sergei-tiutriumov/Finishing/кольцо2.jpg

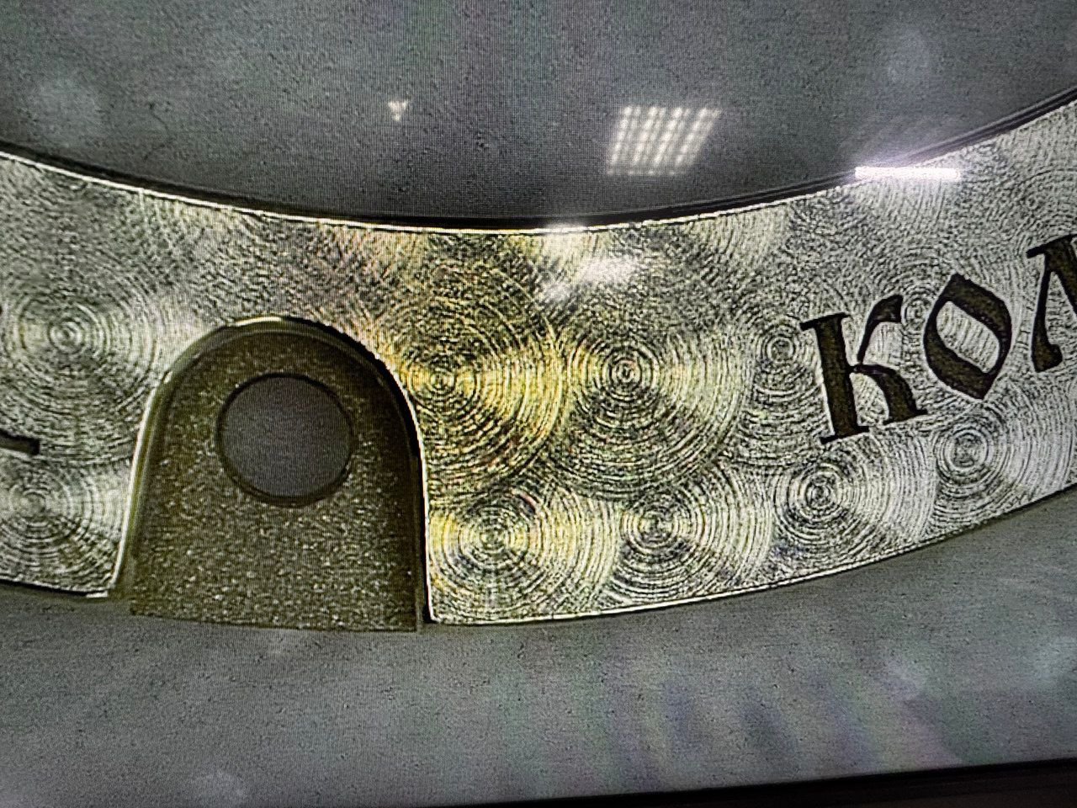
кольцо2.jpg
