sergei-tiutriumov/Finishing/кольцо3.jpg

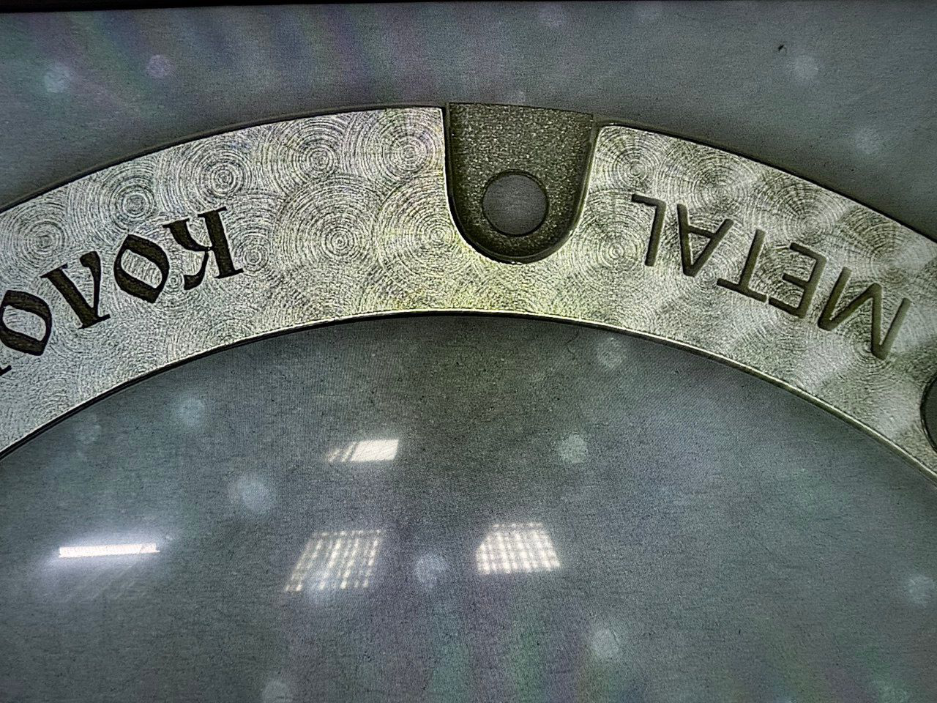
кольцо3.jpg
