sergei-tiutriumov/Finishing/китаец/Proforma Invoice 430PT.pdf

Proforma Invoice
Invoice Date : 2024-06-13 | INVOICE NO.: QLL20240613
Exporter/Seller | Importer/Buyer: Jinan Eastrise Innovations Co.,Ltd. No.59 Huayuan Road,Licheng District, Jinan City,Shandong
Province,China | Ivanov Ivan Ivanovich +7 964 555-20-56
Seller's Bank Information Beneficiary Name | Jinan Eastrise Innovations Co.,Ltd. Beneficiary account number | 623052 0730073816373 陈正勋
Country/ Region | 农业银行 China Beneficiary Bank
Beneficiary Bank Address | 河南省洛阳市涧西区联盟路
Ship Via | Terms of Delivery | Payment Term
| EXW | 100% CNY before shipping
Item | Description | Quantity In Unit | Unit Price(CNY) | Total Amount (CNY)
1 | Carving and milling machine 430P-T #Worktable size:400*300mm #Texture of material: HT300 #ADTECH control system #HCFA 750w servo motors and drivers #Spindle : HQD 2.2KW #X/Y/Z Ball screw : D2005C3 #X/Y/Z Linear guide rail: HIWIN HG25/20/20H #4 axis #add spacer 60mm | 1set | ¥67,300 | ¥67,300

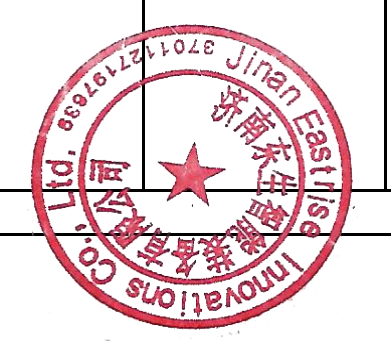
[picture p7: figure]

Total: | | | | ¥67,300
Others terms and conditions: 01.Payment terms:100% CNY before shipping. 02.Trade terms:EXW

### 03. Packing: Export standard plywood packing
