sergei-tiutriumov/Finishing/сфинкс/мануалы15iM/NewKer/(TB)NEW-996M-1000M-1500M-15iM-18iM.pdf

-数控系统- | 用户手册
- 1 -

目 录
第一篇 概述篇 | 4
第二篇 编程篇 | 5
2.1 基本概念 | 5
2.2 程序格式的一般表达式 | 6
2.3 程序指令代码及其功能说明 | 6
2.4 程序指令及使用方法 | 11
（1）选择坐标系指令（G53/G54/G55/G56/G57/G58/G59） ……12
（2）坐标系指令（G50/G52） | 12
（3）编程方式指令（G90/G91） | 13
（4）平面选择指令（G17/G18/G19） | 13
（5）快速定位指令（G00） | 13
（6）直线插补指令（G01） | 14
（7）圆弧插补指令（G02/G03） | 14
（8）螺旋线插补指令（G02/G03） | 15
（9）三维空间圆弧指令（G06） | 16
（10）延时指令（G04） | 16
（11）镜像加工指令（G11/G12） | 17
（12）比例缩放指令（G36/G37） | 18
（13）坐标系旋转指令（G68/G69） | 19
（14）回零点指令（G28/G281-G288/G301-G308） | 21
（15）刀具长度补偿指令（G43/G44/G49） | 21
（16）增减刀具半径指令（G45/G46/G47/G48） | 22
（17）刀具半径补偿指令（G40/G41/G42） | 23
（18）程序循环指令（G22--G800） | 25
（19）准确定位/连续路径加工（G60/G64） | 25
（20）固定循环宏定义指令（G73、G80～G89） | 26
（21）高速深孔钻循环（G73） | 27
（22）钻孔循环，点钻循环（G81） | 28
（23）钻孔循环，锪镗循环（G82） | 29
（24）排屑钻孔循环（G83） | 30
（25）镗孔循环（G85） | 31
（26）镗孔循环（G86） | 32
（27）镗孔循环、背镗孔循环（G87） | 36
（28）镗孔循环（G89） | 33
（29）精镗循环（G76） | 36
（30）左旋琢式深孔攻丝循环（G74） | 34
（31）右旋琢式深孔攻丝循环（G84） | 36

- numerical control system -user's manual
- 1 -

## Catalogue

The first part is an overview | 4
Part two, programming | 5
2.1 conceptual framework | 5
2.2 A general expression for program formatting | 6
2.3 Program instruction code and its function
description | 6
2.4 Program instructions and usage | 11
（1） Select the coordinate system instruction (G53/G54/G
55/G56/G57/G58/G59) | 12
（2） Coordinate instructions (G50/G52) | 12
（3） Programming instructions (G90/G91) | 13
（4） Planar selection command (G17/G18/G19) | 13
（5） Quick positioning instruction (G00) | 13
（6） Linear interpolation command (G01) | 14
（7） Circular arc interpolation instruction (G02/G03)… 14
（8） Spiral lead-in instruction (G02/G03) | 15
（9） 3D spatial arc instruction (G06) | 16
（10） Delay instruction (G04) | 16
（11） Mirror processing command (G11/G12) | 17
（12） Proportional scaling instructions (G36/G37) | 18
（13） Coordinate system rotation command (G68/G69)…
| 19
（14） Return to zero point instruction (G28/G281-G288/G
301-G308) | 21
（15） Tool length compensation command (G43/G44/G
49) | 21
（16） Add/subtract tool radius commands (G45/G46/G47/
G48) | 22
（17） Tool radius compensation command (G40/G41/G
42) | 23
（18） Program loop instructions (G22--G800) | 25
（19） Precise positioning/continuous path machining (G
60/G64) | 25
（20） Fixed cycle macro definition instructions (G73, G80~
G89) | 26
（21） High speed deep hole drilling cycle (G73) | 27
（22） Borehole cycle, point-to-borehole cycle (G81)…… 28
（23） Drill cycle, counterboring cycle (G82) | 29
（24） Drill cuttings circulation (G83) | 30
（25） Borehole circulation (G85) | 31
（26） Borehole circulation (G86) | 32
（27） Boring cycle, back boring cycle (G87) | 36
（28） Borehole circulation (G89) | 33
（29） Borehole circulation (G76) | 36
（30） Left rotary deep hole tapping cycle (G74) | 34
（31） Right rotation twist deep hole tapping cycle (G84)…
| 36

- 2 -
（32）固定循环取消（G80） | 37
（33）极坐标指令（G15/G16） | 37
（34）公英制转换、进给方式指令（G20/G21、G94/G95）………38
（35）返回程序起点指令（G26/G261-G268） | 38
（36）记忆当前点（G25） | 39
（37）返回程序记忆点指令（G61/G611-G618） | 39
（38）检测跳转指令 G31、G311 | 40
（39）自动倒斜角 I 和倒圆角 R 功能 | 40
（40）M 功能辅助指令 | 42
（41）调用程序 M97、M98、M99 | 43
（42）F 进给速度功能指令 | 45
（43）T/H/D 功能指令 | 45
（44）S、SS 主轴速度功能指令 | 46
（45）宏程序指令（G65/G66/G67） | 46
（46）自定义宏程序指令（G101—G172） | 48
（47）圆内凹槽粗铣G110/G111 | 69
（48）全圆内精铣循环G112/G113 | 71
（49）外圆精铣循环G114/G115 | 72
（50）外圆粗铣循环G116/G117 | 73
（51）外矩形粗铣 G132/G133 | 75
（52）形凹槽粗铣G134/G135 | 77
（53）矩形凹槽内精铣循环G136/G137 | 79
（54）矩形外精铣循环 G138/G139/G141/G142 | 80
（55）可编程数据输入指令 G10/G710 | 80
（56）可编程数据输入指令 G10 | 80
（57）椭圆指令 G602/G603 | 67
（58）抛物线指令(G702) | 67
（59）样条曲线光顺处理指令(M620/M621) | 67
（60）倾斜姿态坐标系 G682/G680 | 67
2.5 刀具半径补偿 C 的介绍 | 51
2.6 编程综合举例 | 56
2.7 自动对刀仪使用方法 | 56
2.8 自动分中功能使用方法 | 56
2.9 坐标轴随动功能使用方法 | 58
2.10 四轴/五轴系统 RTCP 功能 | 58
第三篇 操作篇 | 60
3.1 概述 | 60
3.2 操作面板 | 60

- numerical control system - | user's manual
- 2 -
（32） Fixed-cycle cancellation (G80) | 37
（33） Polar coordinate commands (G15/G16) | 37
（34） Metric conversion, feed mode instructions (G20/G
21, G94/G95) | 38
（35） Return program starting instruction (G26/G261-G
268) | 38
（36） Memory current point (G25) | 39
（37） Return program memory point instruction (G61/G
611-G618) | 39
（38） Detect jump instructions G31 and G311 | 40
（39） Automatic chamfer I and fillet R functions | 40
（40） Function assist command M | 42
（41） Call the programs M97, M98, and M99 | 43
（42） F Feed speed function command | 45
（43） T/H/D function instruction | 45
（44） S, SS spindle speed function command | 46
（45） Macro instruction (G65/G66/G67) | 46
（46） Custom macro program instructions (G101-G172)…
| 48
（47） Grind the round recess G110/G111 | 69
（48） Full circle internal precision milling cycle G112/G113
| 71
（49） External cylindrical milling cycle G114/G115 | 72
（50） Outer circle rough milling cycle G116/G117 | 73
（51） External rectangular rough milling G132/G133…… 75 （52） Form a groove for rough milling G134/G135………77 （53） Precision milling cycle G136/G137 in rectangular
groove | 79
（54） Rectangular outer milling cycles G138/G139/G141/G
142 | 80
（55） Programmable data input instruction G10/G710… 80
（56） Programmable data input instruction G10 | 80
（57） Elliptical command G602/G603 | 67
（58） Parabolic command (G702) | 67
（59） Spline curve smoothing instruction (M620/M621)…
| 67
（60） Tilt axis coordinate system G682/G680 | 67
2.5 Introduction to tool radius compensation C | 51
2.6 Programming examples | 56
2.7 How to use the automatic knife sharpener | 56
2.8 How to use the automatic partitioning function…… 56
2.9 Coordinate axis follower function usage | 58
2.10 Four-axis/five-axis system RTCP function | 58
The third part, the operation part | 60
3.1 summary | 60
3.2 operation panel | 60

- 3 -
3.3 键盘说明 | 60
3.4 手动操作 | 62
3.5 自动操作 | 67
3.6 安全操作、报警提示 | 70
3.7 参数操作 | 71
3.8 刀补参数设置 | 98
3.9 螺补参数设置 | 99
3.10 诊断 | 101
3.11 编程操作 | 103
第四篇 连接篇 | 109
4.1 系统电气特性 | 109
4.2 系统技术指标 | 109
4.3 系统使用环境 | 109
4.4 系统安装连接 | 109
4.5 系统安装尺寸 | 110
4.6 系统后视图 | 110
4.7 系统接口连接图 | 111
4.8 机床电器安装原理 | 122
4.9 机床电器板 | 130
4.10 总线系统 I/O 机床电器板 | 180
4.11 总线系统电器连接图 | 184
第五篇 加工中心篇 | 186
5.1 输入输出接口 | 186
5.2 加工中心参数 | 188
5.3 加工中心调试 | 189
第六篇 双通道系统 | 204

- numerical control system - | user's manual
- 3 -
3.3 Keyboard instructions | 60
3.4 hand operation | 62
3.5 automata | 67
3.6 Safety operation and alarm prompt | 70
3.7 Parameter operations | 71
3.8 Adjust parameter Settings | 98
3.9 Adjustment of screw parameters | 99
3.10 diagnose | 101
3.11 Programming operations | 103
The fourth part, the connection | 109
4.1 System electrical characteristics | 109
4.2 System technical indicators | 109
4.3 System usage environment | 109
4.4 System installation and connection | 109
4.5 System installation dimensions | 110
4.6 System view | 110
4.7 System interface connection diagram | 111
4.8 Installation principle of machine tool electrical
equipment | 122
4.9 Machine tool electrical board | 130
4.10 Bus system I/O machine tool electrical board……180
4.11 Bus system electrical connection diagram | 184
Part V: Processing Centers | 186
5.1 inputoutput interface | 186
5.2 Processing center parameters | 188
5.3 Processing center debugging | 189
Part VI. Two-channel systems | 204

- 4 -

第一篇 概 述 篇

本系统是我公司最新开发的普及型铣床、钻床、镗床数控系统。控制电路采 用最新工业级高速 ARM 处理器、大规模现场可编程门列矩阵 FPGA 技术，多层 PCB 印制电路板，整机采用高集成芯片和表贴元件，结构更为紧凑合理，更好的保证 了系统的可靠性和稳定性。
实时控制高速度(最高快移速度可达 240 米/分、最高进给插补速度可达 30 米/分)、高精度；采用 800x600 点阵 TFT LCD 亮度自适应液晶显示技术，LED 背 光亮度均匀使用寿命长，且克服了以往显示亮度受环境温度变化的缺点。全屏幕 中文菜单显示，操作极为简单方便。
本系统是以铣床为代表的三轴、四轴、五轴、六轴、七轴、八轴坐标联动， 总线闭环控制普及型全数字式数控系统，功能强大，指令丰富，编程代码符合 ISO 国际代码标准。直接控制交流伺服系统，如果选配本公司生产的双通道交流伺服 驱动器性价比更优。
本使用手册详细介绍了本数控系统的编程和使用方法。

重要提示：

1、所有第 A、B、C、Xs、Ys 轴的功能在选配第四、五轴、六轴、七轴、八

轴系统时才有效。

2、对本数控系统操作不当可能引起意外事故，在使用前务必仔细阅读本使

用手册。

3、所有绝对值功能必须是选配的系统是绝对值系统才有效，所有总线功能

必须是选配的系统是总线系统才有效。

4、系统面板上的“启动”按键作为调试时使用（杂类参数 P9-D14 位设置

“有效”或“无效”，在正常使用时必须设置为“0”），在系统装配时必须外加

“启动”按钮，否则由于“启动”按键寿命问题可能引起意外事故！！！所以，本

系统禁止长时间使用系统面板上的“启动”按键，否则由此造成的安全后果与我

公司无关！！！

- numerical control system - | user's manual
- 4 -

## Chapter I. Introduction

This system represents our company's latest development in a user-friendly CNC control solution for milling, drilling, and broaching machines. Utilizing cutting-edge industrial-grade ARM processors and large-scale field-programmable gate array (FPGA) technology, it features multi-layer PCB boards with integrated high-density chips and surface-mount components. The compact design significantly enhances system reliability and stability while maintaining optimal operational efficiency.
Real-time control with high-speed operation (maximum linear speed: 240 m/min, maximum feed interpolation speed: 30 m/min) and high precision. Featuring an 800x600 dot-matrix TFT LCD display with adaptive brightness technology, the LED backlight ensures uniform illumination and extended lifespan, effectively addressing previous limitations of ambient temperature-dependent brightness in displays. The full-screen Chinese menu interface provides exceptionally intuitive operation.
This system is a fully digital CNC solution featuring three-axis, four-axis, five-axis, six-axis, seven-axis, and eight-axis coordinate linkage with milling machine as the core component. It employs closed-loop bus control technology and delivers robust functionality with extensive command capabilities, programming standards compliant with ISO international specifications. The system directly controls AC servo motors, and when paired with our company's dual-channel AC servo driver, it achieves superior cost-effectiveness through optimized performance.
This manual introduces in detail the programming and use of this CNC system.
Important note:
1 、 All functions of the A, B, C, Xs and Ys axes are valid only when the fourth, fifth, sixth, seventh and eighth axis systems are selected.
2. Improper operation of this CNC system may cause accidents, so please read this manual carefully before use.
3. All absolute value functions must be optional. The system is valid only when it is an absolute value system. All bus functions must be optional. The system is valid only when it is a bus system.
4. The "Start" button on the system panel is used during debugging (Miscellaneous Parameters P9-D14: Set the bit to "Enabled" or " Disabled". During normal operation, it must be set to "0".). When assembling the system, an additional "Start" button must be added. Otherwise, due to the lifespan limitations of the "Start" button, accidents may occur!!! Therefore, this
The system prohibits the long-term use of the "start" button on the system panel, otherwise the security consequences caused by this are not related to our company!!!

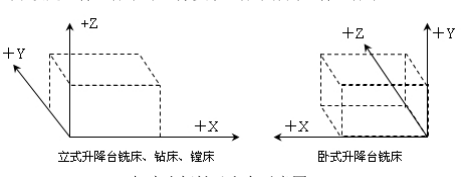
[picture p8: figure]

- 5 -

第二篇 编 程 篇

数控机床是按照事先编好的数控程序自动地对工件进行加工的高效自动化 设备。编制是根据被加工工件的图纸和加工工艺的要求，用所使用数控系统的数 控语言来描述加工轨迹，及其辅助动作的过程。理想的数控程序不仅应该保证能 加工出符合图纸要求的合格工件，还应使数控机床的功能得到合理的应用和充分 的发挥，所以编好数控程序非常重要，本篇将详细介绍数控程序的各种指令及用 法，请仔细阅读。

2.1 基本概念

程序段：（程序行）是由指令段和数据段共同组成的一个完整命令行。 程序：是为了完成工件的加工，按加工的逻辑结构组合的全部程序段的集合。 机床坐标系：是以机床零点为原点建立的坐标系。铣床坐标轴和其方向按 “ISO841”的规定。标准中规定的基本确定方法，即：以右手法则确定的笛卡尔直 角坐标系作为编程标准坐标系，对于刀具旋转的机床（如铣床）等，Z 轴是平行 于主轴的坐标轴，X 轴一般是水平的，与工件卡装面平行，Y 轴由右手法则确定， 各轴的运动使工件的尺寸增加的方向为各轴的正方向。
当未设定工件坐标系时，将机床坐标系作为工件坐标系。

机床坐标轴及方向示意图
工件坐标系：工件加工时使用的坐标系称作工件坐标系，由CNC 预先设置. 工件坐标系可以用移动它的原点来改变.
设置工件坐标系有二种方法：
1 、G50/G52指令
程序中在G52指令之后指定一个值来设定工件坐标系。
2 、G54/G54.1-G54.48/G55/G56/G57/G58/G59指令 使用参数设置中的坐标系可以设置6个工件坐标系。
用绝对值指令时必须用上述方法建立工件坐标系

- numerical control sys -
tem -

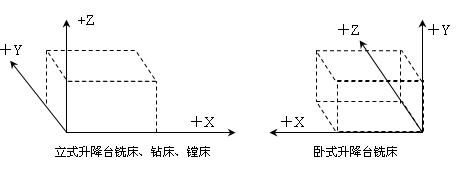
[picture p9: figure]

- 5 -

## Part II: Programming

A CNC machine is an efficient automated device that processes workpieces automatically according to pre-programmed numerical control (NC) instructions. Programming involves describing the machining path and auxiliary actions using the NC language of the system, based on the workpiece's blueprint and manufacturing requirements. An ideal NC program must not only ensure production of qualified parts meeting design specifications but also optimize the machine's capabilities. This makes proper programming crucial. This article provides a detailed explanation of various NC instructions and their applications. Please read carefully.
2.1 Conceptual Framework
Program section: (program line) is a complete command line composed of instruction section and data section.
Program: is the collection of all program segments combined according to the logical structure of processing in order to complete the machining of workpiece.
Machine tool coordinate system: A coordinate system established with the machine tool's zero point as the origin. The milling machine's coordinate axes and their orientations follow the ISO841 standard. The basic determination method specified in the standard is: using the Cartesian rectangular coordinate system defined by the right-hand rule as the programming reference system. For machine tools with rotating tools (such as milling machines), the Z-axis is parallel to the spindle, the X-axis is generally horizontal and parallel to the workpiece clamping surface, while the Y-axis is determined by the right-hand rule. The direction of motion that increases the workpiece's dimensions is defined as the positive direction of each axis.
When the workpiece coordinate system is not set, the machine tool coordinate system is taken as the workpiece coordinate system.

Schematic diagram of machine tool coordinate axis and direction Workpiece coordinate system: The coordinate system used in the machining of a workpiece is called the workpiece coordinate system, which is preset by the CNC. The workpiece coordinate system can be changed by moving its origin.
There are two ways to set the workpiece coordinate system:
1 、 G50/G52 instructions
In the program, a value is specified after the G52 instruction to set the workpiece coordinate system.
2 、 G54/G54.1-G54.48/G55/G56/G57/G58/G59 Directive
Use the coordinate system in the parameter Settings to set up 6 workpiece coordinate systems.
When using the absolute value instruction, the workpiece coordinate system must be established by the above method

- 6 -

局部坐标系：当在工件坐标系中编制程序时，为容易编程可以设定工件坐标 系的子坐标系，该子坐标系称为局部坐标系。
绝对坐标编程：是以建立的绝对坐标系为基准确定的坐标数据编程方式，绝 对坐标是指刀具相对于加工坐标系原点的坐标。用 G90 指令，X、Y、Z、A、B、 C、Xs、Ys 坐标字表示。
例如：G00 G90 X200 Y200 Z300
相对坐标编程：也叫增量坐标编程，是指运行终点相对于运行起点的距离和 方向。相对坐标是指刀具运动位置的坐标值是相对于前位置，而不是相对于固定 的加工坐标系原点。用 G91 指令，X、Y、Z、A、B、C、Xs、Ys 坐标字表示。 例如：G00 G91 X200 Y200 Z300
最小编程单位：最小编程单位为 0.001mm。
模态指令：是指在程序中具有保留功能属性的指令，它不仅在本程序行起作 用，而且在以后的程序行中也起作用。直到其它同组的模态指令替代为止。 在同样操作类型中可能具有多个模态指令，如 M03（主轴顺转）、M04（主 轴逆转）、M05（主轴停）它们同样用来控制主轴，都是模态，在指令系统中把 同类型的模态指令划分为一个模态组。任何时候只能是其中之一。而且必然有其 中之一，因此存在一个初始状态问题，初始选用的模态指令，叫做模态初态。如 上述模态组中，模态初态为 M05。
中止模态（破坏模态）：是指具有把模态指令变为模态初态或模态可能被破 坏的指令。比如 M20（程序结束指令），表示运行结束，回到开始状态，把全部 模态指令变为模态初态。
非模态指令：是指不具备保留功能，仅在本程序段内起作用。

2.2 程序格式的一般表达式

G02，T02，H02，D02，M02，S04，F04，X-043，Y-043，Z-043，A-043， B-043，C-043，Xs-043，Ys-043，I-043，J-043，K-043，L04，P4，R043。 注 1：地址符后有“-”号表示该数据可以用“-”符号（正号不写）。 注 2：数字前为 0，表示该数据可以只写有效数据位。
注 3：数字表示的是位数，当为两位时，高位表示整数位数的最多位数，低 位表示小数点后的最多位数。

2.3 程序指令代码及其功能说明

本节将详细介绍本系统中所有指令代码的功能及使用方法。

2.3.1 指令及数据说明

功 能 | 地址符 | 意 义 | 数据范围

- numerical control sys -
tem -
- 6 -

Local coordinate system: When programming in the workpiece coordinate system, a sub-coordinate system of the workpiece coordinate system can be set to facilitate programming. This sub-coordinate system is called the local coordinate system.
Absolute coordinate programming: This is a programming method that determines coordinate data based on the established absolute coordinate system. Absolute coordinates refer to the coordinates of the tool relative to the origin of the machining coordinate system. The G90 command uses X, Y, Z, A, B, C, Xs, and Ys coordinates to represent this. For example: G00 G90 X200 Y200 Z300
Relative coordinate programming, also known as incremental coordinate programming, refers to the distance and direction between the end point and the starting point during machining. This method determines tool movement positions relative to their previous locations rather than a fixed reference coordinate system origin. The G91 command specifies these coordinates using X, Y, Z, A, B, C, Xs, and Ys parameters.
For example: G00 G91 X200 Y200 Z300
Minimum program unit: minimum program unit is 0. 001mm. Modal instructions: These are instructions in a program that have reserved functional attributes. They not only work in the current line of the program, but also in later lines of the program until they are replaced by other modal instructions in the same group.
Within the same operational type, multiple mode commands may exist, such as M03 (spindle forward rotation), M04 (spindle reverse rotation), and M05 (spindle stop). These commands all control the spindle and are classified as modes within the instruction system. The same type of mode commands are grouped into a mode group, with only one applicable at any given time. Since there must be one selected mode, an initial state issue arises—this initial mode command is called the mode initial state. For example, in the aforementioned mode group, the mode initial state is M05.
Termination mode (destructive mode): refers to the instruction that changes the mode instruction to the mode initial state or the mode may be destroyed. For example, M20 (program termination instruction), which indicates the end of operation and returns to the starting state, changing all mode instructions to the mode initial state.
Non-modular instruction: refers to the instruction that does not have the retention function and only takes effect in this program segment.
2.2 A General Expression for Program Formatting

G02，T02，H02，D02，M02，S04，F04，X-043，Y-043，Z-043，A-043， B-043，C-043，Xs-043，Ys-043，I-043，J-043，K-043，L04，P4，R043。
Note 1: A "-" after the address indicates that the data can be written with the "-" symbol (the plus sign is not written).
Note 2: A number with a zero in front indicates that the data can only write valid data bits.
Note 3: The number indicates the number of bits. When it is two bits, the high bit indicates the maximum number of bits in the integer number and the low bit indicates the maximum number of bits after the decimal point.
2.3 Program Instruction Code and Its Function Description
This section will detail the functions and usage of all instruction codes in this system.
2.3.1 Instructions and Data Descriptions

function

address character

mea
ning

data
area

- 7 -
文件名 | | 加工工件的文件名 | 0-9、A-Z 组成
程序行号 | N | 程序段的顺序号 | 0000-99999 行距可设
准备功能 | G | 指定动作状态（G01、G02 等） | 00-99
辅助功能 | M | 控制机床辅助动作 | 00-99
刀具功能 | TDH | 指定刀具号 | 换刀 00-99
| SS S | 指定第一主轴转速 指定第二主轴转速 | 0-99999 主轴功能 0-99999
切削速度 | F | 指定每分钟的切削速度 | 0.01-15000mm/min
坐标字 | XYZABCX sYs | 分别为 XYZABCXsYs 轴坐标移 动值 | ±99999.999mm
圆心坐标 | IJK | X、Y、Z 轴圆心坐标增量值 | ±99999.999mm
圆弧半径 | R | 圆弧半径值 | 0.001-99999.999m m
延时时间 | P、X | 指定 G04 的延时时间 | 0.001-65s
程序入口 | P | 子程序调用或转移入口行 | 0000-9999
重复次数 | L | 循环次数或子程序调用次数 L 也可为多头螺纹头数 | 1-99999 1-99
程序行跳 步功能 | / | 如果程序行首有“/”表示此 行不执行 | 杂 类 参 数 P9 的 D12=1 时可以屏 蔽跳步功能

2.3.2 程序指令表

表 1 G 指令代码及功能
G 代码 | 功能
G00 | 快速定位
G01 | 直线插补
G31 | 检测跳转不报警
G311 | 检测跳转要报警
G02 | 顺圆插补/螺旋线插补 CW：螺旋移动的螺旋 线插补可指令 2 个圆弧插补轴同步移动的其 他轴。指令方法只是简单地加上一个不是圆 弧插补轴的移动轴。
G03 | 逆圆插补/螺旋线插补 CCW
G01(G00) X I | 自动倒斜角
G01(G00) YI | 自动倒斜角
G01(G00) ZI | 自动倒斜角

- numerical control sys -
tem -
- 7 -
document name | | The file name of the workpiece being processed | 0-9, A-Z composi-tion
Line number of the prog-ram | N | The sequence number of the pr-ogram segment | 000-99999 line spacing can be set
g function | G | Specify the action status (G01, G02, etc.) | 00-99
additional fu-nction | M | Control machine tool auxiliary acti-ons | 00-99
tool function | TDH | Specify the tool number | Change the blade 00-99
Spindle funct-ion | S | Specify the spin-dle speed | 0-99999
| SS | Specify the second spindle speed | 0-99999
cutting speed | F | Specify the cutting speed per minute | 0.01-15000mm/min
Coordinate le-tter | XYZABCX sYs | Are the axis coord-inate movement values of XYZABC-XsYs respectively | ±99999.999mm
Center of circle coordinates | IJK | X, Y, Z axis center of circle coordinate increment value | ±99999.999mm
Arc radius | R | Arc radius value | 0.001-99999. 999m m
Delay time | P、X | Specify the delay time for G04 | 0.001-65s
program entry | P | A subroutine call or transfer entry line | 0000-9999
number of re-plication | L | The number of cy-cles or subroutine calls L can also be the number of thr-eads in a multi-head thread | 1-99999 1-99
Procedure: Walk function | / | If the line starts with a /, it is not executed | When D12=1 in the miscellaneous category parame-ter P9, the skip function can be shielded

2.3.2 Program Instruction Table
Table 1 G Instruction Code and Function
G code | function
G00 | quick positioning
G01 | linear interpolation
G31 | No alarm is raised when the test jump is detected
G311 | The test jump should alarm
G02 | Circular interpolation/spiral interpolation CW: The spiral movement of the spiral interpolation can be instructed to move two arc interpolation axes synchronously with other axes. The instruction method is simply to add a moving axis that is not an arc interpolation axis.
G03 | Counterclockwise circular interpolation/ spiral line interpolation
G01(G00) X I | Automatic reverse angle
G01(G00) YI | Automatic reverse angle
G01(G00) ZI | Automatic reverse angle

- 8 -
G01(G00)X R | 自动倒圆角
G01(G00)Y R | 自动倒圆角
G01(G00)Z R | 自动倒圆角
G04 | 延时
G15 | 极坐标指令取消
G16 | 极坐标指令：极坐标（半径和角度），角度的 正向是所选平面的第1轴正向的逆时针转向， 而负向是顺时针转向。
G17 | 选择 XpYp 平面 | Xp：X 轴或其平行轴 Yp：Y 轴或其平行轴 Zp：Z 轴或其平行轴
G18 | 选择 ZpXp 平面
G19 | 选择 YpZp 平面
G20 | 英寸（英制）输入
G21 | 毫米（公制）输入
G28/G281-G28 8 | 返回机床零点
M881 | 加工中心主轴准停，输出 M61，检测 M22
M884-M887 | X 轴、Y 轴自动分中指令
M880 | 自动对刀指令
G30/G301-G308 | 回坐标零点
G26/G261-G26 8 | 返回程序起点
G25 | 记忆当前点 XYZABCXsYs 坐标
G61/G611-G61 8 | 返回 G25 记忆点的坐标
G40 | 刀具半径补偿取消
G41 | 刀具半径左补偿
G42 | 刀具半径右补偿
G43 | 正向刀具长度补偿
G44 | 负向刀具长度补偿
G49 | 刀具长度补偿取消
G45 | 刀具位置偏置加
G46 | 刀具位置偏置减
G47 | 刀具位置偏置加 2 倍
G48 | 刀具位置偏置减 2 倍
G37 | 比例缩放取消
G36 | 比例缩放有效
G12 | 可编程镜像取消

- numerical control sys -
tem -
- 8 -
G01(G00)X R | Automatically round corners
G01(G00)Y R | Automatically round corners
G01(G00)Z R | Automatically round corners
G04 | delayed
G15 | The polar coordinate command is cance-lled
G16 | Polar coordinate instructions: Polar coo-rdinates (radius and Angle), where the positive direction of the Angle is a counterclockwise turn from the positive direction of the first axis of the selected plane, and the negative direction is a clockwise turn.
G17 | Select the XpYp plane | Xp: X-axis or its par-allel axis Yp: Y-axis or its par-allel axis Zp: Z-axis or its par-allel axis
G18 | Select the ZpXp plane
G19 | Select the YpZp plane
G20 | Inch (imperial) input
G21 | Millimeters (metric) input
G28/G281-G28 8 | Return to machine zero point
M881 | The spindle of the machining center is stopped, output M61 and detect M22
M884-M887 | X-axis and Y-axis automatic centering instructions
M880 | Automatic alignment command
G30/G301 - G 308 | Return to the origin
G26/G261-G26 8 | Return to the starting point of the procedure
G25 | Remember the coordinates of the curr-ent point XYZABCXsYs
G61/G611-G61 8 | Return the coordinates of the G25 me-mory point
G40 | Tool radius compensation is cancelled
G41 | Left tool radius compensation
G42 | Right tool radius compensation
G43 | Forward tool length compensation
G44 | Negative tool length compensation
G49 | Blade length compensation is cancelled
G45 | Add tool position offset
G46 | Tool position offset reduced
G47 | The tool position offset is added by 2 times
G48 | The tool position offset is reduced by 2 times
G37 | Proportional scaling is cancelled
G36 | Proportional scaling works
G12 | Programmable mirroring is cancelled

- 9 -
G11 | 可编程镜像有效：实现坐标轴的对称加工。
G50/G52 | 坐标系设定：在工件坐标系中编制程序时， 为容易编程，可以设定工件坐标系的子坐标 系
G53 | 选择机床坐标系
G54.1-G54.48 | 选择工件坐标系 1 | 说明：这六个工件坐 标系是用直接存储在 计算机中，需用时可 选择其中一个
G55 | 选择工件坐标系 2
G56 | 选择工件坐标系 3
G57 | 选择工件坐标系 4
G58 | 选择工件坐标系 5
G59 | 选择工件坐标系 6
G60 | 准确停止定位
G64 | 连续路径加工
G68 | 坐标旋转
G69 | 坐标旋转取消
G65 | 非模态宏指令
G66 | 模态宏指令
G67 | 取消模态宏指令
G73 | 深孔钻循环：间歇进给，回退快速移动
G80 | 固定循环取消/外部操作功能取消
G81 | 钻孔循环：切削进给， 镗循环或外部操作功 能，回退快速移动
G82 | 排屑钻孔循环或反镗循环：切削进给，在孔 底停刀，回退快速移动
G83 | 小孔深孔钻循环：间歇进给，回退快速移动
G85 | 镗孔循环：切削进给，回退切削进给
G86 | 镗孔循环：切削进给，在孔底主轴停止，回 退快速移动
G89 | 镗孔循环：在孔底停刀，回退切削进给
G74 | 左旋琢式深孔攻丝循环
G84 | 右旋琢式深孔攻丝循环
G76 | 精镗循环
G90 | 绝对值编程
G91 | 增量值编程
G98 | 固定循环返回到初始点：用于最后钻孔
G99 | 固定循环返回到 R 点： 用于第一次钻孔
G22 | 程序循环指令
G800 | 取消程序循环指令

- numerical control sys -
tem -
- 9 -
G11 | Programmable mirror effect: achieve symmetrical machining of coordinate axes.
G50/G52 | Coordinate system setting: When prog-ramming in the workpiece coordinate system, you can set the sub-coordinate system of the workpiece coordinate sys-tem for easy programming
G53 | Select the machine tool coordinate sys-tem
G54.1-G54.48 | Select the workpi-ece coordinate sy-stem 1 | Note: The coordin-ate systems for th-ese six workpieces are stored directly in the computer and one of them can be selected when ne-eded
G55 | Select the workpi-ece coordinate sy-stem 2
G56 | Select the workpi-ece coordinate sy-stem 3
G57 | Select the workpi-ece coordinate sy-stem 4
G58 | Select the workpi-ece coordinate sy-stem 5
G59 | Select the workpi-ece coordinate sy-stem 6
G60 | Stop positioning accurately
G64 | Continuous path processing
G68 | Coordinate rotation
G69 | Coordinate rotation cancelled
G65 | Non-modal macro instructions
G66 | Modulator macro instructions
G67 | Remove the modal macro command
G73 | Deep hole drill cycle: intermittent feed, rapid retraction
G80 | Fixed cycle cancellation/external operat-ion function cancellation
G81 | Drill cycle: Cutting feed, boring cycle or external operation function, quick retreat
G82 | Drill hole or reverse bore cycle: Cutting feed, stop cutting at the bottom of the hole, and move back quickly
G83 | Small hole deep hole drill cycle: intermi-ttent feed, quick move back
G85 | Boring cycle: cutting feed, retraction cutting feed
G86 | Bore hole cycle: Cutting feed, spindle stops at the bottom of the hole, and rapid retraction
G89 | Bore hole cycle: stop the tool at the bottom of the hole and back off the cutting feed
G74 | Left rotary deep hole tapping cycle
G84 | Right rotation twist deep hole tapping cycle
G76 | Borehole circulation
G90 | Absolute value programming
G91 | Incremental value programming
G98 | Fixed cycle back to the starting point: for the final borehole
G99 | Fixed cycle back to point R: for the first borehole
G22 | Program loop instructions
G800 | Cancel the program loop instruction

- 10 -

表 2 M 代码及功能
主 轴 | M03 M04 M05 M203 M204 M205 | 主轴正转 主轴反转 主轴停止刹车 M7053/M7054 Pxxxx ；主轴自 动正转/反转一段时间后自动 停止，时间由参数 P 指定，单 位为毫秒；定时精度可达到 毫秒级。 例如：M7053 P2000; 表主轴正 转 2 秒钟后停止。 | √ | √ √ √ | M203 L3/L4/L5/L6 M204 L3/L4/L5/L6 M205 L3/L4/L5/L6 第二到第六主轴正、 反转、停止
冷 却 | M08 M09 | 冷却开 冷却关 | √ | √ √
卡 盘 | M10 M11 | 松紧刀夹紧 松紧刀松开 | √ | √ √
自定 义 | M79 M78 | 自定义输出 7 开，输出 M79 自定义输出 7 关，输出 M73 | √ | √ √ | 双信号输出
润滑 | M32 M33 | 机床润滑开 机床润滑关 | √ | √ √ | 控制 M32 信号
吹气 | M59 M58 | 吹气开 吹气关 | √ | √ √ | 控制 M59 信号
自定 义 输出 | M61 M60 | 自定义 1 开 自定义 1 关 | | √ √ | 控制 M61 信号
| M63 M62 | 自定义 2 开 自定义 2 关 | | √ √ | 控制 M63 信号
| M65 M64 | 自定义 3 开 自定义 3 关 | | √ √ | 控制 M65 信号
| M67 M66 | 自定义 4 开 自定义 4 关 | | √ √ | 控制 M67 信号
| M69 M68 | 自定义 5 开 自定义 5 关 | | √ √ | 控制 M69 信号
| M71 M70 | 自定义 6 开 自定义 6 关 | | √ √ | 控制 M71 信号
| M75 M74 | 自定义 8 开 自定义 8 关 | | √ √ | 控制 M75 信号
| M38xx M48xx | 输出 xx 口有效 输出 xx 口无效
自 定 | M12 M13 | 检测 M12 有效 检测 M12 无效 | | √ √ | 条件成立转移，如 M12 P120 即:当

- numerical control sys -
tem -
- 10 -

Table 2 M Code and Function
principal axis | M 0 3 M 0 4 M 0 5 M 20 3 M 20 4 M 20 5 | Main shaft forward ro-tation main shaft reve-rse main shaft stop brake M7053/M7054 Pxxxx; The spindle automati-cally stops after a per-iod of automatic forw-ard/reverse rotation, and the time is specif-ied by parameter P, with the unit of millis-econd; The timing ac-curacy can reach milli-second level. For example: M7053 P 2000; the table spindle stops after 2 seconds of forward rotation. | √ | √ √ √ | M203 L3/L4/L5/L 6 M204 L3/L4/L5/L 6 M205 L3/L4/L5/L 6 The second to sixth main shafts are positive, re-versed and sto-pped
cold step back | M 0 8 M 0 9 | Cool down Cooling guard | √ | √ √
block tray | M 1 0 M 1 1 | Set the jaws of the screwdriver Loosen the wrench | √ | √ √
user-defined | M 7 9 M 7 8 | Open custom output 7 and output M79 Custom output 7, ou-tput M73 | √ | √ √ | Dual signal ou-tput
lubricating | M 3 2 M 3 3 | Open the machine tool lubrication Machine tool lubrica-tion | √ | √ √ | Control the M32 signal
scavenging | M 5 9 M 5 8 | Turn on the air blo-wers Blow off the lid | √ | √ √ | Control the M59 signal
| M 6 1 M 6 0 | Customize 1 open Customization 1 co-ncerns | | √ √ | Control the M61 signal
| M 6 3 M 6 2 | Customize 2 open Customization 2 | | √ √ | Control the M63 signal
| M 6 5 M 6 4 | Custom 3 open Customization 3 | | √ √ | Control the M65 signal
| M 6 7 M 6 6 | Customize 4 open Customization 4 | | √ √ | Control the M67 signal
| M 6 9 M 6 8 | Customize 5 open Customize 5 | | √ √ | Control the M69 signal
| M 7 1 M 7 0 | Customize 6 open Customization 6 | | √ √ | Control the M71 signal
| M 7 5 M 7 4 | Customize 8 open Customize 8 | | √ √ | Control the M75 signal
| M38 xx M48 xx | Output xx is valid Output xx port is inv-alid
customize | M 1 2 M 1 3 | The M12 is valid for testing The M12 is invalid | | √ √ | Conditions for transfer, such as M12 P120, are: when

user-defined
output

- 11 -
义 输 入 | M14 M15 | 检测 M14 有效 检测 M14 无效 | √ √ | M12 信号有效时,程 序跳转到 120 行执 行; 如：M1810 检测 X10 口有效
| M16 M17 | 检测 M16 有效 检测 M16 无效 | √ √
| M18 M19 | 检测 M18 有效 检测 M18 无效 | √ √
| M28 M29 | 检测 M28 有效 检测 M28 无效 | √ √
| M22 M23 | 检测 M22 有效 检测 M22 无效 | √ √
| M18xx M28xx | 检测 xx 口有效 检测 xx 口无效 | √ √
主 轴 换 档 | M41 M42 M43 M44 | 第一档 第二档 第三档 第四档 | | M41/M44 输出 S01/S02 同时调整 主轴模拟电压
子 程 序 | M97 M98 M99 | 程序跳转 子程序调用 子程序调用返回 | | L=1-99 P 为转移程序行号
程 序 控 制 | M87 M188 M189 M00 M01 M02 M30 M20 | 工件数加 1 M188 进给保持手动手轮干预 坐标后不返回起点 M189 进给保持回起点 程序暂停 程序准停，输入 X46 有效暂 停 程序结束 M05、M09 程序结束 程序结束，根据参数设置运 行次数自动重复运行程序， 用于考机 | | 杂类参数 P10=0 设 为工件数不自动加 1 时，指令 M87 工件 数加 1
主 轴 速 度 | S SS SC/SD SG/SH | 设定第一主轴速度 设定第二主轴转速 第三/四主轴转速 第五/六四主轴转速 | √ √ | S=0-99999 SS=0-99999

- numerical control sys -
tem -
- 11 -
| M 1 4 M 1 5 | The M14 is valid for testing The M14 is invalid | √ √
| M 1 6 M 1 7 | The M16 was tested and found to be ef-fective The M16 is invalid | √ √
| M 1 8 M 1 9 | The M18 is valid for testing The M18 is invalid | √ √
| M 2 8 M 2 9 | The M28 was tested and found to be ef-fective The M28 is invalid | √ √
| M 2 2 M 2 3 | The M22 was tested and found to be ef-fective The M22 is invalid | √ √
| M18 xx M28 xx | Test xx is valid Test xx port is inv-alid | √ √
Change the main axis | M 4 1 M 4 2 M 4 3 M 4 4 | first gear second gear third gear Episode IV | | M41/M44 outputs S01/S02 and adju-sts the spindle simulation voltage at the same time
subprogram | M 9 7 M 9 8 M 9 9 | Program jump subprogram call Subroutine call returned | | L=1-99 P is the transfer program line nu-mber

Right to entry

When the M12 signal is valid, the
program jumps to
120 and line is executed;
For example, M
1810 detects X10,
and the port is valid

programmed
control

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
Add 1 to the number of jobs
M188 feed hold
handwheel intervention coordinates
without returning to
the starting point
M189 feed is maintained at the starting
point
program halt
The program is ready to stop, and the
input X46 is valid for
stopping
end of program
M05, M09 program
end
At the end of the
program, the program will be automatically repeated according to the number of times set by
parameters for
computer testing

When the miscellaneous parameter
P10=0 is set to not
automatically add
1 to the number of
workpieces, the
instruction M87
adds 1 to the
number of workpieces

Axis speed

S

S

S
SC/
SD
SG/
SH

Set the first spindle
speed
Set the second spindle speed and third/fourth spindle
speed
Fifth/sixth main shaft speed

√
√

S=0-99999
SS=0-99999

- 12 -
读绝 对式 电机 位置 | M499 M500 M501 M502 M503 M504 M505 M506 M507 M508 | M499: 绝对伺服旋转轴归算 的数据溢出进行处理,用在 M97/M02/M30/M20/GOTO之前; M500：读取全部进给轴绝对 电机位置并重置当前机床坐 标。 M501-M508：读取 XYZABCXsYs 轴绝对电机位置并重置当前 机床坐标。
清 工 件 坐 标 | M312 M313 M314 M315 M316 M317 M318 M319 M320 | M312:清零 C 轴工件坐标 M313:清零 Xs 轴工件坐标 M314:清零 Ys 轴工件坐标 M315:清零 A 轴工件坐标 M316:清零 B 轴工件坐标 M317:清零 X 轴工件坐标 M318:清零 Y 轴工件坐标 M319:清零 Z 轴工件坐标 M320:清零所有轴工件坐标
清 机 床 坐 标 | M412 M413 M414 M415 M416 M417 M418 M419 M420 | M412:清零 C 轴机床坐标 M413:清零 Xs 轴机床坐标 M414:清零 Ys 轴机床坐标 M415:清零 A 轴机床坐标 M416:清零 B 轴机床坐标 M417:清零 X 轴机床坐标 M418:清零 Y 轴机床坐标 M419:清零 Z 轴机床坐标 M420:清零所有轴机床坐标
总线 驱动 指令 | M133 M135 | M133:驱动器以指定速度转 动(必须是 30 的倍数)； 驱动参数 P30=0 恒转 速,P30=1 往复摆动,见轴类 参数。 M135:使能指定驱动器 | 例子： M133 X300; M135 Z0;关闭 Z 轴 驱动 M135 X1;使能 X 轴 驱动
倍率 指令 | M100 M101 | 倍率无效，固定为 100%； 倍率有效；

M1xxx: 等待辅助继电器有效，例如：M1076 表示等待 M76 有效； M2xxx: 等待辅助继电器无效，例如：M1078 表示等待 M78 无效； M3xxx: 置辅助继电器有效，例如：M3330 表示置 M330 有效；

- numerical control sys -
tem -
- 12 -
Read the ab-solute motor position | M 499 M 500 M 501 M 502 M 503 M 504 M 505 M 506 M 507 M 508 | M499: Process the data overflow of absolute servo rotation axis, which is used before M 97/M02/M30/M20/ GOTO; M500: Read all feed axis absolute motor positions and reset the current mac-hine coordinate. M501-M508: Read the absolute motor posit-ion of the XYZABCXsYs axis and reset the cur-rent machine tool co-ordinates.
Set the work coordinates | M 312 M 313 M 314 M 315 M 316 M 317 M 318 M 319 M 320 | M312: Zero the C axis workpiece coordinates M313: Zero the Xs axis workpiece coordinates M314: Zero the Ys axis workpiece coordinates M315: Zero the A axis workpiece coordinates M316: Zero the B axis workpiece coordinates M317: Zero the X axis workpiece coordinates M318: Zero the Y axis workpiece coordinates M319: Zero the Z axis workpiece coordinates M320: Zero the coord-inates of all shaft wo-rkpieces
Clear the ma-chine seat co-ordinates | M 412 M 413 M 414 M 415 M 416 M 417 M 418 M 419 M 420 | M412: Zero the C axis machine tool coordin-ates M413: Zero the Xs axis machine tool coordin-ates M414: Zero the Ys axis machine tool coordin-ates M415: Zero the A axis machine tool coordin-ates M416: Zero the B axis machine tool coordin-ates M417: Zero the X axis machine tool coordin-ates M418: Zero the Y axis machine tool coordin-ates M419: Zero the Z axis machine tool coordin-ates M420: Zero all axis machine tool coordin-ates
Bus drive instruct | M 133 M 135 | M133: The driver rota-tes at a specified speed (must be a multiple of 30); drive parameter P 30=0 for constant sp-eed, P30=1 for recipr-ocating swing, see sh-aft parameters. M135: Enable the spe-cified driver | example ： M133 X300; M 135 Z0; Turn off Z-axis drive M135 X1; Ena-ble X-axis drive
multiplying power instruct | M 100 M 101 | The multiplier is invalid and fixed at 100%; The multiplier is effe-ctive;

M1xxx: Wait for the auxiliary relay to be valid, for example: M1076 indicates that M76 is valid;
M2xxx: The waiting auxiliary relay is invalid, for example: M1078 indicates that the waiting M78 is invalid;
M3xxx: The auxiliary relay is set to be effective. For example, M3330 indicates that M330 is set to be effective;

- 13 -

M4xxx: 置辅助继电器无效，例如：M4331 表示置 M331 无效；
M38xx Pxxxx: Yxx 输出点置为有效，例如：M3809 表示将输出点 Y9 置为有效； P 为正值时表示输出信号延时再向后执行;
P 为负值时表示短信号,如:P3821 P-2000,输出 Y21,2 秒后关闭; 注意:使用此指令时 PLC 对应的输出点程序行要删除;
M48xx: Yxx 输出点置为无效，例如：M4807 表示将输出点 Y7 置为无效； M18xx: 直接等待输入点 Xxx 有效后再向后执行，例如：M1809 表示 X09 有效后再 向后执行；
M28xx: 直接等待输入点 Xxx 无效后再向后执行，例如：M2807 表示 X07 无效后再 向后执行；
M18xx Pxx: 直接根据 Xxx 判断：无效时顺序执行；有效时跳转到 Pxx； 例如：M1809 P234 表示输入点 X09 无效时顺序执行；有效时跳转到 P234； M28xx Pxx: 直接根据 Xxx 判断：有效时顺序执行；无效时跳转到 Pxx； 例如：M2807 P456 表示输入点 X07 有效时顺序执行；无效时跳转到 P456；

2.4 编程指令及使用方法

2.4.1 编程约定

（1）多指令共段：在同一个程序行内可以有多个指令同时存在，以减少编 程行数，但同组指令不能共段。
（2）在同一条程序段内指令与参数项可以任意摆放。
例如：M03 G01 X20 Y-30 可以写成 G01 Y-30 X20 M03 （3）在同一条程序段内指令不允许重复出现。
（4）在同一条程序段内不能有与指令无关的参数和操作数存在。 （5）指令代码的前“0”可以不写，例如：G01 M03 可写成 G1 M3。 （6）任意点起动、任意行起动、换刀指令后的命令行必须用绝对编程。 （7）非模态指令只在被指定的程序段中有效，例如：G04。 （8）模态指令在同组指令出现前一直有效。
例如：N0000 G01 X300 F100 ；G01 指令
N0001 X260 | ；G01 指令
N0002 G00 Y200 | ；G00 指令，G01 无效

2.4.2 G 功能指令

（1）选择坐标系指令（G53/G54/G55/G56/G57/G58/G59）

- numerical control sys -
tem -
- 13 -

M4xxx: The auxiliary relay is invalid, for example: M4331 indicates that M331 is invalid;
M38xx Pxxxx: Yxx output point is set to valid, for example: M3809 indicates that the output point Y9 is set to valid;
When P is positive, the output signal is delayed and executed again;
If P is negative, it indicates a short signal, such as P3821 P-2000, and the output Y21 is closed after 2 seconds;
Note: When using this instruction, the corresponding output point program line of the PLC should be deleted; M48xx:
Yxx output point is invalid, for example: M4807 indicates that
the output point Y7 is invalid;
M18xx: Directly wait for the input point Xxx to be valid before executing backward, for example: M1809 means that X09 is valid before executing backward;
M28xx: Directly wait for the invalid input point Xxx and then execute backward, for example: M2807 means X07 is invalid and then execute backward;
M18xx Pxx: Directly judged according to Xxx: execute in sequence when invalid; jump to Pxx when valid;
For example, M1809 P234 indicates that the input point X09 is invalid and is executed in sequence; when valid, it jumps to P234; M28xx Pxx: directly determines according to Xxx: when valid, it is executed in sequence; when invalid, it jumps to Pxx;
For example, M2807 P456 means that the input point X07 is valid and executed in sequence; if invalid, it jumps to P456;
2.4 Programming Instructions and Usage
2.4.1 Programming Agreement
（1） Multiple instructions in a common section: Multiple instructions can exist in the same program line at the same time to reduce the number of programming lines, but instructions in the same group cannot be shared.
（2） Instructions and parameters can be placed arbitrarily within the same program segment.
For example, M03 G01 X20 Y-30 can be written as G01 Y-30 X20 M03 （3） Instructions are not allowed to repeat within the same program segment.
（4） There can be no instruction-independent parameters and operands in the same program segment.
（5） The "0" in the instruction code can be omitted. For example, G01 M03 can be written as G1 M3.
（6） Absolute programming must be used in the command line for any point start, any line start, and tool change instructions.
（7） Non-modal instructions are only valid in the specified program segment, such as G04.
（8） Modulator instructions remain valid until the same group of instructions appears.
For example: N0000 G01 X300 F100; G01 instruction
N0001 X260 | ; G01 instruction
N0002 G00 Y200 | ; G00 instruction, G01 invalid
2.4.2 G Function Command
（1） Select the coordinate system command (G53/G54/G55/G56/ G57/G58/G59)

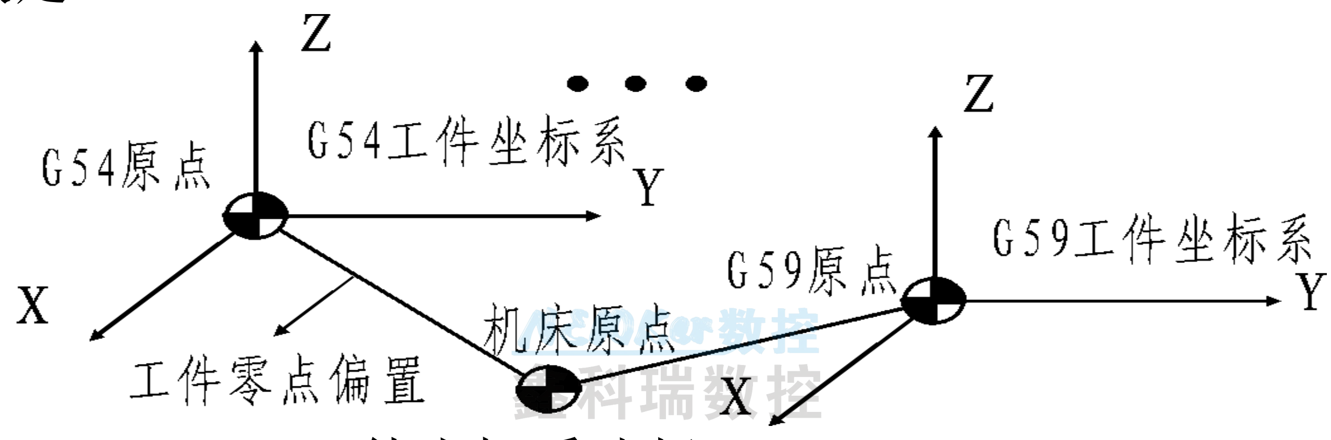
[picture p10: figure]

- 14 -

用来选择工件坐标系或机床坐标系。
指令格式：G53（G54/G55/G56/G57/G58/G59） （设定后为模态） G53 机床坐标系
G54 工件坐标系 1
G54.1/G54.48 工件坐标系 54.1/54.48
G55 工件坐标系 2
G56 工件坐标系 3
G57 工件坐标系 4
G58 工件坐标系 5
G59 工件坐标系 6
G53 机床坐标系是指由机床第一参考点（即机床零点）确定的坐标系。若修 改机床坐标系中坐标值后全部的工件坐标将随之偏置，通常情况建议不要修改 G53 坐标值，G53 为默认坐标系。
G54/G55/G56/G57/G58/G59工件坐标系在机床坐标系中的偏移量由坐标系参 数中的设置决定。

工件坐标系选择（G54-G59）
例如： G00 G54 X50 Y60 Z70
以 G00 快速移动到工件坐标系 G54 下的 X50、Y60、Z70 坐标点。

（2） 坐标系指令（G50/G52）

当在工件坐标系中编制程序时，为容易编程可以设定工件坐标系的子坐标系 称为局部坐标系。G50是工件坐标系绝对坐标设定，G52是局部坐标系相对坐标设 置。

指令格式：G50/G52 X- Y- Z- ; 设定坐标系。（设定后为模态）
G52 X0 Y0 Z0; | 取消局部坐标系。

用指令 G50/G52 可以在机床坐标系（G53）或工件坐标系（G54～G59）中设 定局部坐标系。局部坐标的原点设定在机床坐标系或工件坐标系中以 X- Y- Z-指 定的位置。
当局部坐标系设定时，后面的以绝对值方式G90 指令的移动是在局部坐标系 中的坐标值.用G50/G52 指定新的零点，可以改变局部坐标系的位置。为了取消 局部坐标系并在工件坐标系中指定坐标值，应使局部坐标系零点与工件坐标系零 点一致。

- numerical control sys -
tem -

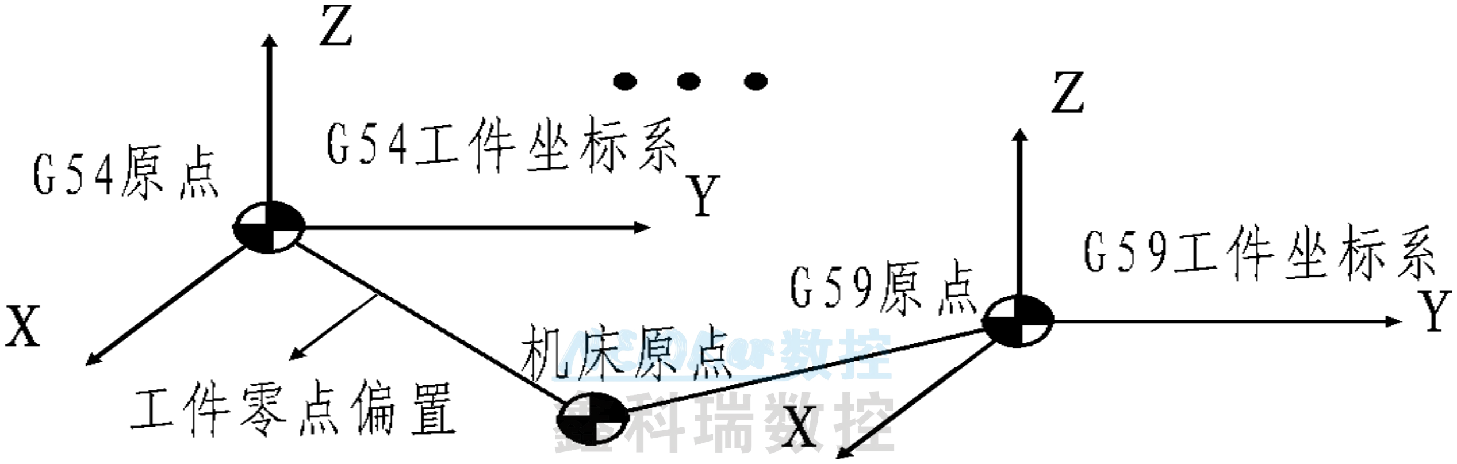
[picture p11: figure]

- 14 -

Used to select the workpiece coordinate system or machine tool coordinate system.
Instruction format: G53 (G54/G55/G56/G57/G58/G59) (set as mode)
G53 machine tool coordinate system
G54 Workpiece coordinate system 1
G54.1/G54.48 Workpiece coordinate system 54.1/54.48 G55 Workpiece coordinate system 2
G56 Workpiece coordinate system 3
G57 Workpiece coordinate system 4
G58 Workpiece coordinate system 5
G59 Workpiece coordinate system 6
The G53 machine tool coordinate system refers to the coordinate system determined by the machine tool's first reference point (i.e., the machine tool's zero point). If the coordinate values in the machine tool coordinate system are modified, all workpiece coordinates will be offset accordingly. In general, it is recommended not to modify the G53 coordinate values, as G53 is the default coordinate system.
The offset of the workpiece coordinate system in the machine tool coordinate system for G54/G55/G56/G57/G58/G59 is determined by the setting of the coordinate system parameters.

Workpiece coordinate system selection (G54-G59) For example: G00 G54 X50 Y60 Z70
Move quickly to the G00 coordinate system of the workpiece at X50, Y60, and Z70 coordinates under G54.
（2） Coordinate Instructions (G50/G52)
When programming in the workpiece coordinate system, a sub-coordinate system of the workpiece coordinate system can be set up to facilitate programming. G50 is the absolute coordinate setting of the workpiece coordinate system, and G52 is the relative coordinate setting of the local coordinate system.
Instruction format: G50/G52 X-Y-Z; Set the coordinate
system. (After setting, it becomes a mode)
G52 X0 Y0 Z0; Cancel the local coordinate system.
The G50/G52 command can be used to set the local coordinate system in either the machine tool coordinate system (G53) or the workpiece coordinate system (G54~G59). The origin of the local coordinate system is set at the position specified by X-Y-Z in either the machine tool coordinate system or the workpiece coordinate system. When a local coordinate system is set, subsequent G90 absolutevalue commands will operate using the coordinates within this system. By specifying new zero points with G50/G52 commands, the position of the local coordinate system can be adjusted. To cancel the local coordinate system and assign coordinates in the workpiece coordinate system, it is necessary to align the zero points of both systems.

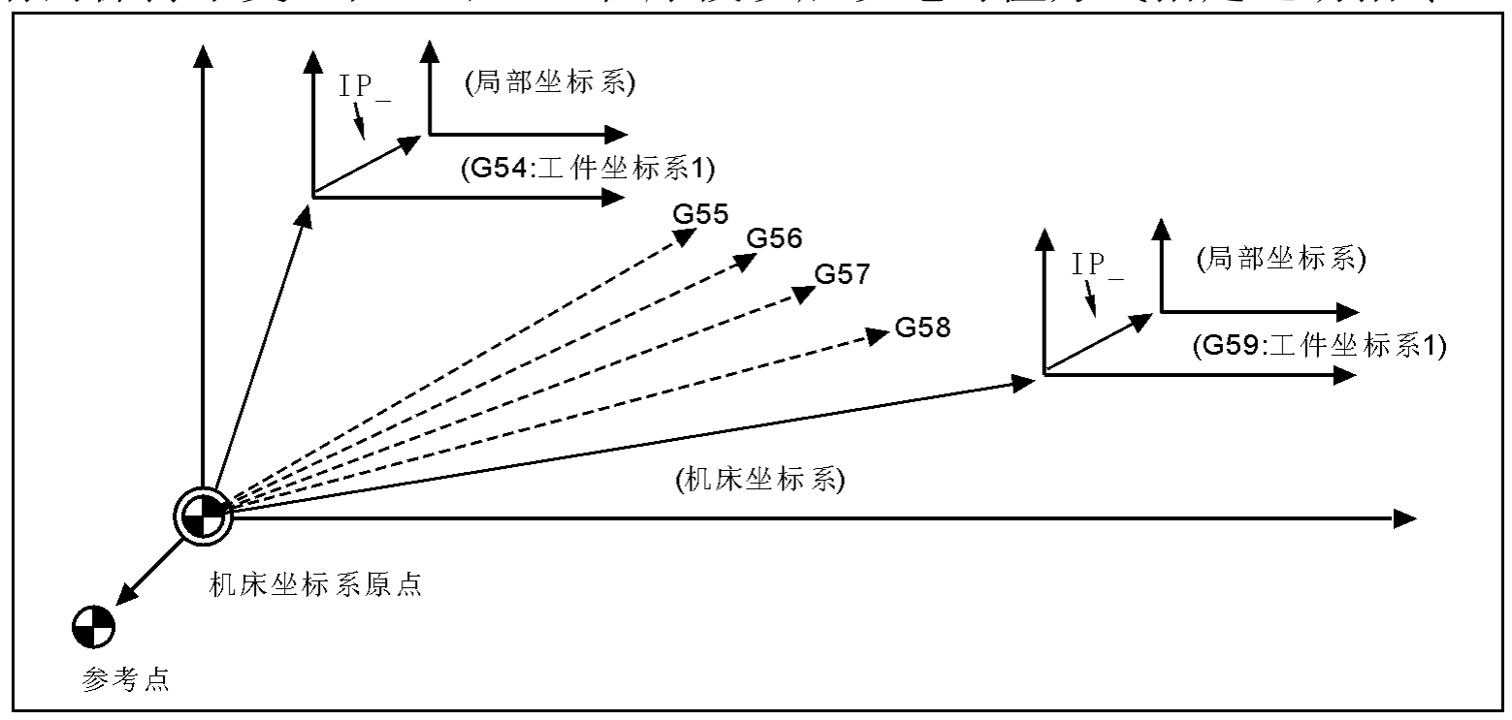
[picture p12: figure]

- 15 -

局部坐标系设定不改变工件坐标系和机床坐标系。当用G50/G52 指令设定工 件坐标系时，如果不是指令所有轴的坐标值的话，未指定坐标值的轴的局部坐标 系不取消而保持不变。在G50/G52 程序段以后以绝对值方式指定运动指令。

（3）编程方式指令（G90/G91）

有两种方法指令刀具的移动：绝对值指令和增量值指令。在绝对值指令中， 编程终点的坐标值;而在增量值指令中，编程移动距离。G90和G91 分别用来指明 坐标字中用的是绝对编程或增量编程。

指令格式：G90 （模态，初态） ;绝对坐标编程方式。
G91 （模态） | ;增量坐标编程方式。
注意：旋转轴绝对坐标编程时是就近计算执行，相对坐标编程是按编程计算 执行；

（4） 平面选择指令（G17/G18/G19）

指令格式：G17 （模态，初态） | ;指定 XY 平面
G18 （模态） | ;指定 ZX 平面
G19 （模态） | ;指定 YZ 平面
用来指定圆弧插补的平面，不产生任何动作。

（5）快速定位指令（G00）

刀具以快速移动速度移动到用绝对值指令或增量值指令指定的工件坐标系 中的位置。
以绝对值指令编程时编制终点的坐标值；
以增量值指令编程时编制刀具移动的距离 。

- numerical control system -

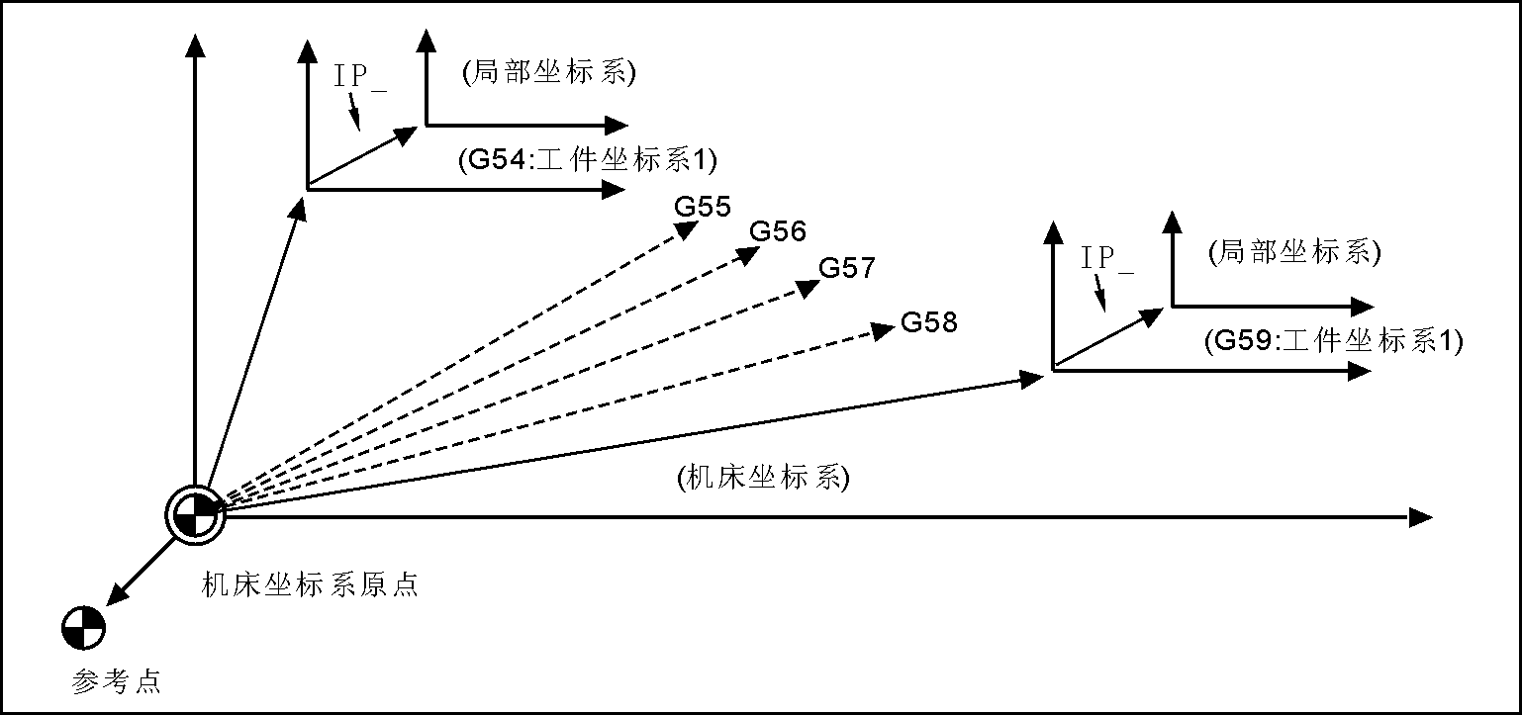
[picture p13: figure]

- 15 -

The local coordinate system setting does not alter the workpiece coordinate system or the machine tool coordinate system. When using G50/G52 commands to set the workpiece coordinate system, if the command specifies coordinates for all axes, the local coordinate systems of unselected axes remain unchanged. Subsequent motion commands in the G50/G52 program segment must be specified using absolute values.

（3） Programming Instructions (G90/G91)
There are two types of commands to control tool movement: absolute and incremental. In absolute commands, the programming endpoint coordinates are specified; in incremental commands, the programmed travel distance is defined. The G90 and G91 commands respectively indicate whether absolute or incremental programming is used for coordinate values.

Instruction
format: G90

(Mode, initial
state)

; Absolute coordinate programming mode.

G91 （ modality ）

; Incremental coordinate programming mode.

Note: When the absolute coordinate programming of the rotation axis is calculated, the nearest calculation and execution are performed; when the relative coordinate programming is calculated, the programming is executed;
（4） Planar selection command (G17/G18/G19)
Instruction format: G17 (mode, initial state) ; Specify
the XY plane
G18（ modality ） | ; Specify the ZX plane
G19（ modality ） | ; Specify the YZ plane
The plane used to specify the arc interpolation does not produce any action.
（5） Quick Positioning Instruction (G00)
The tool moves quickly to the position in the workpiece coordinate system specified by the absolute value instruction or the incremental value instruction.
Compile the coordinate value of the endpoint when programming with absolute value instructions;
The distance of tool movement is programmed when using incremental value instructions.

- 16 -

指令格式：G00 X-Y-Z-A-B-C-Xs-Ys-（模态，初态） 说明：X，Y，Z，A，B，C，Xs，Ys 坐标字表示运行轴。其数据指明移动量 和方向，可以用增量编程或绝对编程。
G00 时各轴单独以各自设定的速度快速移动到终点，互不影响。任何一轴到 位自动停止运行，另一轴继续移动直到指令位置。也可以联动方式：通过杂类参 数P9号D6=0设置成联动运行方式。
运行速度调用“速度参数”中所设定的 G00 速度值为依据。

（6） 直线插补指令（G01）

用来单轴或二、三、四轴联动的插补加工切削。
指令格式：G01 X-Y-Z-A-B-C-Xs-Ys- F- （模态） 说明：X，Y，Z，A，B，C，Xs，Ys 坐标字表示运行轴，其数据指明进给量 和方向，可以用增量编程或绝对编程。插补速度由程序中 F 字段指定。 G01 指令的F 进给速度可以通过面板上进给倍率上下调整，调整范围是（0％～ 150％）。
G01 指令也可直接写成G1。

（7） 圆弧插补指令（G02/G03）

用来在指定平面上，进行 G02 顺圆（顺时针方向）或 G03 逆圆（逆时针方向） 的圆弧插补切削。

指令格式：G17 | F_ R_

I_J_ X_Y_ G03

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
;XY 平面（模态）

G18 G02
G03

X_ Z_

I_ K_ R_ F_

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
;ZX 平面（模态）

G19 G02
G03

Y_ Z_

J_ K_ R_ F_

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
;YZ 平面（模态）

说明：圆弧插补必须明确插补平面，坐标字中 X、Y、Z 是圆弧的终点坐标 （增量或绝对编程），I、J、K 分别是 X、Y、Z 轴上起点（速度参数 P53 加 4 时 表示从圆弧终点）到圆心的增量坐标值。也就是说以起点为零，圆心在起点的正 方向为正，在起点的负方向为负。I J K 是描述圆心位置的坐标。也可不用 I、 J、K 而直接用 R 编程，当圆弧大于 180 度时 R 用负值，整圆不能用 R 编程。 圆弧的走向以右手直角坐标系中从垂直于圆弧插补平面的正方向往负方向 而言设定的。
在不同圆弧插补平面顺圆或逆圆走向如下图

- numerical control sys -
tem -
- 16 -

Instruction format: G00 X-Y-Z-A-B-C-Xs-Ys- (mode, initial state)
Note: X, Y, Z, A, B, C, Xs, Ys coordinates indicate the running axis. The data indicates the amount and direction of movement, which can be programmed incrementally or absolutely.
At G00, each axis moves quickly to the end point at its own preset speed without affecting each other. When any axis reaches the position, it automatically stops running while the other axis continues moving until reaching the specified position. Alternatively, a linked operation mode can be set by configuring parameter P9 D6=0 to enable coordinated operation.
The operating speed is based on the G00 speed value set in the " Speed parameter".
（6） Linear Interpolation Command (G01)
Used for single axis or two, three, four axis linkage interpolation machining cutting.
Instruction format: G01 X-Y-Z-A-B-C-Xs-Ys-F- (mode)
Note: X, Y, Z, A, B, C, Xs, Ys coordinates indicate the running axis. Their data indicates the feed rate and direction. Incremental programming or absolute programming can be used. The interpolation speed is specified by the F field in the program.
The feed speed of G01 command F can be adjusted up and down by the feed multiplier on the panel, and the adjustment range is (0% ~ 150%).
The G01 instruction can also be written directly as G1.
（7） Circular Arc Interpolation Instruction (G02/G03)
Used to perform G02 clockwise (clockwise) or G03 counterclockwise (counterclockwise) arc interpolation and cutting on a specified plane.

指令格式：G17
R_

I_J_ X_Y_ G03

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
F_; XY plane (mode)

G03

X_ Z_ R_

í | F_
î

ý
þ

í
î

ý
þ

G18 (G02) <sup>I</sup>

_<sup>K</sup>

_
); ZX plane
(mode)

G19 G02
G03

Y_ Z_

J_ K_ R _

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
ýF_Y;YZ plane (mode)

Note: Arc interpolation must specify the interpolation plane. In coordinate parameters, X, Y, and Z represent the endpoint coordinates of the arc (incremental or absolute programming). I, J, and K denote the incremental coordinates from the starting point (when P53 is set to 4, indicating the arc endpoint) to the center along the X, Y, and Z axes respectively. Specifically, with the starting point as zero, the positive direction of the center corresponds to the starting point's position, while the negative direction indicates the opposite position. I, J, and K describe the center's coordinates. Alternatively, R programming can be used directly instead of I, J, and K. When the arc exceeds 180 degrees, R should be set to a negative value. Full circles cannot be programmed using R programming.
The direction of the arc is defined in the right-handed Cartesian coordinate system from the positive direction to the negative direction perpendicular to the arc interpolation plane.
The different arc interpolation planes follow the clockwise or counterclockwise direction as shown in the figure below

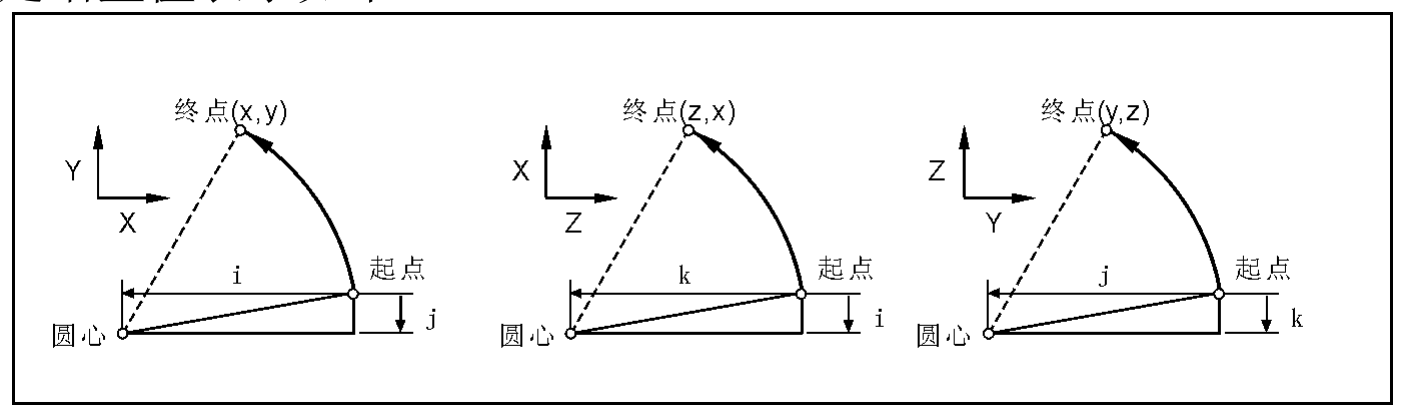
[picture p14: figure]

- 17 -

用地址 I J K 指令的圆弧中心位置，I J K 后的数值是从起点向圆弧中心看 的矢量分量， I J K 必须根据方向指定其符号正或负.I J K 可以省略，当省略时终 点与起点相同，且中心用 I J K 指定时是 360 的圆弧整圆.并且，不管是 G90 还 是 G91 总是增量值表示如下：

增强型圆弧功能(A/B 轴与 XYZ 插补圆弧):
格式：G177(G17.1)/G17.2 G02/G03 X-A/B-I-J-R- ;XA 平面 G188(G18.1)/G18.2 G02/G03 Z-A/B-K-I-R- ;ZA 平面 G199(G19.1)/G19.2 G02/G03 Y-A/B-J-K-R- ;YA 平面
G177(G17.1) 选 XA 平面；G188(G18.1) 选 ZA 平面；G199(G19.1) 选 YA 平面。G17.2 选 XB 平面；G18.2 选 ZB 平面；G19.2 选 YB 平面。
在 XA/XB 平面中用 IJ 指定圆心（I 对应 X 轴；J 对应 A/B 轴）； 在 ZA/ZB 平面中用 KI 指定圆心（K 对应 Z 轴；I 对应 A/B 轴）； 在 YA/YB 平面中用 JK 指定圆心（J 对应 Y 轴；K 对应 A/B 轴）。 注意:
1,当不使用 A/B 轴圆弧插补时，必须回到 G17/G18/G19 平面;
2,当使用 A/B 轴圆弧插补指令时，A/B 轴必须设置为直线轴;
3,用 R 指定半径，当圆弧大于 180 度时 R 用负值表示，整圆不能用 R 编程。

G03
G02
0 | X

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
0 | Y

Z

G19

- numerical control sys -
tem -

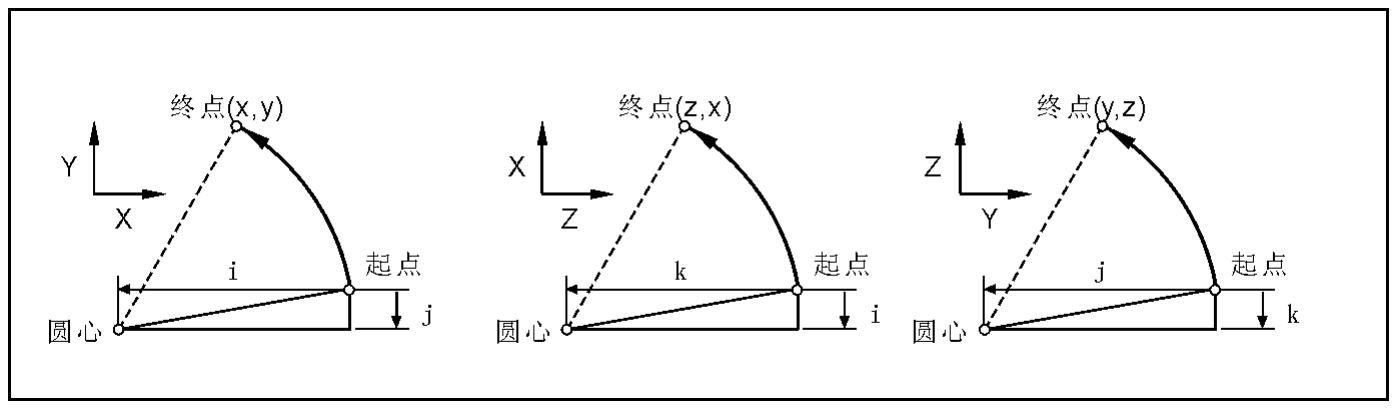
[picture p15: figure]

- 17 -

Use the address I J K to indicate the center position of the arc. The value after I J K is from the starting point to the center of the arc
The vector components I J K must be assigned positive or negative signs according to their direction. The components I J K may be omitted, in which case the endpoint coincides with the starting point, and when specified by I J K, it represents a full 360-degree arc. Additionally, whether using G90 or G91 commands, the incremental values are always expressed as follows:

Enhanced arc function (A/B axis and XYZ interpolated arc): Format: G177 (G17.1)/G17.2 G02/G03 X-A/B-I-J-R-; XA plane G188 (G18.1)/G18.2 G02/G03 Z-A/B-K-I-R-; ZA plane G199 (G19.1)/G19.2 G02/G03 Y-A/
B-J-K-R-; YA plane
G177 (G17.1) Select the XA plane; G188 (G18.1) Select the ZA plane; G199 (G19.1) Select the YA plane. G17.2 Select the XB plane; G 18.2 Select the ZB plane; G19.2 Select the YB plane.
In the XA/XB plane, the center is specified by IJ (I corresponds to the X-axis; J corresponds to the A/B-axis);
In the ZA/ZB plane, the center is specified by KI (K corresponds to the Z-axis; I corresponds to the A/B axis);
In the YA/YB plane, the center of circle is specified by JK (J corresponds to the Y-axis; K corresponds to the A/B axis).
pay attention to ：
1. When the A/B axis arc interpolation is not used, you must return to the G17/G18/G19 plane;
2. When using the A/B axis arc interpolation instruction, the A/B axis must be set as a straight axis;
3. Use R to specify the radius. When the arc is greater than 180 degrees, R is expressed with a negative value. The whole circle cannot be programmed with R.

G03
G02
0 | X

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
0 | Y

Z

G19

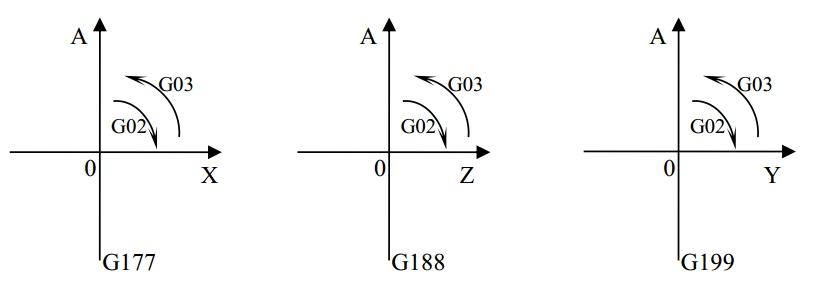
[picture p16: figure]

- 18 -

举例：
1）绝对编程
N0000 G00 X200 Y40 Z0 | 设起刀点绝对坐标位置
N0010 G90 G03 X160 Y40 I-20 J0
F300
| 逆圆弧
N0020 G02 X120 Y40 R20 | 顺圆弧
N0030 G02 X120 Y40 I20 J0 | 整圆
N0040 G26 M02 | 回起点结束
2）相对编程
N0000 G91 G17 G03 X-40 Y0 R20
F300
| 逆圆弧
N0010 G02 X-40 Y0 R20 | 顺圆弧
N0020 G02 X0 Y0 I20 J0 | 整圆
N0030 G26 M02 | 回起点结束

（8） 螺旋线插补指令（G02/G03）

螺旋移动的螺旋线插补可指定一个与圆弧插补轴同步移动的其它轴。指令方 法只是简单地加上一个不是圆弧插补轴的移动轴，F 指令指定沿圆弧的进给速度。 因此直线轴的进给速度为：

指令格式： | G17 | Z_F_ R_

I_J_ X_Y_ G03

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
ì | ；XY 平面（模态）
G18 | Y_F_ R_
I_K_ X_Z_ G03

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
ì | ；ZX 平面（模态）
G19 | X_F_ R_

J_K_ Y_Z_ G03

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
ì | ；YZ 平面（模态）

螺旋线增强功能，可以编入螺距K(或J或I)用于多圈螺旋线加工： G02(G03) X__ Y__ I__ J__ F__ Z_ K__ (G17, K螺距，单位毫米)； G02(G03) X__ Z__ I__ K__ F__ Y_ J__ (G18, J螺距，单位毫米)；

- numerical control sys -
tem -
- 18 -

give an example ：
1） Absolute programming
N0000 G00 X200 Y40 Z0

Set the absolute
coordinate position
of the cutting point

N0010 G90 G03 X160 Y40 I-20 J0 F300 The reverse arc

N0020 G02 X120 Y40 R20 Smooth the arc

N0030 G02 X120 Y40 I20 J0

Round the whole
thing

N0040 G26 M02

Return to the starting point
2） Relative programming

N0000 G91 G17 G03 X-40 Y0 R20 F300

The reverse arc

N0010 G02 X-40 Y0 R20 Smooth the arc

N0020 G02 X0 Y0 I20 J0

Round the whole
thing

N0030 G26 M02

Return to the starting point
（8） Spiral Lead-in Instruction (G02/G03)
The helical interpolation of a spiral path allows specifying an additional axis that moves synchronously with the arc interpolation axis. The command method simply adds a movement axis other than the arc interpolation axis, while the F command specifies the feed rate along the arc. Consequently, the feed rate for the linear axis is:

指令格式： G17
R_

I_J_ X_Y_ G03

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
Z_F_

; XY plane (mode)

Y_F_ R_ X_Z_ G03 | þ
ý
î

í
þ

ý
î

í

G18 (G02) <sup>I</sup>

_<sup>K</sup>

_
); ZX
plane (mode)

G19
R_

J_K_ Y_Z_ G03

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
X_F_; YZ plane (mode)
Spiral line enhancement function, which can be programmed with pitch K (or J or I) for multi-turn spiral processing:
G02 (G03) X__Y__I__J__F__Z_K__ (G17, K pitch, unit mm);
G02 (G03) X__Z__I__K__F__Y_J__ (G18, J pitch, unit mm);

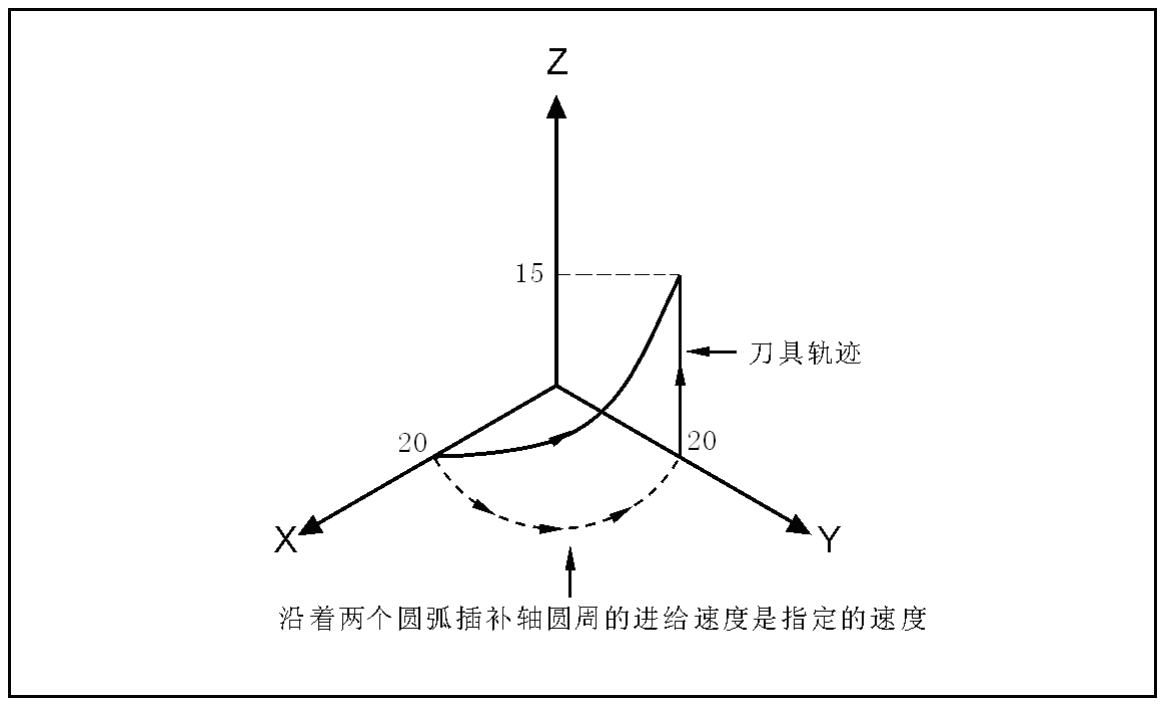
[picture p17: figure]

- 19 -

G02(G03) Y__ Z__ J__ K__ F__ X_ I__ (G19, I螺距，单位毫米)； G02(G03) X__ A__ I__ J__ F__ Z_ K__ (G177/XA平面, K螺距，单位毫米)； G02(G03) Z__ A__ K__ I__ F__ Y_ J__ (G188/ZA平面, J螺距，单位毫米)； G02(G03) Y__ A__ J__ K__ F__ X_ I__ (G199/YA平面, I螺距，单位毫米)； 刀具半径补偿只对圆弧进行，在指令螺旋线插补的程序段中不能指令刀具偏 置和刀具长度补偿。
举例：

N0001 G90 G17 G54
N0002 G01 X20 Y0 Z0 F600
N0003 G03 X0 Y20 R20 Z15 F180 ……

（9）三维空间圆弧指令 G06

指令格式： G06 X__ Y__ Z__ I__ J__ K__ F__ 指令功能：如果不知道三维空间圆弧的圆心,半径。但已知圆弧轮廓上的三 个点的坐标,则可使用三维空间圆弧指令 G06 功能，通过始点和终点之间的中间 点位置确定圆弧方向。
指令说明：G06 为模态 G 代码；
I:圆弧所经过的中间点相对于起点的相对坐标值(X 向)(半径值表示,带方 向)；
J:圆弧所经过的中间点相对于起点相对坐标值(Y 向)(带方向)； K：圆弧所经过的中间点相对于起点相对坐标值(Z 向)(带方向)。 注意事项：
1),中间点：是指圆弧上除起点和终点之外的任意一点； 2),当给出的三点共线时，系统产生报警；
3),当省略 I 时即认为 I=0，当省略 K 时即认为 K=0 ，当省略 J 时即认为 J=0 ；当同时省略 I、J、K 时，系统产生报警；
4),I、J、K 的意义类似于 G02/G03 指令中圆心坐标相对于起点坐标的位移

- numerical control sys -
tem -

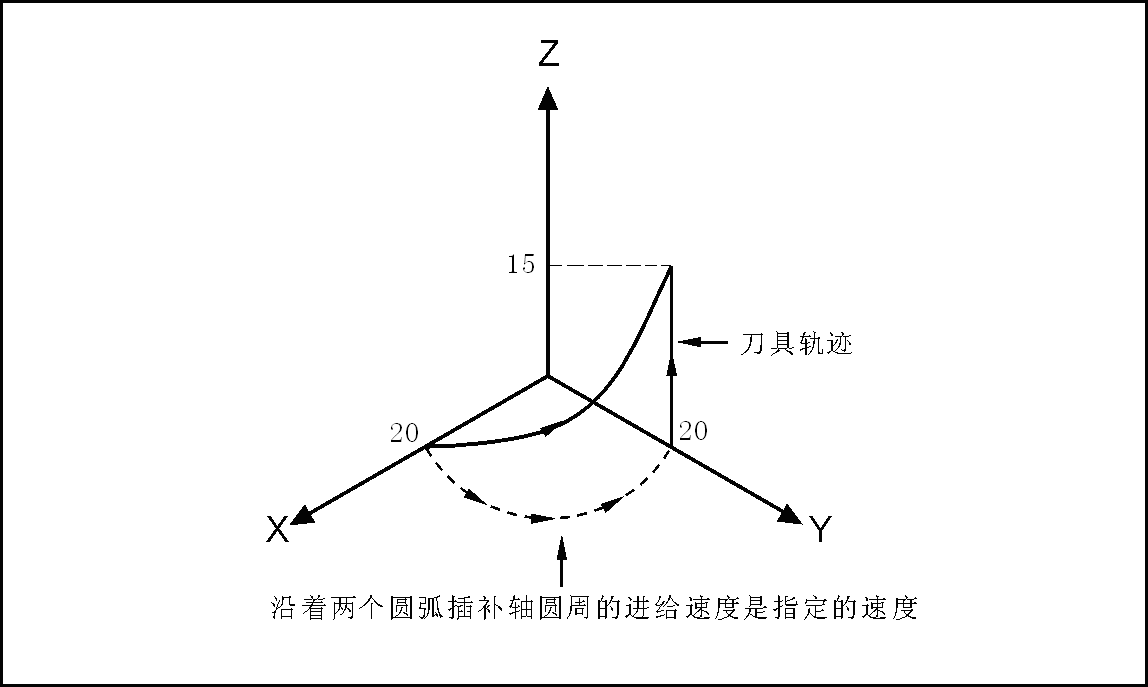
[picture p18: figure]

- 19 -

G02 (G03) Y__Z__J__K__F__X_I__ (G19, I pitch, unit mm);
G02 (G03) X__A__I__J__F__Z_K__ (G177/XA plane, K pitch, unit mm); G02 (G03) Z__A__K__I__F__Y_J__ (G188/ZA plane, J pitch, unit mm); G02 (G03) Y__A__J__K__F__X_I__ (G199/YA plane, I pitch, unit mm); Tool radius compensation is only for arcs, and tool offset and tool length compensation cannot be specified in the program segment of spiral interpolation.
give an example ：

N0001 G90 G17 G54
N0002 G01 X20 Y0 Z0 F600
N0003 G03 X0 Y20 R20 Z15 F180
……
（9） 3D Spatial Arc Command G06
Instruction format: G06 X__Y__Z__I__J__K__F__
Instruction function: If you do not know the center and radius of a 3 d space arc, but know the coordinates of three points on the arc contour, you can use the 3d space arc instruction G06 function to determine the direction of the arc by the position of the midpoint between the starting point and the end point.
Instruction description: G06, is the mode G code;
I: The relative coordinate value (X direction) of the midpoint of the arc relative to the starting point (the radius value indicates the direction);
J: The relative coordinate value (Y direction) of the midpoint of the arc relative to the starting point;
K: Relative z-direction coordinate value (with direction) of the midpoint of the arc relative to the starting point.
Matters Need Attention ：
1) The midpoint: refers to any point on the arc other than the starting point and the end point;
2) When the three points are given to be collinear, the system generates an alarm;
3) When I is omitted, I=0; when K is omitted, K=0; when J is omitted, J=0; when I, J and K are omitted at the same time, the system generates an alarm;
4) The meaning of I, J and K is similar to the displacement of the center coordinate relative to the starting point coordinate in the G02/G 03 instruction

- 20 -

值 I、J、K；
5),G06 不能加工整圆。
6),该指令数学计算量较大，在总线系统上才能有效的运行，在其它系统上 可能会运行不流畅；
举例：
G0 X10 Y28 Z10
G06 X30 Y98 Z10 I5 J-6 K-5 F100 X130 Y198 Z120 I55 J-86 K-65 G0X0Z0
M02

（10） 延时指令（G04）

用来在加工过程中因加工工艺需要，延时一定时间再执行其它动作。 指令格式：G04 P－； 或
G04 X__； 或
G04 U__；

令功能：执行该指令时，各轴运动停止，模态值保持，延时指定的时间后，再执 行下一个程序段。
指令说明：
1．P__是以毫秒为单位指令暂停时间。单位:毫秒。
2．X__、U__均是以秒为单位指令暂停时间。单位:秒。 3．实例：
G04 X1； 表示程序暂停1秒。
G04 P1000； 表示程序暂停1秒。
G04 U1； 表示程序暂停1秒。
4．特殊应用：指令G04可看成为准确停指令，如加工拐角类零件时，在拐角 处有时会出现过切现象，如在拐角处加G04指令，即可消除过切现象。 如下图所示：

例：……
N150 G01 X20 Z10 F100；
N160 G04 P150；（可消除拐角处过切现象） N170 G01 Y-10；

- numerical control sys -
tem -

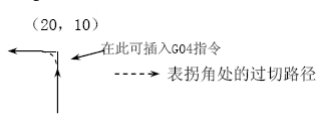
[picture p19: figure]

- 20 -

Values I, J, K;
5) , G06 cannot be processed into a full circle.
6) , The instruction has a large amount of mathematical calculation, and can only run effectively on the bus system, but may not run smoothly on other systems;
give an example ：
G0 X10 Y28 Z10
G06 X30 Y98 Z10 I5 J-6 K-5 F100 X130 Y198 Z120 I55 J-86 K-65 G0X0Z0
M02
（10） Delay instruction (G04)
Used to delay other actions for a certain period of time during the processing process due to the processing requirements.
| Instruction format: G04
| P-; or G04 X_
| _; or
| G04 U__；
Function: When the instruction is executed, the movement of each axis stops, the mode value remains, and the next program segment is executed after a specified delay time.
Instruction description:
1.P__ is the instruction pause time in milliseconds. Unit: milliseconds.
2.X__ and U__ are the instruction pause time in seconds. Unit: seconds.
3．living example ：
G04 X1; indicates that the program is suspended for 1 second. G04 P1000; indicates that the program is suspended for 1 second. G04 U1; indicates that the program is suspended for 1 second. 4． Special application: The instruction G04 can be regarded as an accurate stop instruction. For example, when machining corner parts, overcutting phenomenon may occur at the corner. If the G04 instruction is added at the corner, the overcutting phenomenon can be eliminated. As shown in the figure below:

example ：……
N150 G01 X20 Z10 F100；
N160 G04 P150; (to eliminate overcut at corners)
N170 G01 Y-10；

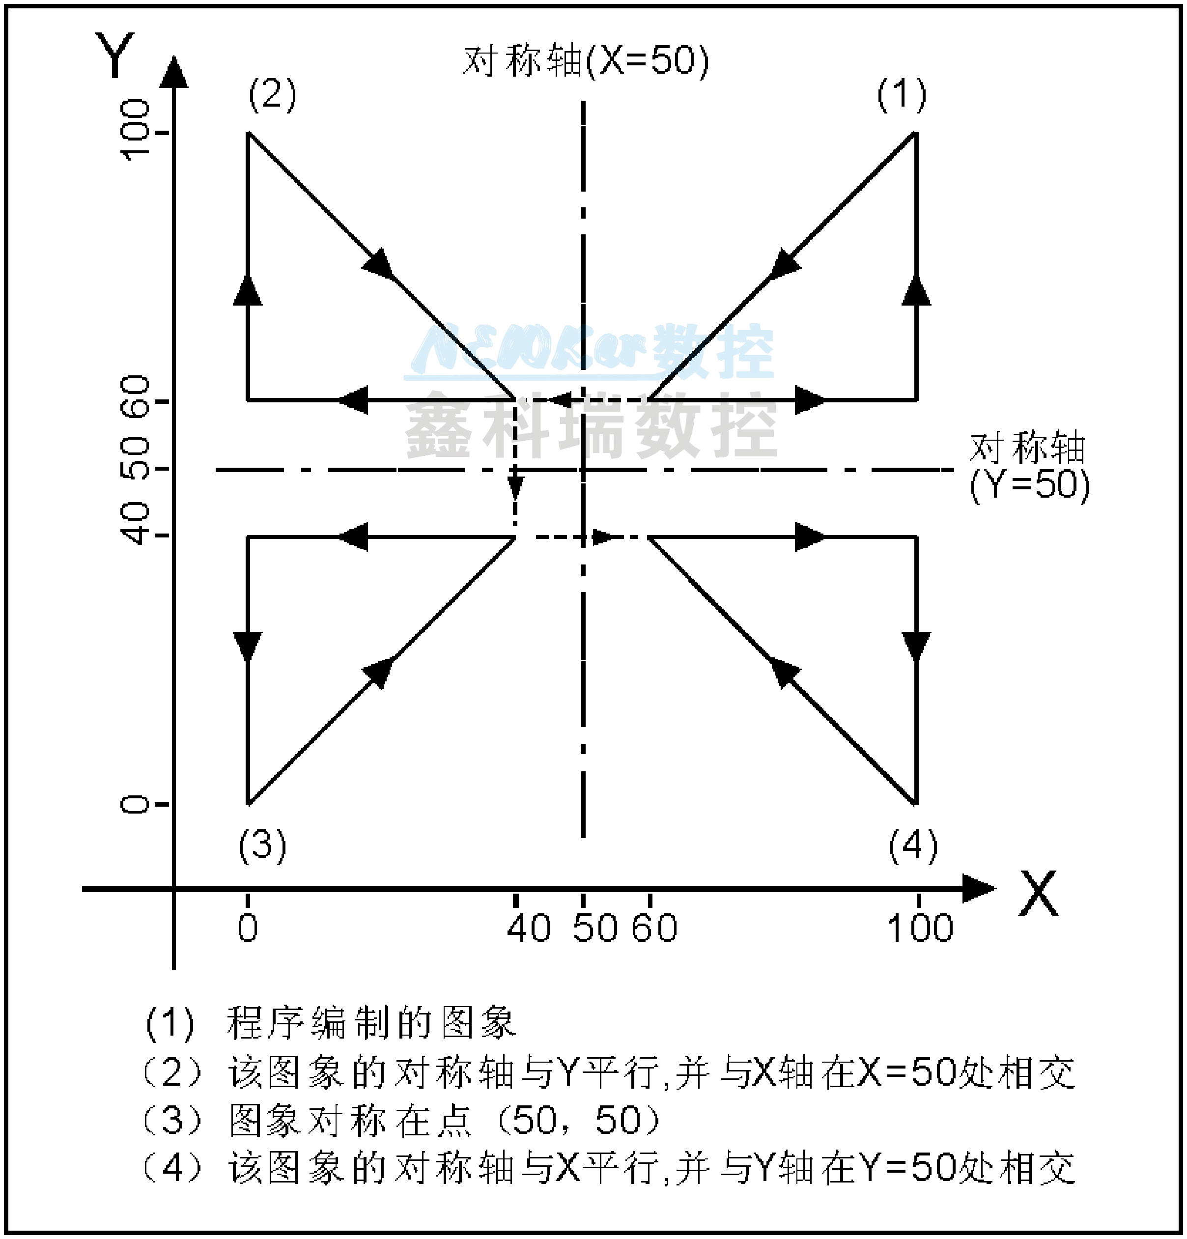
[picture p20: figure]

- 21 -

……
注：也可以设置加工参数P21号参数，消除过切现象。

（11）镜像加工指令（G11/G12）

用于对称工件的加工，减少编程量。
指令格式：G11 X_ Y_ （Z_ X_ ） （Y_ Z_ ）（模态）
以 XYZ 指定直线的对称方向进给
G12 （模态，初态） ；取消镜像加工。
说明：镜像加工用改变轴进给方向实现在该轴上的对称点加工进给。要改变 方向的轴由当前插补平面 G17（X_ Y_ ）； G18 （Z_ X_ ）； G19（Y_ Z_ ）地址 符指定。X_ Y_ Z_后的数值为当前工件坐标系下的坐标。 在可编程镜像方式中，返回参考点的指令G26、G61、G28、G30 等和改变坐标 系的指令G52、G53/G59等不允许出现.如果需要这些G 代码的任意一个必须在取 消可编程镜像方式之后再指定。
举例：

子程序
KG11
N10 G00 G90 X60.0 Y60.0；
N20 G01 X100.0 F100；
N30 G01 Y100.0；
N40 G01 X60.0 Y60.0；
N50 M99；
主程序
N10 G00 G90；

- numerical control system -

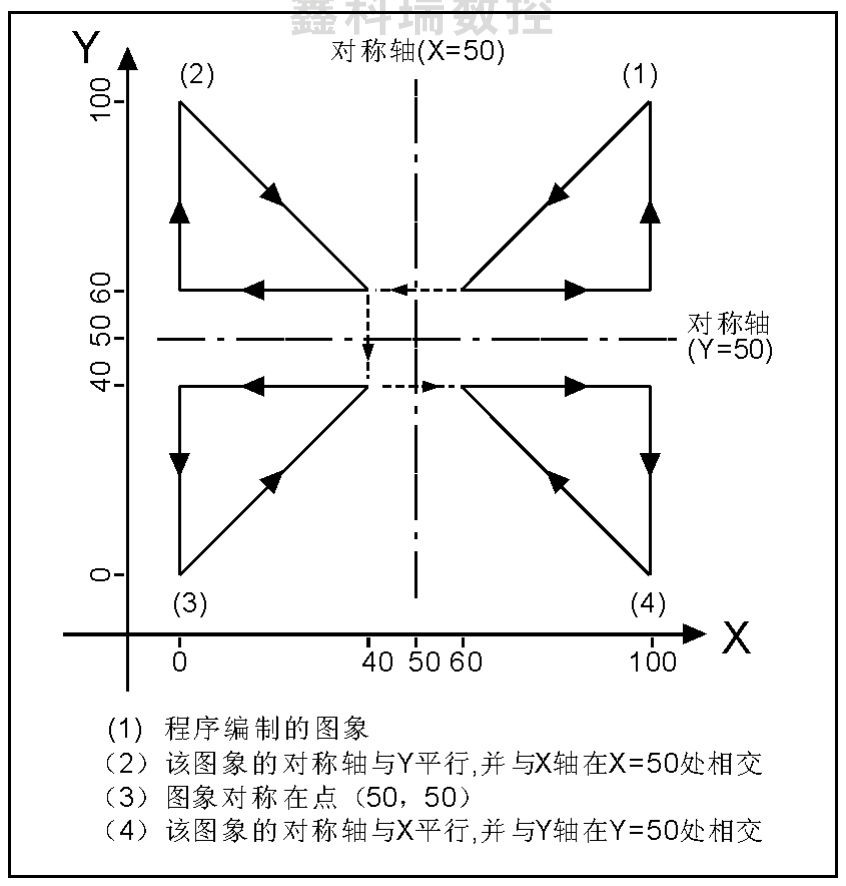
[picture p21: figure]

- 21 -

……
Note: The machining parameter P21 can also be set to eliminate the overcut phenomenon.
（11） Mirror Processing Command (G11/G12)
Used for processing symmetrical workpieces to reduce programming. Instruction format: G11 X_Y_ (Z_X_) (Y_Z_) (mode)
Feed G12 (mode, initial state) in the direction of symmetry of the specified XYZ line; cancel mirror processing.
Note: Mirror machining achieves symmetrical point processing feed on the axis by altering the feed direction. The axis to be redirected is specified by the current interpolation planes: G17 (X_Y_), G18 (Z_X_), and G19 (Y_Z_). The values following X_Y_Z_ represent coordinates in the workpiece's current coordinate system.
In the programmable mirror mode, instructions such as G26, G61, G 28, and G30 that return reference points, as well as commands like G52, G53/G59 that change the coordinate system, are not allowed. If any of these G codes is required, they must be specified after canceling the programmable mirror mode.
give an example ：

subprogram
KG11
N10 G00 G90 X60.0 Y60.0；
N20 G01 X100.0 F100；
N30 G01 Y100.0；
N40 G01 X60.0 Y60.0；
N50 M99;
main program N10
G00 G90;

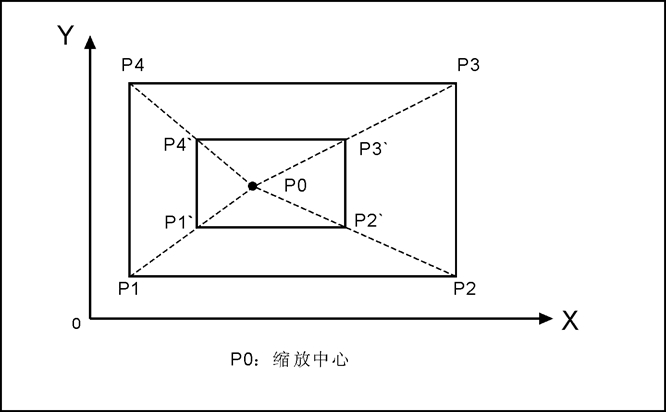
[picture p22: figure]

- 22 -

N20 M98 PKG11；
N30 G11 X50.0；
N40 M98 PKG11；
N50 G11 X50.0 Y50.0；
N60 M98 PKG11；
N70 G11 Y50.0；
N80 M98 PKG11；
N90 G12；
N100 M02

（12）比例缩放指令（G36/G37）

用于不改变加工程序的情况下，按比例缩小或放大加工出的工件。编程的形 状被放大和缩小（ 比例缩放），用 X_，Y_和 Z_指定比例缩放中心。若某一轴未 指定，则该轴不执行比例缩放。X_ Y_ Z_后的数值为当前工件坐标系下的坐标。
指令格式：G36 X_Y_Z_R_ （模态） | ；执行比例缩放
G37 （模态，初态） | ；比例缩放取消
说明：地址符 R 后的数据为比例系数。
下图中当 P1’P2’P3’P4’要放大到 P1P2P3P4 的图形时，R=P0P4’/P0P4。 当 P1P2P3P4 要缩小到 P1’P2’P3’P4’的图形时，R=P0P4/P0P4’。即：图形放 大 R 小于 1，图形缩小 R 大于 1。缺省值为 1。
图示：

比例缩放对刀具半径补偿值、刀具长度补偿值和刀具偏置值无效：

- numerical control system -

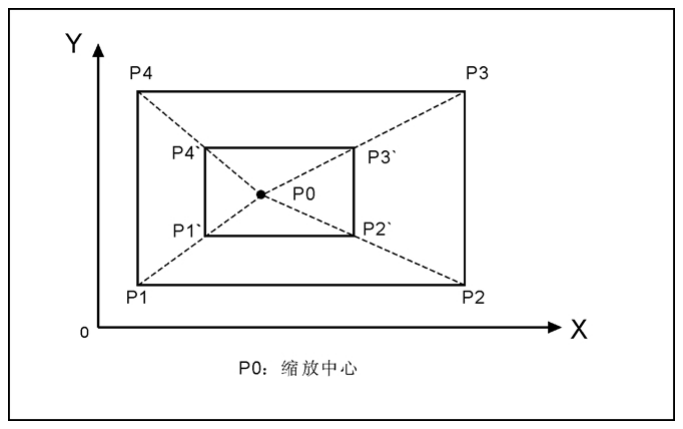
[picture p23: figure]

- 22 -

N20 M98 PKG11；
N30 G11 X50.0；
N40 M98 PKG11；
N50 G11 X50.0 Y50.0；
N60 M98 PKG11；
N70 G11 Y50.0；
N80 M98 PKG11；
N90 G12；
N100 M02
（12） Proportional Scaling Instructions (G36/G37)
This process involves proportionally scaling (either enlarging or reducing) workpieces without altering the original machining program. The programmed shape undergoes proportional scaling, with X_, Y_, and Z_ coordinates specifying the scaling center. If no axis is specified, that axis remains unaffected by scaling. The values after X_Y_Z_ represent coordinates in the current workpiece's coordinate system. Instruction format: G36 X_Y_Z_R_ (mode)

; Scale the execution ratio
G37 (modes, initial state) ; Zoom out Note: The data after the address symbol R is the proportional coefficient.
In the diagram below, when scaling from P1 to P2 to P3 to P4, the ratio R=P0P4 / P0P4. When scaling back from P1 to P2 to P3 to P4, the ratio R=P0P4 / P0P4'. This means: the scaling ratio is less than 1 for enlargement and greater than 1 for reduction. The default value is 1. graphic ：

Proportional scaling is invalid for tool radius compensation value, tool length compensation value and tool offset value:

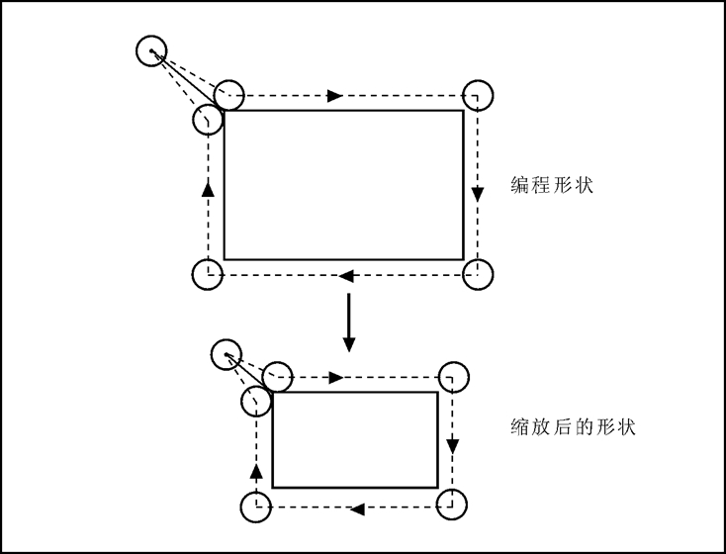
[picture p24: figure]
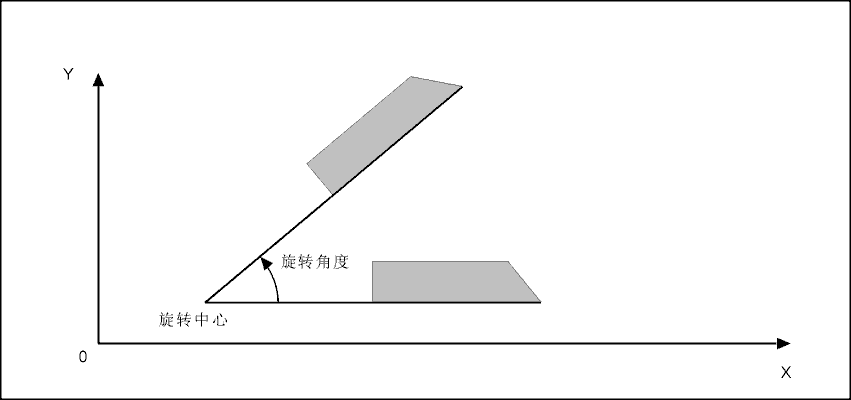
[picture p25: figure]

- 23 -

（13） 坐标系旋转指令（G68/G69）

编程形状能够旋转，用该旋转指令可将工件旋转某一指定的角度。另外，如 果工件的形状由许多相同的图形组成，则可将图形单元编成子程序，然后用主程 序的旋转指令调用。这样可简化编程，节省存储空间。
指令格式：G68 X- Y- R- （模态） ；执行坐标系旋转
G68 Z- X- R- （模态） ；执行坐标系旋转 G68 Y- Z- R- （模态） ；执行坐标系旋转 G69 （模态，初态） ；坐标系旋转取消
说明：
G68 后的（G17）X-Y-或（G18）Z-X-或（G19）Y-Z-指定旋转中心
地址符 R 后的数据为旋转角度。X_ Y_ Z_后的数值为当前工件坐标系下的坐 标。
R 为旋转角度，单位是“°”；R 为正值时，表示逆时针旋转，R 为负值时， 表示顺时针旋转。
图示：

在坐标系旋转代码G68 的程序段之前指定平面选择代码（G17G18 或G19），

- numerical control system -
- 23 -

（13） Coordinate System Rotation Command (G68/G69)
The program can rotate shapes by using rotation commands to turn the workpiece at a specified angle. Additionally, if a workpiece's shape consists of multiple identical graphic elements, these elements can be compiled into subroutines and then called using the main program's rotation command. This approach simplifies programming and saves storage space.
Instruction format: G68 X-Y-R- (mode); execute coordinate system rotation
G68 Z-X-R (mode); performs coordinate system rotation
G68 Y-Z-R (mode); performs coordinate system rotation
G69 (Mode, Initial State); Coordinate system rotation cancelled
explain ：
The X-Y or G18 Z-X or G19 Y-Z designation of the rotation center is after G68
The data after the address 符 R is the rotation Angle. The values after X_Y_Z_ are the coordinates in the current workpiece coordinate system.
R is the rotation Angle, unit of "°"; R is positive for counterclockwise rotation and negative for clockwise rotation.
graphic ：

Before the program segment of coordinate system rotation code G68, specify the plane selection code (G17G18 or G19),

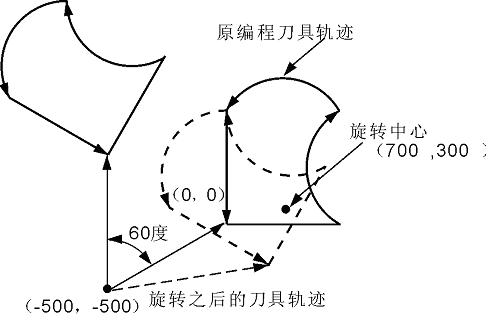
[picture p26: figure]

- 24 -

平面选择代码不能在坐标系旋转方式中指定。取消坐标系旋转方式的代码G69 必 须单独占一程序段。在坐标系旋转之后，执行刀具半径补偿，刀具长度补偿，刀 具偏置和其它补偿操作.
在坐标系旋转方式中，与返回参考点有关G 代码（G28、G26、G61、G30 等） 和那些与坐标系有关的G 代码（G52、G54/G59）不能指定，如果需要这些G 代码， 必须在取消坐标系旋转方式以后才能指令。坐标系旋转取消指令G69 以后的第一 个移动指令必须用绝对值指定，如果用增量值指令，将不执行正确的移动。 举例：

N10 G01 X-500Y-500F2000 G17； N20 G68 X700Y300R60；
N30 G90 G01 X0 Y0 F2000；
N40 G91 X1000
N50 G02 Y1000 R1000
N60 G03X-1000I-500J-500；
N70 G01Y-1000
N80 G69
N90 G90 X-500Y-500
N100 M02；

（14）回零点指令（G28-G288/G301-G308）

返回参考点指刀具沿着指定轴自动地移动到参考点。
指令格式：G28 X(U)＿ Z(W)＿ Y(V)＿A＿B＿； XZYAB通过中间点 后再回参考点
G281 | ;X 轴回机床零点
G282 | ;Y 轴回机床零点
G283 | ;Z 轴回机床零点
G284 | ;A 轴回机床零点
G285 | ;B 轴回机床零点

- numerical control system -

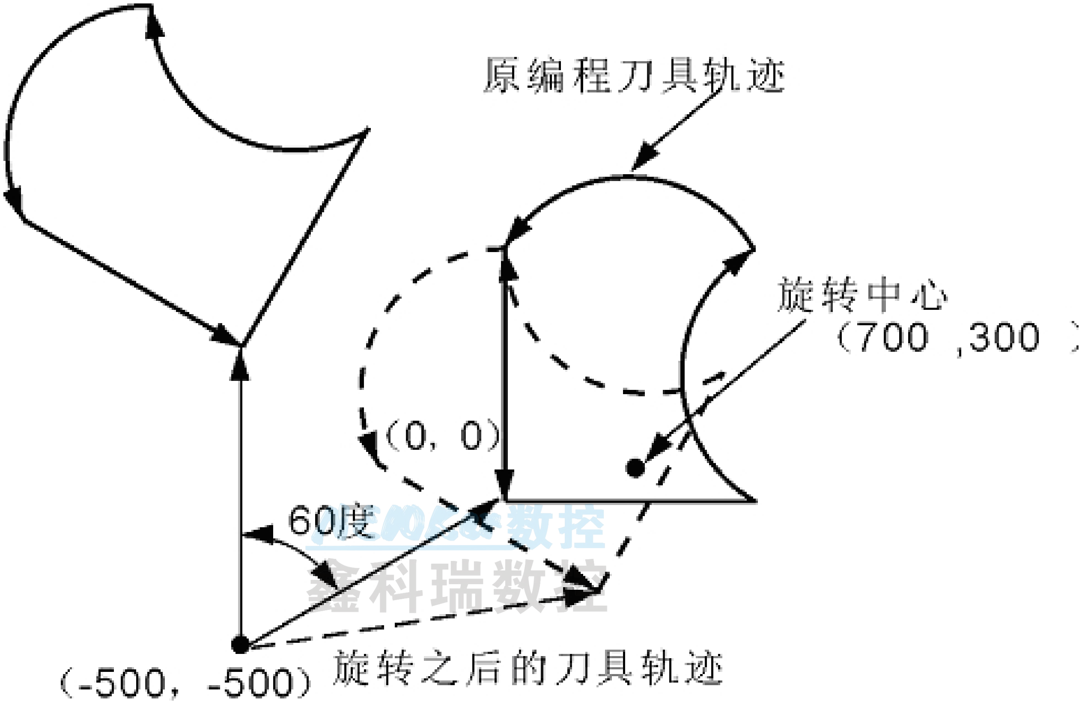
[picture p27: figure]

- 24 -

The plane selection code cannot be specified in the coordinate system rotation mode. The code G69 for canceling the coordinate system rotation must occupy a separate program segment. After the coordinate system rotation, execute tool radius compensation, tool length compensation, tool offset, and other compensation operations.
In coordinate system rotation mode, G codes related to returning to reference points (e.g., G28, G26, G61, G30) and those associated with coordinate systems (G52, G54/G59) cannot be specified. If these G codes are required, they must be programmed after canceling the coordinate system rotation mode. The first movement command after canceling the coordinate system rotation mode with G69 must be specified using absolute values. If incremental value commands are used, the correct movement will not be executed.
give an example ：

N10 G01 X-500Y-500F2000 G17； N20 G68 X700Y300R60；
N30 G90 G01 X0 Y0 F2000；
N40 G91 X1000
N50 G02 Y1000 R1000
N60 G03X-1000I-500J-500；
N70 G01Y-1000
N80 G69
N90 G90 X-500Y-500
N100 M02；
（14） Return to zero instruction (G28-G288/G301-G308)
Return to reference point means that the tool automatically moves along the specified axis to the reference point.
Instruction format: G28 X (U) _ Z (W) _ Y (V) _ A_B_; XZYAB returns to the reference point after passing through the midpoint
G281 ; Return the X-axis to the machine zero point
G282 | ; Y-axis back to machine zero point
G283 | ; Z axis back to machine zero point
G284 | ; A axis back to machine zero point
G285 | ; B axis back to machine zero point

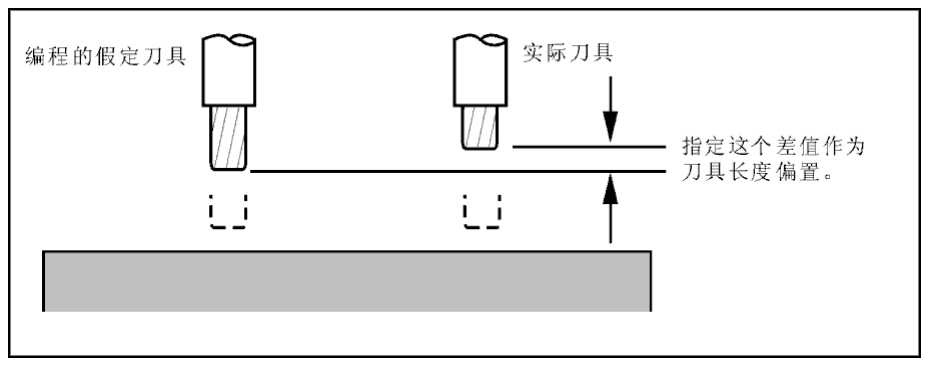
[picture p28: figure]

- 25 -
G286 | ;C 轴回机床零点
G287 | ;Xs 轴回机床零点
G288 | ;Ys 轴回机床零点
G301 | ;X 轴坐标回零
G302 | ;Y 轴坐标回零
G303 | ;Z 轴坐标回零
G304 | ;A 轴坐标回零
G305 | ;B 轴坐标回零
G306 | ;C 轴坐标回零
G307 | ;Xs 轴坐标回零
G308 | ;Ys 轴坐标回零
注意：执行该指令之前应该清除刀具半径补偿和刀具长度补偿。

（15） 刀具长度补偿指令（G43/G44/G49）

设定编程时的刀具长度和实际使用的刀具长度之差值，用该功能补偿这个差 值而不用修改程序。用G43 或G44 指定偏置方向，由输入的相应地址号H 代码从偏 置表中选择刀具长度偏置值。
处于G17(XY)平面时，长度补偿H加在了Z轴上，所以刀具最好应装在Z轴上。 处于G18(ZX)平面时，长度补偿H加在了Y轴上，所以刀具最好应装在Y轴上。 处于G19(YZ)平面时，长度补偿H加在了X轴上，所以刀具最好应装在X轴上。 指令格式：
G43 H－ ；加一个刀具长度补偿参数值。
G44 H－ ；减一个刀具长度补偿参数值。
G49 或 H0 ；取消刀具长度补偿。
说明：刀具长度补偿就是在 Z 轴或其他轴上加或减用 H 功能调用的刀具长度 补偿参数值。调用号为 H1－H99（刀具最大数）。参数中的补偿数据都是以未进 行补偿时的刀具位置作为起点。
图示：
例：N0000 G43 H2 X10 | （H2 值为 5）
N0010 G44 H3 X20 | （H3 值为 10）

- numerical control system -

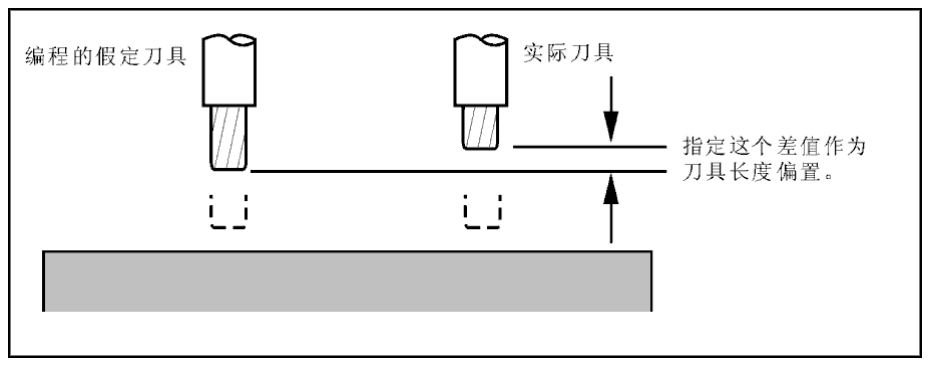
[picture p29: figure]

- 25 -
G286 | ; C axis back to machine zero point
G287 | ; Xs axis back to machine zero point
G288 | ; Ys axis back machine zero point
G301 | ; The X-axis coordinate is reset to zero
G302 | ; Y-axis coordinates back to zero
G303 | ; Z-axis coordinates back to zero
G304 | ; The A-axis coordinate returns to zero
G305 | ; B-axis coordinates back to zero
G306 | ; C-axis coordinates back to zero
G307 | ; The Xs axis coordinate is reset to zero
G308 | ; Ys axis coordinates back to zero
Note: Tool radius compensation and tool length compensation should be cleared before executing this instruction.
（15） Tool length compensation command (G43/G44/G49) The difference between the tool length specified during programming and the actual tool length used is compensated by this function without modifying the program. Use G43 or G44 to specify the offset direction, and select the tool length offset value from the offset table using the corresponding address code H input.
When in the G17 (XY) plane, the length compensation H is applied to the Z axis, so it is best to mount the tool on the Z axis.
When in the G18 (ZX) plane, the length compensation H is applied to the Y axis, so it is best to mount the tool on the Y axis.
When in the G19 (YZ) plane, the length compensation H is applied to the X axis, so it is best to mount the tool on the X axis.
instruction format ：
G43 H-; Add a tool length compensation parameter value.
G44 H-; subtract one tool length compensation parameter value.
G49 or H0; disable tool length compensation. Note: Tool length compensation is the tool length compensation parameter value added or subtracted on the Z-axis or other axes using the H function. The call number is H1-H99 (maximum number of tools). The compensation data in the parameter is based on the tool position at the beginning without compensation.
graphic ：

Example: N0000 G43 H2 X10 (H2
value is | 5)
N0010 G44 H3 X20 (H3 value is
| 10)

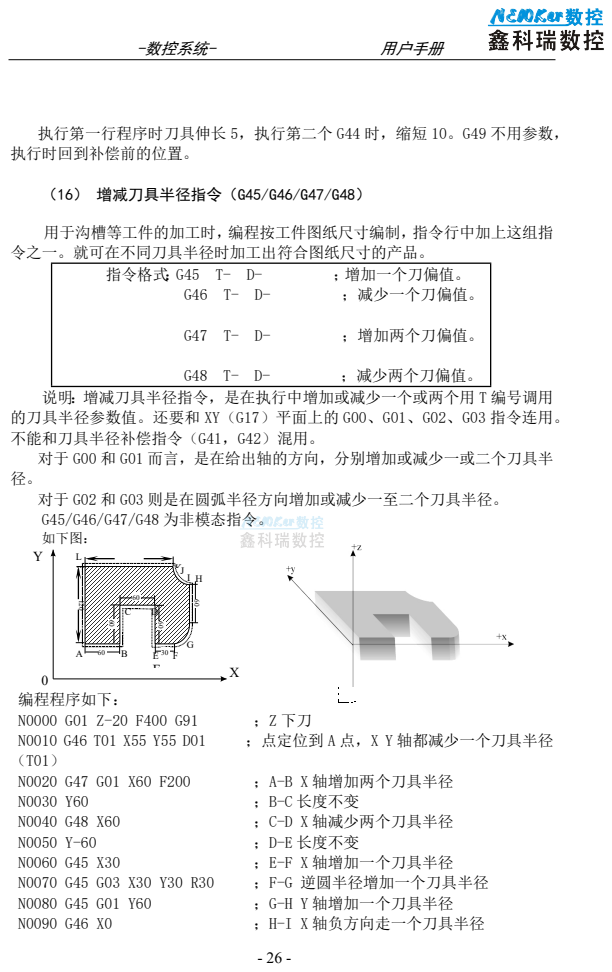
[picture p30: page 51]
（16） 增减刀具半径指令（G45/G46/G47/G48）; 指令格式：G45 T- D-; ；增加一个刀偏值。; ；减少一个刀偏值。; ；增加两个刀偏值。; ；减少两个刀偏值。; 编程程序如下：; ；点定位到 A 点，X Y 轴都减少一个刀具半径; ；A-B X 轴增加两个刀具半径; ；B-C 长度不变; ；C-D X 轴减少两个刀具半径; ；D-E 长度不变; ；E-F X 轴增加一个刀具半径; ；F-G 逆圆半径增加一个刀具半径; ；G-H Y 轴增加一个刀具半径; ；H-I X 轴负方向走一个刀具半径

执行第一行程序时刀具伸长 5，执行第二个 G44 时，缩短 10。G49 不用参数，
执行时回到补偿前的位置。

用于沟槽等工件的加工时，编程按工件图纸尺寸编制，指令行中加上这组指
令之一。就可在不同刀具半径时加工出符合图纸尺寸的产品。

说明：增减刀具半径指令，是在执行中增加或减少一个或两个用 T 编号调用
的刀具半径参数值。还要和 XY（G17）平面上的 G00、G01、G02、G03 指令连用。
不能和刀具半径补偿指令（G41，G42）混用。
对于 G00 和 G01 而言，是在给出轴的方向，分别增加或减少一或二个刀具半
对于 G02 和 G03 则是在圆弧半径方向增加或减少一至二个刀具半径。
G45/G46/G47/G48 为非模态指令。
如下图：

- numerical control system -

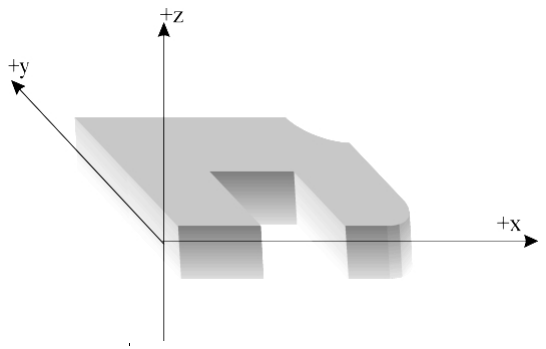
[picture p31: figure]

- 26 -

When the first line of program is executed, the tool lengthens by 5, and when the second G44 is executed, it shortens by 10. G49 has no parameters and returns to the position before compensation when executed.
（16） Add/subtract tool radius commands (G45/G46/G47/G48) When used for the machining of workpieces such as grooves, the program is prepared according to the size of the workpiece drawing. One of these instructions is added to the instruction line, so that the product can be processed with different tool radii to meet the drawing size.
Instruction format: G45 T-D
G46 T- D-

G47 T- D-

G48 T- D-

; Add a tool offset.;
Reduce a tool offset.
; Add two blade offsets.
; Reduce the two knife
offsets.
Note: The tool radius add/subtract command is used to increase or decrease one or two tool radius parameters called by the T code during execution. It should be combined with G00, G01, G02, and G03 commands on the XY (G17) plane. It cannot be mixed with tool radius compensation commands (G41, G42).
For G00 and G01, the direction of the axis is given and one or two tool radii are added or subtracted respectively.
For G02 and G03, one or two tool radii are added or reduced in the direction of the arc radius.
G45/G46/G47/G48 are non-mode instructions.
N0000 G01 Z-20 F400 G91 | ; Z cuts the blade
N0010 G46 T01 X55 Y55 D01（T 01） N0020 G47 G01 X60 F200 | ; The point is positioned at point A, and
| the X and Y axes are reduced by one
| tool radius each; A-B X axis is increased
| by two tool radii
N0030 Y60 | ; B-C, the length remains unchanged
N0040 G48 X60 | ; C-D X axis reduces two tool radii
N0050 Y-60 | ; D-E, length unchanged
N0060 G45 X30 | ; Add a tool radius to the E-F X axis
N0070 G45 G03 X30 Y30 R30 | ; F-G The inverse circle radius is increa- sed by a tool radius
N0080 G45 G01 Y60 | ; Add a tool radius to the G-Y axis
N0090 G46 X0 | ; H-I moves one tool radius in the negative direction of the X-axis

as illustrated in follo- wing figure ：

The program is as follo- ws:

0

A | B

C D

E

F
F

H

G

L
150 | K
I

J

Y

X

0 12

60

60

60

60

60 | 30

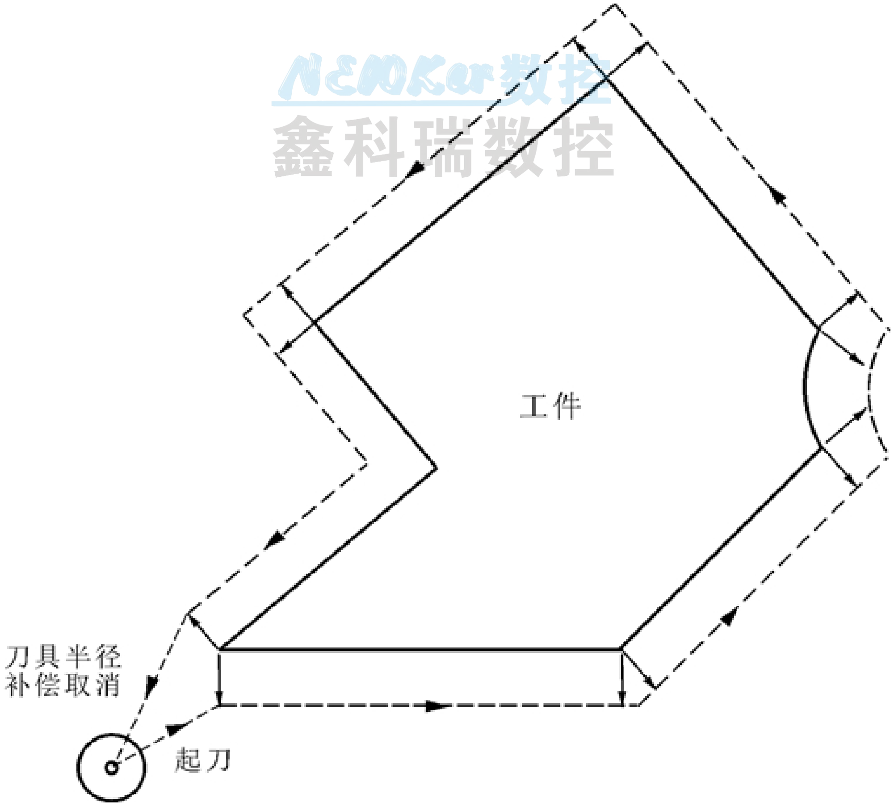
[picture p32: figure]

- 27 -
N0100 G46 G02 X-30 Y30 R30 | ；I-J 顺圆半径减少一个刀具半径
N0110 G45 G01 Y0 | ；J-K Y 轴正方向走一个刀具半径
N0120 G47 X-150 | ；K-L X 轴增加两个刀具半径
N0130 G47 Y-120 | ；L-M Y 轴增加两个刀具半径
N0140 G46 X-55 Y-55 | ；M-N X Y 轴都减少一个刀具半径
N0150 G26 | ；程序回起点结束
N0151 M02
上例指令的加（+）减（-）和刀具半径值的符号是同号相加，异号相减的关 系，坐标轴数值可以是零。这时它的意义是用来指定坐标轴，运行的长度为一个 或两个半径。方向由指令的加减和半径值的符号共同决定。

（17） 刀具半径补偿指令（G40/G41/G42）

当刀具移动时，刀具轨迹可以偏移一个刀具半径。为了偏移一个刀具半径， CNC 首先建立长度等于刀具半径的偏置矢量，即起刀点。偏置矢量垂直于刀具轨 迹。矢量的尾部在工件上而头部指向刀具中心。如果在起刀之后指定直线插补或 圆弧插补，在加工期间刀具轨迹可以用偏置矢量的长度偏移。在加工结束时，为 使刀具返回到开始位置，须取消刀具半径补偿方式。
图示：
指令格式：G40 | （模态，初态） | ；刀具半径补偿取消。
G41 T- D- （模态） ；刀具在工件左侧偏置的刀 具
半径补偿。
G42 T- D- | （模态） | ；刀具在工件右侧偏置的
刀具
半径补偿。
说明：G41/G42 中的左侧或右侧是指沿切削方向看，刀具在工件的左侧或右 侧。刀具半径值用 T1-T99 调用。执行偏置是在 G41/G42 所在程序行开始。尖角 处由系统自动产生过渡直线，使上一程序段终点的刀具半径偏移矢量过渡到下一

- numerical control system -

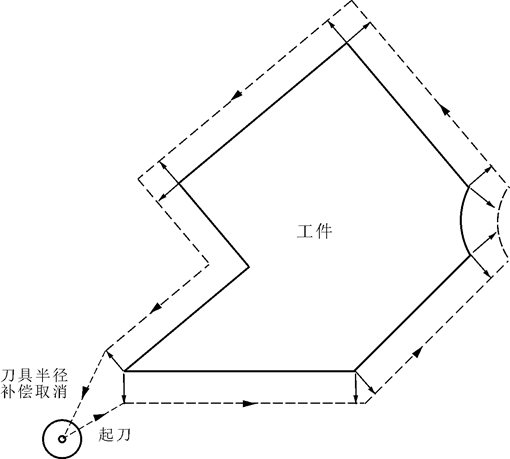
[picture p33: figure]

- 27 -

R30

N
0100
N
0110

G46 G02 X-30 Y30
G45 G01 Y0

; I-J reduces the radius of the circle by one tool radius; J-K moves in the positive direction of the Y-axis by one tool radius
N
0120

G47 X-150

; Two tool radii are added to the K-L X axis
N
0130

G47 Y-120

; Add two tool radii to the L-M Y axis
N
0140

G46 X-55 Y-55

; M-N X Y axes are reduced by one tool radius

N
0150

G26

; The program returns to the starting point
N0151 M02
The + and-signs in the preceding instructions follow the rule of adding when same-sign values and subtracting when opposite-sign values, with coordinate axis values being zero. This mechanism specifies coordinate axes that operate over lengths equal to one or two radii. The direction is determined jointly by the instruction's sign and the radius value.
（17） Tool radius compensation command (G40/G41/G42) When a tool moves, its path may deviate by one tool radius. To achieve this, the CNC system first creates a bias vector equal in length to the tool radius, known as the tool start point. This bias vector is perpendicular to the tool's trajectory, with its tail resting on the workpiece and head pointing toward the tool center. If linear or arc interpolation is specified after tool start, the tool path will be adjusted by the vector's length during machining. To return the tool to its starting position at the end of processing, the tool radius compensation method must be disabled.
graphic ：

Instruction format: G40 (mode, initial state); Tool radius compensation is cancelled.
G41 T-D (mode); a tool positioned to the left of the workpiece
radius
compensation 。
G42 T-D (mode); the tool is offset to the right of the workpiece
cutter
radius compensation 。
Note: The left or right side in G41/G42 refers to the tool's position on the workpiece's left or right side when viewed along the cutting direction. Tool radius values are set using the T1-T99 parameter. Tool offsets are executed at the beginning of the G41/G42 program line. The system automatically generates transition straight lines at sharp corners to smoothly transition the tool radius offset vector from the end of one program segment to the next

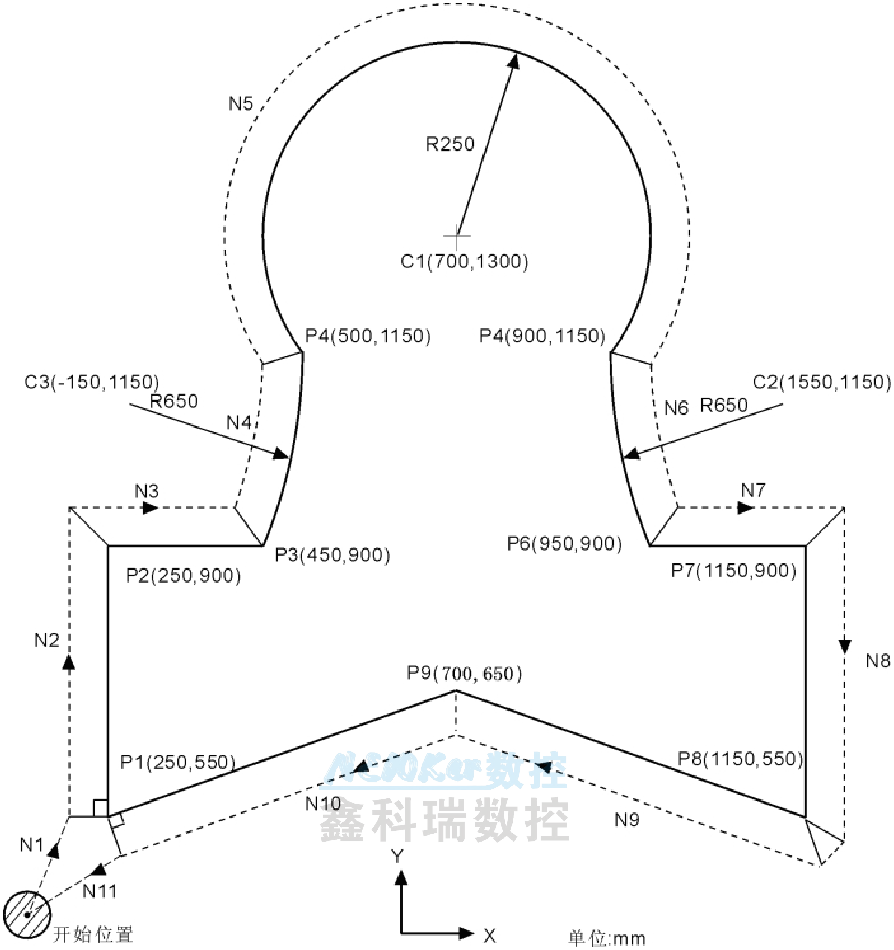
[picture p34: figure]

- 28 -

程序段的起点的刀具半径偏移矢量、刀偏矢量是描述刀具偏移的数值和方向的方 法。它的矢径为刀具半径。对于圆弧来说它的方向在半径方向。对于直线来说它 的方向在直线的垂直方向。
刀具半径 C 补偿的建立和撤消方式分为 A 型与 B 型，可在刀具参数 P1、P2 中设置。具体方式见后图示。
注意：刀具半径补偿的建立和撤消必须在直线段进行。
例如：
G54 X0 Y0 Z0 | ；开始位置X0 Y0 Z0
G90 G17 G00 G41 T02 D3 X250.0 Y550.0 | ； 开始刀具半径补偿起刀， 刀
| 具用T02号刀的刀沿号D3 指定的
| 距离偏移到编程轨迹的右边。
G01 Y900.0 F300 | ；从P1 到P2 加工
X450.0 | ；从P2 到P3 加工
G03 X500.0 Y1150.0 R650.0 | ；从P3 到P4 加工
G02 X900.0 R-250.0 | ；从P4 到P5 加工
G03 X950.0 Y900.0 R650.0 | ；从P5 到P6 加工
G01 X1150.0 | ；从P6 到P7 加工
Y550.0 | ；从P7 到P8 加工
X700.0 Y650.0 | ；从P8 到P9 加工
X250.0 Y550.0 | ；从P9 到P1 加工
G00 G40 X0 Y0 | ；取消偏置方式刀具返回到
| 开始位置X0，Y0，Z0

- numerical control system -

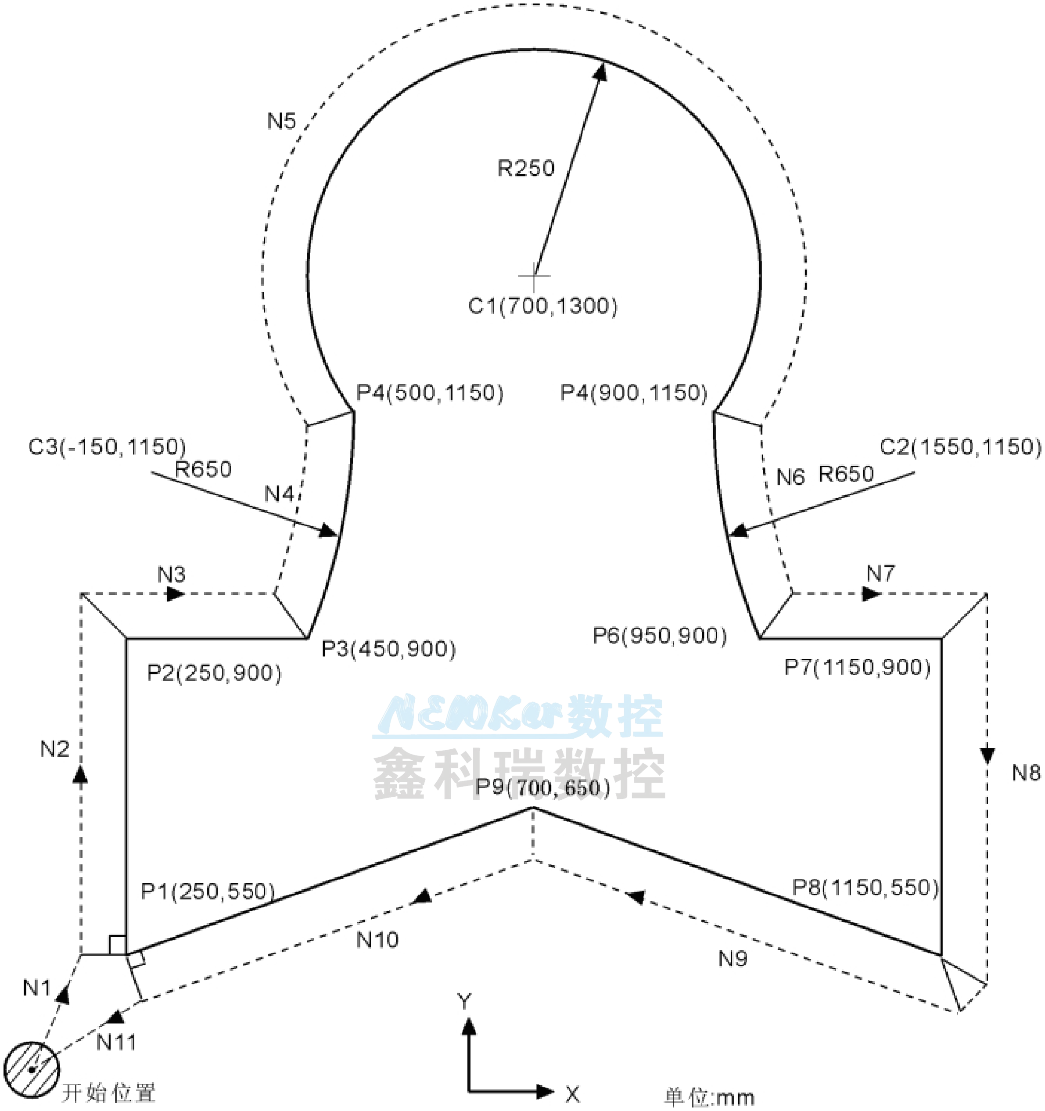
[picture p35: figure]

- 28 -

The tool radius offset vector at the starting point of a program segment, known as the tool offset vector, is a method that describes both the magnitude and direction of tool movement. Its vector direction corresponds to the tool radius. For arcs, this direction aligns with the radius, while for straight lines, it points perpendicular to the line itself. The establishment and cancellation of tool radius C compensation are divided into type A and Type B, which can be set in tool parameters P1 and P2. See the diagram below for details.
Note: The establishment and cancellation of tool radius compensation must be performed on straight segments.
for instance ：
G54 X0 Y0 Z0 | ; Start position X0 Y0 Z0
G90 G17 G00 G41 T02 D3 X250.0 Y550.0; Start tool radius compensation for cutting, tool
The edge number D3 of the
tool T02 is offset to the right of the programmed path by
a specified distance.
G01 Y900.0 F300 | ; Process from P1 to P2
X450.0 | ; From P2 to P3 processing
G03 X500.0 Y1150.0 R650.0 | ; From P3 to P4 processing
G02 X900.0 R-250.0 | ; From P4 to P5 processing
G03 X950.0 Y900.0 R650.0 | ; From P5 to P6 processing
G01 X1150.0 | ; From P6 to P7 processing
Y550.0 | ; From P7 to P8 processing
X700.0 Y650.0 | ; From P8 to P9 processing
X250.0 Y550.0 | ; From P9 to P1 processing
G00 G40 X0 Y0 | ; Cancel the biasing mode and return the tool
Start position X0, Y0, Z0

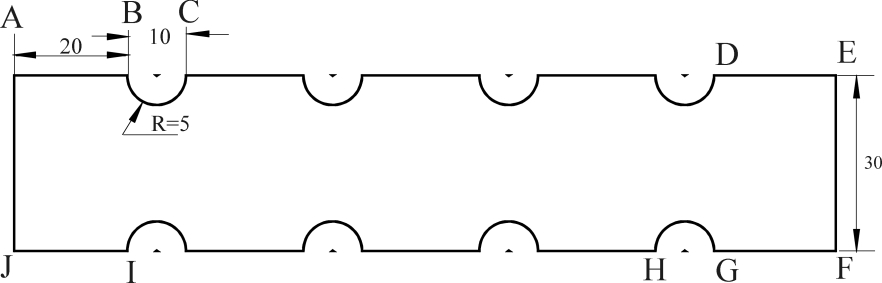
[picture p36: figure]

- 29 -

（18） 程序循环指令（G22--G800）

G22 为程序循环指令，G800 是循环结束指令。二者必须配对使用，用于零件 加工中需要反复加工的场合。L 为循环次数，取值范围为 1-99999。循环指令可 以嵌套。
指令格式：G22 L- | ；循环体开始
：
： | ；循环体
：
G800 | ；循环体结束
举例：

程序如下：
N0000 G17 G90 X0 Y0 F250 M03 ；设置程序运行的开始状态 N0001 G91 G01 Z-10
N0010 G22 L4 | ；循环体开始，指定循环体循环四次
N0020 G01 X20 | ；循环体内容：A-B 直线
N0030 G03 X10 I5 J0 Y0 | ；B-C 逆半圆
N0040 G800 | ；循环结束
N0050 G01 X20 | ；D-E 直线
N0060 Y-30 | ；E-F 直线
N0080 G22 L4 | ；循环体开始，指定循环体循环四次
N0090 G01 X-20 | ；F-G 直线
N0100 G03 X-10 I-5 | ；G-H 逆圆弧
N0110 G800 | ；循环结束
N0120 G01 X-20 | ；I-J 直线
N0130 G01 Y30 | ；J-A 直线
N0140 G26 | ；回程序起点
N0150 M02 | ；程序结束

（19）准确定位/连续路径加工（G60/G64）

根据加工工艺的要求，可以通过 G60/G64 指令指定程序段之间的连接方式。

- numerical control system -

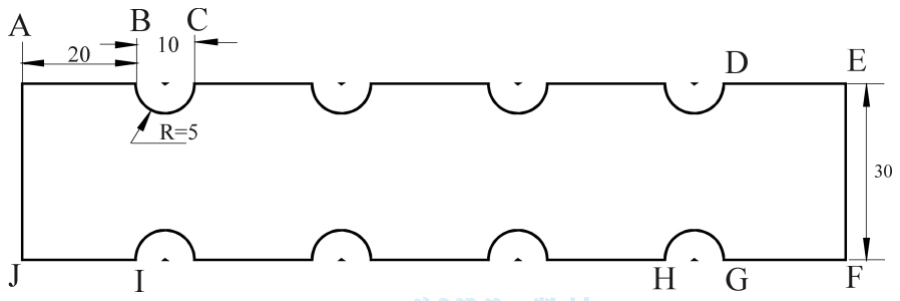
[picture p37: figure]

- 29 -

（18） Program loop instructions (G22--G800)
G22 is a program loop instruction, and G800 is a loop end instruction. These two instructions must be used in pairs for repeated processing in part machining. L is the number of loops, with a range of 1 to 99,999. Loop instructions can be nested.

give an example ：

The procedure is as follows:
N0000 G17 G90 X0 Y0 F250 M03; Set the starting state of the program

N0001 G91 G01 Z-10
N0010 G22 L4 ; The loop body starts, and the loop body is specified to loop four times
N0020 G01 X20 | ; Loop body content: A-B line
N0030 G03 X10 I5 J0 Y0 | ; B-C, inverse semicircle
N0040 G800 | ； loop end
N0050 G01 X20 | ；D-E straight line
N0060 Y-30 | ；E-F straight line
N0080 G22 L4 | ; The loop body starts, and the loop body is specified to
loop four times
N0090 G01 X-20 | ；F-G straight line
N0100 G03 X-10 I-5 | ; G-H, inverse arc
N0110 G800 | ； loop end
N0120 G01 X-20 | ；I-J straight line
N0130 G01 Y30 | ；J-A straight line

N0140 G26
; Return to the program starting point
N0150 M02 | ； end of program
（19） Precise positioning/continuous path machining (G60/G64) Depending on the requirements of the machining process, the G60/G64 instruction can be used to specify the connection between program segments.

Instruction format: G22 L-
：
：
：
G800

; The loop body begins; the loop body; the loop body
ends

- 30 -
指令格式：G60 | ； 准确定位（模态）
G64 | ； 连续路径加工（模态，初态）

（20）固定循环宏定义指令（G73、G80～G89）

用固定循环指令可以使频繁使用的加工程序变为更简便。
固定循环表(指令+500表示X方向进刀，+700表示Y方向进刀)：
G代码 | 进给方式 | 在孔底的动作 | 退回 | 功能
G73/G573/G773 | 间歇进给 | 无 | 快速移动 | 高速深孔钻循环
G80/G580/G780 | 切削进给 | 无 | 无 | 取消固定循环
G81/G581/G781 | 切削进给 | 无 | 快速移动 | 钻孔,点钻循环
G82/G582/G782 | 切削进给 | 停刀 | 快速移动 | 钻孔,锪镗循环
G83/G583/G783 | 间歇进给 | 无 | 快速移动 | 深孔钻循环
G85/G585/G785 | 切削进给 | 无 | 切削进给 | 镗孔循环
G86/G586/G786 | 切削进给 | 主轴停 | 快速移动 | 镗孔循环
G87/G587/G787 | 切削进给 | 主轴停,定向 | 快速移动 | 镗孔循环
G76/G576/G776 | 切削进给 | 主轴停,定向 | 快速移动 | 镗孔循环
G89/G589/G789 | 切削进给 | 停刀 | 切削进给 | 镗孔循环
G74/G574/G774 | 切削进给 | 停刀-主轴正转 | 切削进给 | 左旋攻丝循环
G84/G584/G784 | 切削进给 | 停刀-主轴反转 | 切削进给 | 右旋攻丝循环
固定循环由6个顺序的动作组成
动作1 X轴和Y轴的定位
动作2 快速移动到R点
动作3 孔加工
动作4 在孔底的动作
动作5 返回到R点
动作 6 快速移动到初始点
图示：

- numerical control system -
- 30 -

Instruction
format: G60

; Precise positioning (modality)

G64

; Continuous path machining (mode, initial state)
（20） Fixed Cycle Macro Definition Instructions (G73, G80~G89)
The use of fixed cycle instructions can make the frequently used machining program more convenient.
Fixed cycle table (instruction +500 indicates X direction feed, +700 indicates Y direction feed):
G code | Feed method | Action at the bottom of a hole | return | function
G73/G573/G773 | index feed | not have | quick travel | High speed deep hole drill-ing cycle
G80/G580/G780 | Cutting feed | not have | not have | Remove the fi-xed cycle
G81/G581/G781 | Cutting feed | not have | quick travel | Borehole, point drill cycle
G82/G582/G782 | Cutting feed | Stop the killing | quick travel | Bore, tap and bore cycle
G83/G583/G783 | index feed | not have | quick travel | Deep hole drill cycles
G85/G585/G785 | Cutting feed | not have | Cutting feed | Borehole circu-lation
G86/G586/G786 | Cutting feed | The spindle is stopped | quick travel | Borehole circu-lation
G87/G587/G787 | Cutting feed | Stop the spin-dle and orient | quick travel | Borehole circu-lation
G76/G576/G776 | Cutting feed | Stop the spin-dle and orient | quick travel | Borehole circu-lation
G89/G589/G789 | Cutting feed | Stop the killing | Cutting feed | Borehole circu-lation
G74/G574/G774 | Cutting feed | Knife stop-spindle forw-ard rotation | Cutting feed | Left turn screw cycle
G84/G584/G784 | Cutting feed | Knife stop-spindle reverse | Cutting feed | Right turn scr-ewing cycle

The fixed cycle consists of
six sequential actions
Action 1 Positioning
action of X and Y
axes 2 Quick move
to point R 3 Hole
machining
Action 4 Action at
the bottom of the
hole Action 5 Return to point R
Action 6 Move quickly
to the starting point diagram:

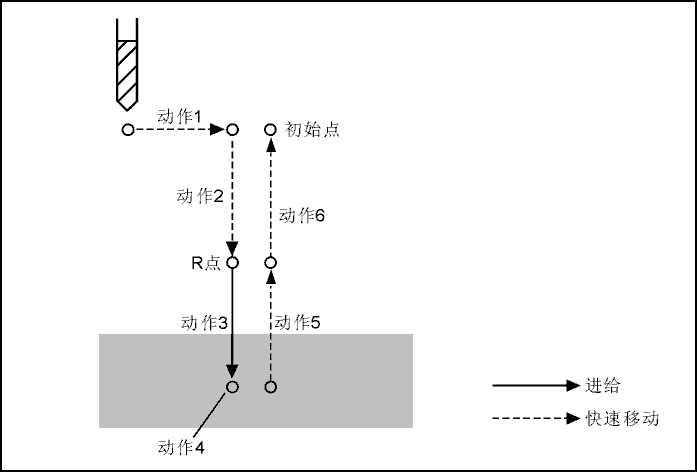
[picture p38: figure]
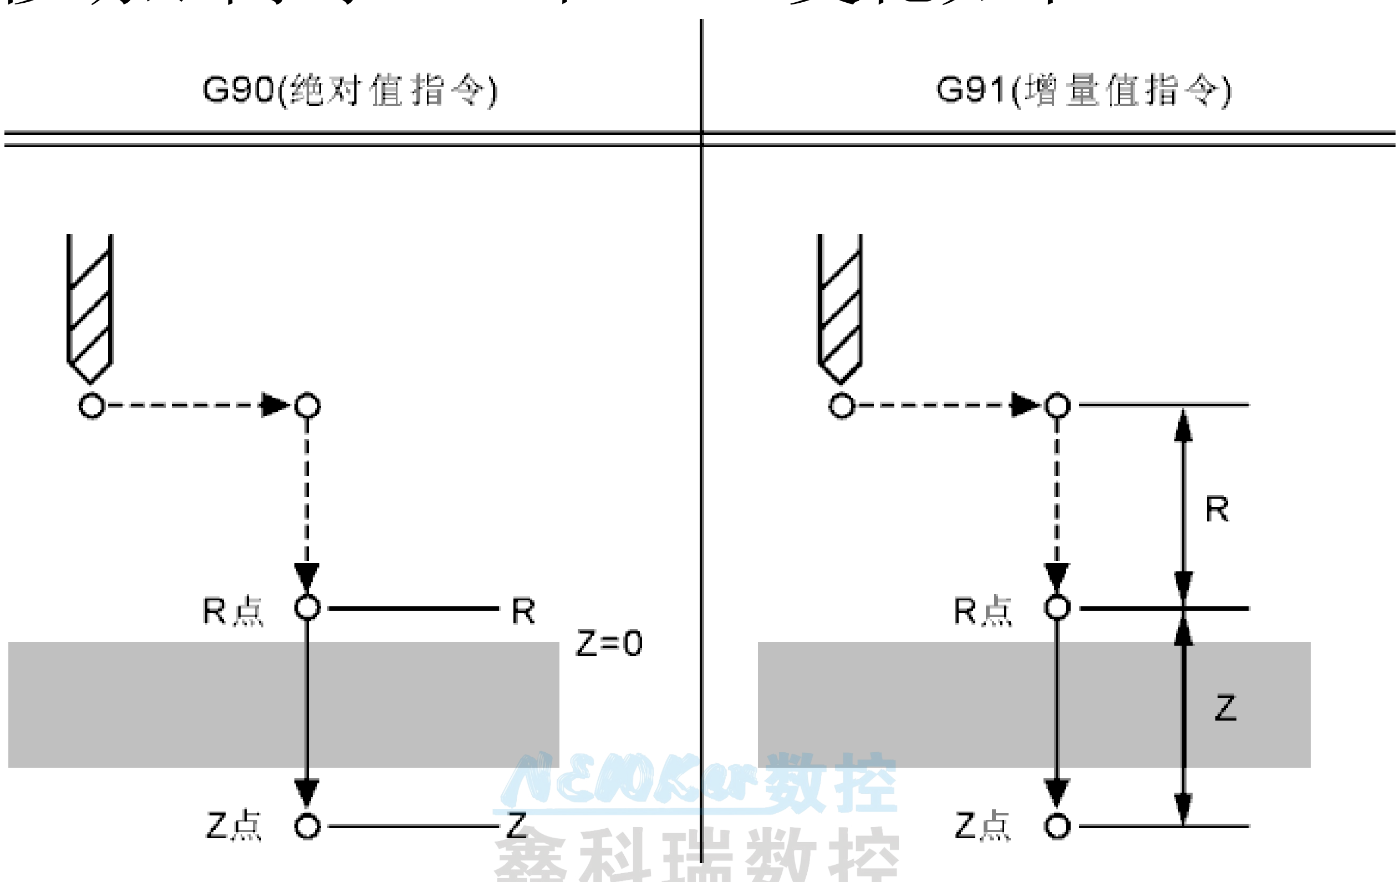
[picture p39: figure]
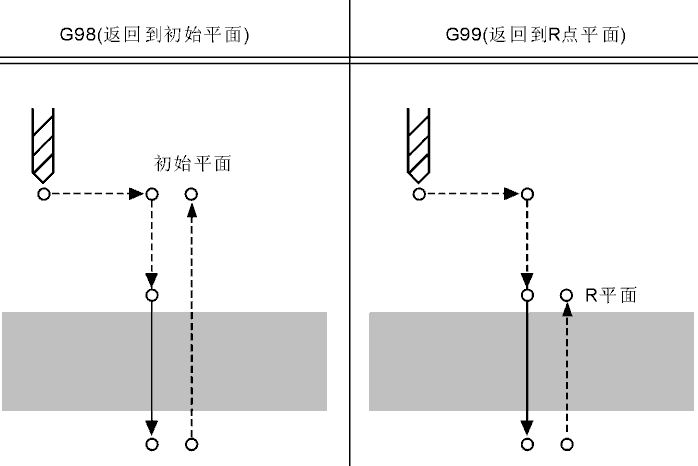
[picture p40: figure]

- 31 -

沿着钻孔轴的移动距离对 G90 和 G91 变化如下：

当刀具到达孔底后，刀具可以返回到R 点平面或初始位置平面，由G98 和G99 指定，下图表示指定G98 或G99 时的刀具移动.一般情况下，G99 用于第一次钻孔 而G98 用于最后钻孔.即使在G99 方式中执行钻孔初始位置平面也不变。

在L中指定重复次数， 在相同位置重复钻孔。L仅在被指定的程序段内有效。 重复次数L最大指令值=9999。默认为L=1；
定位平面由G17（XY）/G18（ZX）/G19（YZ）决定，另外速度参数P53圆弧间 隙补偿再+2，设置为2或者10。

- numerical control system -

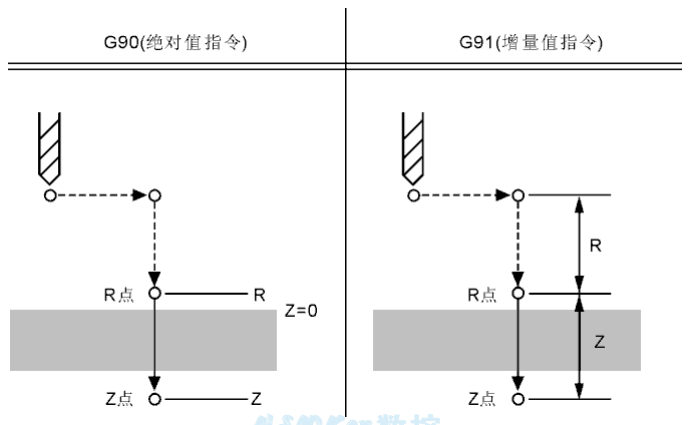
[picture p41: figure]

- 31 -

The Changes of G90 and G91 Along the Moving Distance of the Drill Axis Are as Follows:

When the tool reaches the bottom of the hole, it can return to either the R-point plane or the initial position plane, as specified by G98 and G 99 commands. The diagram below illustrates tool movement when G98 or G99 is activated. Typically, G99 is used for the initial drilling phase while G98 is employed for the final drilling. Notably, even when performing drilling in G99 mode, the initial position plane remains unchanged.

Specify the number of repetitions in L, and repeat drilling at the same location. L is only valid within the specified program segment. The maximum number of repetitions in L is 9999. The default value is L=1; The positioning plane is determined by G17 (XY)/G18 (ZX)/G19 (YZ). In addition, the speed parameter P53 arc gap compensation is set to +2, and the setting is 2 or 10.

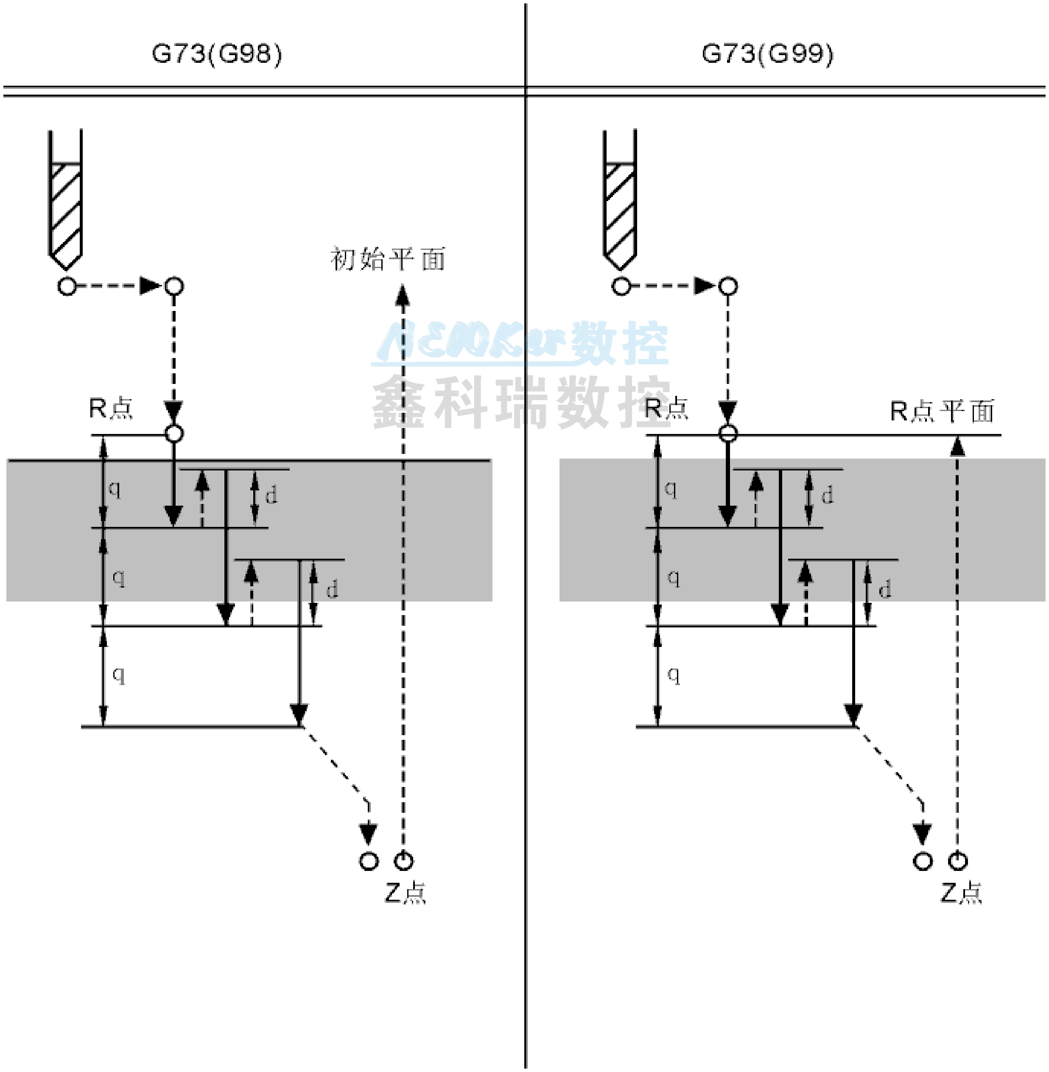
[picture p42: figure]

- 32 -

（21）高速深孔钻循环（G73）

该循环执行高速深孔钻，它执行间歇切削进给直到孔的底部， 同时从孔中 排除切屑。
指令格式：G73 X-Y-Z-R-Q-P-F-L- ；
X-Y-：孔位数据
Z-：从 R 点到孔底的距离（G91）或坐标值（G90） R-：从初始点到 R 点的距离（G91）或坐标值
（G90）
Q-：每次切削深度
P-：孔底的暂停时间，单位：s
F-：切削速度
L-：重复次数
图示：

说明：高速深孔钻循环沿着Z 轴执行间歇进给，当使用这个循环时，切屑可 以容易从孔中排出，并且能够设定较小的回退值。这允许有效地执行钻孔。在加 工参数P1中设定刀具快速移动退回的退刀量d。
在指定 G73 之前用辅助功能旋转主轴（M 代码）。 当在固定循环中指定刀具长度偏置（G43、G44 或G49）时，在定位到R 点的同时加偏置，刀具半径偏置被忽略。
示例：
M3 S2000 | ；主轴开始旋转
G90 G99 G73 X300 Y-250 Z-150 R-100 Q15 F120；钻第1个孔，返到R点

- numerical control system -

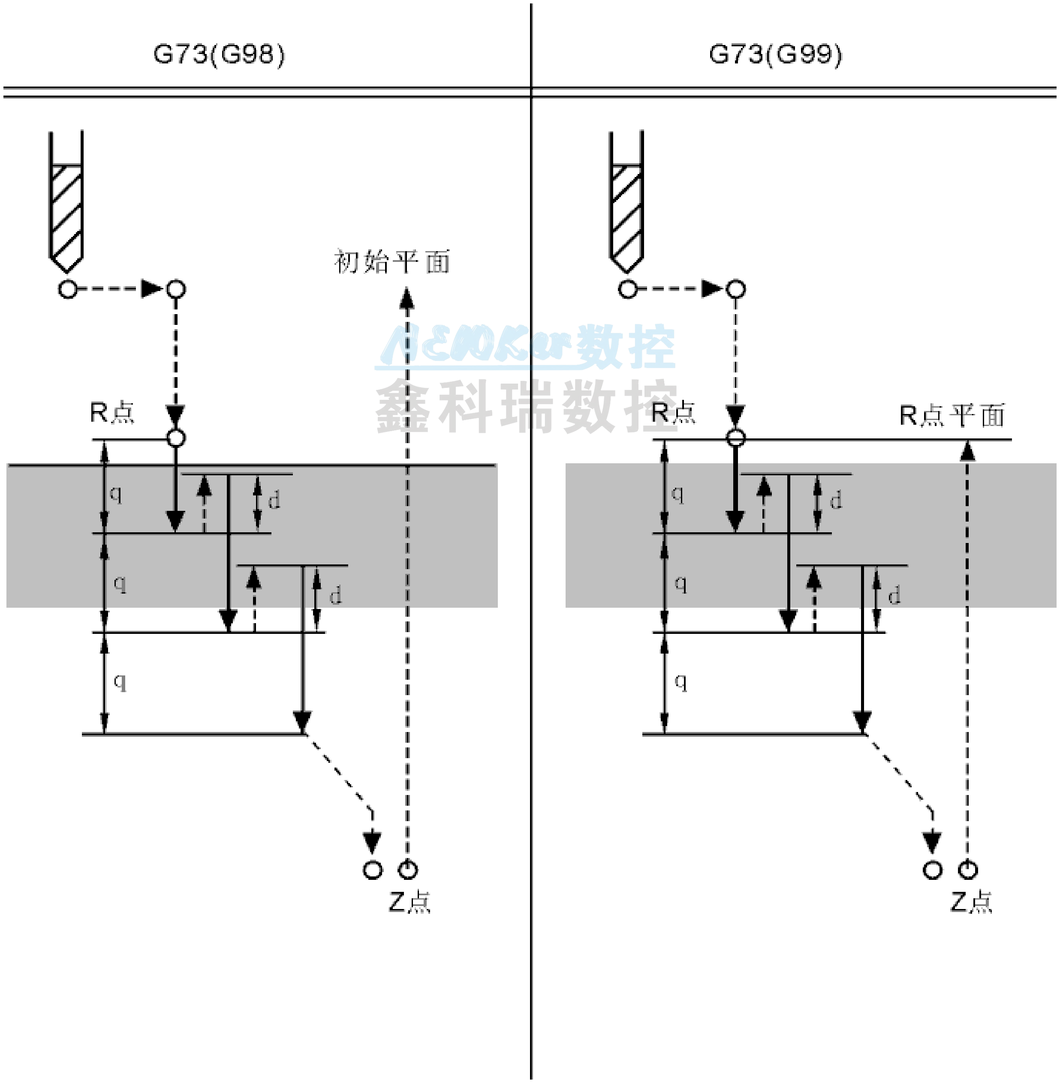
[picture p43: figure]

- 32 -

（21） High Speed Deep Hole Drilling Cycle (G73)
The cycle performs a high speed deep hole drill, which performs intermittent cutting feed until the bottom of the hole is reached while removing chips from the hole.
Instruction format: G73 X-Y-Z-R-Q-P-F-L-;
X-Y-: Hole position data
Z-: Distance from point R to bottom of hole (G91) or coordinate value (G90)
R-: Distance from the starting point to point R (G91) or coordinate value (G90) Q-: Depth of cut per pass
P-: Pause time at the bottom of the hole, unit: s
F-： cutting speed
L-： number of replication
graphic ：

Note: The high-speed deep hole drilling cycle is performed with intermittent Z-axis feed. When using this cycle, chips can be easily discharged from the hole and a smaller retraction value can be set. This allows effective drilling. The tool rapid move retraction distance (d) is set in processing parameter P1.
Rotate the spindle using an auxiliary function (M code) before designating G73.
When a tool length offset (G43, G44, or G49) is specified in a fixed cycle, the offset is added while positioning to point R, and the tool radius offset is ignored.
instance ：
M3 S2000 | ; The spindle starts to rotate
G90 G99 G73 X300 Y-250 Z-150 R-100 Q15 F120; drill the first hole and return to point R

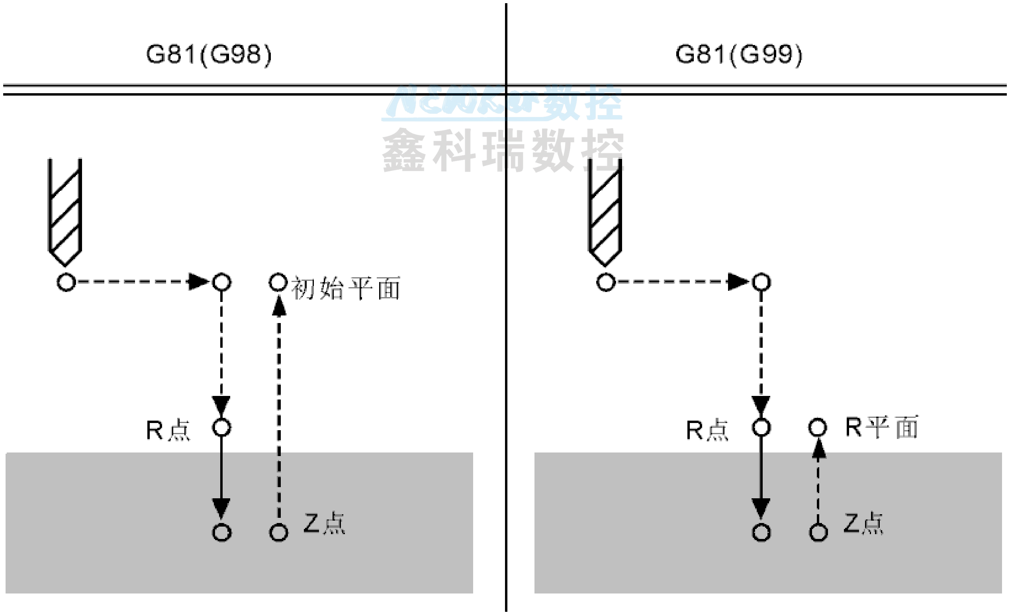
[picture p44: figure]

- 33 -
Y-550 | ；钻第2个孔， 然后返回到R点
Y-750 | ；钻第3个孔， 然后返回到R点
G98 Y-600 | ；钻第4个孔， 然后返回初始位置平面
G80
M30 | ； 结束

（22） 钻孔循环，点钻循环（G81）

该循环用作正常钻孔，切削进给执行到孔底。然后，刀具从孔底快速移动退回。 指令格式：G81 X-Y-Z-R-P-F-L- ；
| X-Y-：孔位数据
| Z-：从 R 点到孔底的距离（G91）或坐标值（G90）
| R-：从初始点到 R 点的距离（G91）或坐标值
（G90）
| P-：孔底的暂停时间，单位：s
| F-：切削速度
| L-：重复次数
图示：

说明：在沿着 X 和 Y 轴定位以后快速移动到 R 点，从 R 点到 Z 点执行钻孔 加工，然后刀具快速移动退回.
在指定G81之前用辅助功能M 代码旋转主轴
当在固定循环中指定刀具长度偏置（G43、G44或G49）时在定位到R点的同时 加偏置，刀具半径偏置被忽略。
示例：
M3 S2000 | ；主轴开始旋转
G90 G99 G81 X300 Y-250 Z-150 R-100 F120
| ；钻第1个孔， 然后返回到R点
Y-550 | ；钻第2个孔， 然后返回到R点

- numerical control system -

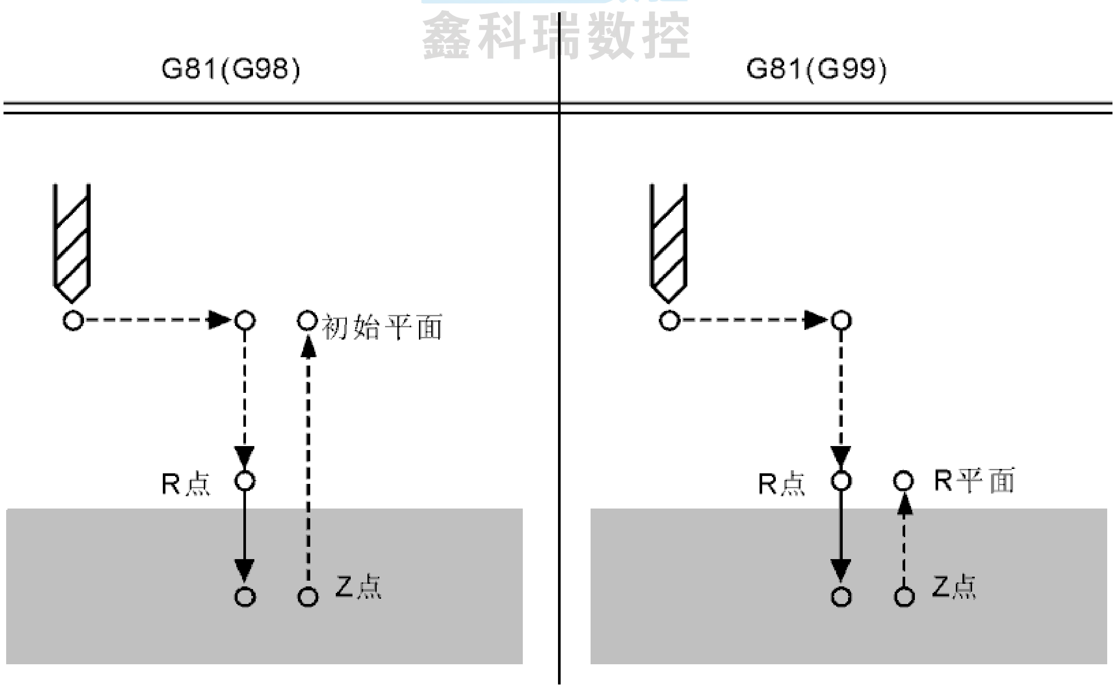
[picture p45: figure]

- 33 -
Y-550 | ; Drill the second hole and return to point R
Y-750 | ; Drill the third hole and return to point R
G98 Y-600 | ; Drill the fourth hole and return to the initial position plane
G80
M30 | ； finish
（22） | Borehole cycle, point-to-borehole cycle (G81)
The cycle is used for normal drilling, and the cutting feed is executed to the bottom of the hole. The tool is then quickly moved back from the bottom of the hole.
Instruction format: G81 X-Y-Z-R-P-F-L-;
| X-Y-: Hole position data
| Z-: Distance from point R to hole bottom (G
91) or coordinate value (G90)
| R-: Distance from the starting point to
point R (G91) or coordinate value (G90)
| P-: Pause time at the bottom of the hole,
unit: s
| F-： cutting speed
| L-： number of replication
graphic ：

Description: After positioning along the X and Y axes, quickly move to point R, drill from point R to point Z, and then quickly move the tool back.
Rotate the spindle using the auxiliary function M code before specifying G81
When a tool length offset (G43, G44 or G49) is specified in a fixed cycle, the offset is added while positioning to point R, and the tool radius offset is ignored.
instance ：
M3 S2000 | ; The spindle starts to rotate
G90 G99 G81 X300 Y-250 Z-150 R-100 F120
| ; Drill the first hole and return to point R
Y-550 | ; Drill the second hole and return to point R

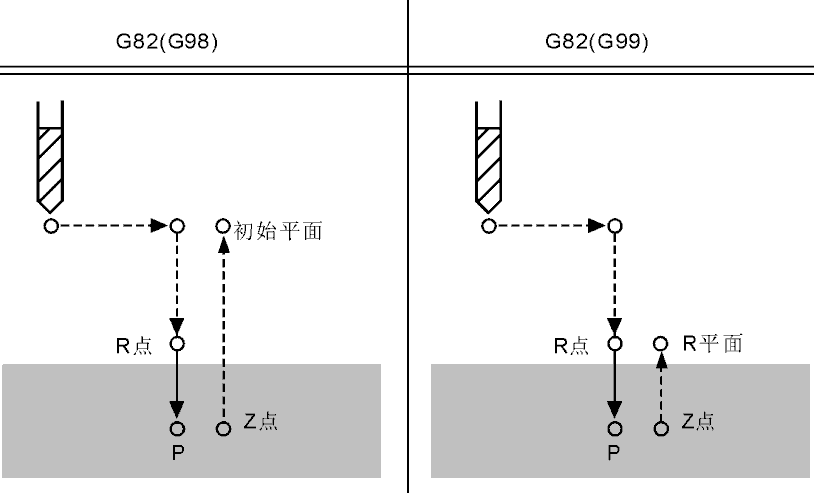
[picture p46: figure]

- 34 -

G98 Y-750 ；钻第3个孔， 然后返回初始位置平面 G80
M30 | ； 结束
为了编程方便，固定循环可以简化编程。
如：G90 G00X0Y0Z0M3;
| G81 X10Y10F2;
| G91X50L5;(循环5次，X方向5个孔，间隔50）;
| Y60L5;(Y方向5个孔，循环5次）
| X10Y20L7;(斜线方向7个孔，循环7次）
G90

（23） 钻孔循环，锪镗循环（G82）

该循环用作正常钻孔，切削进给执行到孔底，执行暂停。然后刀具从孔底快 速移动退回。
指令格式：G82 X-Y-Z-R-P-F-L- ；
| X-Y-：孔位数据
| Z-：从 R 点到孔底的距离（G91）或坐标值（G90）
| R-：从初始点到 R 点的距离（G91）或坐标值
（G90）
| P-：孔底的暂停时间，单位：s
| F-：切削速度
| L-：重复次数
图示：

说明：沿着X和Y轴定位以后，快速移动到R点。然后从R点到Z点执行钻孔加 工。当到底孔底时，执行暂停。然后刀具快速移动退回。
指定G82之前，用辅助功能M代码旋转主轴。
当在固定循环中指定刀具长度偏置（G43、G44或G49）时在定位到R点的同时

- numerical control system -
- 34 -

G98 Y-750; drill the third hole and return to the initial position plane
G80
M30 | ； finish
In order to facilitate programming, fixed loops can simplify programming.
| For example: G90 G00X0Y0Z0M3;
| G81 X10Y10F2;
| G91X50L5; (cycled 5 times, 5 holes in the X direction, 50
| intervals);
| Y60L5; (5 holes in the Y direction, 5 cycles)
| X10Y20L7; (7 holes in the diagonal direction, 7 cycles)
G90
（23） Drill Cycle, Counterboring Cycle (G82)
The cycle is used for normal drilling, the cutting feed is executed to the bottom of the hole, and a pause is performed. The tool is then rapidly moved back from the bottom of the hole.
| Instruction format: G82 X-Y-Z-R-P-F-L-;
| X-Y-: Hole position data
| Z-: Distance from point R to bottom of hole
(G91) or coordinate value (G90)
| R-: Distance from the starting point to
point R (G91) or coordinate value (G90)
| P-: Pause time at the bottom of the hole,
unit: s
| F-： cutting speed
| L-： number of replication
graphic ：

Note: After positioning along the X and Y axes, quickly move to point R. Then drill from point R to point Z. When at the bottom of the hole, pause. Then the tool moves back quickly.
Rotate the spindle using auxiliary function M code before specifying G82.
When the tool length offset (G43, G44 or G49) is specified in a fixed cycle, it is positioned at point R

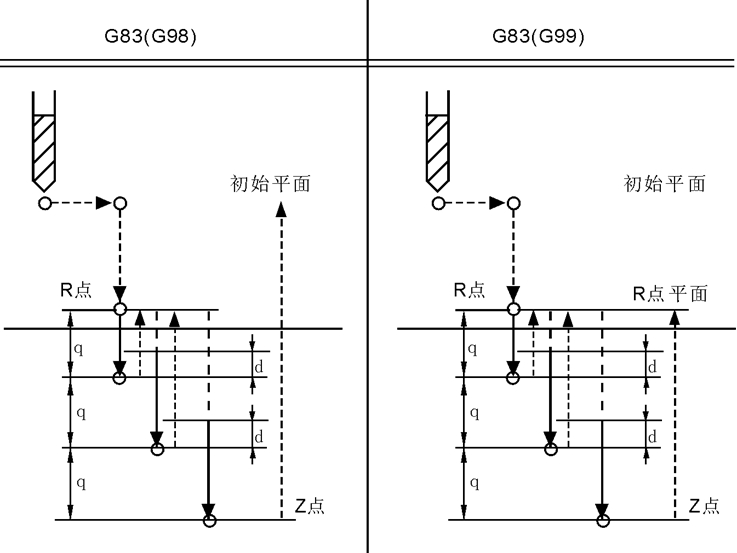
[picture p47: figure]

- 35 -

加偏置。刀具半径偏置被忽略。
示例：
M3 S2000 | ；主轴开始旋转
G90 G99 G82 X300 Y-250 Z-150 R-100 P1 F120
| ；钻第1个孔， 然后返回到R点
Y-550 | ；钻第2个孔， 然后返回到R点
G98 Y-750 | ；钻第3个孔， 然后返回初始位置平面
G80
M30 | ； 结束

（24） 排屑钻孔循环 （G83）

执行间歇切削进给到孔的底部钻孔过程中从孔中排除切屑
指令格式：G83 X-Y-Z-R-Q-P-F-L- ；
| X-Y-：孔位数据
| Z-：从 R 点到孔底的距离（G91）或坐标值（G90）
| R-：从初始点到 R 点的距离（G91）或坐标值
（G90）
| Q-：每次切削进给的切削深度
| P-：孔底的暂停时间，单位：s
| F-：切削速度
| L-：重复次数
图示：

说明：Q 表示每次切削进给的切削深度，它必须用增量值指定。在第二次和 以后的切削进给中，执行快速移动到上次钻孔结束之前的d 点再次执行，切削进 给d在加工参数P2设定，在Q 中必须指定正值，负号被忽略。 指定G83之前，用辅助功能M 代码旋转主轴。

- numerical control system -
- 35 -

Add bias. Tool radius bias is ignored.
instance ：
M3 S2000 | ; The spindle starts to rotate
G90 G99 G82 X300 Y-250 Z-150 R-100 P1 F120
| ; Drill the first hole and return to point R
Y-550 | ; Drill the second hole and return to point R
G98 Y-750 | ; Drill the third hole and return to the initial position plane
G80
M30 | ； finish
（24） Drill Cuttings Circulation (G83)
Execution of intermittent cutting feed into the bottom of the hole to drill the hole and remove the chips from the hole
Instruction format: G83 X-Y-Z-R-Q-P-F-L-;
| X-Y-: Hole position data
| Z-: Distance from point R to hole bottom (G
91) or coordinate value (G90)
| R-: Distance from the starting point to
point R (G91) or coordinate value (G90)
| Q-: The depth of cut per pass
| P-: Pause time at the bottom of the hole,
unit: s
| F-： cutting speed
| L-： number of replication
graphic ：

Note: Q represents the cutting depth per feed, which must be specified as an incremental value. During the second and subsequent feed operations, perform a rapid move to point d before the previous drilling end to repeat the process. The cutting feed d is set in the machining parameter P2. A positive value must be specified in Q, and negative signs are ignored.
Rotate the spindle using the auxiliary function M code before specifying G83.

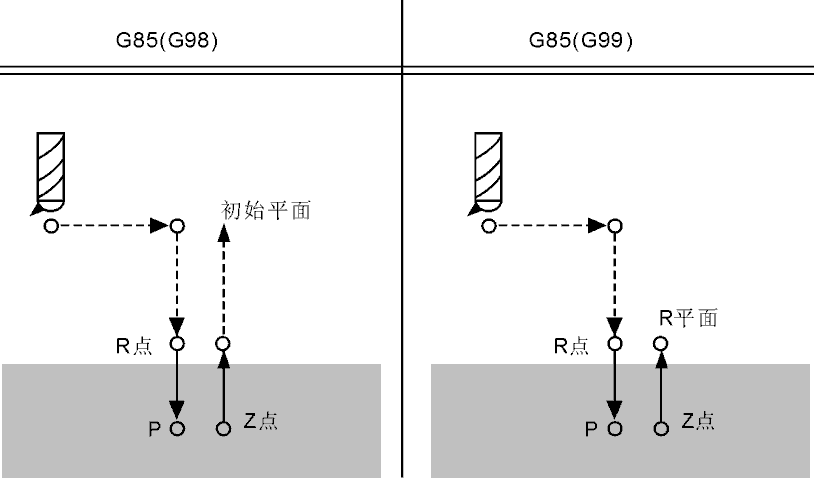
[picture p48: figure]

- 36 -

当在固定循环中指定刀具长度偏置（G43、G44 或G49）时，在定位到R点的同 时加偏置， 刀具半径偏置被忽略。
示例：
M3 S2000 | ；主轴开始旋转
G90 G99 G83 X300 Y-250 Z-150 R-100 Q15 F120 ；钻第1个孔，返到R点
Y-550 | ；钻第2个孔， 然后返回到R点
Y-750 | ；钻第3个孔， 然后返回到R点
G98 Y-600 | ；钻第4个孔， 然后返回初始位置平面
G80
M30 | ； 结束

（25）镗孔循环（G85）

G85指令用于镗孔。
指令格式：G85 X-Y-Z-R-P-F-L- ；
| X-Y-：孔位数据
| Z-：从 R 点到孔底的距离（G91）或坐标值（G90）
| R-：从初始点到 R 点的距离（G91）或坐标值
（G90）
| P-：孔底的暂停时间，单位：s
| F-：切削速度
| L-：重复次数
图示：

说明：沿着X和Y轴定位以后，快速移动到R点，然后从R点到Z 点执行镗孔， 当到达孔底时，执行切削进给，然后返回到R点．
在指定G85之前，用辅助功能M代码旋转主轴．
当在固定循环中指定刀具长度偏置（G43、G44 或G49）时在定位到R点的同时 加偏置，刀具半径偏置被忽略。
示例：

- numerical control system -
- 36 -

When a tool length offset (G43, G44, or G49) is specified in a fixed cycle, the offset is added while positioning to point R, and the tool radius offset is ignored.
instance ：
M3 S2000 ; The spindle starts to rotate
G90 G99 G83 X300 Y-250 Z-150 R-100 Q15 F120; drill the first hole and return to point R Y-550 ; Drill the second hole and return to point R
Y-750 | ; Drill the third hole and return to point R
G98 Y-600 | ; Drill the fourth hole and return to the initial position
plane
G80
M30 | ； finish
（25） Borehole Circulation (G85)
The G85 command is used for boring. Instruction format: G85 X-Y-Z-R-P-F-L-; X-Y-: Hole position data
Z-: Distance from point R to hole bottom (G
91) or coordinate value (G90)
R-: Distance from the starting point to point R (G91) or coordinate value (G90) P-: Pause time at the bottom of the hole, unit: s
F-： cutting speed
L-： number of replication
graphic ：

Note: After positioning along the X and Y axes, quickly move to point R, then perform boring from point R to point Z. When reaching the bottom of the hole, perform cutting feed, and then return to point R.
Rotate the spindle using auxiliary function M code before designating G85.
When a tool length offset (G43, G44 or G49) is specified in a fixed cycle, the offset is added while positioning to point R, and the tool radius offset is ignored.
instance ：

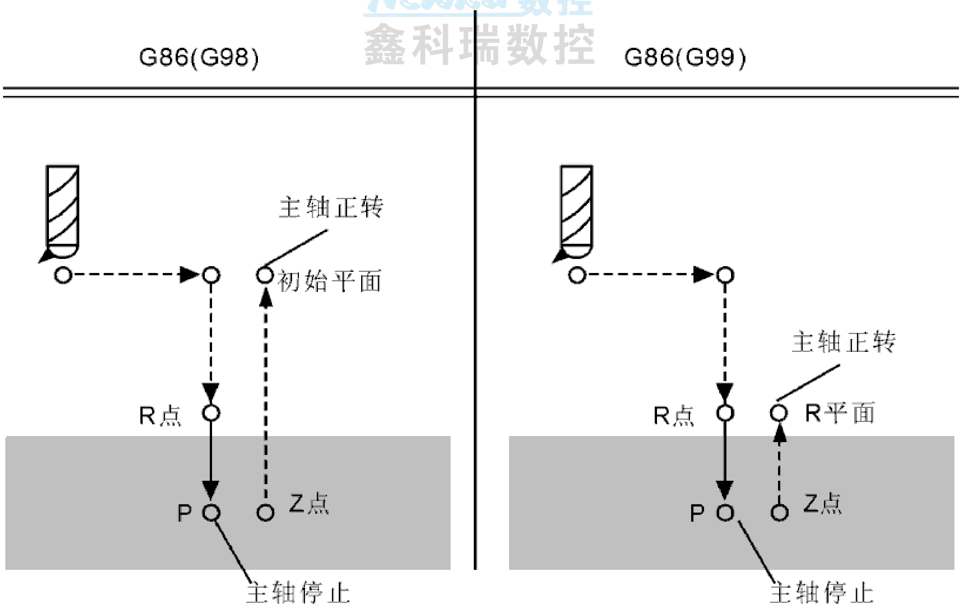
[picture p49: figure]

- 37 -

M3 S100 ；主轴开始旋转
G90 G99 G85 X300 Y-250 Z-150 R-120 F120 ；镗第1个孔，返到R点
Y-550 | ；镗第2个孔， 然后返回到R点
Y-750 | ；镗第3个孔， 然后返回到R点
G98 Y-600 | ；镗第4个孔， 然后返回初始位置平面
G80
M30 | ； 结束

（26） 镗孔循环（G86）

G86指令用于镗孔．
指令格式：G86 X-Y-Z-R-P-F-L- ；
| X-Y-：孔位数据
| Z-：从 R 点到孔底的距离（G91）或坐标值（G90）
| R-：从初始点到 R 点的距离（G91）或坐标值
（G90）
| P-：孔底的暂停时间，单位：s
| F-：切削速度
| L-：重复次数
图示：

说明：沿着X和Y轴定位以后，快速移动到R点，然后从R点到Z点执行镗孔．当 主轴在孔底停止时，刀具以快速移动退回．
在指定G86之前，用辅助功能M代码旋转主轴．
当在固定循环中指定刀具长度偏置（G43、G44 或G49）时在定位到R点的同时 加偏置，刀具半径偏置被忽略。
示例：
M3 S2000 ；主轴开始旋转
G90 G99 G86 X300 Y-250 Z-150 R-100 F120 ；镗第1个孔，返到R点

- numerical control system -

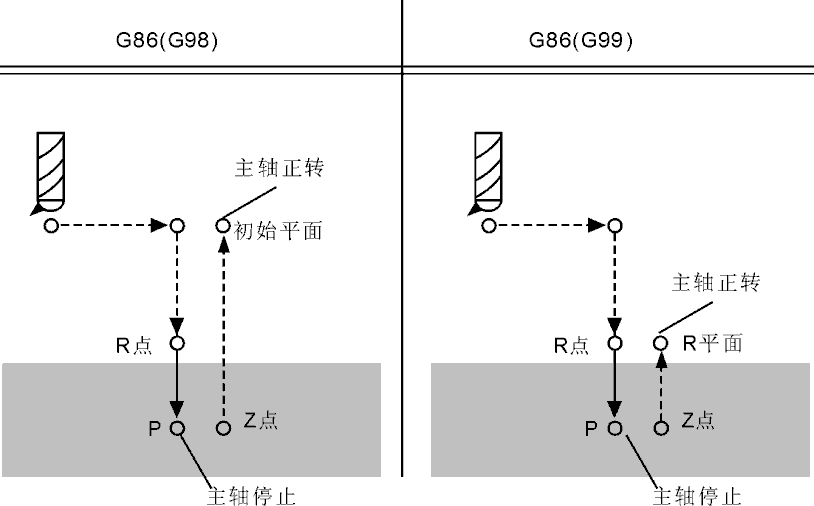
[picture p50: figure]

- 37 -

M3 S100; the spindle starts to rotate
G90, G99, G85, X300, Y-250, Z-150, R-120, F120; bore the first hole and return to point R
Y-550 | ; Bore the second hole and return to point R
Y-750 | ; Bore the third hole and return to point R
G98 Y-600 | ; Bore the fourth hole and return to the initial position plane
G80
M30 | ； finish
（26） | Borehole circulation (G86)
The G86 command is used for boring. Instruction format: G86 X-Y-Z-R-P-F-L-;
| X-Y-: Hole position data
| Z-: Distance from point R to hole bottom (G
91) or coordinate value (G90)
| R-: Distance from the starting point to
point R (G91) or coordinate value (G90)
| P-: Pause time at the bottom of the hole,
unit: s
| F-： cutting speed
| L-： number of replication
graphic ：

Note: After locating along the X and Y axes, quickly move to point R and then perform a bore from point R to point Z. When the spindle stops at the bottom of the hole, the tool is rapidly moved back.
Rotate the spindle using the auxiliary function M code before designating G86.
When a tool length offset (G43, G44 or G49) is specified in a fixed cycle, the offset is added while positioning to point R, and the tool radius offset is ignored.
instance ：
M3 S2000; the spindle starts to rotate
G90 G99 G86 X300 Y-250 Z-150 R-100 F120; bore the first hole and return to point R

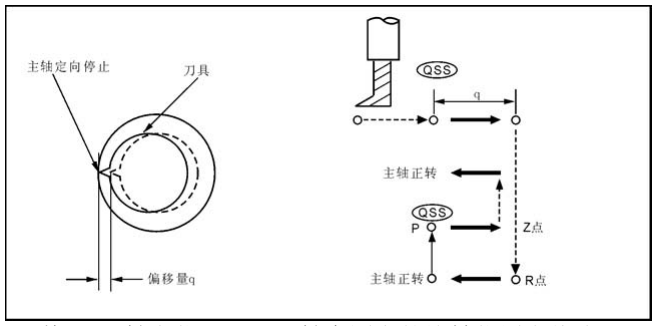
[picture p51: figure]

- 38 -
Y-550 | ；镗第2个孔， 然后返回到R点
Y-750 | ；镗第3个孔， 然后返回到R点
G98 Y-600 | ；镗第4个孔， 然后返回初始位置平面
G80
M30 | ； 结束

（27）镗孔循环、背镗孔循环（G87）

此指令只在加工中心系统上有效，因为主轴需要定向停止功能，所以 前提条件为主轴必须具有定位功能(输出M61，检测M22)。精镗循环镗削精 密孔。当到达孔底时主轴停止，切削刀具按加工参数中P4参数设定方向离 开工件的被加工表面并返回。
指令格式：G87 X-Y-Z-R-Q-P-F-L- ;
| X-Y-:孔位数据
| Z-:从 R 点到孔底的距离(G91)或坐标值(G90)
| R-:从初始点到 R 点的距离(G91)或坐标值(G90)
| Q-:孔底的偏移量，方向由加工参数 P4 设置
| P-:暂停时间,单位：s
| F-:切削速度
| L-:重复次数

说明：沿着X和Y轴定位以后，主轴在固定的旋转位置上停止。刀具在刀尖 的相反方向（由加工参数中P4、P5参数设定）快速移动并在孔底R点定位。然后， 刀具在刀尖的方向上移动并且主轴正转。沿Z 轴的正向镗孔直到Z点。在Z点， 主轴再次停在固定的旋转位置，刀具在刀尖的相反方向移动（由加工参数中P3、 P5参数设定）。然后刀具返回到初始位置，刀具在刀尖的方向上偏移，主轴正转。 执行下个程序段的加工。
在指定G87 之前，用辅助功能M代码旋转主轴。
当在固定循环中指定刀具长度偏置（G43 、G44 或G49 ）时在定位到R点的同时加偏置， 刀具半径偏置被忽略。

- numerical control system -

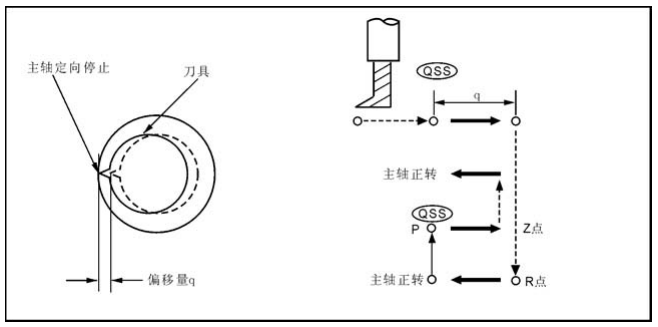
[picture p52: figure]

- 38 -
Y-550 | ; Bore the second hole and return to point R
Y-750 | ; Bore the third hole and return to point R
G98 Y-600 | ; Bore the fourth hole and return to the initial
position plane
G80
M30 | ； finish
（27） Boring Cycle, Back Boring Cycle (G87)
This command is only valid on machining center systems, as the spindle requires orientation stop functionality. The prerequisite is that the spindle must have positioning capabilities (output M61, detection M22). Precision boring cycle for machining precision holes. When reaching the hole bottom, the spindle stops. The cutting tool then departs from the workpiece's machined surface in the direction specified by parameter P4 of the machining parameters and returns.
Instruction format: G87 X-Y-Z-R-Q-P-F-L-;
| X-Y-: Hole position data
| Z-: Distance from point R to bottom of hole
| (G91) or coordinate value (G90)
| R-: Distance from the starting point to point
| R (G91) or coordinate value (G90)
| Q-: The offset amount at the bottom of the
| hole, and the direction is set by the machin-
| ing parameter P4
| P-: Pause time, unit: s
| F-： cutting speed
| L-： number of replication

Procedure: After positioning along the X and Y axes, the spindle stops at a fixed rotation position. The tool rapidly moves in the opposite direction of the cutting edge (as set by parameters P4 and P5 in the machining parameters) to position at point R at the hole bottom. Subsequently, the tool moves in the cutting edge direction while the spindle rotates forward. Boring is performed along the Z-axis until reaching point Z. At Z-point, the spindle stops again at the fixed rotation position, and the tool moves in the opposite direction of the cutting edge (as set by parameters P3 and P5). The tool then returns to its initial position, shifts in the cutting edge direction, and rotates forward again. This completes the processing cycle for the next program segment. Rotate the spindle using the auxiliary function M code before specifying G87. When a tool length offset (G43, G44 or G49) is specified in a fixed cycle, the offset is added while positioning to point R, and the tool radius offset is ignored.

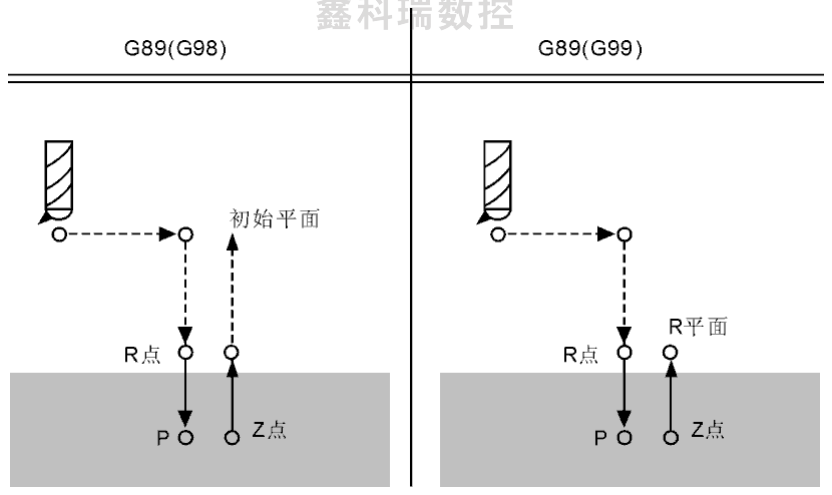
[picture p53: figure]

- 39 -

举例：
N10 M3 S100 主轴开始旋转
N20 G90 G99 G87 X300 Y-250 Z-150 R-100 Q5 ；定位，镗1孔，然后返回到R点；孔底 定向然后移动5mm

N30 Y-350 ； 定位，镗2孔，然后返回到R点
N40 Y-550 ； 定位，镗3孔，然后返回到R点
N50 Y-750 ； 定位，镗4孔，然后返回到R点 N60 G80
N70 M30

（28） 镗孔循环（G89）

G89指令用于镗孔。
指令格式：G89 X-Y-Z-R-P-F-L- ；
X-Y-：孔位数据
Z-：从 R 点到孔底的距离（G91）或坐标值（G90） R-：从初始点到R 点的距离（G91）或坐标值（G90） P-：暂停时间，单位：s
F-：切削速度
L-：重复次数
图示：

说明：除在孔底执行暂停，该循环与G85相同。
在指定G89之前，用辅助功能M代码旋转主轴。
当在固定循环中指定刀具长度偏置（G43、G44或G49）时在定位到R点的同时 加偏置。刀具半径偏置被忽略。
示例：
M3 S100 | ；主轴开始旋转
G90 G99 G89 X300. Y-250. Z-150. R-120. P1000 F120.
| ；镗第1个孔， 然后返回到R点在孔底停止1秒

- numerical control system -

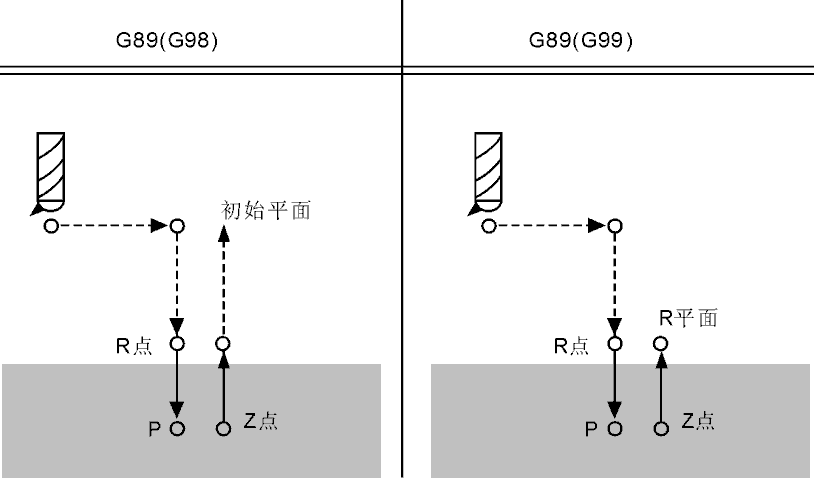
[picture p54: figure]

- 39 -

give an example ：
The N10 M3 S100 spindle starts to rotate
N20 G90 G99 G87 X300 Y-250 Z-150 R-100 Q5; Position, bore 1 hole, then return to point R; orient the bottom of the hole and move 5mm

N30 Y-350 ；

Position, bore two holes,
and return to point R

N40 Y-550 ；

Position, bore 3 holes, and return to point R

N50 Y-750 ；

Position, bore four holes, and return to point R
N60 G80
N70 M30
（28） Borehole Circulation (G89)
The G89 command is used for boring. Instruction format: G89 X-Y-Z-R-P-F-L-; X-Y-: Hole position data
Z-: Distance from point R to hole bottom (G
91) or coordinate value (G90)
R-: Distance from the starting point to point R (G91) or coordinate value (G90)
P-: Pause time, unit: s
F-： cutting speed
L-： number of replication
graphic ：

Note: Except for the pause at the bottom of the hole, this cycle is the same as G85.
Rotate the spindle using the auxiliary function M code before the specified G89.
When tool length offsets (G43, G44 or G49) are specified in a fixed cycle, the offsets are added while positioning to point R. Tool radius offsets are ignored.
instance ：
M3 S100 ; The spindle starts to rotate
G90 G99 G89 X300. Y-250. Z-150. R-120. P1000 F120.
; Bore the first hole, then return to point R and stop at the bottom of
| the hole for 1 second

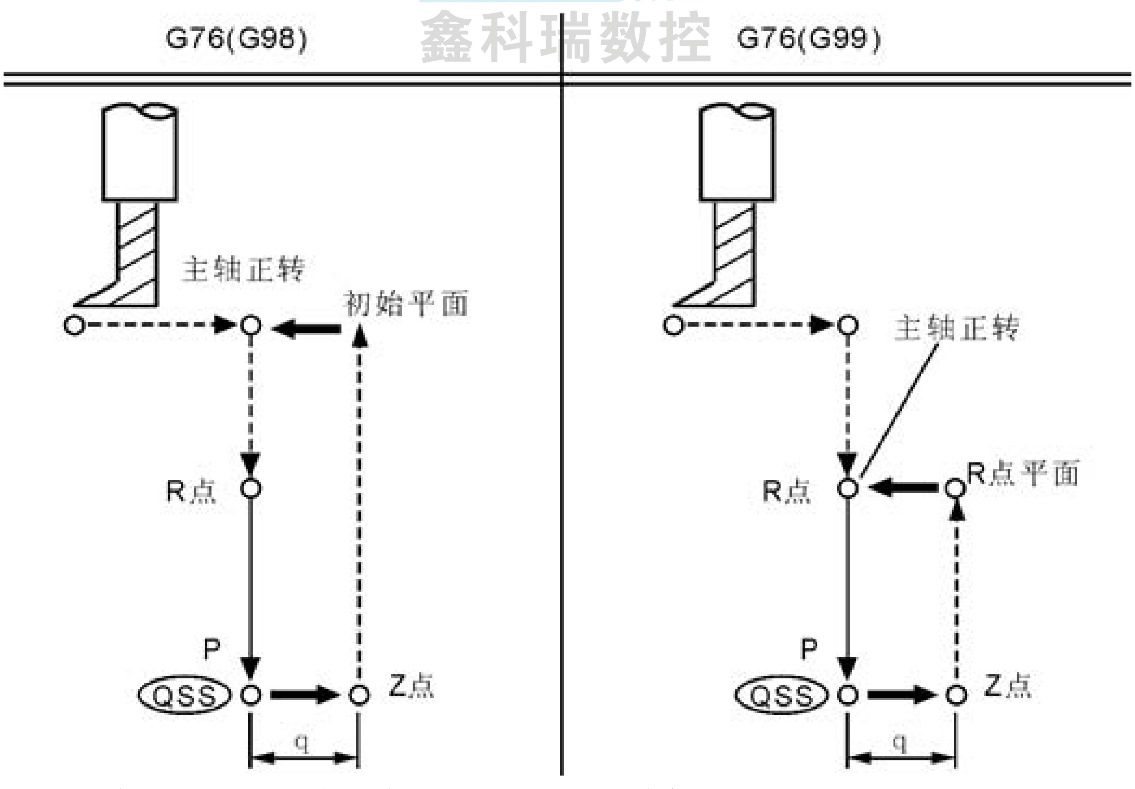
[picture p55: figure]

- 40 -
Y-550 | ；镗第2个孔， 然后返回到R点
G98 Y-750 | ；镗第3个孔， 然后返回初始位置平面
G80
M30 | ； 结束

（29） 精镗循环（G76）

此指令只在加工中心系统上有效，因为主轴需要定向停止功能，所以 前提条件为主轴必须具有定位功能(输出M61，检测M22)。精镗循环镗削精 密孔。当到达孔底时主轴停止，切削刀具按加工参数中P3参数设定方向离 开工件的被加工表面并返回。
指令格式：G76 X-Y-Z-R-Q-P-F-L- ;
| X-Y-:孔位数据
| Z-:从 R 点到孔底的距离(G91)或坐标值(G90)
| R-:从初始点到 R 点的距离(G91)或坐标值(G90)
| Q-:孔底的偏移量，方向由加工参数 P3 设置
| P-:暂停时间,单位：s
| F-:切削速度
| L-:重复次数

说明：当到达孔底时，主轴在固定的旋转位置停止，并且刀具以刀尖的相反 方向移动退刀。这保证加工面不被破坏，实现精密和有效的镗削加工。注：主轴 定向角度在加工参数P5中设置，在指定G76 之前用辅助功能M代码旋转主轴。 当在固定循环中指定刀具长度偏置（G43、G44 或G49）时在定位到R点的同时 加偏置，刀具半径偏置被忽略。
举例：
N10 M3 S100 主轴开始旋转
N20 G90 G99 G76 X300 Y-250 Z-150 R-100 Q5 ；定位，镗1孔，然后返回 到R点；孔底定向然后移动5mm

- numerical control system -

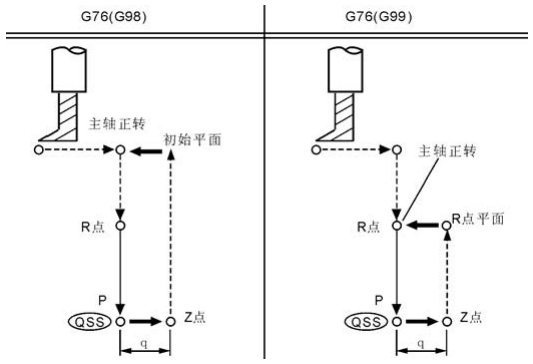
[picture p56: figure]

- 40 -
Y-550 | ; Bore the second hole and return to point R
G98 Y-750; Bore the third hole and return to the initial position plane
G80
M30 | ； finish
（29） | Borehole circulation (G76)
This command is only valid on machining center systems, as the spindle requires orientation stop functionality. The prerequisite is that the spindle must have positioning capabilities (output M61, detection M22). Precision boring cycle for drilling precision holes: When reaching the hole bottom, the spindle stops. The cutting tool then departs from the workpiece's machined surface according to the direction specified in parameter P3 of the machining parameters and returns.
Instruction format: G76 X-Y-Z-R-Q-P-F-L-;
| X-Y-: Hole position data
| Z-: Distance from point R to hole bottom (G
91) or coordinate value (G90)
| R-: Distance from the starting point to point
| R (G91) or coordinate value (G90)
| Q-: The offset of the hole bottom, and the
| direction is set by the machining parameter
| P3
| P-: Pause time, unit: s
| F-： cutting speed
| L-： number of replication

Note: When reaching the bottom of the hole, the spindle stops at a fixed rotation position, and the tool moves backward in the opposite direction of the cutting edge. This ensures the workpiece surface remains undamaged, achieving precise and efficient boring operations. Note: The spindle orientation angle is set in machining parameter P5, and the spindle rotation is performed using auxiliary function M codes before G76 commands. When tool length offsets (G43, G44, or G49) are specified in fixed cycles, the tool radius offset is ignored and offsets are applied simultaneously with positioning at point R.
give an example ：
The N10 M3 S100 spindle starts to rotate
N20 G90 G99 G76 X300 Y-250 Z-150 R-100 Q5; position, bore 1 hole, then return to point R; orient the bottom of the hole and move 5mm

- 41 -

N30 Y-350 ； 定位，镗2孔，然后返回到R点 N40 Y-550 ； 定位，镗3孔，然后返回到R点 N50 Y-750 ； 定位，镗4孔，然后返回到R点 N60 G80
N70 M30

（30）左旋琢式深孔攻丝循环(G74)

攻丝有二种方法：跟踪主轴编码器方法（P411=2,主轴必须装配编码器） 和 Z 轴与主轴伺服插补方法（P411=3），此方式指令前主轴伺服要设置为位置 控制方式如加指令 M881（加工中心用 M881 指令，控制主轴为位置控制方式）。 特别注意：
执行 G73/G84 指令停在中间或者攻丝过程断电时, 在 MDI 编辑状态下，按 “图形”键，则自动生成 M180 攻丝回退代码，按运行即可执行攻丝回退动作; 该循环执行左旋攻丝，在左旋攻丝循环中，每次进刀深度Q，主轴反转回退 距离d（加工参数P7设置）再进刀,排屑方式加工参数P6设置(0表高速排屑回退d,8 表普通排屑回退到R)，当到达孔底时主轴顺时针旋转．

指令格式：G74 X-Y-Z-R-P-K(F)-Q-S-L- ; X-Y-:孔位数据
Z-:从 R 点到孔底的距离(G91)或坐标值(G90) R-:从初始点到 R 点的距离(G91)或坐标值(G90) Q-:每次攻丝深度
P-:暂停时间，单位：s
K(F)-:螺纹导程,E 英制
S-:主轴转速
L-:重复次数

图示:

- numerical control system -
- 41 -

N30 Y-350 ；

Position, bore two holes,
and return to point R

N40 Y-550 ；

Position, bore 3 holes, and return to point R

N50 Y-750 ；

Position, bore four holes, and return to point R
N60 G80
N70 M30
（30） Left Rotary Deep Hole Tapping Cycle (G74)
There are two methods for thread cutting: the spindle encoder tracking method (P411=2, where the spindle must be equipped with an encoder) and the Z-axis and spindle servo interpolation method (P 411=3). In this approach, the spindle servo must be set to position control mode before issuing commands, such as adding the instruction M881 (the M881 command is used in machining centers to control the spindle in position control mode). Special note:
When the G73/G84 instruction stops in the middle or the power is cut off during the tapping process, press the "graphics" key under the MDI editing state to automatically generate the M180 tapping back code, and press run to execute the tapping back action;
This cycle performs left-hand tapping. During each left-hand tapping cycle, the tool advances by depth Q, then the spindle reverses to retract by distance d (set in machining parameter P7), followed by another advance. The chip removal method is configured according to parameter P6 (Table 0: high-speed chip removal retraction d; Table 8: standard chip removal retraction to R). When reaching the hole bottom, the spindle rotates clockwise.
Instruction format: G74 X-Y-Z-R-P-K (F)-Q-S-L-; X-Y-: Hole position data
Z-: Distance from point R to hole bottom (G
91) or coordinate value (G90)
R-: Distance from the starting point to point R (G91) or coordinate value (G90)
Q-: Depth of each thread attack
P-: Pause time, unit: s
K(F): Thread pitch, E in
S-： main shaft speed
L-： number of replication
graphic ：

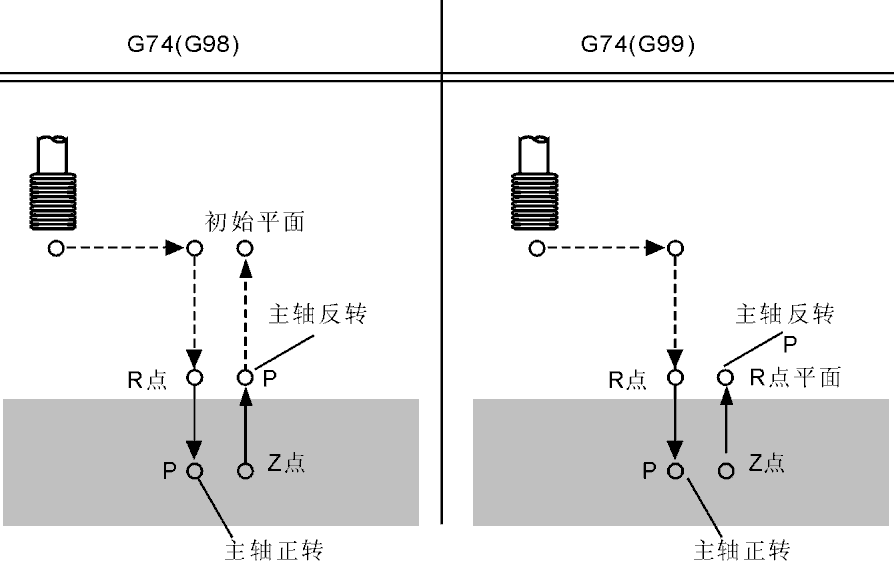
[picture p57: figure]

- 42 -

说明：
在加工螺纹时坐标轴速度由主轴转速和螺距确定，而与进给速度F值没有关 系。系统自动将坐标轴速度限制在最大进给速度之内。
加工螺纹时，主轴倍率开关和进给轴倍率开关无效。
在每一螺纹加工程序段都应指定螺纹导程K值，否则，无法通过编译。 用主轴逆时针旋转执行攻丝。当到达孔底时，为了退回主轴顺时针 旋转．该循环加工一个反螺纹。在左旋攻丝期间，进给暂停不停止机床，直到回 退动作完成。
在指定G74 之前使用辅助功能M 代码使主轴逆时针旋转。当主轴为脉冲控制方 式时，不需用辅助功能M 代码旋转主轴。
当在固定循环中指定刀具长度偏置(G43,G44 或G49)时在定位到R 点的同时加偏置。刀具半径偏置被忽略。
示例：
N10 M4 S100 主轴开始旋转
N20 G90 G99 G74 X300. Y-250. Z-150. R-100. K5 S100 ；攻第1个孔, 然后返回到R 点
N30 Y-550. K5 ；攻第2个孔, 然后返回到R 点 N40 G98 Y-750 K5 ；攻第3个孔， 然后返回初始位置平面 N50 G80
N60 M30 | ； 结束

（31）右旋琢式深孔攻丝循环(G84)

攻丝有二种方法：跟踪主轴编码器方法（P411=2，主轴必须装配编码器）和Z 轴与主轴伺服插补方法（P411=3），此方式指令前主轴伺服要设置为位置控制方式 如加指令M881（加工中心用M881指令，控制主轴为位置控制方式）。 特别注意：

- numerical control system -
- 42 -

explain ：
In the process of thread processing, the coordinate axis speed is determined by spindle speed and pitch, and has nothing to do with feed speed F value. The system automatically limits the coordinate axis speed within the maximum feed speed.
During thread machining, the spindle ratio switch and feed axis ratio switch are invalid.
The thread pilot K value should be specified in each thread machining program segment, otherwise, it cannot be compiled.
Turn the spindle counterclockwise to execute the tap. When you reach the bottom of the hole, turn the spindle clockwise to retract it Rotate. The cycle processes a counter-thread. During left-hand tapping, the feed pause does not stop the machine until the retraction action is completed.
Use auxiliary function M code to rotate the spindle counterclockwise before specifying G74. When the spindle is pulse-controlled, no rotation of the spindle is required using auxiliary function M code.
When a tool length offset (G43, G44 or G49) is specified in
a fixed cycle, the offset is added while positioning to point R.
The tool radius offset is ignored.
instance ：
The N10 M4 S100 spindle starts to rotate
N20 G90 G99 G74 X300. Y-250. Z-150. R-100. K5 S100
; Attack the first hole and return to point R N30 Y-550. K5; tap the second hole, then return to point R
N40 G98 Y-750 K5; tap the third hole, then return to the initial position plane
N50 G80
N60 M30 | ； finish
（31） Right Rotation Twist Deep Hole Tapping Cycle (G84) There are two ways to attack the thread: the method of tracking the spindle encoder (P411=2, the spindle must be equipped with an encoder) and the method of Z-axis and spindle servo interpolation (P 411=3). In this way, the spindle servo must be set to position control mode before the instruction. For example, add the instruction M881 (the M881 instruction is used for machining centers to control the spindle in position control mode).
Special note:

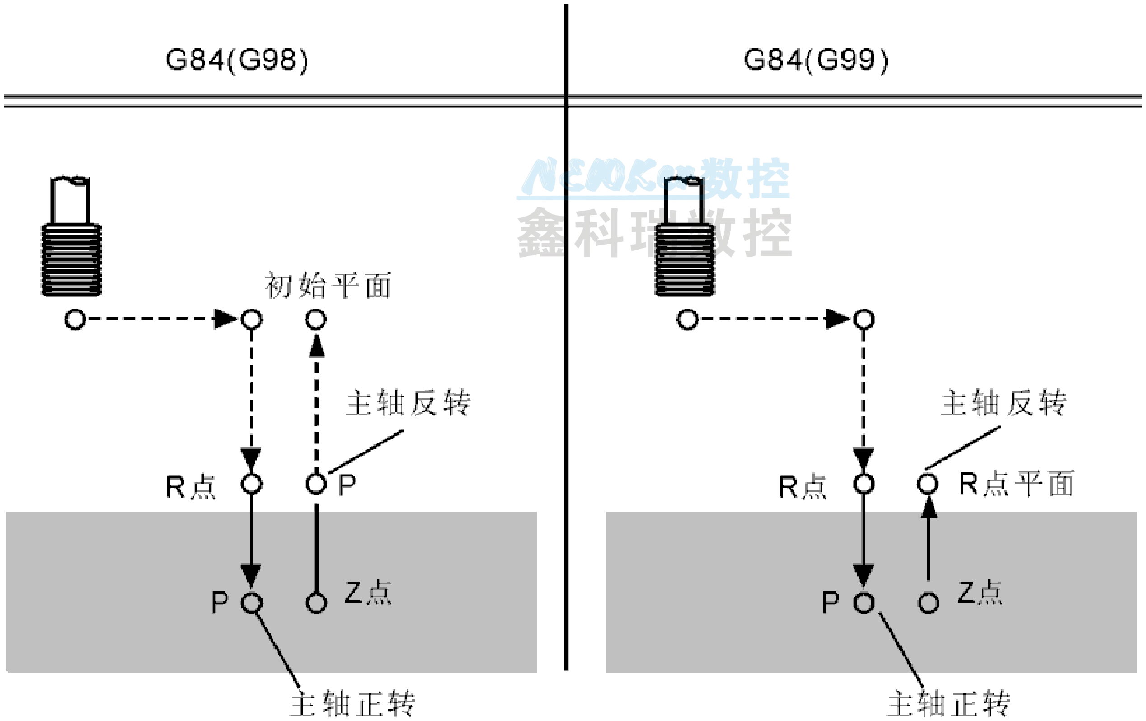
[picture p58: figure]

- 43 -

执行 G73/G84 指令停在中间或者攻丝过程断电时, 在 MDI 编辑状态下，按 “图形”键，则自动生成 M180 攻丝回退代码，按运行即可执行攻丝回退动作; 在这个攻丝循环中, 每次进刀深度Q，主轴反转回退距离d（加工参数P7设置） 再进刀, 排屑方式加工参数P6设置(0表高速排屑回退d,8表普通排屑回退到R)， 当到达孔底时主轴以反方向旋转。

指令格式：G84 X-Y-Z-R-P-Q-K(F)-L-S- ; X-Y-:孔位数据
Z-:从 R 点到孔底的距离(G91)或坐标值(G90) R-:从初始点到 R 点的距离(G91)或坐标值(G90) Q-:每次攻丝深度
P-:暂停时间,单位：s
K(F)-:螺纹导程;E 英制;
S-:主轴转速
L-:重复次数

图示:

说明：
图中在加工螺纹时坐标轴速度由主轴转速和螺距确定，而与进给速度F值没 有关系。系统自动将坐标轴速度限制在最大进给速度之内。 加工螺纹时，主轴倍率开关和进给轴倍率开关无效。
在每一螺纹加工程序段都应指定螺纹导程K值，否则，无法通过编译。 主轴顺时针旋转执行攻丝。当到达孔底时，为了回退，主轴以相反方向旋转。 这个过程生成螺纹。在攻丝期间进给暂停不停止机床，直到返回动作完。 在指定G84 之前，用辅助功能M 代码旋转主轴。当主轴为脉冲控制方式时， 不需用辅助功能M 代码旋转主轴。
当在固定循环中指定刀具长度偏置(G43,G44 或G49)时在定位到R点的同时加 偏置. 刀具半径偏置被忽略.

- numerical control system -

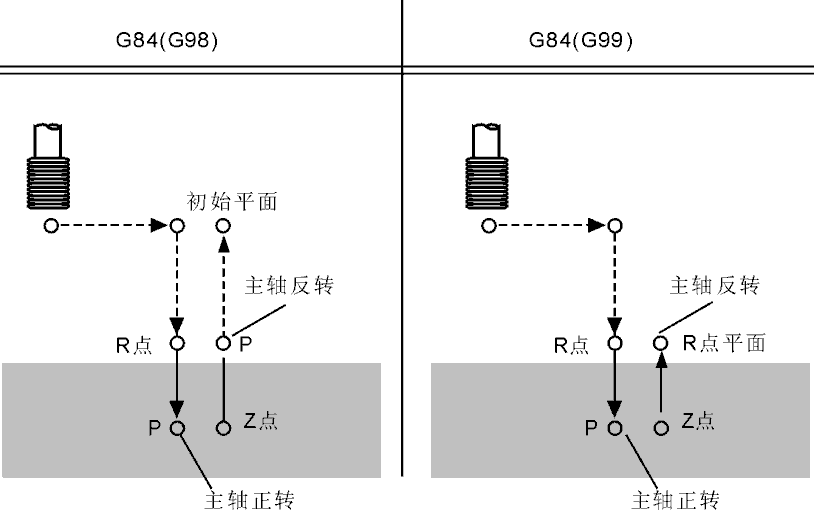
[picture p59: figure]

- 43 -

When the G73/G84 instruction stops in the middle or the power is cut off during the tapping process, press the "graphics" key under the MDI editing state to automatically generate the M180 tapping back code, and press run to execute the tapping back action;
In this tapping cycle, each feed depth Q, the spindle reverses back and retreats a distance d (processing parameter P7 is set) before feeding again. The chip removal method is processed parameter P6 (0 table high-speed chip removal retreat d, 8 table normal chip removal to R). When reaching the bottom of the hole, the spindle rotates in the opposite direction.
Instruction format: G84 X-Y-Z-R-P-Q-K (F)-L-S-; X-Y-: Hole position data
Z-: Distance from point R to hole bottom (G
91) or coordinate value (G90)
R-: Distance from the starting point to point R (G91) or coordinate value (G90)
Q-: Depth of each thread attack
P-: Pause time, unit: s
K(F) -Thread pitch; E in imperial units; S-： main shaft speed
L-： number of replication
graphic ：

explain ：
In the figure, the coordinate axis speed during thread processing is determined by spindle speed and pitch, and has nothing to do with feed speed F value. The system automatically limits the coordinate axis speed within the maximum feed speed.
During thread machining, the spindle multiplier switch and feed axis multiplier switch are invalid.
The thread pilot K value should be specified in each thread machining program segment, otherwise, it cannot be compiled.
The spindle rotates clockwise to perform tapping. When reaching the bottom of the hole, the spindle rotates in the opposite direction to retract. This process generates threads. During tapping, feed is paused without stopping the machine until the return action is complete.
Rotate the spindle using auxiliary function M code before specifying G84. When the spindle is pulse-controlled, no rotation of the spindle is required using auxiliary function M code.
When a tool length offset (G43, G44 or G49) is specified in a fixed cycle, the offset is added while positioning to point R. The tool radius offset is ignored.

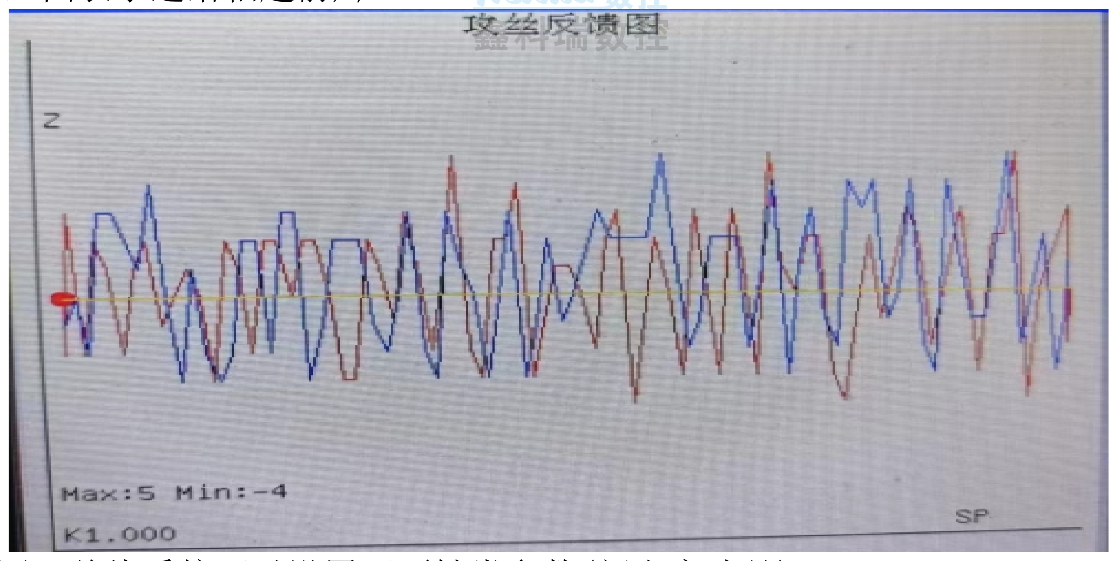
[picture p60: figure]

- 44 -

举例：
N10 M3 S100 主轴开始旋转
N20 G90 G99 G84 X300 Y-250 Z-150 R-120 P300 K5 S100 ；攻第1个孔, 然后返回到R 点
N30 Y-550. K5 ；攻第2个孔, 然后返回到R 点 N40 G98 Y-750 K5 ；攻第3个孔， 然后返回初始位置平面
N50 G80
N60 M30 | ； 结束
G74/G84 插补攻丝调试方法<主轴必须接编码器,Z 轴必须接位置反馈> 一, 轴类参数设置
<1> P607=1, 显示攻丝主轴与进给轴编码器反馈误差脉冲数;
<2> P610=68,开启反馈记录[+1 表直线;+2 表圆弧;+4 表攻丝;+64 显示图形] 二,速度参数,主轴与进给轴反向补偿量
<1>P52,攻丝时主轴反向间隙补偿(脉冲数)
<2>P53,攻丝主轴反转前 Z 轴提前提刀量(um)[10-5000]
三, 攻丝调试方法
1, 调整主轴和给进轴刚性, 尽量调整绝对误差<10(正值表进给轴超前); 2, 图形查看,诊断界面按 F8 对直线/圆弧/攻丝进行图形换页显示;
3, 黄线为标准线,红线为进刀线, 蓝线为提刀线,尽量调整三线重合(在黄线 上面表示进给轴超前);

四, 总线系统可以设置下面轴类参数(新方案攻丝)
<1> P600=20200, 攻丝主轴位置控制增益[10001-30000] <2> P601=10800,提刀主轴位置控制增益[10001-20000] <3> P602=20100,刚性攻丝平滑处理时间常数
<4> P603=5,攻丝进给轴定位到位允差值(指令脉冲数) ; <5> P604=20,攻丝提刀进给轴定位到位允差值(指令脉冲数); <6> P605,插补攻丝进给轴最大定位误差;
<7> P606,插补攻丝主轴最大定位误差;

- numerical control system -

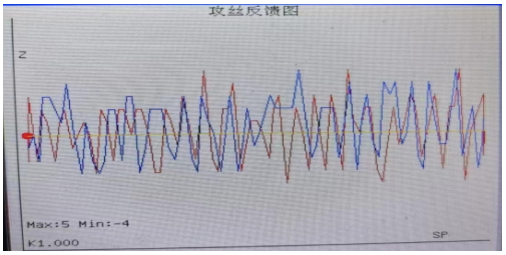
[picture p61: figure]

- 44 -

give an example ：
The N10 M3 S100 spindle starts to rotate
N20 G90 G99 G84 X300 Y-250 Z-150 R-120 P300 K5 S100
; Attack the first hole and return to point R N30 Y-550. K5; tap the second hole, then return to point R
N40 G98 Y-750 K5; tap the third hole, then return to the initial position plane
N50 G80
N60 M30 | ； finish
G74/G84 Inserting and tapping debugging method <The spindle must be connected to the encoder, and the Z-axis must be connected to the position feedback> 1. Axis parameter setting
<1 P607=1, shows the number of feedback error pulses of the tapping spindle and feed axis encoder;
<2> P610=68, enable feedback recording [+1 for straight line; +2 for arc; +4 for thread attack; +64 for graphic display]
Second, speed parameters, spindle and feed axis reverse compensation
<1>P52, spindle backlash compensation (pulse number) during tapping
<2>P53, advance the Z-axis feed before the main spindle reversal (um) [10-5000]
Third, thread attack debugging method
1. Adjust the rigidity of the spindle and feed shaft, and try to adjust the absolute error to <10 (positive value indicates that the feed shaft is in advance);
2. For graphic viewing and diagnosis, press F8 to display the graphic page of straight line/arc/threading;
3. The yellow line is the standard line, the red line is the feed line, and the blue line is the lift line. Try to adjust the three lines to coincide (the yellow line above indicates that the feed axis is in advance);

IV. The bus system can set the following shaft parameters (new scheme tapping)
<1> P600=20200, tapping spindle position control gain [10001 -30000]
<2> P601=10800, the control gain of the lifting tool spindle position [10001-20000]
<3> P602=20100, the constant of smooth treatment time for rigid thread attack
<4> P603=5, tapping feed axis positioning tolerance (instruction pulse number);
<5> P604=20, tapping feed axis positioning tolerance (instruction pulse number);
<6> P605, maximum positioning error of feed axis for plug-in tapping;
<7> P606, maximum positioning error of plug and tap spindle;

- 45 -

注意: (1) P600/P601 值越大刚性越好,效率越高,但容易超调;
(2) 当有 XSYs 轴时,P600<20000; 没有 XsYs 轴时 P600>20000;
(3) P603/P604 值越小精度越高,值越大效率越高;

（32） 固定循环取消（G80）

该指令取消固定循环。
指令格式：G80 ；
说明：取消所有的固定循环，执行正常的操作。
为了简化编程，固定循环添加如下功能。
例如：G90 G00X0Y0Z0M3;
G81 X10Y10F2;
G91X50L5;(循环5次，X方向5个孔，间隔50）; Y60L5;(Y方向5个孔，循环5次）
X10Y20L7;(斜线方向7个孔，循环7次）
G90
另外：该功能对极坐标G16增量编程极坐标角度也有效， 例如：G90 G00X0Y0Z0M3;
G16
G81 X10Y0F2; 指定初始位置: 极半径10，极角度0。 G91Y60L5;(逆时针隔60度1个孔，共5个孔，循环5次）

G90 G15

（33） 极坐标指令（G15/G16）

极坐标指令可以使坐标值用极坐标半径和角度输入，角度的正向是所选平面 的第1 轴正向的逆时针转向，而负向是顺时针转向。半径可以用绝对值指令或增 量值指令（G90， G91），角度用绝对值方式（G90）。
指令格式：
G15 取消极坐标指令；
（G17/G18/G19） （G90/G91） G16 IP- ；极坐标 指令
说明：
1、G17/G18/G19指定极坐标指令的平面选择。
2、G90 指定工件坐标系的零点作为极坐标系的原点从该点测量半径。 3、G91 指定当前位置作为极坐标系的原点从该点测量半径。 4、IP- 指定极坐标系选择平面的轴地址及其值：

- numerical control system -
- 45 -

Note:(1) the Larger the Value of P600/P601, the Better the Rigidity and Efficiency, but It Is Easy to Overshoot;
(2) When there is an XSYs axis, P600 <20000; when there is no XsYs axis, P600> 20000;
(3) The smaller the value of P603/P604, the higher the precision; the larger the value, the higher the efficiency; （32） Fixed-cycle cancellation (G80)
The instruction cancels the fixed loop.
| Instruction format: G80;
Note: All fixed loops are removed and normal operations are performed. To simplify programming, the following functions are added to the fixed loop.
For example: G90 G00X0Y0Z0M3;
G81 X10Y10F2;
G91X50L5; (5 cycles, 5 holes in the X direction, spaced 50) and Y60L5; (5 holes in the Y direction, 5 cycles)
X10Y20L7; (7 holes in the diagonal direction, 7 cycles)
G90
In addition, this function is also effective for polar G16 incremental
| programming of polar angles,
For example: G90 G00X0Y0Z0M3;
G16
G81 X10Y0F2; Specify the initial position: pole radius 10, pole Angle 0.
G91Y60L5; (counterclockwise 60 degrees per hole, a total of 5 holes, cycle 5 times)
G90 G15
（33） Polar Coordinate Instructions (G15/G16)
The polar coordinate command allows coordinates to be entered using the radius and angle of the polar coordinate system. The positive direction of the angle corresponds to the counterclockwise rotation of the first axis in the selected plane, while the negative direction corresponds to clockwise rotation. The radius can be specified using absolute value commands or incremental value commands (G90, G91), while angles are defined using absolute values (G90).
instruction format ：
| G15 Take a negative coordinate instruction;
| (G17/G18/G19) (G90/G91) G16 IP-; Polar
coordinate command
explain ：
1 、 Select the plane for the G17/G18/G19 specified polar coordinate command.
2、 The zero point of the G90 specified workpiece coordinate system is taken as the origin of the polar coordinate system and the radius is measured from that point.
3 、 G91 Designates the current position as the origin of the polar coordinate system and measures the radius from that point.
4 、 IP-Specify the axis address and value of the plane in the polar coordinate system:

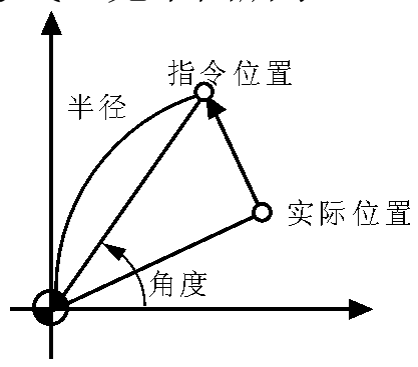
[picture p62: figure]
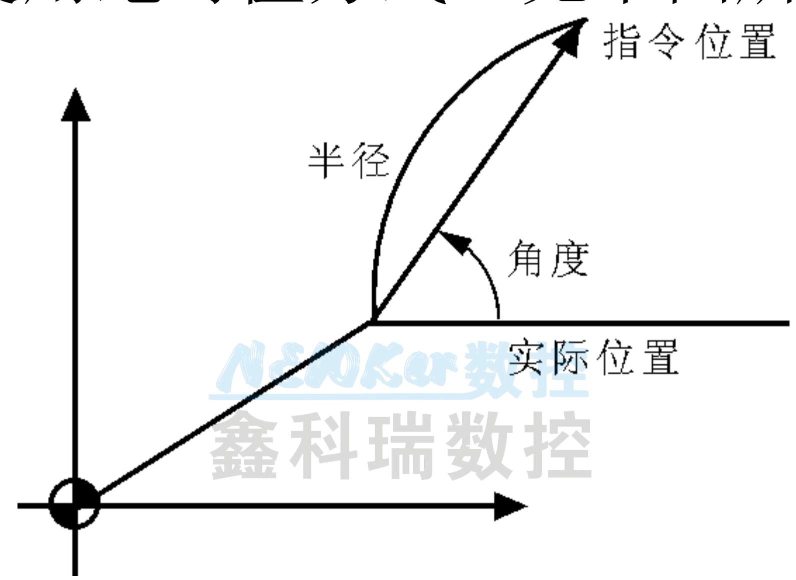
[picture p63: figure]
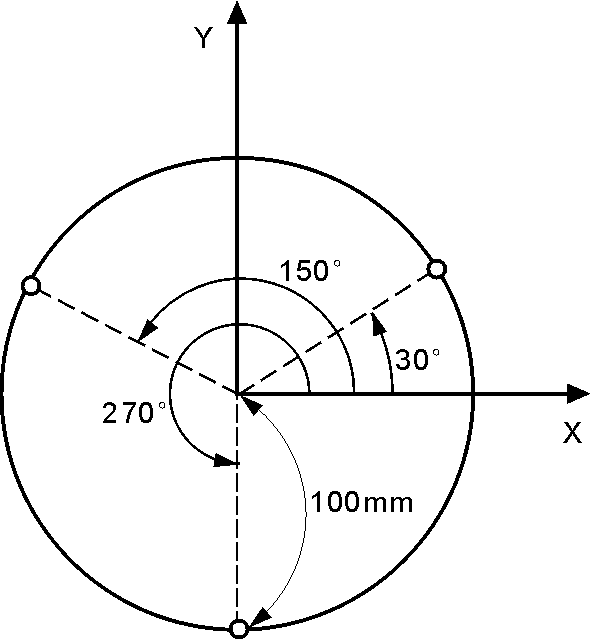
[picture p64: figure]

- 46 -

第1轴：极坐标半径值
第2轴：极角度值
5、G90设定工件坐标系的零点作为极坐标系的原点：
用绝对值编程指令指定半径（零点和编程点之间的距离）。工件坐标系的零 点设定为极坐标系的原点，当使用局部坐标系G52时，局部坐标系的原点变成极 坐标的中心，角度用绝对值方式。见下图所示：

6、G91设定当前位置作为极坐标系的原点：
用增量值编程指令指定半径（当前位置和编程点之间的距离）。当前位置指 定为极坐标系的原点。角度用绝对值方式。见下图所示：

举例：

G17 G90 G16 X0 Y0
；指定极坐标指令和选择XY平面设定工件坐标系的零点作为极坐 标系的原点
G81 X100.0 Y30.0 Z-20.0 R-5.0 F200.0 ；指定100mm 的距离和30 度的角度
Y150.0 | ；指定100mm 的距离和150 度的角度
Y270.0 | ；指定100mm 的距离和270 度的角度

- numerical control system -

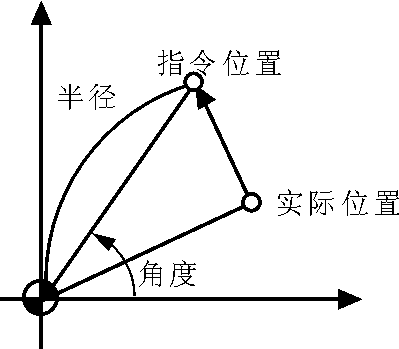
[picture p65: figure]

- 46 -

Axis 1: Polar radius value Axis 2: Polar Angle value
5、 The zero point of the workpiece coordinate system in G90 is set as the origin of the polar coordinate system:
Specify the radius (distance between the zero point and programming point) using absolute programming instructions. The zero point of the workpiece coordinate system is set as the origin of the polar coordinate system. When using the local coordinate system G52, the origin of the local coordinate system becomes the center of the polar coordinates, with angles expressed in absolute values. See the figure below:

6 、 The G91 sets the current position as the origin of the polar coordinate system:
Use incremental programming instructions to specify the radius (the distance between the current position and the programming point). The current position is designated as the origin of the polar coordinate system. The angle is expressed in absolute value. See the figure below:

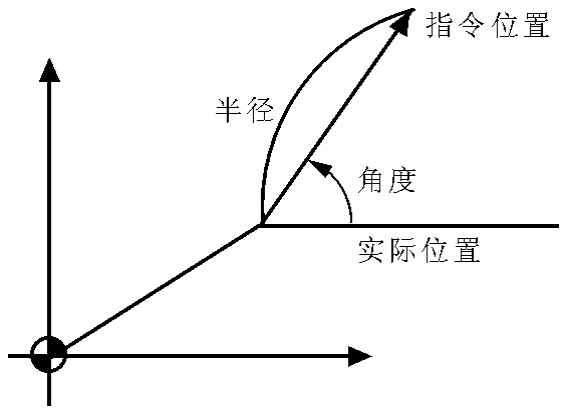
[picture p66: figure]

give an example ：

G17 G90 G16 X0 Y0

; Specify the polar coordinate instruction and select the XY plane to set the zero point of the workpiece coordinate system as the origin of the polar coordinate system
G81 X100.0 Y30.0 Z-20.0 R-5.0 F200.0
; Specify a distance of 100mm and an Angle of 30 degrees Y150.0;
Specify a distance of 100mm and an Angle
of 150 degrees
Y270.0; specifies a distance of 100mm and an Angle of 270 degrees

- 47 -

G15 G80 ；取消极坐标指令

（34） 公英制转换指令（G20/G21）、进给方式（G94/G95）

公英制转换指令选择英制或公制输入。
指令格式：
G20 ； 英寸输入；
G21 ； 毫米输入；
G94 ； 分进给；
G95 ； 转进给；
说明：该G代码必须编在程序的开头，在设定坐标系之前，以单独程序段指 定。在对英制/公制转换的G代码指定以后输入数据的单位切换到最小英制或公制 输入增量单位，角度的数据输入的单位保持不变，在英制/公制转换之后改变下 面值的单位制：
- 由F 代码指令的进给速度
- 位置指令
- 工件零点偏移值
- 刀具补偿值
- 手摇脉冲发生器的刻度单位
- 在增量进给中的移动距离
公英制转换指令 G20/G21 单位说明（参数中的单位必须重新设置）：
1） 英制G20的最小设定单位为0.0001inch，公制G21的最小设定单位为0.001mm； 2） 英制 G20 下所有与位置有关的指令单位为"inch"；
3） 英制 G20 下进给速度 F 指令单位为"inch/min"；
4） 英制 G20 下刀补和 G54-G59 工件系偏移值的单位为为"inch"；
5） 英制 G20 下与距离(如软限位和补偿量等)有关参数的单位由公制 G21 的"mm" 变成"0.1inch"或"um"变成"0.0001inch"；
6） 英制G20下与速度有关参数的单位由公制G21的"mm/min"变成"0.1inch/min"； 7） 英制 G20 下与加速度有关参数的单位由公制 G21 的"mm/min/s" 变成 "0.1inch/min/s"；
8） 英制 G20 下的手轮增量变成 0.0001inch,0.001inch,0.01inch；
9） 英制 G20 下的脉冲当量发生了变化，系统自动调整，系统电子齿轮按公制计 算设置；
10） | 英制 G20 下的坐标显示为小数点后四位数；
11） | 在程序开头编写 G20 或 G21 指令，程序中间不应编写 G20 或 G21 指令；
12） | 英制 G20 下的旋转轴，1 度对应 0.1inch；
13） | 转换公英制模式时，用 MDI 执行 G20/G21 后，重启系统即可；
14） | 系统公英制转换指令 G20/G21 执行后必须重新对刀；
15） | 所以，只需要将参数配置文件 cncsystemcn（英文 cncsystemen）的提示
信 息 修 改 一 下 即 可 ， 如 ： 有 关 速 度 的 参 数 ， 将 “ mm/min ” 改 成

- numerical control system -
- 47 -

G15 G80; Polar coordinate instruction is cancelled
（34） Metric conversion instructions (G20/G21), feed mode (G94/G95) Select British or metric for input in the metric conversion instruction. instruction format ：
G20; Inch input;
G21; millimetre input;
G94; Feed;
G95; Feed transfer;
Note: The G code must be programmed at the beginning of the program and specified as a separate program segment before setting the coordinate system. After specifying the G code for imperial/metric conversion, switch the input data unit to either minimum imperial or metric increments. The unit of angle data input remains unchanged. After completing the imperial/metric conversion, adjust the unit system for the following values:
- The feed speed is specified by the F code instruction
- Location Directive
- Workpiece zero point offset value
- Tool compensation value
- The unit of measurement on a hand pulse generator
- The distance traveled in incremental feed
Instructions for metric conversion G20/G21 unit description (the unit in the parameter must be reset):
1） The minimum setting unit of the British G20 is 0.0001inch, and the minimum setting unit of the metric G21 is 0.001mm;
2） In the British G20, all positional instructions are in "inches";
3） In the British system, G20 feed speed F instruction unit is "inch/min"; 4） In the British system, G20 tool cutting and G54-G59 workpiece offset values are in "inches";
5） Under the British G20, the unit of parameters related to distance (such as soft limit and compensation amount) is changed from "mm" in the metric G21 to "0.1inch", or "um" to "0.0001inch";
6） In the British G20, the unit of speed-related parameters changed from "mm/min" in the metric G21 to "0.1inch/min";
7） In the British G20, the unit of the parameter related to acceleration is changed from "mm/min/s" in the British G21 to "0.1inch/min/s"; 8） Under the British G20, the increment of the handwheel becomes 0.0001inch, 0.001inch, 0.01inch;
9） The pulse equivalent under the British G20 has changed, the system automatically adjusts, and the electronic gear of the system is set according to the metric calculation;
10） The coordinates under the British G20 are shown in four decimal places;
11） Write G20 or G21 instructions at the beginning of the program, and do not write G20 or G21 instructions in the middle of the program;
12） The rotation axis under the British G20 is 1 degree corresponding to 0.1inch;
13） When switching to the metric mode, execute G20/G21 with MDI, and then restart the system;
14） After the system public metric conversion instruction G20/G21 is executed, the tool must be realigned;
15） Therefore, you only need to modify the prompt message of the parameter configuration file cncsystemcn (English cncsystemen), such as: For the speed parameter, change "mm/min" to

- 48 -

“0.1inch/min”；有关位置的参数，将“mm”或“度”改成“0.1inch”，将 “um”改成“0.0001inch”。

（35） 返回程序起点指令（G26/G261-G268）

用于返回程序起点。
指令格式：G26 | ； ZXY 均返回程序起点。
G261 | ； X 返回程序起点。
G262 | ； Y 返回程序起点。
G263 | ； Z 返回程序起点。
G264 | ； A 返回程序起点。
G265 | ； B 返回程序起点。
G266 | ； C 返回程序起点
G267 | ； Xs 返回程序起点
G268 | ； Ys 返回程序起点
说明：G26 是按 G00 方式自动返回程序起点。

（36）记忆当前点（G25）

用于记忆当前坐标点位置。

（37）返回程序记忆点指令（G61/G611-G618）

用于返回程序G25记忆点。
指令格式：G61 | ；返回 G25 记忆点的 XYZ 坐标。
G611 | ；返回 G25 记忆点的 X 坐标。
G612 | ；返回 G25 记忆点的 Y 坐标。
G613 | ；返回 G25 记忆点的 Z 坐标。
G614 | ；返回 G25 记忆点的 A 坐标。
G615 | ；返回 G25 记忆点的 B 坐标。
G616 | ；返回 G25 记忆点的 C 坐标。
G617 | ；返回 G25 记忆点的 Xs 坐标。
G618 | ；返回 G25 记忆点的 Ys 坐标。
说明：G61 是按 G00 方式自动返回记忆 G25 记忆的坐标点。

（38）检测跳转指令 G31、G311

指令格式：G31 X_ Y_ | Z_ A_ B_ C_ Xs_ Ys_ F_ P_
指令格式：G25 | ； 记忆当前点 XYZABCXsYs 坐标

- numerical control system -
- 48 -

"0.1 inch/min"; for the parameters of relevant positions, change " mm" or "°" to "0.1 inch", and change "um" to "0.0001 inch".
（35） Return program starting instruction (G26/G261-G268) Used to return to the program's starting point.
Instruction format: G26 ; ZXY both return the program starting point.
G261; X returns to the program starting point. G262; Y returns to the starting point of the program.
G263; Z returns to the starting point of the program.
G264; A returns to the program starting point. G265; B returns to the starting point of the program.
G266; C returns to the program starting point G267; Xs returns to the program starting point G268; Ys returns to the program starting point Note: G26 is an automatic return to the starting point of the program in accordance with G00 mode.
（36） Memory Current Point (G25)
Used to remember the current coordinate point position.

（37） Return program memory point
instruction (G61/G611-G618) is used to
return program G25 memory point.
Instruction format: G61 Return the XYZ coordinates of the G25 memory point.
G611; returns the X-coordinate of the G25 memory point.
G612; Return to the Y-coordinate of the G25 memory point.
G613; return to the Z-coordinate of the G25 memory point.
G614; return to the A coordinate of the G25 memory point.
G615; return to the B coordinate of the G25 memory point.
G616; return to the C coordinate of the G25 memory point.
G617; return to the Xs coordinate of the G25 memory point.
G618; return to the Ys coordinate of the G25 memory point.
Note: G61 automatically returns to the memory G25 memory coordinates according to the G00 mode.
（38） Detect jump instructions G31 and G311
Instruction format: G31 X_Y_Z_A_B_C_Xs_Ys_F_P_

Instruction format: G25; Remember the current point XYZABCXsYs coordinates

- 49 -

G311 X_ Y_ Z_ A_ B_ C_ Xs_ Ys_ F_ P_ G311 与 G31 的唯一不同在于如果没有检测到信号，G311 会报警提示，G31 不会报警提示而继续执行。
P 后的数据为: 跳转行号(不输入时为下一行)加上输入点编号 X00-X39 再加 上 1000 或再加上 2000，加上 1000 表示检测到该输入点有效时跳转；加上 2000 表示检测到该输入点无效时跳转。
例如：G31 X50 Z100 F100 P331022 表检测到输入点 X22 有效时就中止当前段 而执行 N33 段。
G311 X50 Z100 F100 P2021 表检测到输入点 X21 无效时就中止当前段而执行 下一段。若 X21 一直有效就报警。
注意:
<1>P32=28,P910=1 启动高速检测;
<2>XYZA 对应检测点必须为各轴对应的 X28/X27/X26/X25; <3>G31/G311 检测时只能单独检测一个轴,如:G31 X30 F100 P1010; <4>G31/G311 指令之前必须使用 M4027 清 0;

（39）自动倒斜角 I 和倒圆角 R 功能：

铣床默认为 G17 平面。
对于 G17 平面指令格式：
G01(G00) XI 自动倒斜角, 下一段含坐标轴运行的程序段必须为 G01(G00) Y。
G01(G00) Y I 自动倒斜角, 下一段含坐标轴运行的程序段必须 为 G01(G00) X。
G01(G00) X R 自动倒圆角, 下一段含坐标轴运行的程序段必须为 G01(G00) Y。
G01(G00) Y R 自动倒圆角, 下一段含坐标轴运行的程序段必须为 G01(G00) X。
对于 G18 平面指令格式：
G01(G00) X I 自动倒斜角, 下一段含坐标轴运行的程序段必须为 G01(G00) Z。
G01(G00) Z I 自动倒斜角, 下一段含坐标轴运行的程序段必须为 G01(G00) X。
G01(G00) X R 自动倒圆角, 下一段含坐标轴运行的程序段必须为 G01(G00) Z。
G01(G00) Z R 自动倒圆角, 下一段含坐标轴运行的程序段必须为 G01(G00) X。
对于 G19 平面指令格式：
G01(G00) Y I 自动倒斜角, 下一段含坐标轴运行的程序段必须为 G01(G00) Z。

- numerical control system -
- 49 -

G311 X_ Y_ Z_ A_ B_ C_ Xs_ Ys_ F_ P_
The only difference between G311 and G31 is that if no signal is detected, G311 will alarm, while G31 will continue to execute without alarm.
The data after P is: the line number (which defaults to the next line if not entered) plus the input point number X00-X39, then add 1000, or alternatively add 2000. Adding 1000 indicates a jump when the input point is detected as valid; adding 2000 indicates a jump when the input point is detected as invalid.
For example, G31 X50 Z100 F100 P331022, when the input point X 22 is detected as valid by the meter, the current section is terminated and the N33 section is executed.
When the G311 X50 Z100 F100 P2021 meter detects that the input point X21 is invalid, it terminates the current section and performs the next section. If X21 remains valid, an alarm is triggered.
pay attention to ：
<1>P32=28, P910=1 start high speed detection;
<2>The corresponding detection points of XYZA must be X28/X27/ X26/X25 corresponding to each axis;
<3>G31/G311 can only detect one axis at a time, such as: G31 X30 F 100 P1010;
<4>G31/G311 Before the instruction must be used, M4027 must be cleared 0;
（39） Automatic chamfer I and fillet R functions:
The milling bed is assumed to be G17 plane.
For G17 planar instruction format:
G01 (G00) XI automatically reverses the angle, and the next program segment containing the coordinate axis must be G01 (G00) Y.
G01 (G00) Y I automatically reverse the angle, and the next program segment containing the coordinate axis must be G01 (G00) X.
G01 (G00) X R automatically fillets corners. The next program segment containing the coordinate axis must be G 01 (G00) Y.
G01 (G00) Y R automatically fillets corners. The next program segment containing the coordinate axis must be G 01 (G00) X.
For the G18 plane instruction format:
G01 (G00) X I automatically reverses the angle, and the next program segment containing the coordinate axis must be G01 (G00) Z.
G01 (G00) Z I automatically reverses the angle, and the next program segment containing the coordinate axis must be G01 (G00) X.
G01 (G00) X R automatically fillets corners. The next program segment containing the coordinate axis must be G 01 (G00) Z.
G01 (G00) Z R automatically fillets, and the next program segment containing the coordinate axis must be G01 (G00) X.
For the G19 plane instruction format:
G01 (G00) Y I automatically reverse the angle, and the next program segment containing the coordinate axis must be G01 (G00) Z.

- 50 -

注意：
1、地址 I 和 R 均以半径模式指定。该段直线和下一段直线运行的距离必须大于 倒斜角的宽度 I 或倒圆角的半径 R，否则 系统会自动将倒斜角的宽度 I 或倒 圆角的半径 R 减小到该段直线和下一段直线的最小运行距离。 2、相邻二条直线必须是 90°。
举例：

N0 G54G0X-50Y-50Z20
N1 M03S500
N2 G01G42D01X0Y0F200
N3 G01Z-5
N4 X100I4 | ；倒斜角 4x4

G01(G00) Z I 自动倒斜角, 下一段含坐标轴运行的程序段必须 为 G01(G00) Y。
G01(G00) Y R 自动倒圆角, 下一段含坐标轴运行的程序段必须 为 G01(G00) Z。
G01(G00) Z R 自动倒圆角, 下一段含坐标轴运行的程序段必须 为 G01(G00) Y。

- numerical control system -
- 50 -

pay attention to ：
1 、 Both address I and R are specified in radius mode. The distance between the current straight line segment and the subsequent straight line segment must exceed either the width of the chamfer (I) or the radius of the fillet (R). If this condition is not met, the system will automatically reduce the width of the chamfer (I) or the radius of the fillet (R) to the minimum required distance between the two line segments.
2、 Two adjacent lines must be 90° apart.
give an example ：

N0 G54G0X-50Y-50Z20
N1 M03S500
N2 G01G42D01X0Y0F200
N3 G01Z-5
N4 X100I4 | ; Inclined Angle 4x4

G01 (G00) Z I automatically reverses the angle, and the next program segment containing the coordinate axis must be G01 (G00) Y.
G01 (G00) Y R automatically fillets corners. The next program segment containing the coordinate axis must be G 01 (G00) Z.
G01 (G00) Z R automatically fillets, and the next program segment containing the coordinate axis must be G01 (G00) Y.

- 51 -
N5 Y40R6 | ；倒圆角 R6
N6 X47R5 | ；倒圆角 R5
N7 Y70I3 | ；倒斜角 3x3
N8 X15
N9 X0Y40
N10 Y0
N11 G0X-50Y-50G40
N12 Z50
N13 M30

（40）M 功能辅助指令

主 轴 | M03 M04 M05 M203 M204 M205 | 主轴正转 主轴反转 主轴停止刹车 M7053/M7054 Pxxxx ；主轴自 动正转/反转一段时间后自动 停止，时间由参数 P 指定，单 位为毫秒；定时精度可达到 毫秒级。 例如：M7053 P2000; 表主轴正 转 2 秒钟后停止。 | √ | √ √ √ | M203 L3/L4/L5/L6 S M204 L3/L4/L5/L6 S M205 L3/L4/L5/L6 S 第二到第六主轴正/ 反转/停止,S 指令转 速
冷 却 | M08 M09 | 冷却开 冷却关 | √ | √ √
卡 盘 | M10 M11 | 松紧刀夹紧 松紧刀松开 | √ | √ √
自定 义 | M79 M78 | 自定义输出 7 开，输出 M79 自定义输出 7 关，输出 M73 | √ | √ √ | 双信号输出
润滑 | M32 M33 | 机床润滑开 机床润滑关 | √ | √ √ | 控制 M32 信号
吹气 | M59 M58 | 吹气开 吹气关 | √ | √ √ | 控制 M59 信号
自定 义 输出 | M61 M60 | 自定义 1 开 自定义 1 关 | | √ √ | 控制 M61 信号
| M63 M62 | 自定义 2 开 自定义 2 关 | | √ √ | 控制 M63 信号
| M65 M64 | 自定义 3 开 自定义 3 关 | | √ √ | 控制 M65 信号
| M67 M66 | 自定义 4 开 自定义 4 关 | | √ √ | 控制 M67 信号

- numerical control system -
- 51 -
N5 Y40R6 | ; Reverse the fillet R6
N6 X47R5 | ; Reverse the fillet R5
N7 Y70I3 | ; Inclined Angle 3x3
N8 X15
N9 X0Y40
N10 Y0
N11 G0X-50Y-50G40
N12 Z50
N13 M30
（40） Function Assist Command M
principal axis | M 03 M 0 4 M 05 M 203 M 20 4 M 205 | Main shaft forward rot-ation main shaft reverse main shaft stop brake M7053/M7054 Pxxxx; The spindle automatica-lly stops after a period of automatic forward/ reverse rotation, and the time is specified by pa-rameter P, with the unit of millisecond; the tim-ing accuracy can reach millisecond level. For example: M7053 P 2000; the table spindle stops after 2 seconds of forward rotation. | √ | √ √ √ | M203 L3/L4/L5/L 6 S M204 L3/L4/L5/L 6 S M205 L3/L4/L5/ L6 S indicates the forward/re-verse/stop of the second to sixth spindles, and S indicates the speed
cold step back | M 08 M 09 | Cool down Cooling guard | √ | √ √
block tray | M 10 M 11 | Set the jaws of the sc-rewdriver Loosen the wrench | √ | √ √
user-defined | M 79 M 78 | Open custom output 7 and output M79 Custom output 7, out-put M73 | √ | √ √ | Dual signal output
lubricating | M 32 M 33 | Open the machine tool lubrication Machine tool lubricat-ion | √ | √ √ | Control the M32 signal
scavenging | M 59 M 58 | Turn on the air blow-ers Blow off the lid | √ | √ √ | Control the M59 signal
user-defined output | M 61 M 6 0 | Customize 1 open Customization 1 con-cerns | | √ √ | Control the M61 signal
| M 63 M 62 | Customize 2 open Customization 2 | | √ √ | Control the M63 signal
| M 65 M 6 4 | Customize 3 open Customization 3 | | √ √ | Control the M65 signal
| M 67 M 6 6 | Customize 4 open Customization 4 | | √ √ | Control the M67 signal

- 52 -
| M69 M68 | 自定义 5 开 自定义 5 关 | √ √ | 控制 M69 信号
| M71 M70 | 自定义 6 开 自定义 6 关 | √ √ | 控制 M71 信号
| M75 M74 | 自定义 8 开 自定义 8 关 | √ √ | 控制 M75 信号
自 定 义 输 入 | M12 M13 | 检测 M12 有效 检测 M12 无效 | √ √ | 条件成立转移，如 M12 P120 即:当M12 信号有效时,程序跳 转到 120 行执行
| M14 M15 | 检测 M14 有效 检测 M14 无效 | √ √
| M16 M17 | 检测 M16 有效 检测 M16 无效 | √ √
| M18 M19 | 检测 M18 有效 检测 M18 无效 | √ √
| M28 M29 | 检测 M28 有效 检测 M28 无效 | √ √
| M22 M23 | 检测 M22 有效 检测 M22 无效 | √ √
主 轴 换 档 | M41 M42 M43 M44 | 第一档 第二档 第三档 第四档 | | M41/M44 输出 S01/S02 同时调整主 轴模拟电压
子 程 序 | M97 M98 M99 | 程序跳转 子程序调用 子程序调用返回 | | L=1-99 P 为转移程序行号
程 序 控 制 | M87 M188 M189 M00 M01 M02 M30 M20 | 工件数加 1 M188 进给保持手动手轮干预 坐标后不返回起点 M189 进给保持回起点 程序暂停 程序准停，输入 X46 有效暂 停程序结束 M05、M09 程序结束 程序结束，根据参数设置运 行次数自动重复运行程序， 用于考机 | | 杂类参数 P10=0 设为 指令 M87 工件数加 1

工件数不自动加1时，

- numerical control system -
- 52 -
| M 6 9 M 6 8 | Customize 5 open Customize 5 | √ √ | Control the M69 signal
| M 7 1 M 7 0 | Customize 6 open Customization 6 | √ √ | Control the M71 signal
| M 7 5 M 7 4 | Customize 8 open Customize 8 | √ √ | Control the M75 signal
Self-defined inputs | M 1 2 M 1 3 | The M12 is valid for testing The M12 is invalid | √ √ | Conditions for tr-ansfer, such as M12 P120: when the M 12 signal is valid, the program jumps to 120 and execu-tes the line
| M 1 4 M 1 5 | The M14 was tested and found to be eff-ective The M14 is invalid | √ √
| M 1 6 M 1 7 | The M16 is valid for testing The M16 is invalid | √ √
| M 1 8 M 1 9 | The M18 is valid for testing The M18 is invalid | √ √
| M 2 8 M 2 9 | The M28 was tested and found to be eff-ective The M28 is invalid | √ √
| M 2 2 M 2 3 | The M22 was tested and found to be eff-ective The M22 is invalid | √ √
Change the main axis | M 4 1 M 4 2 M 4 3 M 4 4 | first gear second gear third gear Episode IV | | M41/M44 outputs S01/S02 and adju-sts the spindle si-mulation voltage at the same time
subprogram | M 9 7 M 9 8 M 9 9 | Program jump subprogram call Subroutine call ret-urned | | L=1-99 P is the transfer program line nu-mber
programmed control | M 8 7 M 18 8 M 18 9 M 0 0 M 0 1 M 0 2 M 3 0 M 2 0 | Add 1 to the number of jobs M188 feed hold ha-ndwheel intervention coordinates without returning to the star-ting point M189 feed is maint-ained at the starting point program halt The program is sto-pped. Enter X46 to effectively pause the program and end it M05, M09 program end At the end of the program, the prog-ram will be automat-ically repeated acco-rding to the number of times set by par-ameters for computer testing | | When the miscell-aneous parameter P10=0 is set to not automatically add 1 to the number of workpieces, the in-struction M87 adds 1 to the number of workpieces

- 53 -
主 轴 速 度 | S SS SC/SD SG/SH | 设定第一主轴速度 设定第二主轴转速 第三/四主轴转速 第五/六四主轴转速 | √ √ | S=0-99999 SS=0-99999
读绝 对式 电机 位置 | M500 M501 M502 M503 M504 M505 M506 M507 M508 | M500：读取全部进给轴绝对 电机位置并重置当前机床坐 标。 M501-M508：读取 XYZABCXsYs 轴绝对电机位置并重置当前 机床坐标。
清 工 件 坐 标 | M313 M314 M315 M316 M317 M318 M319 M320 | M313:清零 Xs 轴工件坐标 M314:清零 Ys 轴工件坐标 M315:清零 A 轴工件坐标 M316:清零 B 轴工件坐标 M317:清零 X 轴工件坐标 M318:清零 Y 轴工件坐标 M319:清零 Z 轴工件坐标 M320:清零所有轴工件坐标
清 机 床 坐 标 | M413 M414 M415 M416 M417 M418 M419 M420 | M413:清零 Xs 轴机床坐标 M414:清零 Ys 轴机床坐标 M415:清零 A 轴机床坐标 M416:清零 B 轴机床坐标 M417:清零 X 轴机床坐标 M418:清零 Y 轴机床坐标 M419:清零 Z 轴机床坐标 M420:清零所有轴机床坐标
总线 驱动 指令 | M133 M135 | M133:驱动器以指定速度转 动 (必须是 30 的倍数)； 驱动参数 P30=0 恒转 速,P30=1 往复摆动,见轴类 参数。 M135:使能指定驱动器 | | 例子： M133 X300; M135 Z0;关闭 Z 轴驱 动 M135 X1;使能 X 轴驱 动
总线 驱动 指令 | M186 | 第 5 轴焊接跟随功能模式开 启 第 5 轴焊接跟随功能模式关 闭 | | 为选配功能

- numerical control system -
- 53 -
Axis speed | S S S SC/ SD SG/ SH | Set the first spindle speed Set the second spindle speed and third/fourth spindle speed Fifth/sixth main shaft speed | √ √ | S=0-99999 SS=0-99999
Read the ab-solute motor position | M 500 M 501 M 502 M 503 M 504 M 505 M 506 M 507 M 508 | M500: Read the abso-lute motor position of all feed axes and reset the current machine tool coordinates. M501-M508: Read the absolute motor posit-ion of the XYZABCXsYs axis and reset the cur-rent machine tool co-ordinates.
Set the work coordinates | M 313 M 314 M 315 M 316 M 317 M 318 M 319 M 320 | M313: Zero the Xs axis workpiece coordinates M314: Zero the Ys axis workpiece coordinates M315: Zero the A axis workpiece coordinates M316: Zero the B axis workpiece coordinates M317: Zero the X axis workpiece coordinates M318: Zero the Y axis workpiece coordinates M319: Zero the Z axis workpiece coordinates M320: Zero the coord-inates of all shaft wo-rkpieces
Clear the ma-chine seat co-ordinates | M 413 M 41 4 M 415 M 416 M 417 M 418 M 419 M 420 | M413: Zero the Xs axis machine tool coordin-ates M414: Zero the Ys axis machine tool coordin-ates M415: Zero the A axis machine tool coordin-ates M416: Zero the B axis machine tool coordin-ates M417: Zero the X axis machine tool coordin-ates M418: Zero the Y axis machine tool coordin-ates M419: Zero Z axis machine tool coordin-ates M420: Zero all axis machine tool coordin-ates
Bus drive instruct | M 133 M 135 | M133: The driver rota-tes at a specified speed (must be a multiple of 30); drive parameter P 30=0 for constant rot-ation, P30=1 for reci-procating swing, see shaft parameters. M135: Enable the spe-cified driver | | example ： M133 X300; M 135 Z0; Turn off Z-axis drive M135 X1; Enable X-axis drive
highway drive instruct | M 186 | The fifth axis welding follow-up function mode is enabled The fifth axis welding follow-up function mode is turned off | | Optional feat-ures

- 54 -

倍率
指令

M100
M101

倍率无效，固定为 100%；
倍率有效；
所有 M 指令输出，均为低电平有效。
所有 M 指令输入，均为低电平有效。

（41）调用程序 M97、M98、M99

无条件跳转
M97 P 无条件跳转到P所指定的行号处运行；P4表示用4字段的数字指定程序转 移主程序的入口行号（标记行号）。

子程序调用
在本系统中子程序应为一个独立的程序。
M98 P L 无条件调用子程序指令。P指定程序调用的子程序路径及名字，L指子 程序调用次数地址。
M98指令可以省略不写，格式为：PP文件名，文件名可以是隐藏文件，隐藏 文件首字符必须为“HIDEFILE”开头。如文件“HIDEFILE01”，此程序在程序区 是不显示的，调用时可以用指令M98/G65 PHIDEFILE01或M98/G65 P*01或PP*01或 PPHIDEFILE01。
例如： Psub/1390表子程序为tmp/NC/sub/1390
注: 1、tmp/NC/为系统程序默认路径,sub为其下面的一个文件夹 2、子程序必须是一个单独的程序。
3、优盘中主程序调用优盘中子程序的方法：P[或P]。 例如：M98 P[A1234 表示调用优盘中的子程序A1234； M98 P]SS12 表示调用优盘中的子程序SS12； PP[FFDE 表示调用优盘中的子程序FFDE；
如果调用优盘中文件夹下的子程序，需要编上文件的路径。 子程序调用次数地址字符L前必须有空格。子程序运行结束，返回到主程序 的下一个程序段。如果程序包含固定的顺序或多次重复的图形的话，这样的顺序 或图形可以编成子程序在存储器中贮存以简化编程，子程序可以由主程序调用， 被调用的子程序也可以调用另一个子程序。
M99子程序结束返回指令，子程序结束必须有此指令。
注意：
1）M99在主程序中同M02指令；
2）M99在主程序带P时同M97指令；
3）M99在子程序中返回主程序调用处下行；
4）M99在子程序中带P时返回主程序P程序行；
子程序可以调用其它子程序(嵌套)。不管主调程序的是主程序或子程序，子 程序返回都是返回到主调程序行的下一个程序行。当主程序调用子程序时，它被 认为是一级子程序。调用可以嵌套4 级调用关系见图表。

- numerical control system -
- 54 -

multiplying
power
instruct

M
100
M
101

The multiplier is invalid
and fixed at 100%;
The multiplier is effective;
All M instruction outputs are valid at low level. All M instruction inputs are valid at low level.
（41） Call the Programs M97, M98 and M99
unconditional jump
M97 P unconditionally jumps to the line number specified by P; P4 indicates the entry line number (marked line number) of the main program from which the program transfers using the number in the 4 field.
subprogram call
In this system, the subroutine should be a separate program.
M98 P L is an unconditional subroutine call instruction. P specifies the path and name of the subroutine called, and L specifies the address of the number of times the subroutine is called.
The M98 instruction can be omitted. Its format is: PP filename, where the filename may be a hidden file. Hidden files must start with " HIDEFILE". For example, if the file is named "HIDEFILE01", it will not appear in the program area. When calling this function, you can use the following instructions: M98/G65 PHIDEFILE01, M98/G65 P*01, PP*01, or PPHIDEFILE01.
For example, the subroutine Psub/1390 is tmp/NC/sub/1390
Note: 1. tmp/NC/ is the default path of the system program, and sub is a folder under it
2. A subroutine must be a separate program.
3The method for the main program in a USB drive
to call subroutines within it: P[or P]. For example: M98 P[A1234] indicates calling subroutine A1234 in the USB drive; M98 P]SS12 indicates calling subroutine SS12 in the USB drive; PP[FFDE indicates calling subroutine FFDE in the USB drive;
If you call a subroutine in a folder on the USB drive, you need to write the path of the file.
Subroutine calls must be preceded by a space character L. Upon completion of a subroutine execution, the program returns to the next segment of the main program. When a program contains fixed sequences or repetitive graphics, these elements can be stored as subroutines in memory to simplify programming. Subroutines can be called by the main program, and the called subroutine may also call another subroutine.
The M99 subroutine end return instruction must be present for the subroutine to end.
pay attention to ：
1） M99 in the main program with M02 instruction;
2） M99 is the same as M97 instruction when P is in the main program;
3） M99 returns to the main program call point in the subroutine; 4） M99 returns to the main program line P when it carries P in the subroutine;
Subroutines can call other subroutines (nested). Whether the calling program is a main program or a subroutine, the return of a subroutine always goes to the next line of the program where the main program was called. When a main program calls a subroutine, it is considered a first-level subroutine. The call can be nested up to four levels. See the diagram for the call relationship.

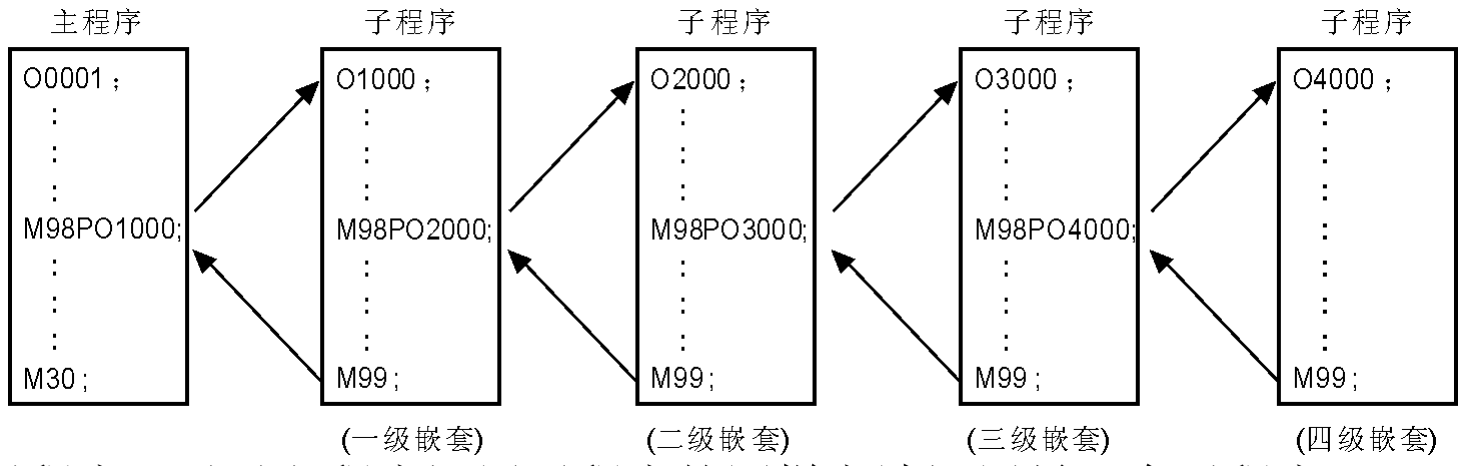
[picture p67: figure]
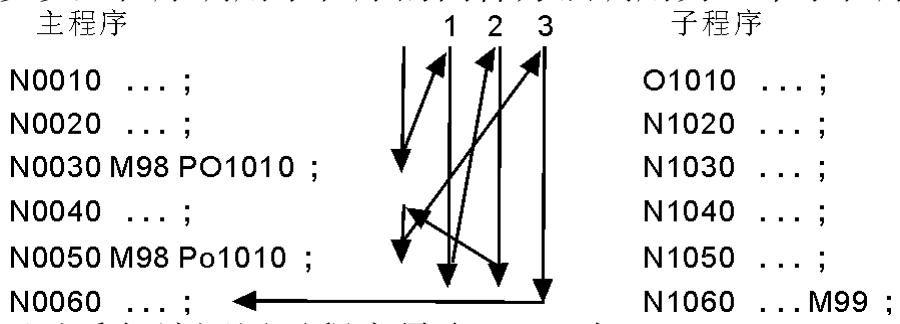
[picture p68: figure]

- 55 -

子程序可以以主程序调用子程序的同样方法调用另一个子程序

调用指令可以重复地调用子程序最多9999 次。

条件等待、跳转指令

本系统中指令 M 代码有用于检测外部输入信号做为条件的情况，具体如下：

条件等待
M12 M13 指令用于检测输入信号 M12 的状态，程序行中 M12 表检测 M12 信号输 入有效后执行下一行程序，M13 表检测 M12 信号输入无效后执行下一行程序。该 指令独立一行。
M14 M15 指令用于检测输入信号 M14 的状态，程序行中 M14 表检测 M14 信号 输入有效后执行下一行程序，M15 表检测 M14 信号输入无效后执行下一行程序。 该指令独立一行。
M16 M17 指令用于检测输入信号 M16 的状态，程序行中 M16 表检测 M16 信号 输入有效后执行下一行程序，M17 表检测 M16 信号输入无效后执行下一行程序。 该指令独立一行。
M18 M19 指令用于检测输入信号 M18 的状态，程序行中 M18 表检测 M18 信号 输入有效后执行下一行程序，M19 表检测 M18 信号输入无效后执行下一行程序。 该指令独立一行。
M22 M23 指令用于检测输入信号 M22 的状态，程序行中 M22 表检测 M22 信号 输入有效后执行下一行程序，M23 表检测 M22 信号输入无效后执行下一行程序。 该指令独立一行。
M28 M29 指令用于检测输入信号 M28 的状态，程序行中 M28 表检测 M28 信号 输入有效后执行下一行程序，M29 表检测 M28 信号输入无效后执行下一行程序。 该指令独立一行。

- numerical control system -

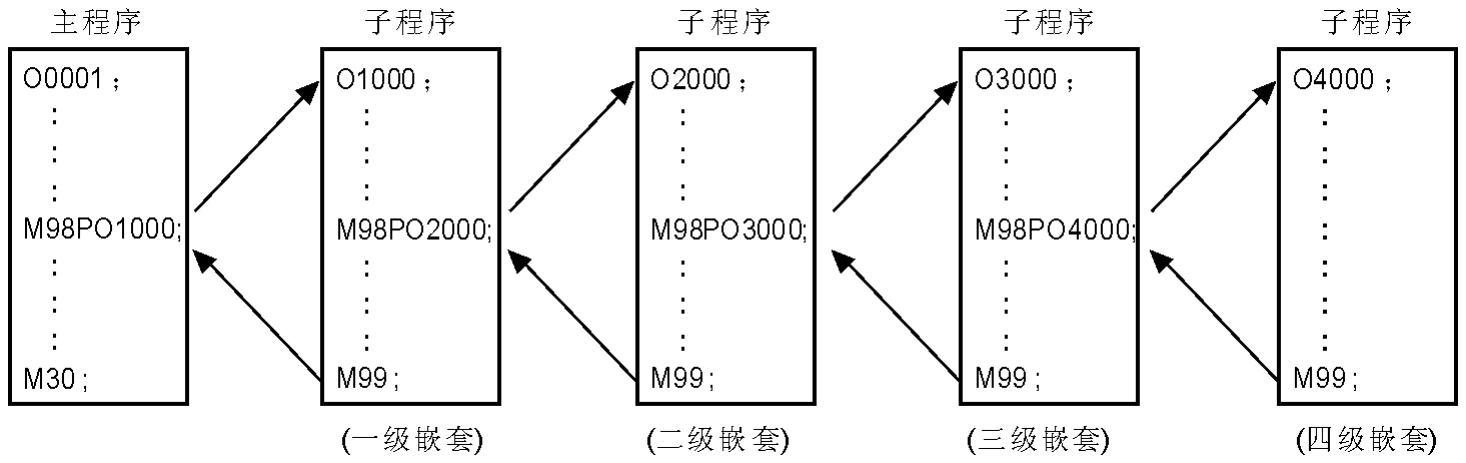
[picture p69: figure]
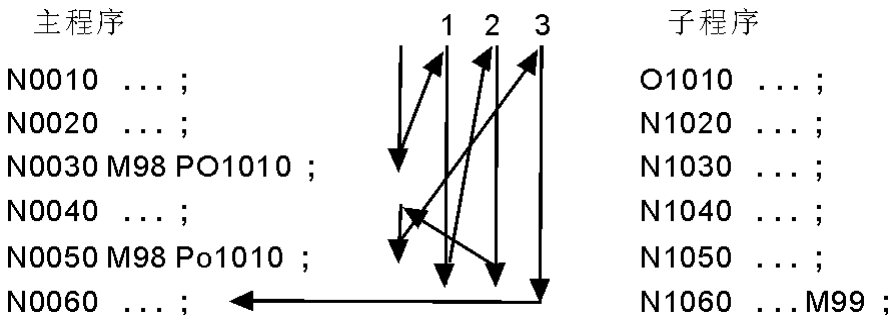
[picture p70: figure]

- 55 -

A subroutine can call another subroutine in the same way that a subroutine is called by a main program

The call instruction can call the subroutine up to 9,999 times. Condition wait, jump instruction
In this system, the instruction M code is used to detect external input signals as conditions, as follows:
Conditions await
The M12 and M13 instructions are used to detect the status of the input signal M12. In the program line, the M12 table detects the validity of the M12 signal input and executes the next line of the program after it is valid, while the M13 table detects the invalidity of the M12 signal input and executes the next line of the program after it is invalid. This instruction is independent of a line.
The M14 and M15 instructions are used to detect the status of the input signal M14. In the program line, the M14 table detects the validity of the M14 signal input and executes the next line of the program. The M15 table detects the invalidity of the M14 signal input and executes the next line of the program. This instruction is independent of the line.
The M16 and M17 instructions are used to detect the status of the input signal M16. In the program line, the M16 table detects the validity of the M16 signal input and executes the next line of the program. The M17 table detects the invalidity of the M16 signal input and executes the next line of the program. This instruction is independent of a line.
The M18 and M19 instructions are used to detect the status of the input signal M18. In the program line, the M18 table detects the validity of the M18 signal input and executes the next line of the program. The M19 table detects the invalidity of the M18 signal input and executes the next line of the program. This instruction is independent of a line.
The M22 and M23 instructions are used to detect the status of the input signal M22. In the program line, the M22 table detects the validity of the M22 signal input and executes the next line of the program. The M23 table detects the invalidity of the M22 signal input and executes the next line of the program. This instruction is independent of a line.
The M28 and M29 instructions are used to detect the status of the input signal M28. In the program line, the M28 table detects the validity of the M28 signal input and executes the next line of the program. The M29 table detects the invalidity of the M28 signal input and executes the next line of the program. This instruction is independent of a line.

- 56 -

条件跳转
M12/M13/M14/M15/M16/M17/M22/M23/M28/M29 指令之后加上 Pxxxx（程序行 号）条件成立转移,条件不成立则向下执行。
举例：指令 M14 P0120
即当程序运行到该行时，系统检测到 M14 输入信号有效时,程序跳转到该程 序第 120 行（标记行）执行，若 M14 输入信号为无效则执行该程序下一行指令。 M186/M187 焊接跟随指令：为总线系统选配功能（杂类参数 P903 设置）； （1）第四轴为 A 轴旋转轴，参数设置为全规算，用于实现刀具摆动。 （2）第五轴为 C 轴旋转轴，参数设置为 C 轴且为全规算，用于实现刀具转动； 注意：第五轴旋转的正方向设置应与 XYZ 轴坐标系符合右手坐标系原则。 （3）程序段与段之间为了实现第五轴的旋转角度插入的一段第五轴运动，按第 五轴 G00 速度运行，并按就近方向运动。
（4）指令：
M186: 开启焊接跟随功能 (执行该指令后系统的界面显示 M186) M187: 关闭焊接跟随功能 (执行该指令后系统的界面不显示 M186) （5）实例：
G54 G0X10Y60Z30
M3S200
M186 | ;进入跟随模式
G1 Z50 F500 | ;Z 轴提升
G1X10Y63F200 | ;XY 轴刀尖对准
G1 Z0 | ;Z 轴到焊点
X0Y-23
X10Y50
G2X-23.20Y130R90
M187 | ;取消跟随模式
M5
M30

（42）F 进给速度功能指令

本系统切削的进给速度用 F 字段。它是模态，实际运行速度为设置的速度乘 以速度修调倍率。
F 用于指定进给指令 G01、G02、G03 的加工速度。
速度范围 F 为 0.01-15000mm/min，进给速度为 Fx 速度修调，F 具有模态功 能。
F 指令和移动指令在同一段时先执行 F 指令，再执行移动指令。

（43） T/H/D 功能指令

- numerical control system -
- 56 -

Conditional jump
M12/M13/M14/M15/M16/M17/M22/M23/M28/M29 After the instruction, Pxxxx (program line number) is added. If the condition is true, transfer; if not, execute downward.
Example: Instruction M14 P0120
That is, when the program runs to this line, the system detects that the M14 input signal is valid, and the program jumps to the 120th line (marked line) of the program to execute. If the M14 input signal is invalid, the program executes the instruction of the next line.
M186/M187 welding follow instruction: optional function for the bus system (miscellaneous parameter P903 setting);
（1） The fourth axis is the A-axis rotation axis, and the parameter is set to full specification calculation, which is used to realize tool swing.
（2） The fifth axis is the rotation axis of the C-axis, and the parameter is set as the C-axis and full specification calculation, which is used to realize the rotation of the tool. Note: The positive direction setting of the rotation of the fifth axis should conform to the right-hand coordinate system principle in the XYZ axis coordinate system.
（3） The program segment inserted between the segments to achieve the rotation Angle of the fifth axis is run at the G00 speed of the fifth axis and moves in the nearest direction.
（4）instruct ：
M186: Enable welding follow function (the system interface displays M186 after executing this instruction)
M187: Disable the welding follow function (the system interface does not display M186 after executing this instruction)
（5）living example ：
G54 G0X10Y60Z30

M3S200 M186

; Enter follow
mode
G1 Z50 F500 | ; Z-axis lift
G1X10Y63F200 | ; XY axis tool
| tip aligned
G1 Z0 | ; Z axis to the
| weld point
X0Y-23
X10Y50
G2X-23.20Y130R90
M187 | ; Cancel the follow mode
M5
M30
（42） F Feed Speed Function Command
The feed rate for the system's cutting is given by the F field. It is a mode, and the actual running speed is the set speed multiplied by the speed adjustment multiplier.
F is used to specify the feed speed of G01, G02, and G03.
The speed range is F 0.01-15000mm/min, and the feed speed is Fx. The speed is adjusted, and F has the mode function.
F The F instruction is executed first and the move instruction is executed later in the same paragraph.
（43） T/H/D function instruction

- 57 -

本系统的 T/H/D 功能，是对刀具半径或刀具长度进行补偿的参数调用功能， 为模态，在程序中用编号调用。
其中 T01 到 T99 为刀具编号，每把刀具有四个刀沿，H1 到 H99 为刀具长度补 偿参数编号， D1 到 D99 为刀具半径补偿参数编号。

（44）S、SS、SC/SD/SG/SH 主轴速度功能指令

本系统提供二路主轴控制方式。
第一主轴转速用 S 指定，第一主轴有二种档位控制方式： （1）第一种是四档主轴速度电气控制，输出有级变速四位编码，M41-M44 指令控制，对应输出 S01-S04 编码，有级变速。用轴类参数 P48-P51 参数设置换 档方式。
（2）第二种是用四档+无级变速，M41-M44 指令控制，对应输出 S01-S04 编 码。用速度参数 P48-P51 设定其相应档位最高转速，用轴类参数 P59-P63 参数设 置换档方式。
无级变速，其取值范围为 0-99999，输出 0-10V 变频电压。输出电压为指定 的 Sx 主轴修调 x10V/最高速度。
第二主轴转速用 SS 指定,最高速度由速度参数 P52 控制，输出 0-10V 变频电 压。
第三主轴转速用 SC 指定,最高速度由速度参数 P52-1 控制，输出 0-10V 变频 电压，与第一主轴共用一个模拟输出口，第一主轴为全脉冲输出时此功能有效。 第四主轴转速用 SD 指定,最高速度由速度参数 P52-2 控制，输出 0-10V 变频 电压，与第二主轴共用一个模拟输出口，第二主轴为全脉冲输出时此功能有效。 SC/SD/SG/SH 指定第三/四/五/六主轴的转速;

（45）宏程序指令（G65、G66、G67）

1、输入指令：WAT
等待输入口X有效或无效指令，等待X, Y, M有效或无效指令。 格式：WAT+(-)X(Y/M)**+(-)X**+(-)X**+(-)X**+(-)X**+(-)X** P- D-说明：“+”表等待有效；
“-”表等待无效；
Y 或 M 必须最多只能有一个，X 可以有任意多个。 “X”表示输入口X00-X55；见系统I/O诊断；
P-:等待时间(ms),P0 表示一直等待;
D0:报警,按ESC退出运行,按Enter继续等待; D1:报警并退出运行;
D2:报警并继续运行;
D3:不报警并退出运行;
D4:不报警并继续运行;

- numerical control system -
- 57 -

The T/H/D function of this system is a parameter call function for compensation of tool radius or tool length. It is a mode and can be called by number in the program.
T01 to T99 are tool numbers, each tool has four tool edges, H1 to H 99 are tool length compensation parameter numbers, D1 to D99 are tool radius compensation parameter numbers.
（44） S, SS, SC/SD/SG/SH spindle speed function commands
This system provides two spindle control modes.
The first spindle speed is designated by S. The first spindle has two types of gear control:
（1） The first type is the four-speed spindle speed electrical control, which outputs four-level variable speed four-bit encoding and M41-M44 command control. Corresponding output S01-S04 encoding is provided for stepless speed variation. The shifting mode is set by using spindle parameters P48-P51.
（2） The second type uses four gears + stepless transmission, which is controlled by M41-M44 instructions and corresponds to output S01-S04 codes. The maximum speed of the corresponding gear is set by speed parameters P48-P51, and the shifting mode is set by shaft parameters P59-P63.
Stepless speed regulation, whose value range is 0-99999, outputs 0 -10V variable frequency voltage. The output voltage is specified as Sx spindle speed x10V/maximum speed.
The second spindle speed is designated by SS, and the maximum speed is controlled by the speed parameter P52, with an output of 0-10 V variable frequency voltage.
The third spindle speed is specified by SC, and the maximum speed is controlled by the speed parameter P52-1. The output frequency is 0 -10V, and it shares an analog output port with the first spindle. This function is effective when the first spindle is fully pulse output.
The fourth spindle speed is specified by SD, and the maximum speed is controlled by the speed parameter P52-2. The output frequency voltage is 0-10V, and it shares an analog output port with the second spindle. This function is effective when the second spindle is fully pulse output.
SC/SD/SG/SH specifies the rotational speed of the third/four/fifth/ sixth spindle;
（45） Macro Program Instructions (G65, G66, G67)
1Input Command: WAT
Wait for the X input to be valid or invalid, wait for the X, Y, M to be valid or invalid.
Format: WAT+ (-) X (Y/M)** + (-) X** + (-) X** + (-) X** + (-) X** + (-) X** P-D-Note: "+" indicates that the wait is valid;
"-" The table is waiting for invalid;
There must be at most one Y or M, and X can have any number. "X" indicates input ports X00-X55; see system I/O diagnosis;
P-: Waiting time (ms), P0 means waiting forever;
D0: Alarm, press ESC to exit operation, press Enter to continue waiting;
D1: Alarm and exit operation;
D2: Alarm and continue to run;
D3: Do not alarm and exit operation; D4: Do not alarm and continue to run;

- 58 -

2、输出指令：OUT
设定输出口Y有效或无效指令
格式：OUT+(-)Y
说明：“+”表示输出有效；
“-”表示输出无效；
“Y”表示输出口Y00-Y31；见系统I/O诊断；
3、变量与赋值：=
宏变量根据变量号可以分成如下几种类型：
1）#0--#20 局部变量：局部变量只能用在宏程序中存储数据，例如运算结 果，当断电时，局部变量被初始化为空；调用宏程序时自变量对局部变量赋值。 2）#21--#999 全局变量：全局变量在不同的宏程序中的意义相同。当断电 时，变量#21--#100初始化为零；
变量#101--#999的数据保存即使断电也不丢失；
宏变量 #900--#999 可以在 PLC 中调用作 CMP 比较运算。 3）#1000-- 系统变量：系统变量用于读取CNC运行时各种数据的变化。例如 刀具的当前位置和补偿值。
特别注意：宏变量 #100-#204,#380-#390 已被系统功能占用，用户不要使用。 用户可使用的全局变量：#31--#99, #205--#379和#391--#999，其他全局变 量已被系统占用或用作系统备用功能。
宏变量 #161--#165 用于记录和显示G31/G311指令跳转时的XYZAB机床坐标 值。
#201: 螺纹复合循环G176重复执行的次数(方式1)。

#202: 螺纹复合循环G176重复执行时每次刀具沿Z轴的偏移距离(单位： mm)(方式1)。

#203: 螺纹复合循环G176重复执行的次数(方式2)。

#204: 螺纹复合循环G176重复执行时每次刀具沿Z轴的偏移距离(单位： mm)(方式2)。

4), 宏变量#1001--#1099对应车床T1--T99的X轴偏移值(单位为微米)。 宏变量#1401--#1499对应车床T1--T99的Z轴偏移值(单位为微米)。 可以读取其值，例如：#200=#1003;表将三号刀的X轴偏移值读入到宏变量#200 中。
可以修改其值，例如：#1003=23000;表将三号刀的X轴偏移值改成23000微米。 #1003=#1003+50;表将三号刀的X轴偏移值增加50微米。 5）输入输出变量：
#1800: X00-X07（D0-D7）

#1801: X08-X15（D0-D7）

#1802: X16-X23（D0-D7）

#1802: X16-X23（D0-D7）

#1803: X24-X31（D0-D7）

#1804: X32-X39（D0-D7）

- numerical control system -
- 58 -

2 Output Instruction: OUT
Set the instruction format for output port Y to be
valid or invalid: OUT+ (-)
Y
Note: "+" indicates that the output is valid; "-" indicates invalid output;
"Y" indicates the output ports Y00-Y31; see system I/O diagnosis; 3Variable and Assignment: =
Macro variables can be divided into the following types according to variable number:
1） #0--#20 Local variables: Local variables can only be used in macro programs to store data, such as operation results. When the power is cut off, local variables are initialized to empty; when calling macro programs, self variables assign values to local variables.
2） #21--#999 Global variables: Global variables have the same meaning in different macro programs. When the power is cut off, variable #21--#100 is initialized to zero;
Variable #101-- #999 data is saved without loss even if the power is cut off;
Macro variables #900-- #999 can be invoked in the PLC as CMP comparison operations.
3） #1000- -System variables: System variables are used to read changes in various data during CNC operation, such as the current position of a tool and compensation values.
Special note: Macro variables #100-#204, #380-#390 have been occupied by system functions. Do not use them.
Global variables available to users: #31-- #99, #205-- #379 and # 391-- #999. Other global variables have been occupied by the system or used as system backup functions.
Macro variables #161-- #165 are used to record and display the XYZAB machine tool coordinates when the G31/G311 instruction is jumped.
#201: The number of times the thread composite cycle G176 is repeated (mode 1).

#202: The offset distance of the tool along the Z-axis (unit: mm) when the thread composite cycle G176 is repeated (Mode 1). #203: The number of times the thread composite cycle G176 is repeated (mode 2).

#204: The offset distance of the tool along the Z-axis (unit: mm) when the thread composite cycle G176 is repeated (Mode 2).

4) Macro variables #1001--#1099 correspond to the X-axis offsets (in microns) of lathes T1--T99. Macro variables # 1401--#1499 correspond to the Z-axis offsets (in microns)
of lathes T1--T99.
You can read its value, for example: #200=#1003; the table reads the X-axis offset of knife 3 into the macro variable #200.
You can modify its value, for example: #1003=23000; the table changes the X-axis offset value of No.3 knife to 23000 microns.
#1003= #1003 + 50; the table increases the X-axis offset value of No.3 knife by 50 microns.

5） Input/Output variables:
#1800: X00-X07（D0-D7）

#1801: X08-X15（D0-D7）

#1802: X16-X23（D0-D7）

#1802: X16-X23（D0-D7）

#1803: X24-X31（D0-D7）

#1804: X32-X39（D0-D7）

- 59 -

#1805: X40-X47（D0-D7）

#1806: X60-X67（D0-D7）

#1808: Y00-Y15（D0-D15）

#1809: Y16-Y31（D0-D15）

格式：#i=表达式；
6）按用户程序格式保存当前全部全局宏变量
FILEMS(AABBCC) 或 FILEMS[AABBCC]
保存#21-#999到程序AABBCC文件；
要读取这些变量时，只需要执行一下该文件， 或者将该文件作为子程序调 用即可。
4、算术和逻辑运算
算术和逻辑运算表：
功能 | 格式 | 备注
定义 | #i = #j
加法 减法 乘法 除法 | #i = #j + #k ; #i = #j - #k ; #i = #j * #k ; #i = #j / #k ;
正弦 反正弦 余弦 反余弦 正切 反正切 | #i = SIN(#j) ; #i = ASIN(#j); #i = COS(#j) ; #i = ACOS(#j); #i = TAN(#j); #i = ATAN(#j); | 角度以度指定.90度30 分表示为90.5度。
平方根 绝对值 舍入 向下取整 向上取整 自然对数 指数函数 | #i = SQRT(#j); #i = ABS(#j) ; #i= ROUND(#j); #i = FIX(#j); #i = FUP(#j); #i = LN(#j); #i = EXP(#j);
或 异或 与 | #i = #j OR #k ; #i = #j XOR #k ; #i = #j AND #k ; | 逻辑运算一位一地按 二进制数执行。

5、无条件转移：GOTO n
转移到标有顺序号n的程序段当指定1到99999以外的顺序号时出现报错，可 用表达式指定顺序号。例：GOTO 5，GOTO #100
6、条件转移：1）IF （条件表达式）GOTO 或 THEN

- numerical control system -
- 59 -

#1805: X40-X47（D0-D7）

#1806: X60-X67（D0-D7）

#1808: Y00-Y15（D0-D15）

#1809: Y16-Y31（D0-D15）

Format: #i=expression;
6） Save all global macro variables in the current user program format FILEMS (AABBCC) or FILEMS[AABBCC]
Save #21-#999 to program AABBCC file;
To read these variables, simply execute the file or call it as a subroutine.
Arithmetic and Logical Operations
Arithmetic and logical operation tables:
function | form | remarks
definition | #i = #j
addition subtraction multiplication division | #i = #j + #k ; #i = #j - #k ; #i = #j * #k ; #i = #j / #k ;
Sine, arsine, cosine, inverse cosine, arcta-ngent, arctangent | #i = SIN(#j) ; #i = ASIN(#j); #i = COS(#j) ; #i = ACOS(#j); #i = TAN(#j); #i = ATAN(#j); | The Angle is specif-ied in degrees. 90.30 is expressed as 90.5 degrees.
Round off the absolute value of square roots Round down round up to an integer natural logarithm exponential function | #i = SQRT(#j); #i = ABS(#j) ; #i= ROUND(#j); #i = FIX(#j); #i = FUP(#j); #i = LN(#j); #i = EXP(#j);
Or yes or no | #i = #j OR #k ; #i = #j XOR #k ; #i = #j AND #k ; | Logical operations are performed bit by bit in binary numb-ers.

5Unconditional Transfer: GOTO N
When the sequence number other than 1 to 99999 is specified, an error occurs when transferring to the program segment marked with sequence number n. You can specify the sequence number with an expression. Example: GOTO 5, GOTO #100
6Condition transfer: 1) IF (condition expression) GOTO or THEN

- 60 -

2）IF （条件表达式）
<操作>
ELSE
<操作>
ENDIF
3）IF （条件表达式）
<操作>
ELIF
<操作>
ELIF
<操作>
ENDIF

如果指定的条件表达式满足时，执行本条语句；如果指定的条件表达式不满 足，执行下个程序段。
例：IF （#100 EQ 2） THEN #100=5
IF （#101 GT 2） GOTO 6
运算符含义：
EQ 等于=
NE 不等于
GT 大于>
GE 大于或等于>=
LT 小于<
LE 小于或等于<=
7、循环语句： WHILE（条件表达式）DO 1、2、3
在WHILE 后指定一个条件表达式。当指定条件满足时，执行从DO 到 END之间的程序。否则，转到END后的程序段。循环嵌套最多3层。 例：WHILE （#100 LT 3）DO 1
……
WHILE （#103 EQ 5）DO 2
……
WHILE （#200 GE 20）DO 3
……
END 3
……
END 2
……
END 1
8、非模态调用宏指令：G65
格式：G65 P- L- <A-B-C-…… 自变量传递数据>

- numerical control system -
- 60 -

2） IF (condition expression)
< operate >
ELSE
< operate >
ENDIF
3） IF (condition expression) < operate >
ELIF
< operate >
ELIF
< operate >
ENDIF
If the specified conditional expression is satisfied, execute this statement; if the specified conditional expression is not satisfied, execute the next program segment.
Example: IF (#100 EQ 2) THEN #100=5
IF （#101 GT 2） GOTO 6
Operation meaning:
EQ equals = NE
does not
equal GT
greater
than>
GE greater
than or equal
to or less than
LT less than
LE less than or equal to <=
7、 The WHILE Statement: WHILE (condition Expression) DO 1, 2, 3 After WHILE, specify a conditional expression. When the specified condition is met, execute the program between DO and END. Otherwise, transfer to the program segment after END. The loop can be nested up to 3 levels.
Example: WHILE (#100 LT 3) DO 1

……
WHILE （#103 EQ 5）DO 2
……
WHILE （#200 GE 20）DO 3
……
END 3
……
END 2
……
END 1
8. Non-Mode Calling Macro Instructions: G65
Format: G65 P-L- <A-B-C-...... Independent variable passes data>

- 61 -

P为宏程序名，L调用次数，A、B、C为自变量，自变量名对应如下： #0->A、#1->B、#2->C、#3->D、#4->E、#5->F、#6->H、#7->I、#8->J、#9->K、 #10->M、 #11->Q、#12->R、#13->S、#14->T、#15->U、#16->V、#17->W、#18->X、 #19->Y、#20->Z。
特别注意：地址G、L、N、Q、P不能在自变量中使用。
例如：
主程序：9000
G00 X0 Z0
G65 P8000 L1 A5 B6
G0 X0 Z0
M30
宏程序：8000
N1 #2=#0+#1
N2 IF （#2 EQ 10）GOTO 4
N3 GOO X#2
N4 G00 Z#1
N5 M99 | ；返回
9、模态调用宏指令：G66、G67
G66为模态调用宏指令，G67取消模态。使用格式同G65。 例如：
主程序：9000
G00 X0 Z0
G66 P8000 L2 A5 B6
A8 B1
A9 B10
G67
M30
宏程序：8000
N1 #2=#0+#1
N2 IF （#2 EQ 10）GOTO 4
N3 GOO X#2
N4 G00 Z#1
N5 M99 | ；返回
10、信息提示对话框
格式：MSG(参数) 或 MSG[参数]; 参数为信息字符串，暂停。 注意：该指令在一般 NC 程序(非宏程序)中也可以使用。
| 显示信息提示对话框后，系统自动切换到暂停状态。
格式：STAF(参数) 或 STAF[参数]; 参数为信息字符串，不暂停。 11、自动生产加工程序
1>,建立打开文件指令：

- numerical control system -
- 61 -

P is the macro program name, L is the number of calls, and A, B, C are the independent variables. The names of the independent variables correspond to the following:

#0->A、#1->B、#2->C、#3->D、#4->E、#5->F、#6->H、#7->I、#8->J、#9->K、 #10->M、 #11->Q、#12->R、#13->S、#14->T、#15->U、#16->V、#17->W、#18->X、#19-> Y、#20->Z。

Special note: Addresses G, L, N, Q, and P cannot be used in the independent variable.
for instance ：
Main program: 9000
G00 X0 Z0
G65 P8000 L1 A5 B6
G0 X0 Z0
M30
Macro program: 8000

N1 #2=#0+#1
N2 IF （#2 EQ 10）GOTO 4
N3 GOO X#2
N4 G00 Z#1
N5 M99 | ； return
9. Modal Call Macro Instructions: G66 and G67
G66 is a mode call macro instruction and G67 cancels the mode. The format is the same as G65.
for instance ：
Main program: 9000
G00 X0 Z0
G66 P8000 L2 A5 B6
A8 B1
A9 B10
G67
M30
Macro program: 8000

N1 #2=#0+#1
N2 IF （#2 EQ 10）GOTO 4
N3 GOO X#2
N4 G00 Z#1
N5 M99 | ； return
10. Information Prompt Dialog Box
Format: MSG (parameter) or MSG[parameter]; the parameter is an information string and is suspended.
Note: This instruction can also be used in general NC programs (non-macro programs).
After the message prompt dialog box is displayed, the system automatic-
| ally switches to the pause state.
Format: STAF (parameter) or STAF[parameter]; The parameter is an information string and does not pause.
11. Automatic Production and Processing Program
1> Establish the file open command:

- 62 -

FILEON(参数) 或 FILEON[参数]
例如：
FILEON(AABBCC) 或 FILEON[AABBCC]
表示建立打开一个文件 AABBCC
2>,关闭文件指令：
FILECE 表关闭当前打开的文件，若没有该指令，程序运行完毕后会自动关 闭当前打开的文件。
3>,向打开的文件中写入一串字符的指令：
FILEWD (参数) 或 FILEWD [参数]
例如：
FILEWD (G54G0X0Z0) 或 FILEWD [G54G0X0Z0] 表示打开的文件中写入一串字符 G54G0X0Z0
4>,向打开的文件中写入当前进给轴的绝对坐标指令：
FILEWC
示例程序：
G0X0Z0
FILEON[AABBCC]
FILEWD [G54G0X0Z0]
G1X45Z89
FILEWC
G1X99Z76
FILEWC
FILECE
执行完该程序后则会在程序目录下生成一个文件 AABBCC，其中的内容为： G54G0X0Z0
X45Z89
X99Z76

（46）自定义宏程序指令（G101—G172，M880—M979/M6880-M6929）

1、G101-G170 是 G 宏程序，对应宏程序 ProgramGxxx；
2、M880-M979 是 M 宏程序，对应宏程序 ProgramUser0—ProgramUser49; 3、M6880-M6929 是 M 并行宏程序，对应 M880-M979 功能,与主程序并行执行, 但不能执行坐标移动指令,只能执行 I/O 控制;
<1>G162 功能: 主轴模拟量控制准停到指令角度,格式:G162 C- S- D-主轴按 S 速度正转到 C 角度并执行 M63 锁紧主轴,D 越小精度越高。 <2>G163 功能: 输出点循环检测到位信号如果无信号就报错; 格式:G163 Q- M- K- X- D- R-Q: 循环检测次数,如 Q5;

- numerical control system -
- 62 -

FILEON (parameter) or FILEON[parameter] for instance ：
FILEON (AABBCC) or FILEON[AABBCC]
Indicates the opening of a file AABBCC
2>, Close file command:
FILECE closes the currently open file. If this instruction is not present, the program will automatically close the currently open file after the program is finished.
3. Write a string of characters to an open file:
FILEWD (parameter) or FILEWD [parameter]
for instance ：
FILEWD (G54G0X0Z0) or FILEWD [G54G0X0Z0]
Write a string of characters G54G0X0Z0 into the open file
4> writes the absolute coordinate command of the current feed axis to the open file:
FILEWC
Example program:
G0X0Z0
FILEON[AABBCC]
FILEWD [G54G0X0Z0]
G1X45Z89
FILEWC
G1X99Z76
FILEWC
FILECE
After executing the program, a file AABBCC will be generated in the program directory, which contains:
G54G0X0Z0
X45Z89
X99Z76
（46） Custom macro program instructions (G101-G172, M880-M979/ M6880-M6929)
1、 G101-G170 is a G macro program, corresponding to the macro program ProgramGxxx;
2 、 M880-M979 is an M macro program, corresponding to the macro program ProgramUser0-ProgramUser49;
3 、 M6880-M6929 is an M parallel macro program, corresponding to the function of M880-M979. It can be executed in parallel with the main program, but it cannot execute coordinate move instructions, and can only execute I/O control;
<1>G162 Function: spindle analog control stop to the command Angle, format: G162 C-S-D-spindle forward at S speed to C Angle and execute M63 to lock the spindle, the smaller the D, the higher the precision.
<2>G163 Function: Output point loop detection status signal is available. If no signal is available, error is reported;
Format: G163 Q-M-K-X-D-R
Q: Number of cycle tests, such as Q5;

- 63 -

M: 输出信号有效指令,如 M61,输出 Y00;
K: 输出信号无效指令,如 K60,关闭 Y00;
X: 检测输入点; 如 X01;
D: 输出信号有效后延时时间,单位为秒;
R: 输出信号无效后延时时间,单位为秒;
<3>G172 功能: 在非宏程序中调用宏程序,非模态指令;
例如，定义指令 G152 功能： 圆弧模式多孔钻孔加工循环。(必须将宏程 序 ProgramG152 导入系统)。
格式：G152 Xx Yy Zz Rr Ii Aa Bb Hh Ff; X:圆心的 X 坐标绝对值或增量值指定
Y:圆心的 Y 坐标绝对值或增量值指定
Z:孔深
R:快速趋近点坐标
F:切削进给速度
I:圆半径
A:第一孔的角度
B:增量角指定(负值时为顺时针)
H:孔数
宏程序 ProgramG152 的内容如下：
#80=#0

#81=#1

#82=#2

#83=#3

#84=#4

#85=#5

#86=#6

#87=#7

#88=#8

#89=#9

#90=#10

#91=#11

#92=#12

#93=#13

#94=#14

#95=#15

#96=#16

#97=#17

#98=#18

#99=#19

#100=#20

- numerical control system -
- 63 -

M: Output valid signal instruction, such as M61, output Y00; K: Output invalid signal instruction, such as K60, turn off Y00; X: Detection input point; e.g. X01;
D: Output signal effective delay time, unit is seconds;
R: The delay time after the output signal is invalid, in seconds; <3>G172 Function: Call a macro program in a non-macro program, non-modal instruction;
For example, define the function of G152: Circular arc mode multi-hole drilling machining cycle. (Macro program ProgramG152 must be imported into the system).
Format: G152 Xx Yy Zz Rr Ii Aa Bb Hh Ff; X: The absolute value or incremental value of the X coordinate of the center is specified
Y: The absolute value or incremental value of the Y coordinate of the center is specified
Z： hole depth
R: Coordinates of the point of rapid approach
F: Cutting feed speed
I: Radius of circle
A: Angle of the first hole
B: Incremental Angle designation (clockwise when negative)
H： hole count
The contents of the macro program ProgramG152 are as follows:
#80=#0

#81=#1

#82=#2

#83=#3

#84=#4

#85=#5

#86=#6

#87=#7

#88=#8

#89=#9

#90=#10

#91=#11

#92=#12

#93=#13

#94=#14

#95=#15

#96=#16

#97=#17

#98=#18

#99=#19

#100=#20

- 64 -

#30=#4003

#31=#4014

G90
IF[#30 EQ 90] GOTO 1
G53
#98=#5001+#98

#99=#5002+#99

N1 WHILE[#86 GT 0] DO 1
#35=#98+#87*COS[#80]

#36=#99+#87*SIN[#80]

G81X#35Y#36Z#100R#92F#85
#80=#80+#81

#86=#86-1

END 1
G#30 G#31 G80
M99

（47）圆内凹槽粗铣G110/G111

指令格式：G99 G110/G111 X_ Y_ R_ Z_ I_ W_ Q_ K_ V_ E_ D_ F_ 指令说明：绝对式闭环系统才有此功能，G110-G142一样。 指令功能：从圆心开始，以螺旋线方式进行多次圆弧插补，直至加工出编程尺寸 的圆凹槽。
指令说明：相关指令请参照表3-2 固定循环的指令说明。G110：逆时针圆内凹槽 粗铣；G111：顺时针圆内凹槽粗铣；
1. I：圆内槽半径，I 应大于当前刀具的半径；
2. W：Z 轴方向首次切深，是从R 基准面向下的距离，应大于0（若首次切深 超过槽底位置，则直接以槽底位置加工）；
3. Q：Z 轴方向每次的切深增量；
4. K：在XY 面内切削的宽度增量，应小于刀具直径，大于0；
5. V：快速下刀时，离末加工面的距离，大于0；
6. E：圆内凹槽粗铣循环加工余量。（大于等于0,负数取绝对值；
7. D：刀具半径序号，取值范围为0 ~ 32，D0默认为0。根据给定的序号取出 当前刀具半径值；
循环过程：⑴ 快速定位到XY 平面的位置；
8. ⑵ 快速下至R 点平面；
9. ⑶ 以切削速度向下切削W 距离深度；
10. ⑷ 中心向外每次按K 值递增螺旋铣完半径为I 的圆面；
11. ⑸ Z 轴快速返回R 基准面；

- numerical control system -
- 64 -

#30=#4003

#31=#4014

G90
IF[#30 EQ 90] GOTO 1
G53
#98=#5001+#98

#99=#5002+#99 N1 WHILE

[#86 GT 0] DO 1
#35=#98+#87*COS[#80]

#36=#99+#87*SIN[#80] G81

X#35Y#36Z#100R#92F#85
#80=#80+#81

#86=#86-1

END 1
G#30 G#31 G80
M99
（47） Grind the Round Recess G110/G111
Instruction format: G99 G110/G111 X_Y_R_Z_I_W_Q_K_V_E_D_F_ Instruction: This function is only available in absolute closed-loop systems, and the same is true for G110-G142.
Instruction function: from the center of the circle, multiple arc interpolation is carried out in a spiral way until the circular groove with programmed size is processed.
Instruction description: Refer to Table 3-2 for the instruction description of fixed cycle. G110: rough milling of counterclockwise circular groove; G111: rough milling of clockwise circular groove;
1. I: The radius of the circular groove, I should be greater than the radius of the current tool;
2. W: The first depth of cut in the Z direction is the distance from the R reference plane downward, which should be greater than 0 (if the first depth of cut exceeds the bottom position of the groove, the groove bottom position should be processed directly);
3. Q: The depth increment of each cut in the Z direction;
4. K: The width increment of cutting in XY plane should be less than the diameter of the tool and greater than 0;
5. V: When the blade is cut quickly, the distance from the last processing surface is greater than 0;
6. E: The machining allowance of the rough milling cycle in the circular groove. (Greater than or equal to 0, the absolute value of a negative number;
7. D: Tool radius serial number, the value range is 0 ~ 32, D0 is default 0. According to the given serial number, the current tool radius value is obtained;
Cycling process: ⑴ Quick positioning to the position in XY plane;
8. ⑵ Quickly descend to the plane of point R;
9. ⑶ The depth of downward cutting of W is cut at the cutting speed;
10. ⑷ The center is outward and each time the K value is increased, the circular surface with radius I is milled by helical milling;
11. ⑸ The Z-axis quickly returns to the R reference plane;

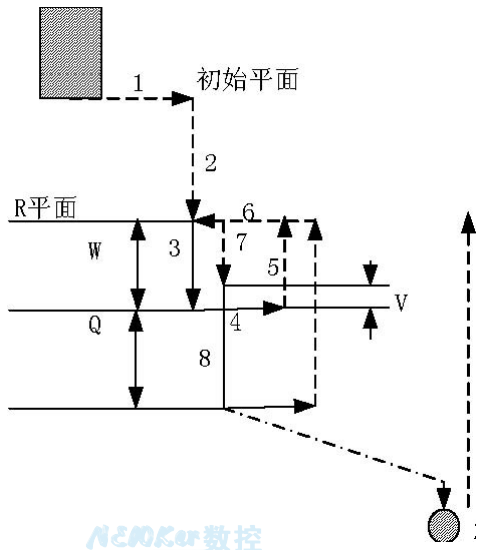
[picture p71: figure]
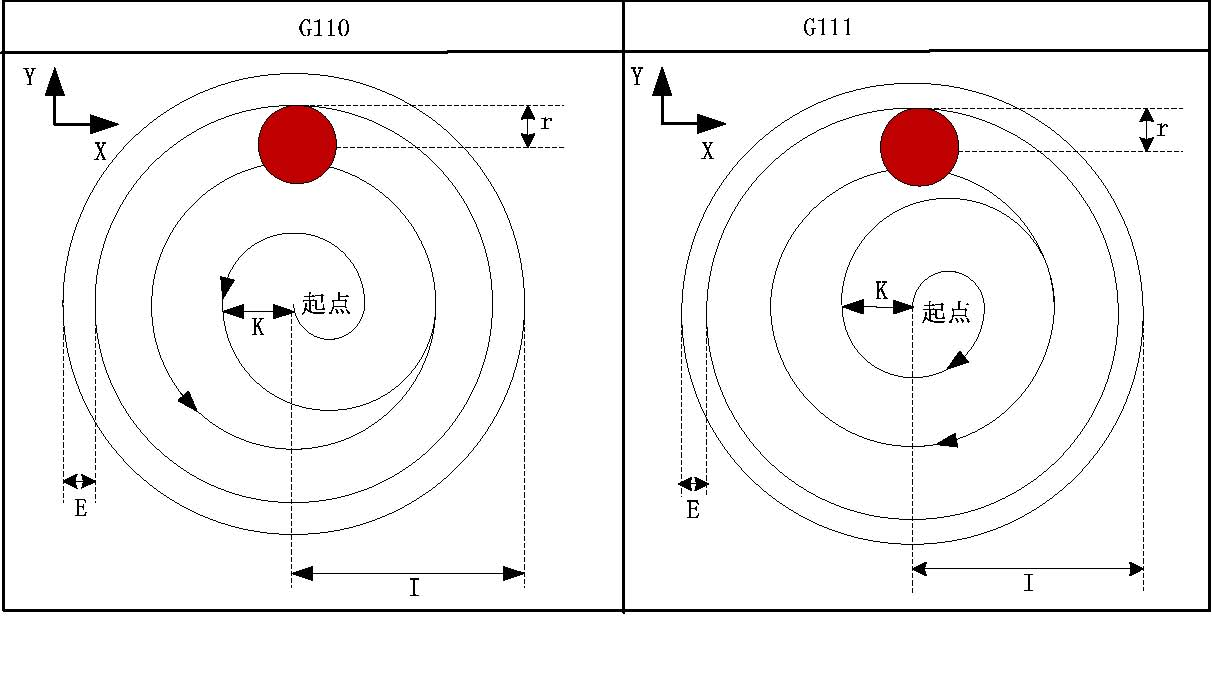
[picture p72: figure]

- 65 -
12. ⑹ X，Y 轴快速定位到圆心；
13. ⑺ Z 轴快速下降至离末加工面V 的距离；
14. ⑻ Z 轴向下切削（Q+V）的深度；
15. ⑼ 循环（4）~（8）的动作，直至加工完总切深的圆面；
16. ⑽ 固定返回R点。
⑾ 返回XY 孔定位位置。指令轨迹：

例：用固定循环G110 指令粗铣一个圆内凹槽，如下图所示：

- numerical control system -user's manual

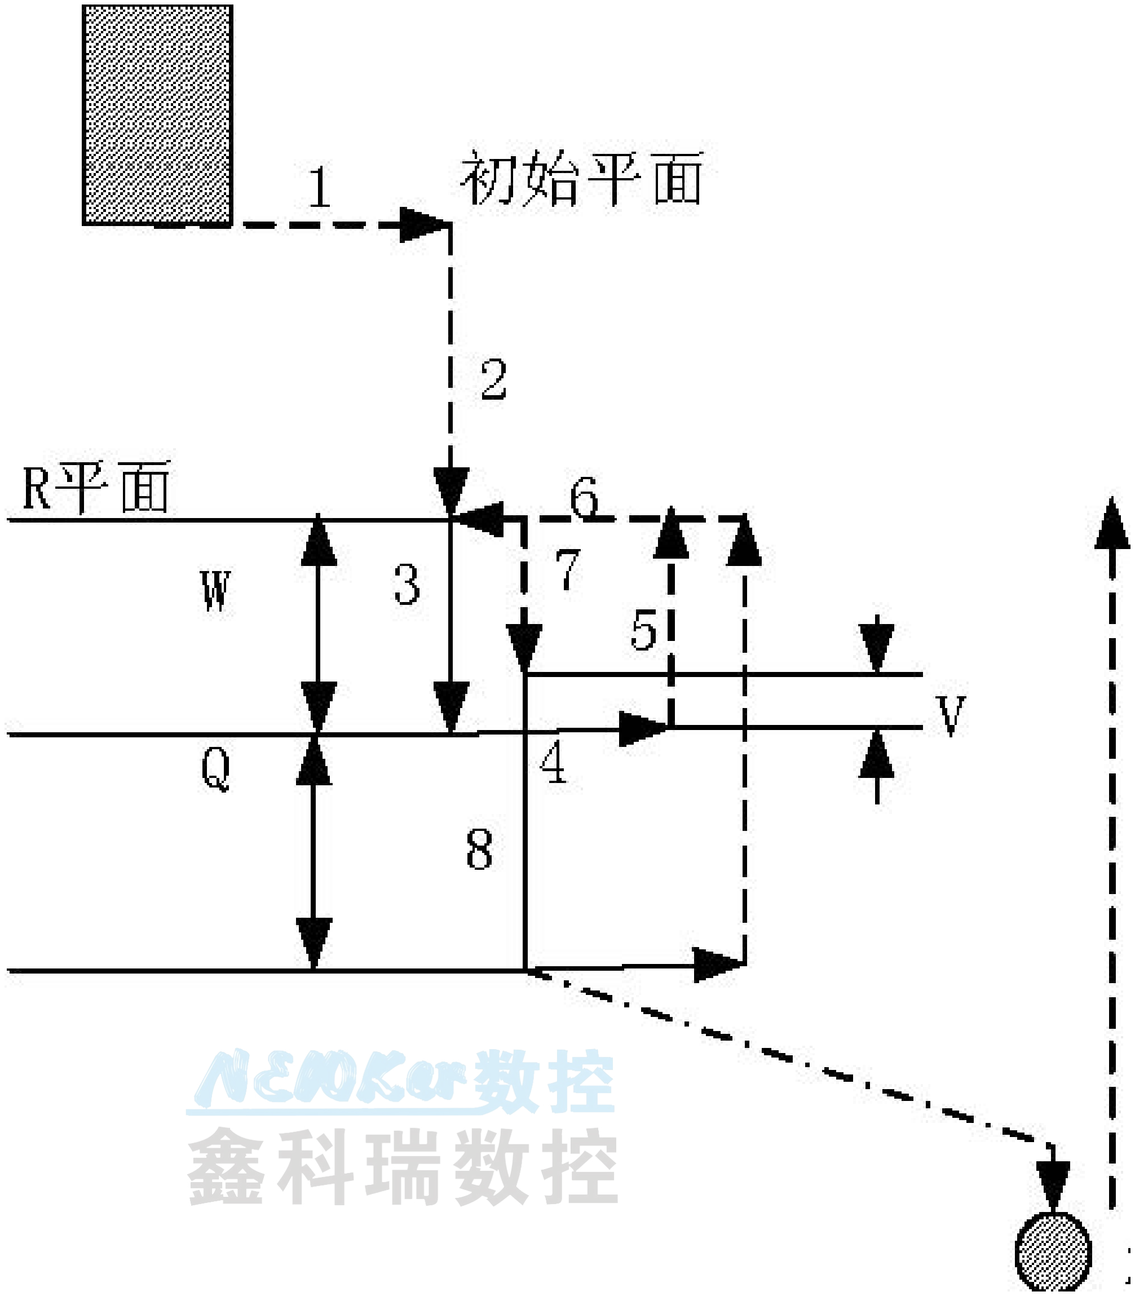
[picture p73: figure]

- 65 -
12. ⑹ The X and Y axes are quickly positioned to the center;
13. ⑺ The Z-axis drops rapidly to the distance from the final processing surface V;
14. ⑻ The depth of downward cutting (Q+V) on the Z-axis;
15. ⑼ The action of cycle (4) ~ (8) is performed until the circular surface with the total cutting depth is processed;
16. ⑽ Fixed return to point R.
⑾ Return to XY hole positioning position. Instruction trajectory:

Example: Use the fixed cycle G110 command to rough mill a circular groove, as shown below:

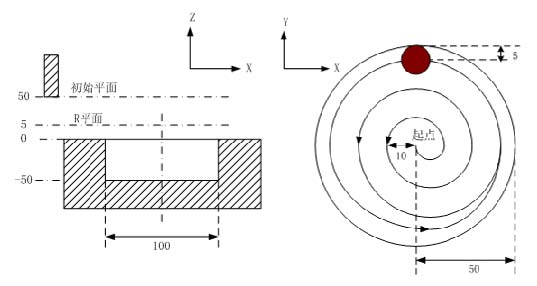
[picture p74: figure]

- 66 -

G90 G00 X50 Y50 Z50；（G00 快速定位）
G99 G110 X25 Y25 R5 Z-50 I50 W20 Q10 K10 E0 V10 F800 D1 ；（进行圆内凹槽粗铣 循环 D1=5）
G80 X50 Y50 Z50； （取消固定循环，从R 点平面返回）
M30；

（48）全圆内精铣循环 G112/G113

指令格式：G99 G112/G113 X_ Y_ R_ Z_ I_ J_ D_ F_ 指令功能：刀具以指定的半径值I 及方向在圆内部精铣一个整圆，精铣完成后返 回。
指令说明：相关指令请参照表3-2 固定循环的指令说明。G112 ：逆时针方向全圆 内精铣循环。G113 ：顺时针方向全圆内精铣循环。
I：精铣圆半径，取值范围-99999999～99999999×最小指令单位，当为 负值时取其绝对值。
J：精铣起点与精铣圆圆心的距离，取值范围J≦I-刀具半径值，当为负 值时取其绝对值。
D：刀具序号，取值范围为1 ~ 32，D0 默认为0。根据给定的序号取出当前刀具半 径。循环过程：⑴ 快速定位到XY 平面的位置；
⑵ 快速下至R 点平面；
⑶ 切削进给至孔底；
⑷ 以过渡弧1 为轨迹进行圆弧插补；
⑸ 以弧2，弧3 为轨迹进行整圆插补；
⑹ 以过渡弧4 为轨迹进行圆弧插补回到起点；
⑺ 固定返回R点；指令轨迹：

- numerical control system -
- 66 -

G90 G00 X50 Y50 Z50; (G00 Quick Positioning)
G99 G110 X25 Y25 R5 Z-50 I50 W20 Q10 K10 E0 V10 F800 D1; (perform rough milling cycle for circular internal groove D1=5)
G80 X50 Y50 Z50; (Remove fixed cycle and return from the R-point plane)
M30；
（48） Full Circle Internal Precision Milling Cycle G112/G113 Instruction format: G99 G112/G113 X_Y_R_Z_I_J_D_F_
Instruction function: The tool precision milling a whole circle inside the circle with the specified radius value I and direction, and returns after precision milling.
Instruction Description: Refer to Table 3-2 for instructions of fixed cycles. G112: Full circle internal precision milling cycle in counterclockwise direction. G113: Full circle internal precision milling cycle in clockwise direction.
I: Precision milling radius, the value range is-99999999~ 99999999× minimum instruction unit, when it is negative, take its absolute value.
J: The distance between the starting point of precision milling and the center of precision milling circle. The value range is J≤I-tool radius value. When it is negative, its absolute value should be taken. D: Tool serial number, the value range is 1 ~ 32, D0 is default 0. According to the given serial number, the current tool radius is obtained. The cycle process: ⑴ Quick positioning to the XY plane position;
⑵ Quickly descend to the plane of point R;
⑶ Cutting feed to the bottom of the hole;
⑷ Arc interpolation is performed with transition arc 1 as the trajectory; ⑸ Use arc 2 and arc 3 as the trajectory for full circle interpolation;
⑹ Use transition arc 4 as the trajectory to interpolate back to the starting point;
⑺ Fixed return to point R; Instruction trajectory:

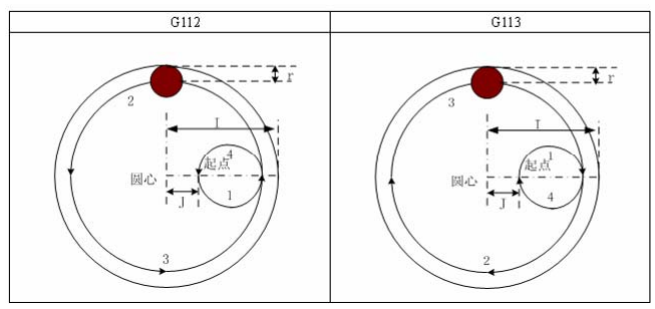
[picture p75: figure]
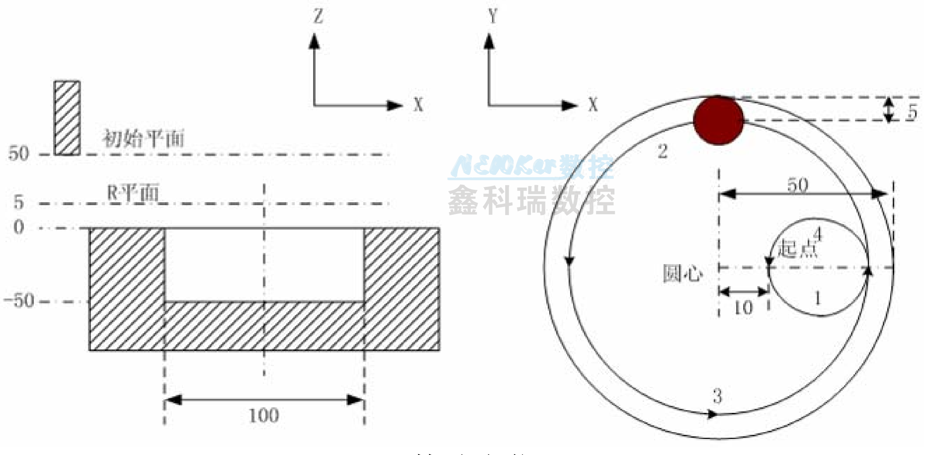
[picture p76: figure]

- 67 -

相关说明：
该循环下指令Q、P、L无效，但会保留Q，P的值作为固定循环模态数值保存。 例：用固定循环G112 指令，精铣如下图所示的已粗铣完的圆凹槽。

G90 G00 X50 Y50 Z50；（G00 快速定位）
G99 G112 X25 Y25 R5 Z-50 I50 J10 F800 D1 ；（开始固定循环，下到孔底进行圆内 精铣循环D1=5）
G80 X50 Y50 Z50； （取消固定循环，从R 点平面返回）
M30；

（49）外圆精铣循环G114/G115

指令格式： G99 G114/G115 X_ Y_ R_ Z_ I_ J_ D_ F_ 指令功能：刀具以指定的半径值及方向在圆外精铣一个整圆，精铣完成后返回。 指令说明：相关指令请参照表3-2 固定循环的指令说明。G114 ：逆时针外圆精铣 循环。G115 ：顺时针外圆精铣循环。
I：精铣圆半径，取值范围-99999999～99999999×最小指令单位，当为负值时取

- numerical control system -

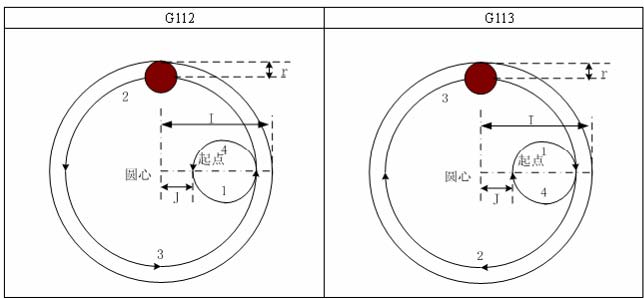
[picture p77: figure]
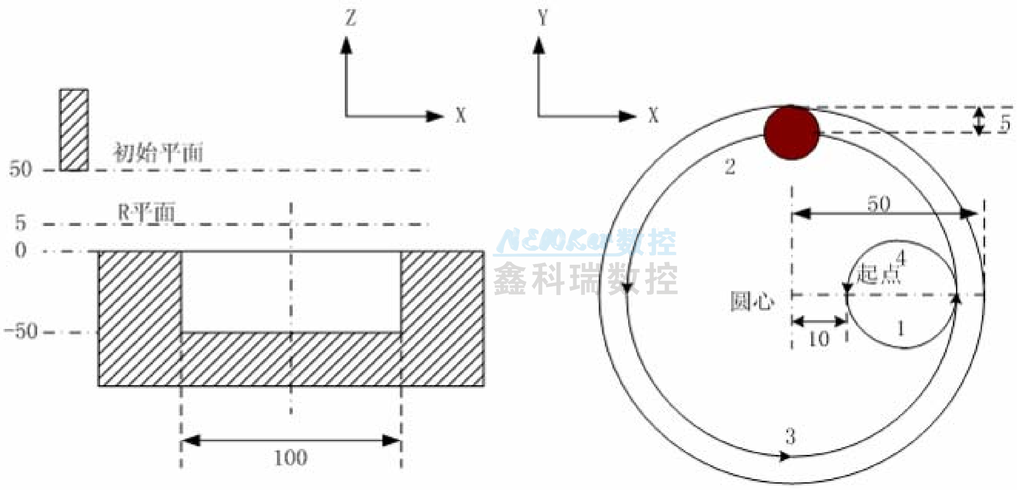
[picture p78: figure]

- 67 -

Related notes:
In this cycle, the instructions Q, P, and L are invalid, but the values of Q and P are retained as fixed cycle mode values. Example: Use the fixed cycle G112 instruction to finish milling the rough-milled circular groove as shown in the figure below.

G90 G00 X50 Y50 Z50; (G00 Quick Positioning)
G99 G112 X25 Y25 R5 Z-50 I50 J10 F800 D1; (Start the fixed cycle, go down to the bottom of the hole for the inner circular precision milling cycle D1=5)
G80 X50 Y50 Z50; (Remove fixed cycle and return from the R-point plane)
M30；
（49） External Cylindrical Milling Cycle G114/G115
Instruction format: G99 G114/G115 X_Y_R_Z_I_J_D_F_
Instruction function: The tool will finish milling a whole circle outside the circle with the specified radius value and direction, and return after finishing milling.
Instruction Description: Refer to Table 3-2 for instructions of fixed cycles. G114: Counter clockwise external circle precision milling cycle. G115: clockwise external circle precision milling cycle. I: Precision milling radius, the value range is-99999999~99999999× minimum instruction unit, when the value is negative, it is taken

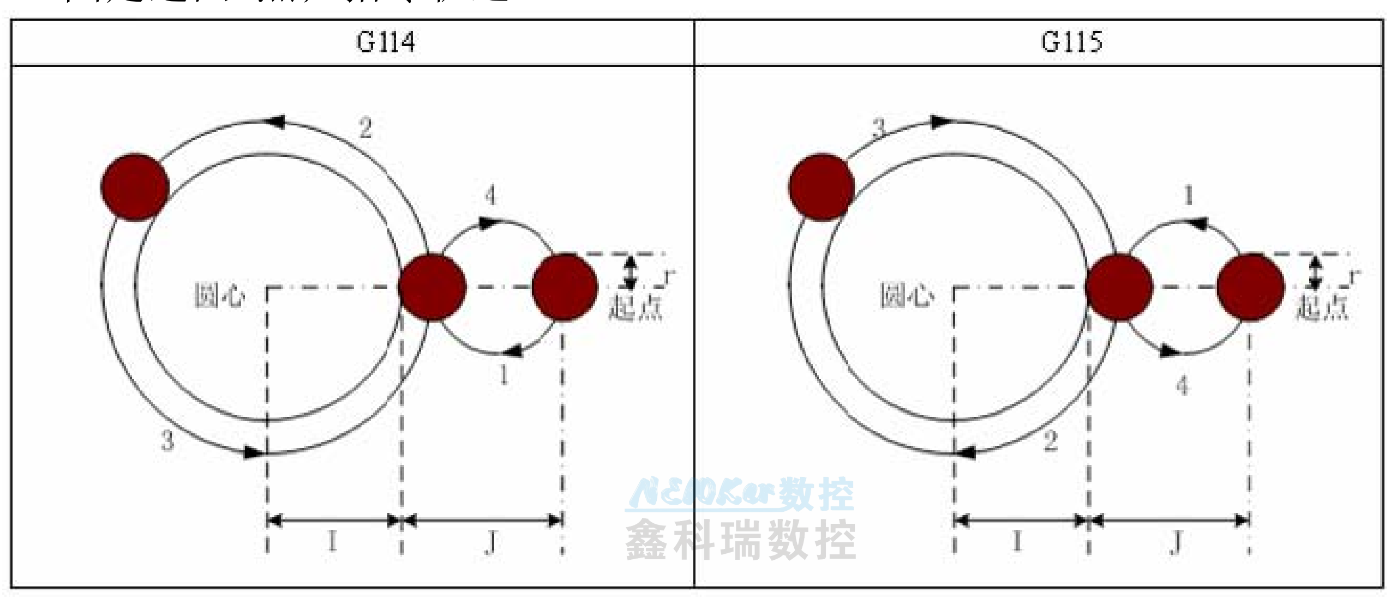
[picture p79: figure]

- 68 -

其绝对值。
J：精铣起点与精铣圆的距离，取值范围-99999999～99999999×最小指令单位， 且J≥D（刀具半径），当为负值时取其绝对值。
D：刀具半径序号，取值范围为0 ~ 32，D0 默认为0。根据给定的序号取出当前刀 具半径值。循环过程：⑴ 快速定位到XY 平面的位置；
⑵ 快速下至R 点平面；
⑶ 切削进给至孔底；
⑷ 以过渡弧1 为轨迹进行圆弧插补；
⑸ 以弧2，弧3 为轨迹进行整圆插补；
⑹ 以过渡弧4 为轨迹进行圆弧插补回到起点；
⑺ 固定返回R点；指令轨迹：

相关说明：
⑴ 外圆精铣时，过渡弧与精铣弧的插补方向不一致，指令说明中的插补方向指 精铣弧的插补方向。
⑵ 该循环下指令Q、P、L无效，但会保留Q，P的值作为固定循环模态数值保存。 例：用固定循环G114 指令，精铣如下图所示的已粗铣完的圆凸台。

- numerical control system -

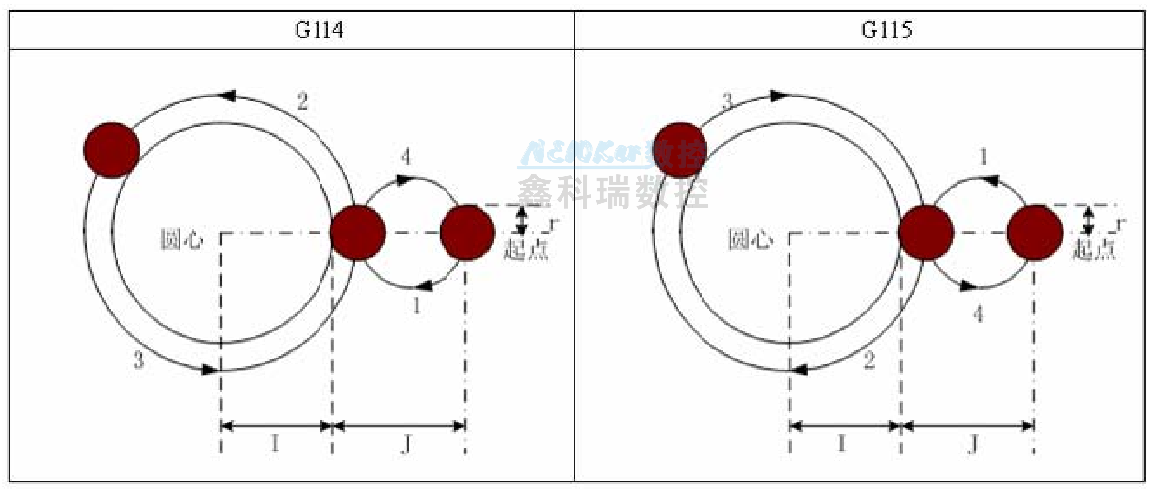
[picture p80: figure]

- 68 -

Its absolute value.
J: The distance between the starting point of precision milling and the precision milling circle, the value range is-99999999~99999999× minimum instruction unit, and J≥D (tool radius), when it is negative, take its absolute value.
D: Tool radius sequence number, the value range is 0 ~ 32, D0 is default
0. The current tool radius value is obtained according to the given sequence number. The cycle process: ⑴ Quick positioning to the XY plane position;
⑵ Quickly descend to the plane of point R;
⑶ Cutting feed to the bottom of the hole;
⑷ Arc interpolation is performed with transition arc 1 as the trajectory; ⑸ Use arc 2 and arc 3 as the trajectory for full circle interpolation;
⑹ Use transition arc 4 as the trajectory to interpolate back to the starting point;
⑺ Fixed return to point R; Instruction trajectory:

Related notes:
⑴ During external circle precision milling, the direction of interpolation between transition arc and precision arc is not consistent. The direction of interpolation in the instruction specification refers to the direction of interpolation of precision arc.
⑵ In this cycle, the instructions Q, P, and L are invalid, but the values of Q and P are retained as fixed cycle mode values. Example: Use the fixed cycle G114 instruction to finish milling the rough-milled circular boss as shown in the figure below.

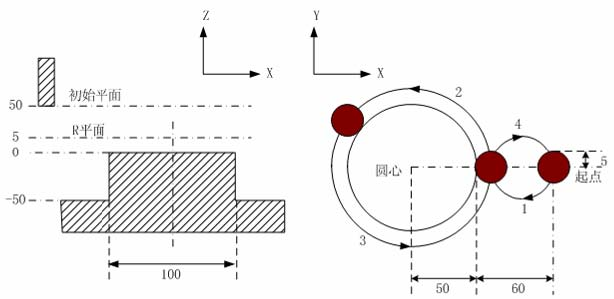
[picture p81: figure]

- 69 -

G90 G00 X50 Y50 Z50；（G00 快速定位）
G99 G114 X25 Y25 R5 Z-50 I50 J60 F800 D1 ；（开始固定循环，下到孔底进行外圆 精铣循环 D1=5）
G80 X50 Y50 Z50； （取消固定循环，从R 点平面返回）M30；

(50)外圆粗铣循环G116/G117

指令格式： G99 G116/G117 X_ Y_ Z_ R_ I _ J_ W_ Q_ K_ C_E_ D_F_ 指令功能：由起点开始，刀具以指定的半径值及方向进行全圆插补，直至加工出 编程尺寸的圆凸台。
指令说明：相关指令请参照表3-2固定循环的指令说明。 G116：逆时针外圆粗 铣 G117：顺时针外圆粗铣
I：外粗铣圆半径（应大于0,负数取绝对值）
J：毛坯工件半径（应大于0,负数取绝对值）
E：外圆粗铣在XY平面的余量（大于等于0,负数取绝对值）； W：Z轴方向首次切深，是从R基准面向下的距离，应大于0,负数取绝对值（若首 次切深超过槽底位置，则直接以槽底位置加工）
Q：Z轴方向每次的切深增量 ,负数取绝对值
K：在XY面内切削的宽度增量（应小于刀具直径，大于0,负数取绝对值，如果没 指定K，则默认K =刀具半径D）
C：X方向首次进刀切屑量（C值应大于等于刀具半径+2.0，大于0时，X轴往正方 向进刀，工件在起点正方向处。小于0时，X轴往负方向进刀，工件在起点负方向 处，）
D:刀具半径序号，取值范围为0~32，D0默认0.根据给定的序号取出当前刀具半径 值
循环过程：(1）快速定位到起点XY平面位置

- numerical control sys -
tem -
- 69 -

G90 G00 X50 Y50 Z50; (G00 Quick Positioning)
G99 G114 X25 Y25 R5 Z-50 I50 J60 F800 D1; (Start the fixed cycle, go down to the bottom of the hole for the outer circle precision milling cycle D1=5)
G80 X50 Y50 Z50; (Remove the fixed cycle and return from the R-point plane) M30;
(50) Outer Circle Rough Milling Cycle G116/G117
Command format: G99 G116/G117 X_Y_Z_R_I _J_W_Q_K_C_E_D_F_ Instruction function: From the starting point, the tool will carry out full circle interpolation with a specified radius value and direction until the programming dimension of the circular boss is processed. Instruction: Refer to Table 3-2 for instructions of fixed cycle. G116: Counter clockwise outer circle rough
Milling G117: Circular rough milling clockwise
I: Outer rough milling radius (should be greater than 0, negative values take absolute value)
J: radius of the rough workpiece (should be greater than 0, negative values are taken as absolute values)
E: The allowance of the outer circle rough milling in the XY plane (greater than or equal to 0, the absolute value of a negative number); W: The first depth of cut in the Z direction is the distance from the R reference plane downward. It should be greater than 0, and the absolute value of a negative number (if the first depth of cut exceeds the bottom position of the groove, the groove bottom position shall be processed directly)
Q: The absolute value of the negative depth increment in the Z direction
K: The width increment of cutting in the XY plane (should be less than the tool diameter, greater than 0, the absolute value of a negative number, if K is not specified, K = tool radius D by default)
C: The amount of chips cut during the first X-direction feed (The value of C should be greater than or equal to the tool radius +2.0. When it is greater than 0, the X-axis feeds in the positive direction, and the workpiece is at the starting point in the positive direction. When it is less than 0, the X-axis feeds in the negative direction, and the workpiece is at the starting point in the negative direction.)
D: Tool radius serial number, the value range is 0~32, D0 is default 0. The current tool radius value is obtained according to the given serial number
Cycle process: (1) Quickly locate the starting XY plane position

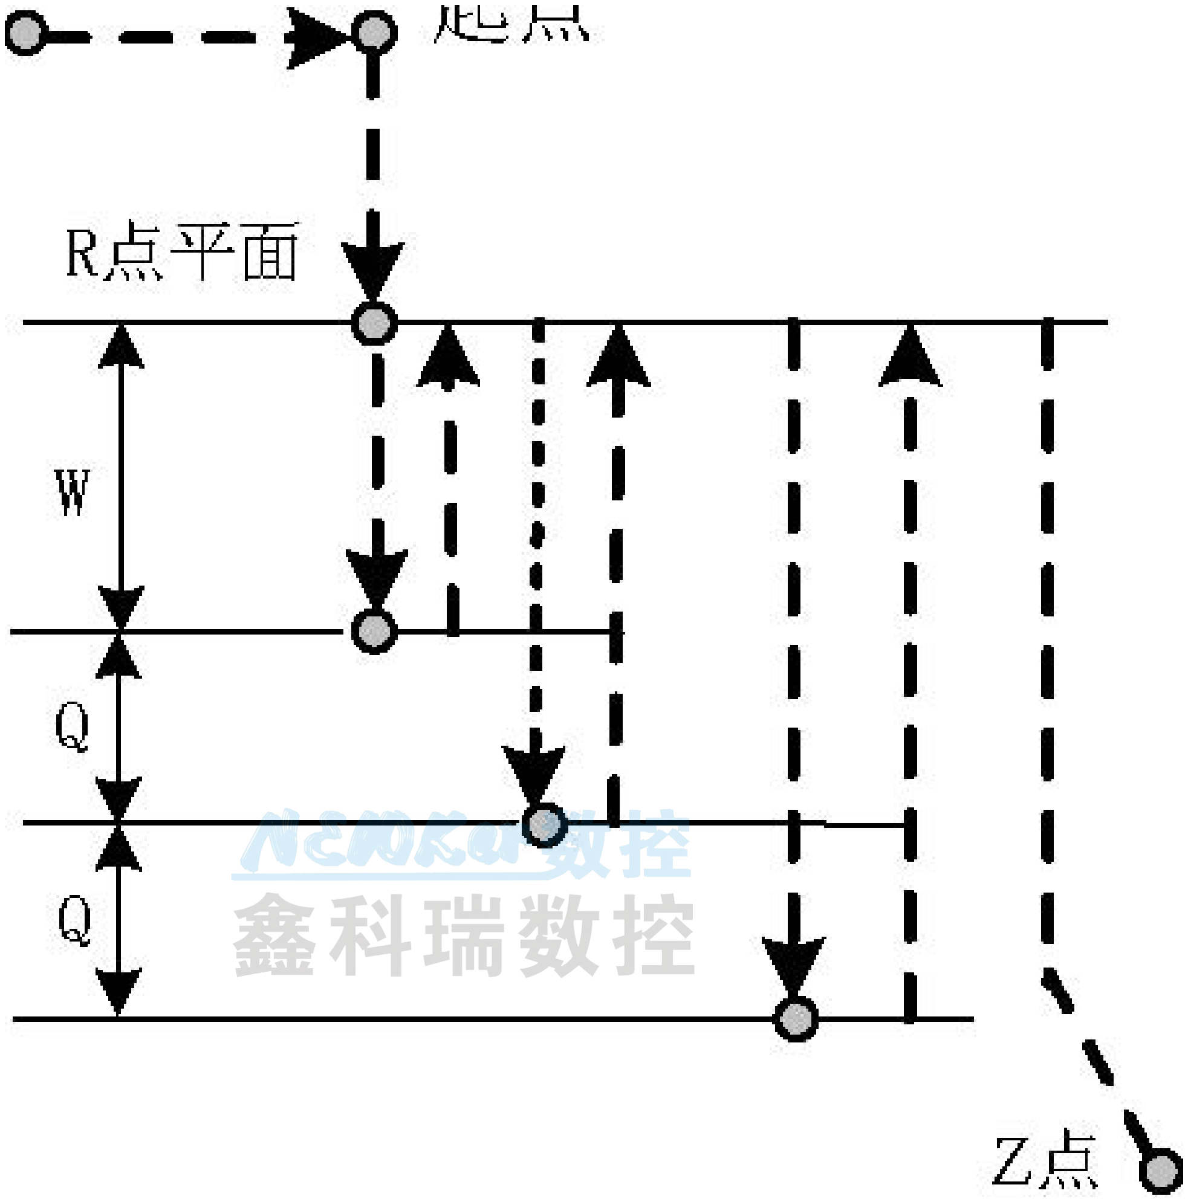
[picture p82: figure]
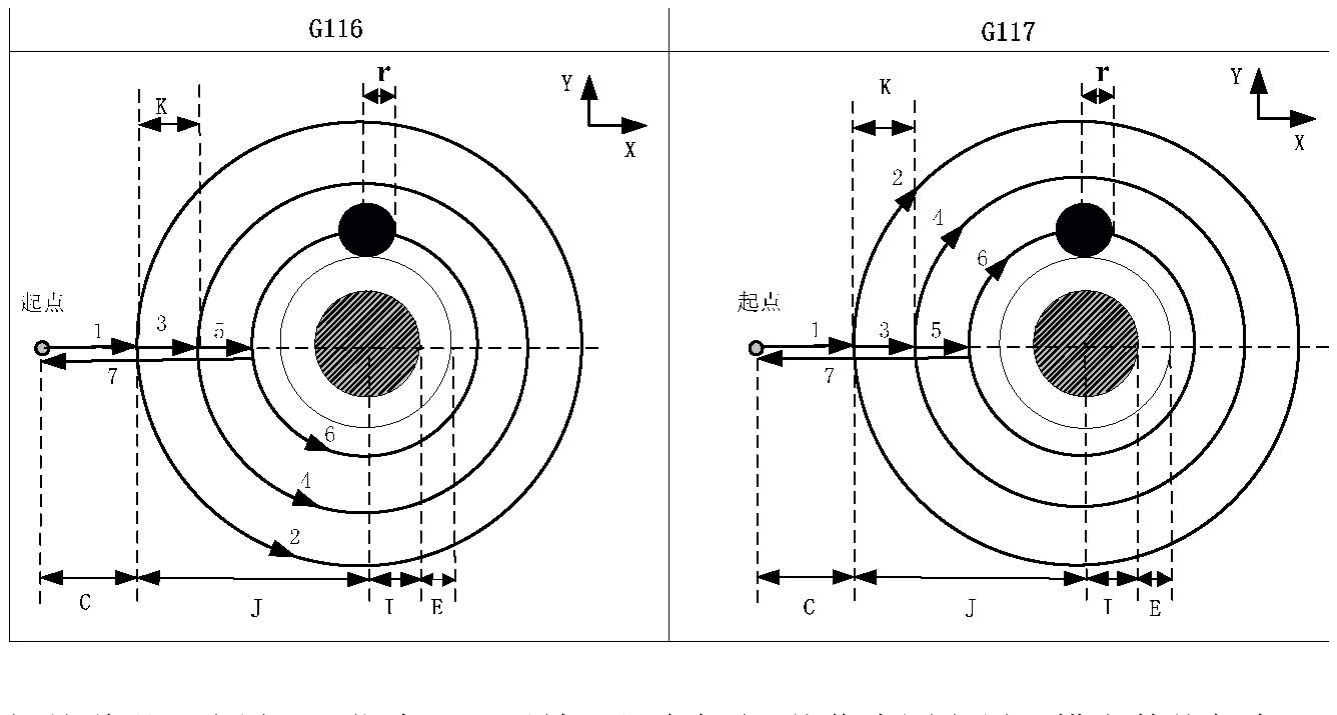
[picture p83: figure]

- 70 -

(2 )快速下至R点平面。
(3 )快速下至W距离深度
(4) 以X轴首次进刀量C，直线1为轨迹进行直线插补进刀
(5 )以圆弧2为轨迹进行整圆插补
(6 )由外向中心每次按K值递增铣完半径为（I+E）的圆面 (7)Z轴快速定位到 返回R基准面
(8 )快递定位到起点位置XY平面 (9)Z轴快速下至（未加工面+Q）的距离深度 (10 )循环5~9动作直到加工完总切深为Z的外圆粗铣圆面
(11 )固定返回R点；
(12 )返回XY起点位置

相关说明：该循环下指令P、L无效，但会保留P值作为固定循环模态数值保存。 例：用固定循环G117 指令粗铣一个圆凸台，如下图所示：

- numerical control system -

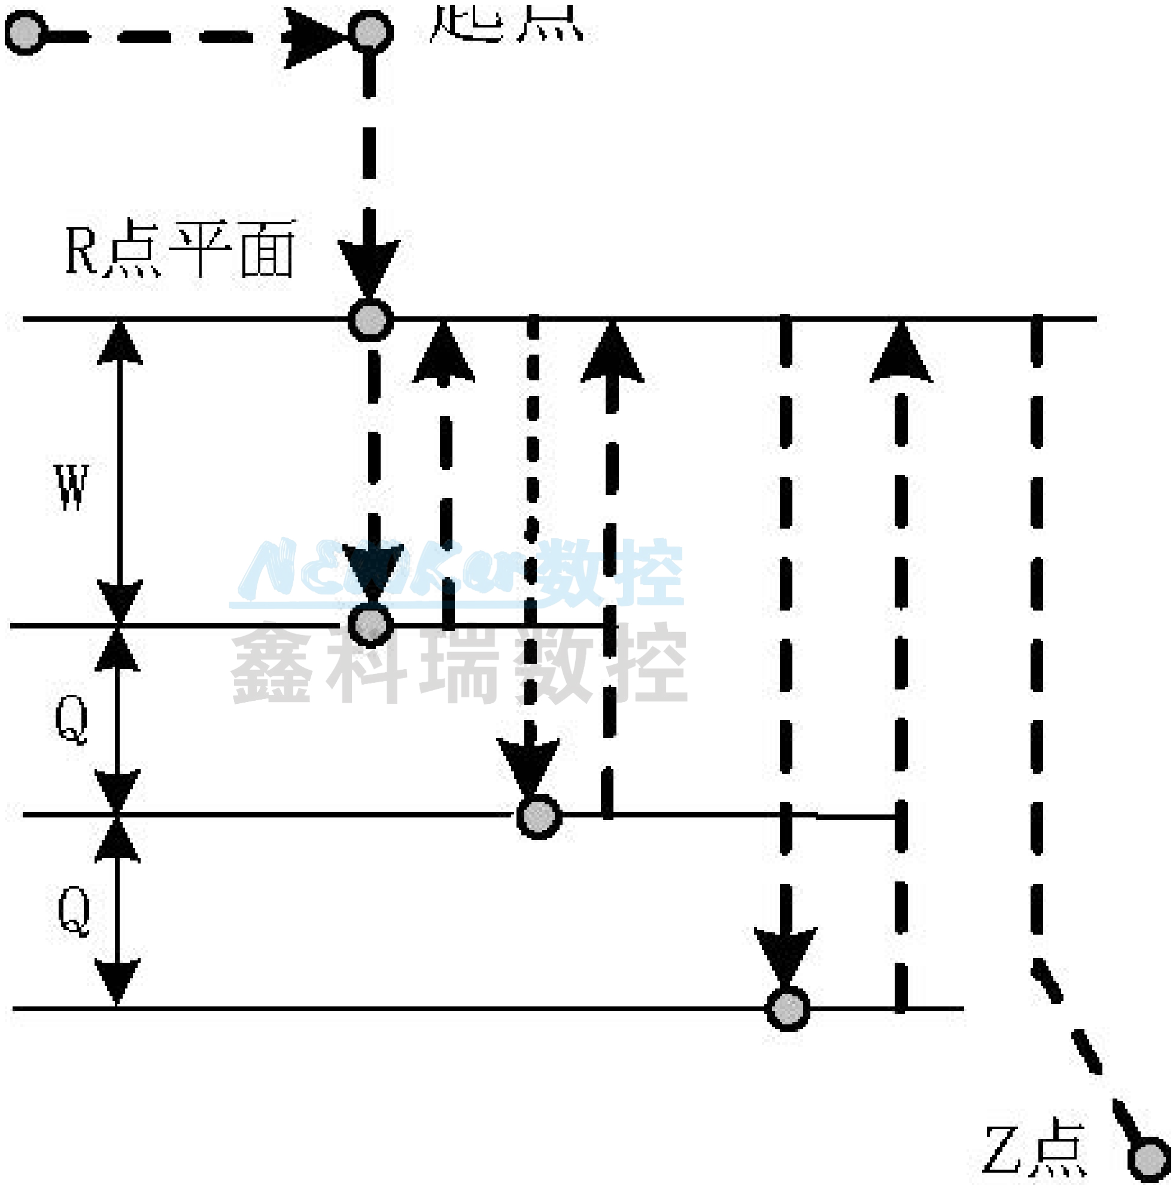
[picture p84: figure]
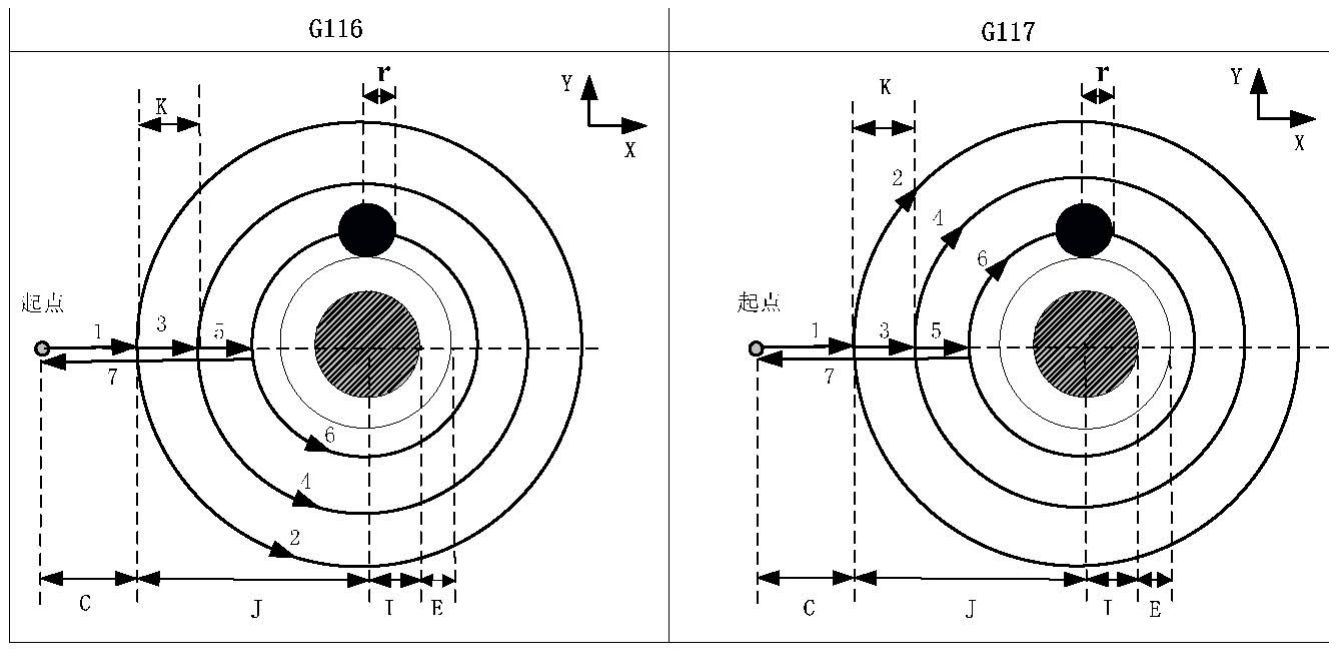
[picture p85: figure]

- 70 -

(2 ) Go Quickly to the R Plane.
(3 ) Go quickly to the depth of W distance
(4) Take the first feed amount C on the X axis as the trajectory of line 1 for linear interpolation
(5 ) The arc 2 is used as the trajectory for full circle interpolation
(6 ) From the outer to the center, each time the radius of the circle with K value increment is milled as (I+E) (7) The Z axis is quickly positioned to return to the R reference plane
(8 ) The delivery is positioned on the XY plane of the starting point
(9) and the distance depth of the Z axis is quickly lowered to (unprocessed surface +Q)
(10 ) Repeat steps 5 to 9 until the outer circular surface with total cutting depth Z is milled
(11 ) Fixed return to point R;
(12 ) Return to XY starting position

Related note: The instruction P and L are invalid under this cycle, but the value of P is retained as a fixed cycle mode value.
Example: Use the fixed cycle G117 command to rough mill a circular boss, as shown in the following figure:

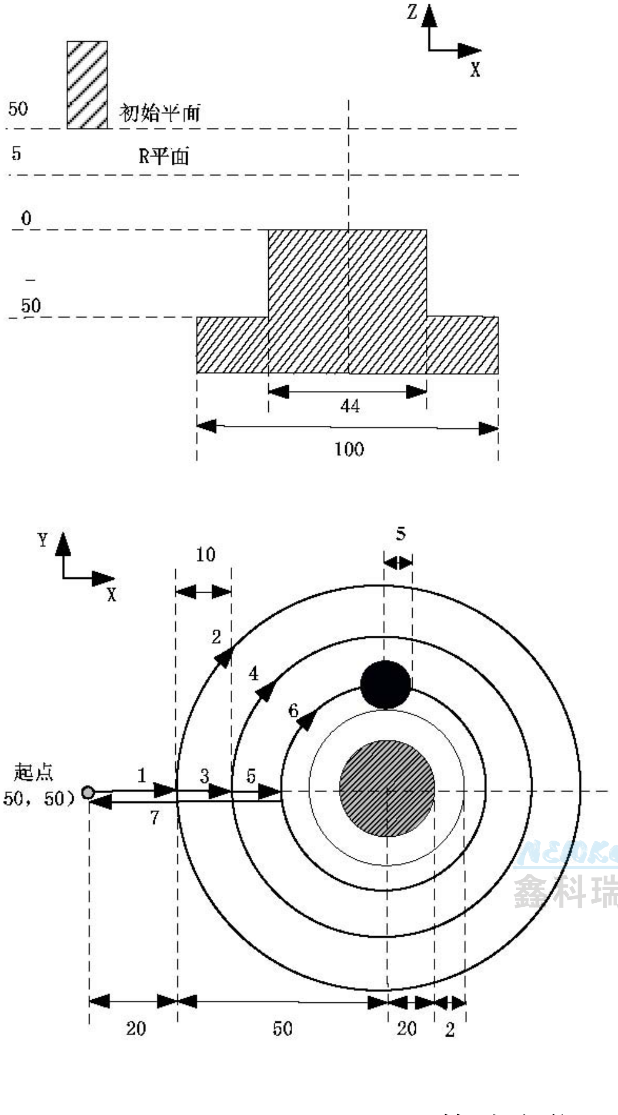
[picture p86: figure]

- 71 -

G90 G00 X0 Y0 Z50；（G00 快速定位）
G99 G117 X50 Y50 R5 Z-50 I20 J50 W20 Q10 K10 C20 E2 F800 D1； （进行外圆凸台 粗铣循环 D1=5）
G80 X50 Y50 Z50； （取消固定循环，从R 点平面返回）
M30；

(51)外矩形粗铣 G132/G133

指令格式：G99 G132/G133 X_ Y_ Z_ R_ I_ J_ A_B_ W_ Q_ K_ C_ E_ D_ F_ 指令功能：从起点开始，以指定的参数数据作直线切屑循环，直至加工出编程尺 寸的矩形凸台。
指令说明：相关指令请参照表3-2固定循环的指令说明。 G132：逆时针外矩形 粗铣 G133：顺时针外矩形粗铣 XY:下刀点的XY平面坐标位置 I：外粗铣矩形在X轴方向的宽度（应大于0,负数取绝对值）

- numerical control system -
- 71 -

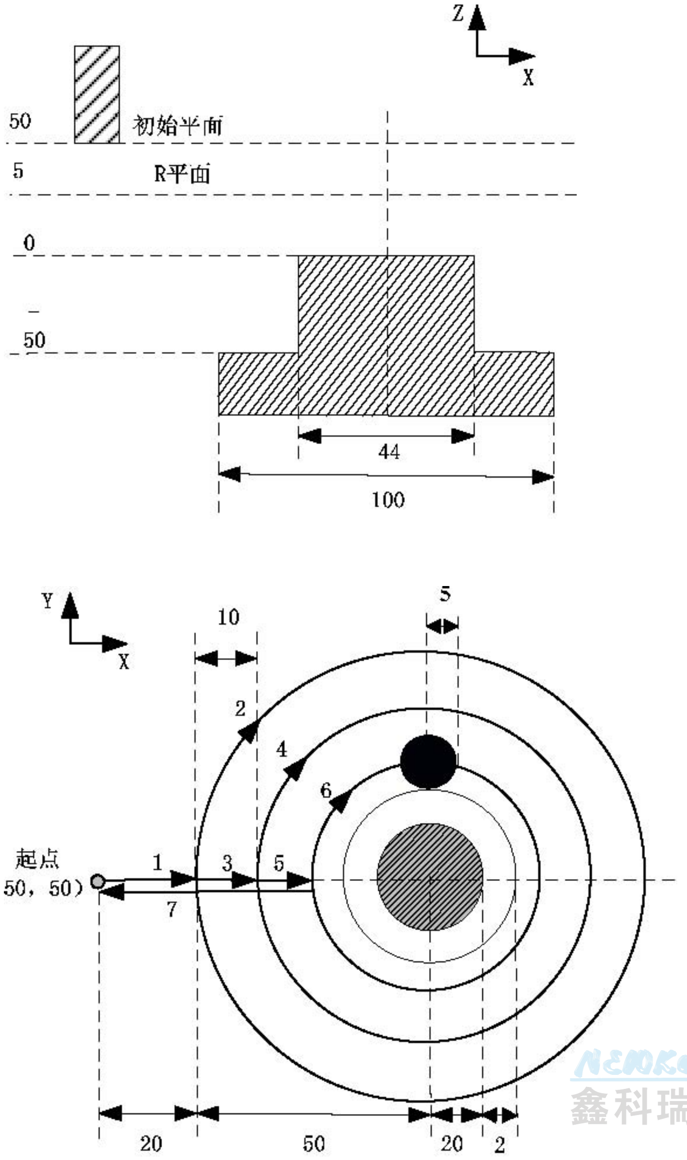
[picture p87: figure]

G90 G00 X0 Y0 Z50; (G00 quick positioning)
G99 G117 X50 Y50 R5 Z-50 I20 J50 W20 Q10 K10 C20 E2 F800 D1; (perform a rough milling cycle for the outer cylindrical boss D1=5)
G80 X50 Y50 Z50; (Remove fixed cycle and return from the R-point plane)
M30；
(51) External Rectangular Rough Milling G132/G133
Command format: G99 G132/G133 X_Y_Z_R_I_J_A_B_W_Q_K_C_E_D_F_ Instruction function: from the starting point, with the specified parameter data as a straight chip cycle, until the programming scale is processed
A Rectangular Protrusion an Inch in Size.
Instruction: Refer to the instruction for fixed cycle in Table 3-2 for relevant instructions. G132: counterclockwise outer rectangle
Coarse milling G133: clockwise outer rectangular coarse milling XY: XY plane coordinates of the lower cutting point
I: The width of the outer rough milling rectangle in the X-axis direction (should be greater than 0, and the absolute value of a negative number)

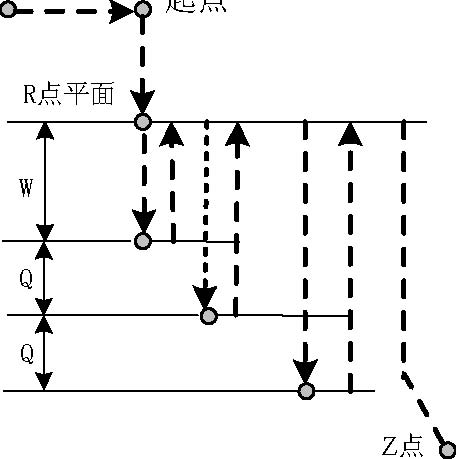
[picture p88: figure]

- 72 -

J：外粗铣矩形在Y轴方向的宽度（应大于0,负数取绝对值） A: 毛坯在X轴方向的宽度（应大于0,负数取绝对值） B：毛坯在Y轴方向的宽度（应大于0,负数取绝对值）
E：外矩形粗铣在XY平面的余量（应大于等于0,负数取绝对值); W：Z轴方向首次切深，是从R基准面向下的距离，应大于0,负数取绝对值（若首 次切深超过槽底位置，则直接以槽底位置加工）
Q：Z轴方向每次的切深增量 ,负数取绝对值
K：在XY面内切削的宽度增量，（应小于刀具直径，大于0,负数取绝对值，如果 没指定K，则默认K=刀具半径D）
C：X方向首次进刀切屑量（C值应大于等于刀具半径+2.0，大于0时，X轴往正方 向进刀，工件在起点正方向处。小于0时，X轴往负方向进刀，工件在起点负方向 处）
D:刀具半径序号，取值范围为1~32.根据给定的序号取出当前刀具半径值。 循环过程：（1）快速定位到XY平面起点位置
（2）快速下至R点平面
（3）首次快速下至W距离深度
（4）以X轴首次进刀量C，直线1为轨迹进行直线插补进刀 （5）以轨迹2进行直线插补
（6）由外向中心每次按K值递增铣完长为（I+2E）、宽为（J+2E）的矩形 （7）铣矩形的圆弧转角（8）Z轴快速返回R基准面（9）X轴、Y轴快递定位到起 点位置平面（10）Z轴快速下至（未加工面+Q）的距离深度 （11）循环4~9动作直到加工完总切深为Z的外粗铣矩形面 （12）固定返回R点
（13）返回XY起点位置

- numerical control system -
- 72 -

J: The width of the outer rough milling rectangle in the Y-axis direction (should be greater than 0, and the absolute value of a negative number) A: The width of the blank in the X direction (should be greater than 0, the absolute value of a negative number)
B: The width of the blank in the Y direction (should be greater than 0, the absolute value of a negative number)
E: The allowance of the outer rectangular rough milling in the XY plane (should be greater than or equal to 0, and the absolute value of a negative number);
W: The first depth of cut in the Z direction is the distance from the R reference plane downward. It should be greater than 0, and the absolute value of a negative number (if the first depth of cut exceeds the bottom position of the groove, it will be processed directly at the bottom position of the groove)
Q: The absolute value of the negative depth increment in the Z direction
K: The width increment of cutting in the XY plane (should be less than the tool diameter, greater than 0, and the absolute value of a negative number. If K is not specified, K= tool radius D by default)
C: The amount of chips cut during the first X-direction feed (The value of C should be greater than or equal to the tool radius + 2.0. When it is greater than 0, the X-axis feeds in the positive direction, and the workpiece is at the starting point in the positive direction. When it is less than 0, the X-axis feeds in the negative direction, and the workpiece is at the starting point in the negative direction)
D: Tool radius serial number, the value range is 1~32. According to the given serial number, the current tool radius value is obtained.
Cyclic process: (1) Quickly locate the starting position in XY plane
（2） Go quickly to the R plane
（3） Reach the depth of W distance for the first time quickly
（4） Take C as the first feed of the X-axis, and make linear interpolation for the straight path 1
（5） Straight interpolation is performed on trajectory 2
（6） From the outside to the center, each time a rectangle with length (I+2E) and width (J+2E) is milled according to the increasing K value （7） Machining the arc corner of the rectangle (8) Z-axis quick return to the R reference plane (9) X-axis and Y-axis quick positioning to the starting plane (10) Z-axis quick down to the distance depth of (unprocessed surface +Q)
（11） Repeat steps 4 to 9 until the outer rough milling of the rectangular surface with total depth Z is completed
（12） Fixed return to point R
（13） Return to XY starting position

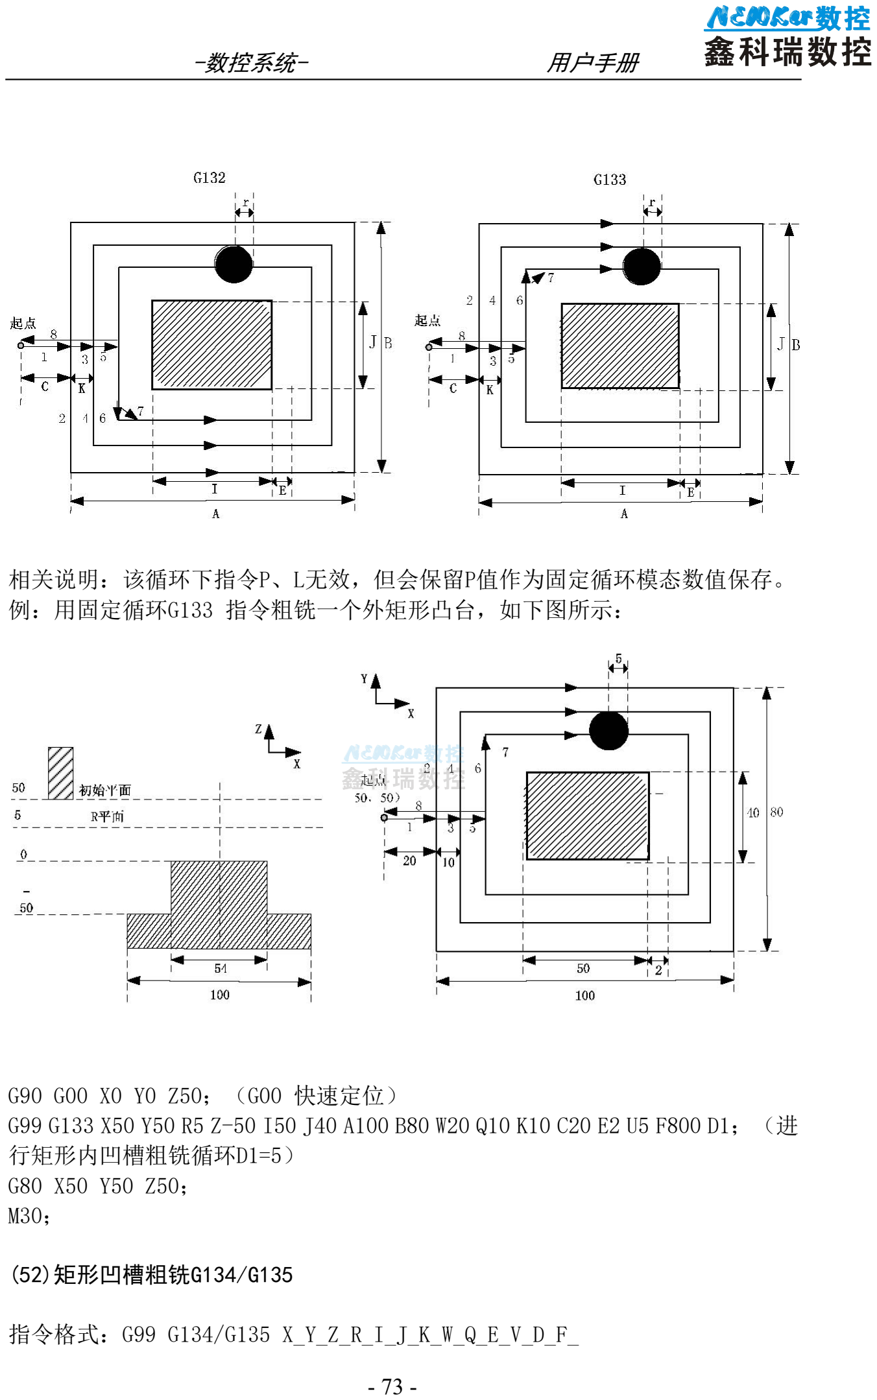
[picture p89: page 145]

- 73 -

相关说明：该循环下指令P、L无效，但会保留P值作为固定循环模态数值保存。 例：用固定循环G133 指令粗铣一个外矩形凸台，如下图所示：

G90 G00 X0 Y0 Z50；（G00 快速定位）
G99 G133 X50 Y50 R5 Z-50 I50 J40 A100 B80 W20 Q10 K10 C20 E2 U5 F800 D1；（进 行矩形内凹槽粗铣循环D1=5）
G80 X50 Y50 Z50；
M30；

(52)矩形凹槽粗铣G134/G135

指令格式：G99 G134/G135 X_Y_Z_R_I_J_K_W_Q_E_V_D_F_

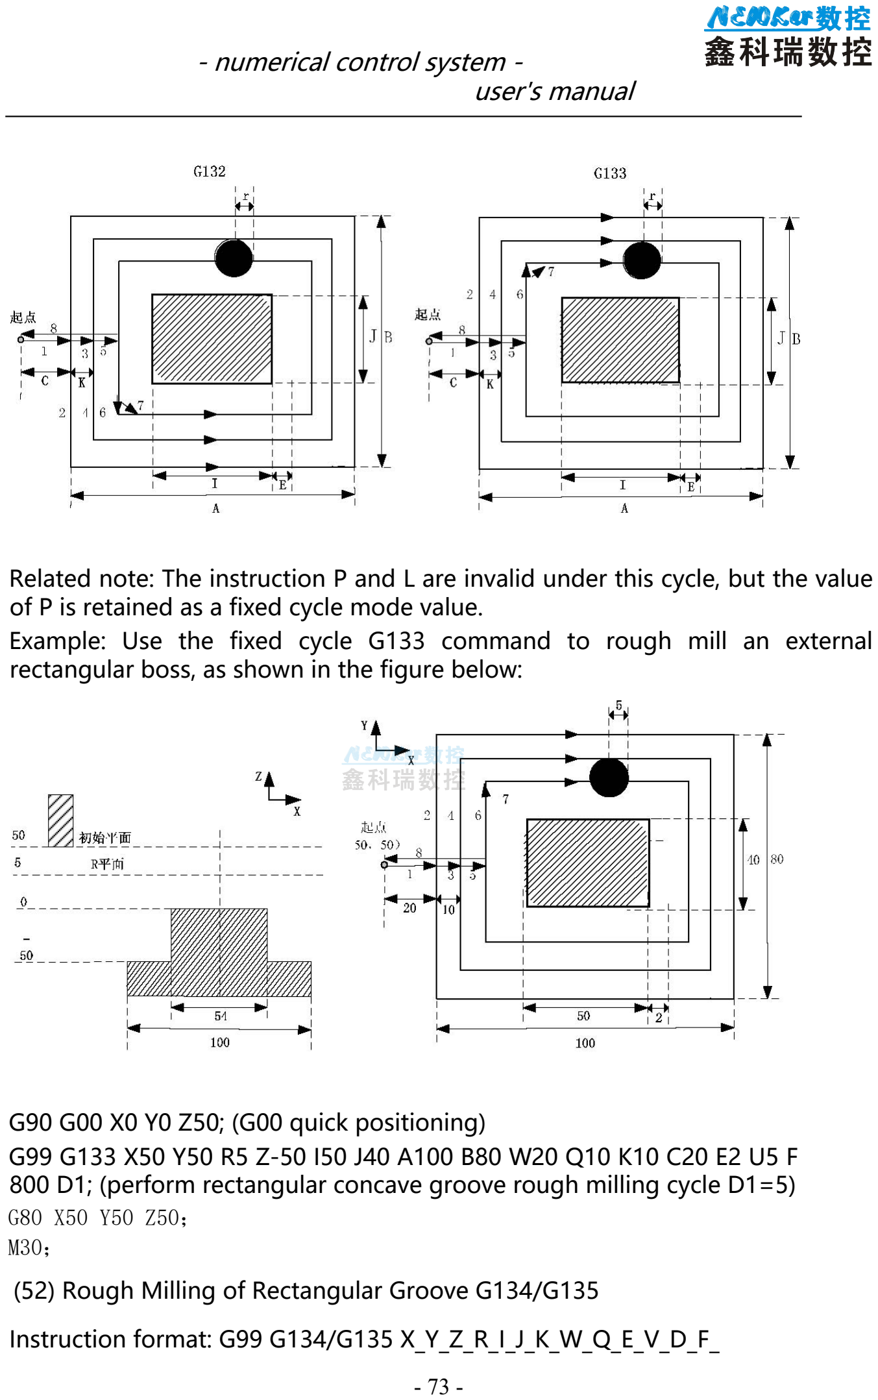
[picture p90: page 146]

- numerical control system -
- 73 -

Related note: The instruction P and L are invalid under this cycle, but the value of P is retained as a fixed cycle mode value.
Example: Use the fixed cycle G133 command to rough mill an external rectangular boss, as shown in the figure below:

G90 G00 X0 Y0 Z50; (G00 quick positioning)
G99 G133 X50 Y50 R5 Z-50 I50 J40 A100 B80 W20 Q10 K10 C20 E2 U5 F 800 D1; (perform rectangular concave groove rough milling cycle D1=5)
G80 X50 Y50 Z50；
M30；
(52) Rough Milling of Rectangular Groove G134/G135
Instruction format: G99 G134/G135 X_Y_Z_R_I_J_K_W_Q_E_V_D_F_

- 74 -

指令功能：从矩形中心开始，以指定的参数数据作直线切削循环，直至加工出编 程尺寸的矩形凹槽。
指令说明：相关指令请参照表3-2 固定循环的指令说明。G134 ：逆时针矩形凹槽 粗铣。G135 ：顺时针矩形凹槽粗铣。
I：矩形凹槽在X 轴方向的宽度。
J：矩形凹槽在Y 轴方向的宽度。
K：在XY 面内切削的宽度增量，应小于刀具直径，大于0。
W：Z 轴方向首次切深，是从R 基准面向下的距离，应大于0（若首次切深超过槽底 位置，则直接以槽底位置加工）。
Q：Z 轴方向每次的切深增量。
V：快速下刀时，离末加工面的距离，大于0。
E：矩形凹槽粗铣在XY 平面的余量（应大于等于0,负数取绝对值，不指定时取数 据参数5124 所设定的数值）。
D：刀具半径序号，取值范围为0 ~ 32，D0 默认为0。根据给定的序号取出当前刀 具半径值。
循环过程：⑴ 快速定位到XY 平面的位置；
⑵ 快速下至R 点平面；
⑶ ⑷ ⑸ ⑹ ⑺ ⑻ ⑼ ⑽
⑾ 指令轨迹：
以切削速度向下切削W 距离深度；中心向外每次按K 值递增螺旋铣完矩形面；Z 轴快速返回R 基准面；X，Y 轴快速定位到矩形中心；Z 轴快速下降至离末加工面 V 的距离；Z 轴向下切削（Q+V）的深度；循环（4）~（8）的动作，直至加工完 总切深的圆面；固定返回R点返回XY 孔定位位置。

- numerical control system -
- 74 -

Instruction function: Start from the center of the rectangle, make a straight cutting cycle with the specified parameter data, until the programming size of the rectangular groove is processed.
Instruction Description: Refer to Table 3-2 for instructions of fixed cycles. G134: Rough milling of counterclockwise rectangular groove. G 135: Rough milling of clockwise rectangular groove.
I: The width of the rectangular groove in the X direction.
J: The width of the rectangular groove in the Y direction.
K: The width increment of cutting in XY plane should be less than the diameter of the tool and greater than 0.
W: The first depth of cut in the Z direction is the distance from the R reference plane downward, which should be greater than 0 (if the first depth of cut exceeds the bottom position of the groove, the groove bottom position should be processed directly).
Q: The depth increment of each cut in the Z direction.
V: When the blade is cut quickly, the distance from the last processing surface is greater than 0.
E: The allowance of rough milling of rectangular groove in XY plane (it should be greater than or equal to 0, the absolute value of negative number, and the value set by data parameter 5124 is taken if not specified).
D: Tool radius serial number, the value range is 0 ~ 32, D0 is default 0. The current tool radius value is selected according to the given serial number.
Cycling process: ⑴ Quick positioning to the position in XY plane;
⑵ Quickly descend to the plane of point R;
⑶ ⑷ ⑸ ⑹ ⑺ ⑻ ⑼ ⑽
⑾ Instruction trajectory:
Perform the following operations: Start by cutting downward at W distance depth with the cutting speed. Center outward, complete each rectangular surface via spiral milling with K value increments. Quickly return to the R reference plane along the Z-axis. Rapidly position the X and Y axes to the rectangular center. Lower the Z-axis to the distance from the final processed surface V. Cut downward with Z-axis depth (Q+V). Repeat cycles (4) to (8) until completing the circular surface machining. Finally, return to the XY hole positioning point via fixed return to R point.

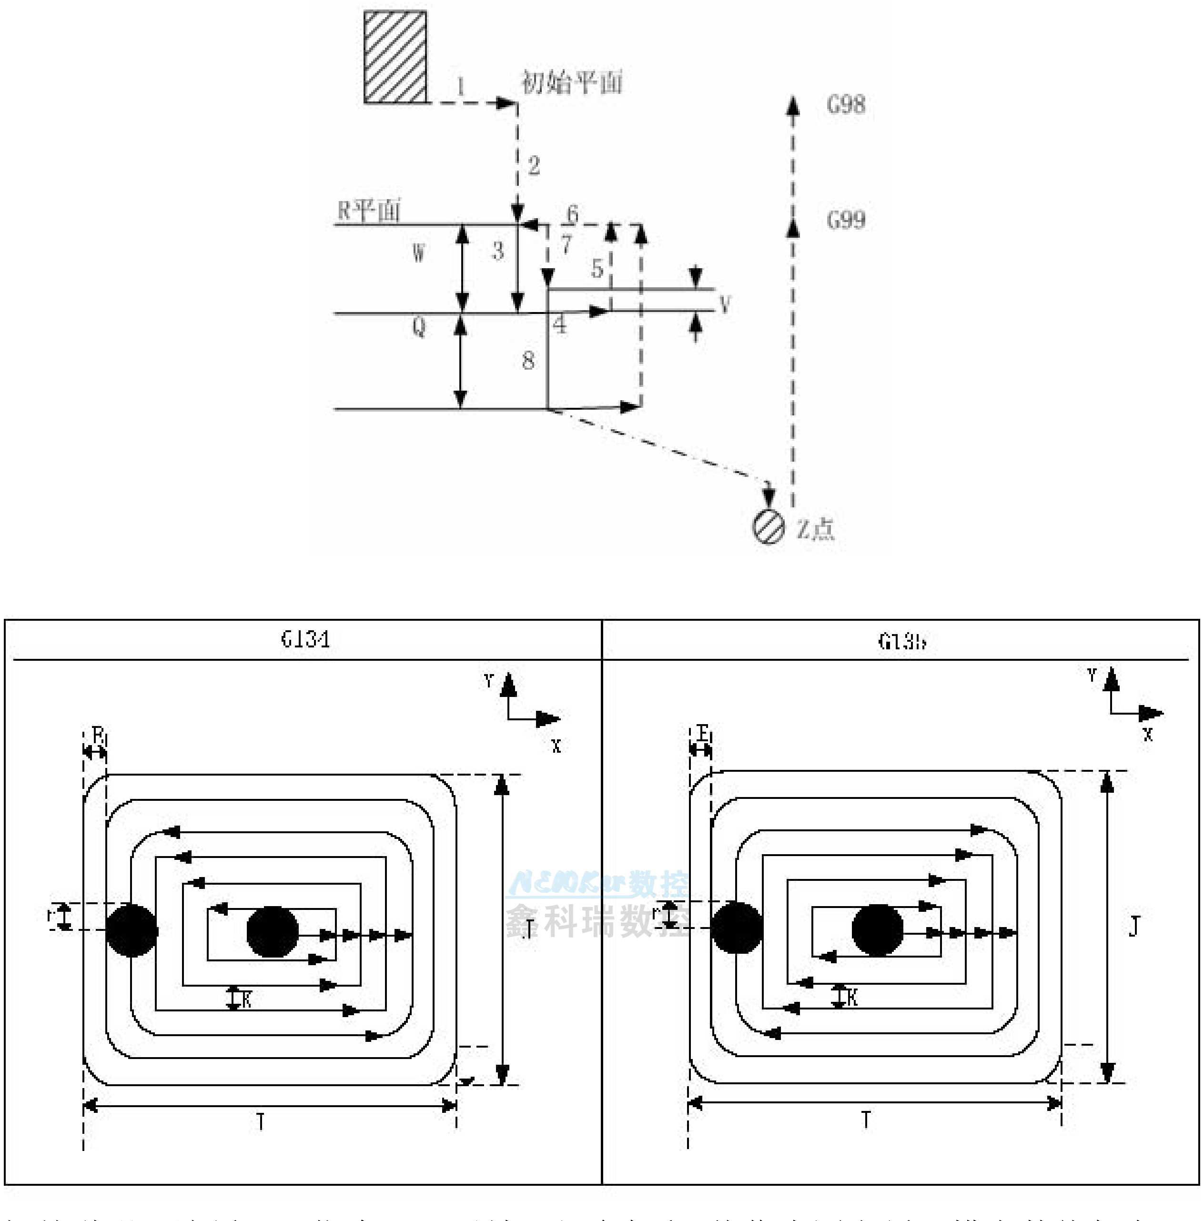
[picture p91: figure]

- 75 -

相关说明：该循环下指令P、L无效，但会保留P值作为固定循环模态数值保存。 例：用固定循环G134 指令粗铣一个矩形内凹槽，如下图所示：

- numerical control system -user's manual

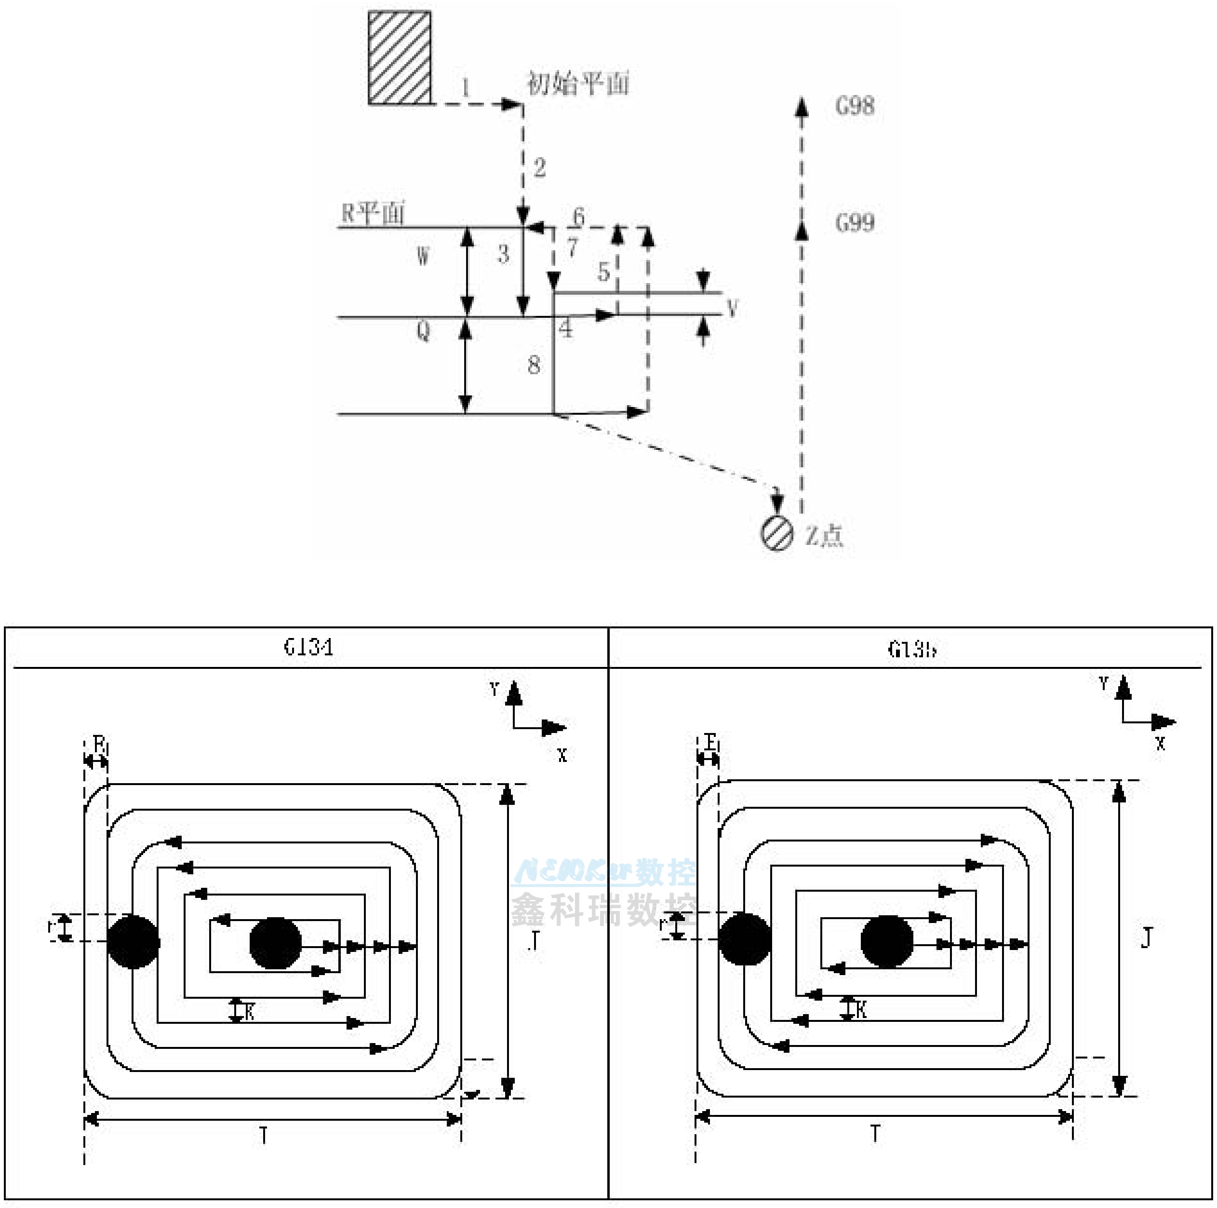
[picture p92: figure]

- 75 -

Related Note: The Instruction P and L Are Invalid Under This Cycle, but the Value of P Is Retained as a Fixed Cycle Mode Value.
Example: Use the fixed cycle G134 command to rough mill a rectangular recessed groove, as shown in the figure below:

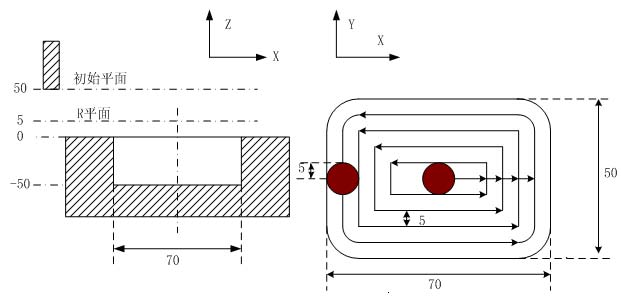
[picture p93: figure]

- 76 -

G90 G00 X50 Y50 Z50；（G00 快速定位）
G99 G134 X25 Y25 R5 Z-50 I70 J50 W20 Q10 K5 E0 V10 U10 F800 D1；（进行 矩形内凹槽粗铣循环D1=5）
G80 X50 Y50 Z50； （取消固定循环，从R 点平面返回）
M30；

(53)矩形凹槽内精铣循环G136/G137

指令格式：G99 G136/G137 X_ Y_ R_ Z_ I_ J_ D_ K_ U_ F_； 指令功能：刀具以指定的宽度及方向在矩形内部精铣，精铣完成后返回。 指令说明：相关指令请参照表3-2 固定循环的指令说明。G136 ：逆时针矩形凹槽 内精铣循环。G137 ：顺时针矩形凹槽内精铣循环。
I：矩形X 轴方向的宽度，取值范围-99999999～99999999×最小指令单 位。负数取其绝对值。
J：矩形Y 轴方向的宽度，取值范围-99999999～99999999×最小指令单位。负数 取其绝对值。J的取值必须大于或者等于刀具半径D 值，否则报警。 D：刀具半径序号，取值范围为0 ~ 32，D0 默认为0。根据给定的序号取出当前刀 具半径值。
K：精铣起点与矩形边X 轴方向的距离，取值范围-99999999～99999999×最小指 令单位。负数取其绝对值。
U：转角圆弧半径，省略则表示无转角圆弧过渡。U 省略或U=0 时且刀具半径>0， 则报警。循环过程：⑴快速定位到XY 平面的位置；
⑵ 快速下至R 点平面；
⑶ 切削进给至孔底；
⑷ 从起点以过渡弧1 为轨迹进行圆弧插补；
⑸ 以2-3 为轨迹进行直线和圆弧插补；
⑹ 以过渡弧4 为轨迹进行圆弧插补回到起点；
⑺ 固定返回R点

- numerical control sys -
tem -
- 76 -

G90 G00 X50 Y50 Z50; (G00 Quick Positioning)
G99 G134 X25 Y25 R5 Z-50 I70 J50 W20 Q10 K5 E0 V10 U10 F800 D1; (perform rough milling cycles for rectangular recessed grooves D1=5) G80 X50 Y50 Z50; (Remove fixed cycle and return from the R-point plane)
M30；
(53) Precision Milling Cycle G136/G137 in Rectangular Groove Instruction format: G99 G136/G137 X_Y_R_Z_I_J_D_K_U_F_;
Instruction function: The tool is precision-milled in the rectangle with the specified width and direction, and returns after precisionmilling.
Instruction Description: Refer to Table 3-2 for instructions of fixed cycles. G136: Precision milling cycle in the counterclockwise rectangular groove. G137: Precision milling cycle in the clockwise rectangular groove.
I: The width in the X-axis direction of the rectangle, with a range of-99999999 to 99999999× minimum instruction unit. The absolute value of negative numbers is taken.
J: The width in the rectangular Y-axis direction, with a range of -99999999 to 99999999× minimum instruction unit. Negative numbers are taken as absolute values. The value of J must be greater than or equal to the tool radius D value, otherwise an alarm will be triggered.
D: Tool radius serial number, the value range is 0 ~ 32, D0 is default 0. The current tool radius value is selected according to the given serial number.
K: The distance between the starting point of precision milling and the rectangular edge in the X-axis direction. The value ranges from -99999999 to 99999999× minimum instruction unit. The absolute value of a negative number is taken.
U: Corner arc radius. If omitted, it indicates no corner arc transition. When U is omitted or U=0 and the tool radius>0, an alarm will be triggered. The cycle process: ⑴ Quickly locate the position in the XY plane;
⑵ Quickly descend to the plane of point R;
⑶ Cutting feed to the bottom of the hole;
⑷ Arc interpolation is performed from the starting point along the transition arc 1;
⑸ Use 2-3 as the trajectory for straight line and arc interpolation;
⑹ Use transition arc 4 as the trajectory to interpolate back to the starting point;
⑺ Fixed return to point R

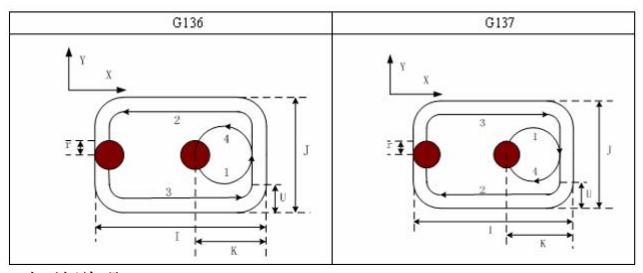
[picture p94: figure]
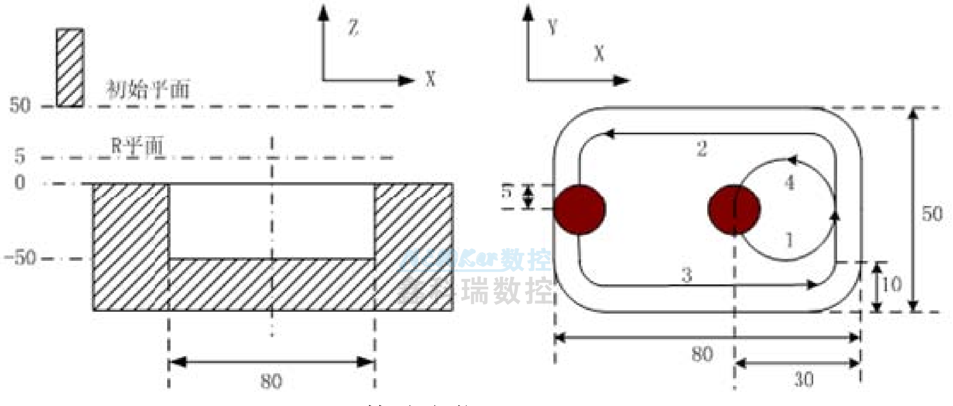
[picture p95: figure]

- 77 -

指令轨迹：相关说明：
该循环下指令Q、P、L无效，但会保留Q，P的值作为固定循环模态数值保存。 例：用固定循环G136 指令，精铣如下图所示的已粗铣完的矩形凹槽。

G90 G00 X50 Y50 Z50；（G00 快速定位）
G136 X25 Y25 R5 Z-50 I80 J50 K30 U10 F800 D1；（固定循环下到孔底进行矩 形凹槽内精铣D1=5）
G80 X50 Y50 Z50； （取消固定循环，从R 点平面返回）
M30；

(54)矩形外精铣循环G138/G139/G141/G142

指令格式: G99 G138/G139/G141/G142 X_ Y_ R_ Z_ I_ J_ D_ K_ U_ F_ 指令功能：刀具以指定的宽度及方向在矩形外部精铣，精铣完成后返回。 指令说明：相关指令请参照表3-2 固定循环的指令说明。 G138:逆时针矩形外精铣循环。
G139:顺时针矩形外精铣循环。
G141:横向长方形或正方形外精铣循环（I>J）。
G142:竖向长方形或正方形外精铣循环（I<J）。
I：矩形X 轴方向的宽度，取值范围-99999999～99999999×最小指令单位。负数

- numerical control sys -
tem -

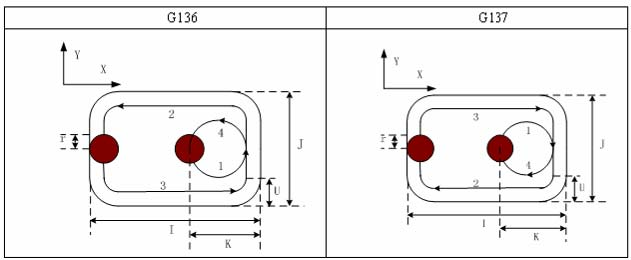
[picture p96: figure]
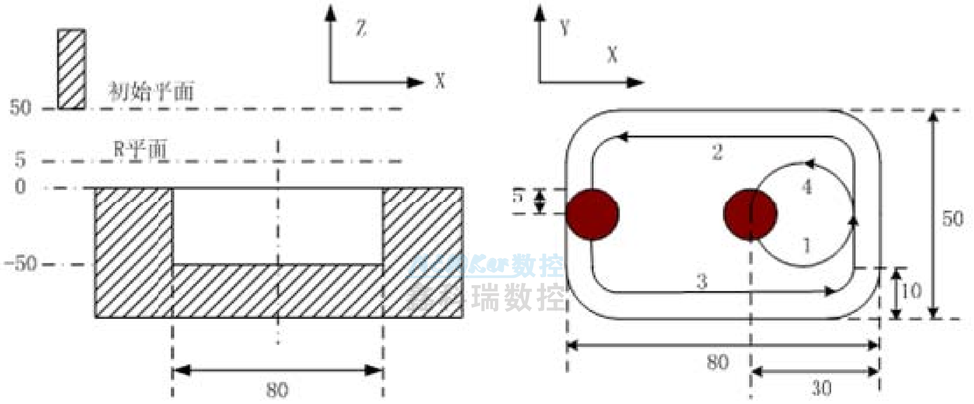
[picture p97: figure]

- 77 -

Instruction trajectory: Related description:
In this cycle, the instructions Q, P, and L are invalid, but the values of Q and P are retained as fixed cycle mode values. Example: Use the fixed cycle G136 instruction to finish milling the rough-milled rectangular groove shown in the figure below.

G90 G00 X50 Y50 Z50; (G00 Quick Positioning)
G136 X25 Y25 R5 Z-50 I80 J50 K30 U10 F800 D1; (fixed cycle to the bottom of the hole for precision milling in the rectangular groove D1=5) G80 X50 Y50 Z50; (Remove fixed cycle and return from the R-point plane)
M30；
(54) Rectangular outer milling cycles G138/G139/G141/G142 Instruction format: G99 G138/G139/G141/G142 X_Y_R_Z_I_J_D_K_U_F_ Instruction function: The tool is precision milled on the outside of the rectangle with the specified width and direction, and returns after the precision milling is completed.
Instruction: Refer to Table 3-2 for instructions of fixed cycles.
G138: counterclockwise rectangular outer milling cycle.
G139: clockwise rectangular outer milling cycle.
G141: Longitudinal rectangular or square outer milling cycle (I>J).
G142: Vertical rectangular or square outer milling cycle (I<J).
I: The width in the X-axis direction of the rectangle. The value ranges from-99999999 to 99999999× minimum instruction unit. Negative number

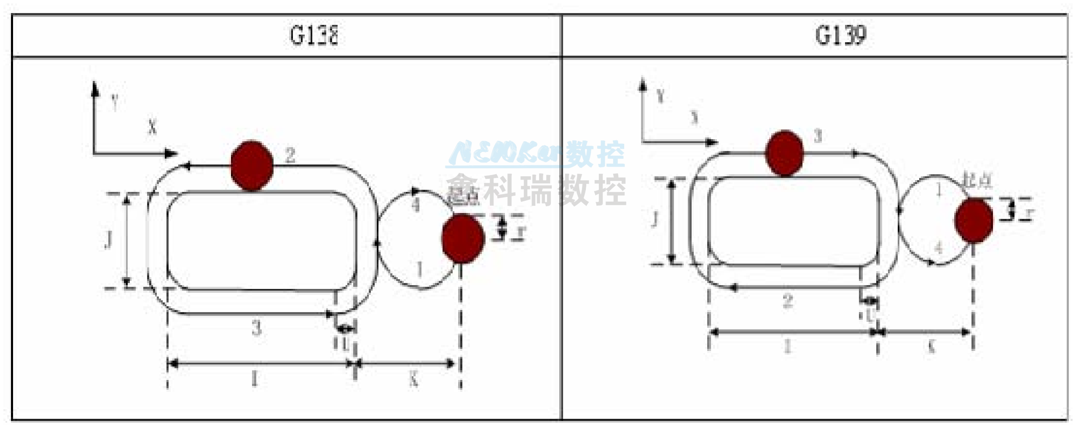
[picture p98: figure]

- 78 -

取其绝对值。
J：矩形Y 轴方向的宽度，取值范围-99999999～99999999×最小指令单位。负 数取其绝对值。
D：刀具半径序号，取值范围为0 ~ 32，D0 默认为0。根据给定的序号取出当前刀 具半径值。
K：精铣起点与矩形边X 轴方向的距离，取值范围-99999999～99999999×最小指 令单位。负数取其绝对值。
U：转角圆弧半径，省略则表示无转角圆弧过渡。循环过程：⑴ 快速定位到XY 平 面的位置；
⑵ 快速下至R 点平面；
⑶ 切削进给至孔底；
⑷ 从起点以过渡弧1 为轨迹进行圆弧插补；
⑸ 以2-3 为轨迹进行直线和圆弧插补；
⑹ 以过渡弧4 为轨迹进行圆弧插补回到起点；
⑺ 固定返回R点

相关说明：
⑴ 矩形外精铣时，过渡弧与精铣弧的插补方向不一致，指令说明中的插补方 向指精铣弧的插补方向。
⑵ 该循环下指令Q、P、L无效，但会保留Q，P的值作为固 定循环模态数值保存。例：用固定循环G138 指令，精铣如下图 所示的已粗铣完的矩形凸台。

- numerical control sys -
tem -

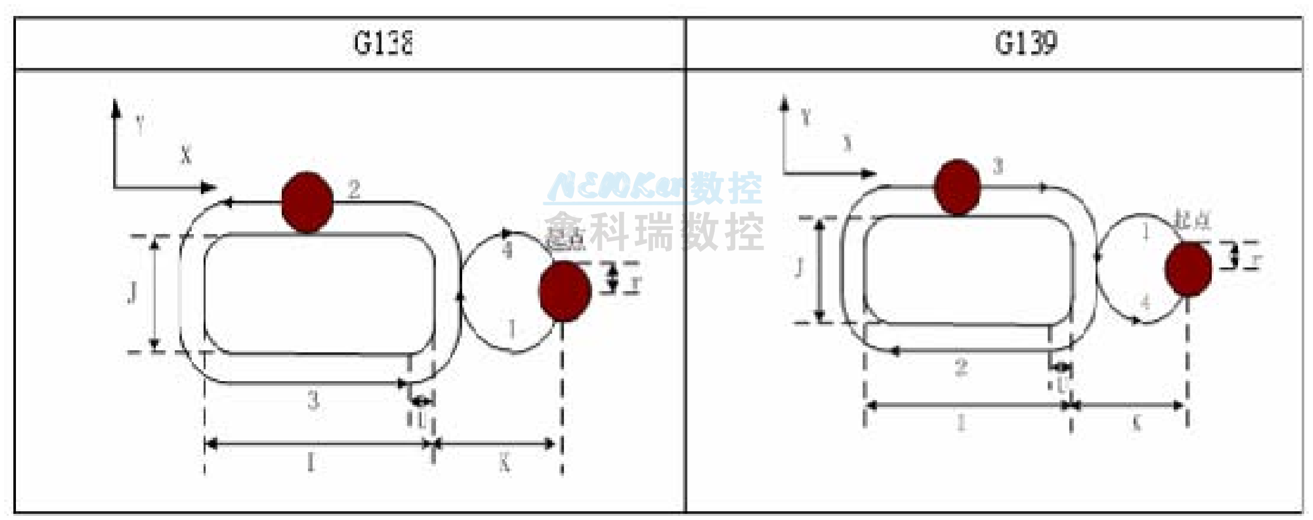
[picture p99: figure]

- 78 -

Take the absolute value.
J: The width in the rectangular Y-axis direction, with a range of -99999999 to 99999999× minimum instruction unit. Negative numbers are taken as their absolute values.
D: Tool radius serial number, the value range is 0 ~ 32, D0 is default 0. The current tool radius value is selected according to the given serial number.
K: The distance between the starting point of precision milling and the rectangular edge in the X-axis direction. The value ranges from -99999999 to 99999999× minimum instruction unit. For negative values, the absolute value is taken.
U: Angle radius of the arc, omitted to indicate no transition of the arc. Cycle process: ⑴ Quick positioning to the position in the XY plane;
⑵ Quickly descend to the plane of point R;
⑶ Cutting feed to the bottom of the hole;
⑷ Arc interpolation is performed from the starting point along the transition arc 1;
⑸ Use 2-3 as the trajectory for straight line and arc interpolation;
⑹ Use transition arc 4 as the trajectory to interpolate back to the starting point;
⑺ Fixed return to point R

Related notes:
⑴ When milling a rectangle outside, the direction of interpolation between the transition arc and the precision milling arc is not the same. The direction of interpolation in the instruction specification refers to the direction of interpolation between the precision milling arc.
⑵ In this cycle, the instructions Q, P, and L are
invalid, but the values of Q and P are retained as fixed
cycle mode values. Example: Use the fixed cycle G138 instruction to finish milling the rough-milled rectangular boss as shown in the figure below.

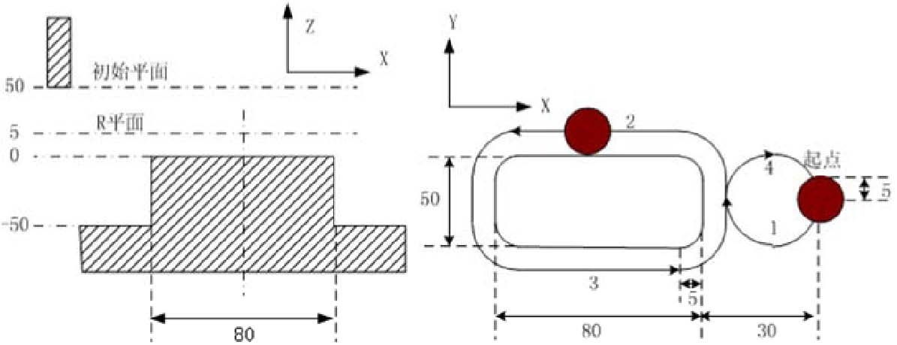
[picture p100: figure]

- 79 -

G90 G00 X50 Y50 Z50；（G00 快速定位）
G99 G138 X25 Y25 R5 Z-50 I80 J50 K30 U5 F800 D1；（固定循环下到孔底进行矩形 外精铣D1=5）
G80 X50 Y50 Z50； （取消固定循环，从R 点平面返回）
M30；
(55) 可编程数据输入指令 G10/G710

可编程数据输入指令，可以修改 G54-G59 工件坐标: G10 Lxx 开启可编程数据输入
Px Rxx 执行数据修改
Px Ixx 执行数据修改
X_Y_Z_A_ 设置指定工件坐标系的当前坐标值
G710 关闭可编程数据输入
说明：
G10 表开启可编程数据输入，为模态指令。
G710 表关闭可编程数据输入，为模态指令。
L 地址字指定修改数据的类型，54--59 分别对应 G54--G59 偏移量， 5401--5448 分别对应 G54.1--G54.48 偏移量，为模态指令。
P 地址字指定修改数据对应的进给轴，1--8 对应 8 个进给轴，为模态指令。 R 地址字指定修改的数据值，为绝对方式修改。
I 地址字指定修改的数据值，为增量方式修改。
例如：
G10 L55 | ;开启可编程数据输入，修改 G55 工件坐标系偏移量
P2 R6 | ;G55 的 Y 轴工件坐标系偏移量设为 6 mm
L56 X1Y2Z3 ;G56 的工件坐标设置为 X1Y2Z3
P1 I1.5 | ;G56 的 X 轴工件坐标系偏移量加上 1.5 mm
G710 | ;关闭可编程数据输入

- numerical control sys -
tem -
- 79 -

G90 G00 X50 Y50 Z50; (G00 Quick Positioning)
G99 G138 X25 Y25 R5 Z-50 I80 J50 K30 U5 F800 D1; (fixed cycle to the bottom of the hole for rectangular external milling D1=5)
G80 X50 Y50 Z50; (Remove fixed cycle and return from the R-point plane)
M30；
(55) Programmable Data Input Instruction G10/G710
Programmable data input command, which can modify the G54-G59 workpiece coordinates:
G10 Lxx enables programmable data input
Px Rxx performs data modification
Px Ixx performs data modification
X_Y_Z_A_ sets the current coordinate value of the specified workpiece coordinate system
G710 Turn off programmable data input
explain ：
The G10 table is opened for programmable data input and is a modal instruction.
The G710 table is closed to programmable data input and is a modal instruction.
L Address word specifies the type of modified data. 54-59 correspond to G54-G59 offsets respectively, and 5401-5448 correspond to G54.1-G54.48 offsets respectively, which are mode instructions. The P address word specifies the feed axis corresponding to the modified data, and 1-8 correspond to 8 feed axes. It is a mode instruction. The R address word specifies the value of the modified data, which is modified in absolute mode.
I The address word specifies the modified data value in an incremental manner.
for instance ：
G10 L55; Enable programmable data input to modify the G55 workpiece coordinate system offset
P2 R6 ; The Y-axis workpiece coordinate system offset of G55 is set to 6 mm
The workpiece coordinates of L56 X1Y2Z3; G56 are set to X1Y2Z3 P1 I1.5; the X-axis workpiece coordinate system offset of G56 is added by 1.5mm
G710 | ; Turn off programmable data input

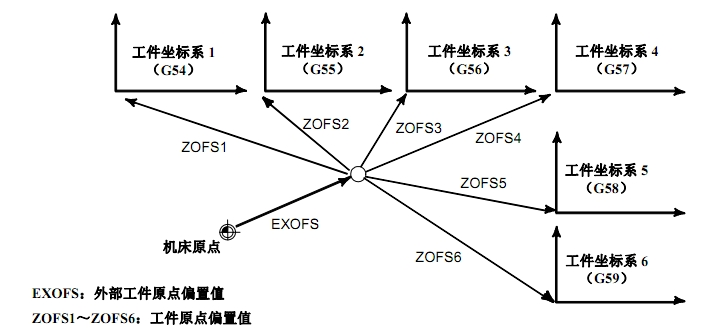
[picture p101: figure]

- 80 -

（56）可编程数据输入指令 G10

<1>当调用 L2 时，表示设置外部工件坐标系或 G54--G59 工件坐标系的原点 偏移值：
G10 L2 P_ X_ Y_ Z_ A_ B_ ...
地址字 P 为 0 表设置外部工件坐标系的原点偏移值，方法 1：P0 设置外部 工件坐标系的原点偏移值；方法 2：在主界面在显示 G53 状态时按 F7 测量对刀设 置外部工件坐标系的偏移值；方法 3：在参数坐标系状态，参数 P1-0 工件坐标 系当前组[G53-G59]设置为 G53，后面的 P1-1/P1-8 参数表示各个进给轴在外部 工件坐标系下的偏移值。
地址字 P 为 1--6 表设置工件坐标系 G54--G59 的原点偏移值。 当前为 G90 时按绝对方式设置，当前为 G91 时按增量方式设置。 调用功能 L2 时 G10 为非模态指令，每行必须编入 G10 L2 指令。 例如：
G10L2P1X0Y0Z0G90 表使 G54 工件坐标系与外部坐标系重合。 G10L2P3X11Y22Z33 表使 G56 工件坐标系与外部坐标系偏移 X11 毫 米,Y22 毫米,Z33 毫米。
<2>当调用 L20 时，表示设置 G54.1--G54.48 工件坐标系的原点偏移值： G10 L20 P_ X_ Y_ Z_ A_ B_ ...
地址字 P 为 1--48 表设置工件坐标系 G54.1--G54.48 的原点偏移值。 当前为 G90 时按绝对方式设置，当前为 G91 时按增量方式设置。 调用功能 L20 时 G10 为非模态指令，每行必须编入 G10 L20 指令。 例如：
G10L20P1X0Y0Z0G90 表使 G54.1 工件坐标系与外部坐标系重合。 G10L20P3X11Y22Z33 表使 G54.3 工件坐标系与外部坐标系偏移 X11 毫 米,Y22 毫米,Z33 毫米。
说明：当调用功能 L2 或 L20 时，指令兼容于发那科系统。 <3>外部坐标系的设置与修改
1. 在参数坐标系状态，选择 G53 修改偏移量；

- numerical control sys -
tem -

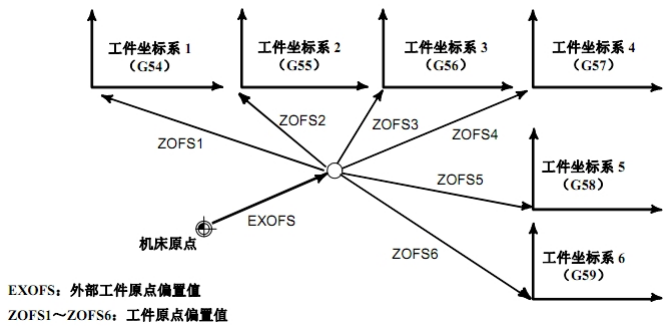
[picture p102: figure]

- 80 -

（56） Programmable Data Input Instruction G10

<1>When calling L2, it indicates the offset value of the origin of the external workpiece coordinate system or G54-G59 workpiece coordinate system:
G10 L2 P_ X_ Y_ Z_ A_ B_ ...
Address parameter P is set to 0 to configure the origin offset value for the external workpiece coordinate system. Method 1: Set the origin offset value for the external workpiece coordinate system using P
0. Method 2: When the G53 status is displayed on the main interface, press F7 to measure and set the offset value for the external workpiece coordinate system during tool measurement. Method 3: In parameter coordinate system mode, set parameters P1-0 to the current workpiece coordinate system group [G53-G59] to G53. Subsequent parameters P1 -1/P1-8 indicate the offset values for each feed axis in the external workpiece coordinate system.
Address word P is set to 1-6 to set the origin offset value of the workpiece coordinate system G54-G59.
When the current value is G90, it is set in absolute mode; when the current value is G91, it is set in incremental mode.
When the function L2 is called, G10 is a non-mode instruction, and each line must be programmed with G10 L2 instructions.
for instance ：
G10L2P1X0Y0Z0G90 indicates that the G54 workpiece coordinate system coincides with the external coordinate system. G10L2P3X11Y22Z33 indicates that the G56 workpiece coordinate system is offset from the external coordinate system by X11 mm, Y 22 mm, and Z33 mm.
<2>When L20 is called, it indicates that the origin offset value of G 54.1--G54.48 workpiece coordinate system is set:
G10 L20 P_ X_ Y_ Z_ A_ B_ ...
The address word P is set to 1--48, indicating the workpiece coordinate system G54. The origin offset value ranges from 1--G54.48. When the current mode is G90, it is set in absolute mode; when the current mode is G91, it is set in incremental mode.
When the function L20 is called, G10 is a non-modular instruction, and each line must be programmed with the G10 L20 instruction.
for instance ：
G10L20P1X0Y0Z0G90 indicates G54.1 that the workpiece coordinate system coincides with the external coordinate system. G10L20P3X11Y22Z33 indicates G54.3 workpiece coordinate system offset from external coordinate system by X11 mm, Y22 mm, and Z33 mm.
Note: When function L2 or L20 is called, the instruction is compatible with the FANUC system.
<3>Setting and modifying the external coordinate system
1. In the parameter coordinate system state, select G53 to modify the offset;

- 81 -
2. 在刀补状态，修改外部坐标；

（57）椭圆指令（G602/G603）

G17 G602/G603 X(U)_ Y(V)_ I_ J_ Q_
G18 G602/G603 Z(W)_ X(U)_ K_ I_ Q_
G19 G602/G603 Y(V)_ Z(W)_ J_ K_ Q_
I表椭圆X方向半轴长(mm); J表椭圆Y方向半轴长(mm); Q表斜角(单位为度)； 无论是直径编程还是半径编程, 编程地址 I J K 均指半径值, 单位为 mm。 G602 表加工顺时针椭圆， G603 表加工逆时针椭圆。 当IJK指定的半轴长均为正值时，表示椭圆对应的圆心角小于等于180度， 当 I J K 指定的半轴长有一个或两个为负值时，表示椭圆对应的圆心角大于等于 180 度。
Q表椭圆绕椭圆中心点转动的斜角, 按右手坐标系逆时针方向转动为正, 单 位为度，不编写 Q 表没有转动的斜角。
指令 G602/G603 为模态指令，但 I J K Q 为非模态。

（58）抛物线指令（G702）

G17 G702 X(U)_ Y(V)_ R_ Q_ 对应抛物线方程为: Y*Y=2*R*X (X 指半径值) G18 G702 Z(W)_ X(U)_ R_ Q_ 对应抛物线方程为: X*X=2*R*Z (X 指半径值) G19 G702 Y(V)_ Z(W)_ R_ Q_ 对应抛物线方程为: Z*Z=2*R*Y R表抛物线方程系数, 含义表示抛物线焦点相对于抛物线顶点相对距离的两 倍, 有正负之分, 单位为 mm。
Q表抛物线曲线绕抛物线顶点转动的斜角, 按右手坐标系逆时针方向转动为 正, 单位为度，不编写 Q 表没有转动的斜角。
指令 G702 为模态指令，但 R Q 为非模态。
注意： R 有正负值之分, 正负值对应的抛物线曲线朝向相反, 当 R 大于零 时, 抛物线开口朝右, 当 R 小于零时, 抛物线开口朝左。 抛物线示意图如下：

- numerical control sys -
tem -
- 81 -
2. In the tool supplement state, modify the external coordinates; （57） Ellipse Command (G602/G603)
G17 G602/G603 X(U)_ Y(V)_ I_ J_ Q_
G18 G602/G603 Z(W)_ X(U)_ K_ I_ Q_
G19 G602/G603 Y(V)_ Z(W)_ J_ K_ Q_
I represents the semi-major axis of the elliptical X direction (mm); J represents the semi-major axis of the elliptical Y direction (mm); Q represents the inclination angle (unit: degrees);
Whether it is diameter programming or radius programming, the programming address I J K refers to the radius value, and the unit is mm. G602 is for clockwise elliptical machining, and G603 is for counterclockwise elliptical machining.
When the semi-axes specified by I JK are all positive, it means that the corresponding central angle of the ellipse is less than or equal to 180 degrees; when one or two of the semi-axes specified by IJK are negative, it means that the corresponding central angle of the ellipse is greater than or equal to 180 degrees.
Q is the oblique angle by which an elliptic table rotates around the center point of the ellipse. The rotation in the counterclockwise direction according to the right-handed coordinate system is positive, and the unit is degrees. The oblique angle without rotation is not written in Q table.
Instructions G602/G603 are modal instructions, but I J K Q are non-modal.
（58） Parabolic Command (G702)
The corresponding parabolic equation for G17 G702 X (U)_Y (V)_R_ Q is: Y*Y=2*R*X (where X is the radius value)
The corresponding parabolic equation for G18 G702 Z (W)_X(U)_R_ Q is: X*X = 2*R*Z (where X is the radius value)
The corresponding parabolic equation for G19 G702 Y (V) _Z (W) _ R_Q_ is Z*Z=2*R*Y
R is the coefficient of the parabola equation. The meaning is that it is twice the relative distance between the focus of the parabola and the vertex of the parabola. It has positive and negative values. The unit is mm.
Q is the rotation Angle of the parabola curve around the vertex of the parabola. If it rotates counterclockwise in the right-handed coordinate system, it is positive and measured in degrees. The rotation Angle without rotation is not written in Q table.
Instruction G702 is a modal instruction, but R Q is non-modal. Note: R has positive and negative values, and the corresponding parabolic curve has opposite directions. When R is greater than zero, the parabolic curve opens to the right, and when R is less than zero, the parabolic curve opens to the left.
A diagram of the parabola is as follows:

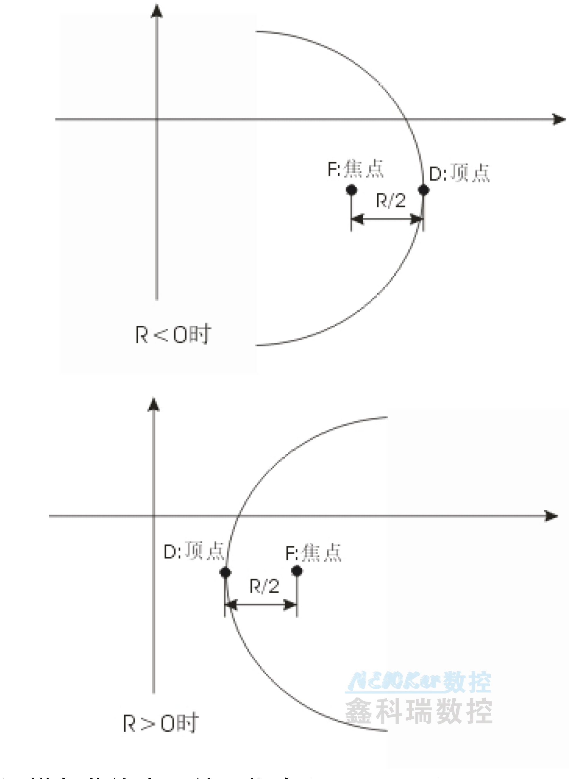
[picture p103: figure]

- 82 -

（59）样条曲线光顺处理指令(M620/M621)

指令: M620 关闭样条曲线光顺处理插补
指令: M621 L_ 开启样条曲线光顺处理插补
只是针对连续的 G01 程序段进行处理, 对 G00/G02/G03 等程序段不作处理。 默认对于连续的 5 段以上的 G01 程序才进行光顺处理, 可以通过编写 L 指 定最小光顺段数。
例如: 编入 M621 L2 表示即使是只有两段的 G01 程序, 也会进行光顺处 理。
G0X0Y0Z0
M621 L2
G1X20Y60Z15
X150Y-96Z-36
X75Y-152Z69

（60）倾斜姿态坐标系 G682/G680(G68.2/G69)

- numerical control sys -
tem -

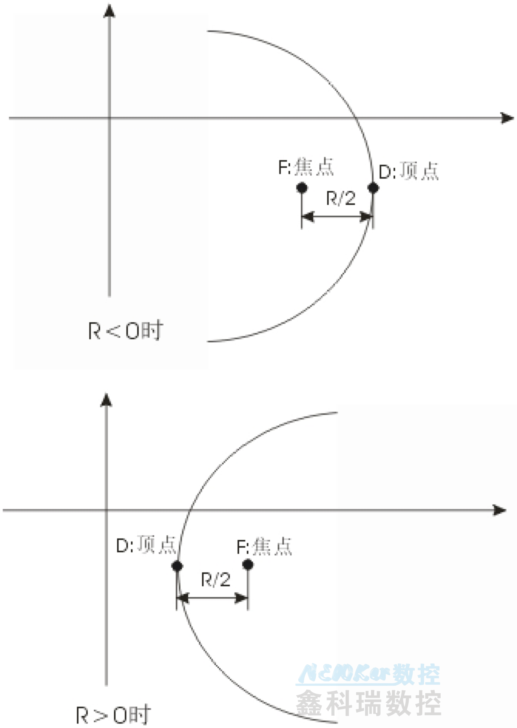
[picture p104: figure]

- 82 -

（59） Spline Curve Smoothing Instruction (M620/M621)

Command: M620 turns off the smoothing interpolation of the spline curve
Command: M621 L_Enable smooth interpolation of spline curve light It only processes continuous G01 program segments, and does not process G00/G02/G03 program segments. By default, smooth processing is performed for continuous G01 program segments of more than 5 segments. The minimum number of smooth segments can be specified by writing L.
For example, entry into M621 L2 means that even a G01 program with only two segments will be smooth.
G0X0Y0Z0
M621 L2
G1X20Y60Z15
X150Y-96Z-36
X75Y-152Z69

（60） Tilt axis coordinate system G682/G680 (G68.2/G69)

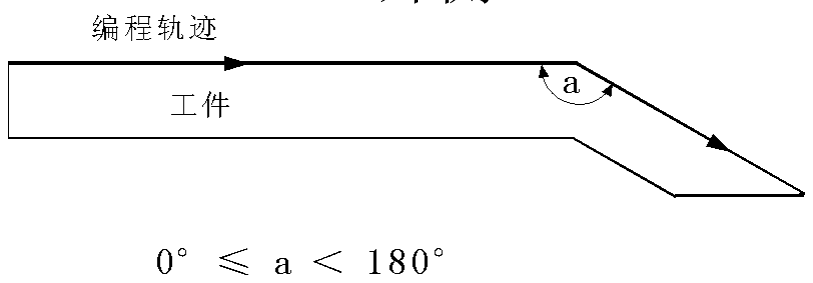
[picture p105: figure]

- 83 -

G680/G69 退出任意角度倾斜姿态坐标系状态
G682/G68.2 Q_ X_ Y_ Z_ I_ J_ K_ L8 进入倾斜姿态坐标系状态 Q_ 指定旋转顺序，后面编 1--3 个数字，不编 Q 默认 Q123; 例如: Q123 表依次按绕 X 绕 Y 绕 Z 轴的顺序旋转；
Q3 表仅仅绕 Z 轴旋转；
Q32 表依次按绕 Z 绕 Y 轴的顺序旋转；
Q312 表依次按绕 Z 绕 X 绕 Y 轴的顺序旋转;
X_Y_Z_ 指定倾斜姿态坐标系坐标原点的位置，以当前工件坐标系方式指定， 不指定则认为是当前位置;
I_J_K_指定绕 XYZ 轴的旋转角度(度),不指定默认 0 度; 旋转原理：将机床坐标系的原点平移到 X_ Y_ Z_ 指定位置，再将该坐 标系按 Q_指定顺序旋转 I_J_K_指定角度即可得到倾斜姿态坐标系。 附加功能：当处于五轴 RTCP 模式时，该行编入 L8 指令(类似发那科 G53.1 指令) 表该行会自动运行旋转轴，以实现刀具轴线与倾斜坐标系的 Z 轴 方向一致，当前为 G0 状态就按 G0 速度运行，否则按 G1 速度运行。
G533 开启法向进刀退刀指令；G530 关闭法向进刀退刀指令；
注意：
<1> 在 G682 时，所有 XYZ 编程坐标是指在倾斜姿态坐标系下的坐标; <2> 在非 RTCP 模式和 RTCP 模式下均可使用;
<3> 必须处于 M601/M602 使用 G533 指令才有效;
<4> G43.4/G49 指令可替代 M602/M600 指令；
G68.2 /G69 指令可替代 G682/G680 指令； G53.1 与发那科使用方法一样。

2.5 刀具半径补偿 C 的介绍

刀具半径补偿 C 是指系统根据本段程序的上一段和下一段计算出半径补偿 后的刀具轨迹。

2.5.1 内侧和外侧概念

当两段程序指令建立的刀具轨迹的夹角超过180 时称该轨迹为内侧，当夹角 在0度和180度之间时称为外侧。见下图所示：
内侧： | 外侧：

2.5.2 起刀时的刀具移动

- numerical control sys -
tem -

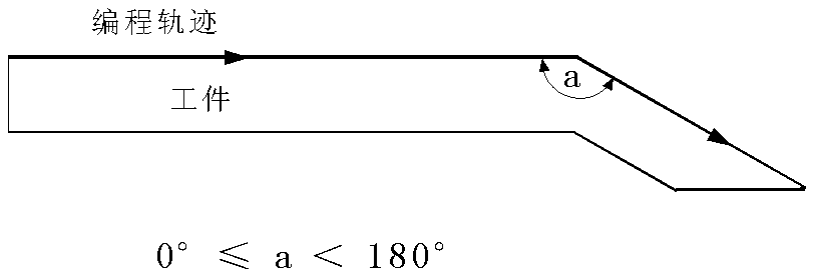
[picture p106: figure]

- 83 -

G680/G69 exits the state of any Angle tilt attitude coordinate system G682/G68.2 Q_X_Y_Z_I_J_K_L8 Enter the tilt attitude coordinate system state Q_ Specify the rotation order, followed by 1-3 digits, do not compile Q default Q123; for example:
Q123 The table rotates in the order of rotating around X, Y and Z axes;
Q3 The table only rotates around the Z-axis;
Q32 The table rotates in the order of rotating around the Z and Y axes;
Q312 The table rotates in the order of rotating around the Z, X and Y axes;
X_Y_Z_ specifies the position of the origin of the coordinate system in the inclined attitude, which is specified in the current workpiece coordinate system. If not specified, it is considered as the current position;
I_J_K_ specifies the rotation Angle around the XYZ axis (in degrees), not the default 0 degree;
Rotation principle: The origin of the machine tool coordinate system is moved to the specified position of X_Y_Z_, and then the coordinate system is rotated by the specified Angle of I_J_K_ according to the specified order of Q_ to obtain the inclined attitude coordinate system.
Additional functions: When in five-axis RTCP mode, this line is programmed with L8 instructions (similar to FANUC G53.1 instructions). The line will automatically rotate the axis to align the tool axis with the Z-axis direction of the tilting coordinate system. If currently in G0 state, it will operate at G0 speed; otherwise, it will operate at G1 speed.
G533 enables the feed advance/retreat command in the direction; G 530 closes the feed advance/retreat command in the direction;
pay attention to ：
<1> At G682, all XYZ programming coordinates refer to the coordinates in the oblique attitude coordinate system;
<2> can be used in both non-RTCP mode and RTCP mode;
<3> Must be in M601/M602 to use G533 command is valid;
<4> G43.4/G49 The instruction can
replace the M602/M600 instruction;
G68.2 /G69 instruction can replace
the G682/G680 instruction; G53.1 is
used in the same way as FANUC.
2.5 Introduction to Tool Radius Compensation C
Tool radius compensation C refers to the tool path calculated by the system based on the radius compensation of the previous and next sections of the program.
2.5.1 Internal and External Concepts
When the angle between two program instructions to establish a tool path exceeds 180, it is called the inside path, and when the angle is between 0 degrees and 180 degrees, it is called the outside path. See the following figure:
inside ： | outboard ：

2.5.2 Movement of the Tool at the Time of Starting the Knife

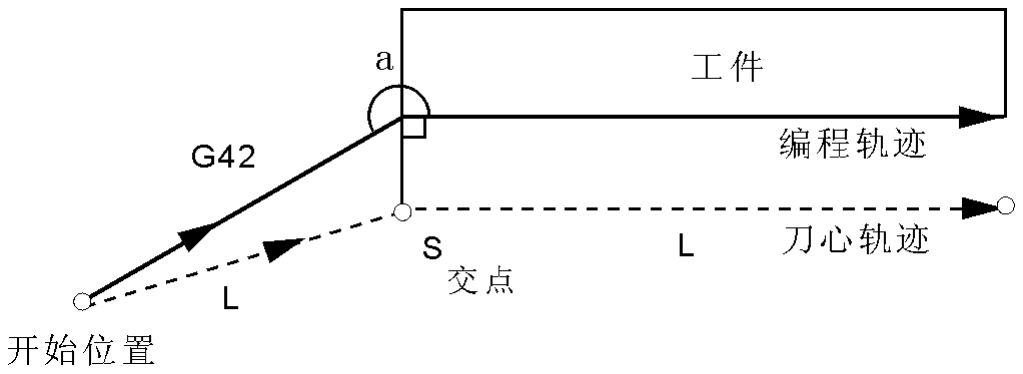
[picture p107: figure]
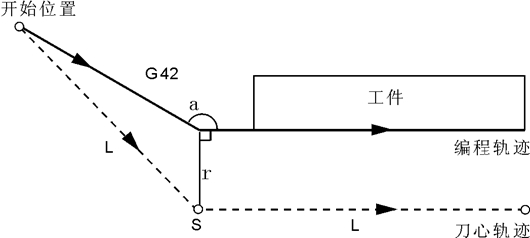
[picture p108: figure]

- 84 -

由无刀具半径补偿建立刀具半径补偿。

（1） 围绕拐角内侧的刀具移动（α≥180）

刀具中心将移至下段程序起点的刀具矢量半径顶点。
直线->直线 | 直线->圆弧

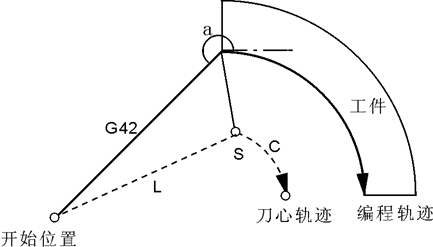
[picture p109: figure]

（2） 围绕钝角拐角外侧的刀具移动（90≤α＜180）

刀具中心将移至本段程序终点的刀具矢量半径顶点。
直线->直线
A型 | B型

直线->圆弧

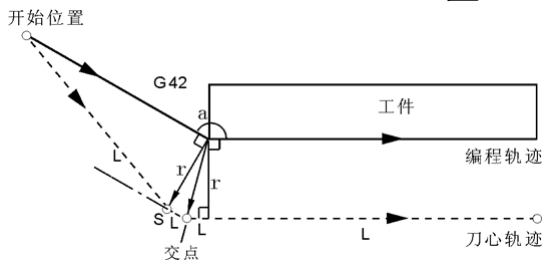
[picture p110: figure]

A型 | B型

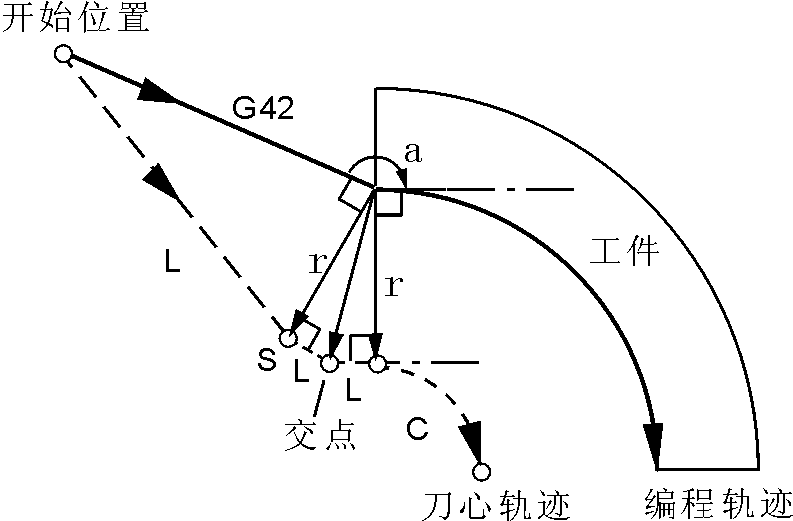
[picture p111: figure]
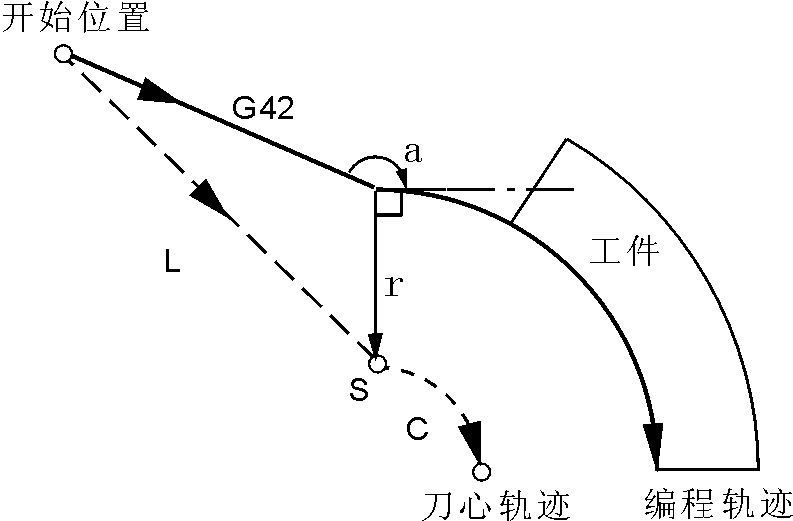
[picture p112: figure]

（3） 围绕锐角拐角外侧的刀具移动（α＜90）

刀具中心将移至本段程序终点的刀具矢量半径顶点。
直线->直线
A型 | B型

- numerical control system -

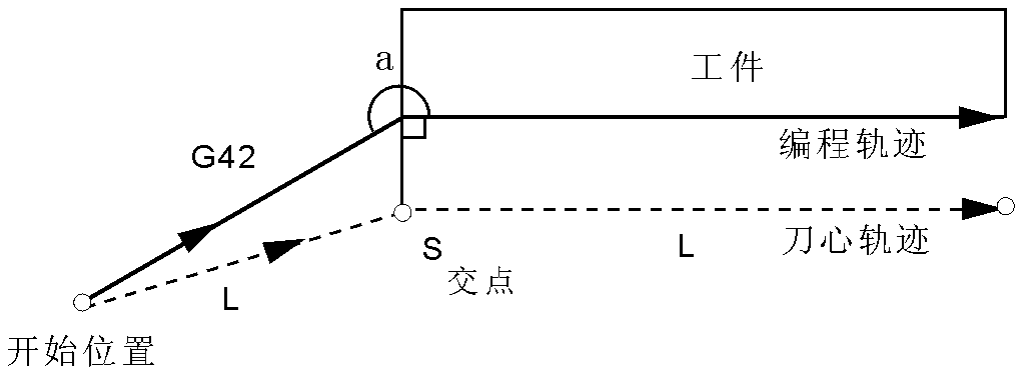
[picture p113: figure]
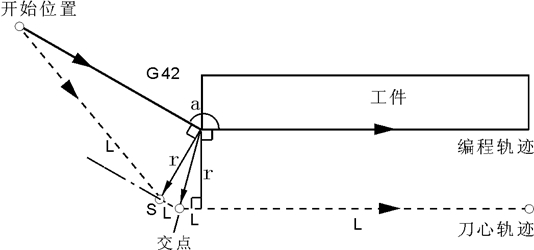
[picture p114: figure]
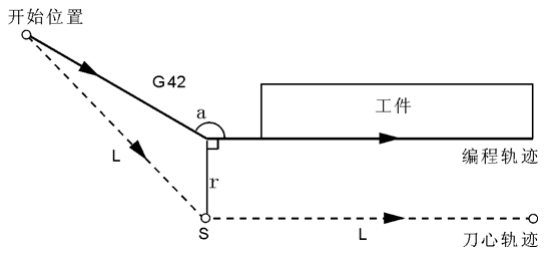
[picture p115: figure]

- 84 -

The tool radius compensation is established by no tool radius compensation.
（1） Movement of the Tool Around the Inside of the Corner (α≥ 180)
The tool center will be moved to the tool vector radius vertex at the starting point of the lower program.
Straight-> straight | Straight line-> Arc

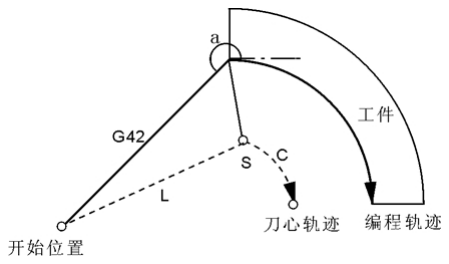
[picture p116: figure]

（2） Movement of the Tool Around the Outer Side of the Obtuse Angle (90 ≤ Α <180)
The tool center will move to the tool vector radius vertex at the end of this program.
Straight-> straight
A mould | B mould

Straight line
to
arc
A
ty
pe

B mould

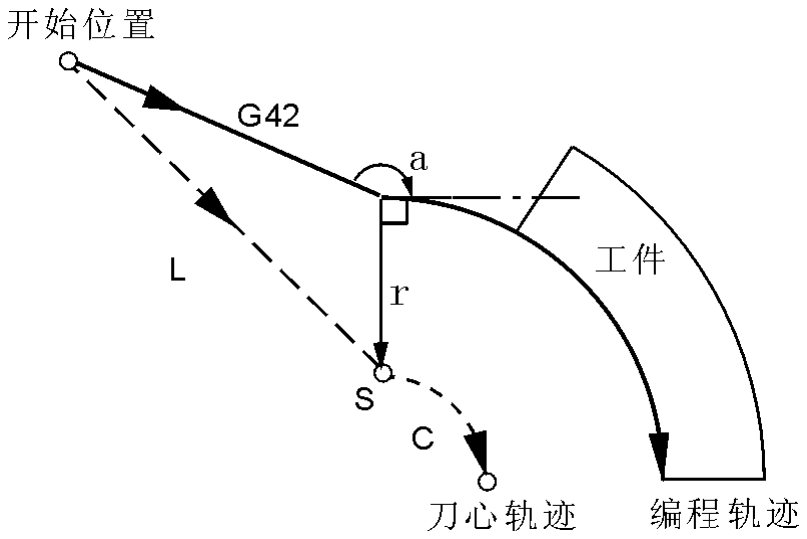
[picture p117: figure]

（3） Tool Movement Around the Outer Side of the Sharp Corner (α <90)
The tool center will move to the tool vector radius vertex at the end of this program segment. Line-> line
A mould | B mould

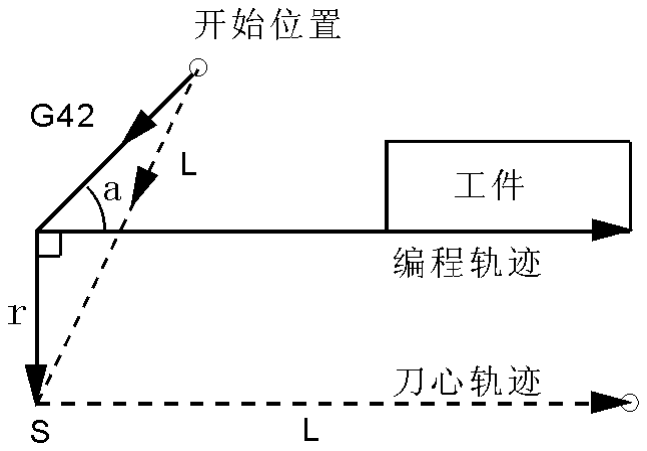
[picture p118: figure]
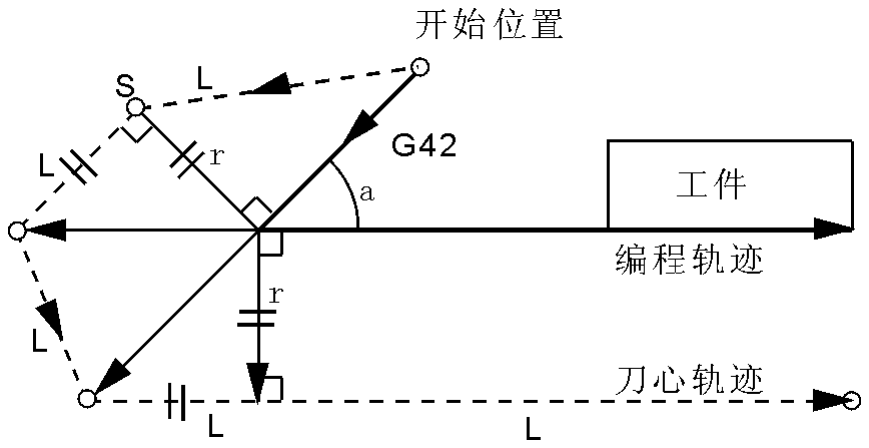
[picture p119: figure]
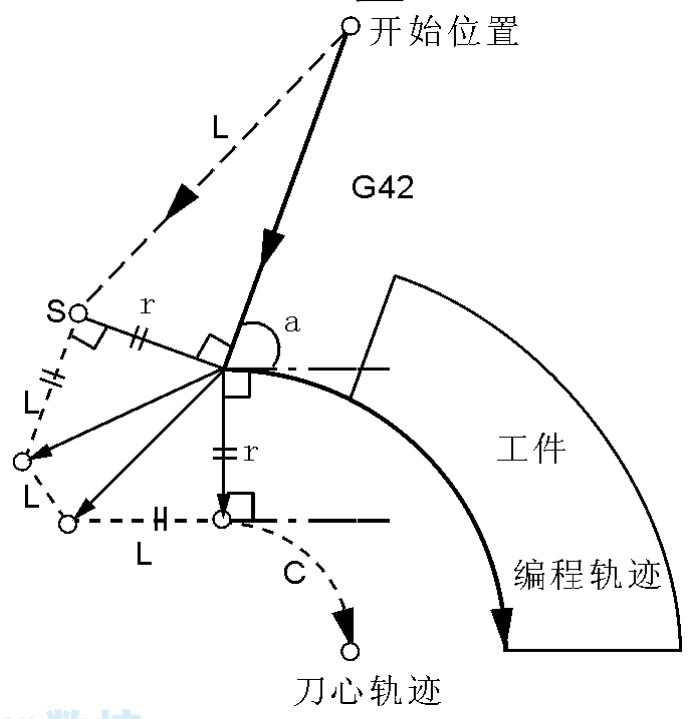
[picture p120: figure]
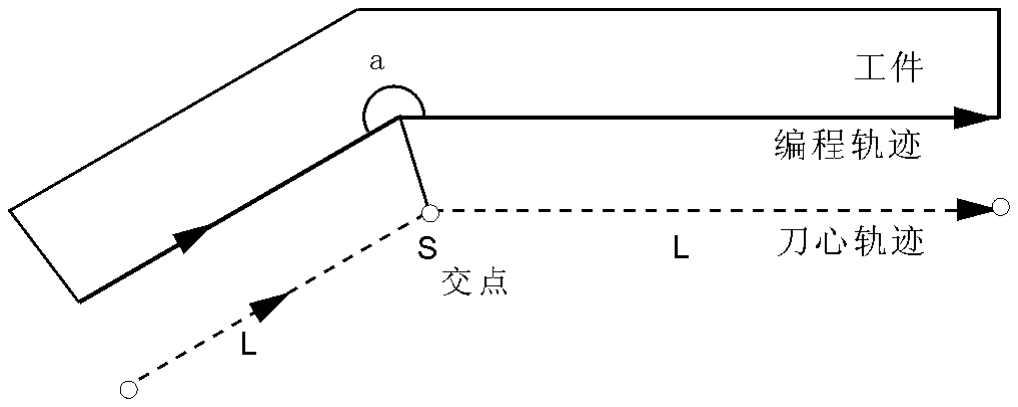
[picture p121: figure]
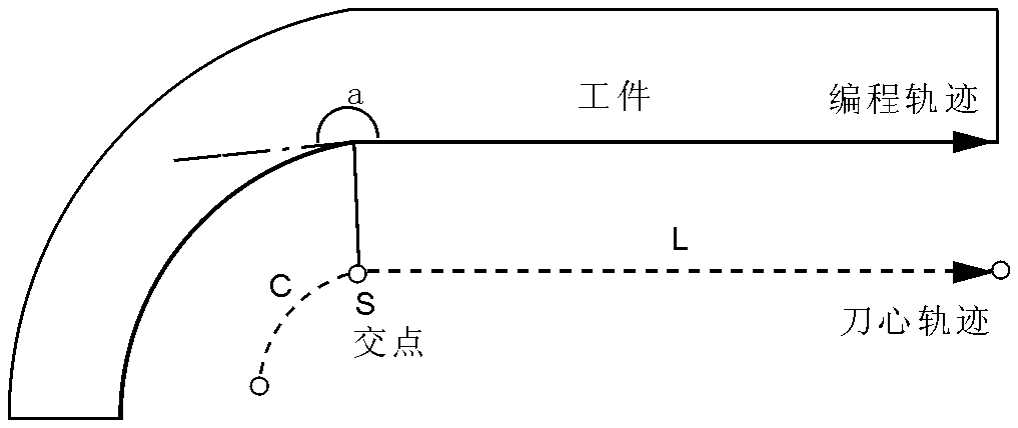
[picture p122: figure]

- 85 -

直线->圆弧
A型 | B型

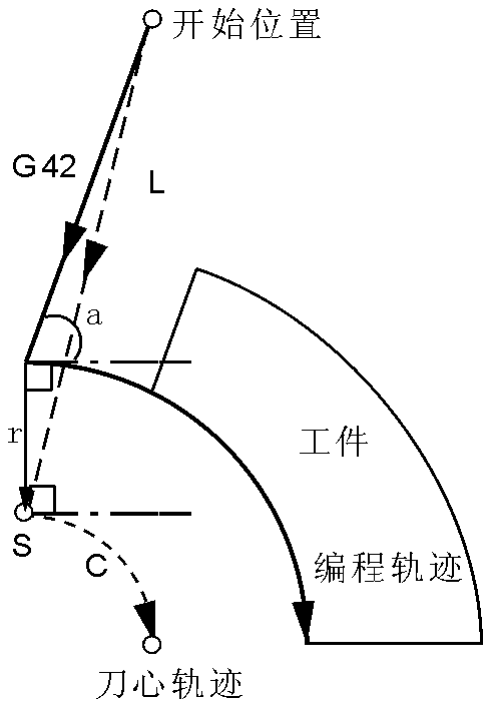
[picture p123: figure]

2.5.3 偏置方式中的的刀具移动

（1） 围绕拐角内侧的刀具移动（180≤α）

直线->直线 | 直线->圆弧

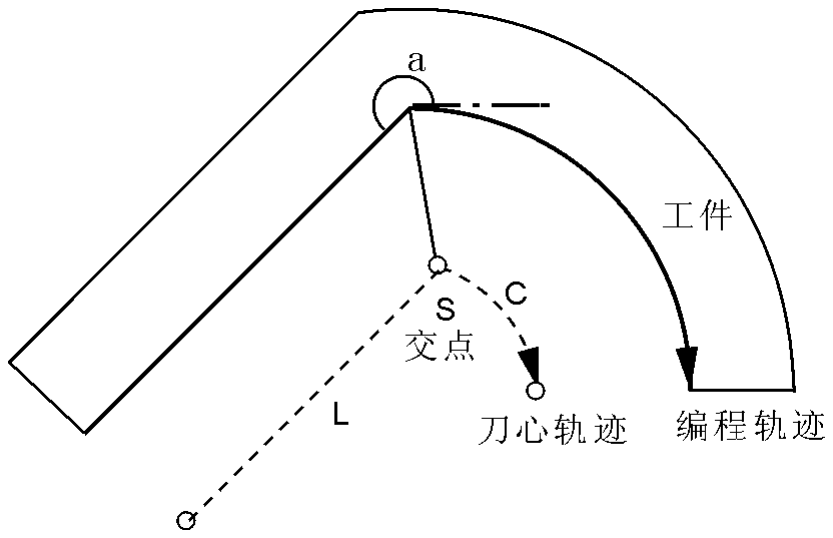
[picture p124: figure]
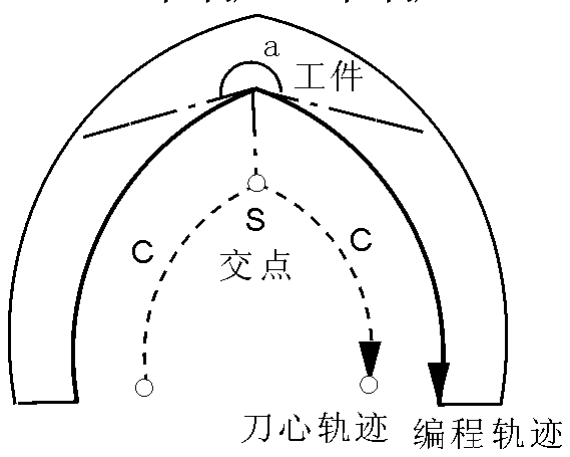
[picture p125: figure]

圆弧-> 直线 | 圆弧->圆弧

- numerical control system - | user's manual

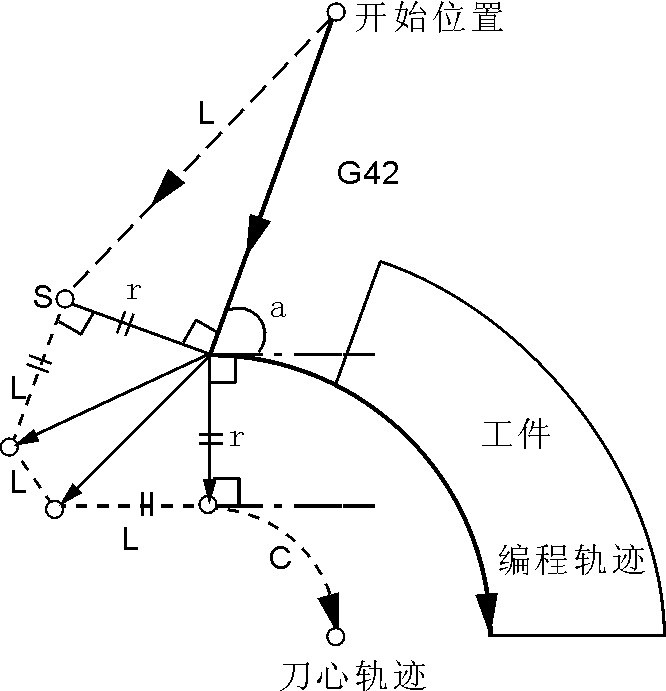
[picture p126: figure]
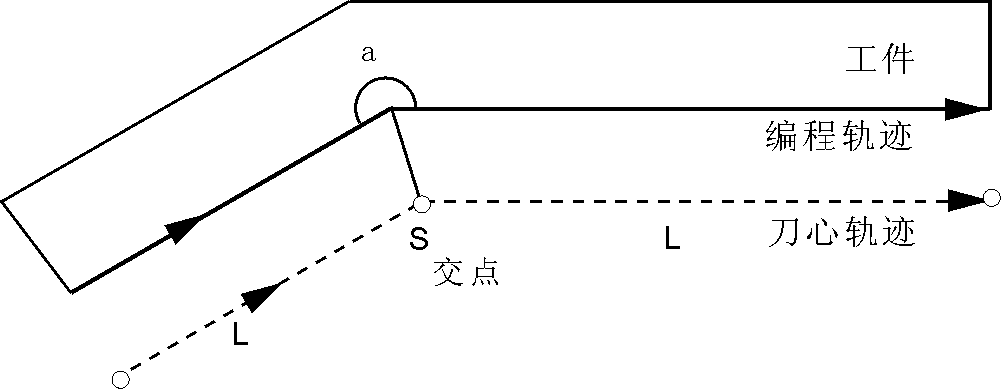
[picture p127: figure]

- 85 -

Straight line-> Arc

A mould

B mould

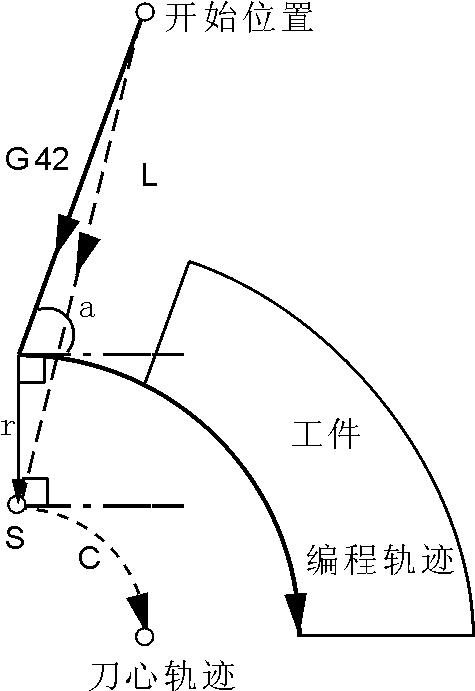
[picture p128: figure]

2.5.3 Tool Movement in a Biased Mode

（1） The tool moves along the
inner side of the corner (180 ≤ α)
| straight-> straight

Straight line-> Arc

Circular arc-> straight line

Arc-> arc

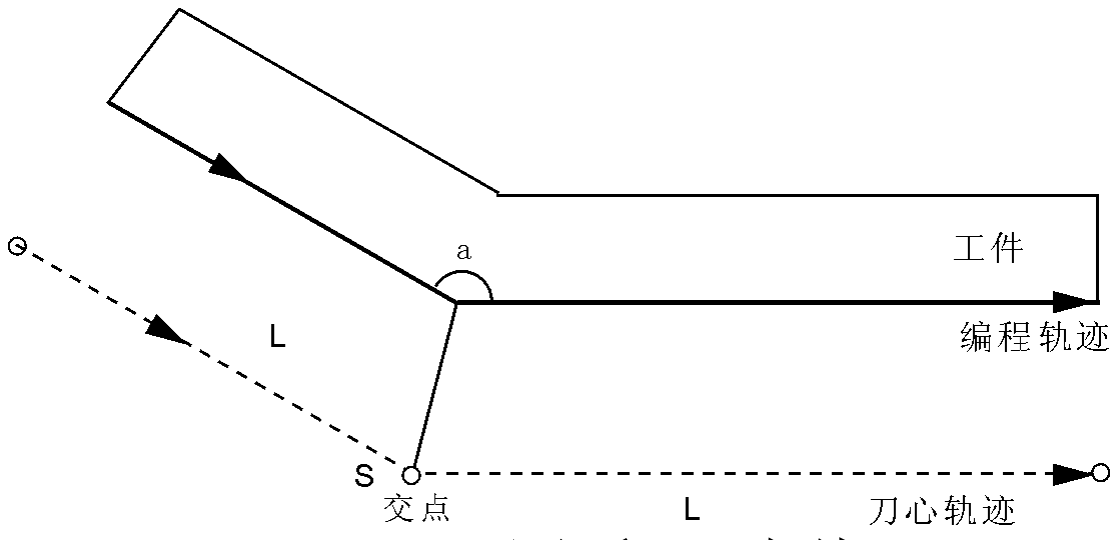
[picture p129: figure]
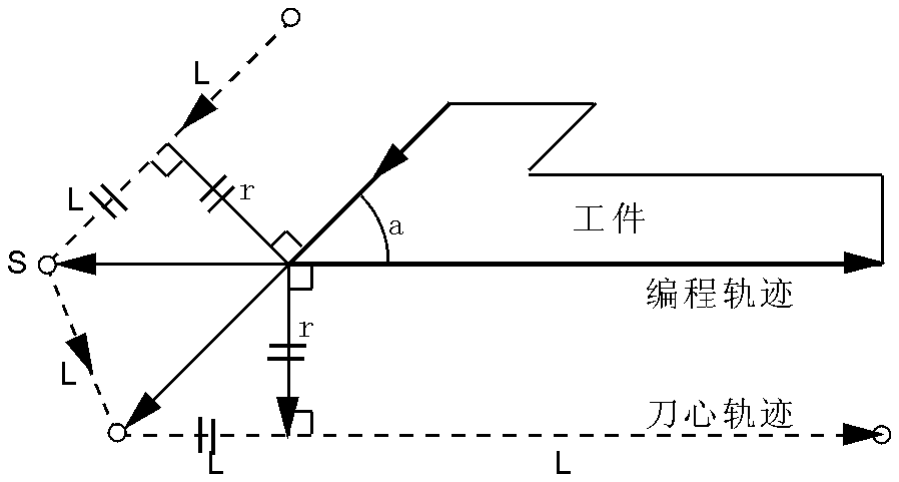
[picture p130: figure]

- 86 -

（2） 围绕钝角拐角外侧的刀具移动（90≤α<180）

直线->直线 | 直线->圆弧
圆弧-> 直线 | 圆弧->圆弧

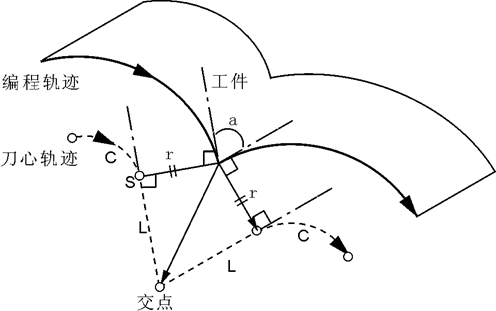
[picture p131: figure]

（3） 围绕锐角拐角外侧的刀具移动（α<90）

直线->直线 | 直线->圆弧
圆弧-> 直线 | 圆弧->圆弧

- numerical control system - | user's manual

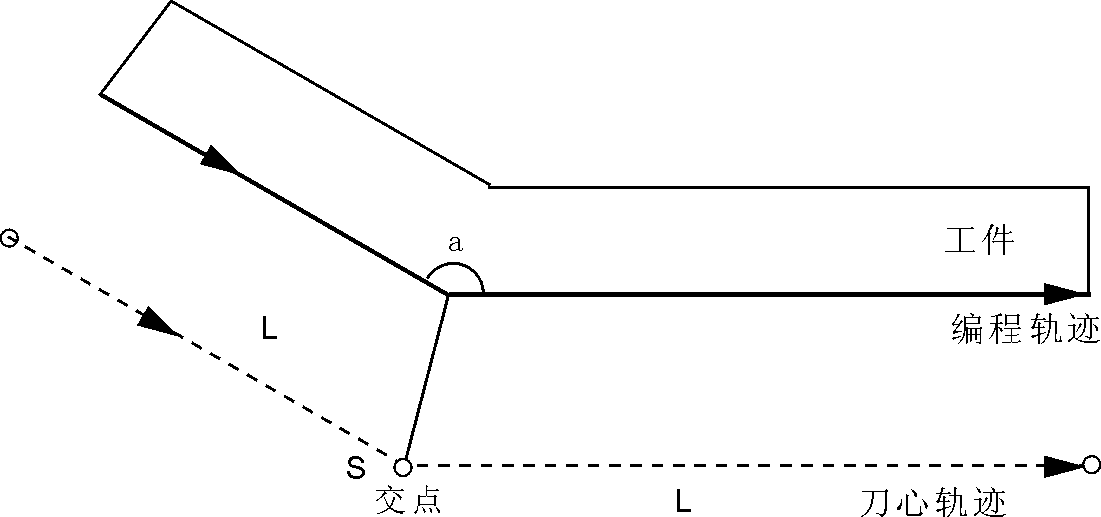
[picture p132: figure]
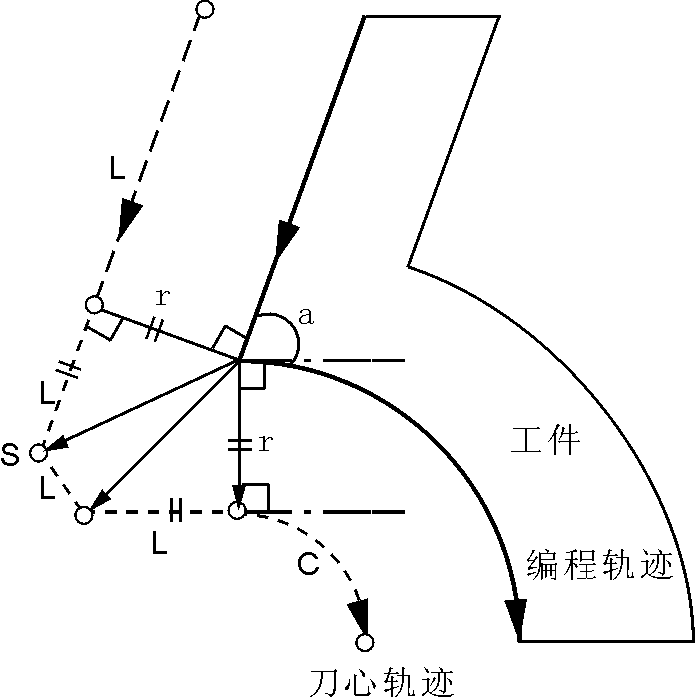
[picture p133: figure]

- 86 -

（2） Movement of the Tool Around the Outer Side of the Obtuse Angle (90 ≤ Α <180)

Straight line → straight line | Straight line-> Arc

Circular arc->
straight line

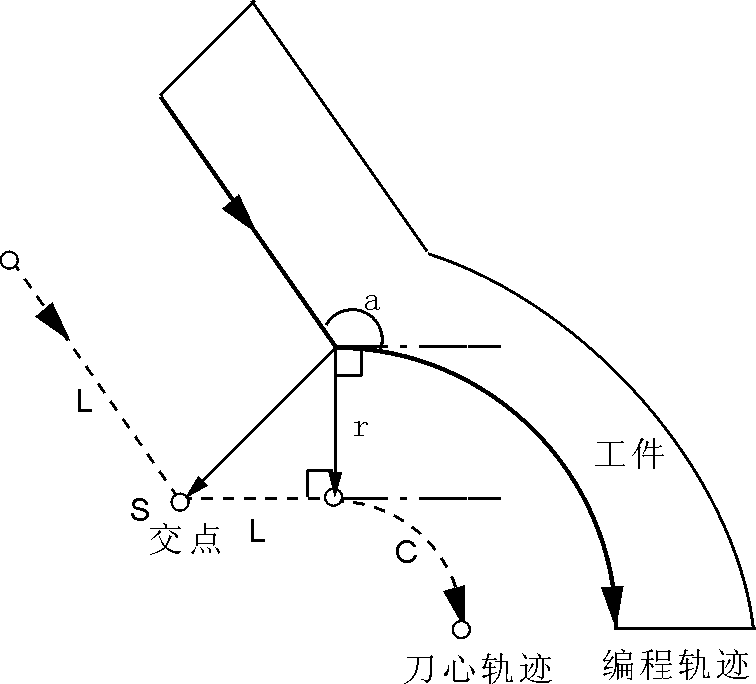
[picture p134: figure]

Arc-> arc

（3） Tool Movement Around the Outer Side of the Sharp Corner (α <90)
| Straight line → straight line

Straight
line-> Arc

Circular arc-> straight line Arc-> arc

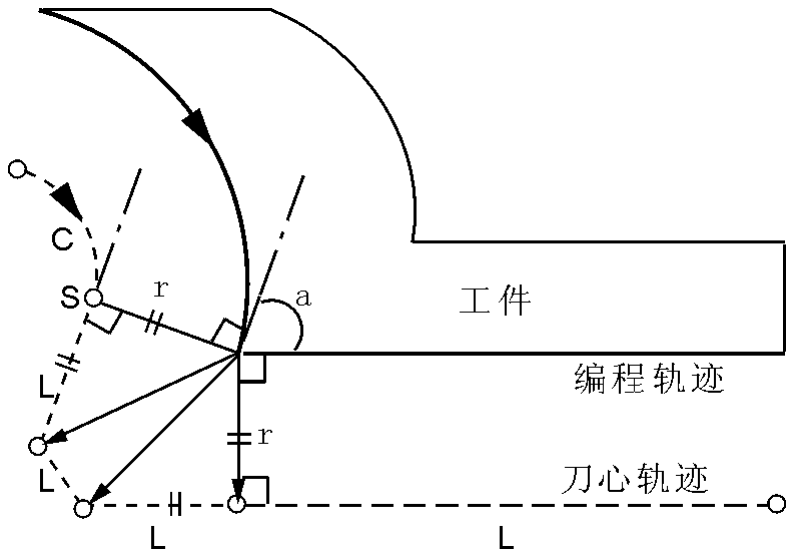
[picture p135: figure]
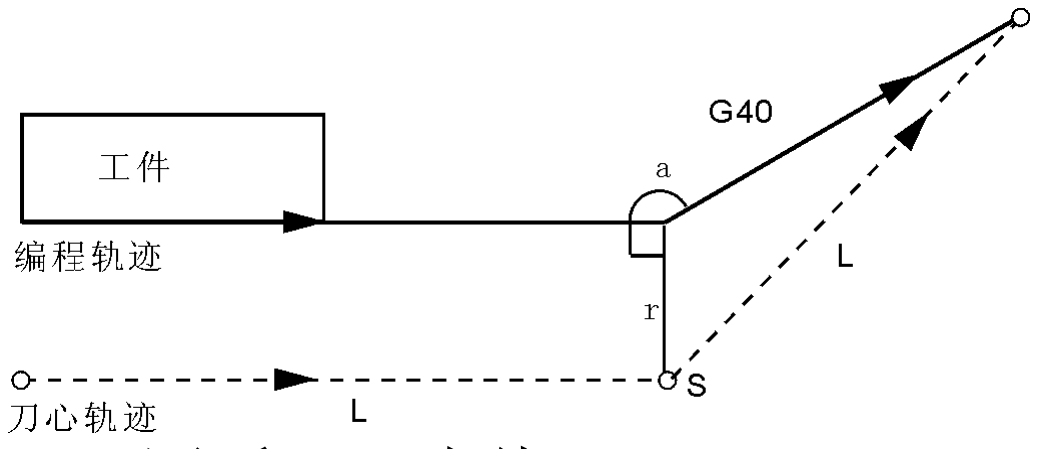
[picture p136: figure]

- 87 -

（4）偏置取消方式中的的刀具移动

1、围绕拐角内侧的刀具移动（180≤α）

刀具中心将移至本段程序终点的刀具矢量半径顶点。
直线－＞直线 | 圆弧－＞直线

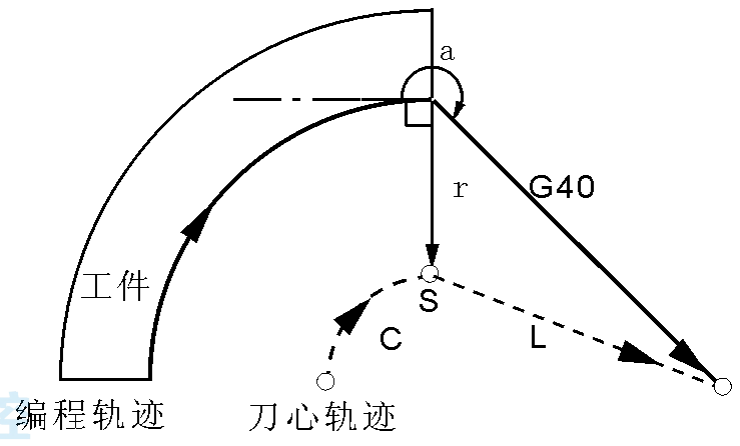
[picture p137: figure]

2、围绕钝角拐角外侧的刀具移动（90≤α<180）
刀具中心将移至下段程序起点的刀具矢量半径顶点。
直线－＞直线
A型 | B型

圆弧－＞直线
A型 | B型

3、围绕锐角拐角外侧的刀具移动（α<90）

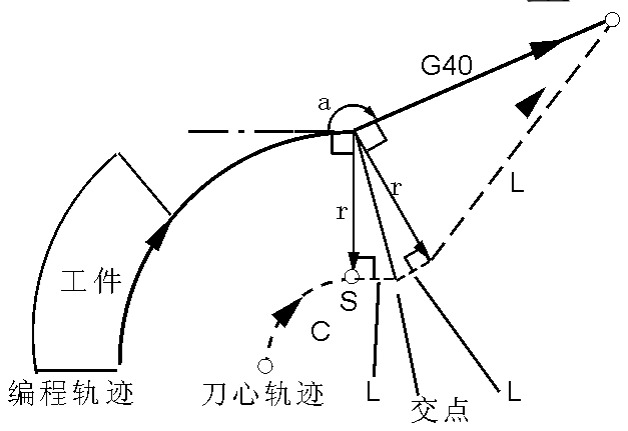
[picture p138: figure]

- numerical control system -

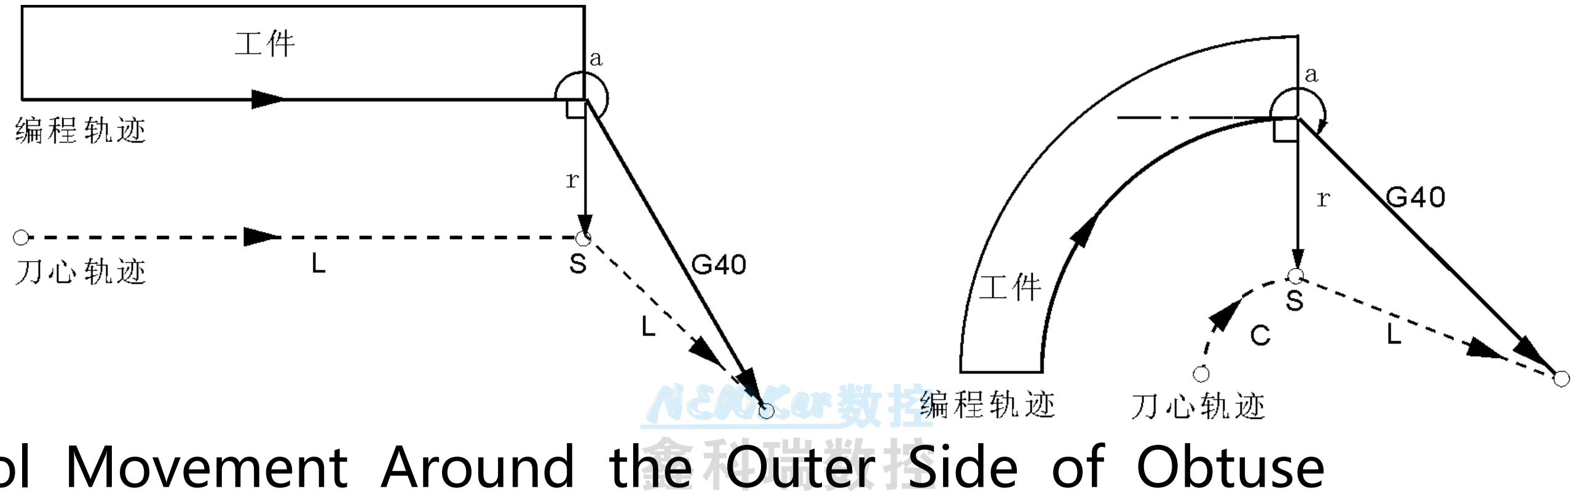
[picture p139: figure]
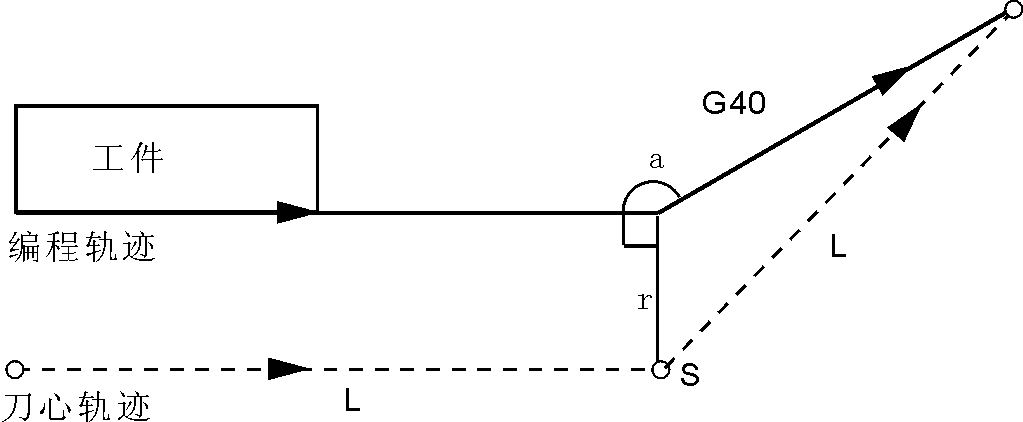
[picture p140: figure]

- 87 -

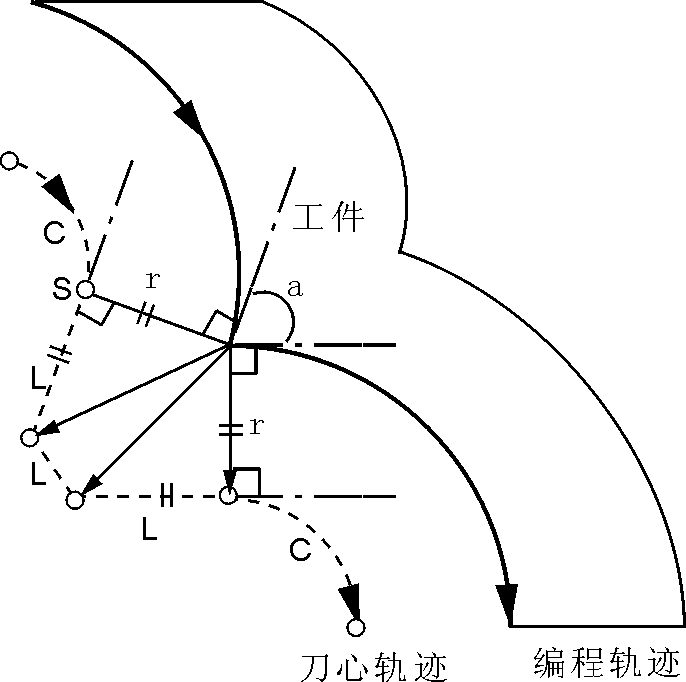
[picture p141: figure]

（4） Tool Movement in the Offset Cancellation Mode
1, Tool Movement Around the Inside of the Corner (180≤α) The tool center will move to the tool vector radius vertex at the end of this program section.
Straight line → straight line
Circular arc-> straight line
2. Tool Movement Around the Outer Side of Obtuse Angle (90 ≤ Α <180)
The tool center will move to the tool vector
radius vertex at the start of the next program.
Line-> line
A mould | B mould

Circular
arc->
straight
line A
type

B mould

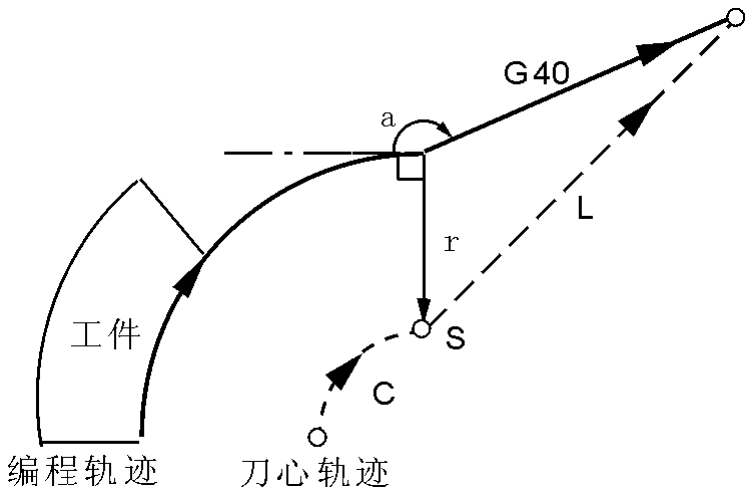
[picture p142: figure]

3、 Tool movement around the outer side of the sharp corner (α<90)

- 88 -

刀具中心将移至下段程序起点的刀具矢量半径顶点。
直线－＞直线
A型 | B型

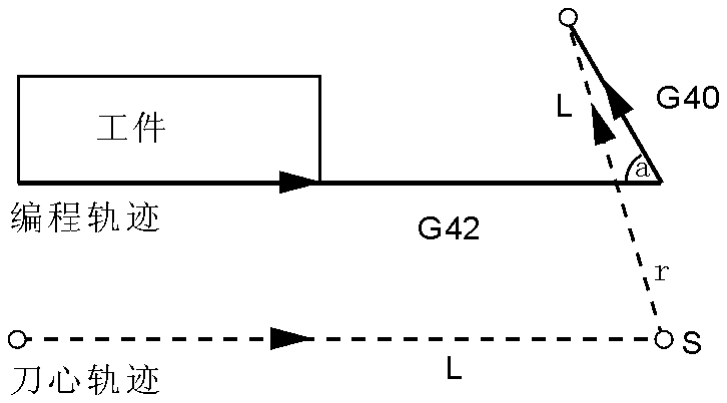
[picture p143: figure]

圆弧－＞直线
A型 | B型

2.6 编程综合实例

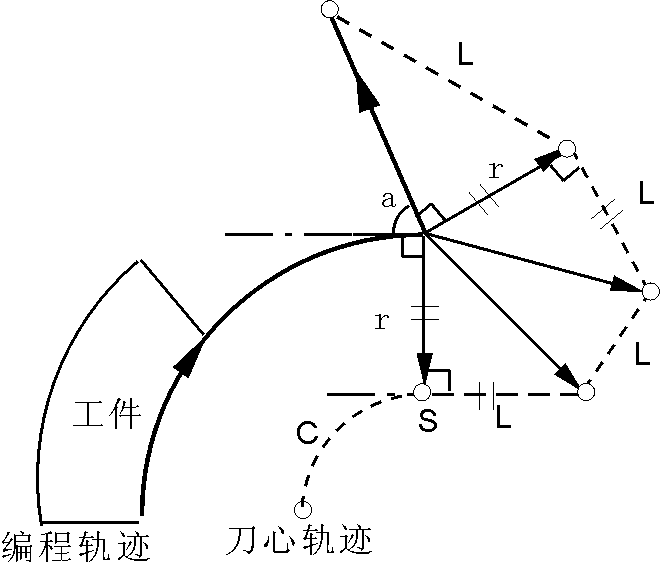
[picture p144: figure]

在实际编程时，必须根据图纸及工艺要求，选择正确的装夹方式和适合的刀 具，并结合机床的实际工作性能选择正确的切削余量，现举例说明：

例 1：切方和切圆

从中心开始，中心坐标 G54 X0 Y0 Z50
刀具半径在参数 T01 中的 D01
N0 G54 G00 X0 Y0 Z50 | ；加工起点
N1 M03 S1000 | ；开主轴
N2 G00 Y-40 X－40 G90 | ；走出正方形外
N3 Z10 | ；
N4 G01 Z－10 F200 | ；Z 轴下刀

C

A

B
E

D

O

40

- numerical control sys -
tem -
- 88 -

The tool center will move to the tool vector
radius vertex at the start of the next program.
Line-> line
A mould | B mould

Circular
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
B mould

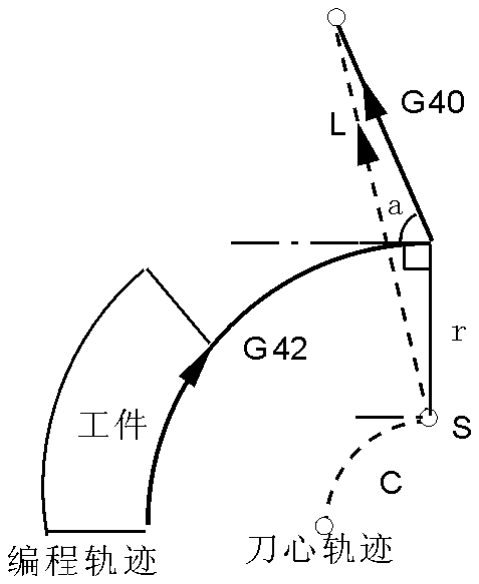
[picture p145: figure]

2.6 Programming Examples
In actual programming, we must choose the correct clamping method and suitable tools according to the drawings and process requirements, and select the correct cutting allowance according to the actual working performance of the machine tool. Now, we will give an example:
Example 1: Cutting a square and a circle

From the center, the center coordinates are G54 X0 Y0 Z50 The tool radius is D01 in parameter T01
N0 G54 G00 X0 Y0 Z50 | ; Point of processing
N1 M03 S1000 | ; Start the spindle
N2 G00 Y-40 X－40 G90 | ; Out of the square
N3 Z10 | ；
N4 G01 Z－10 F200 | ; The Z-axis cuts down

C
A
B | E

D

O

40

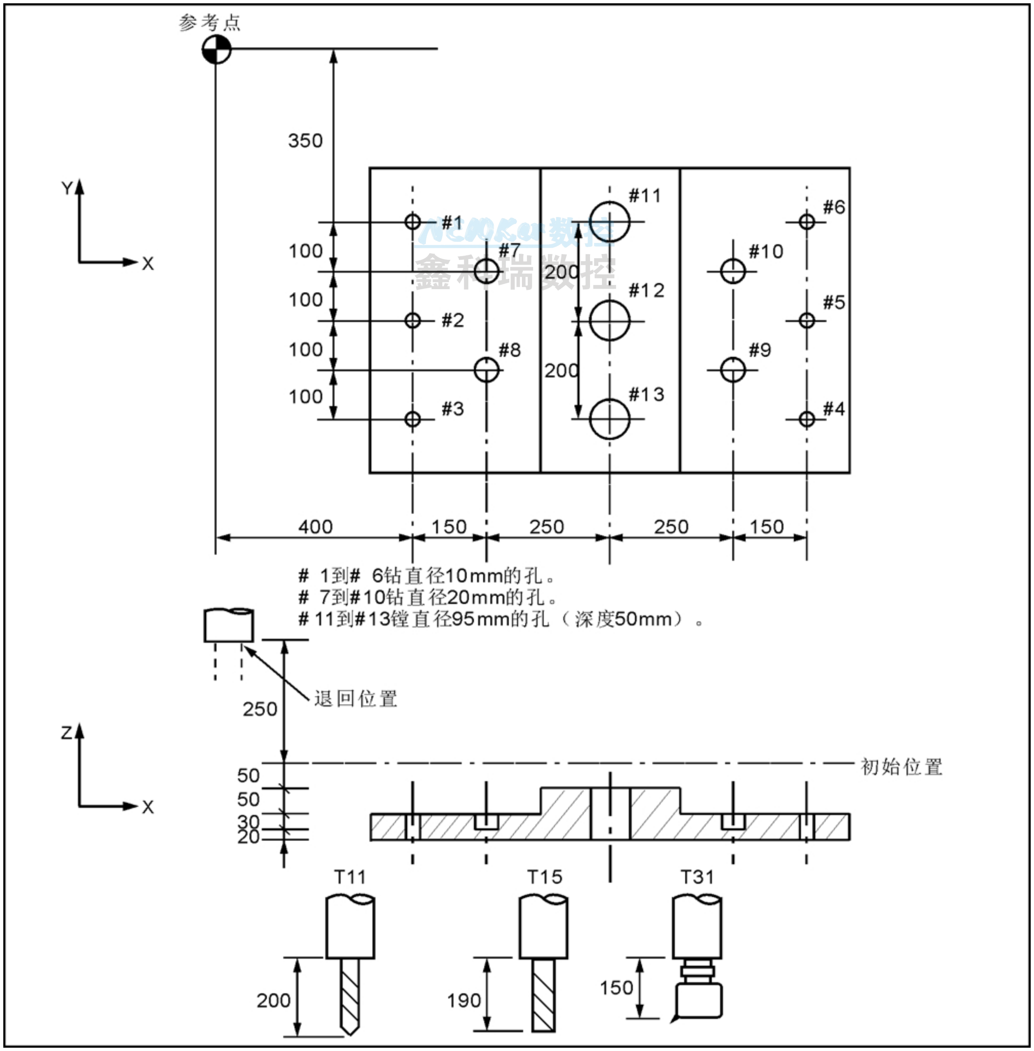
[picture p146: figure]

- 89 -

N5 G01 G41 T01 D01 X-20 Y-20 F400 ；走到 B 点
N6 Y20 | ；刀具在工件左侧切 BC 直线
N7 X20 | ；C 点尖角过渡，切 CD 直线
N8 Y－20 | ；D 点尖角过渡，切 DE 直线
N9 X-25 | ；E 点尖角过渡，切 EB 直线为了工件光
| 洁度一致，多走 5mm
N10 G00 X-40 Y-40 G40 | ；走出圆外
N11 G01 G41 X－20 Y－20 F500 | ；从 A－B 径向伸长 T01 值
N12 Z－20 F100 | ；Z 轴下刀
N13 G91 G02 I20 J20 Y0 X0 | ；切圆
N14 G00 Z50 | ；提刀
N15 G40 G00 X0 Y0 | ；取消刀补
N16 M05 | ；关主轴
N17 M02 | ；程序结束
例 2：

假定使用了三把刀具 T11，T15，T31。其刀具长度补偿值分别为 200（H1）， 190（H1），150（H1）。已经在刀具参数设置中输入。根据零件图的加工要求，可 以编写出程序如下：

- numerical control system -

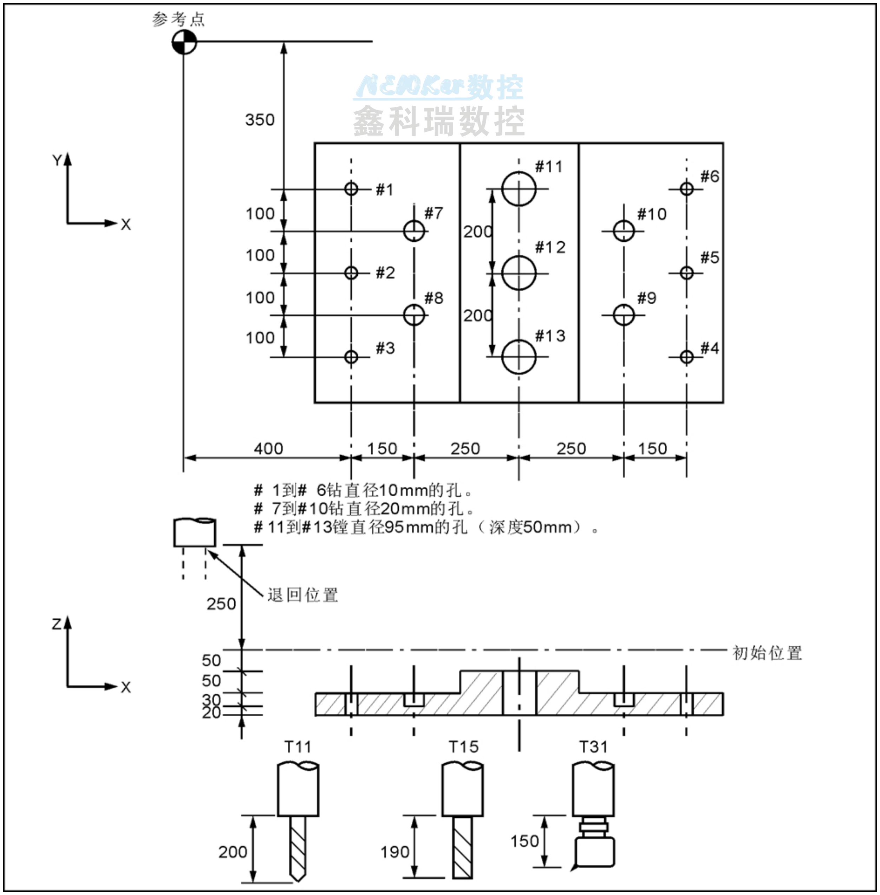
[picture p147: figure]

- 89 -

N5 G01 G41 T01 D01 X-20 Y-20 F400; Walk to point B
N6 Y20
; The tool cuts the BC line on the left side of the workpiece
N7 X20 | ; Point C is a sharp transition, cut the CD line
N8 Y－20 | ; Point D is a sharp transition, cut the line DE
N9 X-25 | ; E point sharp corner transition,
cut EB straight line for the workpiece smooth
The cleanliness is consistent and 5mm more
N10 G00 X-40 Y-40 G40 | ; Go out of the circle
N11 G01 G41 X-20 Y-20 F500; radial elongation from A to B at T01 value
N12 Z－20 F100 | ; The Z-axis cuts down
N13 G91 G02 I20 J20 Y0 X0 | ； circle of contact
N14 G00 Z50 | ； griffe
N15 G40 G00 X0 Y0 | ; Eliminate knife subsidies
N16 M05 | ; Turn the main shaft
N17 M02 | ； end of program
Example 2:

Assuming the use of three cutting tools T11, T15, and T31. Their tool length compensation values are 200 (H1),190 (H1), and 150 (H1) respectively. These parameters have been input into the tool parameter settings. Based on the machining requirements of the part drawing, the program can be written as follows:

- 90 -
N1 G54 X0 Y0 Z0 | ；在参考点设置工件坐标
N2 G90 G00 Z250.0 T11 | ；刀具交换
N3 G43 Z0 H1 | ；初始位置刀具长度偏置
N4 S30 M3 | ；主轴起动
N5 G99 G81 X400.0 Y-350.0 Z-153.0 R-97.0 F120 | ；定位钻 1 孔
N6 Y-550.0 | ；定位钻2 孔并返回到R 点位
| 置
N7 G98 Y-750.0 | ；定位钻 3 孔并返回到初始
| 位置
N8 G99 X1200.0 | ；定位钻4 孔并返回到R 点位
| 置
N9 Y-550.0 | ；定位钻5 孔并返回到R 点位
| 置
N10 G98 Y-350.0 | ；定位钻 6 孔并返回到初始
| 位置
N11 G00 X0 Y0 M5 | ；返回参考点主轴停止
N12 G49 Z250.0 T15 | ；取消刀具长度偏置换刀
N13 G43 Z0 H1 | ；初始位置刀具长度偏置
N14 S20 M3 | ；主轴起动
N15 G99 G82 X550.0 Y-450.0 Z-130.0 R-97.0 F500 | ；定位钻7 孔返回到R 点位置
N16 G98 Y-650.0 | ；定位钻 8 孔返回到初始位
| 置
N17 G99 X1050.0 | ； 定位钻 9 孔返回到 R 点位
| 置
N18 G98 Y-450.0 | ；定位钻10 孔返回到初始位
| 置
N19 G00 X0 Y0 M5 | ；返回参考点主轴停止
N20 G49 Z250.0T31 | ；取消刀具长度偏置换刀
N21 G43 Z0 H1 | ；初始位置刀具长度偏置
N22 S10 M3 | ；主轴起动
N23 G85 G99 X800.0 Y-350.0 Z-153.0 R47.0 F150 | ；定位镗11 孔返回到R 点位
| 置
N24 G91 Y-200.0 | ；定位镗 12 孔返回到 R 点位
| 置
N25 Y-200.0 | ；定位镗13 孔返回到R 点位
| 置
N26 G90 G28 X0 Y0 M5 | ；返回参考点主轴停止
N27 G49 Z0 G80 | ；取消刀具长度偏置

- numerical control system -
- 90 -

N1 G54 X0 Y0 Z0

; Set the coordinates of
the workpiece with reference points
N2 G90 G00 Z250.0 T11 | ; Tool change
N3 G43 Z0 H1 | ; Initial tool length offset position
N4 S30 M3 | ; Spindle starts
N5 G99 G81 X400.0 Y-350.0 Z-153.0 R-97.0 F120 | ; Position the drill 1 hole
N6 Y-550.0 | ; Position the drill 2 holes and return to point R
N7 G98 Y-750.0 | ; Position three holes and return to the initial posi- tion
N8 G99 X1200.0 | ; Position four holes and return to point R
N9 Y-550.0 | ; Position five holes and return to point R
N10 G98 Y-350.0 | ; Position six holes and return to the initial posi- tion
N11 G00 X0 Y0 M5 | ; Return to reference po- int spindle stop
N12 G49 Z250.0 T15 | ; Remove the tool length offset to replace the tool
N13 G43 Z0 H1 | ; Initial tool length offset position
N14 S20 M3 | ; Main shaft starts
N15 G99 G82 X550.0 Y-450.0 Z-130.0 R-97.0 F500 | ; Position the drill 7 back to point R
N16 G98 Y-650.0 | ; Position the drill and return to the initial posi- tion
N17 G99 X1050.0 | ; Position the drill 9 and return to point R
N18 G98 Y-450.0 | ; Position the drill 10 ho- les back to the initial position
N19 G00 X0 Y0 M5 | ; Return to reference po- int spindle stop
N20 G49 Z250.0T31 | ; Remove the tool length offset to replace the tool
N21 G43 Z0 H1 | ; Initial tool length offset position
N22 S10 M3 | ; Main shaft starts
N23 G85 G99 X800.0 Y-350.0 Z-153.0 R47.0 F150 | ; Position boring 11 back to point R
N24 G91 Y-200.0 | ; Position the boring 12 holes back to the R point position
N25 Y-200.0 | ; Position the boring 13 hole and return to point R
N26 G90 G28 X0 Y0 M5 | ; Return to reference po- int spindle stop
N27 G49 Z0 G80 | ; Remove tool length bias

- 91 -
N28 M02 | ；程序停止

例 3：配高速冲床使用方法，本系统 3 个高速输入点； <1>M22(X27) 检测+M295;
<2>M12(X29) 检测+M297;
<3>M18(X28)检测+M30;
T0101
G00 X0
G22 L50 | ；循环次数
WAT+M30 | ；冲头上抬到位，检测输入点 M18(X28)
OUT-M30
G0 U1
WAT+M297 | ；冲头下冲到位，检测输入点 M12(X29)
OUT-M297
G800
M02

2.7 自动对刀仪使用方法

1、参数说明：
定义自动对刀仪功能的宏变量如下（对应杂类参数 P380—P392）： #380: 自动对刀初始定位点的 X 轴机床坐标值(mm);
#381: 自动对刀初始定位点的 Y 轴机床坐标值(mm);

#382: 自动对刀初始定位点及返回点的 Z 轴机床坐标值(mm); #383: 自动对刀快速负向移动速度(mm/min);

#384: 自动对刀慢速正向移动速度(mm/min);

#385: 自动对刀后当前工件坐标系下工件上表面的 Z 轴坐标值(mm); #386: 自动对刀快速到定位点的速度(mm/min);

#387: 自动对刀模式(1 表固定点对刀仪,0 表浮动点对刀仪)。 #388: Z 轴最低机床坐标值(mm);

#389: Z 轴落差值[即对刀仪上表面相对于工件上表面的高度](mm); #390: 自动对刀总的检测次数(1--5)

#391: RTCP 刀具旋转中心到刀柄的距离(mm) 固定点对刀仪是指对刀仪放在一个固定的位置，每次对刀 XYZ 轴都会首先自 动运行到该固定点；而浮动点对刀仪则直接向 Z 轴负向运行寻找对刀仪信号。 默认输入点 X25(常闭)作为自动对刀仪检测点输入。 2、指令：M880（对应 ProgramUser0）自动对刀指令。

3、自动对刀步骤：
a) 设置杂类参数 P380—P391；

- numerical control system -
- 91 -
N28 M02 | ； program halt
Example 3: Use method of high-speed punch press, this system has 3 high-speed input points;
<M1> M22 (X27) detection + M295;
<M2> M12 (X29) detection + M297;
<M3> M18 (X28)
test + M30; T0101
G00 X0
G22 L50 | ； cycle index
WAT+M30 | ; Raise the nozzle to position, and detect input point M
18 (X28)
OUT-M30
G0 U1
WAT+M297 ; The punch is down and the input point M12 (X29) is detected
OUT-M297
G800
M02
2.7 How to Use the Automatic Knife Sharpener
1、 parameter declaration ：
The macro variables defining the automatic tool setter function are as follows (corresponding to miscellaneous parameters P380-P392): #380: Machine tool coordinate value (mm) of the initial X-axis positioning point of automatic tooling;
#381: Machine tool coordinate value of Y-axis initial positioning point of automatic tooling (mm);

#382: Machine tool coordinate values (mm) of Z-axis initial positioning point and return point for automatic tooling;

#383: Automatic tool cutting speed in negative direction (mm/min); #384: Automatic tool slow forward movement speed (mm/min); #385: The Z-axis coordinate value (mm) of the upper surface of the workpiece in the coordinate system of the current workpiece after automatic tooling;

#386: The speed of automatic tool cutting to the positioning point (mm/min);

#387: Automatic tooling mode (1 indicates fixed point tooling instrument, 0 indicates floating point tooling instrument).

#388: Minimum machine tool coordinate value on Z-axis (mm); #389: Z-axis drop value [that is, the height of the upper surface of the knife instrument relative to the upper surface of the workpiece] (mm);

#390: Total number of automatic tooling tests (1-5)

#391: RTCP Distance between tool rotation center and handle (mm) A fixed-point tool setter is one in which the tool setter is placed at a fixed position and the XYZ axis of the tool setter automatically moves to that fixed point each time; while a floating-point tool setter moves directly in the negative direction of the Z-axis to find the tool setter signal.

The default input point X25 (normally closed) is used as the input point for automatic tool setter detection.
2 Instruction: M880 (corresponding to ProgramUser0) automatic tool cutting instruction.
3Automatic tooling step:
a) Set miscellaneous parameters P380-P391;

- 92 -
b) 自动对刀：MDI 运行 M880 指令，自动设置当前刀具的刀具长度 H1,H2=H1+#391。

2.8 自动分中功能使用方法

1、X 轴分中：M884（对应 ProgramUser4）
1）选择当前坐标系如 G54；
2）手动移动 X 到工件负端；MDI 运行 M884 指令；
3）手动移动 X 到工件正端；MDI 运行 M884 指令，自动分中 X 轴，并将工件中点 设置为当前坐标系 X 轴原点，即自动设置当前坐标系如 G54 中 X 轴坐标偏移量； 2、Y 轴分中：M885（对应 ProgramUser5）
1）选择当前坐标系如 G54；
2）手动移动 Y 到工件负端；MDI 运行 M885 指令；
3）手动移动 Y 到工件正端；MDI 运行 M885 指令，自动分中 Y 轴，并将工件中点 设置为当前坐标系 Y 轴原点，即自动设置当前坐标系如 G54 中 Y 轴坐标偏移量。 3、内框 X 轴检测自动分中：M886（对应 ProgramUser6）
1）选择当前坐标系如 G54；
2）手动移动分中仪到工件内框中；
3）MDI 运行 M886 指令，自动检测输入点 X31，自动分中 X 轴，并将工件中点设 置为当前坐标系 X 轴原点，并移动到 X 轴原点；
4、内框 Y 轴检测自动分中：M887（对应 ProgramUser7）
1）选择当前坐标系如 G54；
2）手动移动分中仪到工件内框中；
3）MDI 运行 M887 指令，自动检测输入点 X31，自动分中 Y 轴，并将工件中点设 置为当前坐标系 Y 轴原点，并移动到 Y 轴原点；
5、外框 XY 对刀仪自动分中,G160/M893/M894（对应 ProgramUser13/14）: 要求手动移动对刀仪到工件中心,设置工件坐标为 G54X0Y0Z0,程序如下:
#300=600 | ;X 方向工件大小

#301=400 | ;Y 方向工件大小

#302=10 | ;检测长度

#303=20 | ;Z 方向抬起点;

#304=-10 | ;Z 方向检测点;

G54 G0 X0 Y0 Z10 ;运行到工件中心
G160 | ;调用外框分中程序
……
Y31:检测仪使能;
X40: 检测仪准备好信号,到位信号
X41:检测仪电池电压低;
X42:检测头与接收器之间有遮挡物;
6、内框 XY 对刀仪自动分中,G161/M893/M894（对应 ProgramUser13/14）:

- numerical control system -
- 92 -
b) Automatic tool: MDI runs the M880 command, automatically sets the tool length of the current tool H1, H2=H1+#391.
2.8 How to Use the Automatic Partitioning Function
1、 In the X-axis section: M884 (corresponding to ProgramUser4)
1） Select the current coordinate system such as G54;
2） Move X manually to the negative end of the workpiece; MDI runs the M884 command;
3） Move X manually to the front end of the workpiece; MDI runs the M 884 instruction to automatically center the X-axis and set the midpoint of the workpiece as the origin of the current coordinate system's X-axis, that is, automatically set the current coordinate system as the X-axis offset in G54;
2、 In the Y-axis section: M885 (corresponding to ProgramUser5)
1） Select the current coordinate system, such as G54;
2） Move Y manually to the negative end of the workpiece; MDI runs the M885 instruction;
3） Move Y to the front end of the workpiece manually; MDI runs the M 885 instruction to automatically center the Y-axis and set the midpoint of the workpiece as the origin of the current coordinate system's Y-axis, that is, automatically set the current coordinate system as the Y-axis offset in G54.
3 、 Automatic centering of inner frame X-axis detection: M886 (corresponding to ProgramUser6)
1） Select the current coordinate system, such as G54;
2） Manual move the center instrument to the inner frame of the workpiece;
3） MDI runs the M886 command to automatically detect the input point X31, automatically divide the X-axis, set the midpoint of the workpiece as the current coordinate system X-axis origin, and move to the X-axis origin;
4 、 Automatic centering of inner frame Y-axis detection: M887 (corresponding to ProgramUser7)
1） Select the current coordinate system, such as G54;
2） Manual move the center instrument to the inner frame of the workpiece;
3） MDI runs the M887 command, automatically detects the input point X31, automatically divides the Y-axis, sets the midpoint of the workpiece as the current coordinate system Y-axis origin, and moves to the Y-axis origin;
5 、 In the automatic centering of the outer frame XY, G160/M 893/M894 (corresponding to ProgramUser13/14): manually move the tool setter to the center of the workpiece and set the coordinates of the workpiece as G54X0Y0Z0. The program is as follows:
#300=600 | ; X-direction workpiece size

#301=400 | ; Y direction workpiece size

#302=10 | ; Detection length

#303=20 | ; Z-direction lifting point;

#304=-10 | ; Z direction detection

point; G54 G0 X0 Y0 Z10; Run to
the center of the workpiece G
160 ; Calls the outer frame subprogram
……
Y31: Detector enabled;
X40: The detector is ready for the signal and the arrival signal
X41: The battery voltage of the detector is low;
X42: There is an obstacle between the detection head and the receiver; 6 、 In the automatic centering of the inner frame XY, G161/M893/M 894 (corresponding to ProgramUser13/14):

- 93 -

要求手动移动对刀仪到工件中心,设置工件坐标为 G54X0Y0Z0,程序如下:
#300=600 | ;X 方向工件大小

#301=400 | ;Y 方向工件大小

#302=10 | ;检测长度

#303=20 | ;Z 方向抬起点;

#304=-10 | ;Z 方向检测点;

G54 G0 X0 Y0 Z10 ;运行到工件中心
G161 | ;调用外框分中程序
……
Y31:检测仪使能;
X40: 检测仪准备好信号,到位信号
X41:检测仪电池电压低;
X42:检测头与接收器之间有遮挡物;
注意：分中指令 M884-M887,M891,M892 必须先将外部坐标偏移量清为 0。

2.9 坐标轴随动功能使用方法

1、方法 1：轴类参数 P414,此方法可以不开启随动轴;
此参数设置 7/8/9 表 A 随 X/Y/Z;17/18/19 表 C 随 X/Y/Z;27/28/29 表 B 轴随 X/Y/Z;14/15/16 表 Xs 随 X/Y/Z; 24/25/26 表 Ys 随 X/Y/Z;23 表 Ys 随 Xs;
另外，如果 D5..D20=1/表 A 随 X/Y/Z,C 随 X/Y/Z,B 随 X/Y/Z，Xs 随 X/Y/Z， Ys 随 X/Y/Z，Ys 随 Xs，这样可以实现三轴同时 随动功能。 即D5=1(+32)表A随X；D6=1(+64)表A随Y；D7=1(+128)表A随Z；D8=1(+256) 表 C 随 X；D9=1(+512)表 C 随 Y；D10=1(+1024)表 C 随 Z；D11=1(+2048)表 B 随 X；D12=1(+4096)表 B 随 Y；D13=1(+8192)表 B 随 Z；D14=1(+16384)表 Xs 随 X； D15=1(+32768)表 Xs 随 Y；D16=1(+65536)表 Xs 随 Z；D17=1(+131072)表 Ys 随 X；D18=1(+262144)表 Ys 随 Y；D19=1(+524288)表 Ys 随 Z；D20=1(+1048576)表 Ys 随 Xs。
2、方法 2：此方法用指令指定哪个轴随动，手动时不随动，自动运行时随 动，坐标也随动。
M123: 开启 Y 轴自动时随动于 X 轴运动；
M124: 关闭 Y 轴随动于 X 轴运动；
M125: 开启 A 轴自动时随动于 X 轴运动；
M126: 关闭 A 轴随动于 X 轴运动。
注意：隋动功能开启后，反向间隙补偿与螺距误差补偿是各轴补偿各轴的；

2.10 四轴/五轴系统 RTCP 功能

1、用户指令：
M601 开启五轴 RTCP 的一个旋转轴补偿功能。

- numerical control system -
- 93 -

The tool changer is required to be manually moved to the center of the workpiece and the workpiece coordinates are set as G54X0Y0Z0. The program is as follows:

#300=600

; X-direction workpiece size

#301=400

; Y direction workpiece size
#302=10 | ; Detection length

#303=20 | ; Z-direction lift point;

#304=-10 | ; Z direction dete- ction point;

G54 G0 X0 Y0 Z10; run to the center of the workpiece
G161 | ; Calls the outer frame subprogram
……
Y31: Detector enabled;
X40: The detector is ready for the signal and the arrival signal
X41: The battery voltage of the detector is low;
X42: There is an obstacle between the detection head and the receiver; Note: The external coordinate offset must be cleared to 0 before the instruction M884-M887, M891, and M892 can be used.
2.9 Coordinate Axis Follower Function Usage
1、 Method 1: Shaft parameter P414, this method can not open the follower shaft;
This parameter setting: Table A follows X/Y/Z; Table C follows X/Y/ Z; Table B follows X/Y/Z; Table B follows X/Y/Z; Table Xs follows X/Y/Z; Table Ys follows X/Y/Z; Table Ys follows Xs;
In addition, if D5..D20=1/ table A follows X/Y/Z, C follows X/Y/Z, B follows X/Y/Z, Xs follows X/Y/Z, Ys follows X/Y/Z, and Ys follows Xs, the three-axis simultaneous tracking function can be achieved.
D5=1 (+32) in Table A (X); D6=1 (+64) in Table A (Y); D7=1 (+128) in Table A (Z); D8=1 (+256) in Table C (X); D9=1 (+512) in Table C (Y); D 10=1 (+1024) in Table C (Z); D11=1 (+2048) in Table B (X); D12=1 (+4096) in Table B (Y); D13=1 (+8192) in Table B (Z); D14=1 (+16384) in Table Xs (X); D15=1 (+32768) in Table Xs (Y); D16=1 (+65536) in Table Xs (Z); D17=1 (+131072) in Table Ys (X); D18=1 (+262144) in Table Ys (Y); D 19=1 (+524288) in Table Ys (Z); D20=1 (+1048576) in Table Ys (Xs).
2 、 Method 2: This method uses the instruction to specify which axis is followed, not followed when manual operation, followed when automatic operation, and coordinates are also followed.
M123: When Y-axis is automatically opened, it moves along with X-axis;
M124: Close the Y-axis follower to the X-axis movement;
M125: When the A-axis is automatically opened, it moves along with the X-axis;
M126: Close the A-axis follower to the X-axis movement.
Note: After the Sui dynamic function is enabled, the reverse clearance compensation and pitch error compensation are for each axis compensation;
2.10 Four-Axis/five-Axis System RTCP Function
1、 User Instructions:
M601, enables a rotational axis compensation function of the five-axis RTCP.

- 94 -

机床结构型式参数等于 10 时：只对旋转 B 轴进行补偿。 机床结构型式参数等于 11 时：只对旋转 A 轴进行补偿。 机床结构型式参数等于 12 时：只对旋转 A 轴进行补偿。 机床结构型式参数等于 13 时：只对旋转 A 轴进行补偿。 机床结构型式参数等于 14 时：只对旋转 A 轴进行补偿。 机床结构型式参数等于 15 时：只对旋转 B 轴进行补偿。 M602/G43.4 开启五轴 RTCP 的两个旋转轴补偿功能，对两个旋转轴均进 行补偿。
M600/G49 关闭五轴 RTCP 功能。
在 M601 或 M602 状态下，手动移动 Z 轴时是沿刀具方向前进或后退，而 不是单独机床坐标的 Z 轴移动。
辅助继电器 M1060: 循环切换 M600 与 M602 状态，通过编制梯形图用按 键实现手动快捷切换 M600 与 M602 状态。
2、机床结构型式、坐标轴名称及方向定义规则：
A 轴为绕直线轴 X 轴旋转的轴，旋转正方向满足右手坐标系规则。 B 轴为绕直线轴 Y 轴旋转的轴，旋转正方向满足右手坐标系规则。 C 轴为绕直线轴 Z 轴旋转的轴，旋转正方向满足右手坐标系规则。 注意：
1）直线轴的运动方向也是以刀具相对于工件的运动方向定义的； 2）与刀具在一起的旋转轴旋转方向是以刀具相对于工件的旋转方向定义的； 3）与工作台在一起的旋转轴旋转方向是以绕工作台自身的旋转方向定义的。

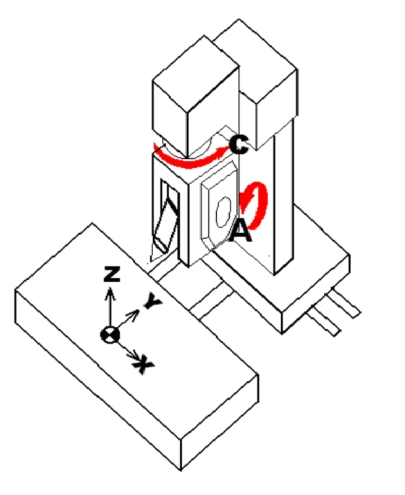
[picture p148: figure]

B 轴刀具-A 轴平台五轴机床(10) AC 轴刀具回转型五轴机床(11)

- numerical control system -
- 94 -

When the structural type parameter of the machine tool is equal to 10, only the B-axis rotation compensation is performed. When the structural type parameter of the machine tool is equal to 11, compensation is only performed for the rotating A axis. When the structural type parameter of the machine tool is equal to 12, compensation is only performed on the rotating A axis. When the structural type parameter of the machine tool is equal to 13, compensation is only performed on the rotating A axis. When the structural type parameter of the machine tool is equal to 14, compensation is only performed on the rotating A axis. When the structural type parameter of the machine tool is equal to 15, only the B-axis rotation compensation is performed. M602/G43.4 Enable the two rotation axis compensation functions of the five-axis RTCP, and compensate both rotation axes.
M600/G49 Turn off the five-axis RTCP function.
In the M601 or M602 state, manual movement of the Z axis is forward or backward along the tool direction, rather than a separate machine coordinate Z axis movement.
Auxiliary relay M1060: The status of M600 and M602 is switched in a loop. The status of M600 and M602 can be manually switched quickly by programming ladder diagram and using keys.
2, Machine Tool Structure Type, Coordinate Axis Name and Direction Definition Rules:
Axis A is the axis that rotates around the straight line axis X, and the rotation direction satisfies the right hand coordinate system rule. The B-axis is the axis that rotates around the straight-line axis Y-axis, and the rotation direction satisfies the right-hand coordinate system rule.
The C-axis is the axis that rotates around the straight-line axis Z-axis, and the rotation direction satisfies the right-hand coordinate system rule. Note:
1） The direction of motion of the linear axis is also defined by the direction of motion of the tool relative to the workpiece;
2） The rotation direction of the rotating shaft associated with the tool is defined by the rotation direction of the tool relative to the workpiece;
3） The rotation direction of the rotating shaft associated with the worktable is defined by the rotation direction around the worktable itself.

B-axis tool-A axis platform five-axis machine tool (10)

AC axis tool return five-axis machine tool (11)

- 95 -

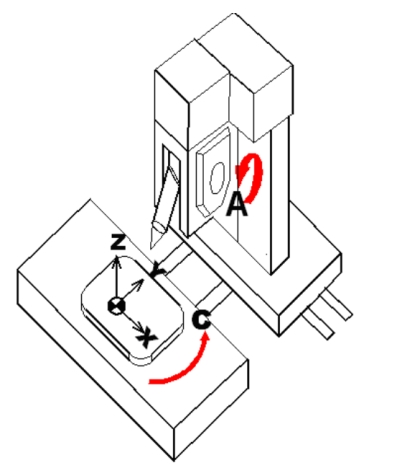
[picture p149: figure]

AC 轴刀具平台型五轴机床(12) | A 轴刀具-C 轴平台五轴机床(13)

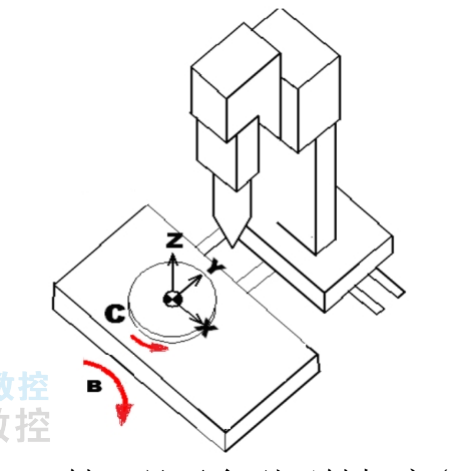
[picture p150: figure]

A 轴刀具-B 轴平台五轴机床(14) | BC 轴刀具平台型五轴机床(15)

3、各种五轴机床的旋转轴机床坐标零点位置定义规则：
B 轴刀具-A 轴平台混和型五轴数控机床（10）：
方向与 Y 轴正方向一致的位置定义为 A 轴机床坐标零点。 刀尖与 Z 轴负方向一致的位置定义为 B 轴机床坐标零点。 AC 轴刀具回转型五轴数控机床（11）：
刀尖与 Z 轴负方向一致的位置定义为 A 轴机床坐标零点。 方向与 Y 轴负方向一致的位置定义为 C 轴机床坐标零点。 AC 轴平台回转型五轴数控机床（12）：
方向与 Y 轴正方向一致的位置定义为 A 轴机床坐标零点。 方向与 X 轴正方向一致的位置定义为 C 轴机床坐标零点。 A 轴刀具-C 轴平台混和型五轴数控机床（13）：
刀尖与 Z 轴负方向一致的位置定义为 A 轴机床坐标零点。 方向与 X 轴正方向一致的位置定义为 C 轴机床坐标零点。 A 轴刀具-B 轴平台混和型五轴数控机床（14）：
刀尖与 Z 轴负方向一致的位置定义为 A 轴机床坐标零点。 方向与 Z 轴正方向一致的位置定义为 B 轴机床坐标零点。

- numerical control system -
- 95 -

AC axis tooling platform type five axis machine tool (12)

Five-axis machine tool with A-axis tool and C-axis table (13)

Five-axis machine tool with A-axis tool and B-axis table (14)

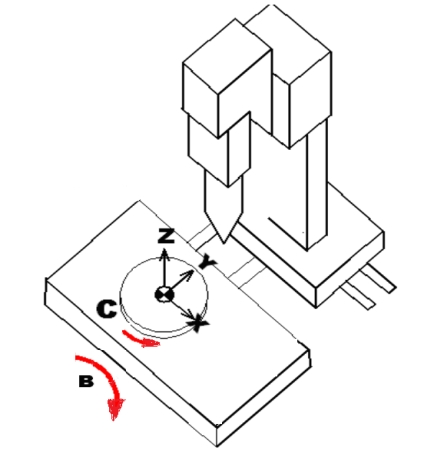
[picture p151: figure]

BC axis tool platform type five axis machine tool (15)
3, Definition Rules for the Zero Point Position of the Rotating Axis of Various Five-Axis Machine Tools:
B-axis tool-A axis platform hybrid five-axis CNC machine tool (10):
The position aligned with the positive direction of the Y-axis is defined as the A-axis machine coordinate zero point. The position aligned with the negative direction of the Z-axis is defined as the B-axis machine coordinate zero point.
AC axis tool return five-axis CNC machine tool (11):
The position where the tip is aligned with the negative direction of the Z-axis is defined as the A-axis machine coordinate zero point.
The position in the direction of the negative Y-axis is defined as the zero point of the C-axis machine tool. AC axis platform rotary five-axis CNC machine tool (12):
The position in the positive direction of the Y-axis is defined as the A-axis machine coordinate zero point. The position that is consistent with the positive direction of the X-axis is defined as the C-axis machine coordinate zero point.
A-axis tool-C-axis platform hybrid five-axis CNC machine tool (13):
The position where the tip of the knife is aligned with the negative direction of the Z axis is defined as the A axis machine coordinate zero point.
The position in the positive direction of the X-axis is defined as the C-axis machine coordinate zero point. A-axis tool-B-axis platform hybrid five-axis CNC machine tool (14):
The position where the tip of the knife is aligned with the negative direction of the Z axis is defined as the A axis machine coordinate zero point.
The position that is consistent with the positive direction of the Z-axis is defined as the B-axis machine coordinate zero point.

- 96 -

BC 轴平台回转型五轴数控机床（15）：
方向与 Z 轴正方向一致的位置定义为 B 轴机床坐标零点。 方向与 X 轴正方向一致的位置定义为 C 轴机床坐标零点。 4、加工参数：
551,五轴数控机床结构型式(10—99)
等于 10 时表示 B 轴刀具-A 轴平台混和型五轴数控机床；
等于 11 时表示 AC 轴刀具回转型五轴数控机床（总线系统）；
等于 12 时表示 AC 轴平台回转型五轴数控机床（总线系统）；
等于 13 时表示 A 轴刀具-C 轴平台混和型五轴数控机床（总线系统）； 等于 14 时表示 A 轴刀具-B 轴平台混和型五轴数控机床（总线系统）； 等于 15 时表示 BC 轴平台回转型五轴数控机床（总线系统）；
552, | RTCP | 补 偿 反 向 和 坐 标 系 重 合 ( | 反 向
10/14:B+4,A+8;11/12/13:A+4,C+8;坐标系重合+16:[12A 轴,13C 轴,14B 轴]对应 编程和工件坐标系重合;+32:12C 轴对应编程和工件坐标系重合）
类型 10/14(B+4;A+8):B 轴补偿反向+4；A 轴补偿反向+8;
类型 11/12/13(A+4;C+8):A 轴补偿反向+4；C 轴补偿反向+8;
类型 15(B+4;C+8):B 轴补偿反向+4；C 轴补偿反向+8;
+16表示: 类型12A轴/13C轴/14B/15B轴的机床坐标对应编程坐标系和工 件坐标系重合,否则表该回转工作台轴的机床坐标为 0 时对应编程坐标系和工件 坐标系重合;
+32 表示: 类型 12/15 回转工作台 C 轴的机床坐标对应编程坐标系和工件 坐标系重合,否则表 C 轴的机床坐标为 0 时对应编程坐标系和工件坐标系重合; 553,五轴数控回转平台中心的机床坐标 1(um)
机床结构型式参数等于 10 时：A 轴回转中心的 Y 轴的机床坐标。 机床结构型式参数等于 11 时：无意义。
机床结构型式参数等于 12 时：A 轴回转中心的 Y 轴的机床坐标。 机床结构型式参数等于 13 时：C 轴回转中心的 X 轴的机床坐标。 机床结构型式参数等于 14 时：B 轴回转中心的 X 轴的机床坐标。 机床结构型式参数等于 15 时：B 轴回转中心的 X 轴的机床坐标。 554,五轴数控回转平台中心的机床坐标 2(um)
机床结构型式参数等于 10 时：A 轴回转中心的 Z 轴的机床坐标。 机床结构型式参数等于 11 时：无意义。
机床结构型式参数等于 12 时：A 轴回转中心的 Z 轴的机床坐标。 机床结构型式参数等于 13 时：C 轴回转中心的 Y 轴的机床坐标。 机床结构型式参数等于 14 时：B 轴回转中心的 Z 轴的机床坐标。 机床结构型式参数等于 15 时：B 轴回转中心的 Z 轴的机床坐标。 555,测量五轴数控回转平台中心时的刀长(um)
机床结构型式参数等于 10 时：测量 A 轴回转中心时的刀长。 机床结构型式参数等于 11 时：无意义。
机床结构型式参数等于 12 时：测量回转平台中心时的刀补值 H1

- numerical control system -
- 96 -

BC axis platform rotary five-axis CNC machine tool (15):
The position that is consistent with the positive direction of the Z-axis is defined as the B-axis machine coordinate zero point.
The position in the positive direction of the X-axis is defined as the C-axis machine coordinate zero point.
4. Processing Parameters:
551, five-axis CNC machine tool structure type (10-99)
When it is equal to 10, it means B-axis tool-A axis platform hybrid five-axis CNC machine tool; When it is equal to 11, it is an AC axis tool return five-axis CNC machine tool (bus system);
When it is equal to 12, it means AC axis platform rotary five-axis CNC machine tool (bus system);
When it is equal to 13, it means that the A-axis tool-C-axis platform hybrid five-axis CNC machine tool (bus system); When it is equal to 14, it indicates the A-axis tool-B-axis platform hybrid five-axis CNC machine tool (bus system); when it is equal to 15, it indicates the BC-axis platform rotary five-axis CNC machine tool (bus system);
552. RTCP compensation for reverse and coordinate system alignment (reverse: 10/14: B+4, A+8; 11/12/13: A+4, C+8; coordinate system alignment +16: [12A-axis, 13C-axis, 14B-axis] corresponds to programming and workpiece coordinate system alignment; +32:12C-axis corresponds to programming and workpiece coordinate system alignment)
Type 10/14 (B+4; A+8): B-axis compensation reverse +4; A-axis compensation reverse +8;
Type 11/12/13 (A+4; C+8): A-axis compensation reverse +4; C-axis compensation reverse +8;
Type 15 (B+4; C+8): B-axis compensation reverse +4; C-axis compensation reverse +8;
+16 indicates: The machine tool coordinates of type 12A axis/13C axis/14B/15B axis correspond to the programming coordinate system and the workpiece coordinate system coincide, otherwise the machine tool coordinates of the rotary table axis are 0 when the programming coordinate system and the workpiece coordinate system coincide;
+32 indicates: Type 12/15, the machine tool coordinate corresponding to the rotary worktable C-axis coincides with the programming coordinate system and the workpiece coordinate system; otherwise, the machine tool coordinate corresponding to the rotary worktable C-axis is 0 when the programming coordinate system and the workpiece coordinate system coincide;
553, machine tool coordinates at the center of the five-axis CNC rotary table 1 (um)
When the structural type parameter of the machine tool is equal to 10: the machine tool coordinates on the Y-axis of the A-axis rotation center.
When the structural type parameter of the machine tool is equal to 11, it is meaningless.
When the structural type parameter of the machine tool is equal to 12: the machine tool coordinates on the Y-axis of the A-axis rotation center.
When the structural type parameter of the machine tool is equal to 13: the machine tool coordinate of the X axis of the C-axis rotation center.
When the structural type parameter of the machine tool is equal to 14, it is the machine tool coordinate of the X axis of the B-axis rotation center.
When the structural type parameter of the machine tool is equal to 15, it is the machine tool coordinate of the X axis of the B-axis rotation center.
554, machine tool coordinates 2 (um) at the center of the five-axis CNC rotary table
When the structural type parameter of the machine tool is equal to 10: the Z axis coordinate of the A axis rotation center. When the structural type parameter of the machine tool is equal to 11, it is meaningless.
When the structural type parameter of the machine tool is equal to 12: the machine tool coordinates of the Z axis at the center of rotation of the A axis.
When the structural type parameter of the machine tool is equal to 13: the machine tool coordinates on the Y-axis of the C-axis rotation center.
When the structural type parameter of the machine tool is equal to 14, it is the machine tool coordinate of the Z axis of the B-axis rotation center.
When the structural type parameter of the machine tool is equal to 15, it is the machine tool coordinate of the Z axis of the B-axis rotation center.
55, measuring the tool length (um) when the center of the five-axis CNC rotary platform is measured
When the structural type parameter of the machine tool is equal to 10, measure the tool length when the A axis rotation center is turned.
When the structural type parameter of the machine tool is equal to 11, it is meaningless.
When the structural type parameter of the machine tool is equal to 12, the tool compensation value H1 is measured when the center of the rotary platform is measured

- 97 -

机床结构型式参数等于 13 时：测量 C 轴回转中心时的刀长。 机床结构型式参数等于 14 时：测量 B 轴回转中心时的刀长。 机床结构型式参数等于 15 时：测量回转平台中心时的刀补值 H1 556,AC/BC 轴平台回转型五轴机床的 C 轴回转中心 X/Y 轴机床坐标(um) 机床结构型式参数等于 12 时此参数有效。
557,AC 轴刀具回转型的 AC 轴线偏移量(um)
机床结构型式参数等于 11时此参数有效，在AC轴的机床坐标零点位置，A 轴的轴心线在 C 轴的轴心线前面时(Y 轴方向)，偏移值(Y 轴方向)设为负值，反 之设为正值。
558,AC 轴刀具回转型的 C 轴与主轴在 X 方向上的偏移量(um) 机床结构型式参数等于 11时此参数有效，在AC轴的机床坐标零点位置， C 轴的轴心线与主轴主轴心线的偏移值(X 轴方向),可以设置为正负。 5、RTCP 对刀操作
在系统刀补界面按‘H’用于自动测量刀长：
注意：对刀过程中，C 轴要保持在 0 度位置，确保 A 轴正好是绕 X 旋转。 （1）机床结构型式参数等于 10 时：
用于自动测量刀尖点到 B 轴回转中心的距离。
首先换刀选择刀具号，让刀尖点处于工件上某一标记点，按‘H’输入 1 设 定的第一个点，然后将刀具提起来，转动一下 B 轴，转动角度不能太小，再慢慢 移动 X 轴和 Z 轴，让刀尖点处于工件上的同一标记点，按‘H’输入 2 设定的第 二个点，系统则自动计算出刀尖点到 B 轴回转中心的距离(um)，并将其保存到当 前光标处的 H2 中。系统进行 RTCP 的 B 轴补偿计算时会自动调用当前刀具号对应 的 H2 值。
（2）机床结构型式参数等于 11 或 13 或 14 时：
用于自动测量刀尖点到 A 轴回转中心的距离。
首先换刀选择刀具号，让刀尖点处于工件上某一标记点，按‘H’输入 1 设 定的第一个点，然后将刀具提起来，转动一下 A 轴，转动角度不能太小，再慢慢 移动 Y 轴和 Z 轴，让刀尖点处于工件上的同一标记点，按‘H’输入 2 设定的第 二个点，系统则自动计算出刀尖点到 A 轴回转中心的距离(um)，并将其保存到当 前光标处的 H2 中。系统进行 RTCP 的 A 轴补偿计算时会自动调用当前刀具号对应 的 H2 值。更换刀具时就需要进行该距离的测量。因为 H2 用于保存刀尖点到回转 中心的距离，作为计算 RTCP 补偿的依据，所以 G43/G44 刀具长度补偿就不能调 用 H2，只能使用每一把刀的 H1。当需要下刀或提刀修改 G54 的 Z 偏移值或每一 把刀的 H1，不能修改每一把刀的 H2，注意 H2 反应的是真实的刀具长度值，必须 与实际一致，否者补偿计算就不正确。程序中需要编入当前选那一把刀，系统才 会调用相应刀具的 H2 值。刀具长度补偿 G43/G44 可以与 RTCP 补偿 M601/M602 指 令同时使用。
如果对刀不准或者刀具磨损了，那么就需要同时对 H1 和 H2 进行增量修改： 在刀补界面修改长度补偿值时, 在前面多输入 H 字符表修改 RTCP 的 H2 刀 具长度值.

- numerical control system -
- 97 -

When the structural type parameter of the machine tool is equal to 13, measure the tool length when the C-axis rotation center is turned.
When the structural type parameter of the machine tool is equal to 14, measure the tool length when the B axis rotation center is measured.
When the structural type parameter of the machine tool is equal to 15, measure the tool compensation value H1 when the center of the rotary platform is measured
556, AC/BC axis platform rotary five-axis machine tool C-axis rotation center X/Y machine tool coordinates (um) the machine tool structure type parameter is equal to 12 when this parameter is valid.
557 AC axis tool return-to-center line offset (um)
When the machine tool structural type parameter is equal to 11, this parameter is valid. At the zero point position of the machine tool coordinate on the AC axis, when the A-axis axis line is in front of the C-axis axis line (Y-axis direction), the offset value (Y-axis direction) is set to a negative value, otherwise it is set to a positive value.
558, AC tool return type C axis and spindle offset in the X direction (um)
This parameter is valid when the machine tool structural type parameter equals 11. At the zero point position of the machine tool coordinate on the AC axis, the offset value (X direction) between the C-axis axis line and the spindle axis line can be set as positive or negative. 5、 RTCP, knife operation
Press "H" on the system tool supplement interface to automatically measure the tool length:
Note: During the cutting process, keep the C axis at 0 degrees and make sure that the A axis is rotating around X.
（1） When the structural type parameter of the machine tool is equal to 10:
Used to automatically measure the distance from the tip point to the B-axis rotation center.
First, switch to the tool number and position the tool tip at a designated mark on the workpiece. Press 'H' to input point 1 of the first setup. Lift the tool and rotate the B-axis slightly (avoid excessive rotation). Slowly adjust the X and Z axes until the tool tip aligns with the same mark. Press 'H' again to input point 2. The system automatically calculates the distance (um) from the tool tip to the B-axis rotation center and stores it in H2 at the current cursor position. During RTCP B-axis compensation calculations, the system automatically retrieves the corresponding H2 value from the current tool number.
（2） When the structural type parameter of the machine tool is equal to 11,13 or 14:
Used to automatically measure the distance from the tip point to the A-axis rotation center.
First, switch the tool and select its number. Position the tool tip at a designated mark on the workpiece. Press 'H' to input point 1 (the first preset position). Lift the tool and rotate the A-axis slightly (avoid excessive rotation), then gradually adjust the Y-axis and Z-axis until the tool tip aligns with the same mark. Press 'H' again to input point 2. The system automatically calculates the distance (um) from the tool tip to the A-axis rotation center and stores it in H2 at the current cursor position. During RTCP A-axis compensation calculations, the system automatically retrieves the corresponding H2 value for the selected tool. This measurement is essential when changing tools, as H2 stores the actual distance to the rotation center for RTCP compensation. Therefore, G43/G44 tool length compensation cannot use H2 but must employ each tool's H1. When modifying G54 Z offsets or individual tool H1 during tool lowering/raising operations, note that H2 reflects the actual tool length value which must match reality; otherwise, compensation calculations will be incorrect. The system only activates the appropriate H2 value based on the currently selected tool. Tool length compensation G43/G44 can be used concurrently with RTCP compensation commands M601/M602.
If the tool is not accurate or worn, then incremental modifications to both H1 and H2 are required:
When modifying the length compensation value in the tool supplement interface, input H character table to modify the RTCP H2 tool length value.

- 98 -

例如: 按下 Enter 后在对话框输入 HE123.56 表按绝对方式修改 H2 为 123.56 毫米；按下 Enter 后在对话框输入 H8.6 表按增量方式修改 H2 为原始值加 上 8.6 毫米。
在系统主界面按‘R’用于自动测量回转平台中心的机床坐标值，即自动确 定轴参数 553,554,555,和 556 号：
（1）机床结构型式参数等于 10 时：
自动测量 A 轴回转中心 Y(P553)和 Z(P554)机床坐标。
首先换刀选择刀具号，将 B 轴的机床坐标走到零点，即 B 轴垂直于 X 轴，然 后移动 Y 轴和 Z 轴使刀尖处于工件(装夹在 A 轴上)上某一标记点，按‘R’输入 1 设定第一个点，然后将刀具提起来，转动一下 A 轴，转动角度尽量大一点，再慢 慢移动 Y 轴和 Z 轴，让刀尖点处于工件上的同一标记点，按‘R’输入 2 设定第 二个点，依次方法设定第三个点，系统会自动计算出 A 轴回转中心的 Y 和 Z 机床 坐标值，并且记录当前刀长到参数“测量五轴数控回转平台中心时的刀长(um)” 中。刚刚装机或重新安装 A 轴时才需要测量 A 轴回转中心的 Y 和 Z 机床坐标值， 更换刀具时不需要进行该操作。自动测量 A 轴回转中心之前必须先测量好刀尖点 到 B 轴回转中心的距离才行。
参数“555,测量五轴数控回转平台中心时的刀长(um)”记录的当前刀具的 H2 刀具长度值。
（2）机床结构型式参数等于 11 时：
不需要该操作。
（3）机床结构型式参数等于 12 时：
第一步:自动测量 A 轴回转中心 Y(P553)和 Z(P554)机床坐标。 首先换刀选择刀具号，然后移动 Y 轴和 Z 轴使刀尖处于工件(装夹在 A 轴上) 上某一标记点，按‘R’输入 1 设定第一个点,然后将刀具提起来，转动一下 A 轴， 转动角度尽量大一点，再慢慢移动 Y 轴和 Z 轴，让刀尖点处于工件上的同一标记 点，按‘R’输入 2 设定第二个点，依次方法设定第三个点，系统会自动计算出 A/B 轴回转中心的 Y 和 Z 机床坐标值。对于有多把刀具时，需要将长度补偿值 H1 设置好后，再进行该项操作。
参数“555,测量五轴数控回转平台中心时的刀长(um)”记录的当前刀具的 H1 补偿值.如果不使用刀具长度补偿 G43 时，需要将长度补偿值 H1 清 零。刚刚装机或重新安装 A 轴时才需要测量 A 轴回转中心的 Y 和 Z 机床坐标值， 更换刀具时不需要进行该操作。
第二步: 用于自动测量 C 轴回转中心的 X(P556)机床坐标值。 首先换刀选择刀具号，将 A 轴的机床坐标走到零点，即 C 回转轴处于水平位置， 然后移动 X 轴和 Y 轴使刀尖处于工件(装夹在 C 轴上)上某一标记点，按‘R’输 入 A 设定第一个点，然后将刀具提起来，转动一下 C 轴，转动角度尽量大一点， 再慢慢移动 X 轴和 Y 轴，让刀尖点处于工件上的同一标记点，按‘R’输入 B 设定第二个点，依次方法输入 C 设定第三个点，系统会自动计算出 C 轴回转中 心的 X 机床坐标值(P556)。
刚刚装机或重新安装 C 轴时才需要测量 C 轴回转中心的 X 机床坐标值，更换

- numerical control system -
- 98 -

For example, press Enter and enter HE123.56 in the dialog box to modify H2 to 123.56 mm in absolute mode; press Enter and enter H8.6 in the dialog box to modify H2 to the original value plus 8.6 mm in incremental mode.
Press "R" on the main interface of the system to automatically measure the machine tool coordinates at the center of the rotary table, that is, automatically determine the axis parameters 553,554,555 and 556:
（1） When the structural type parameter of the machine tool is equal to 10:
Automatically measure the A-axis rotation center Y (P553) and Z (P
554) machine tool coordinates.
First, switch the tool and select the tool number. Align the B-axis machine coordinates to the zero point (B-axis perpendicular to the X-axis). Then move the Y-axis and Z-axis to position the tool tip at a designated mark on the workpiece (clamped on the A-axis). Press 'R' to input 1 for setting the first point. Lift the tool, rotate the A-axis as wide as possible, then slowly adjust the Y-axis and Z-axis until the tool tip aligns with the same mark on the workpiece. Press 'R' again to set the second point, repeating this process for the third point. The system automatically calculates the Y and Z machine coordinates of the A-axis rotation center and records the current tool length in the parameter "Measured Tool Length (um) when measuring the five-axis CNC rotary platform center." This measurement is required only during initial setup or A-axis reinstallation; it's unnecessary when changing tools. Before automatic A-axis rotation center measurement, ensure the distance between the tool tip and B-axis rotation center has been accurately measured.
Parameter "555, measuring the tool length (um) when the center of the five-axis CNC rotary table is measured" records the current H2 tool length value of the tool.
（2） When the structural type parameter of the machine tool is equal to 11:
This operation is not required.
（3） When the structural type parameter of the machine tool is equal to 12:
Step 1: Automatically measure the machine tool coordinates of the A-axis rotation center Y (P553) and Z (P554).
First, select the tool number and move the tool along the Y and Z axes to position the tip at a designated mark on the workpiece (clamped on the A-axis). Press 'R' to input 1 for the first point. Lift the tool and rotate the A-axis as wide as possible, then slowly adjust the Y and Z axes until the tip aligns with the same mark on the workpiece. Press 'R' again to input 2 for the second point, repeating this process for each subsequent point. The system will automatically calculate the Y and Z coordinates for the A/B axis rotation center. When using multiple tools, set the length compensation value H1 before proceeding with this operation.
Parameter "555, Measure tool length (um) when centering the five-axis CNC rotary table" records the current H1 compensation value of the tool. If G43 tool length compensation is not used, the length compensation value H1 must be reset to zero. The measurement of Y and Z machine coordinates for A-axis rotation centering is only required when the machine is newly installed or the A-axis is reinstalled. This operation is not necessary when changing tools.
Step 2: Used to automatically measure the X (P556) machine tool coordinates of the C-axis rotation center.
First, switch the tool and select the tool number. Align the machine's A-axis coordinates to the zero point, positioning the C-axis horizontally. Then move the X and Y axes to align the tool tip with a designated mark on the workpiece (clamped on the C-axis). Press' R 'to set the first point. Raise the tool and rotate the C-axis as wide as possible. Slowly adjust the X and Y axes until the tool tip aligns with the same mark. Press' R ' again to set the second point, then repeat this process for the third point. The system will automatically calculate the machine's X-axis coordinates for the C-axis rotation center (P556).
The X coordinate value of the C-axis rotation center needs to be measured only when the C-axis is newly installed or reinstalled, and then replaced

- 99 -

刀具时不需要进行该操作。对于有多把刀具时，需要将长度补偿值 H1 设置好后，在进 行该项操作。
参数“555,测量五轴数控回转平台中心时的刀长(um)”记录的当前刀具的 H1 补偿值。
（4）机床结构型式参数等于 15 时：
第一步:自动测量 B 轴回转中心 X(P553)和 Z(P554)机床坐标。 首先换刀选择刀具号，然后移动 X 轴和 Z 轴使刀尖处于工件(装夹在 B 轴上) 上某一标记点，按‘R’输入 1 设定第一个点,然后将刀具提起来，转动一下 B 轴， 转动角度尽量大一点，再慢慢移动 X 轴和 Z 轴，让刀尖点处于工件上的同一标记 点，按‘R’输入 2 设定第二个点，依次方法设定第三个点，系统会自动计算出 B 轴回转中心的 X 和 Z 机床坐标值。对于有多把刀具时，需要将长度补偿值 H1 设置好后，再进行该项操作。
参数“555,测量五轴数控回转平台中心时的刀长(um)”记录的当前刀具的 H1 补偿值.如果不使用刀具长度补偿 G43 时，需要将长度补偿值 H1 清 零。刚刚装机或重新安装 B 轴时才需要测量 B 轴回转中心的 X 和 Z 机床坐标值， 更换刀具时不需要进行该操作。
第二步: 用于自动测量 C 轴回转中心的 Y(P556)机床坐标值。 首先换刀选择刀具号，将 B 轴的机床坐标走到零点，即 C 回转轴处于水平 位置，然后移动 X 轴和 Y 轴使刀尖处于工件(装夹在 C 轴上)上某一标记点，按 ‘R’输入 A 设定第一个点，然后将刀具提起来，转动一下 C 轴，转动角度尽量 大一点，再慢慢移动 X 轴和 Y 轴，让刀尖点处于工件上的同一标记点，按‘R’ 输入 B 设定第二个点，依次方法输入 C 设定第三个点，系统会自动计算出 C 轴 回转中心的 Y 机床坐标值(P556)。
刚刚装机或重新安装 C 轴时才需要测量 C 轴回转中心的 Y 机床坐标值，更换 刀具时不需要进行该操作。对于有多把刀具时，需要将长度补偿值 H1 设置好后，在 进行该项操作。
参数“555,测量五轴数控回转平台中心时的刀长(um)”记录的当前刀具的 H1 补偿值。
注意 1：BC 类型 RTCP 补偿不使用 B 轴，只操作第二步测量 C 轴回转中心的 X 和 Y 机床坐标值即可;
注意 2： B 轴零点要注意，必须是当工作台处于水平时为 B 轴零点。而 C 轴零点可以任意设置;
注意 3：刀补调用如果为发那科模式指令 G43 当 T1 号刀就调用 H1 刀补， T2 号刀调用 H2 刀补，以此类推;
（5）机床结构型式参数等于 13 时：
用于自动测量 C 轴回转中心的 X(P553)和 Y(P554)机床坐标值。 首先换刀选择刀具号，将 A 轴的机床坐标走到零点，即 A 轴垂直于 Y 轴，然 后移动 X 轴和 Y 轴使刀尖处于工件(装夹在 C 轴上)上某一标记点，按‘R’输入 1 设定第一个点，然后将刀具提起来，转动一下 C 轴，转动角度尽量大一点，再慢 慢移动 X 轴和 Y 轴，让刀尖点处于工件上的同一标记点，按‘R’输入 2 设定第

- numerical control system -
- 99 -

This operation is not required for a single tool. When there are multiple tools, this operation should be performed after setting the length compensation value H1.
Parameter "555, measuring the tool length (um) when the center of the five-axis CNC rotary table is measured" records the current H1 compensation value of the tool.
（4） When the structural type parameter of the machine tool is equal to 15:
Step 1: Automatically measure the B-axis rotation center coordinates of the machine tool X (P553) and Z (P554).
First, select the tool number and move the tool along the X and Z axes to position the tip at a designated mark on the workpiece (clamped on the B-axis). Press 'R' to input 1 for setting the first point. Lift the tool and rotate the B-axis as wide as possible. Slowly adjust the X and Z axes until the tip aligns with the same mark on the workpiece. Press 'R' again to input 2 for setting the second point, repeating this process for the third point. The system will automatically calculate the B-axis rotation center coordinates for the X and Z axes. When using multiple tools, set the length compensation value H1 before proceeding with this operation. Parameter "555, Measure tool length (um) when centering the five-axis CNC rotary table" records the current H1 compensation value of the tool. If G43 tool length compensation is not used, the H1 length compensation value must be reset to zero. The measurement of B-axis rotary center coordinates (X and Z) is only required when the machine is newly installed or the B-axis is reinstalled. This operation is not necessary when changing tools.
Step 2: Used to automatically measure the Y (P556) machine tool coordinates of the C-axis rotation center.
First, switch the tool and select its number. Align the machine's B-axis coordinates to the zero point (keeping the C-axis horizontal), then move the X and Y axes to position the cutting edge at a designated mark on the workpiece (clamped on the C-axis). Press' R 'to input A for setting the first point. Lift the tool and rotate the C-axis as wide as possible. Slowly adjust the X and Y axes until the cutting edge aligns with the same mark on the workpiece. Press' R' again to input B for setting the second point. Repeat this process for C to set the third point. The system will automatically calculate the Y-coordinate values for the C-axis rotation center (P556). The measurement of the Y coordinate value of the C-axis rotation center is required only when the C-axis has just been installed or reinstalled, and is not required when replacing a tool. For multiple tools, this operation should be performed after setting the length compensation value H1.
Parameter "555, measuring the tool length (um) when the center of the five-axis CNC rotary platform is measured" records the current H1 compensation value of the tool.
Note 1: BC type RTCP compensation does not use the B axis, only the second step to measure the C axis rotation center of the machine tool coordinates X and Y can be operated;
Note 2: The B-axis zero point must be set when the worktable is horizontal. The C-axis zero point can be set arbitrarily;
Note 3: Tool feed call If the tool feed is in the FANUC mode command G43, the T1 tool calls H1 tool feed, the T2 tool calls H2 tool feed, and so on;
（5） When the structural type parameter of the machine tool is equal to 13:
Used to automatically measure the X (P553) and Y (P554) machine tool coordinates of the C-axis rotation center.
First, switch the tool and select the tool number. Align the machine' s A-axis coordinates to the zero position (perpendicular to the Y-axis). Then move the X and Y axes to position the cutting edge at a designated mark on the workpiece (clamped on the C-axis). Press' R 'to input 1 for the first point. Lift the tool and rotate the C-axis as wide as possible. Slowly adjust the X and Y axes until the cutting edge aligns with the same mark on the workpiece. Press' R' again to input 2 for the second point

- 100 -

二个点，依次方法设定第三个点，系统会自动计算出 C 轴回转中心的 X 和 Y 机床 坐标值，并且记录当前刀长到参数“测量五轴数控回转平台中心时的刀长(um)” 中。
刚刚装机或重新安装 C 轴时才需要测量 C 轴回转中心的 X 和 Y 机床坐标值， 更换刀具时不需要进行该操作。自动测量 C 轴回转中心之前必须先测量好刀尖点 到 A 轴回转中心的距离才行。
参数“555,测量五轴数控回转平台中心时的刀长(um)”记录的当前刀具的 H2 刀具长度值。
（6）机床结构型式参数等于 14 时：
用于自动测量 B 轴回转中心的 X(P553)和 Z(P554)机床坐标值。 首先换刀选择刀具号，将 A 轴的机床坐标走到零点，即 A 轴垂直于 Y 轴，然 后移动 X 轴和 Z 轴使刀尖处于工件(装夹在 B 轴上)上某一标记点，按‘R’输入 1 设定第一个点，然后将刀具提起来，转动一下 B 轴，转动角度尽量大一点，再慢 慢移动 X 轴和 Z 轴，让刀尖点处于工件上的同一标记点，按‘R’输入 2 设定第 二个点，依次方法设定第三个点，系统会自动计算出 B 轴回转中心的 X 和 Z 机床 坐标值，并且记录当前刀长到参数“测量五轴数控回转平台中心时的刀长(um)” 中。
刚刚装机或重新安装 B 轴时才需要测量 B 轴回转中心的 X 和 Z 机床坐标值， 更换刀具时不需要进行该操作。自动测量 B 轴回转中心之前必须先测量好刀尖点 到 A 轴回转中心的距离才行。
参数“555,测量五轴数控回转平台中心时的刀长(um)”记录的当前刀具的 H2 刀具长度值。
机床结构型式参数等于 10 时，需要注意如下几点(对于其他机床结构型式也 有类似注意)：
1>,在与 Z 轴负方向重合的地方定义为 B 轴机床坐标值为零, 正方向就按右 手坐标系规则。
2>,在与 Z 轴正方向重合的地方定义为 A 轴机床坐标值为零, 正方向就按右 手坐标系规则。
3>,在确定 G54 等工件坐标系的 Z 轴时将 B 轴的机床坐标走到零点，即 B 轴 垂直于 X 轴后再进行。
4>,因为 H2 用于保存刀尖点到 B 轴回转中心的距离，作为计算 RTCP 的 B 轴 旋转补偿的依据，所以 G43/G44 刀具长度补偿就不能调用 H2，只能使用每一把 刀的 H1。
当需要下刀或提刀修改 G54 的 Z 偏移值或每一把刀的 H1，不能修改每一把 刀的 H2，注意 H2 反应的是真实的刀具长度值，必须与实际一致，否者补偿计算 就不正确。程序中需要编入当前选那一把刀，系统才会调用相应刀具的 H2 值。 刀具长度补偿 G43/G44 可以与 RTCP 补偿 M601/M602 指令同时使用。 如果刀具磨损了，程序中同时使用了长度补偿 G43/G44 和 RTCP 补偿 M601/M602 指令，那么就需要同时对 H1 和 H2 进行增量修改。 5>,在手动下执行 MDI，输入 M601 或 M602 会进入 RTCP 状态，系统界面会有

- numerical control system -
- 100 -

Two points are set in sequence. The system will automatically calculate the X and Y machine tool coordinates of the C-axis rotation center, and record the current tool length to the parameter "tool length (um) when measuring the center of the five-axis CNC rotary platform".
The measurement of the X and Y machine coordinates at the C-axis rotation center is required only when the C-axis has just been installed or reinstalled. This operation is not required when replacing a tool. The distance between the tool tip point and the A-axis rotation center must be measured before automatically measuring the C-axis rotation center. Parameter "555, measuring the tool length (um) when the center of the five-axis CNC rotary table is measured" records the current H2 tool length value of the tool.
（6） When the structural type parameter of the machine tool is equal to 14:
Used to automatically measure the X (P553) and Z (P554) machine tool coordinates at the B-axis rotation center.
First, switch the tool and select the tool number. Align the machine's A-axis coordinates to the zero position (perpendicular to the Y-axis), then move the X and Z axes to position the tool tip at a designated mark on the workpiece (clamped on the B-axis). Press' R 'to input 1 for setting the first point. Lift the tool, rotate the B-axis as wide as possible, then slowly adjust the X and Z axes until the tool tip aligns with the same mark on the workpiece. Press' R' again to input 2 for setting the second point. Repeat this process for the third point. The system will automatically calculate the B-axis rotation center coordinates (X and Z) and record the current tool length in the parameter "Measured Tool Length (um) during five-axis CNC rotary table centering".
The measurement of B-axis rotation center X and Z machine tool coordinates is required only when the B-axis has just been installed or reinstalled. This operation is not required when replacing a tool. The distance between the tool tip point and the A-axis rotation center must be measured before automatically measuring the B-axis rotation center. Parameter "555, measuring the tool length (um) when the center of the five-axis CNC rotary table is measured" records the current H2 tool length value of the tool.
When the structural type parameter of the machine tool is equal to 10, the following points should be noted (similar attention should also be paid to other machine tools).
1>, where the negative direction of the Z-axis is coincident, the B-axis machine coordinate value is defined as zero, and the positive direction follows the right-hand coordinate system rules.
2>, where the positive direction of the Z-axis is coincident, the A-axis machine coordinate value is defined as zero, and the positive direction follows the right-hand coordinate system rules.
3. When determining the Z-axis of the coordinate system of G54 and other workpieces, move the machine tool coordinates of the B-axis to the zero point, that is, after the B-axis is perpendicular to the X-axis. 4>, because H2 is used to store the distance between the tip of the knife and the B-axis rotation center, which serves as the basis for calculating the B-axis rotation compensation of RTCP, G43/G44 tool length compensation cannot call H2, but can only use H1 of each tool. When modifying G54's Z offset or H1 for individual toolpaths, do not adjust the corresponding H2 values. Note that H2 reflects the actual tool length value, which must match the real measurement for accurate compensation calculation. The system will only retrieve the H2 value of the currently selected tool when programmed. Tool length compensation G43/G44 can be used in conjunction with RTCP compensation commands M601/M602.
If the knife tool is worn and the G43/G44 length compensation and RTCP M601/M602 instructions are used at the same time in the program, then incremental modifications to both H1 and H2 are required.
5>. When MDI is executed manually, input M601 or M602 to enter the RTCP state, and the system interface will be available

- 101 -

显示，此时手动运行 B 轴或 A 轴，XYZ 轴的机床坐标会自动运行进行补偿。 6>,调试时检查 RTCP 补偿方向的正确性：
首先调好 B 轴机床坐标值零点，确保零点位置 Z 轴垂直于 X 轴，然后自动测 量刀尖点到 B 轴回转中心的距离，自动测量 A 轴回转中心的 Y 和 Z 机床坐标值， 在手动下执行 MDI，输入 M602 进入 RTCP 状态，将刀尖对准工作台上一标记点， 再手动转动 B 轴，此时 X 轴和 Z 轴会跟着移动，若方向正确，标记点会紧跟着刀 尖移动，否则表示若方向不正确，修改 552 号参数。将刀尖对准工作台上一标记 点，再手动转动 A 轴，此时 Y 轴和 Z 轴会跟着移动，若方向正确，标记点会紧跟 着刀尖移动，否则表示若方向不正确，修改 552 号参数。
7>,在 RTCP 状态下，机床坐标是反应的真实坐标，工件坐标则为虚拟坐标 （与程序编制的坐标一致）。
8),在确定工件坐标系 XYZ 时，建议将旋转轴ABC轴处于机床坐标零点位置， 方便编程。
9>,在编入 M601 或 M602 指令时，最好先在非 RTCP 模式下将 XYZAB 五轴定 位到某一安全点，例如：
G54 T1
M600
G0 X_ Y_ Z_ A_ B_
M601 或 M602
G0 X_ Y_ ....
G1 X_ A_ B_ ....
M600
M30
6、四轴系统的 RTCP 功能使用方法：
1>当有 XYZ 直线轴和一个绕 X 轴旋转的旋转轴 A 时(当有 XYZ 直线轴和一个 绕 Z 轴旋转的旋转轴 C 时, 可以将 Z 轴定义为 X 轴，X 轴定义为 Y 轴，Y 轴定义 为 Z 轴， 旋转轴定义为 A 轴)：
开启四个轴 XYZA 并将参数机床类型设为 14。
用 M601 开启 RTCP 功能，用 M600 关闭 RTCP 功能。 在系统刀补界面按‘H’用于自动测量刀长。
自动测量刀尖点到 A 轴回转中心的距离：首先换刀选择刀具号，让刀尖点处 于工件上某一标记点，按‘H’输入 1 设定的第一个点，然后将刀具提起来，转 动一下 A 轴，转动角度不能太小，再慢慢移动 Y 轴和 Z 轴，让刀尖点处于工件上 的同一标记点，按‘H’输入 2 设定的第二个点，系统则自动计算出刀尖点到 A 轴回转中心的距离(um)，并将其保存到当前光标处的 H2 中。系统进行 RTCP 的 A 轴补偿计算时会自动调用当前刀具号对应的 H2 值。
2>当有 XYZ 直线轴和一个绕 Y 轴旋转的旋转轴 B 时：
开启五个轴 XYZAB 并将参数机床类型设为 10。

- numerical control system -
- 101 -

Display, at this time, manually run the B axis or A axis, the XYZ axis of the machine tool coordinates will automatically run for compensation.
6. Check the correctness of RTCP compensation direction during debugging:
First, calibrate the B-axis coordinate zero point to ensure the Z-axis is perpendicular to the X-axis. Then automatically measure the distance from the tool tip to the B-axis rotation center, and automatically determine the Y and Z coordinates of the A-axis rotation center. Manually execute MDI, input M602 to enter RTCP mode, and align the tool tip with a worktable marker. Manually rotate the B-axis; if the direction is correct, the marker will follow the tool tip's movement. If not, adjust parameter 552. Next, align the tool tip with another worktable marker and manually rotate the A-axis. If the direction is correct, the marker will follow the tool tip's movement. If not, adjust parameter 552 again.
7> In the RTCP state, the machine tool coordinates are the real coordinates reflected, and the workpiece coordinates are virtual coordinates (consistent with the programmed coordinates).
8) When determining the coordinate system XYZ of the workpiece, it is recommended that the rotation axis ABC be located at the zero point of the machine tool coordinate system for easy programming.
9. When entering the M601 or M602 command, it is best to first position the XYZAB five-axis in a safe point in non-RTCP mode, for example:
G54 T1
M600
G0 X_ Y_ Z_ A_ B_
M601 or M602
G0 X_ Y_ ....
G1 X_ A_ B_ ....
M600
M30
6. How to Use the RTCP Function of the Four-Axis System:
1) When there is an XYZ linear axis and a rotating axis A that rotates around the X-axis (when there is an XYZ linear axis and a rotating axis C that rotates around the Z-axis, the Z-axis can be defined as the X-axis, the X-axis as the Y-axis, the Y-axis as the Z-axis, and the rotating axis as the A-axis):
Start four axes XYZA and set the parameter machine tool type to 14. Use M601 to enable RTCP function and use M600 to disable RTCP function.
Press 'H' on the system blade supplement interface to automatically measure the blade length.
Automatic measurement of the distance from the tool tip to the A-axis rotation center: First, switch tools and select the tool number. Position the tool tip at a designated mark on the workpiece. Press 'H' to input point 1 (the first preset position). Raise the tool and rotate the A-axis slightly upward. Slowly adjust the Y-axis and Z-axis until the tool tip aligns with the same mark. Press 'H' again to input point 2 (the second preset position). The system automatically calculates the distance (um) from the tool tip to the A-axis rotation center and stores it in H2 at the current cursor position. When performing RTCP A-axis compensation calculations, the system automatically retrieves the corresponding H2 value for the selected tool number.
2>When there is an XYZ linear shaft and a rotating shaft B that rotates around the Y-axis:
Start the five axes XYZAB and set the parameter machine tool type to 10.

- 102 -

因为实际没有 A 轴，此时将 A 轴机床坐标清零，然后通过编写 PLC 梯形图禁 止 A 运行即可。
用 M601 开启 RTCP 功能，用 M600 关闭 RTCP 功能。 在系统刀补界面按‘H’用于自动测量刀长。
自动测量刀尖点到 B 轴回转中心的距离：首先换刀选择刀具号，让刀尖点处 于工件上某一标记点，按‘H’输入 1 设定的第一个点，然后将刀具提起来，转 动一下 B 轴，转动角度不能太小，再慢慢移动 X 轴和 Z 轴，让刀尖点处于工件上 的同一标记点，按‘H’输入 2 设定的第二个点，系统则自动计算出刀尖点到 B 轴回转中心的距离(um)，并将其保存到当前光标处的 H2 中。系统进行 RTCP 的 B 轴补偿计算时会自动调用当前刀具号对应的 H2 值。
7、RTCP 功能测试方法：
在手动 M602 状态下,让刀尖对准工作台上一点， 转动 A轴或 C 轴， XYZ自动跟随 运行，如果刀尖始终保持对准工作台上一点,说明系统 RTCP 工作正常。

- numerical control system -
- 102 -

Because there is no A-axis in fact, the A-axis machine tool coordinates are cleared, and then the A-axis operation can be prohibited by writing ladder diagram of PLC.
Use M601 to enable the RTCP function, and use M600 to disable the RTCP function.
Press 'H' on the system blade supplement interface to automatically measure the blade length.
Automatic measurement of the distance from the tool tip to the B-axis rotation center: First, switch tools and select the tool number. Position the tool tip at a designated mark on the workpiece. Press 'H' to input point 1 (the first preset position). Raise the tool and rotate the B-axis slightly upward. Slowly adjust the X and Z axes until the tool tip aligns with the same mark. Press 'H' again to set point 2. The system automatically calculates the distance (in micrometers) between the tool tip and the B-axis rotation center, storing this value in the H2 field at the current cursor position. When performing RTCP B-axis compensation calculations, the system automatically retrieves the corresponding H 2 value from the current tool number.
7、 RTCP Function Test Method:
In manual M602 state, make the tip of the knife point at a point on the worktable, rotate the A-axis or C-axis, and the XYZ automatically follows. If the tip of the knife always points at a point on the worktable, it indicates that the system RTCP works normally.

- 103 -

第三篇 操 作 篇

3.1 概述
使用本数控系统时，只要掌握系统参数、程序编辑、手动操作、自动运行 几方面的操作内容，就可以很方便的进行操作了。以下内容将会针对详细说明。

3.2 操作面板

本系统面板分主面板和副面板。主面板用于参数设置和程序编辑，副面板用 于对刀设置和加工操作。

3.3 键盘说明

3.3.1 倍率增减

（1）快速倍率
快速倍率有 5%～100%共六档，通过快速倍率键调节，快速倍率对以下指令 有效：G00、G26、G28、G61、G611-G618 固定循环的快速进给、手动快移进给。 （2）进给倍率
进给倍率有 0%～150%共十六档，通过进给倍率键调节，进给倍率对以下指 令有效：G01、G02、G03、固定循环的进给 F 有效；还对手动运行有效。 （3）主轴倍率
主轴倍率有 5%～150%共十六档，通过主轴速度倍率键调节，主轴倍率对第 一主轴速度 S 有效。

3.3.2 干预开关的使用

（1）左则：正常加工。
（2）中则：手动进给停止，自动进给暂停。返回左则时恢复正常。 （3）右则：自动进给暂停、主轴暂停，返回中则时参见（2）。当处于非坐标轴 运行时主轴不受控制。

3.3.3 其它按键见下表

字母键 | ABCDEFGHIJKLMNOPQRSTUVWXYZ 用于程序命令和参数设置；
数字键 | 0123456789.- 用于数据输入和参数设置；
符号键 | #*[]()/=%用于宏程序编辑；

- numerical control system -
- 103 -

## The Third Part Is the Operation Part

3.1 Summary
When using this CNC system, as long as you master the system parameters, program editing, manual operation, automatic operation and other aspects of the operation content, you can easily operate. The following content will be detailed.
3.2 Operation Panel
The panel of the system is divided into main panel and auxiliary panel. The main panel is used for parameter setting and program editing, while the auxiliary panel is used for tool setting and machining operation.
3.3 Keyboard instructions
3.3.1 Multiplicative Rate Increase or Decrease
（1） Fast ratio
The rapid ratio has six grades from 5% to 100%. Through the adjustment of the rapid ratio key, the rapid ratio is effective for the following instructions: G00, G26, G28, G61, G611-G618 fixed cycle rapid feed and manual fast feed.
（2） Feed rate
The feed ratio has 16 steps from 0% to 150%, which can be adjusted by the feed ratio key. The feed ratio is effective for the following instructions: G01, G02, G03, and fixed cycle feed F, and also effective for manual operation.
（3） Shaft ratio
The spindle ratio has 16 steps from 5% to 150%, which can be adjusted by the spindle speed ratio key. The spindle ratio is effective for the first spindle speed S.
3.3.2 Use of Intervention Switches
（1） Left: normal processing.
（2） In the middle: manual feed stop, automatic feed pause. Return to the left side and normal.
（3） Right: Automatic feed pause, spindle pause, return to the middle of the time refer to (2). When in non-coordinate axis operation, the spindle is not controlled.
3.3.3 Other Keys Are Shown in the Table Below
letter key | ABCDEFGHIJKLMNOPQRSTUVWXYZ For program commands and parameter Settings;
numbering key | 0123456789. -For data input and parameter setting;
symbolic key | #*[]()/=% Used for macro editing;

- 104 -
方向键 | 编程区的↑↓→← 用于光标移动；
+X、-X、 +Y、-Y、 +Z、-Z、+A、 -A、+B、-B | 用于手动进给； +B、-B 用于 B\C\Xs\Ys 轴的正、负方向进给，用“B”“C” “X”“Y”选择当前进给轴；
编辑键 | “删除、上页、下页”用于程序编辑；
功能键 | “复位” 自动运行程序复位结束程序运行并返回到程序 头，主轴等开关量关闭，运行进给轴运行复位停止； “返回”用于操作取消和功能返回； “确认”用于功能选择和输入确认； “参数”进入参数设置菜单； “程序”进入程序编辑菜单； “刀补”修正换刀误差； “手动”手动功能选择； “自动”自动功能选择； “手轮”启动手轮功能； “诊断”输入输出诊断； “单段”选择自动执行方式，加工中可中停； “单步”用于手动单步（即增量）选择； “图形”用于自动坐标或图形加工方式的选择； “空运行”用于自动加工或自动空运行方式的选择；
控制键 | “正转、反转、停止”用于主轴的正转、反转、停止； “点动”主轴正转点动； “冷却”用于冷却液的启动和停止； “回零”用于回机床零点； “松紧刀”用于主轴松紧刀的卡紧和松开； “吹气”用于主轴吹气的开或关； “润滑”用于润滑的开关； “快速”用于手动连续高、低速切换； “快速↑、快速↓”用于 G00 或手动快速修调； “进给↑、进给↓”用于进给速度修调； “主轴↑、主轴↓”用于主轴转速修调； “启动” 执行自动加工程序； “暂停” 自动加工过程中暂停；
控制钮 | 紧急停止：终止机床一切动作，等待按键抬起； 干预开关：在加工过程中暂停丝杠和主轴； 程序运行：执行自动加工程序；

3.4 手动操作

- numerical control system -
- 104 -
directiion key | The ↑↓ → ← in the programming area is used for cursor movement;
+X、-X、 +Y、-Y、 +Z、-Z、+A、 -A、+B、-B | For manual feed; +B and-B are used for the positive and negative direction feed of the B,C,Xs,Ys axes, and "B", "C", "X", "Y" are used to select the current feed axis;
editing key | "Delete", "Previous page", "Next page" are used for program editing;

function key

"Reset" automatically runs the program reset ends the program runs and returns to the program head, spindle and other switches are closed, run feed axis run reset stop; "Return" is used for operation cancellation and function return;
"Confirmation" is used for function selection and input confirmation;
"Parameter" enters the parameter setting menu;
The "Program" enters the program editing menu;
"Knife supplement" to correct the error of changing the knife;
"Manual" manual function selection; "Automatic" automatic function selection; "Handwheel" starts the handwheel function;
"Diagnosis" input-output diagnosis; "Single segment" is selected to be executed automatically, and can be stopped during processing;
"Single step" is used for manual single step (i.
e. incremental) selection;
"Graphics" is used to select the automatic coordinate or graphic processing mode; "Empty run" is used to select the mode of automatic processing or automatic empty run;

manipulating key

"Forward rotation, reverse rotation and stop" are used for the forward rotation, reverse rotation and stop of the spindle; "point movement" is the forward rotation point movement of the spindle;
"Cooling" is used to start and stop the coolant;
"Return to zero" is used to return the machine tool to zero;
"Loose and tight knife" is used for the clamping and loosening of the spindle loose and tight knife; "blow" is used for the opening or closing of the spindle blow; "Lubrication" refers to the switch for lubrication;
"Quick" is used for manual continuous high and low speed switching;
"Quick ↑ and Quick ↓" are used for G00 or manual quick adjustment;
"Feed up and feed down" are used to adjust the feed speed;
"Up spindle, down spindle" is used for spindle speed adjustment;
"Start" to execute the automatic processing program;
"Pause" Pause in the machining process;

control button

Emergency stop: stop all movements of the machine tool and wait for the button to be lifted;
Interference switch: pause the screw and spindle during processing;
Program operation: execute automatic processing program;
3.4 Hand Operation

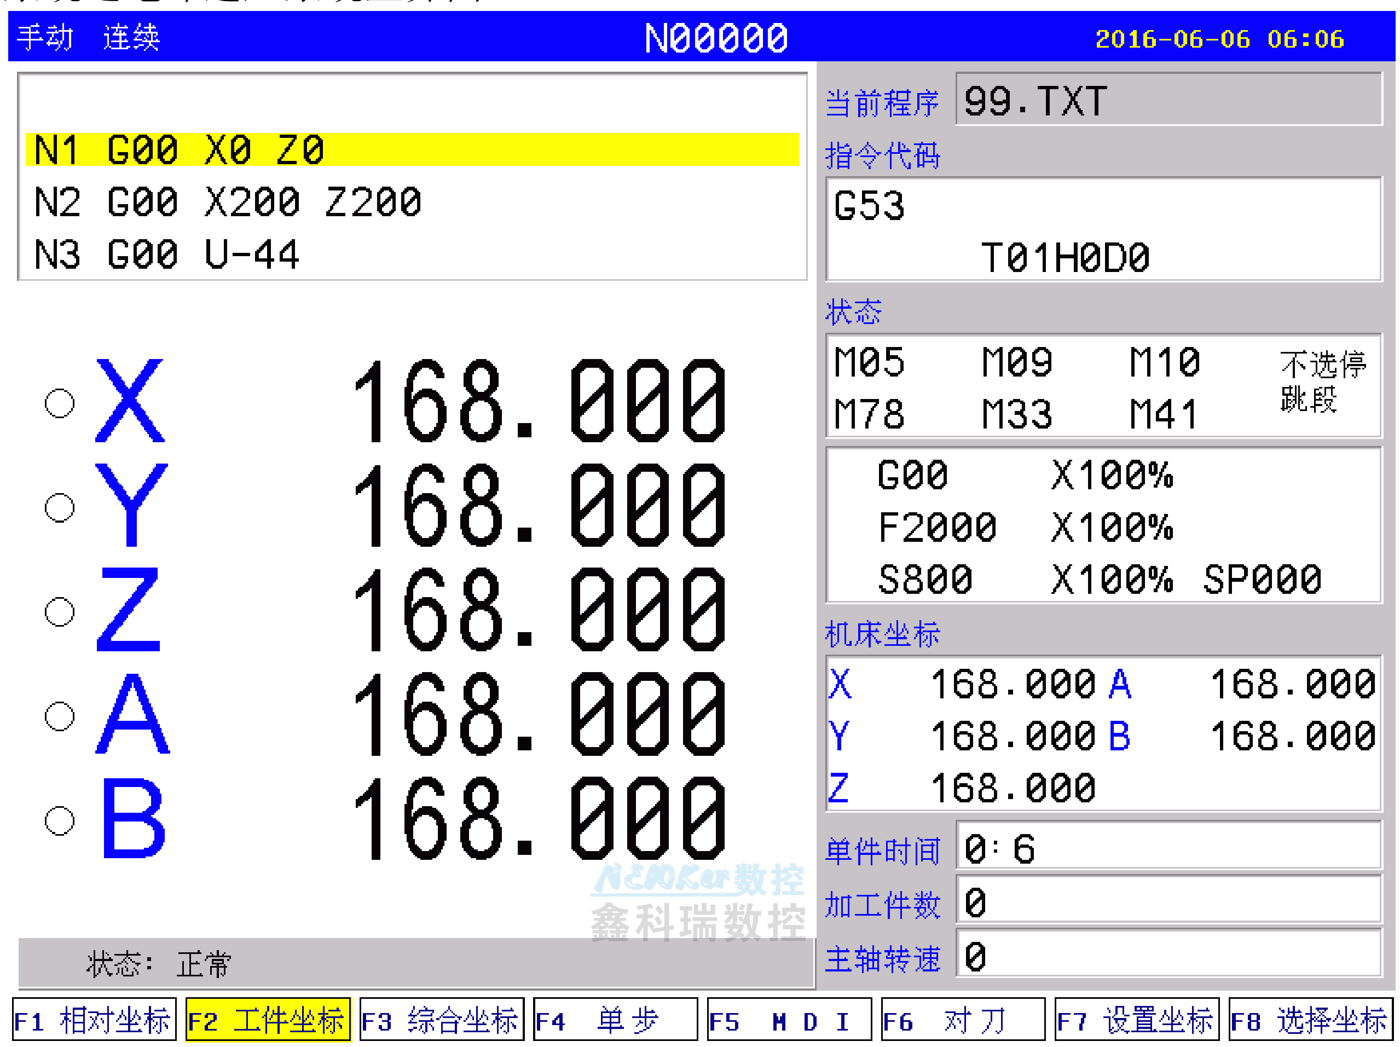
[picture p152: figure]

- 105 -

系统采用一级菜单式操作，直观、方面、快捷，提示信息全面。 系统通电即进入系统主界面：

屏幕第一行左面显示系统运行方式（可以是“手动连续”、“手动增量”、“自 动连续”、“自动单段”、“自动空运行”、“手轮”），中间为加工程序的当前行，右 面显示当前日期与时钟。
左上部为程序区，程序区第二行为当前程序行。
左下部为工件坐标显示区。
倒第二行为提示区，如报警提示等。
最后一行 F1-F8 功能键提示。
右边为当前程序名、指令代码、机床状态、机床坐标等的显示区。 菜单的操作：菜单的选择可通过功能键进行。例如：
按“程序”则进入程序管理系统，可对程序进行编辑、修改、查错、删除、 拷贝等工作。
按“参数”则进入参数管理系统，可对各类参数进行查阅、修改。 手动方式主要用于机床坐标的调整和机床辅助动作的的启停，刀具的对刀， 加工工件的起点确定，以及进行手动加工。手动方式不能进行程序加工。

3.4.1 手动方式按键操作

- numerical control system -

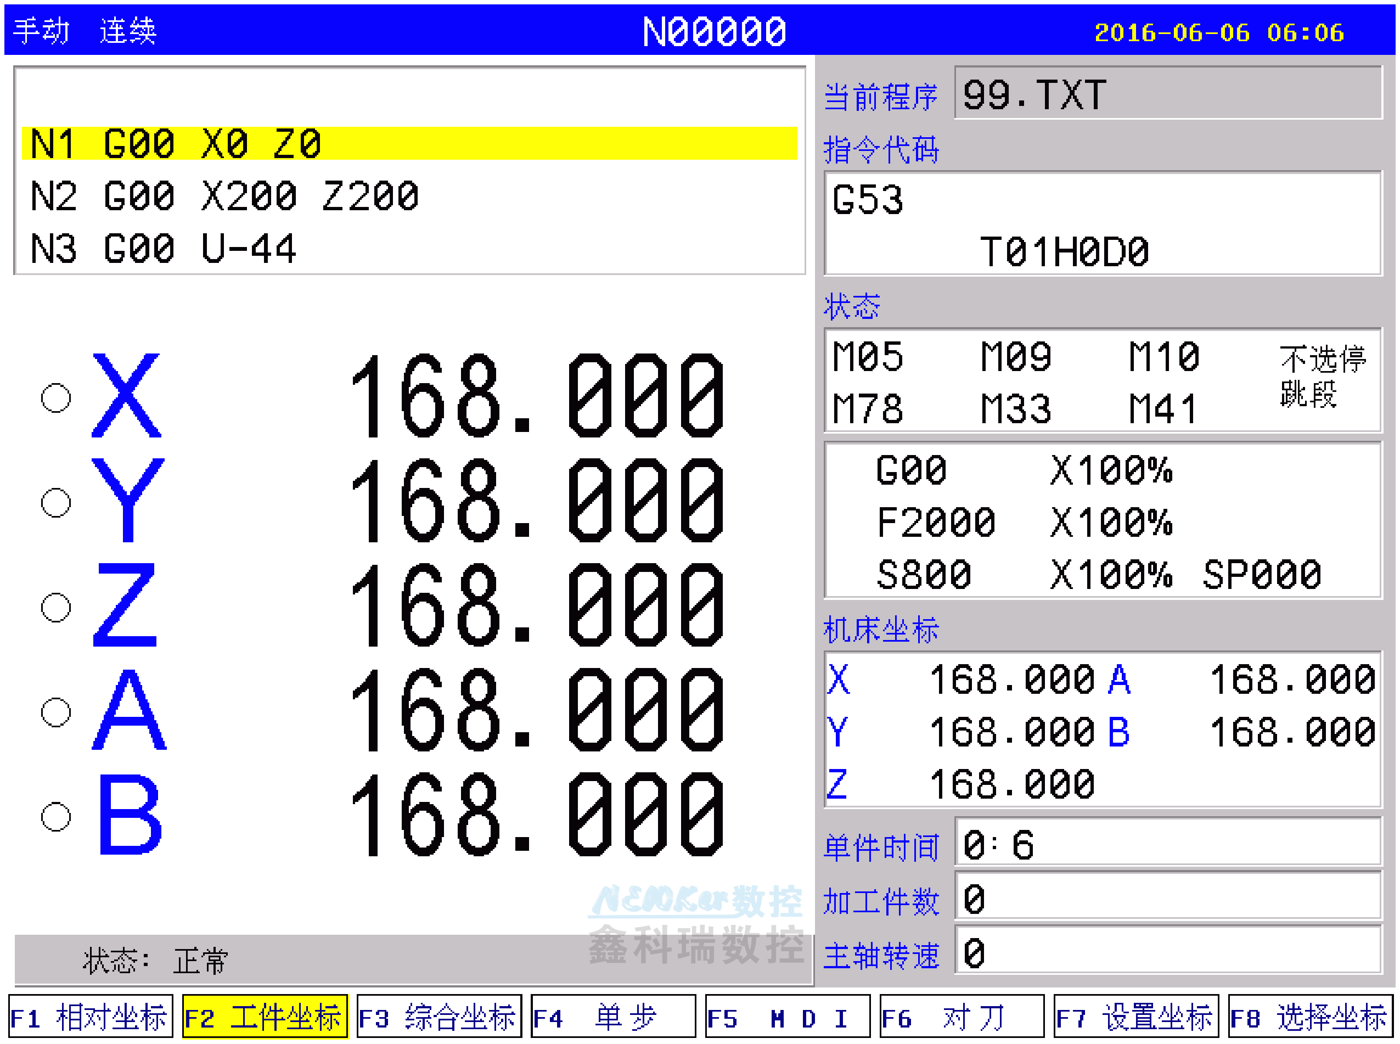
[picture p153: figure]

- 105 -

The system adopts the first-level menu operation, which is intuitive, convenient and fast, with comprehensive prompt information. The system enters the main interface immediately after power-on:

The left side of the first line of the screen shows the operation mode of the system (which can be "manual continuous", "manual incremental", "automatic continuous", "automatic single segment", " automatic empty run", "handwheel"), the middle part shows the current line of the processing program, and the right side shows the current date and clock.
The upper left is the program area, and the second behavior of the program area is the current program line.
The lower left part is the workpiece coordinate display area.
The second behavior indicates the area, such as alarm indication. The last row of F1-F8 function keys is displayed.
On the right is the display area of the current program name, instruction code, machine tool status, machine tool coordinates, etc. Menu operation: The menu can be selected by function keys. For example:
According to the "program", you can enter the program management system, and can edit, modify, check, delete, copy and other work on the program.
According to "parameter", you can enter the parameter management system, and check and modify all kinds of parameters.
Manual mode is mainly used for the adjustment of machine tool coordinates and the start and stop of machine tool auxiliary actions, tool alignment, determination of starting point of machining workpiece, and manual machining. Manual mode cannot be used for programmed machining.
3.4.1 Key Operation by Manual Mode

- 106 -

（1）“F”键：设定手动进给速度，以 mm/min 为单位，其输入范围为： 1-30000mm/min。其输入方法参见参数中的数据输入方法。 （2）“单步”键：“手动连续”、“手动单步”循环切换。 （3）“S”键：设定第一主轴转速。主轴转速范围为 0-99999，其最大值取决 于速度参数状态中的 P48 号参数值。
（4）“I”键：在手动单步方式下修改单步值 I。
（5）“进给↑”键：当轴类参数 P1 号参数设置为 0 时，每按一次“进给↑” 键，进给速度倍率修调增加 10％。范围为 0—150%共 16 档。 （6）“进给↓”键：当轴类参数 P1 号参数设置为 0 时，每按一次“进给↓” 键，进给速度倍率修调减少 10％。范围为 0—150%共 16 档。 （7）“快速↑”键：每按一次“快速↑”键，G00 或手动快速倍率修调增加 20％。范围为 5—100%共 6 档。
（8）“快速↓”键：每按一次“快速↓”键，G00 或手动快速倍率修调减少 20％。范围为 5—100%共 6 档。
（9）“主轴↑”键：当轴类参数 P2 号参数设置为 0 时，每按一次“主轴↑” 键，第一主轴转速倍率增加 10％。范围为 5—150%共 16 档。 （10）“主轴↓”键：当轴类参数 P2 号参数设置为 0 时，每按一次“主轴↓” 键，第一主轴转速倍率减少 10％。范围为 5—150%共 16 档。 （11）“手轮”键：选择“手轮方式”，进行“0.001”、“0.01”、“0.1”档位 循环切换。
（12）“润滑”：“润滑”键为润滑开、关反复键，对应指令 M32、M33。 （13）“F8 选择坐标”：按此键选择相应的坐标系（G53-G59），选择后屏幕右 上角用相应的显示。
（14）“F7 设置坐标”：在工件坐标系（G54-G59）状态时设置（G54-G59）的 值，更新参数中的值；在机床坐标系（G53）状态时偏置所有刀具坐标，更新所 有刀补值。
（15）“自动”键：选择“自动方式”。
（16）“手动”键：选择“手动方式”。
（17）主轴控制：“正转、反转、停止”分别控制主轴正转、反转和停止， 对应指令 M03、M04、M05。
按“点动”键则输出点动信号，即按下时为主轴转动，抬起时主轴停止。 （18）“冷却”：“冷却”键为冷却液开、关反复键，对应指令 M08、M09。 （19）松紧刀：“松紧刀”键为松紧刀开、关反复键，对应指令 M10、M11。 （20）手动速度：按“0”、“1”、“2”、“3”、“4”、“5”、“6”、“7”、“8”、“9” 进行“F30”、“F60”、“F120”、“F250”、“F500”、“F1000”、“F1500”、“F2000”、 “F2500”、“F3000” 手动速度设置。
（21）吹气：“吹气”键为吹气开、关反复键, 对应指令 M59、M58。 （22）连续与单步的切换：按“单步”键时手动连续方式与单步方式进行转 换，若为单步时则显示单步值 I=XXXX.XXX。

- numerical control system -
- 106 -

（ 1 ） "F" key: set the manual feed speed, in mm/min, its input range is: 1-30000mm/min. The input method can be found in the data input method of the parameter.
（2） "Single step" key: "manual continuous" and "manual single step" cycle switch.
（3） "S" key: Set the first spindle speed. The spindle speed ranges from 0 to 99,999, and the maximum value depends on the value of parameter P48 in the speed parameter state.
（4） "I" key: Modify the single-step value I in manual single-step mode.
（5） "Feed up" key: When parameter P1 is set to 0, each press of the "Feed up" key increases the feed speed multiplier by 10%. The range is 0 -150%, with a total of 16 steps.
（6） "Feed Down" key: When parameter P1 is set to 0, each press of the "Feed Down" key reduces the feed speed multiplier by 10%. The range is 0-150%, with a total of 16 steps.
（7） "Quick ↑" key: Each press of the "Quick ↑" key increases the G 00 or manual quick ratio adjustment by 20%. The range is 5-100%, a total of 6 steps.
（8） "Quick ↓" key: Each press of the "Quick ↓" key reduces the G 00 or manual quick ratio adjustment by 20%. The range is 5-100%, a total of 6 steps.
（9） "Spindle ↑" key: When parameter P2 is set to 0, each time the " spindle ↑" key is pressed, the first spindle speed multiplier increases by 10%. The range is 5-150%, with a total of 16 steps.
（10） "Spindle ↓" key: When parameter P2 is set to 0, each time the " spindle ↓" key is pressed, the first spindle speed multiplier decreases by 10%. The range is 5-150%, a total of 16 steps.
（11） Handwheel key: Select "handwheel mode" and cycle between "0.001", "0.01" and "0.1" gears.
（12） "Lubrication": The "Lubrication" key is the repeated key to open and close lubrication, corresponding to the instructions M32 and M 33.
（13） "F8 Select coordinate": Press this key to select the corresponding coordinate system (G53-G59), and select the corresponding display in the upper right corner of the screen.
（14） "F7 Set coordinate": Set the value of (G54-G59) when the workpiece coordinate system is in state, update the value in the parameter; offset all tool coordinates and update all tool compensation values when the machine tool coordinate system is in state (G53).
（15） "Auto" key: Select "Auto mode".
（16） "Manual" key: Select "Manual mode".
（17） Spindle control: "Forward, reverse and stop" respectively control the spindle forward, reverse and stop, corresponding to the instructions M03, M04 and M05.
Press the "point" key to output the point signal, that is, when pressed, the spindle turns, and when lifted, the spindle stops.
（18） "Cooling": The "Cooling" key is the repeated key to open and close the coolant, corresponding to the instructions M08 and M09.
（19） Looseness knife: The "Looseness knife" key is the repeatedly open and close key of the loosening knife, corresponding to the instructions M10 and M11.
（20） Manual speed: Press "0", "1", "2", "3", "4", "5", "6", "7", "8", "9 " to set "F30", "F60", "F120", "F250", "F500", "F1000", "F1500", "F2000", "F 2500", "F3000" manual speed.
（21） Blow: The "blow" key is the repeatedly open and close button, corresponding to the instruction M59 and M58.
（22） Continuous and single-step switching: When the "single-step" key is pressed, the manual continuous mode is converted to the single-step mode. If it is single-step, the single-step value I=XXXX.XXX is displayed.

- 107 -

（23）回机床零点：按“回零”键后，再按“X”，则 X 轴自动回机床零点； 若按“Y”则 Y 轴自动回机床零点；若按“Z”则 Z 轴自动回机床零点；若按“A” 则 A 轴自动回机床零点；若按“B”则 B 轴自动回机床零点；若按“0”则先回 Z 轴，再回 X、Y、A 轴、B 轴；若按“返回”键则放弃。回机床零点执行速度为速 度参数中的 P38-P47 号参数,执行方向为轴类参数 P47 号参数决定。 在回机床零点过程中，如果机床未安装行程开关或金属接近开关，数控系统 将检测不到回答信号而一直向前运行，这时应及时按急停按钮以免撞车。 （24）坐标进给：直接按“+X、-X、+Y、-Y、+Z、-Z、+A、-A、+B、-B”键 分别对应 X 轴和 Z 轴的正方向、负方向进给。
（25）速度切换：在连续进给时，再按下“快速”键，则立刻转化为系统速 度参数的 P1、P2、P3 号参数对应的执行速度，松开“快速”键则继续按原来的 速度进给。若设定速度比参数中的速度高则按设定速度进给。 （26）多坐标显示切换，按“F1 相对坐标”“F2 绝对坐标”、“F3 综合坐标” 键可在“绝对坐标”、“相对坐标”“综合坐标”三个界面切换 （27）工件数清零：按“删除”，再按“确认”键，加工工件数清零。 （28）对刀基准：按“T”键，设置自动对刀的基准点（Z 轴坐标点），用于 设置刀补参数中刀具长度补偿的基准。
（29）自动对刀：确认好对刀基准后，装好刀具移动刀具到对刀点，在“刀 补状态”按“F5 对刀”键，输入自动对刀的刀具号，相应刀具的长度补偿值就 确认好了。
（30）自定义键“K1”：开启/关闭 Y24。
（31）自定义键“K2”：开启/关闭 Y25。
（32）自定义键“K3”：开启/关闭 Y26。
（33）增量坐标：选择到“相对坐标”状态按“设置”键修改或设置为 0； (34）自动分中或自动找圆心操作，切换到 G54--G59，按“ P/J” 键。按提 示操作，系统自动计算值存入当前 G54--G59 的偏移值中。 注：机床坐标清零：在参数状态按“E”，再按“确认”键。

3.4.2 手动连续

连续操作是以按键按下时间为依据，按下则进给，抬起则停止进给。 用面板上“+X、-X、+Y、-Y、+Z、-Z、+A、-A、+B、-B”键在指定的轴和方向上 进给，进给速度为显示的速度(F 的数据)乘以速度修调倍率值。 连续执行时，若按下“快速”键则速度切换为速度参数的 P1、P2、P3 号参 数对应的执行速度。如果本身设定速度高于参数中的速度则速度不变，进给速度 为速度参数中的 P1、P2、P3 号参数值的速度乘以快速修调倍率值。 为了方便用户在手动功能进行单轴切削，在手动中可设置手动速度。按“F” 键提示 F 时，键入速度值即可。
当进给超出运行轴的正负两个方向的硬限位点时，则停止进给，并提示已处

- numerical control system -
- 107 -

（23） Returning to the machine zero position: Press the "Zero" button, then press "X" to automatically return the X-axis to the machine zero position; press "Y" for the Y-axis; press "Z" for the Z-axis; press "A" for the A-axis; press "B" for the B-axis; press "0" to first return the Z-axis before moving to X, Y, A, and B axes; press the "Return" button to cancel. The execution speed for returning to the machine zero position is controlled by parameters P38-P47 in the speed settings, while the direction is determined by parameter P47 of the axis-related parameters. During the return to the machine tool zero point process, if the machine tool is not installed with a travel switch or metal proximity switch, the CNC system will not be able to detect the response signal and will continue to run forward. In this case, the emergency stop button should be pressed in time to avoid collision.
（24） Coordinate feed: press the keys "+X, -X, +Y, -Y, +Z, -Z, +A, -A, +B, -B" respectively to feed in the positive direction and negative direction of the X-axis and Z-axis.
（25） Speed switching: When continuous feed is in operation, pressing the "Quick" button will immediately switch to the execution speed corresponding to parameters P1, P2, and P3 in the system speed parameters. Release the "Quick" button to resume the original feed speed. If the set speed exceeds the parameter speed, continue feeding at the set speed.
（26） Multi-coordinate display and switching: Press "F1 relative coordinate", "F2 absolute coordinate" and "F3 comprehensive coordinate" keys to switch between the three interfaces of "absolute coordinate", " relative coordinate" and "comprehensive coordinate"
（27） Zero workpiece number: press "Delete" and then press " Confirm" button to zero the number of processed workpieces.
（28） Tool reference: Press the "T" key to set the reference point (Z axis coordinate point) for automatic tool reference, which is used to set the reference for tool length compensation in the tool compensation parameters.
（29） Automatic tool alignment: After confirming the tool alignment reference, install the tool and move the tool to the tool alignment point. Press the "F5 tool alignment" key in the "tool compensation state", and input the tool number for automatic tool alignment. The length compensation value of the corresponding tool is confirmed.
（30） Custom key "K1": Turn Y24 on/off.
（31） Custom key "K2": Turn Y25 on/off.
（32） Custom key "K3": Turn Y26 on/off.
（33） Incremental coordinates: Select the "relative coordinates" state and press the "set" key to modify or set it to 0;
(34） For automatic center division or automatic center finding operation, switch to G54--G59 and press the "P/J" key. Follow the prompts and the system will automatically calculate the value and store it in the current G54--G59 offset value.
Note: Machine tool coordinate reset: press "E" in the parameter state, and then press "Confirm".
3.4.2 Manual Continuity
Continuous operation is based on the time of button press, feed when pressed, stop feed when lifted.
Use the "+" and "-" keys on the panel to feed in the specified axis and direction, and the feed speed is the displayed speed (F data) multiplied by the speed adjustment multiplier.
During continuous operation, pressing the "Quick" button will switch the speed to the execution speed corresponding to parameters P 1, P2, and P3 in the speed settings. If the preset speed exceeds the parameter values, the speed remains unchanged, while the feed speed is calculated by multiplying the values of parameters P1, P2, and P3 by the Quick Speed Adjustment Factor.
In order to facilitate users to perform single axis cutting in manual mode, the manual speed can be set in manual mode. When the "F" key is pressed and the F prompt is displayed, enter the speed value.
When the feed exceeds the hard limit points in both positive and negative directions of the running axis, the feed is stopped and a prompt is given that it has been placed

- 108 -

于限位轴的方向上不能再进给，此时只能反方向进给。(下同)。 手动最大速度由速度参数的 P6 号参数限制，当设置速度高于此值时，则按 此参数值运行。
杂类参数 P38=8 时，则“快速”叠加键为锁存开关键。

3.4.3 手动单步

此操作是以设定的单步值为依据，每按一次进给键坐标运行一个单步值。进 入单步值操作后提示的“I=0010.000”表示单步值为 10mm，可以按“I”键修改 单步值，按“确认”键确认。
其运行速度为显示速度(F 的数据)乘以速度修调倍率值。

3.4.4 回机床零点

在本系统中回零点有两种方式，即可有参考点开关也可设置浮动零点，具体 方法如下：
有基点开关：
回参考点操作是使各坐标轴依次进给到机床上的基点开关位置。如当参数中 进给轴回参考点方式为 0 时，坐标轴检测到基点信号后再返回检测零位脉冲信号 时，将机床坐标数据自动置为 0。
数控机床断电后再次接通数控系统电源、超程报警解除及急停按钮解除以后， 需要进行再次回参考点操作，以建立正确的机床坐标系。
说明：1、系统对每次开机时回零有要求可通过轴类参数 P45 号设置，可以 是强制也可是提示；
2、回零时检测信号的类型和方式可通过轴类参数 P46 号设置，即可 只需检测参考点开关，也可检测参考点开关之后再检测电机 Z 脉冲信号（精度高 些），对于电机 Z 脉冲可正向检测，也可反向检测。
3、对于回零的方向可通过轴类参数 P47 号（位参数）设置，D2、D4 位分别设置 X、Z 轴，0 表正向，1 表负向。
4、对于 X、Z 同时回零时的先后顺序可通过轴类参数 P47 号（位参数） 设置，D8 位为 0 表示先 X 后 Z，1 则反之。 5、对于参考点开关的类型可通过轴类参数P48号（位参数）设置，D0、 D2 分别设置 X、Z 轴，0 表常开，1 表常闭。 6、对于需要检测电机 Z 脉冲时的检测最大长度可通过轴类参数 P30、 P31 号参数设置，该参数值必须小电机一转脉冲。
7、对于回零后的偏移距离可通过轴类参数 P54-P58 号参数设置，即 回零完成后再快速移动坐标到该参数值。
无基点开关：
可设定浮动零点来确定，通过轴类参数 P39 启用相应轴浮动零点功能，并分

- numerical control system -
- 108 -

There is no further feed in the direction of the limit axis, and only reverse feed is possible. (same below).
The maximum manual speed is limited by the speed parameter P6. When the speed is set higher than this value, it will run according to this parameter value.
When the miscellaneous parameter P38=8, the "quick" overlay key is the latch key.
3.4.3 Manual Single Step
This operation is based on the preset single-step value. Each press of the feed button will move the coordinate by one single-step value. After entering the single-step value operation, the prompt "I=0010.000" indicates that the single-step value is 10mm. You can press the "I" key to modify the single-step value and press the "Confirm" key to confirm. Its running speed is the display speed (F data) multiplied by the speed adjustment multiplier.
3.4.4 Return to Machine Zero
In this system, there are two ways to return to zero point, that is, there can be a reference point switch or set a floating zero point, the specific method is as follows:
A base point switch:
The return reference point operation feeds each coordinate axis to the machine tool's base point switch position in sequence. If the feed axis return reference point mode is set to 0 in the parameters, when the coordinate axis detects the base point signal and returns to detect the zero pulse signal, the machine tool's coordinate data will be automatically reset to 0.
After the power supply of the CNC system is turned on again after the power failure of the CNC machine tool, after the over-run alarm is removed and the emergency stop button is removed, it is necessary to perform the reference point operation again to establish the correct coordinate system of the machine tool.
Note: 1. The system requires zero return at each startup, which can be set through shaft parameter No. P45, which can be either mandatory or prompt;
2、 The type and method of the return zero detection signal can be set through the shaft parameter P46. Only the reference point switch can be detected, or the motor Z pulse signal can be detected after the reference point switch (with higher accuracy). The motor Z pulse can be detected in both forward and reverse directions.
3、 The direction of zero return can be set through the axis parameter P47 (bit parameter). D2 and D4 are respectively set for X and Z axes, where 0 indicates forward and 1 indicates negative.
4 、 The sequence of X and Z returning to zero at the same time can be set by axis parameter P47 (bit parameter). D8 bit is 0 to indicate X first and then Z, and 1 to indicate the reverse.
5、 The type of reference point switch can be set through the shaft parameter P48 (bit parameter). D0 and D2 are respectively set for X and Z axes. 0 is normally on, and 1 is normally off.
6 、 For the maximum detection length when the motor Z pulse needs to be detected, parameter P30 and P31 can be set. The value of this parameter must be smaller than the pulse of one rotation of the motor.
7 、 The offset distance after zero return can be set by parameter P54-P58 of the shaft, that is, quickly move the coordinate to this parameter value after zero return.
Zero base point switch:
The floating zero point can be set to determine. The corresponding shaft floating zero point function is enabled through the shaft parameter P39, and divided

- 109 -

别设置 P40-P44 参数来确定 X/Y/Z/A/B/C/Xs/Ys 轴的浮动零点值，确定机床的零 点。
回参考点的操作方法如下：
在手动方式下，按“回零”键，系统提示（X；Z；0（XZ）），在对话框中 要求选择哪轴回参考点。在图中输入Ｘ或Ｚ，按 Enter 键则只将相应轴回参考点， 或输入 0 后，按 Enter 键则按 X、Z 轴的顺序依次返回参考点。回参考点成功后， 在绝对坐标和相对坐标系中轴坐标前面的圆圈变为绿色，否则回参考点失败。 回参考点过程中若要中止，则按“停止”或“RESET”按钮则停止返回参考 点动作。
特别注意：每次启动系统后必须进行一次回参考点操作，以确保机床加工精 度。因意外断电或非正常关机后启动系统也必须进行回参考点操作，否则可能造 成故障。

3.4.5 手摇脉冲发生器（手轮）

本系统中手轮可配置面板式和手持式手脉，其通过杂类参数 P1 号设置。

面板式手轮操作：
按“手轮”键选择“手轮方式”。然后在字母键 X、Z 选择相应的轴，再按 “手轮”选择脉冲倍率。

手持手脉操作：
按“手轮”键选择“手轮方式”。然后操作手持手脉的轴选开关选择相应的 轴，操作手持手脉的轴、倍率开关选择脉冲倍率。

说明：
手轮主要用于对刀，其运行速度与手轮每一格的进给量和旋转手轮的快慢相 关，若本系统在配用步进电机时，进给速度不宜太快。
手摇脉冲发生器的转速要低于 200r/min（每转 100 脉冲的手轮）。 手轮方式在自动图形方式时无效，只能在坐标运行方式下才有效。

3.4.6 工件坐标系

1、按“F8 选择坐标”键或“F5 MDI”选择相应的工件坐标系（G54-G59）； 2、移动要对刀的轴到指定位置；
3、按“F7 设置坐标”键，输入对应工件坐标系的坐标。

3.5 自动操作

- numerical control system -
- 109 -

Do not set the P40-P44 parameters to determine the floating zero point value of the X/Y/Z/A/B/C/Xs/Ys axes to determine the zero point of the machine tool.
The operation method of the reference point is as follows:
In manual mode, press the "Zero Return" button. The system prompts (X; Z; 0 (XZ)). In the dialog box, select which axis should return to the reference point. Enter X or Z in the diagram and press Enter to return to the corresponding axis's reference point. Alternatively, enter 0 and press Enter to sequentially return to the reference points for both X and Z axes. After successful reference point return, the circle preceding the axis coordinates in absolute and relative coordinate systems will turn green. Failure to return to the reference point will result in a red circle instead.
If the return to reference point process is to be stopped, press the " STOP" or "RESET" button to stop the return to reference point action. Special note: a reference point return operation must be performed after each system startup to ensure machining accuracy of the machine tool. A reference point return operation must also be performed after starting the system due to accidental power failure or abnormal shutdown, otherwise the system may fail.
3.4.5 Hand Pulse Generator (handwheel)
In this system, the handwheel can be configured with panel and handheld hand pulse, which is set by miscellaneous parameter P1. Operation of panel handwheel:
Press the "Handwheel" key to select "Handwheel mode". Then select the corresponding axis by pressing the letter keys X and Z, and press the "Handwheel" key to select the pulse multiplier.
Hand pulse operation:
Press the "Handwheel" key to select "Handwheel mode". Then operate the axis selection switch of the handheld pulse meter to select the corresponding axis, and operate the axis and multiplier switch of the handheld pulse meter to select the pulse multiplier.
explain ：
The handwheel is mainly used for tool cutting, and its running speed is related to the feed per grid of the handwheel and the speed of rotating the handwheel. If the system is equipped with a stepper motor, the feed speed should not be too fast.
The hand pulse generator should rotate at a speed of less than 200 r/min (100 pulses per turn of the handwheel).
The handwheel mode is invalid in automatic graphics mode and only works in coordinate run mode.
3.4.6 Workpiece Coordinate System
1. Press "F8 Select coordinate" key or "F5 MDI" to select the corresponding workpiece coordinate system (G54-G59);
2. The moving blade shaft should be moved to the specified position;
3. Press the "F7 Set coordinate" key and input the coordinates of the corresponding workpiece coordinate system.
3.5 Automata

- 110 -

自动是指对当前编辑的工件程序进行加工。本系统可以任意点起动，也可以 任意行启动或任意刀具启动。任意行或任意点启动必须在程序中用绝对坐标编程。 自动方式不能进行手动坐标的移动。
运行程序的选择：在程序界面下，按“↑”“↓”将光标移动到需要执行的 程序名上，按“F7 执行程序”键即选中需要自动运行的程序。 在手动方式按“自动”键进入自动方式。
多坐标显示切换，按“F1-F3”功能键可在“绝对坐标”、“相对坐标”“综 合坐标”三个界面切换。

3.5.1 自动加工方式

“单段/连续”的选择：按“单段”键则单段/连续加工方式进行反复切换。 “连续运行”是指按“运行”按钮后，程序依次不断地执行各程序段(程序 行)，直到程序结束或有停止指令出现。
“单段运行”是在运行程序时只运行当前一行程序后即停止，等待按键操作 或再次按“运行”按键。即按一次“运行”钮运行一段程序。 “坐标/图形”的选择：按“图形”键则坐标/图形执行方式进行反复切换。 “自动坐标”是指程序运行的坐标轴坐标以坐标数值方式显示。 “自动空运行”是指程序以空运行方式运行，坐标轴不移动。 “自动图形”是指程序运行的坐标轴以加工轨迹方式显示。

3.5.2 从程序任意行启动

A、实际行启动：
在自动加工方式下，按“-”键弹出下图对话框，输入行号，按 Enter 键确 认，或者在自动坐标显示状态按“↑、↓”键选择程序行，即此行作为即将运行 的当前行。当前行是指将要执行的程序行，显示在屏幕程序显示区的第一行。当 按运行按钮时则从输入的实际行号开始运行。

注意：1、该行号为程序的实际行号，不是 N 地址符指定的行号。系统先自 动以“速度参数”P8 中的默认 G01/G02/G03 速度运行到该指定行 的起点处，然后正常运行程序。
2、从实际行号加工时，缺省行号为上一次暂停程序时的行号，方便 用户操作。
3、数控系统在坐标界面使用 N 查找过行号后再按“RESET”键就能 返回到程序开头。

B、标记行启动：
系统具有从程序的某一标记行开始运行的功能。在自动加工方式下，按“N”

- numerical control system -
- 110 -

Automatic refers to the processing of the currently edited workpiece program. The system can be started at any point, line, or tool. Any line or point start must be programmed using absolute coordinates in the program. Automatic mode does not allow manual coordinate movement. Selection of the running program: Under the program interface, press "↑" and "↓" to move the cursor to the name of the program to be executed. Press "F7 execute the program" to select the program to be automatically run.
Press the "Automatic" button manually to enter automatic mode. Multi-coordinate display and switching: Press the function keys "F 1-F3" to switch between the three interfaces of "absolute coordinate", " relative coordinate" and "comprehensive coordinate".
3.5.1 Automatic Processing Method
"Single/continuous" selection: Press the "single" key to repeatedly switch between single and continuous processing modes.
"Continuous run" means that after pressing the "run" button, the program executes each program segment (program line) continuously in turn until the end of the program or a stop instruction is issued. "Single-line operation" is to run the program only one line at a time and then stop, waiting for a button operation or another "run" button. That is, press the "run" button to run a section of the program. "Coordinate/Graphic" selection: Press the "Graphic" key to repeatedly switch between coordinate/Graphic execution modes. " Automatic coordinates" means that the coordinates of the coordinate axis on which the program runs are displayed in numerical coordinates.
"Auto run" means that the program runs in empty mode without moving the coordinate axes.
"Automatic graphics" refers to the program running coordinate axis is displayed in the form of a machining path.
3.5.2 Start from Any Line of the Program
A. Actual Start:
In automatic processing mode, pressing the "-" key will bring up the dialog box below. Enter the line number and press Enter to confirm. Alternatively, while in automatic coordinate display mode, press the "↑" and "↓" keys to select the program line that will be executed next. The currently selected line is displayed as the first line in the screen's program display area. When the run button is pressed, the program will execute from the line number you entered.
Note: 1. The line number is the actual line number of the program, not the line number specified by the N address symbol. The system will automatically run at the default G01/G02/ G03 speed in the "Speed parameter" P8 to the starting point of the specified line, and then run the program normally.
2. In actual processing, the default line number is the line number when the program was paused last time, so as to facilitate user operation.
3. In the coordinate interface of the CNC system, after using N to find the line number, press the "RESET" key to return to the beginning of the program.
B. Marking Line Initiation:
The system has the function of running from a certain marker line of the program. In automatic processing mode, press "N"

- 111 -

键，就会弹出一个对话框，在编辑框中输入开始运行的标记行号，按 Enter 键确 认。当按运行按钮时则从输入的行号开始运行。
注意：该行号不是程序的实际行号，是 N 地址符指定的行号。系统先自动以 “速度参数”P8 中的默认 G01/G02/G03 速度运行到该指定行的起点 处，然后正常运行程序。
C、从某把刀启动
系统具有从程序的某一刀具开始运行的功能。在自动加工方式下，按“G”键， 再输入开始运行的刀具号（只输入刀具号，不输入刀补号；如：0304，只输入 “03”），按 Enter 键确认。当按运行按钮时则从输入的刀具号开始运行。 注意：该行号不是程序的实际行号，是 N 地址符指定的行号。系统先自动以 “速度参数”P8 中的默认 G01/G02/G03 速度运行到该指定行的起点 处，然后正常运行程序。

3.5.3 程序启动

程序启动必须按“自动”键切换为自动方式，有以下二种方式，程序自动开 始执行。
（1）面板按“启动”键。
（2）接通外接运行 RUN 信号。

3.5.4 程序停止运行

程序停止运行有五种方式：
（1）程序指令 M00、M01、M02、M30、M20。 （2）按“单段”按键当前程序段运行完后停止。
（3）干预开关置于中则或右则。
（4）接通外接停止 HALT 信号或按“暂停”键，程序暂停。 （5）按“RESET”键则中止程序的所有动作（如工作台、主轴、刀架等所有 动作）

3.5.5 自动加工中的实时控制

（1）G00 快速修调：每按一次“快速↑”键，进给速度倍率修调增加 20％； 每按一次“快速↓”键，进给速度倍率修调减少 20％。加工过程中根据不同情 况可以任意地调整快速倍率。
（2）进给速度修调：当轴类参数 P1 号设置为 0 时，每按一次“进给↑”键， 进给速度倍率修调增加 10％；每按一次“进给↓”键，进给速度倍率修调减少 10％。当轴类参数 P1 号设置为 1 时，将通过外接波段开关调节进给速度。进给 速度修调分为 0%-150% 16 档，加工过程中根据不同情况可以任意地调整加工速

- numerical control system -
- 111 -

Press the key, and a dialog box will pop up. Enter the starting line number in the edit box and press Enter to confirm. When you press the run button, it will run from the line number you entered.
Note: The line number is not the actual line number of the program, but the line number specified by the N address. The system automatically starts with
The default G01/G02/G03 speed in the "Speed parameter" P 8 runs to the starting point of the specified line, and then the program runs normally.
C. Start from a Knife
The system operates by starting with a specific tool in the program. In automatic machining mode, press the "G" key and enter the tool number (only the tool number is required, not the tool supplement number; example: 0304, simply type "03"). Confirm by pressing Enter. When the run button is pressed, the system will execute operations starting from the entered tool number.
Note: The line number is not the actual line number of the program, but the line number specified by the N address. The system automatically starts with
The default G01/G02/G03 speed in the "Speed parameter" P 8 runs to the starting point of the specified line, and then the program runs normally.
3.5.3 The Program Starts
To start the program, you must switch to automatic mode by pressing the "Automatic" key. There are two ways to start the program automatically.
（1） Press the "Start" button on the panel.
（2） Connect the external RUN signal.
3.5.4 The Program Stops Running
There are five ways to stop a program from running:
（1） Program instructions: M00, M01, M02, M30, M20.
（2） Press the "single segment" button to stop the current program segment after it has run.
（3） The intervention switch is placed in the middle or right.
（4） Connect the external HALT signal or press the "pause" button to pause the program.
（5） Press the "RESET" key to stop all actions of the program (such as worktable, spindle, tool holder and all other actions)
3.5.5 Real-Time Control in Automatic Processing
（1） G00 Fast Speed Adjustment: Press the "Fast ↑" key once to increase the feed speed ratio by 20%; press the "Fast ↓" key once to decrease the feed speed ratio by 20%. The fast speed ratio can be adjusted arbitrarily during processing according to different conditions. （2） Feed Speed Adjustment: When parameter P1 is set to 0, each press of the "Feed↑" button increases the feed speed multiplier by 10%, while each press of the "Feed↓" button decreases it by 10%. When parameter P1 is set to 1, the feed speed adjustment is controlled via an external band switch. The feed speed adjustment ranges from 0% to 150% across 16 steps, allowing flexible adjustments during machining according to specific requirements

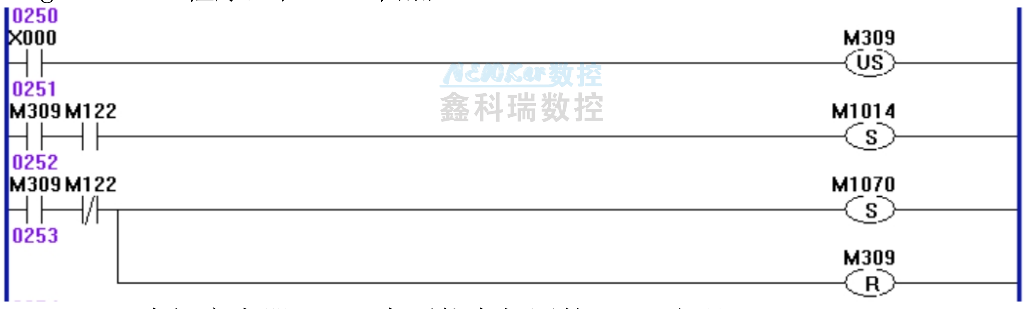
[picture p154: figure]

- 112 -

度。
（3）主轴转速修调：当轴类参数 P2 号设置为 0 时，每按一次“主轴↑”键， 主轴转速倍率修调增加 10％；每按一次“主轴↓”键，主轴转速倍率修调减少 10％。当轴类参数 P2 号设置为 1 时，将通过外接波段开关调节主轴转速。主轴 转速修调分为 5%-150% 16 档，加工过程中根据不同情况可以任意地调整主轴转 速。
（4）加工中停：在连续方式加工过程中，如果按“单段”键当前段程序行 执行完后将停止运行，等待操作。
（5）加工暂停：可以将干预开关置于中则、右则或按面板上的“暂停”键， 加工程序即可暂停。暂停后按“运行”按钮或“启动”键程序将继续运行；若此 时按“复位”键，则退出自动加工运行状态，同时当前行指向加工程序第一行。 （6）进给保持：在加工暂停（外接 HALT、按面板上的“暂停”键、按“手 动”键或“单段”键）时，按“手动”键，自动进给保持，可以进行坐标调整等 工作，再按“自动”，按“启动”键后自动运行到暂停点再继续运行。 （7）退出加工：运行中或“暂停”时或“进给保持”时按“RESET”键。 （8）加工过程中按“K”进入编辑当前行。
（9）加工过程中或停止状态通过输入点启动内部宏程序。如 X0 有效时启动 ProgramUser0 程序，在 PLC 中加入：

M309: 中间寄存器，PLC 中不能有相同的 M309 出现； M1014: 复位当前程序；
M1070-M1079: 对应 ProgramUser0-9 程序。 如果不停止自动可以按下面方法编写一行就可以了;

3.5.6 MDI 运行方式

在手动调整或自动坐标状态按“F5 MDI”键进入 MDI 执行方式。“MDI” 方式是输入一段程序执行一段程序，在输入过程中按“返回”键则放弃退出， 按“启动”键则马上执行当前输入程序段。

- numerical control system -

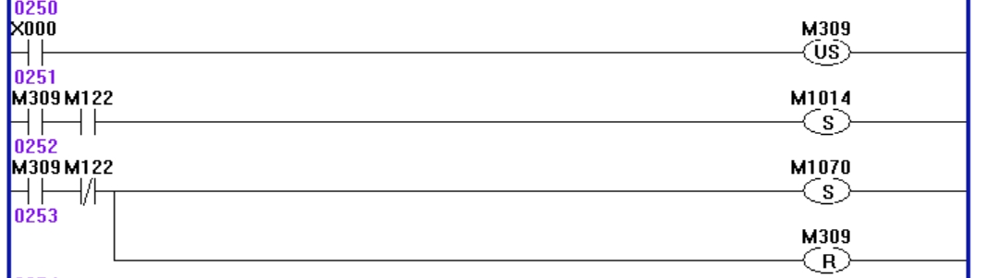
[picture p155: figure]

- 112 -

linear measure 。
（3） Spindle Speed Adjustment: When parameter P2 is set to 0, each press of the "Spindle ↑" button increases the spindle speed multiplier by 10%, while pressing the "Spindle ↓" button decreases it by 10%. When parameter P2 is set to 1, external band switches are used to adjust the spindle speed. The speed adjustment ranges from 5% to 150% across 16 steps, allowing flexible adjustments during machining according to specific requirements.
（4） Processing stop: In the continuous processing process, if you press the "single segment" key, the operation will be stopped after the current segment program line is executed and the operation will be awaited.
（5） Process Pause: To pause the machining program, you can either set the control switch to the center position, right position, or press the "Pause" button on the panel. After pausing, pressing the "Run" button or "Start" key will resume the program. If you press the "Reset" button at this point, it will exit the automatic machining mode while moving the cursor to the first line of the current machining program. （6） Feed Hold: When processing is suspended (external HALT, pressing the "Pause" button on the panel, pressing the "Manual" button or "Single Segment" button), press the "Manual" button to automatically hold feed. Coordinate adjustment and other tasks can be performed. Then press "Automatic", and after pressing the "Start" button, it will automatically run to the pause point and continue running.
（7） Exit processing: Press the "RESET" key when running or " pause" or "feed hold".
（8） Press "K" during processing to edit the current line.
（9） During processing or when the system is stopped, the internal macro program can be activated through input points. For example, if X0 is valid, the ProgramUser0 program will be activated. Add the following to the PLC:

M309: Intermediate register, there can be no same M309 in PLC;
M1014: Reset the current program; M1070-M1079: Corresponding to ProgramUser0-9 program. If the automatic operation is not stopped, you can write one line according to the following method;

3.5.6 MDI Run Mode
To manually adjust or automatically coordinate the state, press the "F5 MDI" key to enter the MDI execution mode. The MDI mode allows you to input and execute a program segment. During input, pressing the "Return" key will abandon and exit the process, while pressing the "Start" key will immediately execute the current program segment.

- 113 -

3.5.7 手轮运行方式

在自动方式下按“手轮”，此时转动手轮程序将自动加工，其速度与程序 F 速度、进给修调倍率和转动手轮的快慢有关。此方式一般用于试加工运行程序。 注意：手轮运行时的加减速和最大速度可由速度参数的 P26-P33、P49 控制， 当该参数设置为无效时，由采用默认的加减和 G00 速度。

3.5.8 DNC 功能

在本系统中用户存储空间为 128Mbit（总线系统可以扩展 32Gbit），系统也 可以用 DNC 功能加工。在本系统中 DNC 功能的实现可通过 RS232 和 USB 接口。

A、RS232-DNC 说明
1、将计算机与系统用专用通讯线连接好，在系统上设置好相应的通讯接口 和速率。
2、在 PC 计算机上运行本系统专用通讯软件，设置好相应的通讯接口和速率。 点击“发送 CNC 程序文件”，选择要联机加工的程序文件，进入正在发送程序文 件状态。
3、在数控系统中进入程序文件界面下，按“L”键即可进入联机加工状态， 此时界面的右上角显示“RS232--DNC”， 在自动状态下按运行按钮即可进行联机 加工。
4、在联机加工过程中要停止系统运行则旋转“干预开关”置中或右端，取 消联机加工状态“停止”键或“RESET”键即可。
注意：1、使用串口传送文件时设置波特率的高低与使用环境（通讯线长度、 现场环境）有关。
2、通讯线缆长度不大于 10 米。
3、在用户 PC 机一端需要使用本系统专用通讯软件方可传输程序。需 特别注意的是将 PC 机和数控系统双方的传输速率设置一致，否则无法传输。 B、 USB-DNC 说明：
USB-DNC 是通过优盘实现的，即将优盘外挂在系统上，选中优盘中的程序执 行。
在程序界面下按“F6 打开优盘”键打开优盘，选中相应的程序后，按“F7 执行程序”键执行程序，按“自动”切换到自动状态，此时按“运行”键即可运 行程序。
在联机加工过程中要停止系统运行则旋转“干预开关”置中或右端，取消联 机加工状态“停止”键或“RESET”键即可。
注意：1、USB-DNC 过程中请不要拔动优盘，更不要取下优盘，则否会造成 加工失败。
2、USB-DNC 完成后需从优盘界面回到系统程序界面。

- numerical control system -
- 113 -

3.5.7 Handwheel Operation Mode
In automatic mode, press the "handwheel". At this time, the handwheel rotation program will be automatically processed, and its speed is related to the program F speed, feed adjustment ratio and the speed of the handwheel rotation. This mode is generally used for trial processing of the program.
Note: The acceleration, deceleration and maximum speed of the handwheel can be controlled by the speed parameters P26-P33 and P49. When this parameter is set to invalid, the default addition/subtraction and G00 speeds are used.
3.5.8 DNC Function
In this system, the user storage space is 128Mbit (the bus system can be expanded to 32Gbit), and the system can also be processed with DNC function. In this system, the implementation of DNC function can be achieved through RS232 and USB interface.
A RS232-DNC description
1. Connect the computer and the system with a special communication line, and set up the corresponding communication interface and rate on the system.
2 、 Run the system-specific communication software on the PC, and set up the corresponding communication interface and speed. Click "Send CNC program file", select the program file to be processed online, and enter the status of sending the program file.
3. In the program file interface of the CNC system, press the "L" key to enter the online machining state. At this time, the upper right corner of the interface shows "RS232-DNC". In the automatic state, press the run button to carry out online machining.
4. If the system is to be stopped during online machining, rotate the "interference switch" in the middle or right end, and cancel the "stop" key or "RESET" key of online machining status.
Note: 1. The setting of baud rate when using serial port to transmit files is related to the use environment (communication line length, field environment).
2、 The length of communication cable is not greater than 10 meters.
3 、 The system dedicated communication software is required to be used on the user's PC to transfer the program. It should be noted that the transmission rate between the PC and the CNC system should be set to the same, otherwise the transmission cannot be achieved.
B. USB-DNC Description:
USB-DNC is implemented through the USB drive, that is, the USB drive is attached to the system and the program in the USB drive is selected to be executed.
Under the program interface, press "F6 to open the USB drive" to open the USB drive. After selecting the corresponding program, press "F 7 to execute the program" to execute the program. Press "Automatic" to switch to automatic mode, and then press "Run" to run the program. In the process of online machining, if you want to stop the system operation, rotate the "interference switch" in the middle or right end, and cancel the "stop" key or "RESET" key of online machining state. Note: 1. Do not pull out the USB-DNC process, and do not remove the USB, otherwise it will cause processing failure.
2 、 After USB-DNC is completed, you need to go back from the USB disk interface to the system program interface.

- 114 -

3、在 USB-DNC 时在执行程序前，最好选中程序后按“P”键对程序进 行编译一遍，防止中途出现程序错误。

3.6 安全操作、报警提示

3.6.1 紧急停止

当发生紧急意外情况时可按下“紧急停止”按钮，系统将停止机床一切动作， 系统复位屏幕显示“系统紧急停车”。等待按钮抬起。当杂类参数 P29 设置为有 效时 M67 输出有效信号。
如果在加工过程中或在机床运动过程中按“紧急停止”按钮，系统坐 标与机床位置可能发生变化，加工前需要重新确定系统坐标位置，最好进行回机 床零点操作使显示坐标与机床位置一致。
系统可以外接急停 STOP 按钮，通过杂类参数 P27 设置按钮是常开或常闭。

3.6.2 系统复位

在系统运行的任何时候均可按“RESET”键中止当前操作，特别是在手、自 动下按该键可中止工作台、主轴、刀架等所有机床动作，但对于坐标而言不会丢 失，无需回零。

3.6.3 机床报警

机床出现报警时，屏幕以反白方式提示出错信息并闪烁，程序停止运行， 中止坐标移动，此时应检查故障原因并排除故障后方可再运行。杂类参数当 P29 为 1 时 M67 输出信号有效。
（1）X、Z 轴正向硬限位：X 或 Z 轴正方向正处于硬限位位置。 （2）X、Z 轴负向硬限位：X 或 Z 轴负方向正处于硬限位位置。 （3）主轴、变频器报警：ALM1 机床变频器报警信号有效。 （4）无润滑油报警：ALM2 机床主轴报警信号有效。
（5）XYZA 轴驱动器报警/X20：ALM 伺服驱动报警信号有效。在诊断状态按 “B”键输出 INTH 信号复位伺服驱动。
（6）BCXsYs 轴驱动器报警/X22： ALMB 伺服驱动报警信号有效 （7）门开关 5 号报警：M12 门开关报警信号有效。 （8）紧急停止：按下了急停按钮。
（9）没有检测到输入信号：指令 WAT 检测不到输入信号。

3.7 参数操作

在任何状态下，按“参数”键，进入参数设置状态。在本系统中参数分为“加

- numerical control system -
- 114 -

3 、 In USB-DNC, before executing the program, it is best to select the program and press the "P" key to compile the program once to prevent errors from occurring in the middle.
3.6 Safety operation and alarm prompt
3.6.1 Emergency Stop
In case of emergency, press the "Emergency Stop" button. The system will stop all movements of the machine tool and reset the screen to display "System Emergency Stop". Wait until the button is lifted. When miscellaneous parameter P29 is set to effective, M67 outputs an effective signal.
If the "emergency stop" button is pressed during processing or during machine tool movement, the system stops
The position of the gauge and the machine tool may change. Before processing, the system coordinate position needs to be redefined. It is best to perform the return to the machine zero point operation to make the displayed coordinate consistent with the position of the machine tool.
The system can be connected with an emergency stop STOP button, which can be set as normally on or off through miscellaneous parameter P27.
3.6.2 System Reset
At any time during the operation of the system, you can press the " RESET" key to stop the current operation. Especially under manual and automatic conditions, pressing this key can stop all machine tool operations such as the worktable, spindle and tool holder, but the coordinates will not be lost and there is no need to return to zero. 3.6.3 Machine Tool Alarm
When the machine tool alarms, the screen will display the error information in reverse white and flash, and the program will stop running and coordinate movement will be stopped. At this time, the fault cause should be checked and the fault should be eliminated before running again. Miscellaneous parameters: When P29 is 1, M67 output signal is valid.
（1） X | and Z | axis positive hard limit: The X | or Z axis is in the
positive direction of the hard limit position.
（2） X, | Z-axis | negative hard limit: The X | or Z-axis negative
direction is in the hard limit position.
（3） Main shaft, frequency converter alarm: ALM1 machine tool frequency converter alarm signal is valid.
（4） No lubricating oil alarm: ALM2 machine tool spindle alarm signal is valid.
（5） | XYZA axis driver alarm/X20: | The ALM servo drive alarm
signal is valid. In diagnostic mode, press the "B" key to output the INTH signal to reset the servo drive.
（6） BCXsYs Axis driver alarm/X22: ALMB servo drive alarm signal is valid
（7） | Door switch | No.5 alarm: M12 door switch alarm signal is
valid.
（8） Emergency stop: The emergency stop button has been pressed.
（9） No input signal was detected: The WAT command did not detect the input signal.
3.7 Parameter Operations
In any state, press the "Parameter" key to enter the parameter setting state. In this system, parameters are divided into "add"

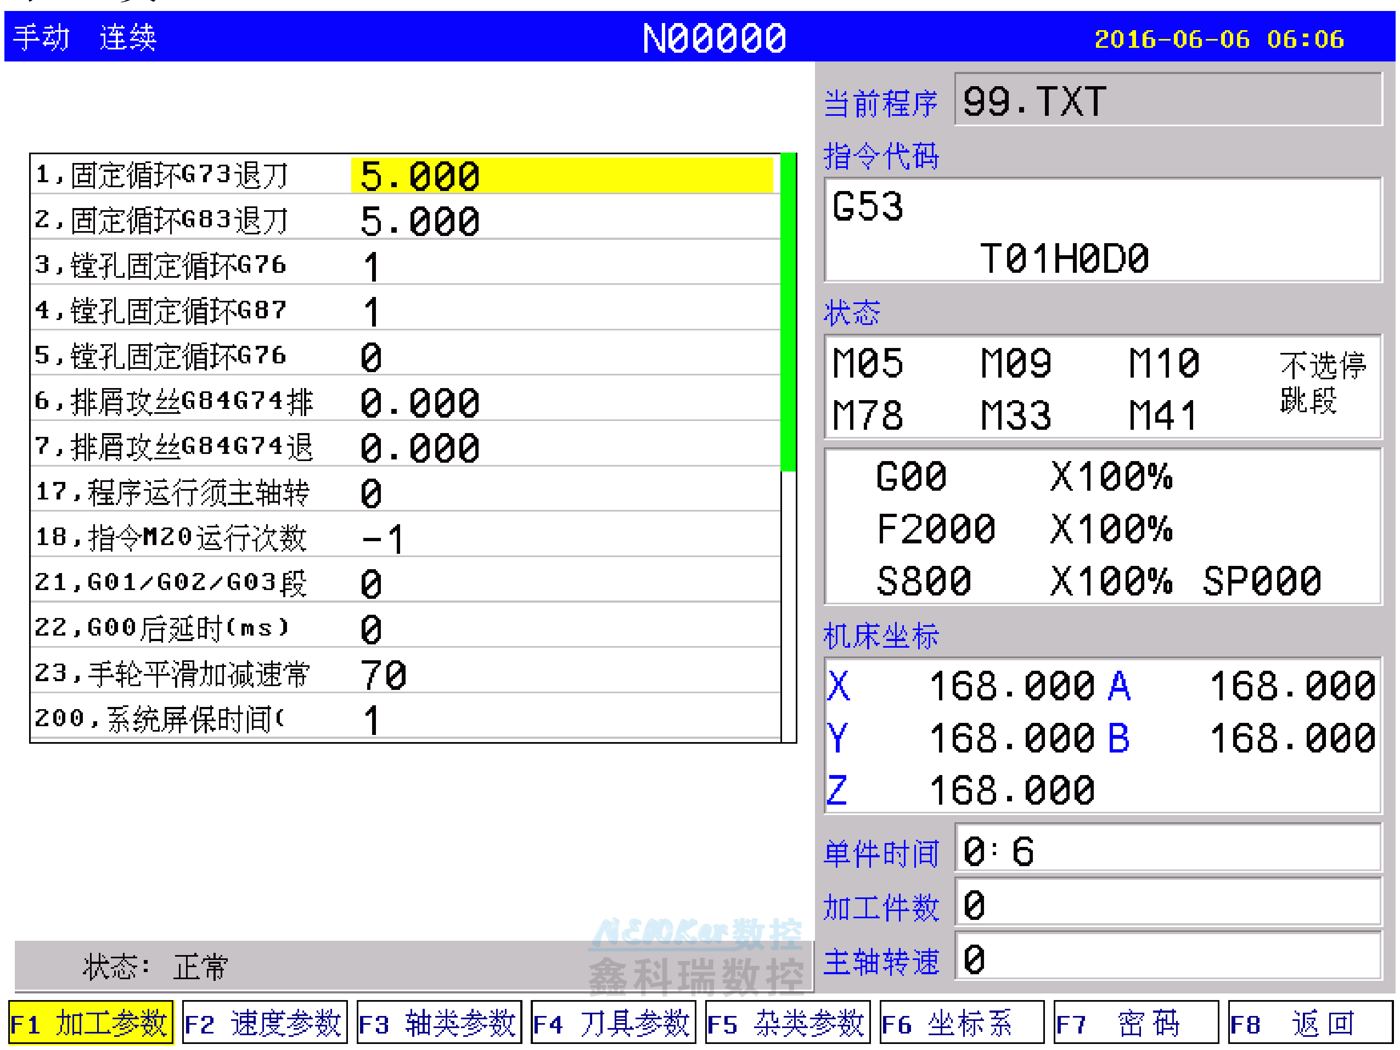
[picture p156: figure]

- 115 -

工参数”、“速度参数”、“轴类参数”、“刀具参数”、“杂类参数”、“坐标系”、“密 码”七类。

进入参数界面后对应按“F1-F7”进入相应界面，按“↑”“↓”键选择参 数号，按“确认”弹出对话框输入数据，输入完成后再“确认”键参数修改成功。 具体参数说明如下：

3．7．1 加工参数

★、1，固定循环 G73 退刀量 d 的值(mm)
用于设置固定循环 G73 退刀量 d 的值(mm)，祥见指令说明。 ★、2，固定循环 G83 退刀量 d 的值(mm)
用于设置固定循环 G73 退刀量 d 的值(mm)，祥见指令说明。 ★、3,镗孔固定循环 G76 偏移量 Q 的方向
(以 G17 平面为例)(1 表+X,2 表-X,3 表+Y,4 表-Y) 用于设置固定循环 G76 偏移量 Q 的方向，祥见指令说明。 ★、4,镗孔固定循环 G87 偏移量 Q 的方向
(以 G17 平面为例)(1 表+X,2 表-X,3 表+Y,4 表-Y) 用于设置固定循环 G87 偏移量 Q 的方向，祥见指令说明。

- numerical control system -

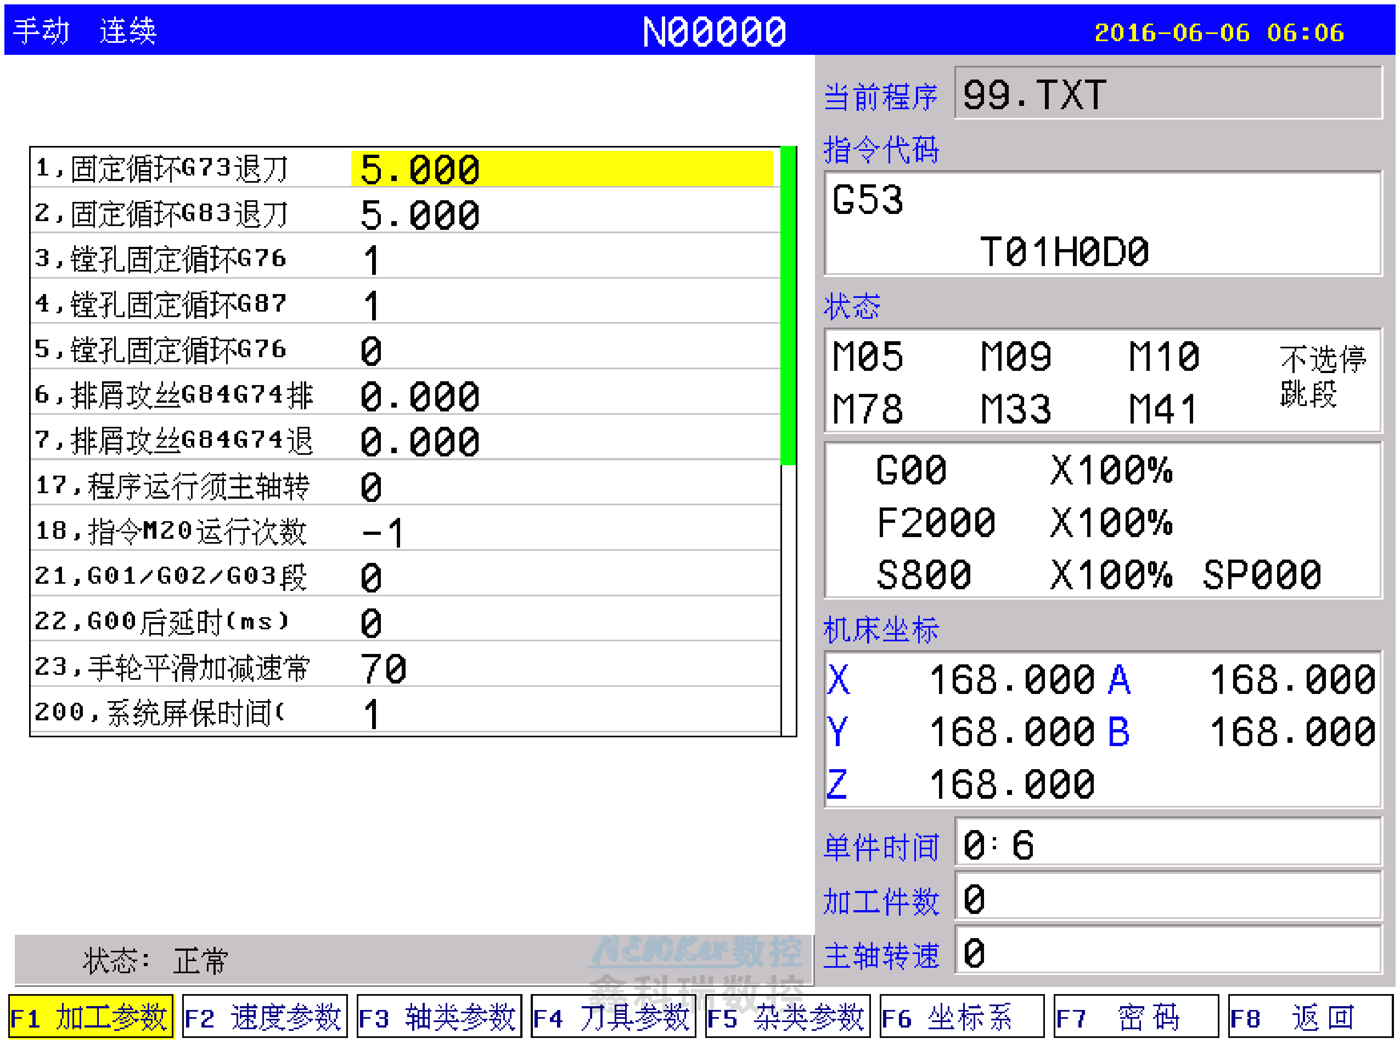
[picture p157: figure]

- 115 -

There are seven categories: "working parameters", "speed parameters", "shaft parameters", "tool parameters", "miscellaneous parameters", " coordinate system" and "password".

After entering the parameter interface, press "F1-F7" to enter the corresponding interface, press "↑" and "↓" keys to select the parameter number, press "Confirm" to pop up a dialog box to input data, and then press "Confirm" after the completion of input to confirm the successful modification of parameters.
The specific parameters are as follows:
3．7．1 Processing Parameters
★1. Value of the tool retraction length (mm) for fixed cycle G73 Used to set the value of the fixed cycle G73 and the tool retraction amount d (mm). See the instruction description for details.
★2, fixed cycle G83, value of the tool retraction d (mm)
Used to set the value of the fixed cycle G73 and the tool retraction amount d (mm). See the instruction description for details.
★3. Boring fixing cycle G76, and the direction of offset Q
(Using the G17 plane as an example) (Table 1+X, Table 2-X, Table 3+Y, Table 4-Y)
Used to set the direction of the offset Q for a fixed cycle G76. See instruction instructions for details.
★4. Boring fixing cycle G87, the direction of offset Q
(Using the G17 plane as an example) (Table 1 + X, Table 2-X, Table 3 + Y, Table 4-Y)
Used to set the direction of the offset Q for a fixed cycle G87. See instruction instructions for details.

- 116 -

★、5,镗孔固定循环 G76G87 的主轴定向停止角度(0.1 度) 用于设置固定循环 G76G87 的主轴定向停止角度，祥见指令说明。 ★、6,排屑攻丝 G84G74 排屑方式(0 表高速排屑回退 d,8 表普通排屑回退 到 R)
用于设置固定循环 G84G74 排屑方式，0 表高速排屑回退 d,8 表普通排屑回 退到 R。
★、7,排屑攻丝 G84G74 退刀量 d(mm)
用于设置固定循环 G84G74 退刀量 d，祥见指令说明。
★、8,固定循环 G73G83 每次提刀前暂停时间(ms)[绝对值大于 5 有效,设为 负数时表提刀按 G01 方式,否则按 G00 方式]
用于设置固定循环 G73G83 每次提刀前暂停时间，大于 5 有效,设为负数时表 提刀按 G01 方式,否则按 G00 方式。
★、17，程序运行须主轴转动[1 表是,0 表否]
用于设置主轴转动与程序运行互锁，设置程序运行时是否检测主轴运行情况， 即该值设置为 1 时，程序运行需要主轴转动；当该值设置为 0 时，程序运行不需 检测主轴运转情况。
★、18，指令 M20 运行次数
该参数用于设定当程序中使用 M20 指令时循环执行程序的次数，当此参数 为负值时表示无限循环。
★、19，当前加工计件数
该参数用于显示或设置程序指令 M20 执行的次数，即工件件数。 ★、21，G01/G02/G03 段间延时（ms）(>100 有效)
此参数设置 G01/G02/G03 程序段间的延时时间，此参数可以解决加工捌角处 （条 G01 之间）的过切问题。
★、22，G00 执行后延时（ms）(>100 有效)
此参数设置执行 G00 后的延时时间。
★、23，手轮平滑加减速常数[50--100]
用于设置使用手轮时平滑升降速时间常数，设置范围 50-100，值越小升降速 越快，但振动越大。
★、200，系统屏保时间（分钟）
当处于主要界面并且不处于对话框状态时等待加工参数 200 设定时间（<2 分钟时不屏保）后进入屏保，屏保后任意键返回。
★、202,系统内部参数
坐标轴显示(1 表正常,4 表无 X,8 表无 Y,16 表无 Z,32 只显示 X,64 只显示 Y,128 只显示 Z,256 显示 XY)
内部参数，可以设置坐标轴显示方式，4 表示不显示 X,8 表示不显示 Y,16 表示不显示 Z,32 表示只显示 X,64 表示只显示 Y,128 表示只显示 Z,256 表示显示 XY。
★、203,是否严格检查 G41/G42(23103490 表启用暂停键,2131970 表严格检

- numerical control system -
- 116 -

★, 5, boring fixed cycle G76G87 spindle orientation stop Angle (0.1 degrees)
Used to set the spindle orientation stop angle for fixed cycle G76G87. See instruction instructions for details.
★6. Chip removal and tapping G84G74 Chip removal method (0 table high-speed chip removal return d, 8 table normal chip removal return to R)
Used to set the fixed cycle G84G74 chip removal mode. Table 0 high-speed chip removal retraction d, Table 8 normal chip removal retraction to R.
★, 7, chip removal and tapping G84G74 tool back clearance d (mm) Used to set the fixed cycle G84G74 tool back amount d, see instruction description for details.
★8. Fixed cycle G73G83 Pause time before each tool lifting (ms) [Absolute value greater than 5 valid. If set as negative, the tool lifting follows G01 mode; otherwise, it follows G00 mode]
Used to set the pause time before each tool lifting of fixed cycle G 73G83. If the pause time is greater than 5, it is valid. If the pause time is negative, the tool lifting is in G01 mode; otherwise, it is in G00 mode. ★17. The program shall run when the spindle rotates [Table 1 is yes, Table 0 is no]
Used to set the interlock between spindle rotation and program operation, and set whether to detect spindle operation during program operation. That is, when this value is set to 1, the spindle rotation is required for program operation; when this value is set to 0, the spindle operation is not required for program operation.
★, 18, number of times the instruction M20 is run
This parameter is used to set the number of times the program is executed in a loop when the M20 instruction is used. If this parameter is negative, it indicates an infinite loop.
★19. Current number of processing pieces
This parameter is used to display or set the number of times the program instruction M20 is executed, that is, the number of workpieces. ★, 21, G01/G02/G03 inter-segment delay (ms) (>100 valid)
This parameter sets the delay time between G01/G02/G03 program segments. This parameter can solve the problem of overcutting at the eighth corner (between G01 bars).
★22, G00 execute delay (ms) (>100 valid)
This parameter sets the delay time after G00 is executed.
★, 23, smooth acceleration and deceleration constant of handwheel [ 50-100]
Used to set the smooth lifting speed time constant when using the handwheel. The setting range is 50-100. The smaller the value, the faster the lifting speed, but the greater the vibration.
★, 200, system screen time (minutes)
When you are in the main interface and not in the dialog box state, wait for the processing parameter 200 to be set for a time (<2 minutes without screen protection) before entering the screen protection. After the screen protection, return by any key.
★, 202, system internal parameters
The coordinate axis is displayed (1 for normal, 4 for no X, 8 for no Y, 16 for no Z, 32 only displays X, 64 only displays
Y, 128 Shows Z, 256 Shows XY)
Internal parameters can set the display mode of coordinate axes. 4 means not to show X, 8 means not to show Y, 16 means not to show Z, 32 means only to show X, 64 means only to show Y, 128 means only to show Z, and 256 means to show XY.
★ 203, whether to strictly check G41/G42 (Table 23103490 enables the pause button, Table 2131970 strictly checks

- 117 -

查,34818 表不严格检查,6326274 表快速预读加工) 此参数为特殊参数，2131970 表示严格检查 G41/G42 指令,34818 表不严格检 查 G41/G42 指令,6326274 表快速预读 G41/G42 指令。
★、205,内部参数(+8 表插补攻丝要等待脉冲发完;32 表三位小数;96 四位 小数;160 表 HX-G 指令;+4096 表铣床循环不编坐标点就不执行)
内部参数，+8 表示插补攻丝要等待脉冲发完才执行下一条指令;32 表示坐标 轴显示为三位小数;96 表示坐标轴显示四位小数;160 表示 HX-G 特殊指令;+4096 表铣床循环指令不编坐标点时就不执行。
★、210,启用图形显示区域(8 表启用固定显示区域,+16 表按铣床模式显示 图形)
P210 表示启用图形显示区域功能，8 表示启用固定显示区域,+16 表示按铣 床模式显示图形，P211-P216 表示 XYZ 区域设置。
★、211,图形显示区域 X 轴负端
★、212,图形显示区域 X 轴正端
★、213,图形显示区域 Y 轴负端
★、214,图形显示区域 Y 轴正端
★、215,图形显示区域 Z 轴负端
★、216,图形显示区域 Z 轴正端
★、230,通过输入点选择执行程序(+4+8+16+32+64+128 对应 X26-X31) 通过输入点选择执行程序，如设置为+4+8=12，则 X26 或者 X27 有效时选择 程序 HIDEFILEX26 或 X26 或者 HIDEFILEX27 或 X27。
D2 位为 1 即 +4 表 X26 有效时执行 X26 程序或 HIDEFILEX26 程序; D3 位为 1 即 +8 表 X27 有效时执行 X27 程序或 HIDEFILEX27 程序; D4 位为 1 即 +16 表 X28 有效时执行 X28 程序或 HIDEFILEX28 程序; D5 位为 1 即 +32 表 X29 有效时执行 X29 程序或 HIDEFILEX29 程序; D6 位为 1 即 +64 表 X30 有效时执行 X30 程序或 HIDEFILEX30 程序; D7 位为 1 即 +128 表 X31 有效时执行 X31 程序或 HIDEFILEX31 程序; D8 位为 1 即 +256 表 X16 有效时执行 X16 程序或 HIDEFILEX16 程序; D9 位为 1 即 +512 表 X17 有效时执行 X17 程序或 HIDEFILEX17 程序; D10 位为 1 即+1024 表 X18 有效时执行 X18 程序或 HIDEFILEX18 程序; D11 位为 1 即+2048 表 X19 有效时执行 X19 程序或 HIDEFILEX19 程序; D12 位为 1 即+4096 表 X20 有效时执行 X20 程序或 HIDEFILEX20 程序; D13 位为 1 即+8192 表 X21 有效时执行 X21 程序或 HIDEFILEX21 程序; D14 位为 1 即+16384 表 X22 有效时执行 X22 程序或 HIDEFILEX22 程序; D15 位为 1 即+32768 表 X23 有效时执行 X23 程序或 HIDEFILEX23 程序; ★、231,删除键的操作方式[0 表向后删除,1 表向前删除] 设置按“删除”键的方式，0 表示向后删除,1 表示向前删除。 ★、232,攻丝前是否检测主轴零位[18 表是,0 表示否]
设置为 18 时表示攻丝前要检测主轴编码器零位开始攻丝，设置为 0 时表示 不检测编码器零位。

- numerical control system -
- 117 -

Check 34818, Table not strictly checked, 6326274 Table fast pre-reading processing)
This parameter is a special parameter. 2131970 indicates strict check of G41/G42 instructions, 34818 indicates not strict check of G41/ G42 instructions, and 6326274 indicates fast pre-read of G41/G42 instructions.
★205, internal parameters (+8 indicates that thread insertion must wait for pulse completion; 32 indicates three decimal places; 96 indicates four decimal places; 160 indicates HX-G command; +4096 indicates that milling cycle will not execute if coordinate points are not programmed)
Internal parameters: +8 indicates that the thread insertion must wait until the pulse is completed before executing the next instruction; 32 indicates that the coordinate axis display uses three decimal digits; 96 indicates that the coordinate axis display uses four decimal digits; 160 indicates HX-G special instructions; +4096 means that the milling cycle instruction will not be executed if no coordinate points are programmed.
★210, enable the graphic display area (8 enables the fixed display area, +16 displays the graphics in milling mode)
P210 means to enable the function of graphic display area, 8 means to enable fixed display area, +16 means to display graphics in milling mode, P211-P216 means to set the XYZ area.
★, 211, the negative end of the X-axis in the graphical display area ★, 212, the positive end of the X-axis in the graphical display area ★, 213, the negative end of the Y-axis in the graphical display area ★, 214, the positive end of the Y-axis in the graphical display area ★, 215, graphics display area Z-axis negative end
★, 216, the graphic display area is on the positive end of the Z-axis ★230. Select the execution program by input points (+4, +8, +16, +32, +64, +128 corresponding to X26-X31)
Select the program by entering the input point. If it is set to +4+8= 12, select the program HIDEFILEX26 or X26 or HIDEFILEX27 or X27 when X26 or X27 is valid.
If D2 is 1, that is, +4, X26 is valid and X26, program or HIDEFILEX26 program is executed;
If D3 is 1, that is, +8, and X27 is valid, execute X27, the program, or HIDEFILEX27 program;
If D4 is 1, that is, +16, X28 is valid and X28, program or HIDEFILEX28 program is executed;
If D5 is 1, that is, +32, X29 is valid and X29, program or HIDEFILEX29 program is executed;
When the D6 bit is 1 (i.e., +64), the X30 table is valid and the X 30, program, or HIDEFILEX30 program is executed; when the D7 bit is 1 (i.e., +128), the X31 table is valid and the X31, program, or HIDEFILEX31 program is executed;
If the D8 bit is 1, that is, +256, execute X16, program or HIDEFILEX 16 program when X16 is valid;
When the D9 bit is 1 (i.e., +512), the table X17 is valid and the X 17 program or HIDEFILEX17 program is executed; when the D10 bit is 1 (i.e., +1024), the table X18 is valid and the X18 program or HIDEFILEX18 program is executed;
If D11 is 1, that is, +2048, execute X19 when X19 is valid, or the HIDEFILEX19 program;
If D12 is 1, that is, +4096, execute X20, program or HIDEFILEX20 program when X20 is valid;
When the D13 bit is 1 (i.e., +8192), the X21 table is valid and the X 21 program or HIDEFILEX21 program is executed; when the D14 bit is 1 (i.e., +16384), the X22 table is valid and the X22 program or HIDEFILEX22 program is executed;
When the D15 bit is set to 1 (i.e., +32768), execute X23, program, or HIDEFILEX23 program when Table X23 is valid; ★. 231, delete key operation mode [0: backward deletion of Table, 1: forward deletion of Table]
Set the "Delete" key to 0 for backward deletion and 1 for forward deletion.
★232. Check whether the spindle zero position is detected before tapping [Table 18 is yes, Table 0 is no]
When set to 18, the spindle encoder zero position should be detected before tapping, and when set to 0, the encoder zero position should not be detected.

- 118 -

★、233,G06 圆弧示教功能[0 表关闭,1 表开启]
设置为 1 时表示开启 G06 圆弧示教功能，0 表示关闭此功能。 ★、234,程序运行回退功能[+8 表启动手轮反转回退]
设置为+8 时表示启动程序运行手轮回退功能，正摇手轮时程序正向运行， 反摇手轮时程序回退运行。
★、235,示教时自动生成注释[0 表是,1 表否]
设置为 1 时表示教时自动生成指令注释功能，0 表示关闭此功能。 ★、236,示教产生平面圆弧圆心类型[0 表示 G5/G6 IJK 格式,1 表示 G2/G3 R 格式]
设置为 0 表示示教平面圆弧时采用 G5/G6 IJK 格式，1 表示 G2/G3 R 格式。 ★、237,示教产生指令方式[0 表正常,1 表示示教时每段直线加工行都产生 G01 代码]
设置为 1 时表示示教时每行产生 G01 代码。
★、238,中间行示教时是否自动插入一行[0 表插入,1 表修改]
设置为 0 时表示在中间行教时是插入一行，1 表示修改此行。 ★、239,中间行示教时按 XYZ[0 表插入,1 表修改]
设置为 0 时表示中间行示教按 XYZ 时是插入 XYZ 坐标字，设置为 1 时表示是 修改坐标字。
★、240,示教时相同坐标记录方式[0 不记录,1 记录] 设置示教时相同坐标时的记录方式，设置为 0 时表示不记录坐标字，设置为 1 时表示要记录坐标字。
★、307,M18xx/M28xx/WAT 等检测指令等待最长报警时间(ms)[>=10 有效] 例如：此参数设置为 2000 时，程序 WAT+X16,检测 2 秒还没有检测到 X16 信 号则报警。
★、400-402,转换 DXF 文件要求[1 表排序, 4 表根据起刀点排序, 8 表不排 序]
1）当 P400 设为 1 时，系统按照首尾相连的关系排序。
2）当 P400 设为 4 时，系统按照首尾相连的关系排序后根据前后两个端点与 参数起刀点的距离来判断从哪一个端点下刀,从距离近的端点下刀。
3）当 P400 设为 8 时，系统不会自动排序,用 AutoCAD 绘图生成DXF文件时, 必须注意绘图的顺序,因为 DXF 文件按绘图顺序保存数据,所以生成的 G 代码加 工顺序也是按 DXF 文件的数据保存顺序来执行的。
★、500,自定义 G74 时对应的 ProgramG 编号[101-170 有效(101-150 非模 态,151-170 模态)]
设置自定义指令 G74 对应的宏程序编号，如设置为 101 时表示 G74 指令执行 宏程序 ProgramG101,参数 P501-P504 功能类同。
★、501,自定义 G81 时对应的 ProgramG 编号[101-170 有效(101-150 非模 态,151-170 模态)]
★、502,自定义 G82 时对应的 ProgramG 编号[101-170 有效(101-150 非模 态,151-170 模态)]

- numerical control system -
- 118 -

★, 233, G06 arc teaching function [Table 0 is off, Table 1 is on]
Set to 1 to enable the G06 circular arc teaching function, and 0 to disable this function.
★, 234, program run back function [+8 Start handwheel reverse back]
When set to +8, the program starts to run the handwheel back function. When the handwheel is turned forward, the program runs forward; when the handwheel is turned backward, the program runs backward.
★, 235. Annotations are automatically generated during teaching [Table 0 is yes, Table 1 is no]
When set to 1, the instruction annotation function is automatically generated during teaching. When set to 0, this function is turned off. ★, 236, Teach generates a plane arc center type [0 indicates G5/G6 IJK format, 1 indicates G2/G3 R format]
Setting 0 indicates that the G5/G6 IJK format is used when teaching the plane arc, and setting 1 indicates that the G2/G3 R format is used. ★, 237, Teach generation instruction mode [0 indicates normal, 1 indicates G01 code is generated for each linear processing line during teaching]
When set to 1, the G01 code is generated per row during teaching. ★, 238, whether to automatically insert a line when teaching the middle line [0 for table insertion, 1 for table modification]
Setting it to 0 indicates that a line is inserted when teaching in the middle row, and setting it to 1 indicates that the line is modified.
★, 239, the middle line is taught by inserting according to XYZ[0 table, 1 table modification]
When set to 0, the middle line teaching is inserted according to XYZ when it is set to 1, and the coordinate word is inserted.
★, 240, the same coordinate recording mode is used during teaching [0 no record, 1 record]
Set the recording mode when the same coordinates are set for teaching. If 0 is set, the coordinate word is not recorded; if 1 is set, the coordinate word is recorded.
★, 307, M18xx/M28xx/WAT and other test instructions waiting longest alarm time (ms) [>=10 valid]
For example, if this parameter is set to 2000, the program WAT+X16 will detect no X16 signal within 2 seconds and alarm.
★400-402, Conversion of DXF files requires [Table 1 sorted, Table 4 sorted by starting point, Table 8 unsorted]
1） When P400 is set to 1, the system sorts in a head-to-tail relationship.
2） When P400 is set to 4, the system sorts the endpoints in a headto-tail relationship and determines which endpoint to cut from based on the distance between the two endpoints and the parameter starting point, cutting from the nearest endpoint.
3） When P400 is set to 8, the system will not automatically sort. When drawing DXF files with AutoCAD, attention must be paid to the drawing order, because DXF files save data according to the drawing order, so the processing order of G code generated is also executed according to the data saving order of DXF files.
★When customizing G74, the corresponding ProgramG number [ 101-170 valid (101-150 non-modified, 151-170 modified)]
Set the macro program number corresponding to the G74 command. If set to 101, it indicates that the G74 command executes the macro program ProgramG101, and parameters P501-P504 have the same function.
★501, when customizing G81, the corresponding ProgramG number [101-170 valid (101-150 non-modal, 151-170 modal)]
★502, when customizing G82, the corresponding ProgramG number [101-170 valid (101-150 non-modal, 151-170 modal)]

- 119 -

★、503,自定义 G83 时对应的 ProgramG 编号[101-170 有效(101-150 非模 态,151-170 模态)]
★、504,自定义 G84 时对应的 ProgramG 编号[101-170 有效(101-150 非模 态,151-170 模态)]
★、551,五轴数控机床结构型式(10--99)
[10 表 B 刀具-A 平台,11 表 AC 刀具,12 表 AC 平台,13 表 A 刀具-C 平台,14 表 A 刀具-B 平台;15 表 BC 平台]
P551-P558 用于五轴数控机床 RTCP 功能参数设置，祥见相关指令及使用说 明。
★ 、 552,RTCP | 补 偿 反 向 和 坐 标 系 重 合 ( | 反 向
10/14:B+4,A+8;11/12/13:A+4,C+8;15:B+4,C+8; 坐标系重合+16:[12A 轴,13C 轴,14/15B轴]对应编程和工件坐标系重合;+32:12/15C轴对应编程和工件坐标系 重合）
★、553,五轴数控回转平台中心的机床坐标 1(um)
(机床型式为 10/12:A 轴回转中心的 Y 坐标;13:C 轴回转中心的 X 坐标;14:B 轴回转中心的 X 坐标;15:B 轴回转中心的 X 坐标) ★、554,五轴数控回转平台中心的机床坐标 2(um)
(机床型式为 10/12:A 轴回转中心的 Z 坐标;13:C 轴回转中心的 Z 坐标;14:B 轴回转中心的 Z 坐标;15B 轴回转中心的 Z 坐标) ★、555,测量五轴数控回转平台中心时的刀长(um)
(机床型式为 10:测量 A 轴回转中心刀长;12/15:测量五轴数控回转平台中心 刀补值 H1;13:测量 C 轴回转中心刀长;14:测量 B 轴回转中心刀长) ★、556,AC 轴或 BC 轴平台回转型五轴机床的 C 轴回转中心 X 或 Y 轴机床坐 标(um)机床型式为 12 或 15）
★、557,AC轴刀具回转型的AC轴心线在Y方向的偏移量(um)(机床型式为11）

★、558,AC轴刀具回转型的C轴与主轴在X方向的偏移量(um)(机床型式为11） ★、560,RTCP超速时是否报警[1:表示不报警自动降低运行速度;0:表示报警] ★、600-0,M7 指令最长等待时间[>10](ms)
M7 指令最长等待时间，如设置为 100 时表示等待时间为 1000ms。 ★、601,X 轴 M7(>10:跟随误差小于该值;-6:反馈脉冲不再变化;-8:系统脉 冲发完)
设置为-6 时表示 X 轴反馈脉冲不再变化时表示定位完成；设置为-8 时表示 X 轴脉冲发完时定位完成；设置为其它>10 值时表示跟随误差小于设置时定位完成。 参数 P601-P608 表示 X/Y/Z/A/B/C/Xs/Ys 轴，功能类同。
★、700,G31 没有检测到信号时是否报警[0:表禁止进给,1:表报警,+1024:表 不报警]
设置 G31 没有检测到信号时报警方式，0 表示禁止进给，1 表示报警，+1024 时表示不报警。
★、701, 进给轴运动时每 2ms 执行一次 M880-M979[20000--20049 对应

- numerical control system -
- 119 -

★503, when customizing G83, the corresponding ProgramG number [101-170 valid (101-150 non-modal, 151-170 modal)]
★504, ProgramG number corresponding to custom G84 [101-170 valid (101-150 non-modified, 151-170 modified)]
★551, five-axis CNC machine tool structure type (10-99)
[Table 10: Table B Tool-A Platform, Table 11: Table AC Tool, Table 12: Table AC Platform, Table 13: Table A Tool-C Platform, Table 14: Table A Tool-B Platform; Table 15: Table BC Platform]
P551-P558 is used for RTCP function parameter setting of five-axis CNC machine tools. See related instructions and instructions for details. ★ 552. RTCP compensation for reverse and coordinate system alignment (Reverse 10/14: B+4, A+8; 11/12/13: A+4, C+8; 15: B+4, C+8; Coordinate system alignment +16: [12A-axis, 13C-axis, 14/15B-axis] corresponds to programming and workpiece coordinate system alignment; +32:12/15C-axis corresponds to programming and workpiece coordinate system alignment)
★, 553, machine tool coordinate 1 (um) at the center of the five-axis CNC rotary table
(Machine tool type: 10/12: Y-coordinate of the A-axis rotary center; 13: X-coordinate of the C-axis rotary center; 14: X-coordinate of the B-axis rotary center; 15: X-coordinate of the B-axis rotary center)
★, 554, machine tool coordinates 2 (um) at the center of the five-axis CNC rotary table
(Machine tool type: 10/12: Z-coordinate of A-axis rotary center; 13: Z-coordinate of C-axis rotary center; 14: Z-coordinate of B-axis rotary center; 15B: Z-coordinate of B-axis rotary center)
★555, measuring the tool length (um) when the center of the five-axis CNC rotary platform is measured
(Machine tool type: 10: measure the A-axis rotary center tool length; 12/15: measure the five-axis CNC rotary platform center tool compensation value H1; 13: measure the C-axis rotary center tool length; 14: measure the B-axis rotary center tool length)
★556, AC or BC axis platform rotary five-axis machine tool C-axis rotary center X or Y axis machine tool coordinates (um) Machine tool type 12 or 15)
★557, Y-directional offset of AC spindle centerline in return-to-tool mode (um) (machine tool type 11)
★ ★ 558, the X-axis offset between the AC tool return-type C-axis and spindle (inum) (machine type: 11)★ 560, whether to trigger an alarm when RTCP exceeds speed limit [1: indicates no alarm and automatic speed reduction; 0: triggers alarm]★ 600-0, maximum M7 command waiting time (>10) (ms)
M7 is the maximum waiting time. If set to 100, the waiting time is 1000ms.
★601, X-axis M7 (>10: the following error is less than this value; -6: the feedback pulse no longer changes; -8: the system pulse has been sent out)
When set to-6, the positioning is completed when the X-axis feedback pulse stops changing. When set to-8, positioning is completed upon completion of X-axis pulse transmission. For other values>10, positioning is achieved when the tracking error falls below the preset threshold. Parameters P601-P608 apply to the X/Y/Z/A/B/C/Xs/Ys axes, sharing similar functionality.
★, 700, G31 whether to alarm when no signal is detected [0: table prohibits feed, 1: table alarms, +1024: table does not alarm]
Set the alarm mode when no signal is detected in G31.0 means to prohibit feed, 1 means to alarm, and +1024 means not to alarm.
★, 701, the feed axis moves and performs M880-M979 every 2ms [ 20000-20049 corresponding

- 120 -

ProgramUser0--49]
表示坐标轴运动时每 2ms 执行一次宏程序，如设置为 20000 表示运行坐标轴 时每 2ms 执行一次 ProgramUser0。

3．7．2 速度参数

★、1，X 轴 G00 速度(mm/min)
自动运行时X轴的快移（G00指令调用的速度）速度。最大值：30000。单位：mm/min， 参数 P1-P5 功能类同，分别是 X/Y/Z/A/B/C/Xs/Ys 轴的 G00 速度。 注：该值的大小与机床配置有关，设置不当可能造成设备故障或事故。 ★、6，手动最大进给速度(mm/min)
设置手动状态下进给轴的最高运行速度限制。单位：mm/min。
参数 P6-1/P6-2/P6-3/P6-4/P6-5 分别是 X/Y/Z/A/B/C/Xs/Ys 的手动最大速 度。
注意：该值设置建议为 G00 速度的 50%，以确保手动运行安全。 ★、7，自动最大进给速度(mm/min)
自动运行的最高速度。最大值：30000。单位：mm/min。 为确保各轴能够运行的最大速度保证效率，可将此参数值高于 G00 速度，以 确保在联动（限制的是合成速度）时各轴达到最大速度。
★、8，G01/G02/G03 缺省速度(mm/min) 当程序中第一个插补指令（G01/G02/G03）没有给定速度时，在自动运行时 该指令所调用的速度。最大值：5000。单位：mm/min。 ★、9，空运行速度(mm/min)
程序空运行所执行的速度。最大值：30000。单位：mm/min。 ★、10，进给轴手动速度(mm/min)
手动状态下进给轴速度设定值。设置范围：＜手动最大进给速度。单位： mm/min。
注：手动状态按 F 健设置后自动刷新此参数值。
★、11，主轴手动转速(rpm)
手动状态下主轴速度设定值。单位：rpm。
注：手动状态按 S 健设置后自动刷新此参数值。
★、12,进给轴运行起跳速度(mm/min)
★、13,进给轴速度最大突变量(mm/min)
★、14，限制 G1G2G3 单轴速度[1 表是,0 表否] 用于设置是否限制插补时各轴的最高运行速度。当该参数设置为 1 表示限制， 即插补时各轴最高运行速度将受参数限制，0 则反之。P15-P19 设置 X/Y/Z/A/B 轴的限制 G1G2G3 最高速度(mm/min)。
★、20，X 轴加减速常数
X 轴升降速时间常数，值越大升降速越快。数值范围：1-99999。P20-P24 设 置 X/Y/Z/A/B/C/Xs/Ys 轴的加减速常数。

- numerical control system -
- 120 -

ProgramUser0--49]
Indicates that the macro program is executed every 2ms when the coordinate axis moves. If set to 20000, it means that ProgramUser0 is executed every 2ms when the coordinate axis runs.
3．7．2 Parameter of Velocity
★, 1, X-axis G00 speed (mm/min)
The speed of the X-axis fast move (the speed called by the G00 command) during automatic operation. Maximum value: 30,000. Unit: mm/min. Parameters P1-P5 have similar functions, which are the G00 speeds of the X/Y/Z/A/B/C/Xs/Ys axes respectively.
Note: The value is related to the configuration of the machine tool, and improper setting may cause equipment failure or accident.
★, 6, maximum manual feed speed (mm/min)
Set the maximum feed speed limit in manual mode. Unit: mm/min. Parameters P6-1/P6-2/P6-3/P6-4/P6-5 are the manual maximum speeds of X/Y/Z/A/B/C/Xs/Ys respectively.
Note: This value is recommended to be set at 50% of G00 speed to ensure safe manual operation.
★, 7, Automatic maximum feed speed (mm/min)
Maximum speed of automatic operation. Maximum value: 30,000. Unit: mm/min.
To ensure maximum speed of each axis to ensure efficiency, this parameter value can be higher than G00 speed to ensure that each axis reaches maximum speed when linkage (limited by synthesis speed) is achieved.
★, 8, G01/G02/G03 default speed (mm/min)
When the first interpolation instruction (G01/G02/G03) in the program does not give a speed, the speed called by this instruction is the maximum value during automatic operation. Maximum: 5000. Unit: mm/min.
★, 9, empty running speed (mm/min)
Maximum speed at which the program runs empty. Maximum: 30,000. Unit: mm/min.
★, 10, feed axis manual speed (mm/min)
Set the feed axis speed in manual mode. Setting range: <maximum feed speed in manual mode. Unit:
mm/min。
Note: The manual status is automatically refreshed after setting this parameter value by F key.
★, 11, spindle manual speed (rpm)
Manual spindle speed setting. Unit: rpm.
Note: The manual status is automatically refreshed after being set to S key.
★, 12, feed axis running jump speed (mm/min)
★13. Maximum abrupt variation of feed axis speed (mm/min)
★14. Limit the G1G2G3 single-axis speed [1 indicates yes, 0 indicates no]
This parameter is used to set whether to limit the maximum operating speed of each axis during interpolation. When this parameter is set to 1, it indicates a restriction, meaning the maximum operating speed of each axis during interpolation will be limited by the parameter. If set to 0, the opposite applies. Parameters P15-P19 set the maximum speeds (mm/min) for G1, G2, G3 axes in X/Y/Z/A/B directions.
★, 20, X-axis acceleration and deceleration constant
X-axis acceleration and deceleration time constant. The larger the value, the faster the acceleration and deceleration. Value range: 1 -99999. P20-P24 Set the acceleration and deceleration constants of X/ Y/Z/A/B/C/Xs/Ys axes.

- 121 -

注：该值的大小与机床配置有关，设置不当可能造成设备故障或事故。通常 情况下负载越重参数值越小，配置步进时该值不能大于 15000。 ★、25，自动运行加减速常数
用于设置自动运行升降速度常数，设置范围 1-500。当该项参数值设置在 1-500 范围内时自动运行升降速处理速度以本参数为准，否则按用户参数中各轴 的升降加速度参数值为准。
本参数的设置主要为了区分手动和自动的升降速度，只有两种状态要求的升 降速度差异较大时才设置此参数，通常情况下设为无效。
★、26，手轮加减速常数
用于设置使用手轮时升降速时间常数，设置范围 500-32000，值越大升降速 越快。
★、27，手轮试机加减速常数
用于设置手轮触发自动运行时的升降速时间常数，设置范围 500-32000，值 越大升降速越快。
注：该参数值低于 500 表示无效，各轴升降速按常规执行。 ★、28，手轮试机 G00 速度(mm/min)
用于设置手轮触发自动运行时的空运行速度，单位：mm/min。 注：该参数值低于 10 表示无效，按各轴 G00 执行。
★、29，手轮 X 轴限制速度(mm/min)
用于设置手动状态X轴使用手脉时的最高速度，单位：mm/min。设置范围100～ 手动最大速度。P29-P33设置Y/Z/A/B/C/Xs/Ys轴的手轮限制速度(mm/min)。 本参数设置的大小与机床配置有关系，建议此值不超过4000，以确保运行安 全。
注意：当设定值大于100时方可生效，否则，不对最高速度进行限制。 ★、33-1，螺纹加工 Z 轴加减速常数
用于设置螺纹加工时 Z 轴升降速时间常数，设置范围 300-90000，值越大降 速越快。
注：该参数设置与机床配置有关系，步进时可将该设置小一些，以确保运行 安全。
该参数设置小于 300 表示无升降速，通常伺服为保证效率可设置为不需要升 降速，即设置为 0。
★、33-2，螺纹加工 X 轴加减速常数[伺服驱动器设为 0] 用于设置螺纹加工时 X 轴升降速时间常数，设置范围 300-90000，值越大降 速越快。
注：该参数设置与机床配置有关系，步进时可将该设置小一些，以确保运行 安全。
该参数设置小于 300 表示无升降速，通常伺服为保证效率可设置为不需要升 降速，即设置为 0。
★、33-3，伺服电机螺纹循环 X 轴退尾速度倍率
用于设置伺服配置情况下螺纹加工时 X 退尾速度的快慢。单位：0.1 倍.

- numerical control system -
- 121 -

Note: The value is related to the configuration of the machine tool, and improper setting may cause equipment failure or accident. Under normal circumstances, the heavier the load, the smaller the parameter value. When configuring the step, this value should not be greater than 15000.
★, 25, automatically run the acceleration and deceleration constant Used to set the automatic operation lifting speed constant, the setting range is 1-500. When this parameter value is set in the range of 1-500, the automatic operation lifting speed processing speed is based on this parameter, otherwise it is based on the user's parameters of each axis lifting acceleration parameters.
This parameter is mainly set to distinguish the lifting speed between manual and automatic. This parameter is only set when there is a large difference in the lifting speed required by the two states, and it is usually set as invalid.
★, 26, handwheel acceleration and deceleration constant
Used to set the lifting speed time constant when using the handwheel. The setting range is 500-32000. The larger the value, the faster the lifting speed.
★27. Test the acceleration and deceleration constant of the handwheel
Used to set the speed time constant when the handwheel is triggered to run automatically. The setting range is 500-32000, and the larger the value, the faster the speed of lifting and lowering.
Note: If the value of this parameter is lower than 500, it is invalid. The lifting speed of each axis is executed according to the conventional method.
★, 28, handwheel test machine G00 speed (mm/min)
Used to set the empty running speed when the handwheel is triggered to run automatically. Unit: mm/min.
Note: If the value of this parameter is less than 10, it is invalid and G 00 is executed for each axis.
★, 29, handwheel X-axis speed limit (mm/min)
Set the maximum speed of manual X-axis operation using palm print, unit: mm/min. The setting range is 100 to maximum manual speed. Set the handwheel limit speed (mm/min) for Y/Z/A/B/C/Xs/Ys axes on pages P29-P33.
The size of this parameter setting is related to the configuration of the machine tool. It is recommended that this value does not exceed 4000 to ensure safe operation.
Note: The maximum speed is not limited if the set value is greater than 100.
★33-1, Z-axis acceleration constant for thread machining
Used to set the time constant of Z-axis lifting speed during thread processing. The setting range is 300-90000. The larger the value, the faster the speed of descent.
Note: This parameter setting is related to the machine tool configuration. When stepping, you can set it smaller to ensure safe operation.
If this parameter is set to less than 300, it means that there is no speed rise or fall. Usually, the servo can be set to 0 to ensure efficiency. ★33-2, Thread processing X-axis acceleration and deceleration constant [servo driver set to 0]
Used to set the time constant of X-axis lifting speed during thread processing. The setting range is 300-90000, and the larger the value, the faster the speed of descent.
Note: This parameter setting is related to the machine tool configuration. When stepping, you can set it smaller to ensure safe operation.
If this parameter is set to less than 300, it means that there is no speed rise or fall. Usually, the servo can be set to 0 to ensure efficiency. ★33-3, servo motor thread cycle X-axis tail speed multiplier
Used to set the fastness of X tail-back speed during thread machining in servo configuration. Unit: 0.1 times.

- 122 -

★、34，加减速型式
该参数用于设置各轴升降速的类型，设置为 8 表示进给轴升降速为曲线型 （S 形），0 表示直线型。
注：该参数设置与驱动配置有关，通常情况步进设置为曲线型，伺服设置为 直线型。
★、35，曲线型的初始加减速常数
该参数用于设置曲线型加速度的初始加减速常数，该值越大加速越快。 注：该参数值大于 10 有效。
★、36，曲线型的加减速二阶常数[>=10]
该参数用于设置曲线型加速度的二阶加减速常数，该值越大加速越快。 注：该参数值大于 10 有效。
★、37，曲线型的最大加减速常数[>=500]
该参数用于设置曲线型加速度的最大加减速常数，该值越大加速越快。 注：该参数值大于 500 有效，否则采用直线型的各轴加减速常数。 ★、38，X 轴回零正向速度(mm/min)
X 轴回参考点时正向碰参考点开关的运行速度。单位：mm/min。数值范围： 小于 X 轴 G00 速度。P38/P40/P42/P44/P46 分别设置 X/Y/Z/A/B/C/Xs/Ys 轴的回 零正向速度(mm/min)。
★、39，X 轴回零反向速度(mm/min)
X 轴回参考点时,脱开参考点开关后检测电机 Z 脉冲信号的速度。数值范围： 20-500。P39/P41/P43/P45/P47 分别设置 X/Y/Z/A/B/C/Xs/Ys 轴的回零反向速度 (mm/min)。
注意：该参数值会影响回参考点精度，值越小时精度会更高。此值一但设定 好了就不要再改动了,否则也会影响到参考点位置。
★、41-0,C 轴回编码器零参考点前运行的距离(1/1000 度)
系统主轴设置为 C 轴时，M800 指令 C 轴回编码器零位前的运行距离(1/1000 度)，P41 为 M800 指令 C 轴回编码器零位的速度(mm/min)。 ★、48-1，恒线速控制下 G96 的主轴速度下限值(rpm)
该参数用于设置执行 G96 恒线速控制时，主轴速度下限值。 ★、48，主轴高档最高转速(rpm)
用于设置主轴最高转速，也就是对应 10V 指令电压时的转速。单位：r/min 注：当有高低档、多档功能时此参数为主轴高档、第一档最高转速。 ★、49，主轴低档(第二档)最高转速(rpm)
用于设置主轴低档(第二档)最高转速，也就是对应 10V 指令电压时的转速。 单位：r/min。
★、50，主轴第三档最高转速(rpm)
用于设置主轴第三档最高转速，也就是对应 10V 指令电压时的转速。单位： r/min
★、51，主轴第四档最高转速(rpm)
用于设置主轴第四档最高转速，也就是对应 10V 指令电压时的转速。单位：

- numerical control system -
- 122 -

★34. Acceleration and deceleration type
This parameter is used to set the type of the lifting speed of each axis. If set to 8, it indicates that the lifting speed of the feed axis is Sshaped, and 0 indicates that it is straight.
Note: This parameter setting is related to the drive configuration. In general, the step setting is curve type and the servo setting is straight line type.
★35, the initial acceleration and deceleration constant of the curve type
This parameter is used to set the initial acceleration and deceleration constant of the curved acceleration. The larger this value is, the faster the acceleration is.
Note: The parameter value is valid only if it is greater than 10.
★36, The second-order constant of the curve type acceleration and deceleration [>=10]
This parameter is used to set the second-order acceleration and deceleration constant of the curved acceleration. The larger this value is, the faster the acceleration is.
Note: The parameter value is valid only if it is greater than 10.
★, 37, maximum acceleration and deceleration constant of the curve type [>=500]
This parameter is used to set the maximum acceleration and deceleration constant of the curved acceleration. The larger this value is, the faster the acceleration is.
Note: The value of this parameter is valid only when it is greater than 500, otherwise the linear acceleration and deceleration constants of each axis are used.
★38, X-axis zero return forward speed (mm/min)
The forward speed of the reference point switch when the X-axis returns to the reference point. Unit: mm/min. Value range: Less than the G00 speed of the X-axis. P38/P40/P42/P44/P46 respectively set the forward speed of the X/Y/Z/A/B/C/Xs/Ys axis return to zero (mm/min). ★, 39, X-axis return zero reverse speed (mm/min)
When the X-axis returns to the reference point, the speed of the motor Z pulse signal is detected after disconnecting the reference point switch. Value range: 20-500. P39/P41/P43/P45/P47 respectively set the return zero reverse speed (mm/min) for the X/Y/Z/A/B/C/Xs/Ys axes. Note: The value of this parameter affects the accuracy of the reference point. The smaller the value, the higher the accuracy. Once this value is set, do not change it, otherwise the reference point position will also be affected.
★, 41-0, Distance (1/1000 degree) traveled before the zero reference point of the C-axis return encoder
When the system spindle is set to the C-axis, M800 indicates the running distance (1/1000 degree) before the C-axis return encoder zero position, and P41 is the speed (mm/min) of the M800 command for the C-axis return encoder zero position.
★48-1, lower limit of spindle speed (rpm) for G96 under constant linear speed control
This parameter is used to set the lower limit of spindle speed when G96 constant line speed control is performed.
★48, maximum spindle speed (rpm)
Used to set the maximum spindle speed, that is, the speed corresponding to the 10V instruction voltage. Unit: r/min
Note: When there are high and low speed, multi-speed functions, this parameter is the spindle high speed, the first speed is the highest. ★49, spindle low gear (second gear) maximum speed (rpm)
Used to set the maximum speed of the spindle at low speed (second speed), that is, the speed corresponding to the 10V instruction voltage. Unit: r/min.
★50, maximum spindle speed (rpm) at third gear
Used to set the maximum speed of the spindle in the third gear, that is, the speed corresponding to the 10V instruction voltage. Unit: r/min ★51. Maximum spindle speed (rpm) at fourth gear
Used to set the maximum speed of the spindle in the fourth gear, that is, the speed corresponding to the 10V instruction voltage. Unit:

- 123 -

r/min
★、52，第二主轴最高转速(rpm)
用于设置第二主轴最高转速，也就是对应 10V 指令电压时的转速。单位： r/min。P52-1/P52-2 设置第三/四主轴最高转速(SC/SD 指令对应的主轴转速)， P52-3/P52-4 设置第三/四主轴手动转速。
★、52-0,主轴点动时固定转速(0.1rpm)[>2] 设置主轴点动时的固定转速，设置值大于 2 时有效，否则用手动时的转速。 ★、52-5,第一主轴最低转速(rpm)或最低电压(mV,前面加-负号表电压)[S0 测试值]
方法1:第一主轴最低转速，例如:设置为100 时表示S0 时的转速为100 rpm； 方法 2:第一主轴最低电压，例如:设置为-100 时表示 S0 时输出 100mV。 ★、52-6,第一主轴最高转速(rpm)或最高电压(mV,前面加-负号表电压)[S 最高转速测试值]
方法 1:第一主轴最高转速，例如:设置为 3000 时表示输出 10V 时的转速为 3000 rpm；
方法2:第一主轴最高电压，例如:设置为-10000 时表示最高转速时输出10V。 ★、52-7,第二主轴最低转速(rpm)或最低电压(mV,前面加-负号表电压)[SS0 测试值]
方法 1:第二主轴最低转速，例如:设置为 100 时表示 SS0 时的转速为 100 rpm；
方法 2:第二主轴最低电压，例如:设置为-100 时表示 SS0 时输出 100mV。 ★、52-8,第二主轴最高转速(rpm)或最高电压(mV,前面加-负号表电压)[SS 最高转速测试值]
方法 1:第二主轴最高转速，例如:设置为 3000 时表示输出 10V 时的转速为 3000 rpm；
方法2:第二主轴最高电压，例如:设置为-10000 时表示最高转速时输出10V。

★ 、53，圆弧间隙补偿方式(0 表 A:间隙值越大补偿速度越快,8 表 B:补偿 速度由参数决定，+4 表:圆弧编程 IJK 是终点到圆心的坐标，+256 螺旋 线插补速度不超过 F)
设为 0 时， A 方式: 间隙值一次性补偿完,执行圆弧反向间隙补偿时，补偿轴 的补偿速度受反向间隙值的影响，反向间隙值越大补偿速度越快，以保证刀具不 发生暂停现象，但补偿轴的补偿速度不会超过 10000mm/min；
设为+8 时， B 方式: 间隙值分段补偿,执行圆弧反向间隙补偿时，补偿轴的补 偿速度由参数值决定；
+4 表时：圆弧编程 IJK 是终点到圆心的坐标，在原参数值上加上 4 表示： 圆弧指令 G02G03 的 IJK 编程相对于终点, 否则为相对于起点。
+256 时：表示螺旋线加工时不超过设定 F 值。
★、54，圆弧进行 B 型间隙补偿的速度(mm/min)
方式 B 间隙补偿速度。单位：r/min。P51-1 设置 B 间隙补偿的起跳速度

- numerical control system -
- 123 -

r/min
★52, maximum speed of the second spindle (rpm)
Set the maximum rotational speed of the second spindle, which corresponds to the 10V command voltage. Unit: r/min. P52-1/P52-2 Set the maximum rotational speed of the third/fourth spindles (spindle speeds corresponding to SC/SD commands), and P52-3/P52-4 Set the manual rotational speed of the third/fourth spindles.
★, 52-0, fixed speed (0.1 rpm) when spindle is moved [2]
Set the fixed speed of the spindle during point motion. The value is valid when it is greater than 2, otherwise use the speed of manual operation.
★52-5, Minimum spindle speed (rpm) or minimum voltage (mV, preceded by a minus sign for test voltage) [S0 test value]
Method 1: The lowest rotation speed of the first spindle, for example, is set to 100, indicating that the rotation speed of S0 is 100 rpm;
Method 2: The minimum voltage of the first spindle, for example, is set to-100 when output 100mV is S0.
★52-6, maximum spindle speed (rpm) or maximum voltage (mV, preceded by a minus sign for table voltage) [S maximum speed test value]
Method 1: The maximum speed of the first spindle, for example, if set to 3000, the speed at which output 10V is 3000 rpm;
Method 2: The maximum voltage of the first spindle, for example, is set to-10000 when the output is 10V at the highest speed.
★ 52-7, Minimum speed of the second spindle (rpm) or minimum voltage (mV, with a minus sign in front of the voltage) [SS0 test value] Method 1: The lowest rotation speed of the second spindle, for example, is set to 100, indicating that the rotation speed of SS0 is 100 rpm;
Method 2: The minimum voltage of the second spindle, for example, is set to-100 when SS0 and output 100mV.
★52-8, maximum speed of the second spindle (rpm) or maximum voltage (mV, with a minus sign in front to indicate the voltage) [SS maximum speed test value]
Method 1: The maximum speed of the second spindle, for example, if set to 3000, the speed at which output 10V is 3000 rpm;
Method 2: The maximum voltage of the second spindle, for example, is set to-10000 when the output is 10V at the highest speed. ★ 53, arc gap compensation method (0 Table A: The larger the gap value, the faster the compensation speed; 8 Table B: The compensation speed is determined by parameters; +4 Table: Arc programming IJK is the coordinate from the end point to the center; +256 Spiral interpolation speed does not exceed F)
When set to 0, mode A: The gap value is compensated once. When performing arc reverse gap compensation, the compensation speed of the compensation shaft is affected by the reverse gap value. The larger the reverse gap value, the faster the compensation speed will be, so as to ensure that the tool does not pause, but the compensation speed of the compensation shaft will not exceed 10,000mm/min;
When set to +8, mode B: gap value is segmented compensation. When performing reverse arc gap compensation, the compensation speed of the compensation axis is determined by the parameter value; +4 Time: Arc programming. IJK is the coordinate from the end point to the center of the circle. Adding 4 to the original parameter value indicates that the IJK programming of arc instruction G02G03 is relative to the end point, otherwise it is relative to the starting point. +256: indicates that the spiral line processing does not exceed the set F value.
★54. Speed of arc B-type clearance compensation (mm/min)
Mode B Gap compensation speed. Unit: r/min. P51-1 Set the jump speed of B gap compensation

- 124 -

(mm/min)[>10]。P51-2 设置 B 间隙补偿的加减速常数((mm/min)/s)[>10] ★、55,激活速度处理功能[1 表是, 0 表否]
用于设置系统对短直线是否需要预先进行速度处理，如果设置为“1”，则要 进行处理，设置为“0”则不处理。
★、55-1,程序运行中反向降速时的终止速度(mm/min) 用于程序运行过程中要求反向前降速的终止速度，单位：mm/min。值越大反 向越快。
★、56,硬限位速停临界速度(mm/min)
用于设置硬限位时电机开始减速的速度。伺服不需要减速，一般设置为 1。

★、57,手轮停止速度(mm/min)[>18]
用于设置手轮停止时的速度，单位：mm/min。值越大停止越快。 ★、58,跟随攻丝提刀时主轴转速(rpm)[>1]
编码器跟随攻丝提刀时的主轴转速，如：设置为 100 时表示主轴转速降速到 100r/min 时，Z 轴开始反向提刀。
★、58-1,攻丝时主轴反向间隙补偿(脉冲数)
跟随和刚性攻丝提刀前的主轴反向间隙补偿脉冲数，如：设置为200时表示Z 轴提刀前主轴反转 200 个脉冲后 Z 轴开始反向提刀。 ★、58-2,攻丝主轴反转前 Z 轴提前提刀量(um)[10-5000] 跟随和刚性攻丝主轴反转前 Z 轴反向间隙补偿脉冲数，如：设置为 500 时表 示 Z 轴提刀补偿 500um 主轴开始反转，类似于 Z 轴反向间隙补偿。 ★、58-3,攻丝退刀时进给速度(mm/min)[>=60 有效]
刚性攻丝 Z 轴退刀速度，要求比较高的时候使用，设置 Z 轴退刀速度为参数 固定速度。
★、60,启动平滑处理功能(+4 手动;+8 手轮;+16 程序;P61-P67 值越大越平 稳但精度越差)
<1>P60=28 表示手动/手轮/程序加工均开启平滑处理功能; <2>平滑处理功能——通过 Savitzky-Golay 滤波器实现曲线平滑插值法对折线 进行平滑曲线处理基于 Numpy.convolve 实现滑动平均滤波数据平滑处理,再通 过 log()和 exp()函数算法实现在曲线的波峰波谷时对数据帧数多的平滑滤波, 主要目的是为了解决直线与直线之间或者直线与圆弧之间产生的曲线噪声; <3>由参数 P61-P68 设置平滑处理时间常数,平滑处理时间常数值越大越平稳,但 直线与直线或者直线与圆弧拐角精度越差;
<4>增强平滑处理是将平滑处理出来的脉冲再进行平滑处理，设置级数就是再重 复平滑处理次数，主要是解决一级平滑处理系数太大可能导致轮廓精度差问题 ★、P61,手动平滑处理时间常数[2-500]; 建议设为：4 ★、P62,手轮平滑处理时间常数[2-500]; 建议设为：4 ★、P63,程序平滑处理时间常数[2-500]; 建议设为：6-12 ★、P65,手动增强平滑处理时间常数[2-500] 建议设为：4 ★、P66,手轮增强平滑处理时间常数[2-500] 建议设为：4

- numerical control system -
- 124 -

(mm/min) [>]>10. P51-2 Set the acceleration and deceleration constants for B gap compensation ((mm/min)/s) [>]>10★,55, activate speed processing function [1 table is, 0 table is]
Used to set whether the system needs to preprocess the speed of short lines. If set to "1", processing is required; if set to "0", no processing is required.
★55-1, termination speed (mm/min) during reverse deceleration of the program
The termination speed required for reverse deceleration during the operation of the program, unit: mm/min. The larger the value, the faster the reverse speed.
★56. Hard limit stop critical speed (mm/min)
Used to set the speed at which the motor starts to decelerate when a hard limit is set. The servo does not need to decelerate and is usually set to 1.
★, 57, handwheel stop speed (mm/min) [>]18
Used to set the speed at which the handwheel stops. Unit: mm/min. The larger the value, the faster the stop.
★58, spindle speed (rpm) when following the thread to lift the blade [>]
The spindle speed of the encoder is followed by the spindle speed of the screwdriver, such as: when set to 100, the spindle speed decreases to 100r/min, and the Z-axis starts to lift the tool in reverse. ★58-1, spindle backlash compensation (pulse number) during threading
Follow the number of backlash compensation pulses for the front spindle during rigid thread lifting and tool removal. For example, if it is set to 200, it indicates that the front spindle of the Z-axis lifts the tool in reverse after 200 pulses.
★58-2, advance the Z-axis tool feed before spindle reversal (um) [ 10-5000]
Follow the number of Z-axis backlash compensation pulses before the spindle reversal of the rigid thread, such as: set it to 500, indicating that the Z-axis tool lift compensation is 500um and the spindle starts to reverse, similar to the Z-axis backlash compensation.
★58-3, feed speed (mm/min) when tapping back [>=60 valid] Rigid thread Z axis retraction speed is used when the requirements are relatively high, and the Z axis retraction speed is set as a fixed parameter.
★60, start the smoothing processing function (+4 manual; +8 handwheel; +16 program; P61-P67 The larger the value, the more stable but the less accurate)
<1>P60=28 means that the smoothing processing function is enabled for manual/handwheel/program processing;
<2>Smoothing Function —— Utilizes Savitzky-Golay filter for curve smoothing interpolation. The algorithm employs Numpy convolution to implement sliding average filtering, followed by log() and exp() functions to apply smoothing filter on data frames with higher frame counts during peak and trough detection. This process primarily addresses noise generated between straight lines or between straight lines and arcs.
<3>The smoothing processing time constant is set by parameters P61-P68. The larger the value of the smoothing processing time constant, the more stable it is, but the corner accuracy between a straight line and a straight line or between a straight line and an arc is worse;
<4>The enhanced smoothing process is to smooth the pulse after smoothing. The setting of the number of levels is the number of times of repeated smoothing, which is mainly used to solve the problem that the contour accuracy may be poor due to the large coefficient of the first smoothing process
★P61, manual smoothing time constant [2-500]; it is recommended to set it as: 4
★P62, smooth processing time constant of the handwheel [2-500]; it is recommended to set it as: 4
★, P63, program smoothing processing time constant [2-500]; it is recommended to set it as: 6-12
★, P65, manual enhancement smoothing processing
time constant [2-500] It is recommended to set it as:

4
★P66, the time constant for handwheel smoothing enhancement [2-500] is recommended to be set as: 4

- 125 -

★、P67,自动增强平滑处理时间常数[2-500] 建议设为：12 ★、P68,增强平滑处理等级[1--9](越大越平稳) 建议设为：2-8 ★、101-108，X 起跳速度(mm/min)
用于设定进给轴运行时升速的初始速度，同理也是降速时的终止速度。也就 是进给轴的运行速度低于此值时无升降速过程直接到达，当运行速度高于此值时， 升速时从此值开始。P101-P108表示X/Y/Z/A/B/C/Xs/Ys轴起跳速度(mm/min)[>1]。 注：该值的大小与机床配置有关，设置不当可能造成设备故障或事故。 通常情况下配步进驱动不大于 100，伺服不大于 500。 ★、111-118，X 轴速度最大突变量(mm/min) 用于设定多轴连续轨迹插补时速度发生变化的情况下，为保证插补合成速度 时各轴速度的突变最大增量，也就是变化速度增量值大于此值时会有升（降）速 过程，若小于此值侧直接到达。主要用于增加多轴连续轨迹插补的连贯性。 P111-P118 表示表示 X/Y/Z/A/B/C/Xs/Ys 速度最大突变量(mm/min)[>1]。 例：当此值为 300 时，多轴连续轨迹插补中 X 轴速度从 F800 变为 F1600 时， 其变化过程应为 X 轴速度先从 F800 变为 1100，再加速到 F1600。 ★、200,连贯运动是否对 G00 起作用[16 表是,1 表否]
设置 G00 是否做预读处理功能，设置为 16 时表示做预读连贯运动处理。 ★、210,螺纹加工主轴转速波动率的允许千分比[0 表不等待,>=2 有效] 当此参数设置>2 时表示加工螺纹之前等待主轴稳定后才开始加工，如设置 为 5 时表示主轴转速误差波动小于<5/1000 时开始加工螺纹。 ★、211,刚性攻丝进刀主轴初始速度(rpm)
P211-P218 设置刚性攻丝主轴和 Z 轴退刀初始速度/加速度/预留量/预留量。 ★、212,刚性攻丝退刀主轴初始速度(rpm)
★、213,刚性攻丝进刀主轴始速度(rpm/S)[>1] ★、214,刚性攻丝退刀主轴加减速(rpm/S)[>1] ★、215,刚性攻丝进刀主轴预留量(1/1000 圈)[>2] ★、216,刚性攻丝进刀主轴预留量(1/1000 圈)[>2] ★、217,刚性攻丝退刀主轴预留量(1/1000 圈)[>2] ★、218,刚性攻丝退刀主轴拖尾量(1/1000 圈)[>2]
★、230,主轴 SP 指令 G00 定位速度(0.1rpm)
设置主轴定位时执行 SP 指令 GOO 定位速度。
★、231,SP 方式[+4 按 F 执行,+8 按 G90/G91 执行,+16 由当前显示值发送脉 冲,+8192 模拟量每秒钟发送一次,+16384 执行 M05 关模拟量]
+4 表执行 SP 指令时按当前 F 速度[度/分钟]定位 (在G00状态下依然按主 轴定位速度参数执行),否则按主轴定位速度参数执行。
+8 表执行 SP 指令时受当前 G90/G91 的控制, 为 G90 时表绝对会归算, 为 G91 时表增量不会归算，否则会进行归算并按最近方向运行。
+16 表系统的 SP 数值显示由当前发送脉冲决定，否则由编码器反馈决定显示 值。
+8192 表主轴模拟量每 1 秒钟就重复发送一次。

- numerical control system -
- 125 -

★, P67, the time constant of automatic enhancement smoothing processing [2-500] is recommended to be set as: 12
★P68, enhance the smoothing processing level [1-9] (the
higher, the smoother). It is recommended to set it to: 2-8
★, 101-108, X take-off speed (mm/min)
This parameter determines the initial speed during feed axis acceleration and serves as the termination speed for deceleration. Specifically, when the feed axis speed falls below this threshold, it reaches its target directly without acceleration/deceleration phases. Conversely, when the speed exceeds this value, acceleration begins at this threshold. Sections P101-P108 specify the jump speeds (mm/min) for X/Y/Z/A/B/C/ Xs/Ys axes [1].
Note: The value is related to the configuration of the machine tool, and improper setting may cause equipment failure or accident.
Normally, the step drive is not greater than 100 and the servo is not greater than 500.
★111-118, maximum X-axis velocity variation (mm/min)
This parameter controls the maximum speed variation during multi-axis continuous trajectory interpolation. It ensures that when the interpolated speed reaches its maximum allowable change, the corresponding axis velocity will either accelerate or decelerate. If the actual speed change exceeds this threshold, a gradual acceleration/deceleration process occurs; otherwise, the system directly reaches the target speed. This primarily enhances the continuity of multi-axis trajectory interpolation. Sections P111-P118 specify the maximum speed variation parameters (mm/min) for X/Y/Z/A/B/C/Xs/Ys axes [>]
Example: When this value is 300, when the X-axis speed changes from F800 to F1600 in multi-axis continuous trajectory interpolation, the change process should be X-axis speed first changes from F800 to 1100, and then accelerates to F1600.
★200, whether the continuous motion plays a role in G00 [Table 16 is yes, Table 1 is no]
Set whether G00 performs the pre-reading function. If set to 16, the pre-reading coherent motion processing is performed.
★, 210, permissible thousand percentage rate of variation in spindle speed during thread machining [0 not waiting, ≥2 valid]
When this parameter is set to>2, the machining of the thread will be started after waiting for the spindle to stabilize. If it is set to 5, the machining of the thread will be started when the spindle speed error fluctuation is less than <5/1000.
★211, Initial spindle speed for rigid tapping (rpm)
P211-P218: Set the initial speed, acceleration, reserve amount, and reserve amount of the rigid tapping spindle and Z-axis tool withdrawal. ★ 212: Initial speed (rpm) of the rigid tapping spindle during tool withdrawal.
★, 213, spindle feed speed for rigid tapping [>] 1
★214, Rigid thread attack and retraction spindle acceleration and deceleration (rpm/S) [>]
★, 215, main shaft reserved capacity for rigid thread cutting (1/1000 turn) [>]2
★, 216, main shaft reserved capacity for rigid thread cutting (1/1000 turn) [>]2
★, 217, reserved allowance for rigid tapping and retraction of the spindle (1/1000 turn) [>]2
★, 218, Rigid thread attack retraction spindle tail length (1/1000 turn) [>2]
★230, spindle SP command G00 positioning speed (0.1 rpm)
Set the spindle positioning to execute SP command GOO positioning speed.
★ 231, SP mode [press F for +4, press G90/G91 for +8, send pulses from current display value for +16, send analog signal every second for +8192, execute M05 to turn off analog signal for +16384]
+4 When executing SP command, the table is positioned according to the current F speed [°/min] (the spindle positioning speed parameter is still executed in G00 state), otherwise the spindle positioning speed parameter is executed.
+8 When the table performs the SP instruction, it is controlled by the current G90/G91. When G90, the table absolute will be calculated; when G91, the table increment will not be calculated. Otherwise, the table will be calculated and run in the nearest direction.
+16 The SP value of the table system is determined by the current sending pulse, otherwise it is determined by the encoder feedback. +8192 The table spindle analog signal is sent once every 1 second.

- 126 -

+16384 表执行 M05 主轴停止后模拟量也停止输出。 ★、232,插补方式主轴 SP 指令定位方向[0 表正向,1 表负向,其余表就近方向] 0 表示 SP 指令正方向定位，1 表示 SP 指令负方向定位，其余表就近方向定位。 ★、233,主轴回零方式(1 表脉冲控制,2 表驱动器控制,输出 M61 检测 M22,16 或 32 表主轴准停后定位到参数 P234 角度,16 表输出 M75 检测 M22)
主轴回零方式，1 表示输出脉冲系统回零,2 表示驱动器控制（输出 M61 检测 M22）,16 或 32 表示主轴准停后定位到参数 P234 角度,16 表输出 M75 检测 M22。 ★、234,主轴定向停止角度(0.1 度)
★、235,主轴回零速度(0.1 rpm)

3．7．3 轴类参数

★、1，进给轴波段开关[1 表有,0 表无]
该参数用于设置 X、Z 轴倍率调节采用的操作方式，1 表示采用外接波段开关 调节，0 表示用面板的“进给↑”“进给↓”键调节。
说明：当该参数设置为 1 时，外接波段开关的接口为 CN11 插座的 VDK0(OFF)、 VDK1(X100)、VDK2(X10)、VDK3(X1) 信号。
★、2，主轴和快速波段开关[1 表主轴,2 表 G00 快速,0 表无] 该参数用于设置主轴倍率调节采用的操作方式，1 表示采用外接波段开关调 节，0 表示用面板的“主轴↑”“主轴↓”键调节。
说明：当该参数设置为 1 时，外接波段开关的接口为 CN11 插座的 VDS0(HCOM)、VDS1(Z)、VDS2(Y)、VDS3(X) 信号。
★、3/4，X 轴负向/正向最大行程(mm)
设置 X 轴软限位的负方向/正方向的坐标值，该值是以机床坐标系为基准的。 P3-P12 设置 X/Y/Z/A/B/C/Xs/Ys 等轴的负方向/正方向软限位。 ★、13,主轴制动 Y12 信号模式[0 表主轴制动,1 表主轴使能]
0 表示 M05 输出 Y12 主轴制动，1 表示 M03/M04 时输出 Y12 主轴使能信号。 P13-1 为 0 时设置主轴制动为短信号，1 设置主轴制动为长信号； P13-2 设置主轴制动为短信号时的时间。
★、15,软限位[D0=1 表主轴冷却自动启动;D2 轴 X;D3 轴 Y;D4 轴 Z;D5 轴 A;D6 轴 B;D9 轴 C;D10 轴 XS;D11 轴 YS;1 表不限位;D12MOVE;D14 换刀无限位] 设置软限位功能是否有效，每轴单独设置。该参数为位参数，其中 D2 位控 制 X 轴，D4 位控制 Z 轴，相应位设置为 1 表示该轴软限位功能无效，0 则有效， D15=1 表相对坐标断电保存。
位参数数据格式（其它位参数均一样）：D15D14……D1D0。
例：若想设置 X 轴软限位功能无效则就该参数设置为：00000100 ★、16，X 轴反向间隙补偿(um)
用于设置 X 轴运动反向时，传动机构存在的反向间隙值（半径值表示）。当 该轴运动时涉及到反向的情况，系统自动调用该值进行补偿。单位：μm(微米)。 P16-P20 设置 X/Y/Z/A/B/C/Xs/Ys 的反向间隙补偿。

- numerical control system -
- 126 -

+16384 After the execution of M05, the analog output is also stopped. ★, 232, interpolation mode spindle SP command positioning direction [0: positive table direction, 1: negative table direction, others: nearest direction]
0 1 indicates positive direction positioning of the SP command, 2 indicates negative direction positioning of the SP command, and the rest indicate near-direction positioning. ★ 233: Spindle zeroing method (1 indicates pulse control, 2 indicates driver control, output M61 detects M22,16 or 32 indicates spindle stop positioning to parameter P234 angle after stopping, 16 outputs M75 to detect M22).
The spindle reset modes are as follows: 1 indicates the output pulse system resets, 2 indicates driver control (output M61 detects M22),16 or 32 indicates the spindle stops and positions to parameter P234 angle after stopping, 16 outputs M75 detects M22. ★, 234, spindle directional stop angle (0.1 degrees)
★, 235, spindle return speed (0.1 rpm)
3．7．3 Axis Parameters
★1. Feed axis band switch [1 indicates yes, 0 indicates no]
This parameter is used to set the operation mode of X and Z axis ratio adjustment. 1 indicates that the external band switch is used for adjustment, and 0 indicates that the "feed up" and "feed down" keys on the panel are used for adjustment.
Note: When this parameter is set to 1, the interface of the external band switch is VDK0 (OFF), VDK1 (X100), VDK2 (X10), and VDK3 (X1) signals of the CN11 socket.
★, 2, spindle and fast band switch [1 for spindle, 2 for G00 fast band, 0 for none]
This parameter is used to set the operation mode of spindle ratio adjustment. 1 indicates the use of external band switch adjustment, and 0 indicates the use of "spindle ↑" and "spindle ↓" keys on the panel. Note: When this parameter is set to 1, the external waveband switch is connected to the VDS0 (HCOM), VDS1 (Z), VDS2 (Y), and VDS3 (X) signals of the CN11 socket.
★, 3/4, maximum X-axis negative/positive stroke (mm)
Set the negative/positive direction coordinate values of the soft limit on the X-axis, which are based on the machine tool coordinate system. P3-P12 Set the negative/positive direction soft limits for axes such as X/Y/Z/A/B/C/Xs/Ys.
★13, spindle brake signal mode [0 indicates spindle brake, 1 indicates spindle enable]
0 Indicates that M05 outputs Y12 spindle brake, and 1 indicates that M 03/M04 outputs Y12 spindle enable signal.
When P13-1 is 0, set the spindle brake as short signal, and 1 set the spindle brake as long signal;
P13-2 Time when the spindle brake is set to short signal.
★15, Soft Limit [D0=1: Spindle cooling automatically activated; D2: Axis X; D3: Axis Y; D4: Axis Z; D5: Axis A; D6: Axis B; D9: Axis C; D10: Axis XS; D11: Axis YS; 1: No Limitation; D12: Move; D14: Tool Change with Unlimited Limitation]
The effectiveness of the soft limit function is configured separately for each axis. This parameter is a bit parameter, where D2 controls the X-axis and D4 controls the Z-axis. Setting the corresponding bits to 1 indicates that the soft limit function for that axis is disabled, while setting it to 0 enables activation. When D15=1, the relative coordinate table is powered off and saved.
Bit parameter data format (all other bit parameters are the same): D15 D14...D1D0.
Example: If you want to disable the soft limit function of the X-axis, this parameter should be set to: 00000100
★, 16, X-axis backlash compensation (um)
When setting the reverse movement of the X-axis, the reverse clearance value (radius value) in the transmission mechanism is indicated. When the movement of this axis involves reverse movement, the system automatically calls this value for compensation. Unit: μm (micrometers).
P16-P20 Set the reverse gap compensation for X/Y/Z/A/B/C/Xs/Ys.

- 127 -

★、21，X 轴方向信号
用于改变 X 轴电机方向，即当此值设为 0 时将 X 轴的移动方向等同于指令 方向取反，当此值为 1 时 X 轴移动方向等同于指令方向。
P21-P25 设置 X/Y/Z/A/B/C/Xs/Ys 的电机方向。
★、27/28，X 轴电子齿轮分子/分母
用于设置 X 轴电子齿轮的分子/分母，设值范围为 1-999999。 P29-36 设置 X/Y/Z/A/B/C/Xs/Ys 的电子齿轮分子/分母。 ★、37，XYZ 正限位(+L)[0 表常开,1 表常闭] 用于设置正向硬限位开关的类型，0 表常开,1 表常闭。 ★、38，XYZ 负限位(-L)[0 表常开,1 表常闭]
用于设置负向硬限位开关的类型，0 表常开,1 表常闭。 ★、39，浮动零点及 C 轴坐标归算[D3 轴 X;D4 轴 C(Y);D5 轴 Z;D6 轴 A;D7 轴 B;D8 轴 C;D9 轴 Xs;D10 轴 Ys;1 表示浮动零] 设置浮动零点功能是否有效，每轴单独设置。该参数为位参数，其中 D3 位 控制 X 轴，D5 位控制 Z 轴，相应位设置为 1 表示该轴为浮动零点，0 则表示有机 械零点开关。
例：若想设置 X 轴零点为浮动零点则就该参数设置为：00001000 ★、40，X 轴浮动零点时机床坐标设置
该参数设置当前机床停在的位置浮动零点 X 轴坐标值，开机回零即回到该 浮动零点位置。
当没用机械零点时就设置为浮动零点，进行回零操作时系统将快速定位到该 零点位置。
P40-P44 表示 X/Y/Z/A/B/C/Xs/Ys 轴浮动零点时机床坐标设置。 ★、45,进给轴回零要求[1 表不需要, 0 表提示, 8 表强制, 9 表超强制，15 表所有轴强制，31 表所有轴超强制]
用于设置系统对开机回参考点处理方式，回参考点处理方式有6种： 设置为1时为不需要：每次开机后系统不提示也不做任何限制。 设置为0时为提示方式：每次开机后系统会弹出一个对话框提示操作者执行 回参考点操作，之后不做任何限制。
设置为8时为强制方式：每次开机后运行程序系统会弹出一个对话框提示操 作者执行回参考点操作，并且若在自动运行前不执行回参考点操作，系统将会提 示“进给轴没有回参考点”并不执行程序。
设置为9时为超强制方式：每次开机后进给轴移动系统会弹出一个对话框提 示操作者执行回参考点操作，不执行回参考点操作，系统将会提示“进给轴没有 回参考点”并不执行运动。
设置为15时所有轴为强制方式，设置为31时所有轴为超强制方式。 ★、46,进给轴回零型式[0--反向检测零位；1--反向不检测零位；2--检测 零位不反向；3--不检测零位不反向]
用于设置各进给轴回参考点时检测参考开关和电机编码器的零脉冲信号的 几种方法：

- numerical control system -
- 127 -

★, 21, X-axis direction signal
Used to change the direction of the X-axis motor. That is, when this value is set to 0, the movement direction of the X-axis is equal to the reverse of the instruction direction, and when this value is set to 1, the movement direction of the X-axis is equal to the instruction direction. P21-P25 Set the motor direction of X/Y/Z/A/B/C/Xs/Ys.
★, 27/28, X-axis electron gear numerator/fraction
Used to set the numerator and denominator of the X-axis electronic gear. The value range is 1-999999.
P29-36 Set the electron gear numerator and denominator of X/Y/Z/ A/B/C/Xs/Ys.
★, 37, XYZ positive limit (+L) [0 normally open, 1 normally closed] The type used to set the forward hard limit switch is 0 for normally open and 1 for normally closed.
★, 38, XYZ negative limit (-L) [0 normally open, 1 normally closed] The type used to set the negative hard limit switch is 0 for normally open and 1 for normally closed.
★39, Floating zero point and C-axis coordinate reduction [D3 axis X; D4 axis C (Y); D5 axis Z; D6 axis A; D7 axis B; D8 axis C; D9 axis Xs; D 10 axis Ys; 1 indicates floating zero]
Whether the floating zero point function is set to be effective is set separately for each axis. This parameter is a bit parameter, where D3 bit controls the X-axis and D5 bit controls the Z-axis. If the corresponding bit is set to 1, it indicates that the axis has a floating zero point; if 0, it indicates that there is a mechanical zero point switch.
For example, if you want to set the X-axis zero point as a floating zero point, this parameter should be set to: 00001000
★40, X-axis floating zero point lathe coordinate setting
This parameter sets the floating zero point X axis coordinate value of the current machine tool stop position, and the machine will return to this floating zero point position when starting up.
When the mechanical zero point is not used, it is set as a floating zero point. When the zero return operation is performed, the system will quickly locate to this zero point position.
P40-P44 indicates the floating zero point timing of the X/Y/Z/A/B/C/ Xs/Ys axes in the lathe coordinate setting.
★, 45, feed axis return to zero requirement [1 table does not need, 0 table indicates, 8 table forces, 9 table overforces, 15
Table All shafts are forced, 31 Table All shafts are overforced]
Used to set the system to the starting point return processing mode, there are 6 kinds of return reference point processing modes:
When set to 1, it is not required: the system does not prompt or restrict anything after each startup.
When set to 0, it is a prompt mode: after each startup, the system will pop up a dialog box to prompt the operator to perform the return to reference point operation, and then no restrictions are made.
When set to 8, it is a mandatory mode: after each startup, the program running system will pop up a dialog box prompting the operator to perform the return to reference point operation. If the return to reference point operation is not performed before automatic operation, the system will prompt "the feed axis has no return to reference point" and the program will not be executed.
When the setting is 9, it is an ultra-mandatory mode: after each startup, a dialog box will pop up on the feed axis moving system to prompt the operator to perform the return to reference point operation. If the return to reference point operation is not performed, the system will prompt "the feed axis has no return to reference point" and the movement will not be performed.
When set to 15, all axes are in forced mode, and when set to 31, all axes are in super forced mode.
★46, feed axis return zero mode [0--reverse detection of zero position; 1--reverse no detection of zero position; 2--detection of zero position no reverse; 3--no detection of zero position no reverse] Several methods for detecting the zero pulse signal of the reference switch and motor encoder when setting each feed axis back to the reference point:

- 128 -

设值为 0 时：回参考点时，撞到参考点开关后，反向运行检测到开关脱开后， 再检测电机编码器零脉冲信号。
设值为 1 时：回参考点时，撞到参考开点关后，反向运行检测到开关脱开即 可。
设值为 2 时：回参考点时，撞到参考开点关后，继续向前运行检测到开关脱 开后，再检测电机编码器零脉冲信号；
设置为 3 时：回参考点时，撞到参考开点关后，继续向前运行检测到开关脱 开即可。
回参考点方式应根据设备的电路情况设置，通常情况下建议设置为 0 或 2， 因为如果回参考点不检测电机编码器的零脉冲信号时，精度的保证全靠参考点开 关来保证，相比电机编码器的零脉冲精度就会更差一些。
★、47,回零反向位参数[D2 轴 X;D3 轴 Y;D4 轴 Z;D5 轴 A;D6 轴 B;D7 轴 C;D8 轴 Xs;D9 轴 Ys;0 表正向;1 表负向]
设置进给轴回零的运动方向和先后顺序，每轴单独设置。该参数为位参数， 其中 D2-D9 位控制 X/Y/Z/A/B/C/Xs/Ys 轴的回零运动方向，1 表负向，0 表正向。 ★、48,回零开关常闭位参数[D0 轴 X;D1 轴 Y;D2 轴 Z;D3 轴 A;D4 轴 B;D5 轴 C;D14 轴 Xs;D15 轴 Ys;1 常闭;0 常开;D6=1 手轮/自动;D7=1 手动/自动;D18=1 回 零后 G28 回坐标零]
设置进给轴零点开关的类型，每轴单独设置。该参数为位参数，其中 D0-D5 控制 X/Y/Z/A/B/C/Xs/Ys 轴，1 表常闭，0 表常开。D7 为 1 时手动/自动状态自 动切换，D6 为 1 时手轮/自动状态自动切换。
例：若 X、Z 轴均为常闭开关，则该参数设置为：000000101
★、49，X 轴检测零位长度
设定X轴回零点时开关脱开后，在多大范围内检测电机编码器零脉冲信号。 单位：0.1mm。P49-P53表示X/Y/Z/A/B/C/Xs/Ys/轴检测零位长度。 注：该参数值必须小于电机一转的距离，否则可能造成回零点不对的情况。 ★、54，X 轴回零后偏移量
用于设置X轴回参考点时，当检测到伺服电机零脉冲信号后，再偏移多少距 离后才完成回参考点功能。单位:0.01mm。设值范围-99999～+99999。 P54-P58 表示 X/Y/Z/A/B/C/Xs/Ys 轴回零后的偏移量。
注：回参考点后的偏移是以 G00 速度运动。
★、59，主轴换档时主轴是否启动[1 表是,0 表否, 64 表保持主轴状态] 用于设置主轴高低档位换档时启不启动主轴，1 表示要启动，0 则反之。 ★、60，主轴换档时电机转动速度(1/100rpm) 用于设置主轴高低档位换档时启动主轴的速度。
★、61,主轴换档时转动方向[0 表正,1 表反]
用于设置主轴高低档位换档时启动主轴的方向，1 表示反转，0 表示正转。 ★、62,主轴换档时停止时间(10ms)
用于设置主轴高低档位换档时启动主轴的时间。单位：10ms。 ★、63,主轴换档时低速转动时间(10ms)

- numerical control system -
- 128 -

When the value is set to 0: when returning to the reference point, after hitting the reference point switch, reverse operation is detected and the switch is disengaged, then the zero pulse signal of the motor encoder is detected again.
When the value is set to 1, when returning to the reference point, if the reference opening is closed, the reverse operation can detect the switch is open.
When the value is set to 2: when returning to the reference point, after hitting the reference open switch, continue to run forward and detect the switch disengagement, then detect the zero pulse signal of the motor encoder;
When set to 3, when returning to the reference point, if the reference opening is closed, continue to run forward and detect the switch disengagement.
The return reference point mode should be set according to the circuit condition of the equipment. In general, it is recommended to set it as 0 or 2. Because if the return reference point does not detect the zero pulse signal of the motor encoder, the accuracy guarantee depends entirely on the reference point switch, which will be worse than the zero pulse accuracy of the motor encoder.
★ 47, Zero Reverse Position Parameters [D2 axis X; D3 axis Y; D4 axis Z; D5 axis A; D6 axis B; D7 axis C; D8 axis Xs; D9 axis Ys; 0 indicates forward; 1 indicates reverse]
Set the direction and sequence of feed axis return to zero, which is set separately for each axis. This parameter is a bit parameter, where D2-D9 bits control the return direction of X/Y/Z/A/B/C/Xs/Ys axes. 1 indicates negative direction, and 0 indicates positive direction.
★ 48, Zero reset switch normally closed position parameters [D0 axis X; D1 axis Y; D2 axis Z; D3 axis A; D4 axis B; D5 axis C; D14 axis Xs; D 15 axis Ys; 1 normally closed; 0 normally open; D6=1 manualwheel/ automatic; D7=1 manual/automatic; D18=1 G28 reset after zero]
The type of feed axis zero point switch is configured separately for each axis. This parameter is a bit parameter, where D0-D5 controls the X/Y/Z/A/B/C/Xs/Ys axes, with 1 representing normally closed and 0 representing normally open. When D7 is set to 1, the manual/automatic mode automatically switches; when D6 is set to 1, the handwheel/ automatic mode automatically switches.
For example, if both the X and Z axes are normally closed switches, the parameter is set to: 000000101
★49, X-axis detection zero position length
When the switch is disengaged during X-axis zero point setting, detect the zero pulse signal of the motor encoder within a range of 0.1 mm. P49-P53 indicate the zero position length detected by the X/Y/Z/A/ B/C/Xs/Ys axes.
Note: The value of this parameter must be less than the distance of one rotation of the motor, otherwise it may cause the zero point to be wrong. ★, 54, X-axis offset after zero return
When setting the X-axis return reference point, when the servo motor zero pulse signal is detected, how much distance should be offset before completing the return reference point function. Unit: 0.01 mm. Set value range: -99999~+99999.
P54-P58 indicates the offset after zero return of X/Y/Z/A/B/C/Xs/Ys axes.
Note: The offset after returning to the reference point is moved at G 00 speed.
★59, whether the spindle starts when shifting gears [1 indicates yes, 0 indicates no, 64 indicates keeps the spindle status] is used
to set whether the spindle starts when shifting gears between high and low gears. 1 indicates to start, and 0 indicates otherwise.
★, 60, motor rotation speed when the main shaft shifts (1/100rpm) Used to set the speed at which the spindle starts when shifting between high and low gears.
★, 61, rotation direction when the main shaft shifts [0 indicates forward, 1 indicates reverse]
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
