sergei-tiutriumov/Finishing/КЧ/Путник 2/Roscongress/Документы/PI240107[1].pdf

## INVOICE

Invoice to: KONSTANTIN CHAYKIN | Date: October 11, 2024
Attn: Sergei Tiutriumov | File No.: PI240107
Tel: +7 964 555 20 56
Delivery to: 15 build. 2 Rechnikov str. 115407 Moscow Russia

Shipped By: S&K TIME CO., LTD
From: shenzhen
Payment: BY T/T, 30% deposit and 70% before shipment. Delivery time: shipped before 31.10.2024.
Item No. | Photo | Description | Quantity | Unit Price | Amount
| | | (pcs) | (FOB HK)
SK23-A22 | | 316L stainless steel case with sapphire glass and crown, black genuine leather strap with black stitching and SS buckle , light grey dial in black printing and applied frame and applied completed watches, packed with box. indexes with White Luminova, Ronda 515.24D movement, 10ATM, assembled with the | 110 | US$37.70 | US$4,147.00
SK23-A22 | | black wood box | 110 | US$10.00 | US$1,100.00
Total | | 2% extra watch spare parts free of charge | 220 | | US$5,247.00

Say Total:US DOLLARS FIVE THOUSAND TWO HUNDRED FORTY SEVEN ONLY. Beneficiary Name: S K Time Co., Limited

Account Number: 798133050
BIC/SWIFT: DHBKHKHHXXX
Bank Code: 016
Bank Name: DBS Bank (Hong Kong) Limited
Bank Address: G/F, The Center, 99 Queen''s Road Central, Central, Hong Kong
KONSTANTIN CHAYKIN | S&K TIME CO., LTD
