sergei-tiutriumov/Finishing/КЧ/Путник 2/19_05_2025_Сборка_часов_Путник.docx

Технологический процесс совершения операций по переработке: ручная сборка мастером-часовщиком часов наручных с аналоговой индикацией.

1. Сборка начинается с установки циферблата на механизм.

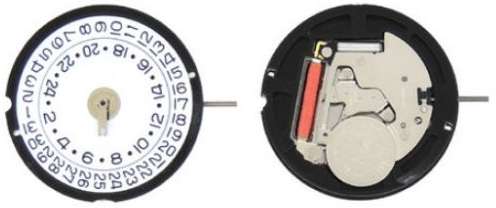
[picture p161: figure]

Механизм RONDA 515.24D

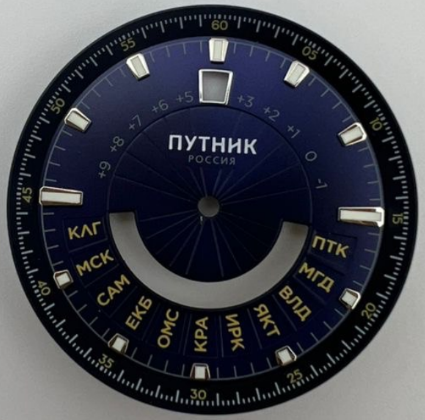
[picture p162: figure]

Циферблат

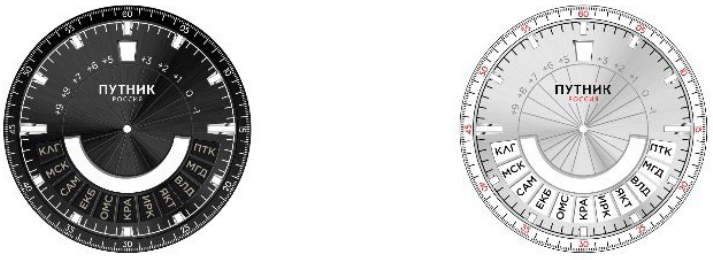
[picture p163: figure]
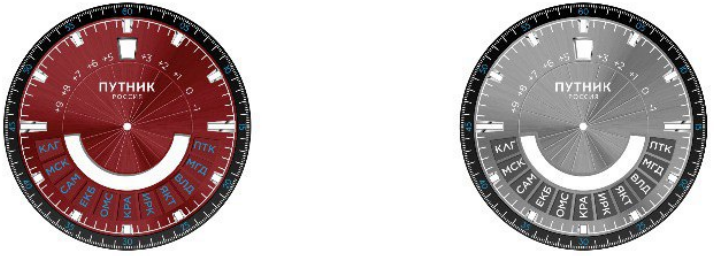
[picture p164: figure]

Варианты циферблата

2. Затем устанавливаются стрелки

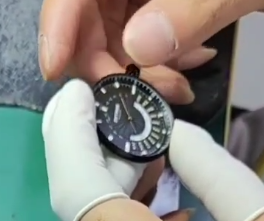
[picture p165: figure]
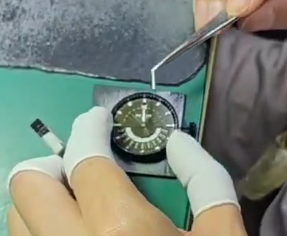
[picture p166: figure]

3. Подготавливается часовой корпус, удаляется пыль.

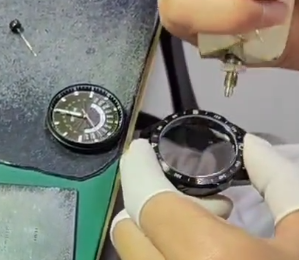
[picture p167: figure]
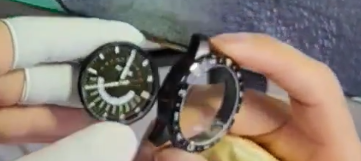
[picture p168: figure]

4. Механизм с циферблатом всталяется в корпус

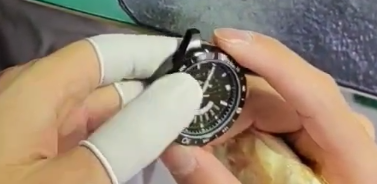
[picture p169: figure]

5. Корпус переворачивается крышкой вверх и вставляется подогнанный по длине заводной вал с установленной заводной головкой

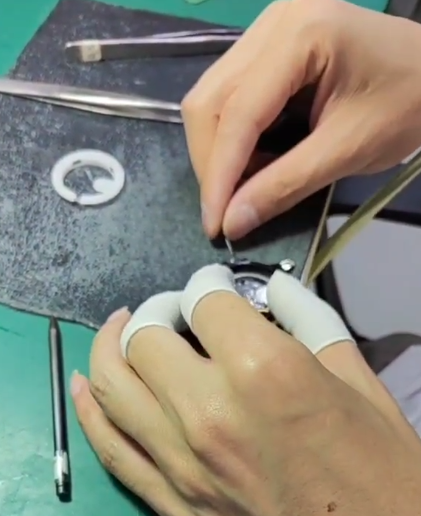
[picture p170: figure]
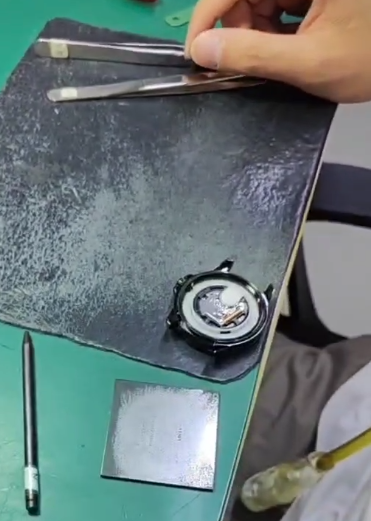
[picture p171: figure]

6. Устанавливается пластиковое проставочное кольцо для фиксации механизма в корпусе

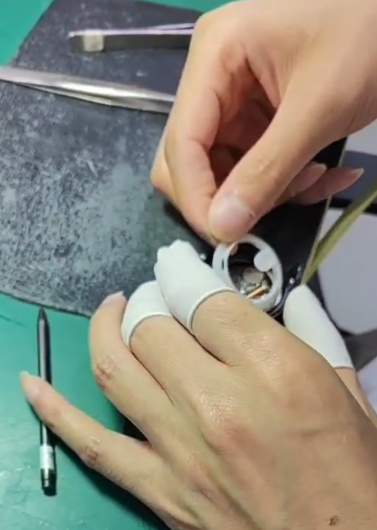
[picture p172: figure]

7. На корпусе завинчивается задняя крышка

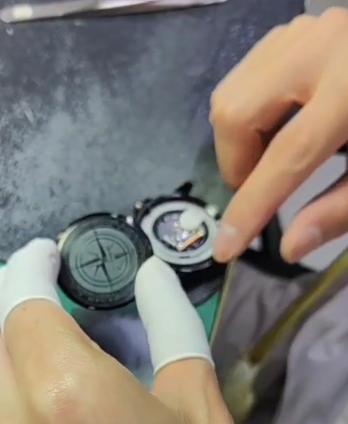
[picture p173: figure]
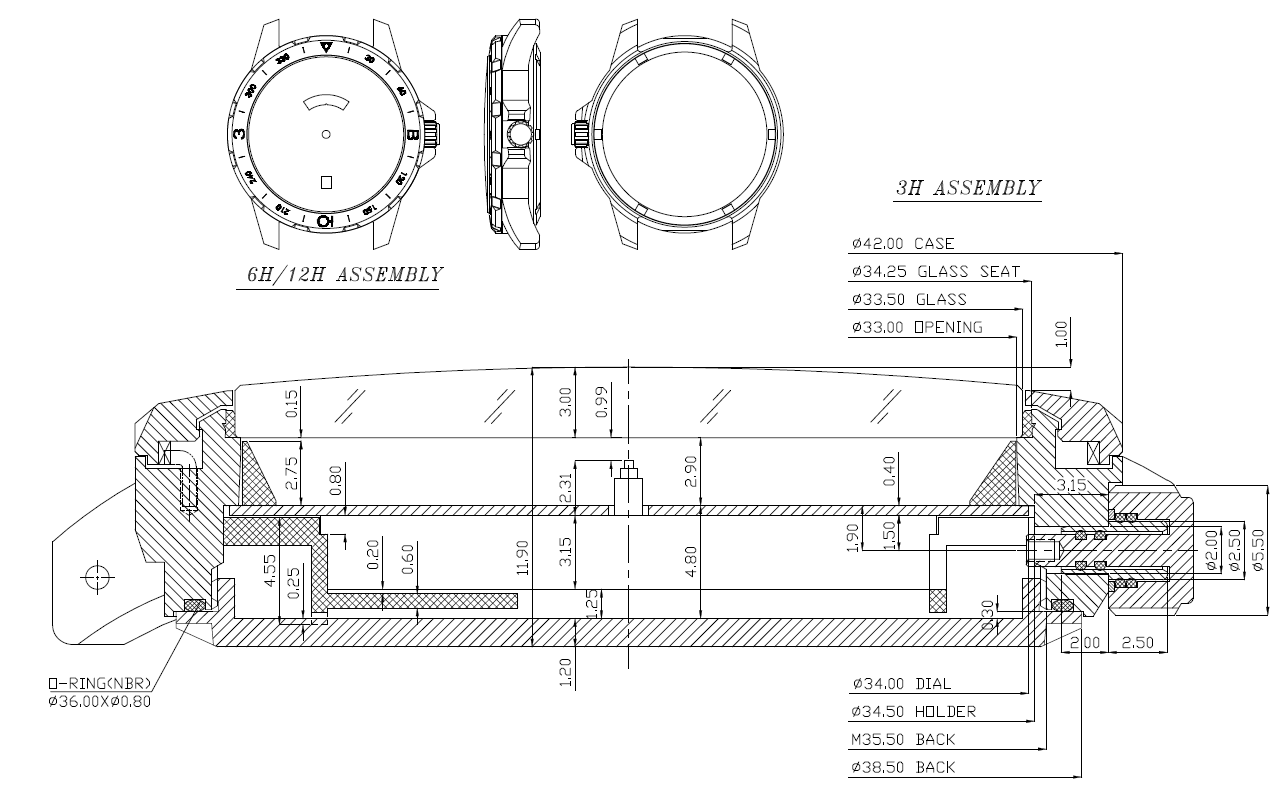
[picture p174: figure]

Чертеж корпуса.

Общий срок проведения операций по переработке одного корпуса для наручных часов из нержавеющей стали составляет 34 минуты.

Общий срок проведения операций по переработки 200 корпусов для наручных часов из нержавеющей стали составляет 6800 минут (113,33 часов).

В среднем 2 штуки в час, 16 штук в день, итого на сборку 200 штук часов требуется 12-15 дней + приёмка результата работы (осмотр, проверка и принятие) в течение 5 (пяти) рабочих дней после получения извещения от подрядчика о готовности результата работы к сдаче.

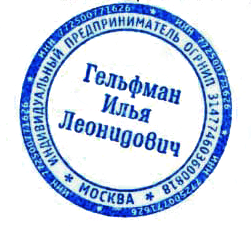
[picture p175: figure]

Индивидуальный предприниматель

Гельфман Илья Леонидович Гельфман И. Л.

ИП ГЕЛЬФМАН ИЛЬЯ ЛЕОНИДОВИЧ ИНН 772500771626, 115142, Москва г., Коломенская наб., дом № 14, квартира 283.
