sergei-tiutriumov/Finishing/КЧ/Путник 2/сборка/19_05_2025_Сборка_часов_Путник.pdf

# ИП ГЕЛЬФМАН ИЛЬЯ ЛЕОНИДОВИЧ

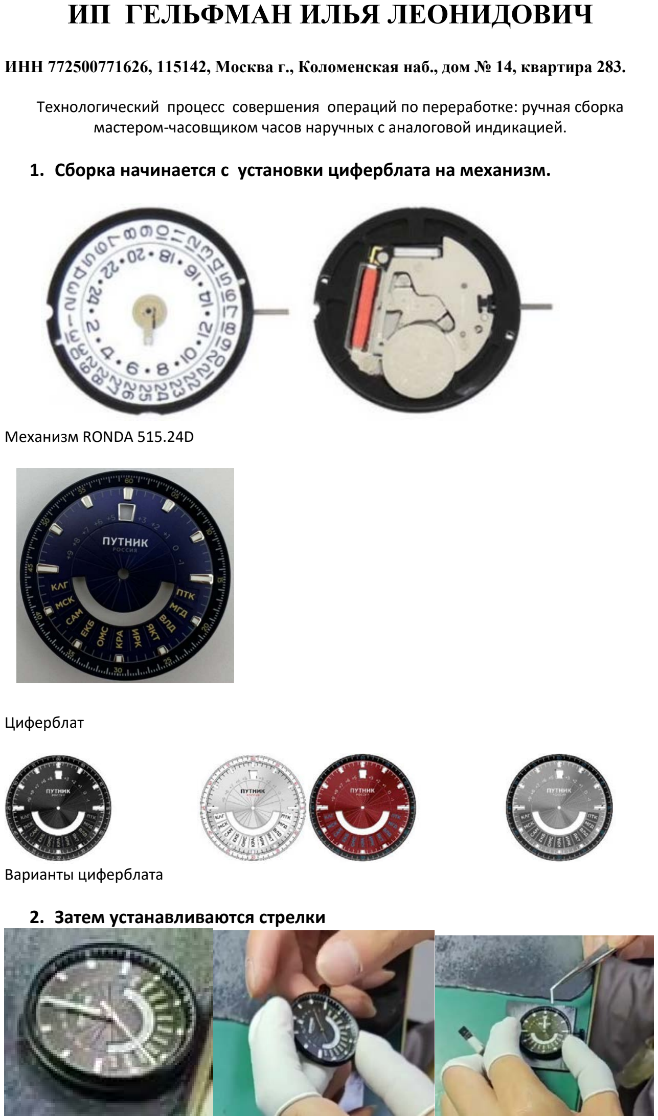
[picture p177: page 1]

ИНН 772500771626, 115142, Москва г., Коломенская наб., дом № 14, квартира 283.

Технологический процесс совершения операций по переработке: ручная сборка мастером-часовщиком часов наручных с аналоговой индикацией.
1. Сборка начинается с установки циферблата на механизм.

Механизм RONDA 515.24D

Циферблат

Варианты циферблата

### 2. Затем устанавливаются стрелки

ИНН 772500771626, 115142, Москва г., Коломенская наб., дом № 14, квартира 283.

3. Подготавливается часовой корпус, удаляется пыль.

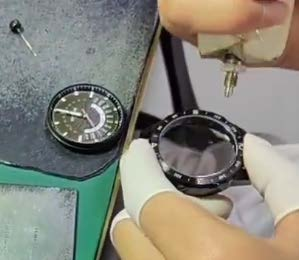
[picture p178: figure]

### 4. Механизм с циферблатом всталяется в корпус

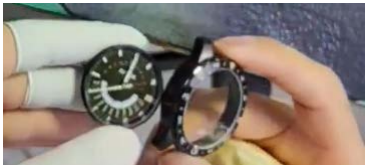
[picture p179: figure]
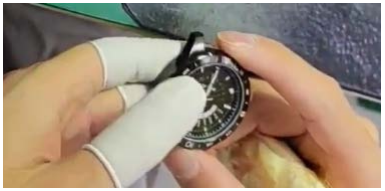
[picture p180: figure]

ИНН 772500771626, 115142, Москва г., Коломенская наб., дом № 14, квартира 283.

### 5. Корпус переворачивается крышкой вверх и вставляется подогнанный по длине заводной вал с установленной заводной головкой

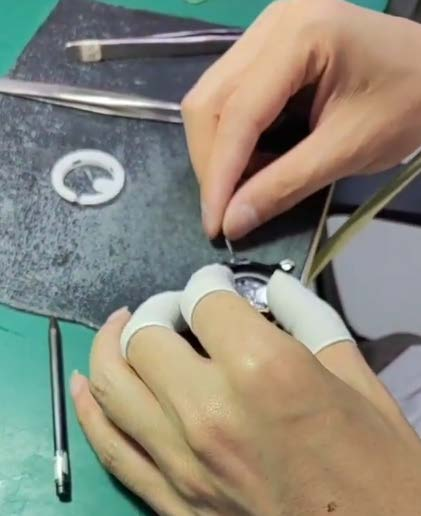
[picture p181: figure]
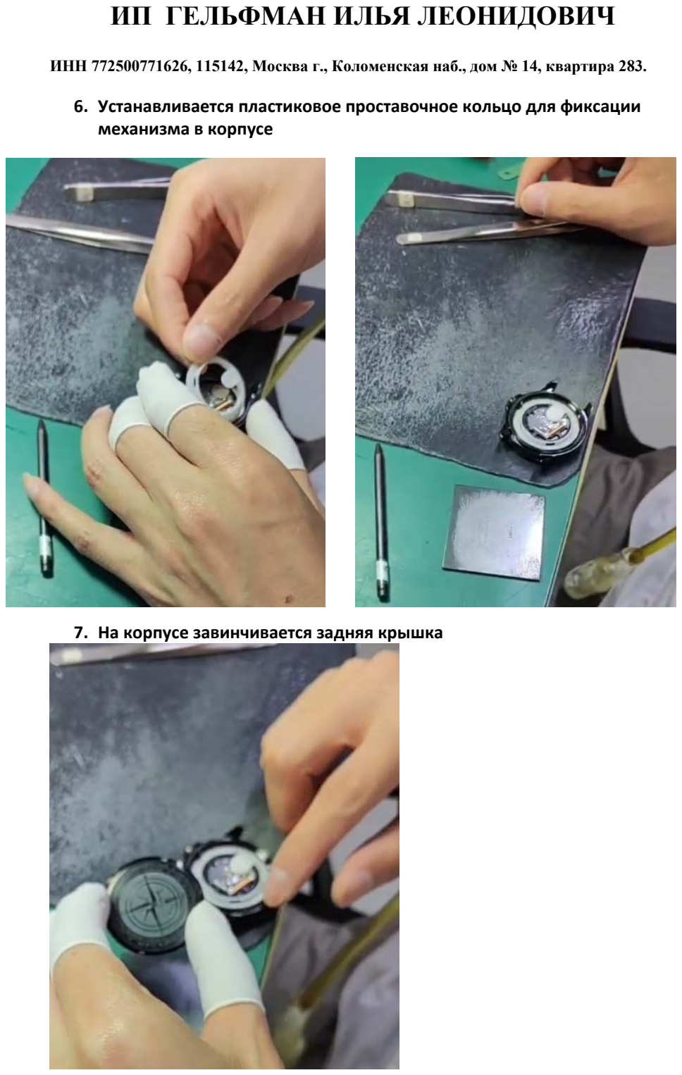
[picture p182: page 4]

ИНН 772500771626, 115142, Москва г., Коломенская наб., дом № 14, квартира 283.

### 6. Устанавливается пластиковое проставочное кольцо для фиксации механизма в корпусе

### 7. На корпусе завинчивается задняя крышка

ИНН 772500771626, 115142, Москва г., Коломенская наб., дом № 14, квартира 283.


Чертеж корпуса.

Общий срок проведения операций по переработке одного корпуса для наручных часов из нержавеющей стали составляет 34 минуты.
Общий срок проведения операций по переработки 200 корпусов для наручных часов из нержавеющей стали составляет 6800 минут (113,33 часов).
В среднем 2 штуки в час, 16 штук в день, итого на сборку 200 штук часов требуется 12-15 дней + приёмка результата работы (осмотр, проверка и принятие) в течение 5 (пяти) рабочих дней после получения извещения от подрядчика о готовности результата работы к сдаче.

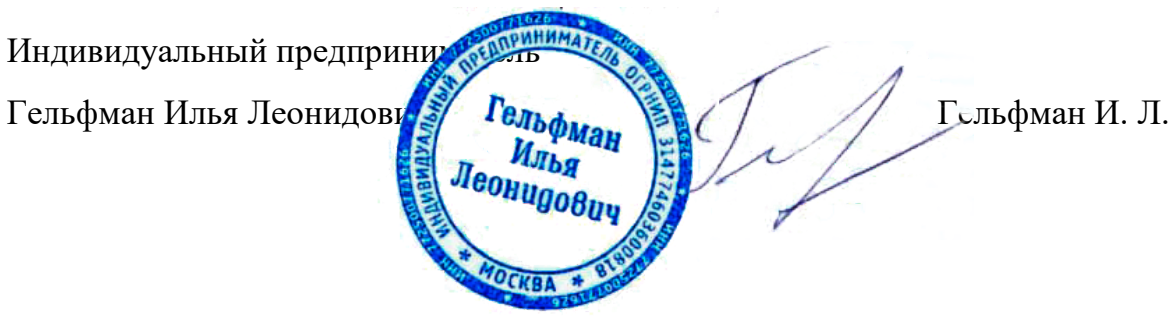
[picture p183: figure]
Гельфман Илья Леонидович; Гельфман И. Л.

### Индивидуальный предприниматель
