sergei-tiutriumov/Finishing/КЧ/Путник 2/Roscongress/Документы/12.11.2024 packing list-signed.pdf

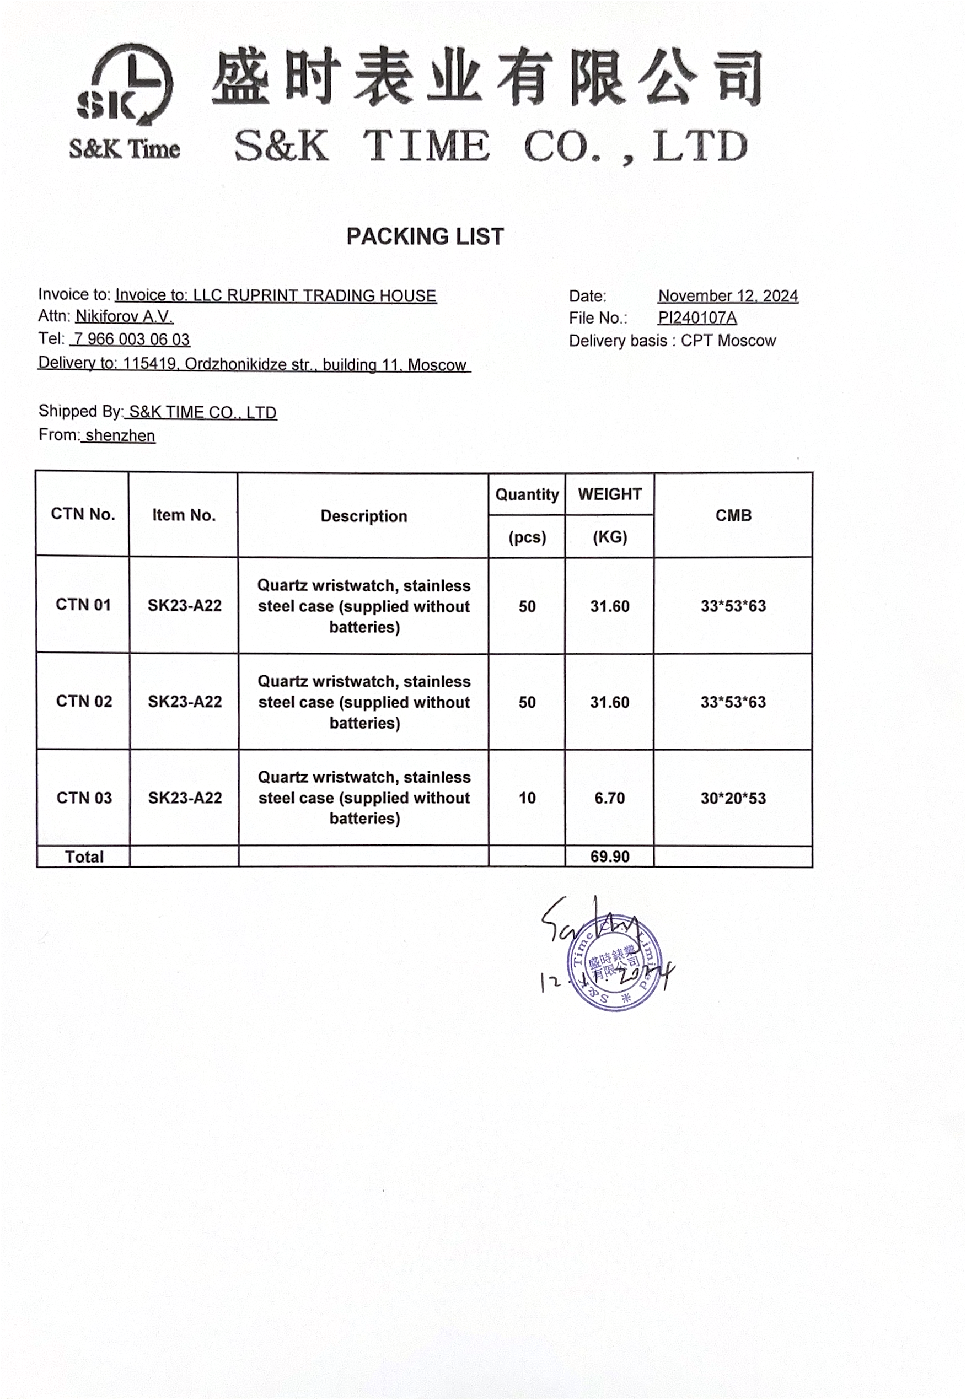
[picture p184: page 1]
