sergei-tiutriumov/Finishing/КЧ/Путник 2/Roscongress/Документы/12.11.2024 shipping invoice -signed.pdf

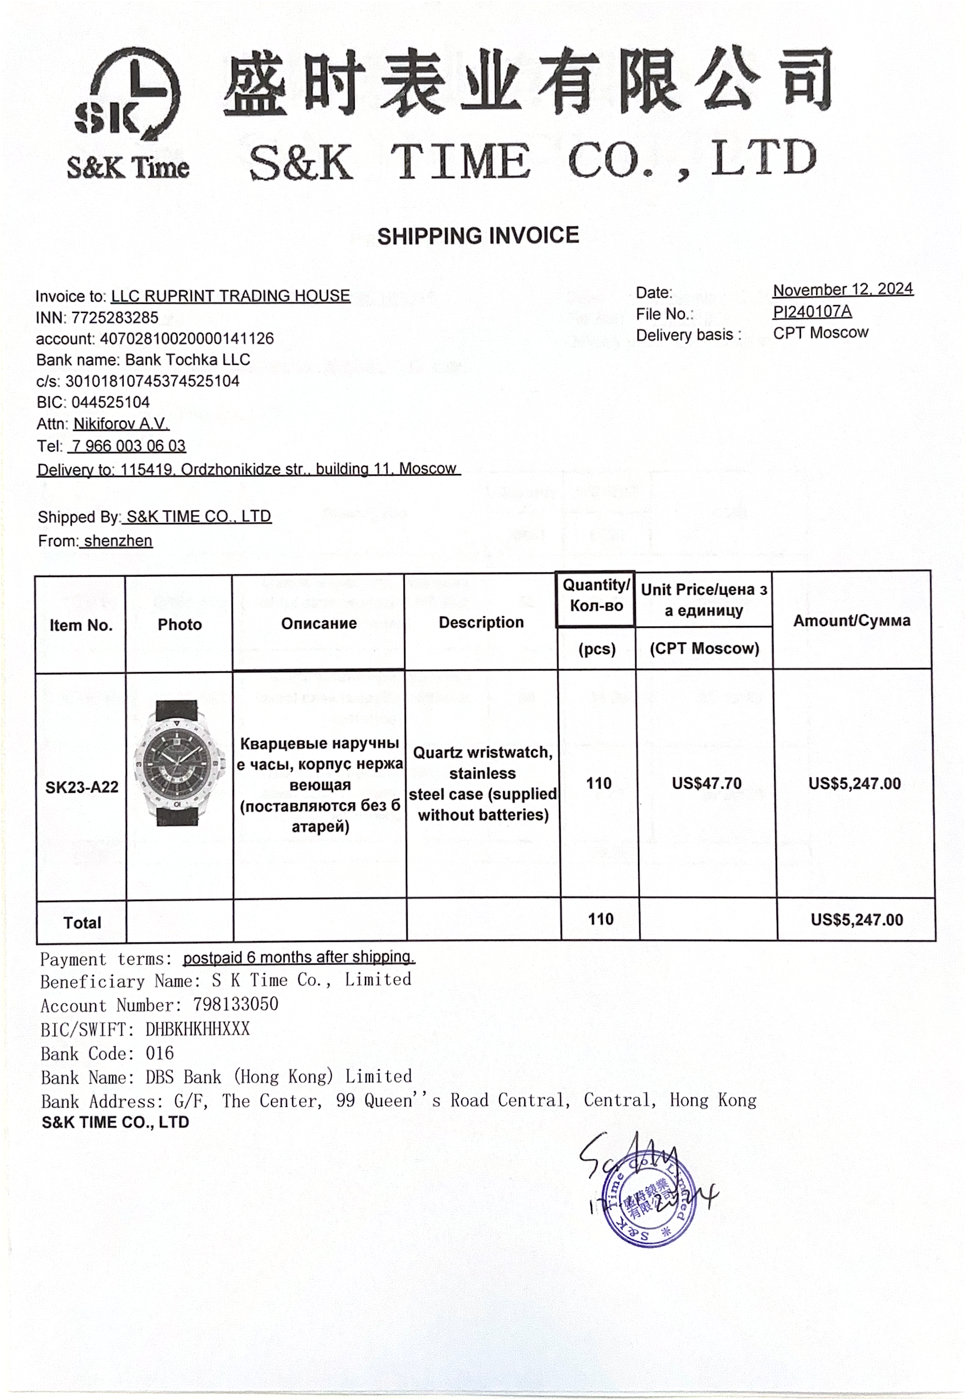
[picture p185: page 1]
