sergei-tiutriumov/Finishing/КЧ/Путник 2/Roscongress/Документы/wrongCO.pdf

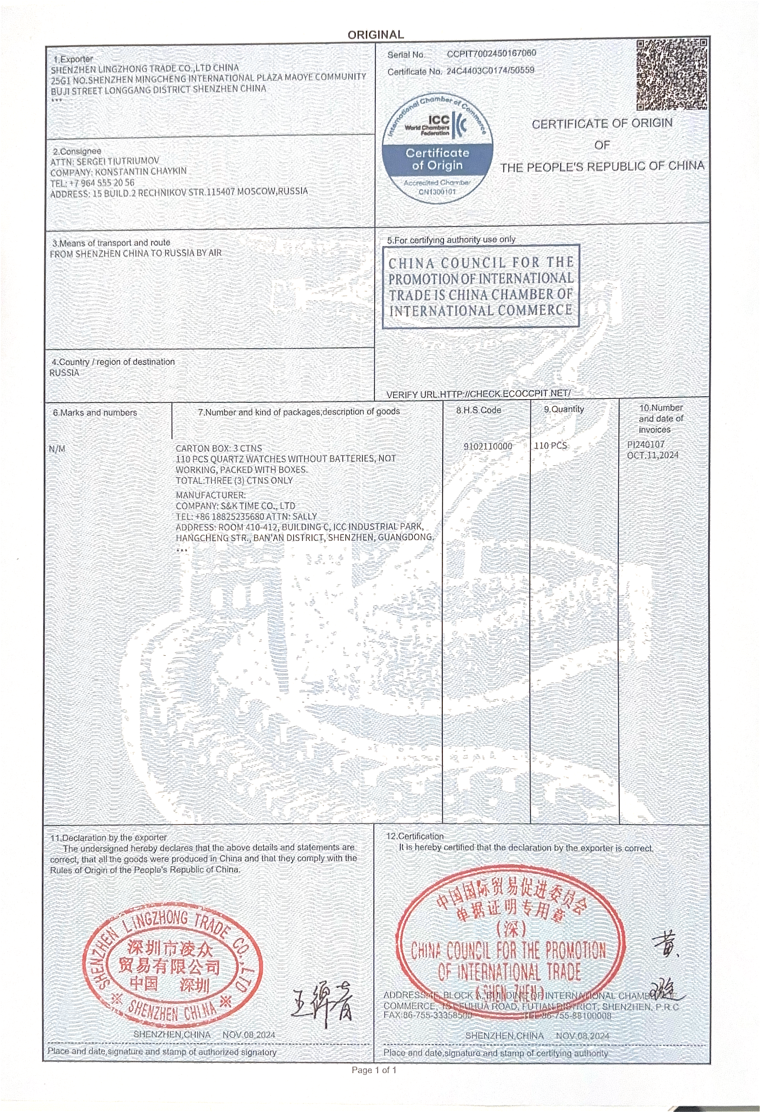
[picture p186: page 1]
