sergei-tiutriumov/Finishing/Ivan/Шомпол на шаублин 102n/W25 SCHAUBLIN.jpg

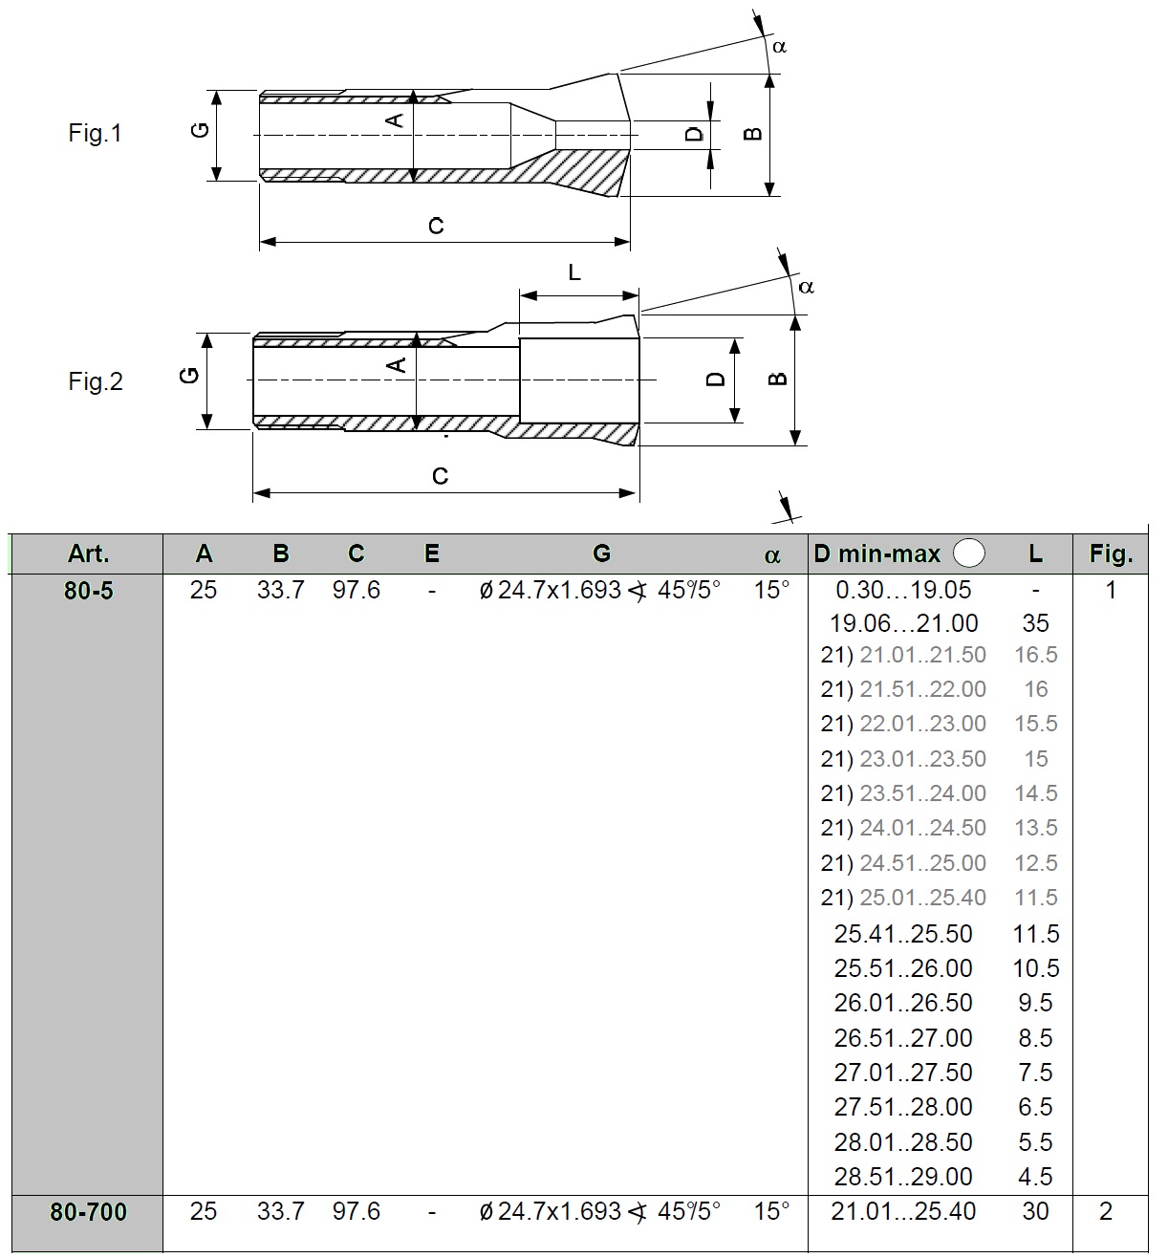
Ivan/Шомпол на шаублин 102n/W25 SCHAUBLIN.jpg
