sergei-tiutriumov/Finishing/китаец/Control Panel.jpg

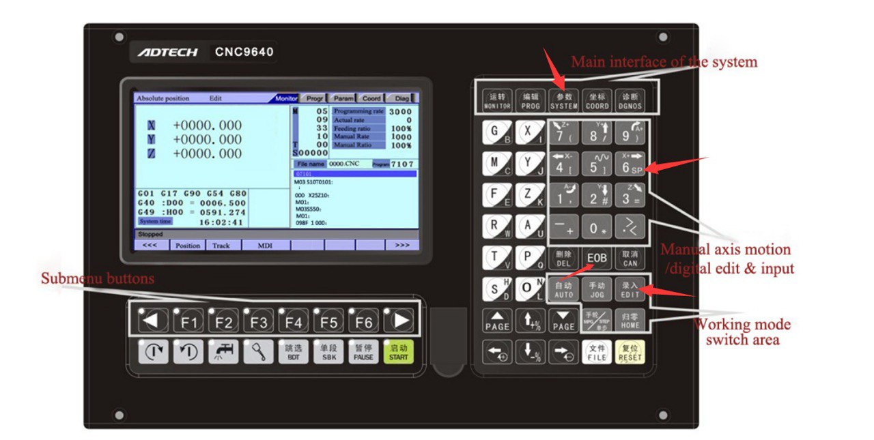
китаец/Control Panel.jpg
