sergei-tiutriumov/Finishing/китаец/Эксперимент перлаж/Эксперимент перлаж/Ноль - верх заготовки.JPG

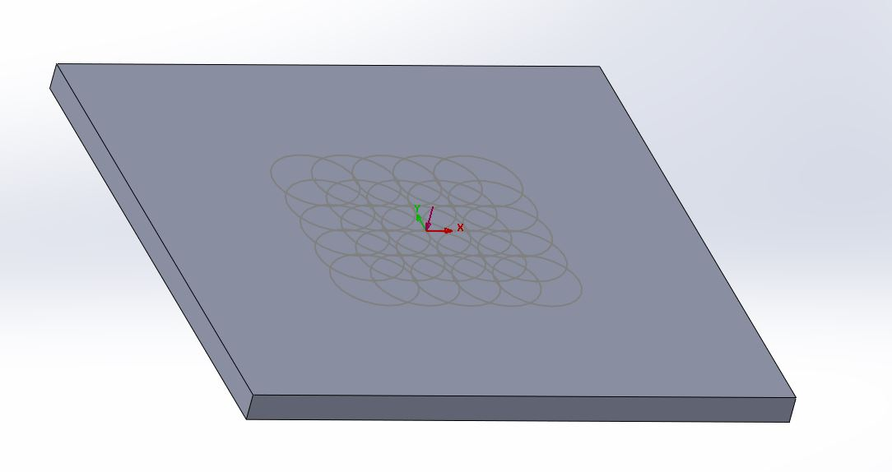
китаец/Эксперимент перлаж/Эксперимент перлаж/Ноль - верх заготовки.JPG
