sergei-tiutriumov/Finishing/КЧ/Путник 2/02.07.2024/IMG-20240702-WA0003.jpg

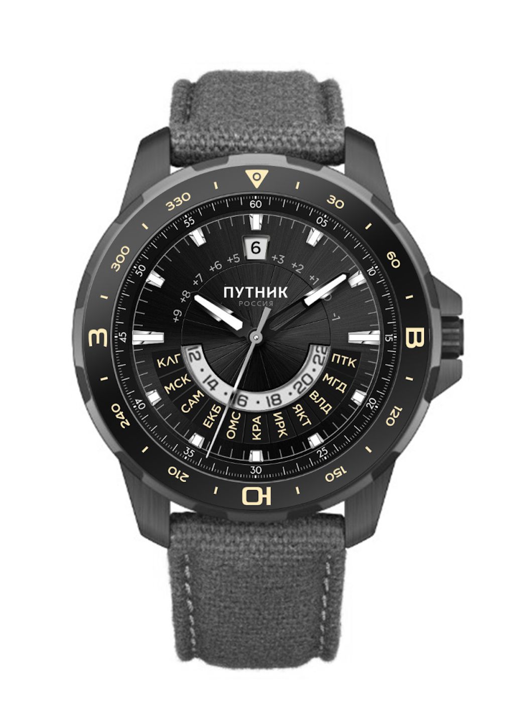
КЧ/Путник 2/02.07.2024/IMG-20240702-WA0003.jpg
