sergei-tiutriumov/Finishing/КЧ/Путник 2/02.07.2024/Изображение WhatsApp 2024-07-02 в 11.47.42_8ac33807.jpg

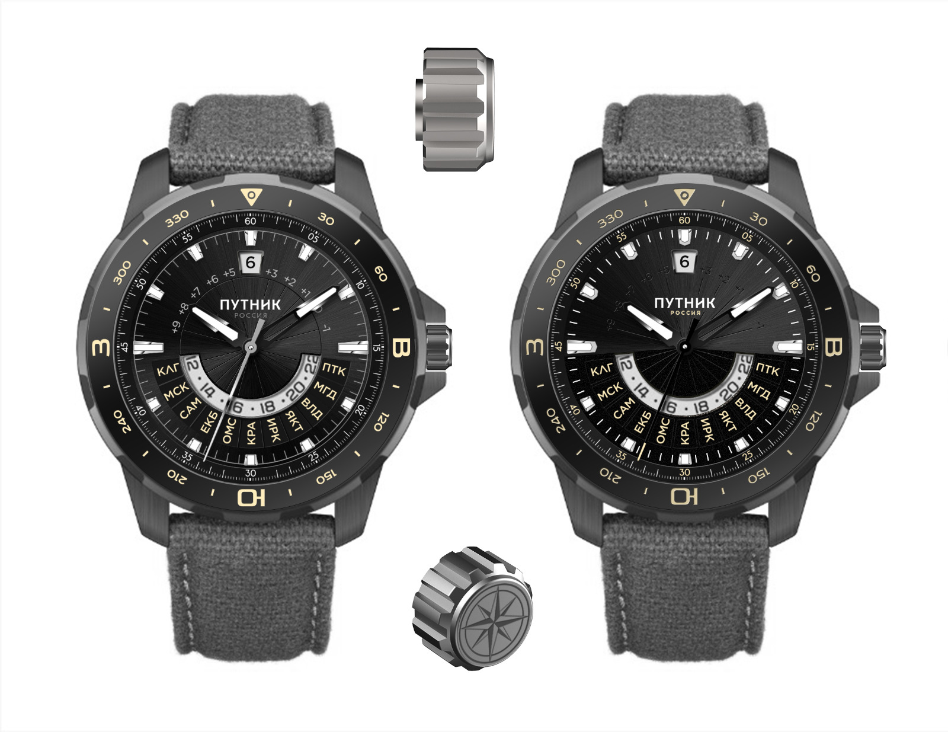
КЧ/Путник 2/02.07.2024/Изображение WhatsApp 2024-07-02 в 11.47.42_8ac33807.jpg
