sergei-tiutriumov/Finishing/КЧ/Путник 2/16.09.2024/Luminova1.jpg

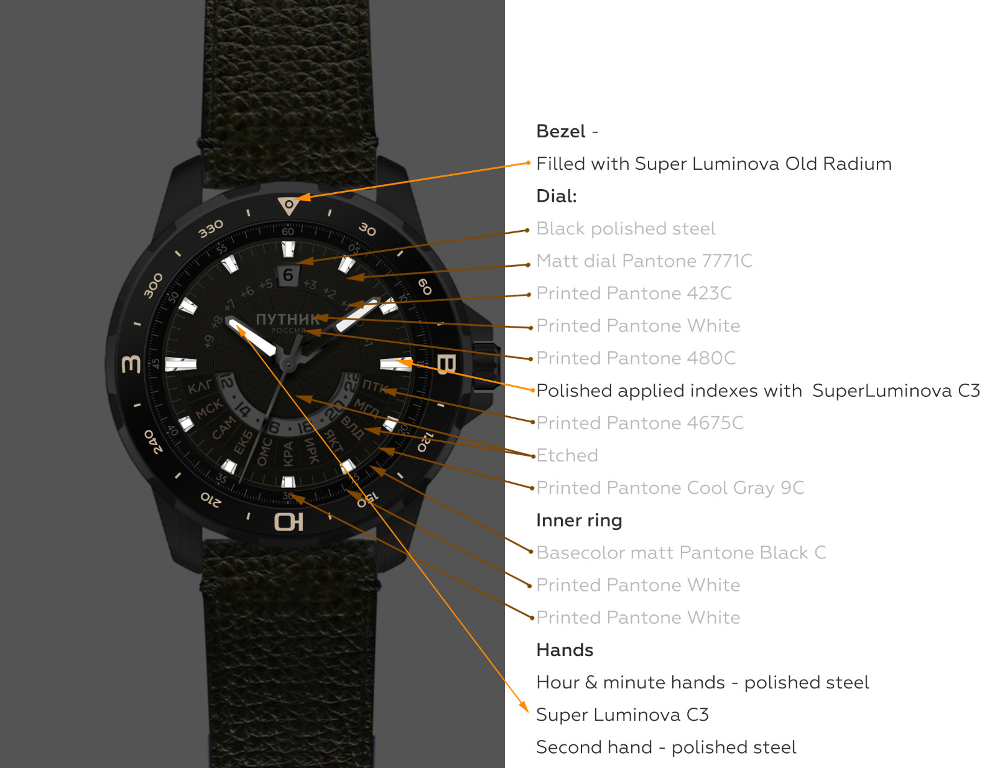
КЧ/Путник 2/16.09.2024/Luminova1.jpg
