sergei-tiutriumov/Finishing/КЧ/Путник 2/16.09.2024/straps/2.jpg

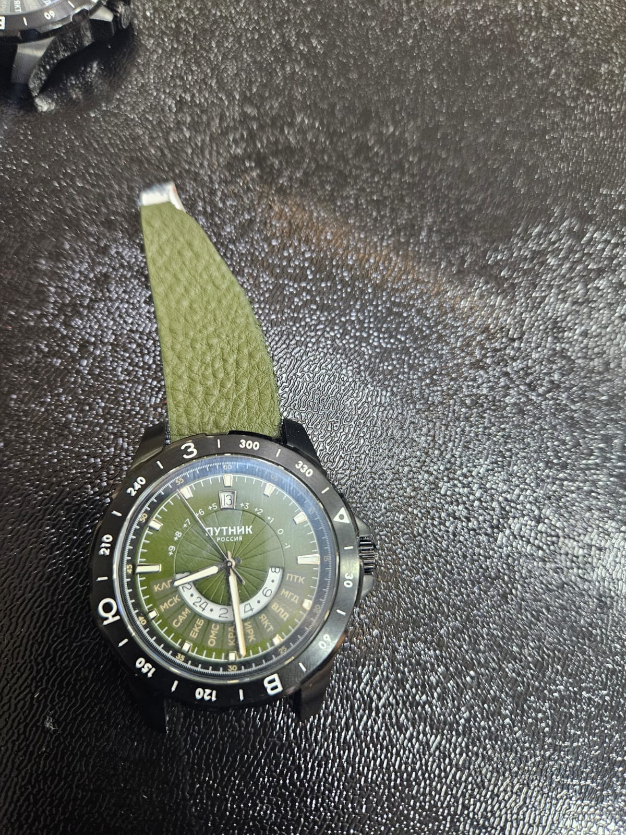
КЧ/Путник 2/16.09.2024/straps/2.jpg
