sergei-tiutriumov/Finishing/КЧ/Путник 2/16.09.2024/Изображение WhatsApp 2024-09-25 в 00.31.51_d028560b.jpg

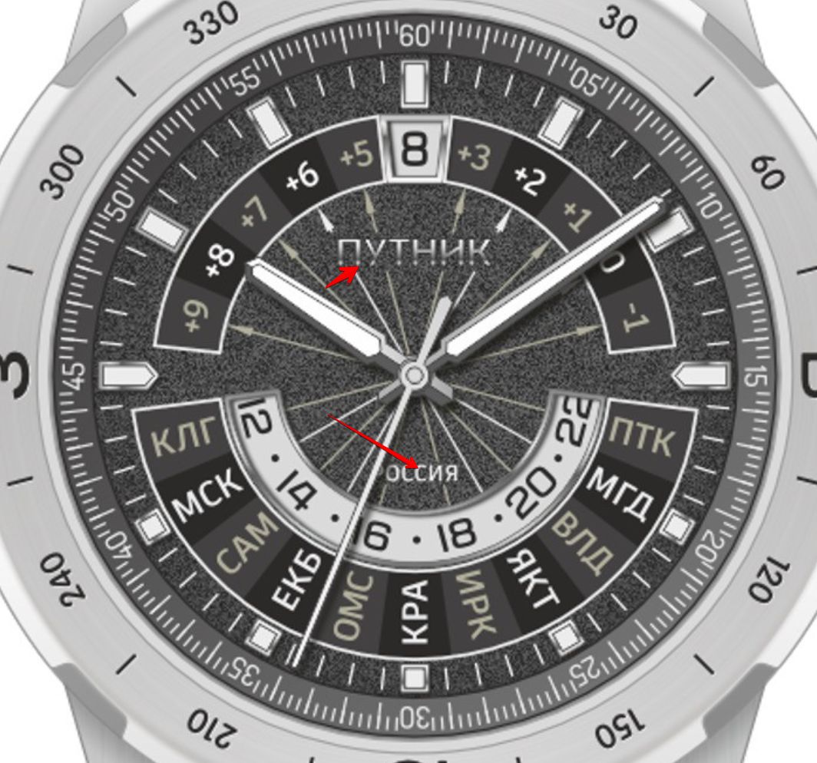
КЧ/Путник 2/16.09.2024/Изображение WhatsApp 2024-09-25 в 00.31.51_d028560b.jpg
