sergei-tiutriumov/Finishing/КЧ/Путник 2/Buckle for Sally/General view.jpg

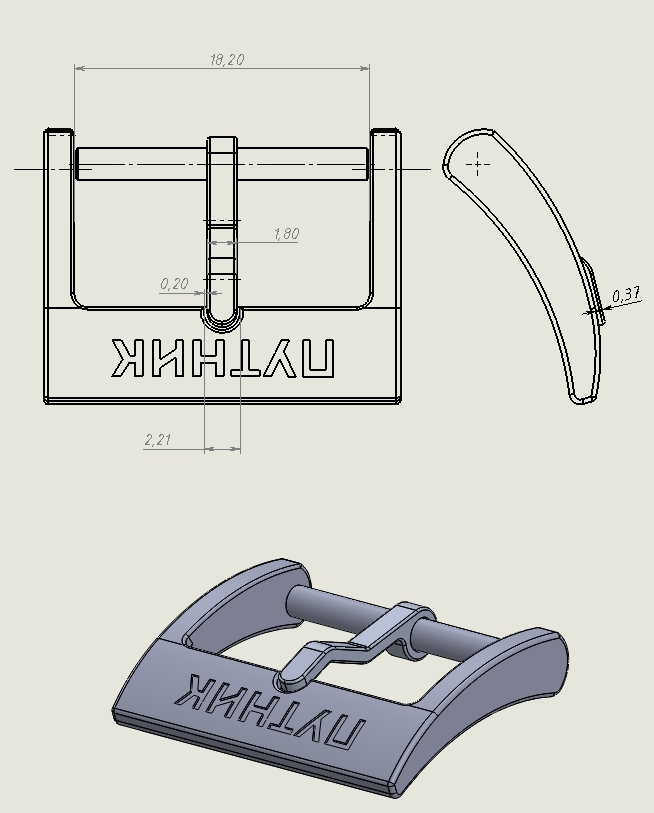
КЧ/Путник 2/Buckle for Sally/General view.jpg
