sergei-tiutriumov/Finishing/КЧ/Путник 2/hands.jpg

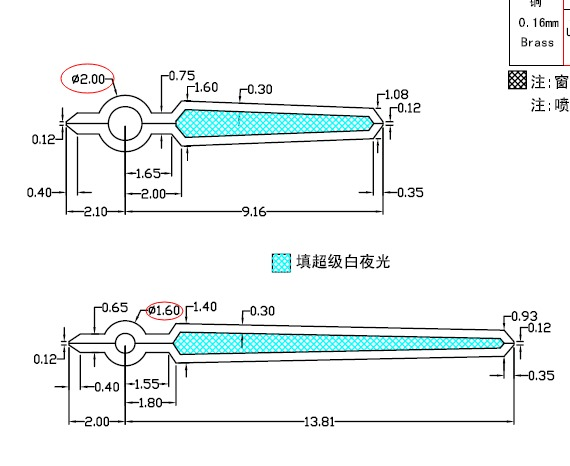
КЧ/Путник 2/hands.jpg
