sergei-tiutriumov/Finishing/КЧ/Путник 2/Putnik 2_black_strap.png

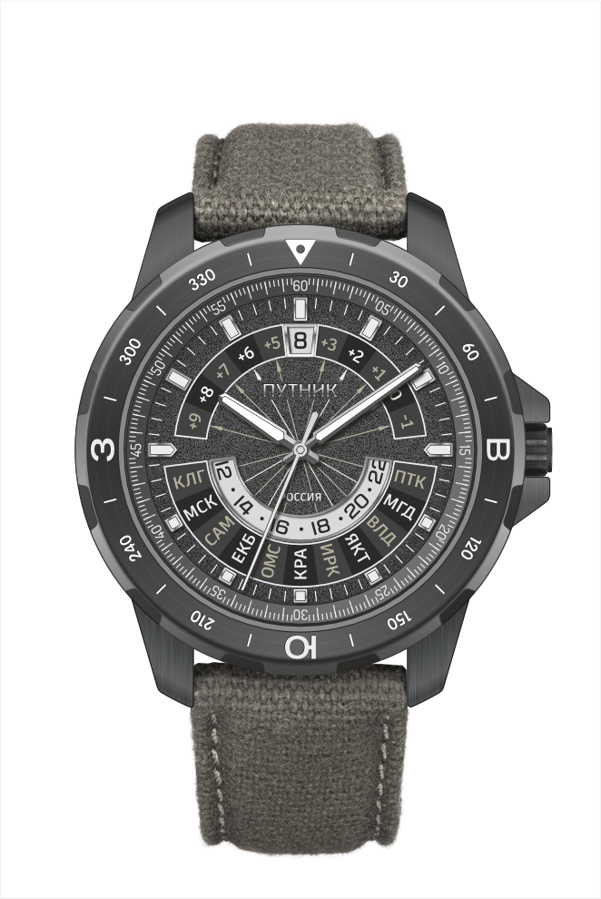
КЧ/Путник 2/Putnik 2_black_strap.png
