sergei-tiutriumov/Finishing/КЧ/Путник 2/Putnik 2_blue.png

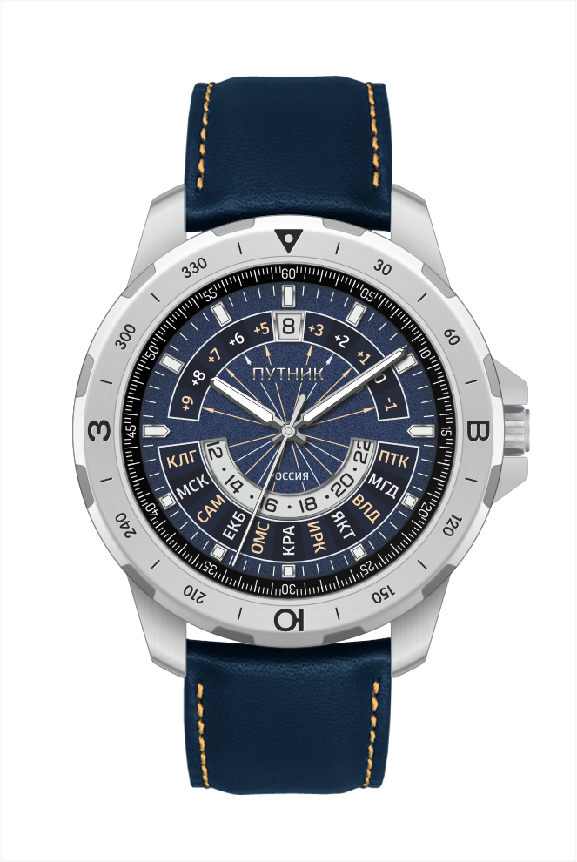
КЧ/Путник 2/Putnik 2_blue.png
