sergei-tiutriumov/Finishing/КЧ/Путник 2/Putnik 2_red.png

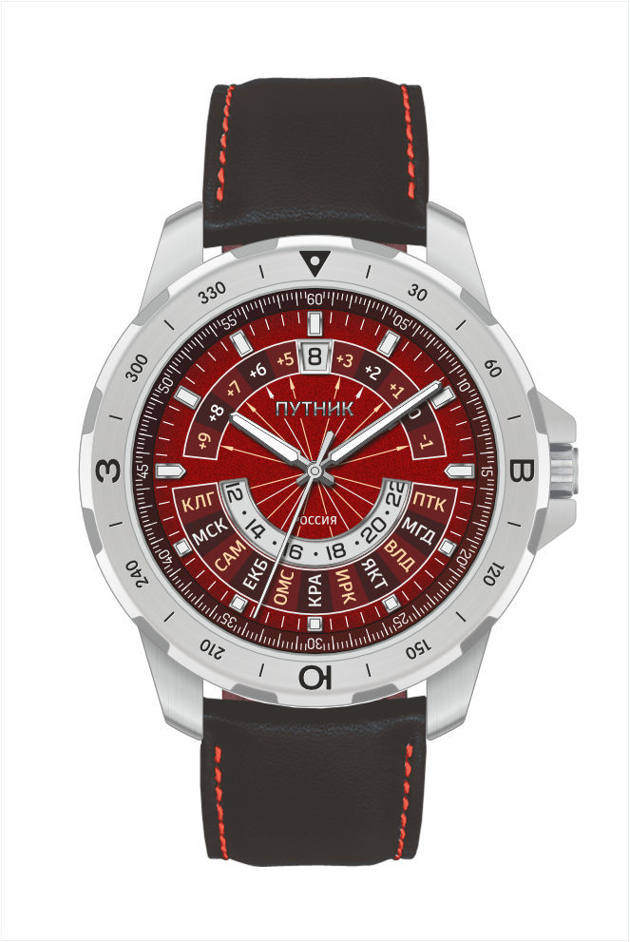
КЧ/Путник 2/Putnik 2_red.png
