sergei-tiutriumov/Finishing/КЧ/Путник 2/Ronda 515.24.jpg

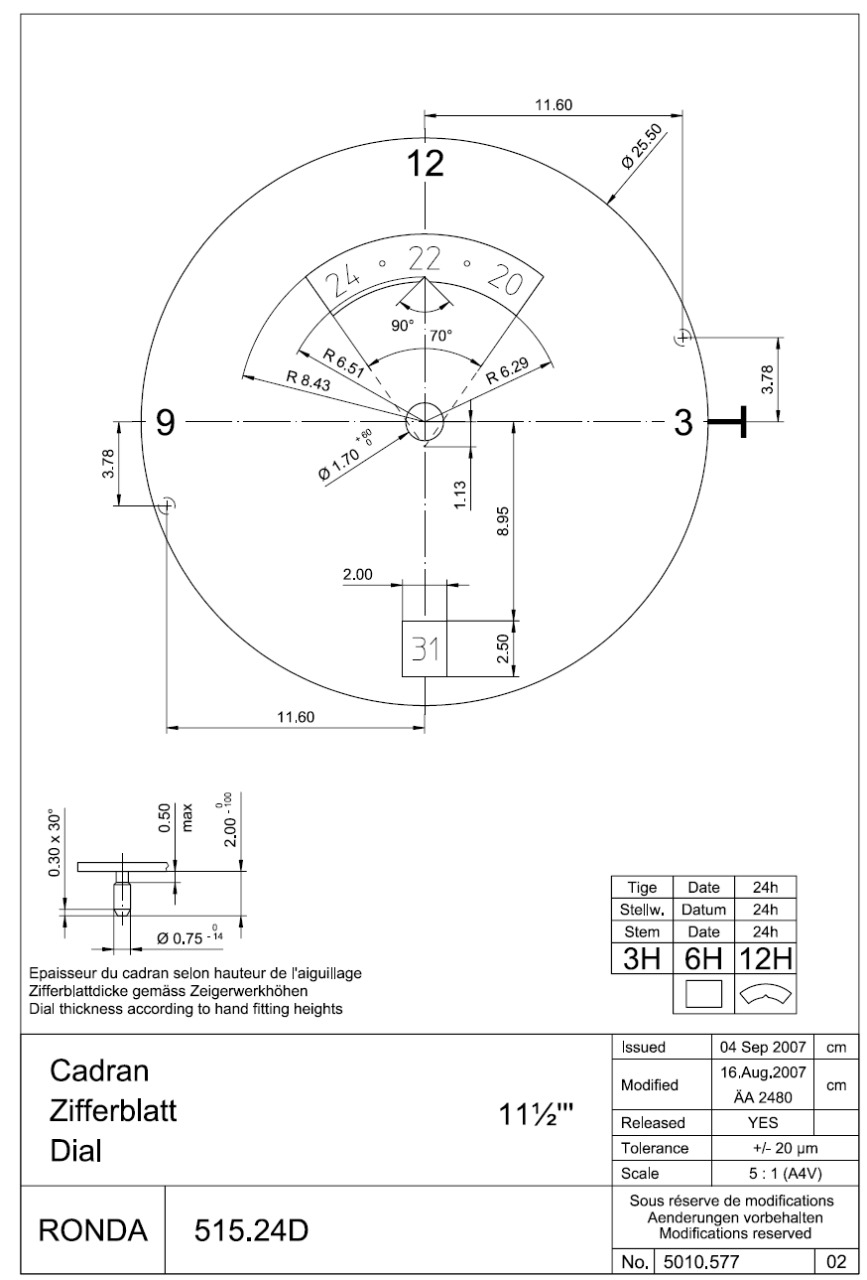
КЧ/Путник 2/Ronda 515.24.jpg
