sergei-tiutriumov/Finishing/КЧ/Путник 2/Roscongress/коробка.PNG

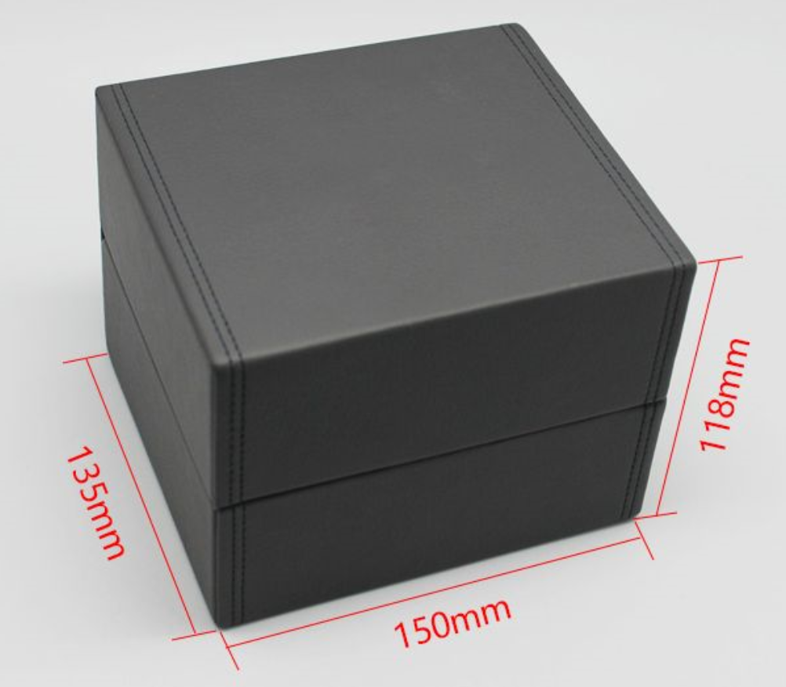
КЧ/Путник 2/Roscongress/коробка.PNG
