sergei-tiutriumov/Finishing/КЧ/Путник 2/sample photos 20_11_2024/6561732073126_.pic_hd.jpg

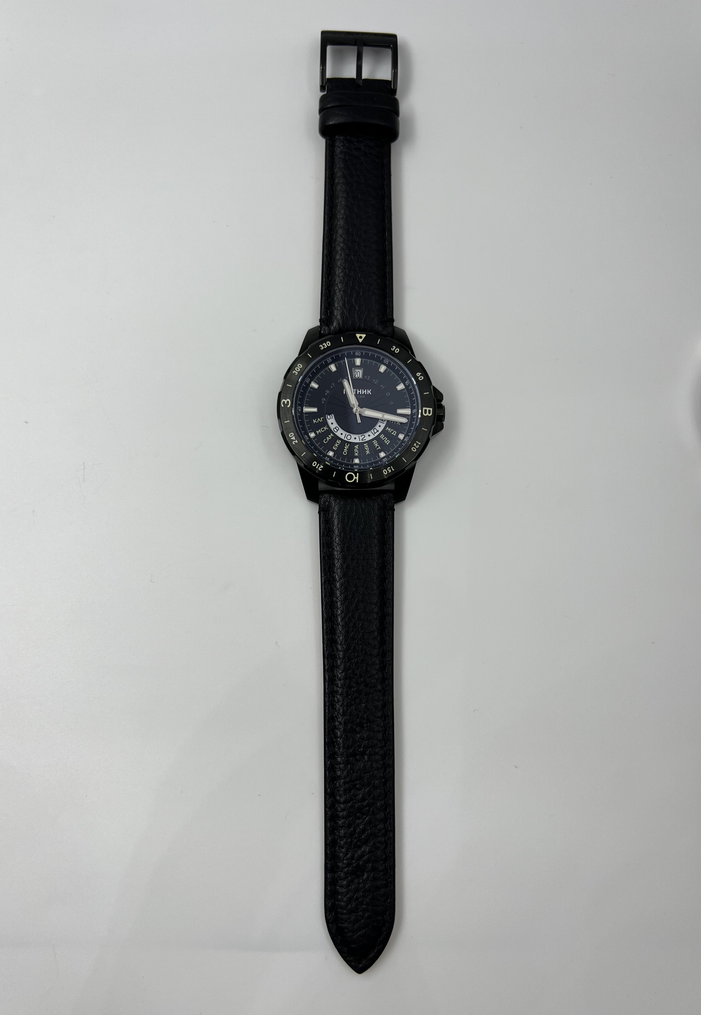
КЧ/Путник 2/sample photos 20_11_2024/6561732073126_.pic_hd.jpg
