sergei-tiutriumov/Finishing/КЧ/Путник 2/sample photos 20_11_2024/6581732073140_.pic_hd.jpg

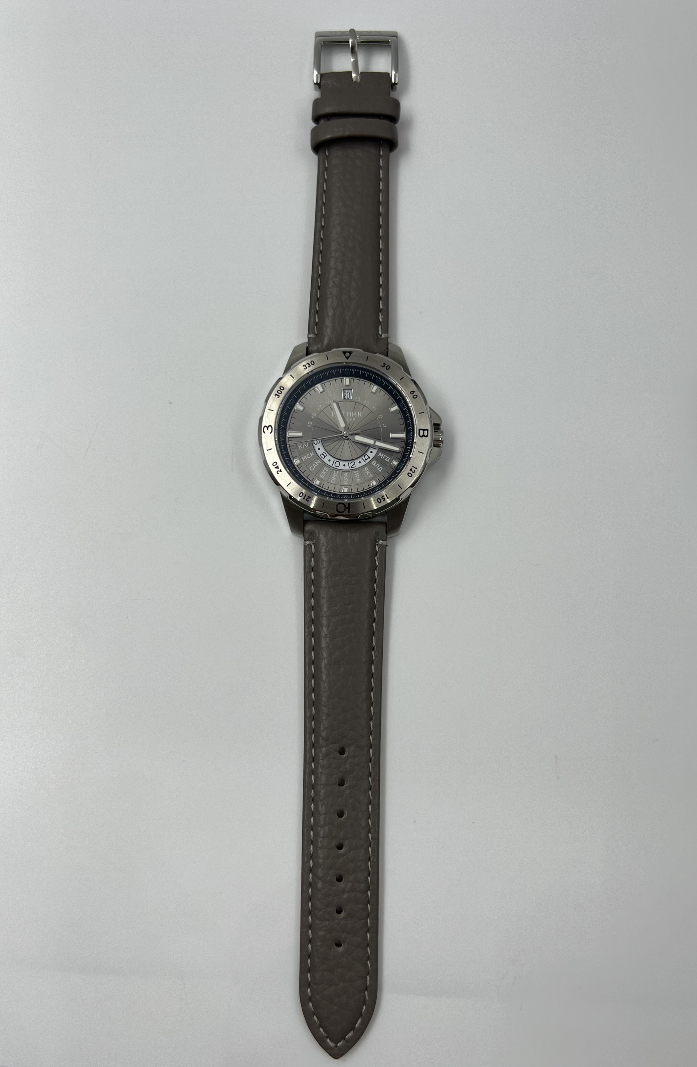
КЧ/Путник 2/sample photos 20_11_2024/6581732073140_.pic_hd.jpg
