sergei-tiutriumov/Finishing/КЧ/Путник 2/sample photos 20_11_2024/6631732073165_.pic_hd.jpg

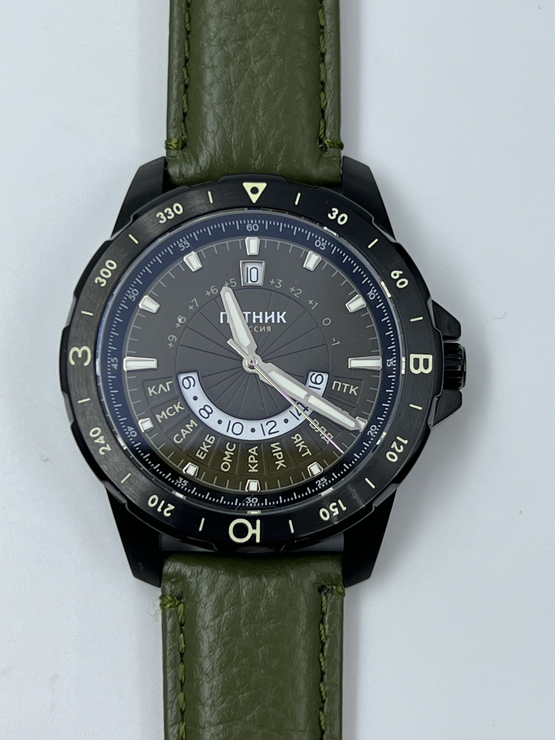
КЧ/Путник 2/sample photos 20_11_2024/6631732073165_.pic_hd.jpg
