sergei-tiutriumov/Finishing/КЧ/Путник 2/sec.png

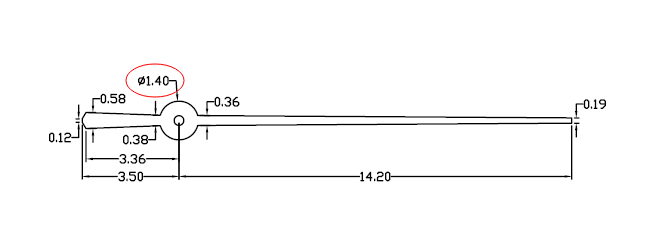
КЧ/Путник 2/sec.png
