sergei-tiutriumov/Finishing/КЧ/Путник 2/Варианты исполнения/Путник белый.png

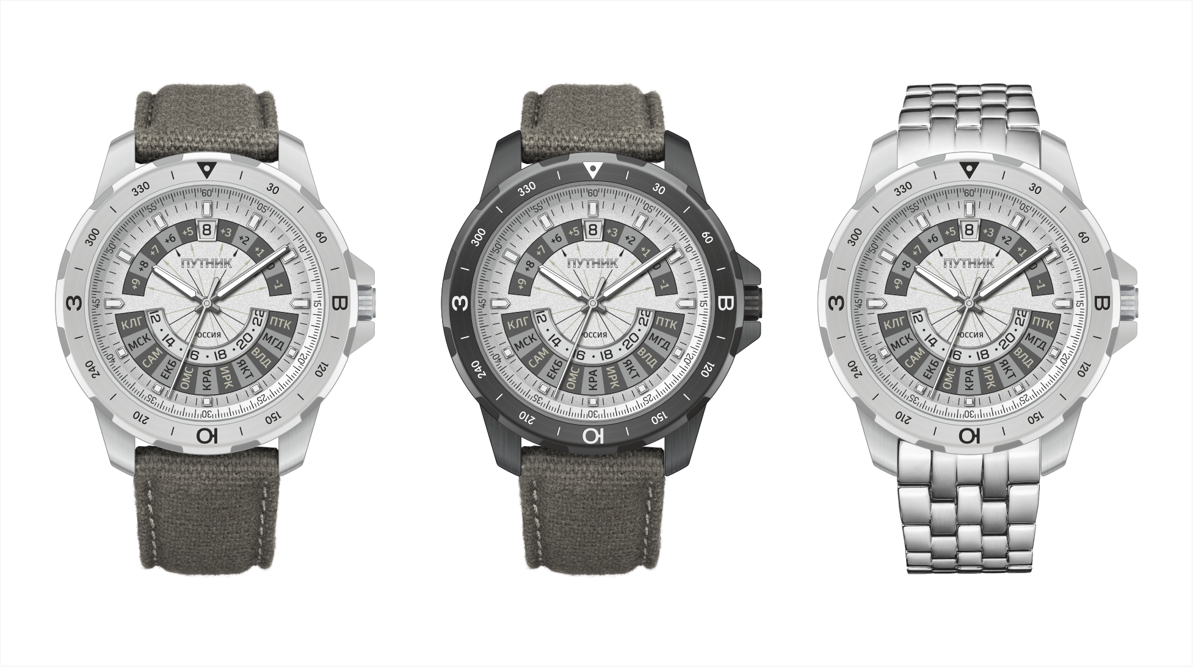
КЧ/Путник 2/Варианты исполнения/Путник белый.png
