sergei-tiutriumov/Finishing/КЧ/Путник 2/Варианты исполнения/Путник красный.png

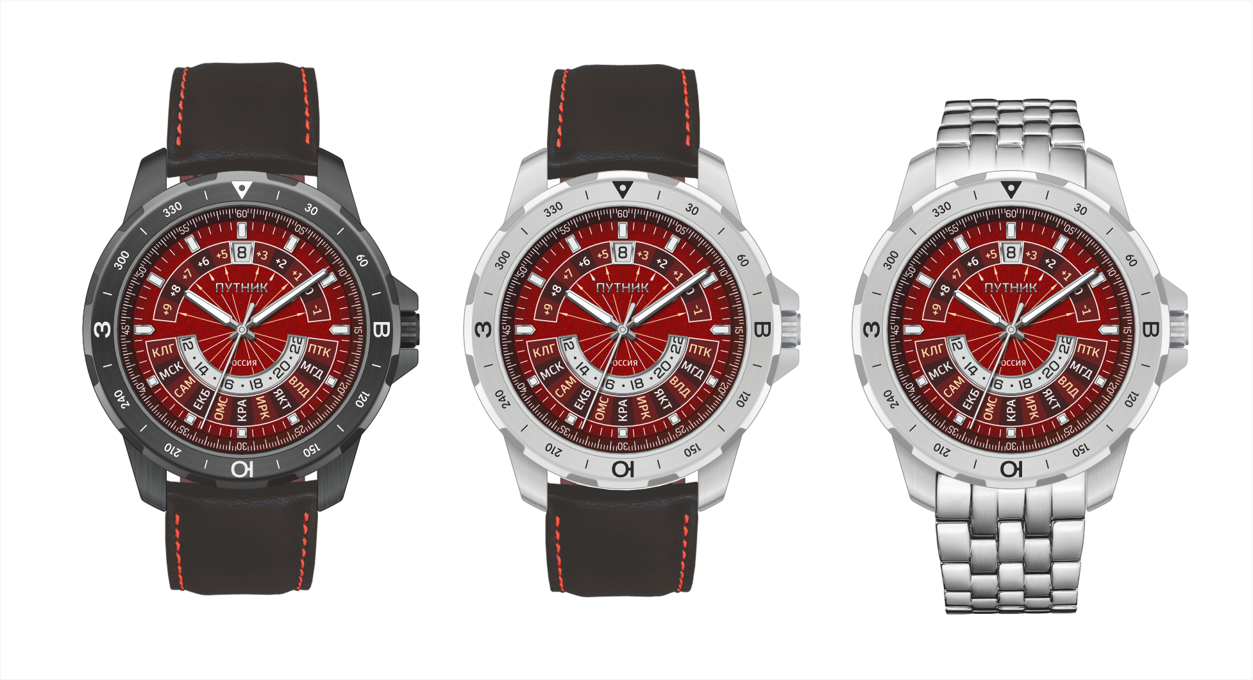
КЧ/Путник 2/Варианты исполнения/Путник красный.png
