sergei-tiutriumov/Finishing/КЧ/Путник 2/Варианты исполнения/Путник ремень глобус.png

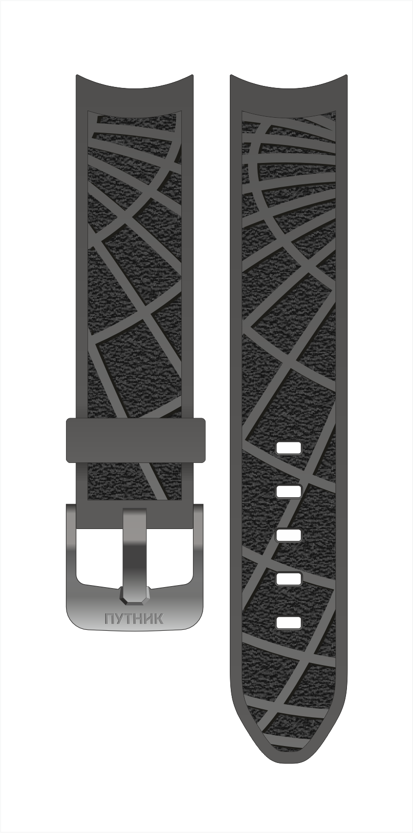
КЧ/Путник 2/Варианты исполнения/Путник ремень глобус.png
