sergei-tiutriumov/Finishing/КЧ/Путник 2/Варианты исполнения/Путник ремень самолеты.png

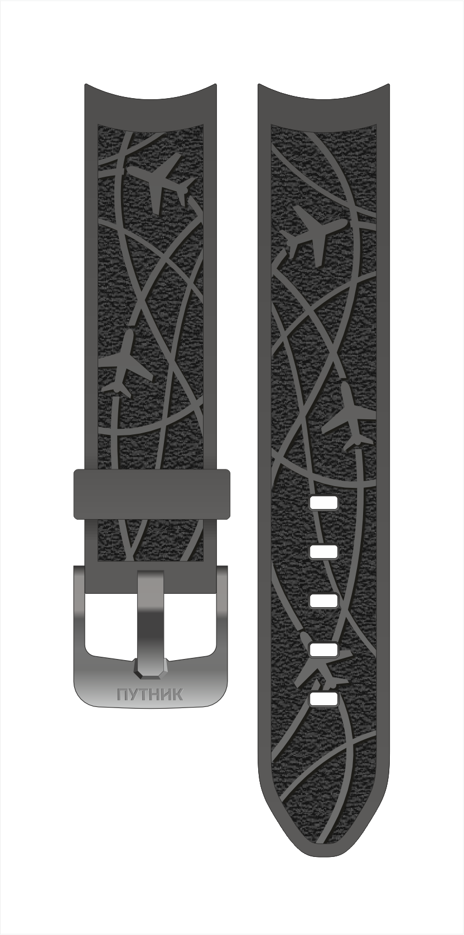
КЧ/Путник 2/Варианты исполнения/Путник ремень самолеты.png
