sergei-tiutriumov/Finishing/КЧ/Путник 2/Варианты исполнения/Путник хаки.png

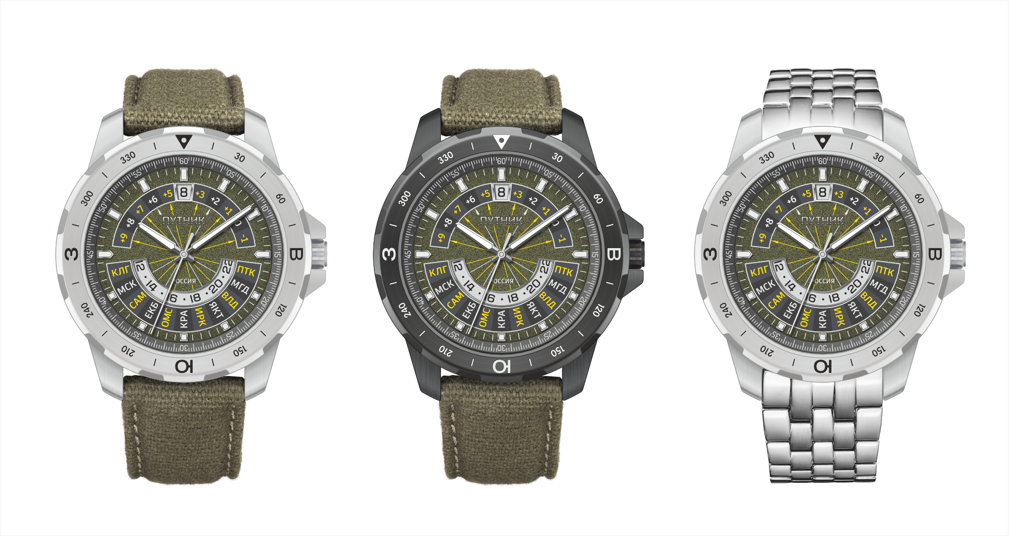
КЧ/Путник 2/Варианты исполнения/Путник хаки.png
