sergei-tiutriumov/Finishing/КЧ/Путник 2/Варианты исполнения/Путник черный.png

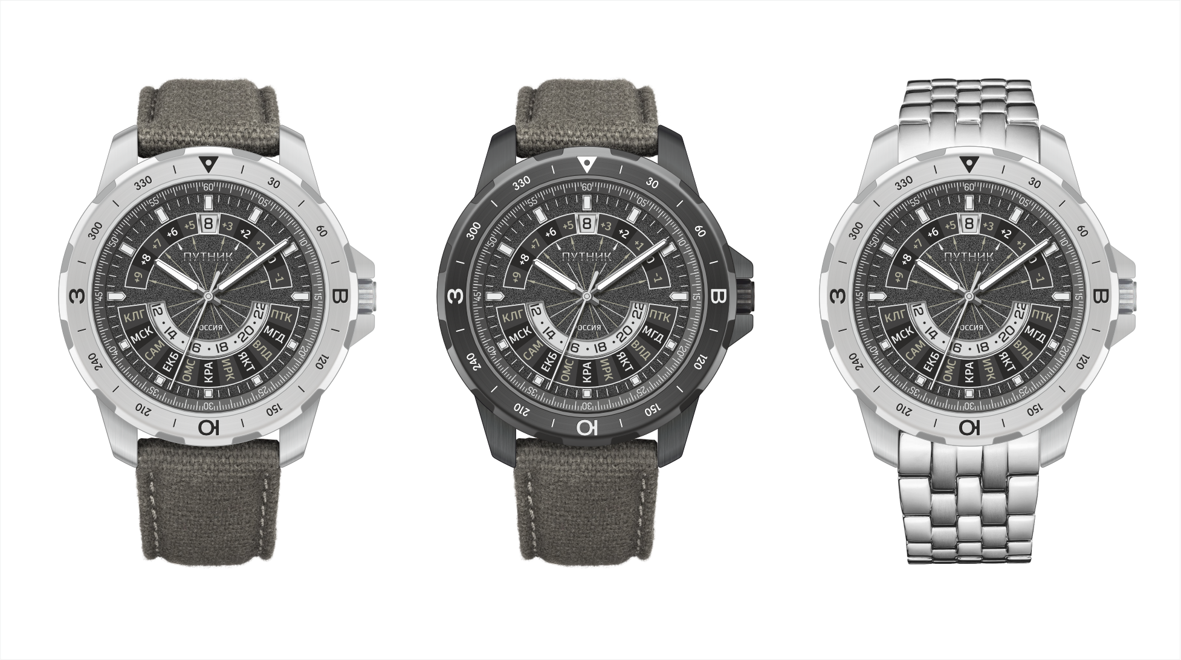
КЧ/Путник 2/Варианты исполнения/Путник черный.png
