sergei-tiutriumov/Finishing/КЧ/Путник 2/Заказ путников/браслет+черныйцифер.jpg

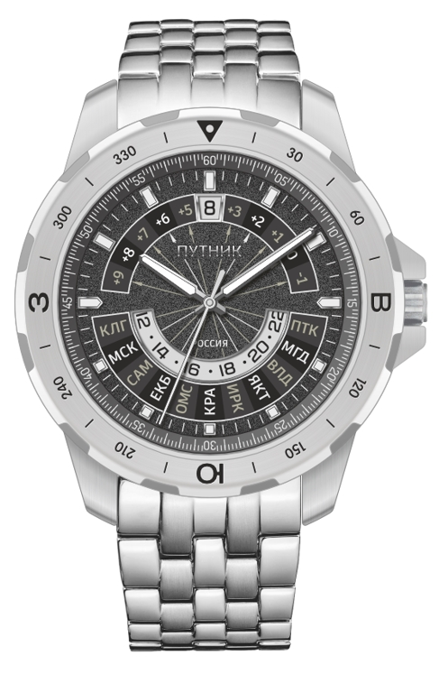
КЧ/Путник 2/Заказ путников/браслет+черныйцифер.jpg
