sergei-tiutriumov/Finishing/КЧ/Путник 2/Заказ путников/синий-синий.jpg

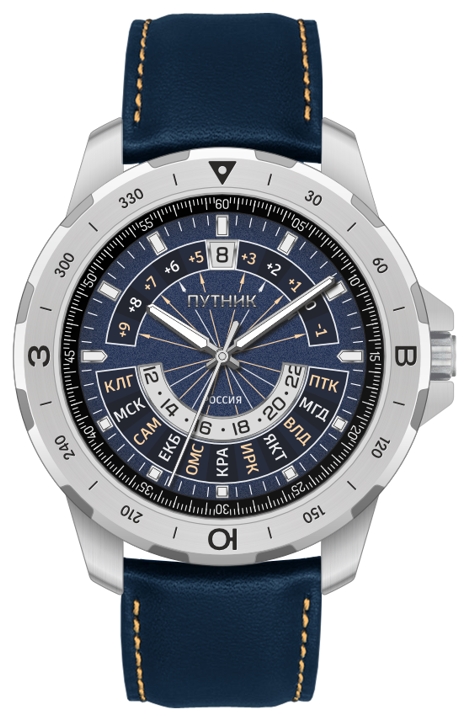
КЧ/Путник 2/Заказ путников/синий-синий.jpg
