sergei-tiutriumov/Finishing/КЧ/Путник 2/Заказ путников/Хаки-хаки.jpg

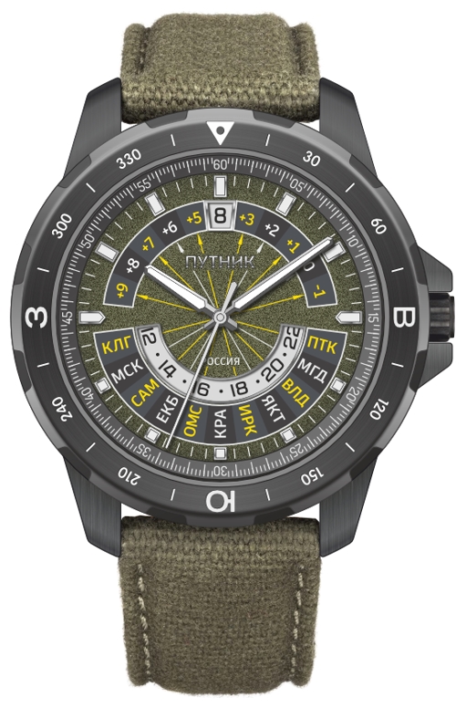
КЧ/Путник 2/Заказ путников/Хаки-хаки.jpg
