sergei-tiutriumov/Finishing/КЧ/Путник 2/Заказ путников/чернота.jpg

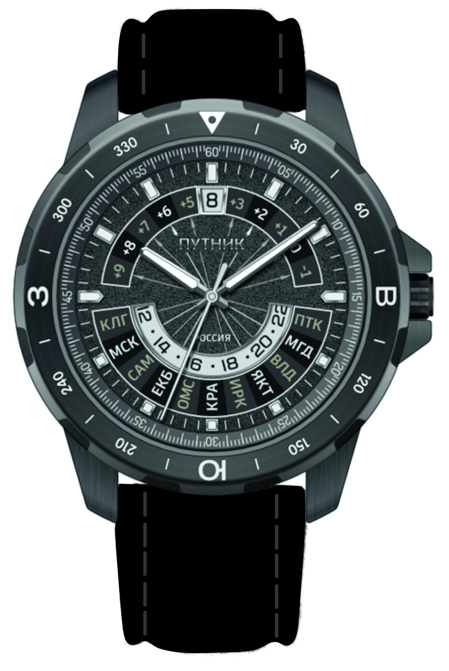
КЧ/Путник 2/Заказ путников/чернота.jpg
