sergei-tiutriumov/Finishing/КЧ/Путник 2/Заказ путников/чреый-красный-сталь.jpg

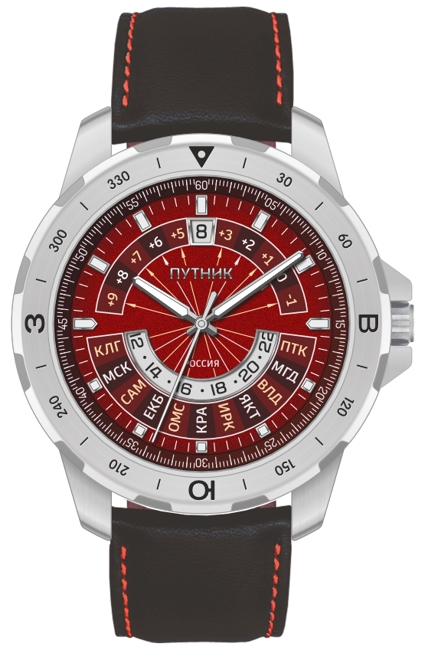
КЧ/Путник 2/Заказ путников/чреый-красный-сталь.jpg
