sergei-tiutriumov/Finishing/КЧ/Путник 2/коробка/1.jpg

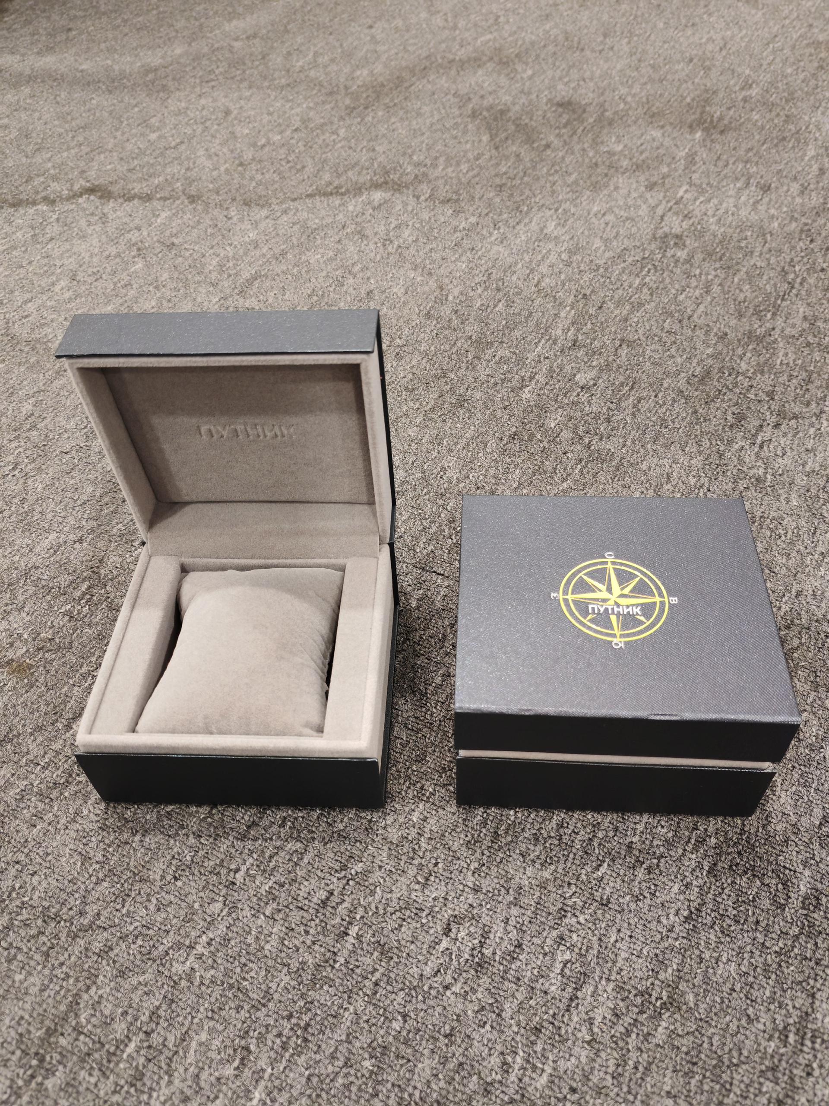
КЧ/Путник 2/коробка/1.jpg
