sergei-tiutriumov/Finishing/КЧ/Путник 2/коробка/2.jpg

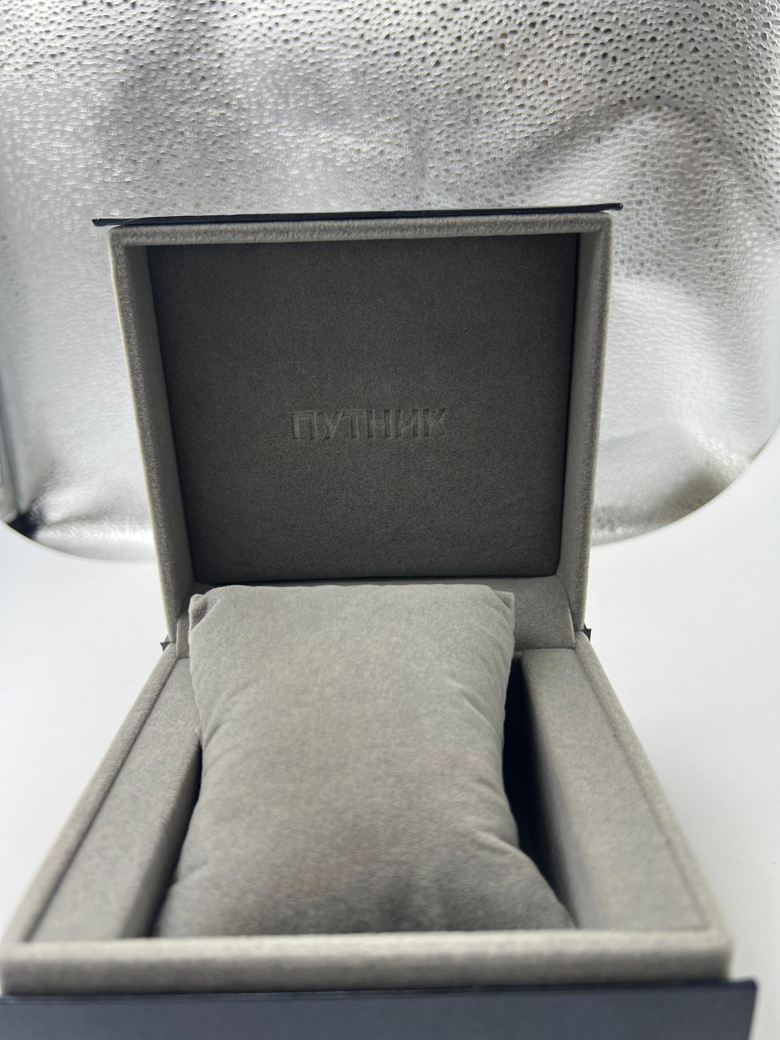
КЧ/Путник 2/коробка/2.jpg
