sergei-tiutriumov/Finishing/КЧ/Путник 2/коробка/3.jpg

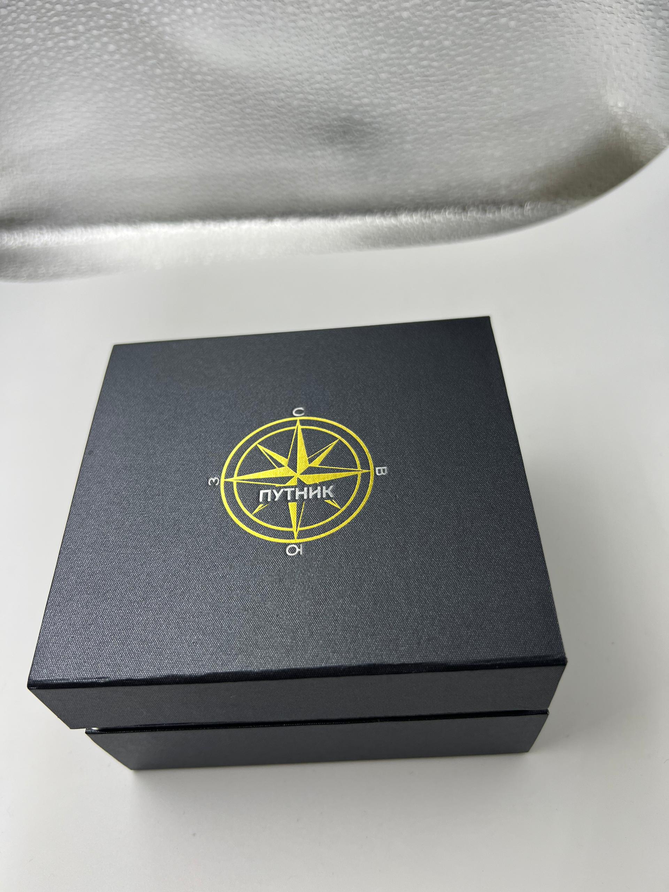
КЧ/Путник 2/коробка/3.jpg
