sergei-tiutriumov/Finishing/КЧ/Путник 2/коробка/125x110x80mm2 copy.jpg

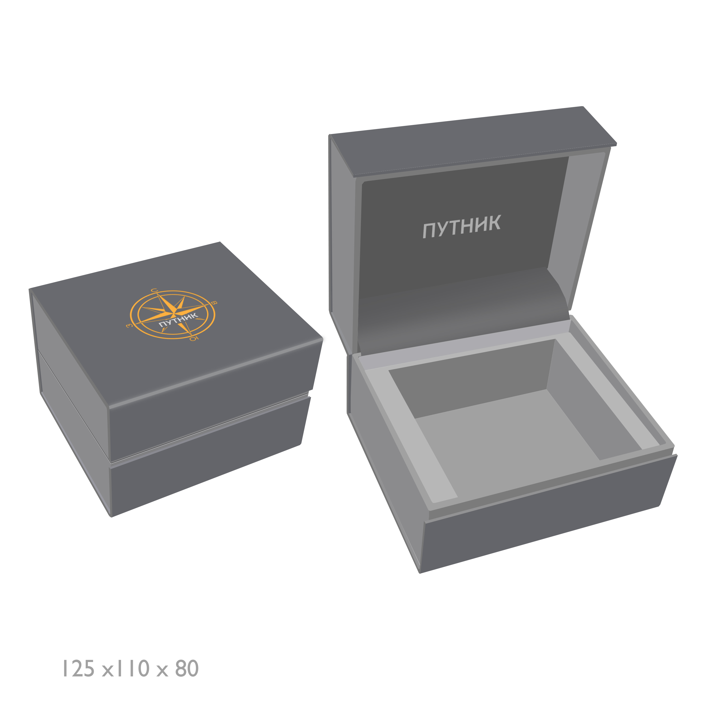
КЧ/Путник 2/коробка/125x110x80mm2 copy.jpg
