sergei-tiutriumov/Finishing/ПерлажСолил.jpg

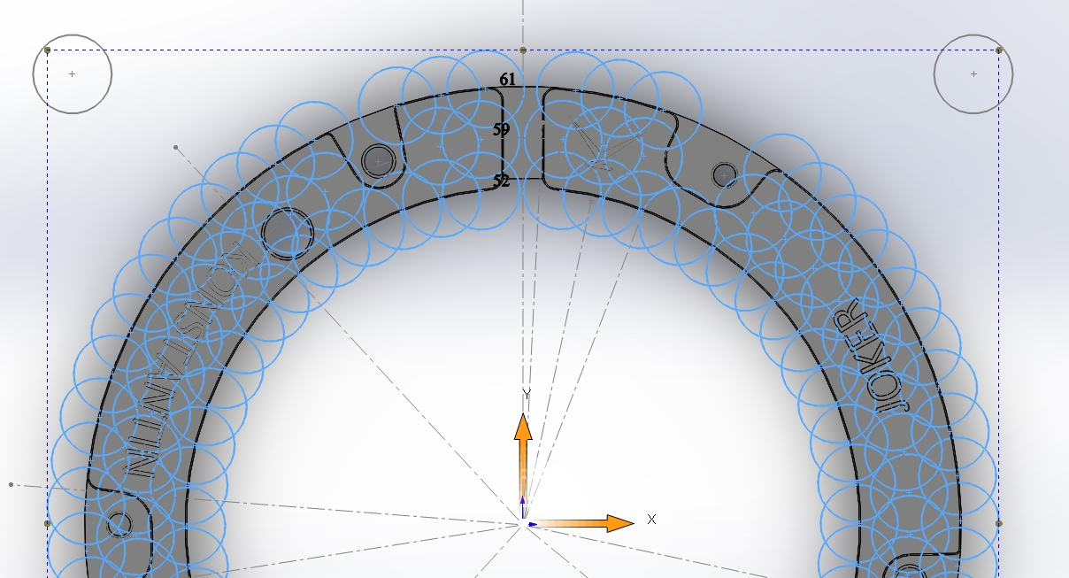
ПерлажСолил.jpg
