sergei-tiutriumov/Finishing/Суханов/Коробка Суханов/IMG-20241226-WA0012.jpg

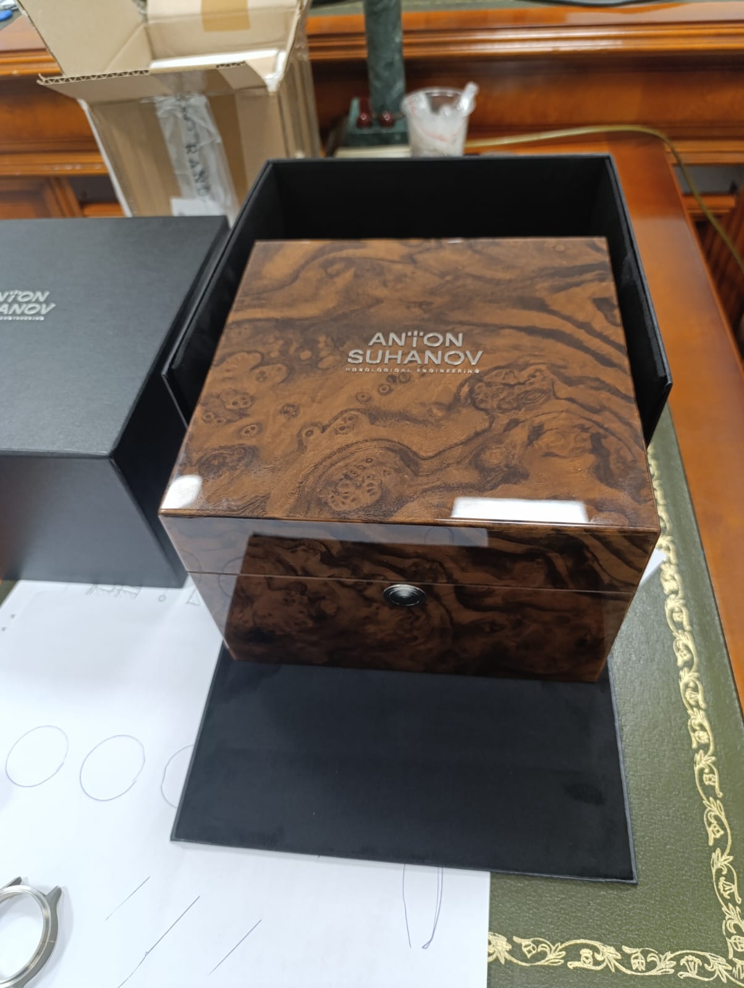
Суханов/Коробка Суханов/IMG-20241226-WA0012.jpg
