sergei-tiutriumov/Finishing/Суханов/Коробка Суханов/IMG-20241226-WA0013.jpg

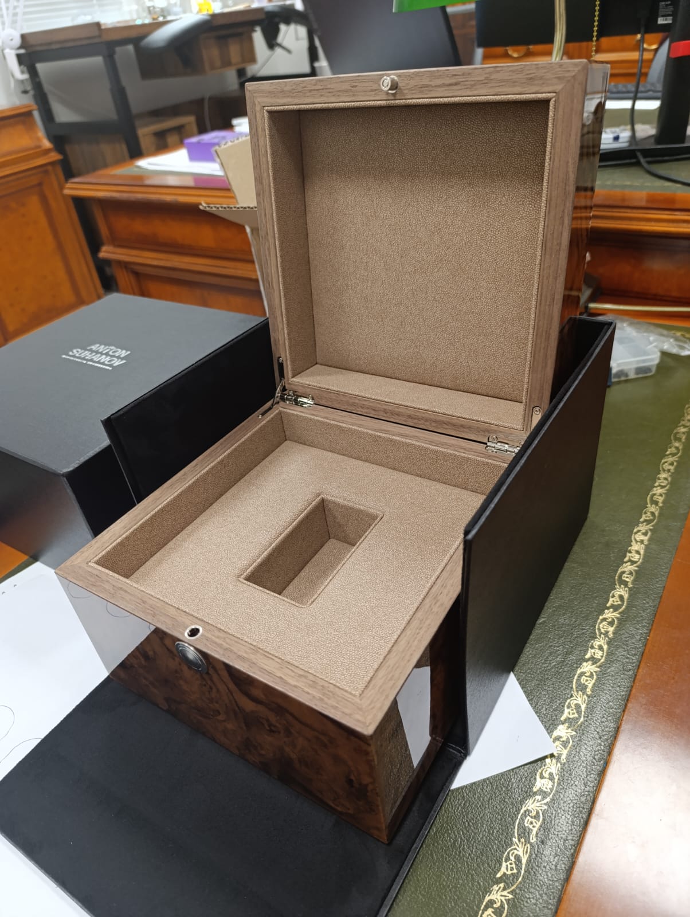
Суханов/Коробка Суханов/IMG-20241226-WA0013.jpg
