sergei-tiutriumov/Finishing/Суханов/Коробка Суханов/Изображение WhatsApp 2024-12-26 в 17.15.50_0cc1c12f.jpg

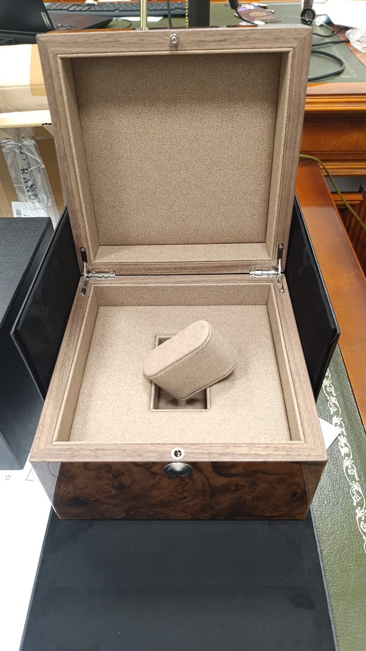
Суханов/Коробка Суханов/Изображение WhatsApp 2024-12-26 в 17.15.50_0cc1c12f.jpg
