sergei-tiutriumov/Finishing/сфинкс/HIWIN_1.jpg

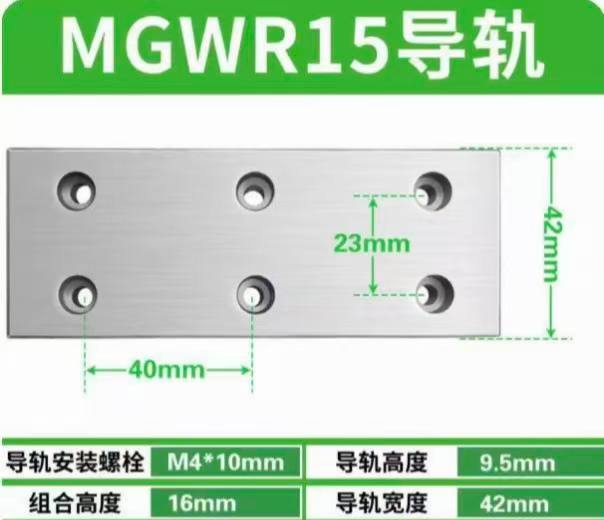
сфинкс/HIWIN_1.jpg
