sergei-tiutriumov/Finishing/сфинкс/HIWIN_MGW.jpg

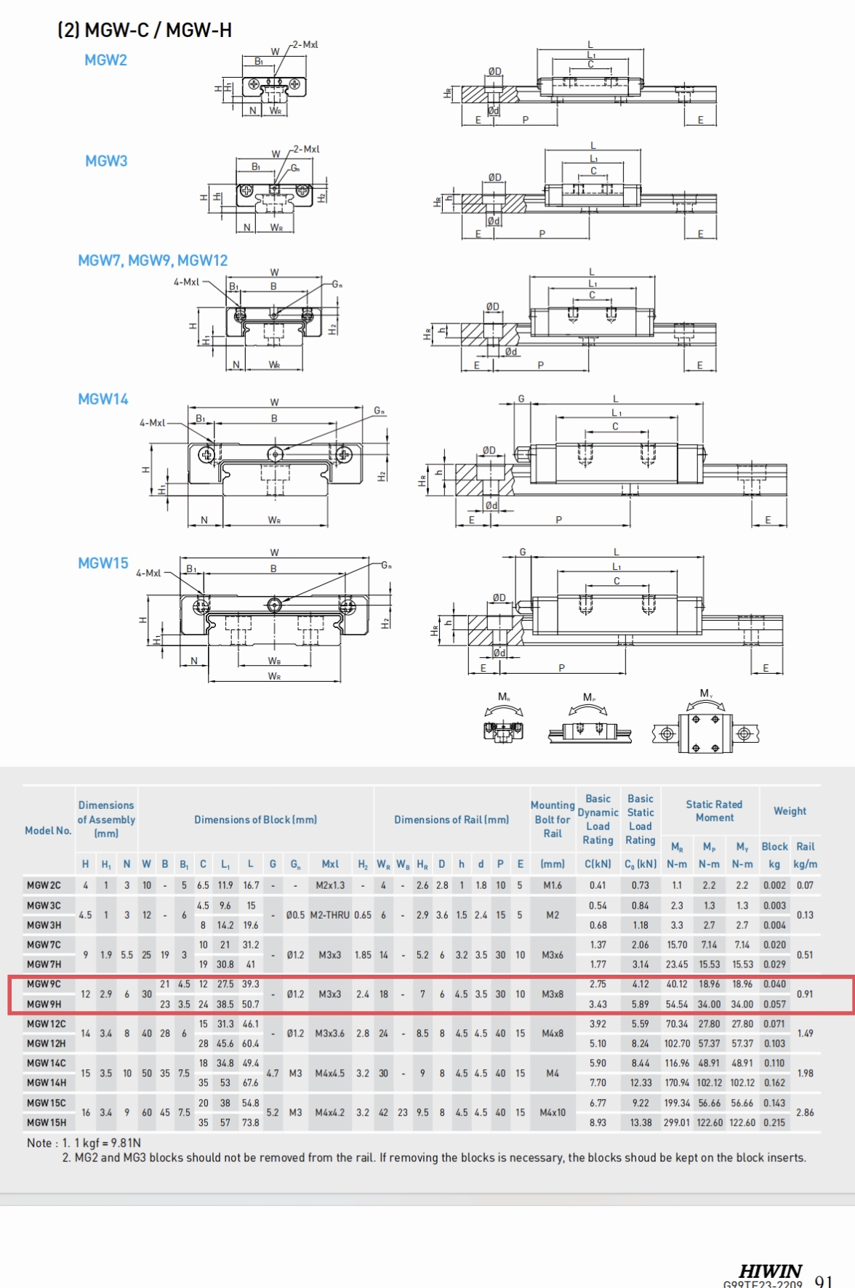
сфинкс/HIWIN_MGW.jpg
