sergei-tiutriumov/Finishing/сфинкс/мануалы15iM/NewKer/стойка.jpeg

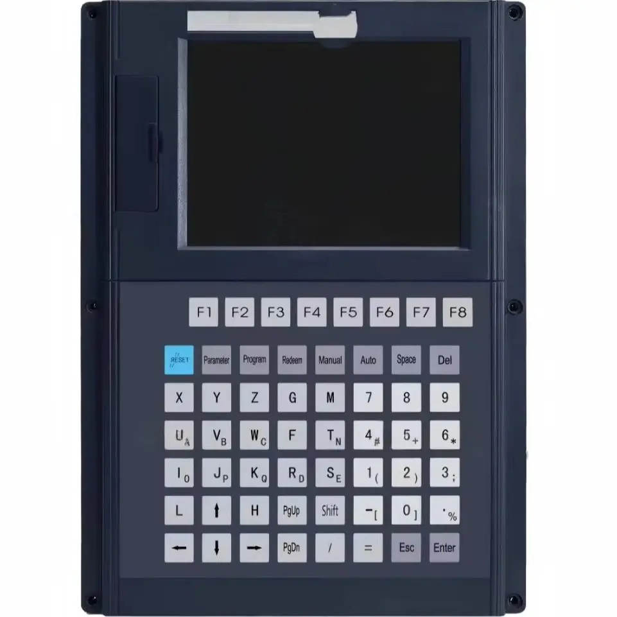
сфинкс/мануалы15iM/NewKer/стойка.jpeg
