sergei-tiutriumov/Finishing/сфинкс/тиски.jpg

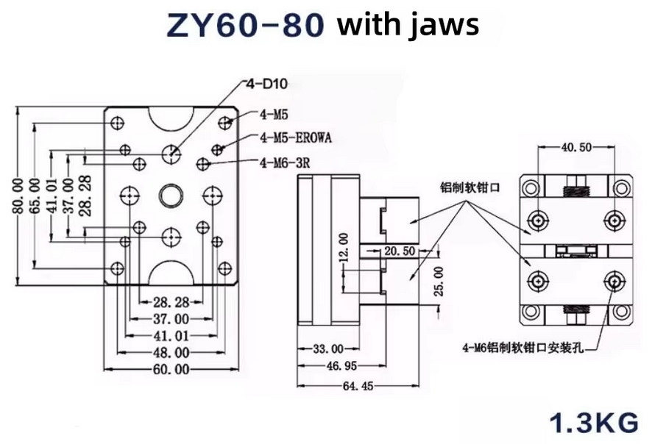
сфинкс/тиски.jpg
