sergei-tiutriumov/Finishing/ФРЕЗЕРОВКА/1.jpg

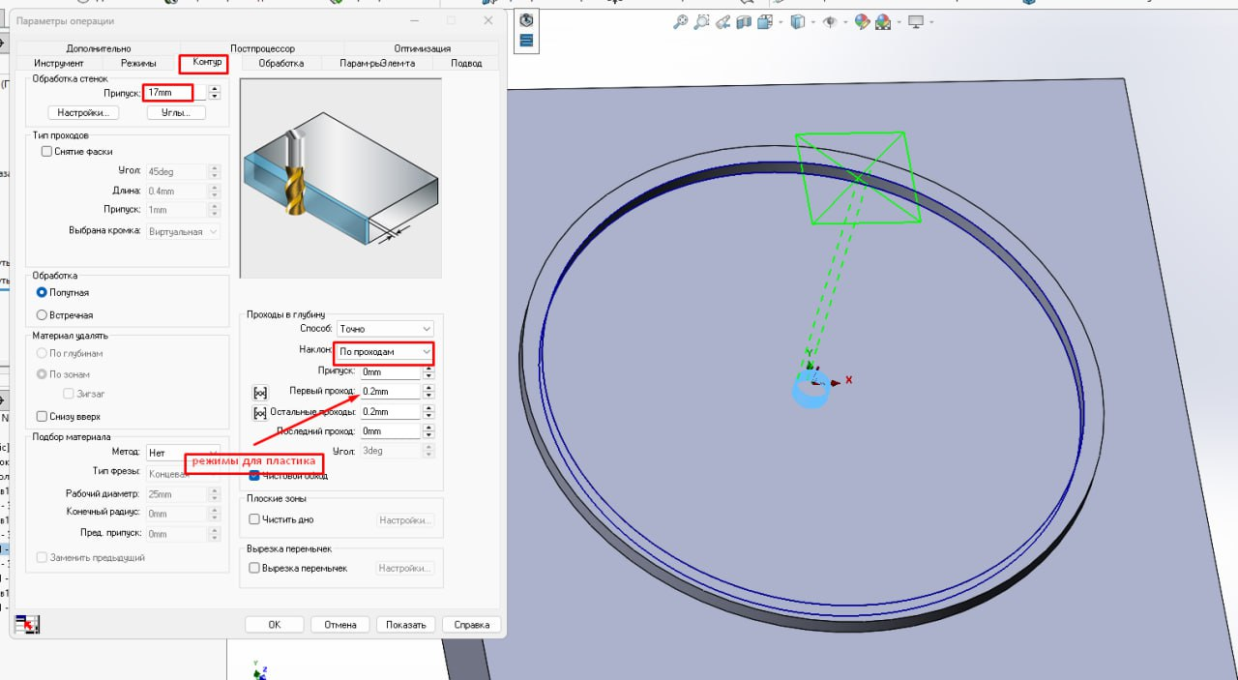
ФРЕЗЕРОВКА/1.jpg
