sergei-tiutriumov/Finishing/ФРЕЗЕРОВКА/2.jpg

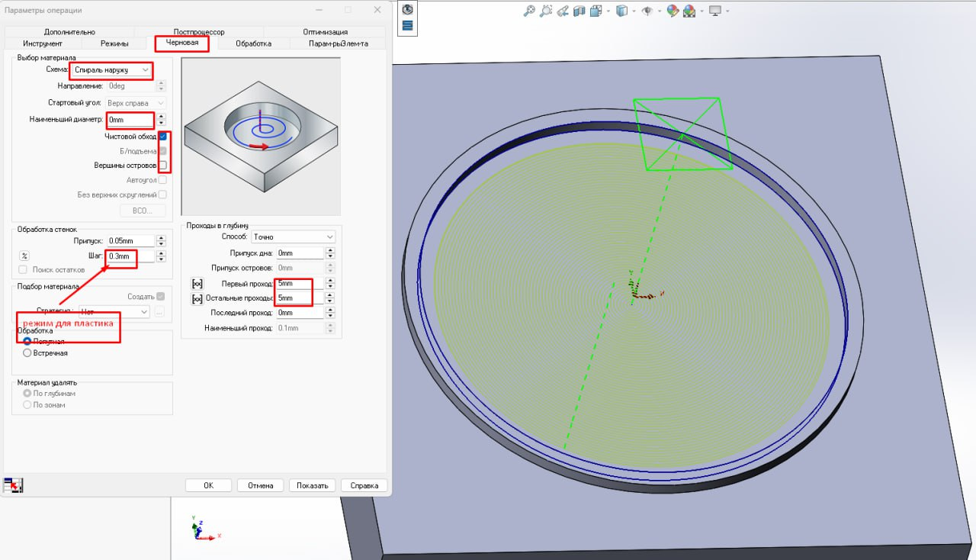
ФРЕЗЕРОВКА/2.jpg
