sergei-tiutriumov/Finishing/ФРЕЗЕРОВКА/3.jpg

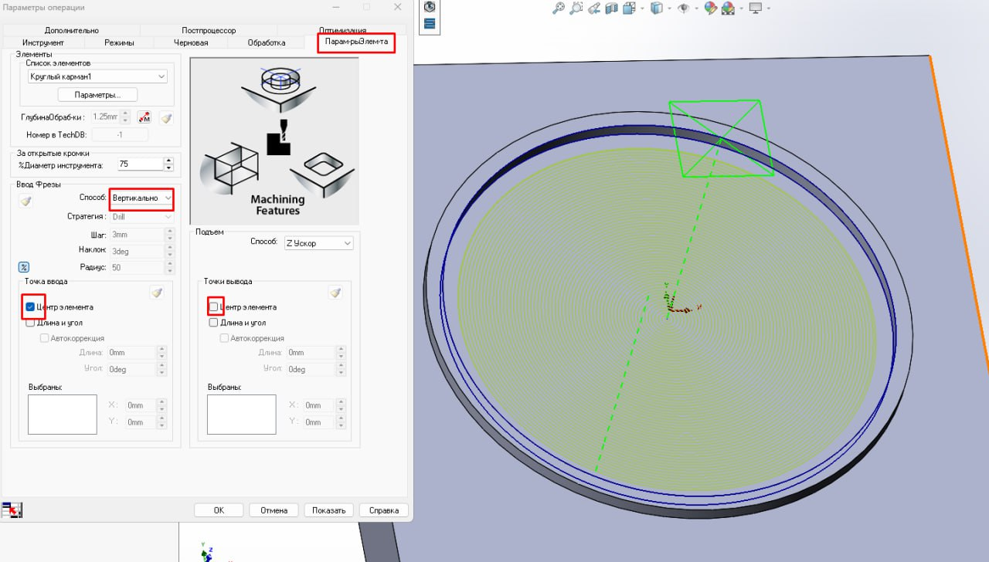
ФРЕЗЕРОВКА/3.jpg
