sergei-tiutriumov/Finishing/ФРЕЗЕРОВКА/4.jpg

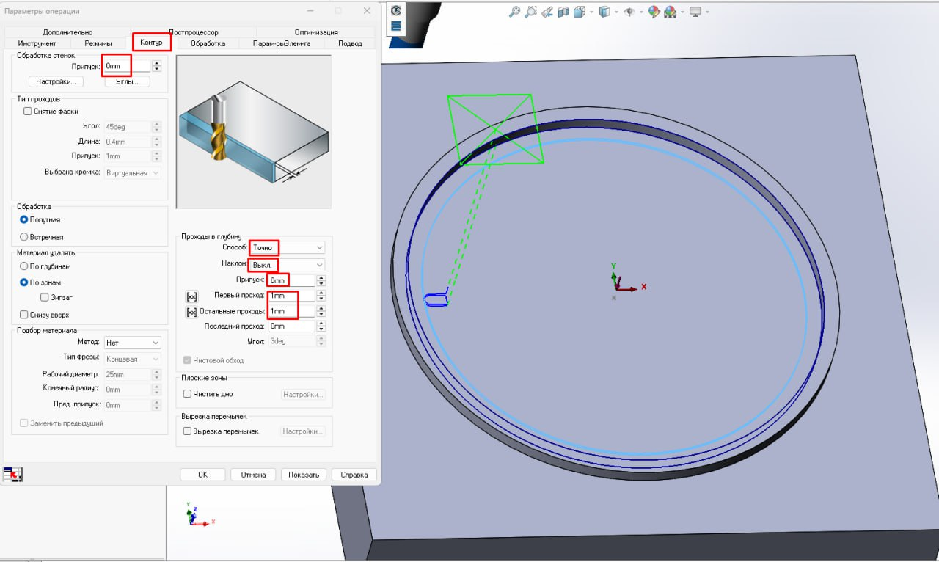
ФРЕЗЕРОВКА/4.jpg
