sergei-tiutriumov/Finishing/ФРЕЗЕРОВКА/5.jpg

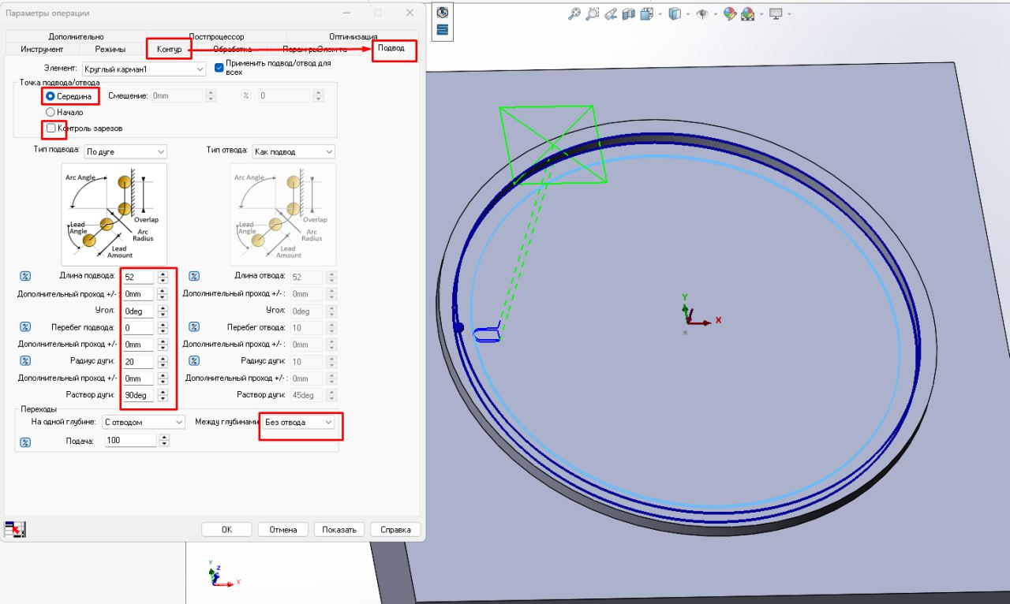
ФРЕЗЕРОВКА/5.jpg
