sergei-tiutriumov/Finishing/КЧ/Путник 2/Roscongress/Документы/12.11.2024 packling list.xls

PACKING LIST
Invoice to: Invoice to: LLC RUPRINT TRADING HOUSE |  |  |  | Date: | 2024-11-12
Attn: Nikiforov A.V. |  |  |  | File No.: | PI240107
Tel: 7 966 003 06 03 |  |  |  | Delivery basis : CPT Moscow
Delivery to: 115419, Ordzhonikidze str., building 11, Moscow
Shipped By: S&K TIME CO., LTD
From: shenzhen
CTN No. | Item No. | Description | Quantity | WEIGHT | CMB
 |  |  | (pcs) | (KG)
CTN 01 | SK23-A22 | Quartz wristwatch, stainless steel case (supplied without batteries) | 50 | 31.60 | 33*53*63
CTN 02 | SK23-A22 | Quartz wristwatch, stainless steel case (supplied without batteries) | 50 | 31.60 | 33*53*63
CTN 03 | SK23-A22 | Quartz wristwatch, stainless steel case (supplied without batteries) | 10 | 6.70 | 30*20*53
Total |  |  |  | 69.90
