sergei-tiutriumov/Finishing/сфинкс/WM_Finishing.xlsx

наименование | количество. итого | 534526 | примечание
сервопривод 100W 40mm | 6 | 115299 | EtherCAT
сервопривод 200W 60mm | 2
линейные напр. 1-й компл. | 1 | 11304 | меджикдрагон
линейные напр. 2-й компл. | 1 | 34400 | хивин
шпиндель | 1 |  | отказали в доставке, больше нет в наличии
заготовки для перлажной фрезы | 1 | 2600
ось смещения микр | 1 | 2200
алюминиевые плиты 4шт. | 4 | 80000 | альмет
алюминиевые заготовки с авито | 2 | 4000
таможенный платеж | 1 | 2430
контроллер | 1 | 16110 | https://inectra.ru/product/msc-4es
тиски | 2 | 13300 | https://aliexpress.ru/item/1005009732732491.html?sku_id=12000049981355998
латунь под табличку | 10 | 4500 | Л59Т
держатели гаек и гофры |  | 13500 | purelogic
сервопривод 100W 40mm | 6 | 77000 | StepDIR
сервопривод 200W 60mm | 2
шкаф | 1 | 4762 | https://www.ozon.ru/product/shkaf-montazhnyy-navesnoy-ulichnyy-mastermann-plastik-3u-ip-66-s-zazemleniem-1690411879/
БП AC/DC 36 Вт 24 В 1,5 А | 1 | 1192 | https://www.ozon.ru/product/hdr-30-24-mean-well-blok-pitaniya-na-din-reyku-ac-dc-36-vt-24-v-1-5-a-ultratonkiy-35-mm-2-su-so-2153084102/
провода медные |  | 1900
БП AC/DC 85 Вт 12 В 7,1 | 1 | 2081 | https://www.ozon.ru/product/hdr-100-12-mean-well-blok-pitaniya-na-din-reyku-ac-dc-85-vt-12-v-7-1-a-tonkiy-70-mm-4-su-so-2153086799/
БП 15Вт 5В 2,4А | 1 | 957 | https://www.ozon.ru/product/hdr-15-5-mean-well-blok-pitaniya-na-din-reyku-15vt-5v-2-4a-kompaktnyy-razmer-so-2240678558/
Плиты 50 мм | 2 | 15600
плиты 40 мм | 2 | 6700
сканирование |  | 16800 | центр прототипирования
опоры ШВП | 3 | 7350 | https://cnc-tehnologi.ru/opory-vintov-shvp-seriya-bk/opora-shvp-bk-12150107132737
ШВП, опоры, муфты в снс | 1 | 47620 | снс технология (с безнала)
для фрезы, микрометры, цанги | 1 | 10017 | али
фреза для обрабоки 60мм торцов | 1 | 5750 | авито+такси
электрика, метизы, материалы | 1 | 9450 | максидом, свм крепеж, крепком
подшипники для поворота шпинделя | 1 | 2500 | автоконтинент, роско,
подшипники для шпинделя (думплекс) | 1 | 4800 | автоконтинент, роско, или техбюро
цанковый зажим (ось) для шпинделя | 1 | 3926 | али
фрезы для алюминия, пластинки | 1 | 4328 | али
серворпривод комплект что стоит на шлифовалке | 1 | 12150 | али (не помню оплачивал его чайкин или нет)
