sergei-tiutriumov/Finishing/КЧ/Путник 2/Roscongress/Документы/12.11.2024 shipping invoice.xls

SHIPPING INVOICE
Invoice to: LLC RUPRINT TRADING HOUSE |  |  |  |  | Date: | 2024-11-12
INN: 7725283285 |  |  |  |  | File No.: | PI240107
account: 40702810020000141126 |  |  |  |  | Delivery basis : | CPT Moscow
Bank name: Bank Tochka LLC
c/s: 30101810745374525104
BIC: 044525104
Attn: Nikiforov A.V.
Tel: 7 966 003 06 03
Delivery to: 115419, Ordzhonikidze str., building 11, Moscow
Shipped By: S&K TIME CO., LTD
From: shenzhen
Item No. | Photo | Описание | Description | Quantity/ Кол-во | Unit Price/цена за единицу | Amount/Сумма
 |  |  |  | (pcs) | (CPT Moscow)
SK23-A22 |  | Кварцевые наручные часы, корпус нержавеющая (поставляются без батарей) | Quartz wristwatch, stainless steel case (supplied without batteries) | 110 | US$47.70 | US$5247.00
Total |  |  |  | 110 |  | US$5247.00
Payment terms: postpaid 6 months after shipping.
Beneficiary Name: S K Time Co., Limited
Account Number: 798133050
BIC/SWIFT: DHBKHKHHXXX
Bank Code: 016
Bank Name: DBS Bank (Hong Kong) Limited
Bank Address: G/F, The Center, 99 Queen''s Road Central, Central, Hong Kong
S&K TIME CO., LTD
