sergei-tiutriumov/Finishing/Ivan/2025-08-26 J2-Case-Full-18mmLugsGlue.stp

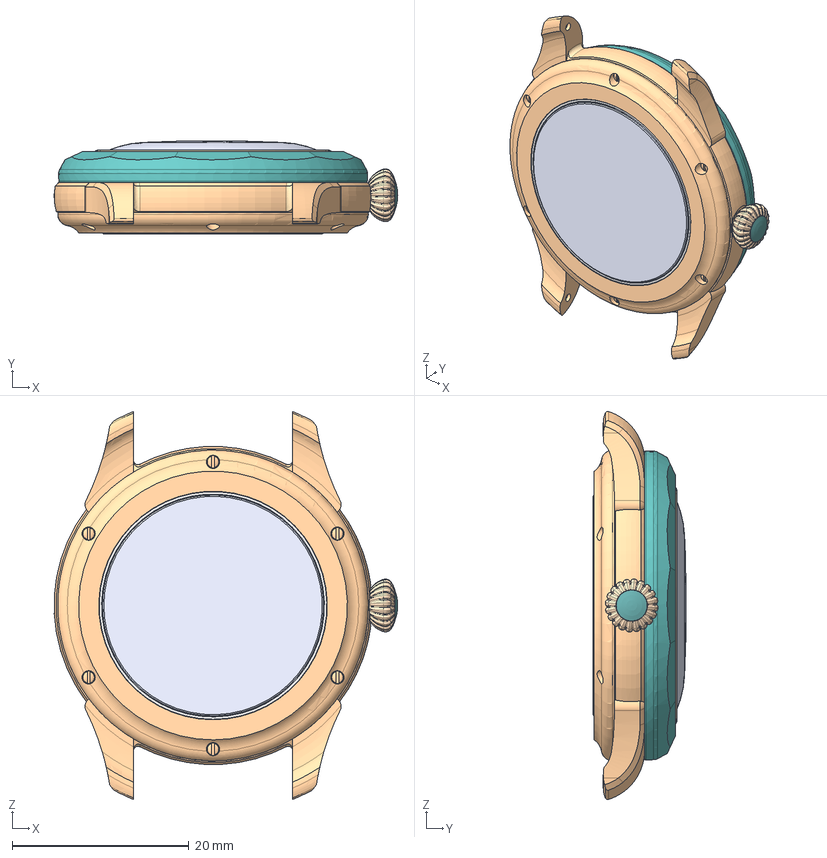
[picture p254: CAD file, 2025-10-01]
Ivan/2025-08-26 J2-Case-Full-18mmLugsGlue.stp
38.9 x 10.6 x 43.9 mm
ïðîêëàäêà ñòåêëà
âèíò ê ìåõ x 2
ìèí
âàë çàâîäíîé
Äåòàëü ê 2609
÷àñ
ñåê
ïðóæ øàéáà x 2
玹1
141-碞鵻罻
êîëüöî 2.5õ0.5
嚦樏鋋24.2
24-嚦樏鋋-26.4
öèôåðáëàò
shaft_gold
O-Ring_cr1
O-Ring_cr1.1
StonForCrown
crown
shaft_new
