sergei-tiutriumov/Finishing/КЧ/Путник 2/02.07.2024/putnik_3.STEP

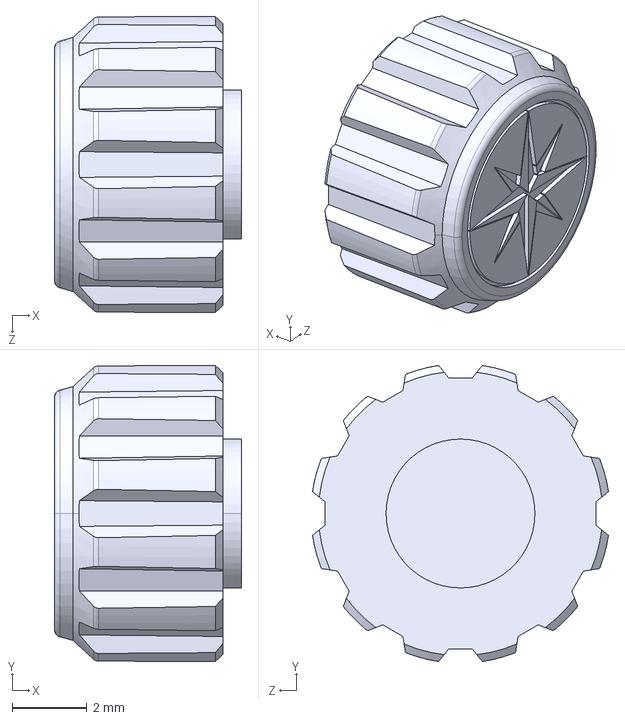
[picture p255: CAD file, 2026-01-26]
КЧ/Путник 2/02.07.2024/putnik_3.STEP
5.00 x 7.91 x 7.91 mm
