sergei-tiutriumov/Finishing/Ракета/КД мосты 2615/Мост анкерный АЖШ8.075.102-01/АЖШ.8.0.75.102-01_Мост_анкерный.stp

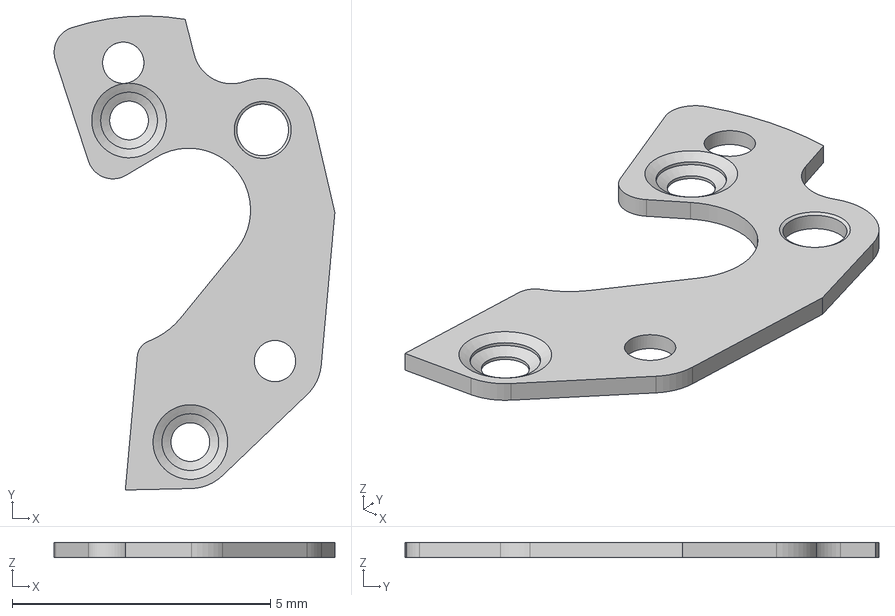
[picture p256: CAD file, 2025-09-12]
Ракета/КД мосты 2615/Мост анкерный АЖШ8.075.102-01/АЖШ.8.0.75.102-01_Мост_анкерный.stp
5.44 x 9.18 x 0.3 mm
