sergei-tiutriumov/Finishing/Ракета/КД мосты 2615/Мост барабанный АЖШ8.075.025/АЖШ.8.075.025-01_Мост_барабанный.stp

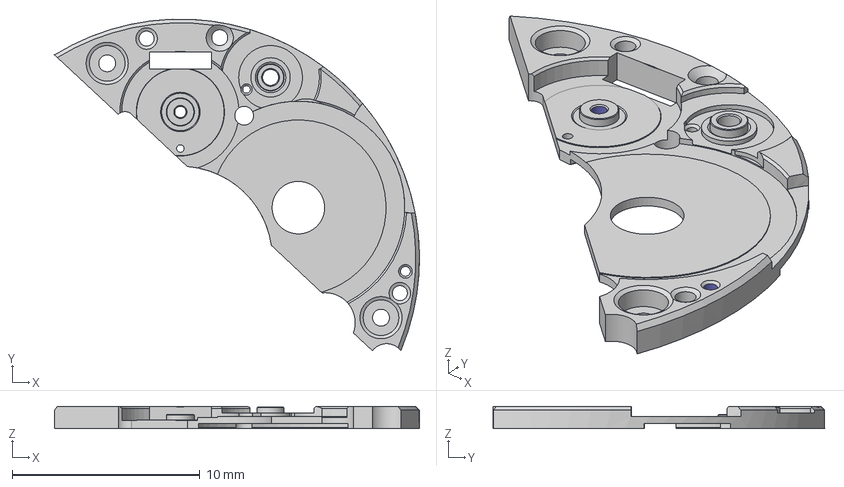
[picture p257: CAD file, 2025-09-12]
Ракета/КД мосты 2615/Мост барабанный АЖШ8.075.025/АЖШ.8.075.025-01_Мост_барабанный.stp
19.5 x 17.7 x 1.18 mm
