sergei-tiutriumov/Finishing/Ракета/КД мосты 2615/Мост подзавода нижний АЖШ8.075.703/АЖШ8.075.703 _ Мост нижний автоподзавода.stp

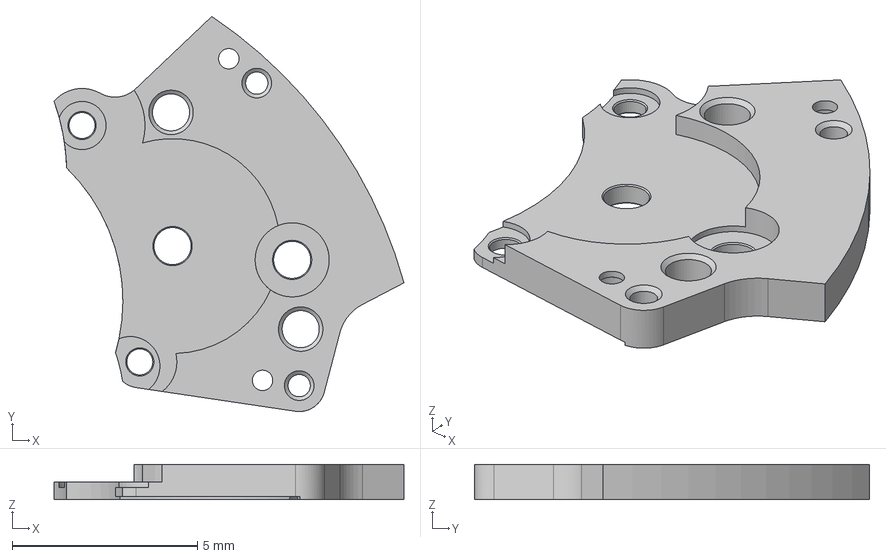
[picture p258: CAD file, 2025-09-12]
Ракета/КД мосты 2615/Мост подзавода нижний АЖШ8.075.703/АЖШ8.075.703 _ Мост нижний автоподзавода.stp
9.45 x 10.7 x 0.95 mm
