sergei-tiutriumov/Finishing/Ракета/КД мосты 2615/Мост центральный АЖШ8.075.202/АЖШ.8.075.202_Мост_центральный.stp

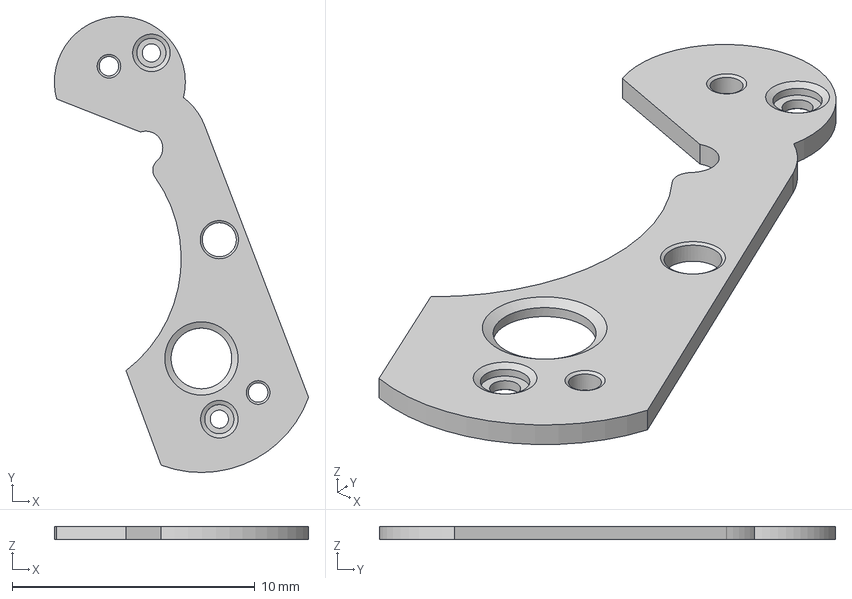
[picture p259: CAD file, 2025-09-12]
Ракета/КД мосты 2615/Мост центральный АЖШ8.075.202/АЖШ.8.075.202_Мост_центральный.stp
10.5 x 18.8 x 0.55 mm
