sergei-tiutriumov/Finishing/сфинкс/Крышки/STEP/х1.STEP

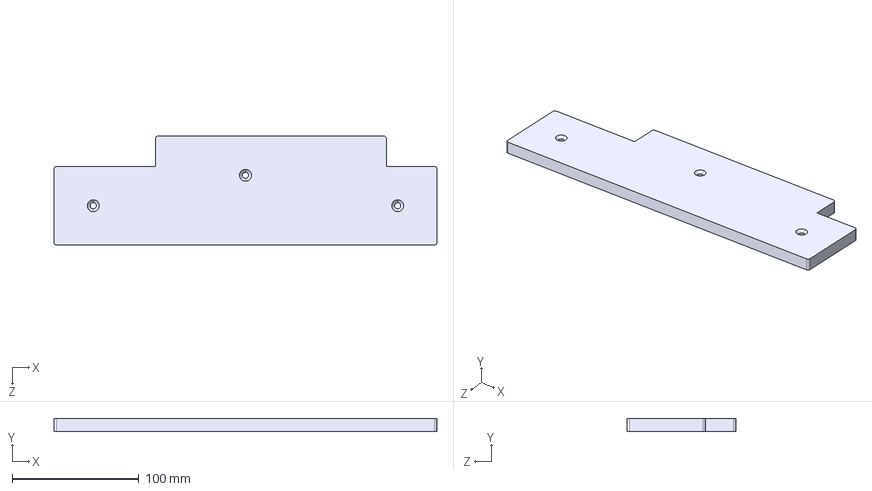
[picture p260: CAD file, 2026-01-21]
сфинкс/Крышки/STEP/х1.STEP
302.0 x 10.0 x 86.0 mm
