sergei-tiutriumov/Finishing/Ракета/КД мосты 2615/Мост ангренажный АЖШ8.075.320/острова.DXF

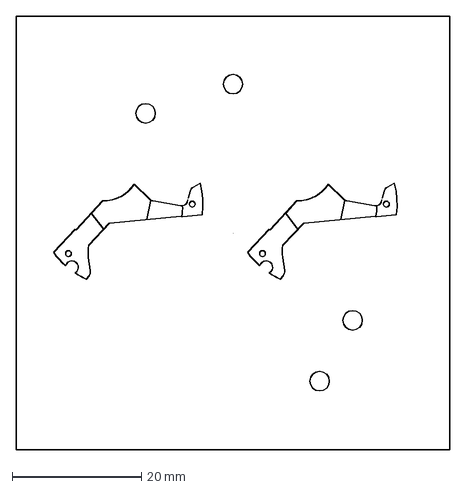
[picture p261: CAD file, 2026-05-02]
Ракета/КД мосты 2615/Мост ангренажный АЖШ8.075.320/острова.DXF
67.0 x 67.0 mm
