sergei-tiutriumov/Finishing/сфинкс/Крышки/STEP/х4.STEP

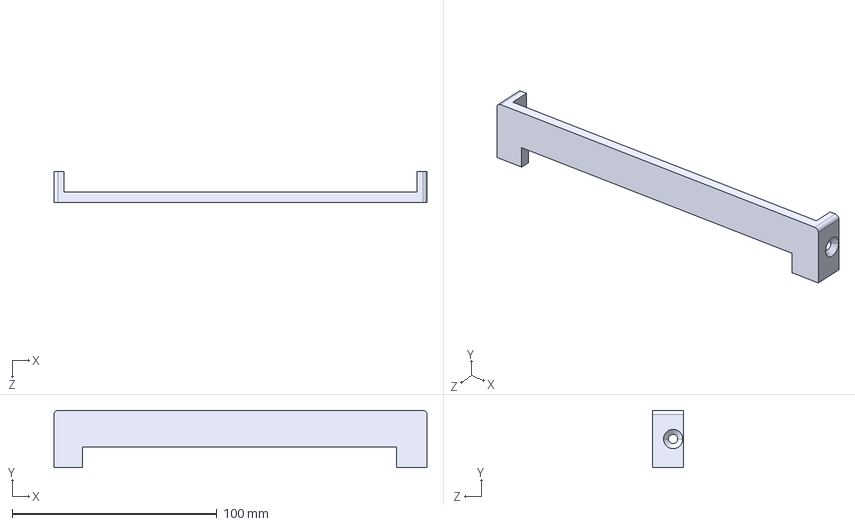
[picture p262: CAD file, 2026-01-21]
сфинкс/Крышки/STEP/х4.STEP
182.0 x 28.0 x 15.0 mm
