sergei-tiutriumov/Finishing/Ракета/КД мосты 2615/Мост ангренажный АЖШ8.075.320/низ.DXF

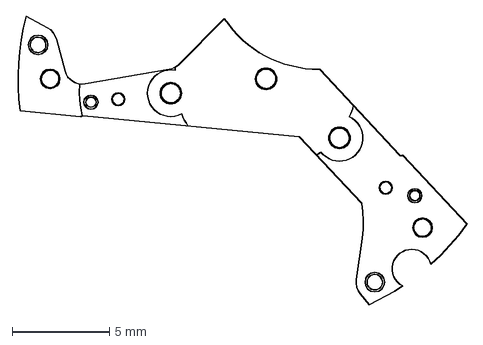
[picture p263: CAD file, 2026-03-12]
Ракета/КД мосты 2615/Мост ангренажный АЖШ8.075.320/низ.DXF
23.2 x 14.8 mm
