sergei-tiutriumov/Finishing/сфинкс/Крышки/STEP/z1.STEP

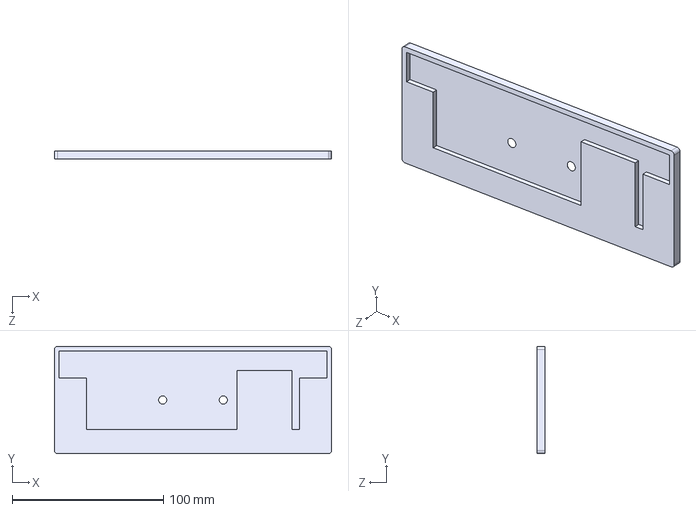
[picture p264: CAD file, 2026-01-21]
сфинкс/Крышки/STEP/z1.STEP
183.0 x 71.0 x 5.00 mm
