sergei-tiutriumov/Finishing/сфинкс/Крышки/STEP/z2.STEP

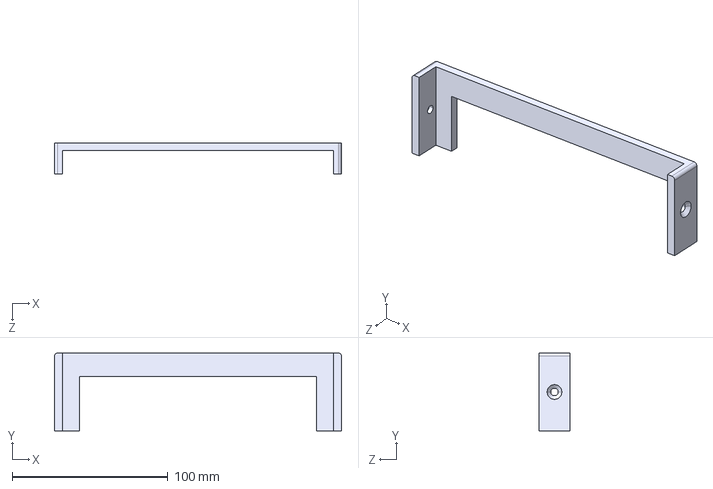
[picture p266: CAD file, 2026-01-21]
сфинкс/Крышки/STEP/z2.STEP
184.0 x 50.0 x 20.0 mm
