sergei-tiutriumov/Finishing/КЧ/Мост/лицевая сторона.DXF

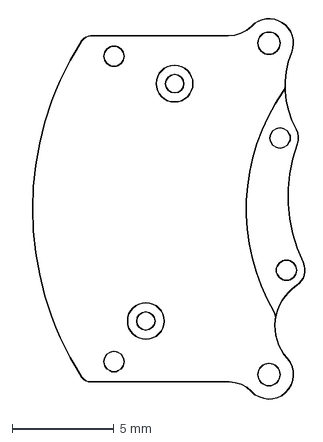
[picture p267: CAD file, 2026-01-26]
КЧ/Мост/лицевая сторона.DXF
14.3 x 18.9 mm
