sergei-tiutriumov/Finishing/КЧ/проставочое кольцо/K.18-18.MVMT.00.001.V3 Кольцо проставочное.DXF

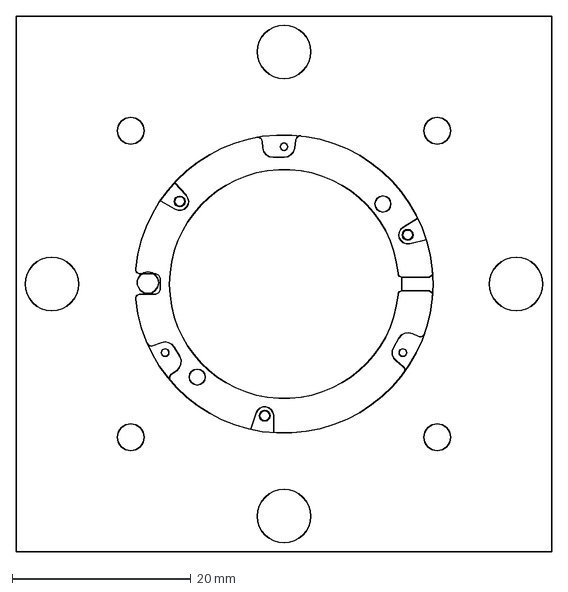
[picture p268: CAD file, 2025-09-12]
КЧ/проставочое кольцо/K.18-18.MVMT.00.001.V3 Кольцо проставочное.DXF
60.0 x 60.0 mm
