sergei-tiutriumov/Finishing/Ракета/КД мосты 2615/Мост ангренажный АЖШ8.075.320/АЖШ8.075.320_Мост_ангренажный_автоподзавода.stp

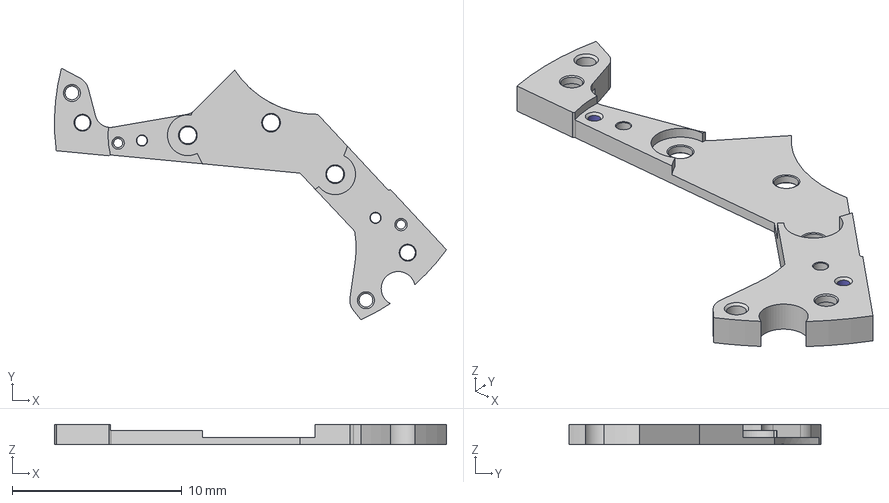
[picture p269: CAD file, 2025-09-12]
Ракета/КД мосты 2615/Мост ангренажный АЖШ8.075.320/АЖШ8.075.320_Мост_ангренажный_автоподзавода.stp
23.1 x 14.8 x 1.18 mm
