sergei-tiutriumov/Finishing/сфинкс/Крышки/STEP/уЛ.STEP

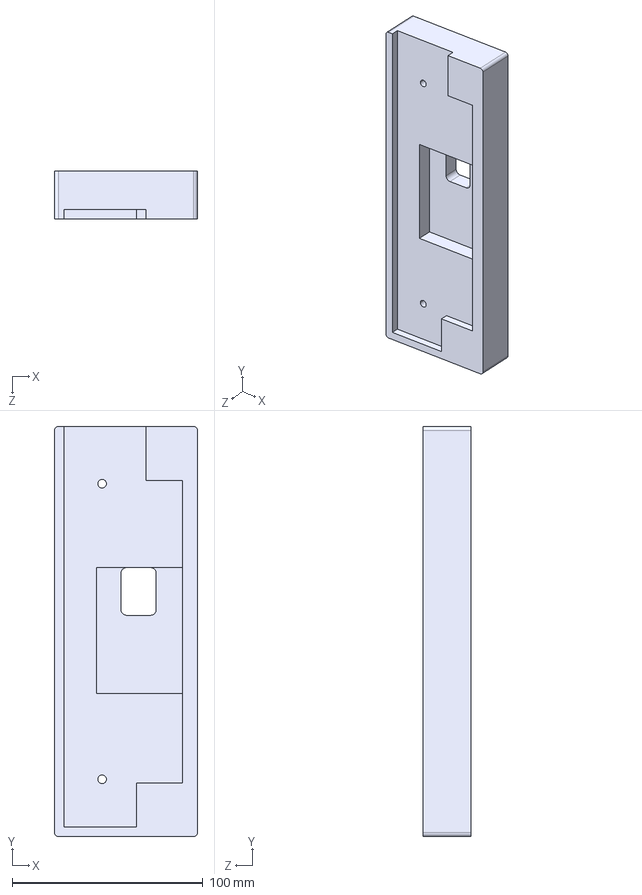
[picture p270: CAD file, 2026-01-21]
сфинкс/Крышки/STEP/уЛ.STEP
75.0 x 215.0 x 25.0 mm
