sergei-tiutriumov/Finishing/сфинкс/Отверстия на торце столика Z.DXF

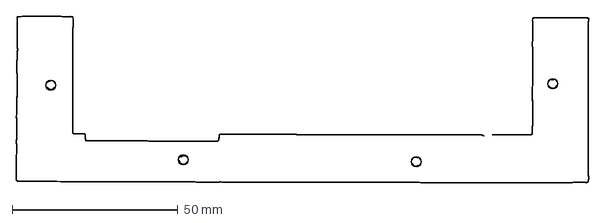
[picture p271: CAD file, 2026-02-07]
сфинкс/Отверстия на торце столика Z.DXF
173.0 x 50.2 mm
