sergei-tiutriumov/Finishing/сфинкс/шаговик_40мм/LC40-03-100W.STEP

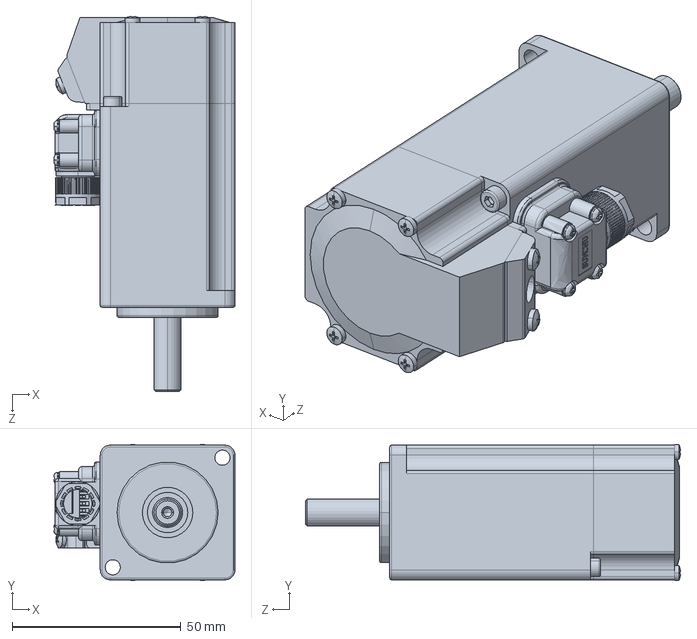
[picture p272: CAD file, 2025-12-19]
сфинкс/шаговик_40мм/LC40-03-100W.STEP
53.7 x 40.4 x 111.3 mm
