sergei-tiutriumov/Finishing/КЧ/Мост/задник.DXF

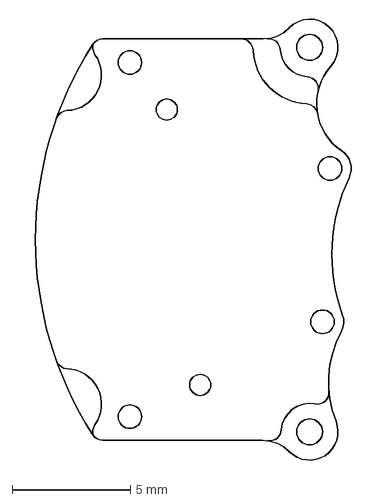
[picture p273: CAD file, 2026-01-26]
КЧ/Мост/задник.DXF
14.3 x 18.9 mm
