sergei-tiutriumov/Finishing/КЧ/проставочое кольцо/ложемент.DXF

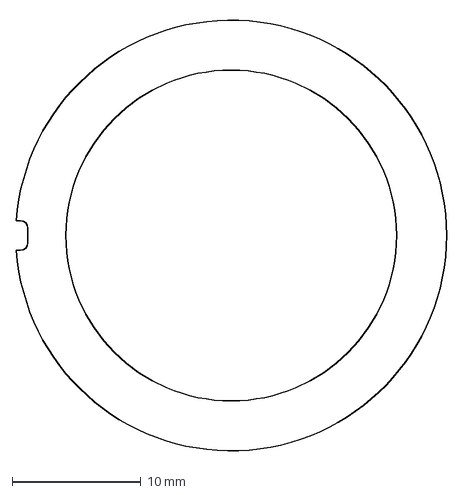
[picture p274: CAD file, 2025-09-12]
КЧ/проставочое кольцо/ложемент.DXF
33.4 x 34.0 mm
