sergei-tiutriumov/Finishing/сфинкс/Крышки/STEP/х2.STEP

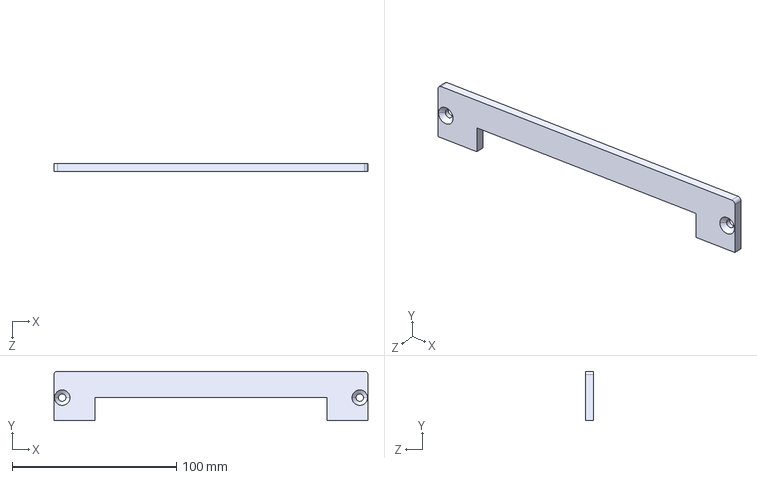
[picture p275: CAD file, 2026-01-21]
сфинкс/Крышки/STEP/х2.STEP
191.0 x 30.0 x 5.00 mm
