sergei-tiutriumov/Finishing/мост_контур_лицо.DXF

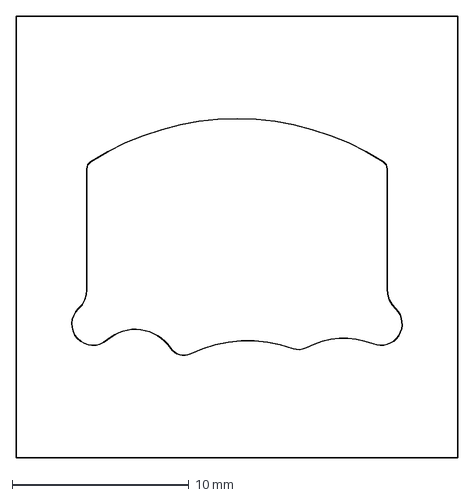
[picture p276: CAD file, 2025-09-12]
мост_контур_лицо.DXF
25.0 x 25.0 mm
