sergei-tiutriumov/Finishing/1.dxf

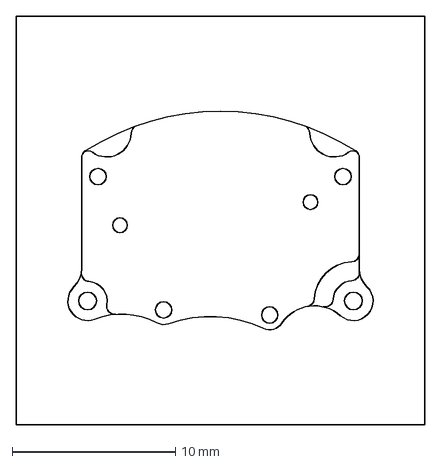
[picture p277: CAD file, 2025-09-12]
1.dxf
25.0 x 25.0 mm
