sergei-tiutriumov/Finishing/1_2.dxf

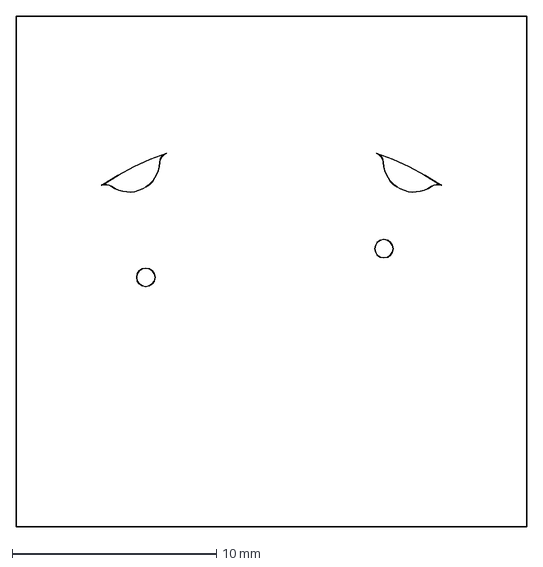
[picture p278: CAD file, 2025-09-12]
1_2.dxf
25.0 x 25.0 mm
