sergei-tiutriumov/Finishing/(list of files, cad)

Other CAD files:
КЧ/Путник 2/пряжка 18,2мм/Пряжка 3 детали.SLDASM
Ivan/калибр соосность.SLDASM
сфинкс/шаговик_40мм/шаговик.SLDASM
КЧ/Путник 2/пряжка 18,2мм/К.10-2.CASE.00.10 СБ пряжка2.SLDASM
сфинкс/корпус стойки/корпус.SLDASM
сфинкс/станок.SLDASM
КЧ/Case Joker 40mm/СБ пряжка 18мм h/СБ пряжка 40мм.SLDASM
КЧ/Путник 2/пряжка 18,2мм/К.10-2.CASE.00.10 СБ пряжка1.SLDASM
КЧ/Case Joker 40mm/K.18-11.CASE.02.00 Button.SLDASM
КЧ/Путник 2/пряжка 18,2мм/К.10-2.CASE.00.10 СБ пряжка.SLDASM
КЧ/Case Joker 40mm/СБ_Case 40mm Joker.SLDASM
КЧ/Case Joker 40mm/K.18-18.CASE.02.00 Кнопка.SLDASM
КЧ/Case Joker 40mm/K.18-18.MVMT.00.00 СБ Case 40mm Joker.SLDASM
сфинкс/Поворотный Шпиндель.SLDASM
сфинкс/табличка всборе.SLDASM
Ivan/калибр механизм.SLDPRT
K.18-18.MVMT.00.001.V3 Кольцо проставочное.SLDPRT
китаец/Высокий стол в тиски.SLDPRT
китаец/Эксперимент перлаж/Эксперимент перлаж/Перлаж.SLDPRT
КЧ/Case Joker 40mm/K.18-18LJP.CASE.01.02 Крышка.SLDPRT
КЧ/Case Joker 40mm/Заготовки/контур для электроэрозии.SLDPRT
КЧ/Case Joker 40mm/СБ пряжка 18мм h/пряжка 40мм.SLDPRT
КЧ/Мост/ложемент под мостЛИЦО.SLDPRT
КЧ/пилообразный паттерн.SLDPRT
КЧ/Платы/K.18-18.MVMT.01.01.V2 плата надстройки.SLDPRT
КЧ/проставочое кольцо/K_18_18_MVMT_20_00_V3_Кольцо_проставочное 1.SLDPRT
КЧ/Путник 2/Buckle for Sally/К.10-2.CASE.00.13 язычок пряжки.SLDPRT
КЧ/Путник 2/S928G新 BEZEL.SLDPRT
КЧ/ТЕСТ пилообразная женевка/12.09.26/пилообразный паттерн.SLDPRT
КЧ/ТЕСТ пилообразная женевка/паттерн.SLDPRT
Ракета/заготовка.SLDPRT
Ракета/КД мосты 2615/Мост ангренажный АЖШ8.075.320/ангренажный мост заподлицо.SLDPRT
Суханов/Мост/BridgeFinishing.SLDPRT
Суханов/Надстройка/Перлаж.SLDPRT
Суханов/Циферблат/DialFinishing.SLDPRT
сфинкс/корпус стойки/основание.SLDPRT
сфинкс/Крышки/ШапкаZ.SLDPRT
сфинкс/рабочий стол/рабочий стол Микони.SLDPRT
сфинкс/табличка.SLDPRT
сфинкс/Центр_прототипирования/Y_table.SLDPRT
сфинкс/шаговик_40мм/Разделить4[1].SLDPRT
ФРЕЗЕРОВКА/ОбработкаРЕЖИМЫ.SLDPRT
G&P_sep.SLDPRT
китаец/рабочий стол.SLDPRT
КЧ/Case Joker 40mm/K.18-18LJP.CASE.01.03 bezel Joker 40 LJP.SLDPRT
КЧ/Case Joker 40mm/СБ пряжка 18мм h/К.18-0.CASE.10.02 язычок пряжки.SLDPRT
КЧ/Мост/фаски_и_грани.SLDPRT
КЧ/Платы/K.18-23.MVMT.01.01.V3 плата надстройки.SLDPRT
КЧ/проставочое кольцо/K.18-18.MVMT.20.00.V3 Кольцо проставочное.SLDPRT
КЧ/Путник 2/Buckle for Sally/Ось пряжки.SLDPRT
КЧ/Путник 2/S928G CASE.SLDPRT
КЧ/Путник 2/пряжка 18,2мм/К.10-2.CASE.00.13 язычок пряжки.SLDPRT
Ракета/Перлаж пример.SLDPRT
Суханов/Мост/мост.SLDPRT
Суханов/Надстройка/Надстройка тест.SLDPRT
Суханов/Циферблат/циферблат.SLDPRT
сфинкс/волны_инструмент.SLDPRT
сфинкс/корпус стойки/верх.SLDPRT
сфинкс/Крышки/верхняя панель.SLDPRT
сфинкс/рабочий стол/ангренажный мост заподлицо.SLDPRT
сфинкс/Центр_прототипирования/портал Z.SLDPRT
Ivan/Заготовка цанги.SLDPRT
китаец/МикониСтол.SLDPRT
КЧ/Case Joker 40mm/резинка на задню крышку 32х0.7.SLDPRT
КЧ/Case Joker 40mm/СБ пряжка 18мм h/ость для чертежей 20.SLDPRT
КЧ/Мост/ложемент под мостЗАД.SLDPRT
КЧ/Платы/K.18-20.MVMT.01.01.V4 плата.SLDPRT
КЧ/проставочое кольцо/перлаж первыйвариант.SLDPRT
КЧ/Путник 2/Buckle for Sally/Сборка1^К.10-2.CASE.00.10 СБ пряжка1.SLDPRT
КЧ/Путник 2/безель.SLDPRT
планирование .SLDPRT
сфинкс/рабочий стол/планирование восьмеркой.SLDPRT
сфинкс/Центр_прототипирования/Z_table.SLDPRT
сфинкс/шаговик_40мм/Тело9.SLDPRT
G&P.SLDPRT
Ivan/Цанга под корпус.SLDPRT
КЧ/Case Joker 40mm/K.18-18.CASE.02.01 корпус кнопки.SLDPRT
КЧ/Мост/ТЕСТ_фаски.SLDPRT
КЧ/проставочое кольцо/ложемент под кольцо.SLDPRT
КЧ/Путник 2/крышка.SLDPRT
КЧ/Путник 2/пряжка 18,2мм/Сборка1^К.10-2.CASE.00.10 СБ пряжка1.SLDPRT
сфинкс/Z_table.SLDPRT
сфинкс/корпус стойки/боковина.SLDPRT
сфинкс/рабочий стол/цилиндр.SLDPRT
сфинкс/Центр_прототипирования/X_table.SLDPRT
сфинкс/шаговик_40мм/Тело4.SLDPRT
Ivan/Стекло.SLDPRT
K.18-18.MVMT.01.01.V2 плата надстройки.SLDPRT
КЧ/Case Joker 40mm/Bezel Joker 40 mm.SLDPRT
КЧ/Путник 2/пряжка 18,2мм/Ось пряжки.SLDPRT
сфинкс/корпус стойки/лицевая панель.SLDPRT
сфинкс/рабочий стол/оснастка Ракета мост 2 шт.SLDPRT
сфинкс/Центр_прототипирования/Y.SLDPRT
GRINDING.SLDPRT
Ivan/корпус.SLDPRT
КЧ/Case Joker 40mm/K.18-0.CASE.02.02 Button stem.SLDPRT
КЧ/Путник 2/пряжка 18,2мм/К.10-2.CASE.00.12 пряжка боковина.SLDPRT
сфинкс/корпус стойки/низ.SLDPRT
сфинкс/ПлитаХ.SLDPRT
сфинкс/рабочий стол/оснастка_отработка.SLDPRT
сфинкс/Центр_прототипирования/Х.SLDPRT
сфинкс/шаговик_40мм/Тело2.SLDPRT
КЧ/Case Joker 40mm/K.18-18.CASE.01.01 Корпус.SLDPRT
КЧ/Мост/K.18-18.MVMT.06.01. мост.SLDPRT
сфинкс/Крышки/STEP/х3.STEP
сфинкс/портал Z.SLDPRT
сфинкс/рабочий стол/cote de geneve.SLDPRT
сфинкс/Центр_прототипирования/пластина 1.stl
сфинкс/шаговик_40мм/Разделить4[2].SLDPRT
шлифовка.SLDPRT
K.18-18.MVMT.06.01. мост.SLDPRT
КЧ/Мост/штифт.SLDPRT
КЧ/Путник 2/пряжка 18,2мм/Зеркально отразитьК.10-2.CASE.00.12 пряжка боковина.SLDPRT
сфинкс/Крышки/STEP/уП.STEP
сфинкс/Твердое тело1_1_3.stp.SLDPRT
сфинкс/Центр_прототипирования/Detal metall 3.stl
сфинкс/шаговик_40мм/Тело8.SLDPRT
КЧ/Case Joker 40mm/I-ring 33.SLDPRT
КЧ/Путник 2/пряжка 18,2мм/К.10-2.CASE.00.11 пряжка перекладина.SLDPRT
сфинкс/подшипник.SLDPRT
сфинкс/Центр_прототипирования/Detal metall 4.stl
сфинкс/шаговик_40мм/Тело13.SLDPRT
сфинкс/Твердое тело1_1_2.stp.SLDPRT
сфинкс/Центр_прототипирования/переделка деталь 5.stl
сфинкс/шаговик_40мм/Тело7.SLDPRT
1_1.dxf
Ivan/Стекло.SLDDRW
Ivan/Цанга под корпус.SLDDRW
Ivan/калибр механизм.SLDDRW
K.18-18.MVMT.06.01. мост.DXF
КЧ/Case Joker 40mm/1,0х0,5 Кольцо уплотнительное.SLDDRW
КЧ/Case Joker 40mm/1,0х0,5 Кольцо уплотнительное.SLDPRT
КЧ/Case Joker 40mm/2,40,6 Кольцо уплотнительное.SLDDRW
КЧ/Case Joker 40mm/2,40,6 Кольцо уплотнительное.SLDPRT
КЧ/Case Joker 40mm/Bezel Joker 40 mm.SLDDRW
КЧ/Case Joker 40mm/Bezel screw М1,0х1,7 - 1,4х0,5.SLDDRW
КЧ/Case Joker 40mm/Bezel screw М1,0х1,7 - 1,4х0,5.SLDPRT
КЧ/Case Joker 40mm/Case Joker 40 LJP.SLDDRW
КЧ/Case Joker 40mm/Case Joker 40 mm LJP.SLDDRW
КЧ/Case Joker 40mm/Case Joker 40 mm.SLDPRT
КЧ/Case Joker 40mm/Caseback screw М1.2 х 2,2 -1,8х0,45.SLDPRT
КЧ/Case Joker 40mm/Glass.SLDDRW
КЧ/Case Joker 40mm/Glass.SLDPRT
КЧ/Case Joker 40mm/I-ring 25,5мм.SLDDRW
КЧ/Case Joker 40mm/I-ring 25,5мм.SLDPRT
КЧ/Case Joker 40mm/I-ring 33.SLDDRW
КЧ/Case Joker 40mm/K.18-0.CASE.01.05 Crown.SLDDRW
КЧ/Case Joker 40mm/K.18-0.CASE.01.05 Crown.SLDPRT
КЧ/Case Joker 40mm/K.18-0.CASE.01.06 shim.SLDDRW
КЧ/Case Joker 40mm/K.18-0.CASE.01.06 shim.SLDPRT
КЧ/Case Joker 40mm/K.18-0.CASE.01.07 tube.SLDDRW
КЧ/Case Joker 40mm/K.18-0.CASE.01.07 tube.SLDPRT
КЧ/Case Joker 40mm/K.18-0.CASE.02.00 Button.SLDDRW
КЧ/Case Joker 40mm/K.18-0.CASE.02.01 Crown 2.SLDDRW
КЧ/Case Joker 40mm/K.18-0.CASE.02.01 Crown 2.SLDPRT
КЧ/Case Joker 40mm/K.18-0.CASE.02.02 Button stem.SLDDRW
КЧ/Case Joker 40mm/K.18-0.CASE.02.03 shim.SLDDRW
КЧ/Case Joker 40mm/K.18-0.CASE.02.03 shim.SLDPRT
КЧ/Case Joker 40mm/K.18-0.CASE.02.04 spring.SLDDRW
КЧ/Case Joker 40mm/K.18-0.CASE.02.04 spring.SLDPRT
КЧ/Case Joker 40mm/K.18-11.CASE.02.00 Button.SLDDRW
КЧ/Case Joker 40mm/K.18-11.CASE.02.01 Crown 2.SLDDRW
КЧ/Case Joker 40mm/K.18-11.CASE.02.01 Crown 2.SLDPRT
КЧ/Case Joker 40mm/K.18-11.CASE.02.02 Button stem.SLDDRW
КЧ/Case Joker 40mm/K.18-11.CASE.02.02 Button stem.SLDPRT
КЧ/Case Joker 40mm/K.18-11.CASE.02.02 шток кнопки.SLDDRW
КЧ/Case Joker 40mm/K.18-11.CASE.02.02 шток кнопки.SLDPRT
КЧ/Case Joker 40mm/K.18-18.CASE.01.01 Case (Eng).SLDDRW
КЧ/Case Joker 40mm/K.18-18.CASE.01.01 Корпус.SLDDRW
КЧ/Case Joker 40mm/K.18-18.CASE.01.02 Крышка.SLDDRW
КЧ/Case Joker 40mm/K.18-18.CASE.01.02 Крышка.SLDPRT
КЧ/Case Joker 40mm/K.18-18.CASE.01.03 безель.SLDDRW
КЧ/Case Joker 40mm/K.18-18.CASE.01.03 безель.SLDPRT
КЧ/Case Joker 40mm/K.18-18.CASE.02.00 Кнопка.SLDDRW
КЧ/Case Joker 40mm/K.18-18.CASE.02.01 корпус кнопки.SLDDRW
КЧ/Case Joker 40mm/K.18-18LJP.CASE.01.01 Joker 40 LJP.SLDDRW
КЧ/Case Joker 40mm/K.18-18LJP.CASE.01.01 Joker 40 LJP.SLDPRT
КЧ/Case Joker 40mm/K.18-18LJP.CASE.01.01 Корпус.SLDDRW
КЧ/Case Joker 40mm/K.18-18LJP.CASE.01.01 Корпус.SLDPRT
КЧ/Case Joker 40mm/K.18-18LJP.CASE.01.02 case back Joker 40 LJP.SLDDRW
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
