sergei-tiutriumov/Finishing/КЧ/Путник 2/коробка/packaging_printing1.jpg

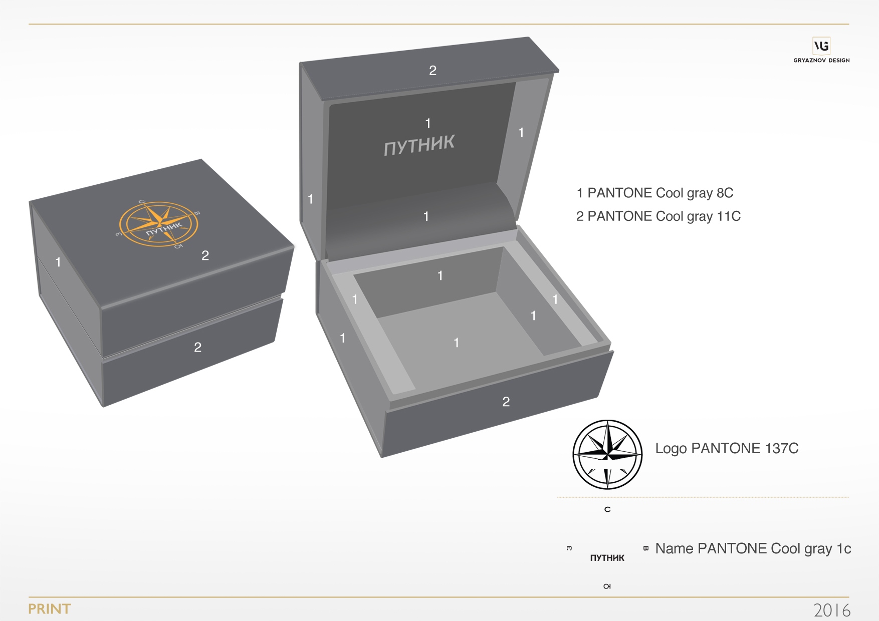
КЧ/Путник 2/коробка/packaging_printing1.jpg
