sergei-tiutriumov/Finishing/КЧ/Путник 2/ПУТНИК 2.pdf

Dial v.1 | main field | inner bezel

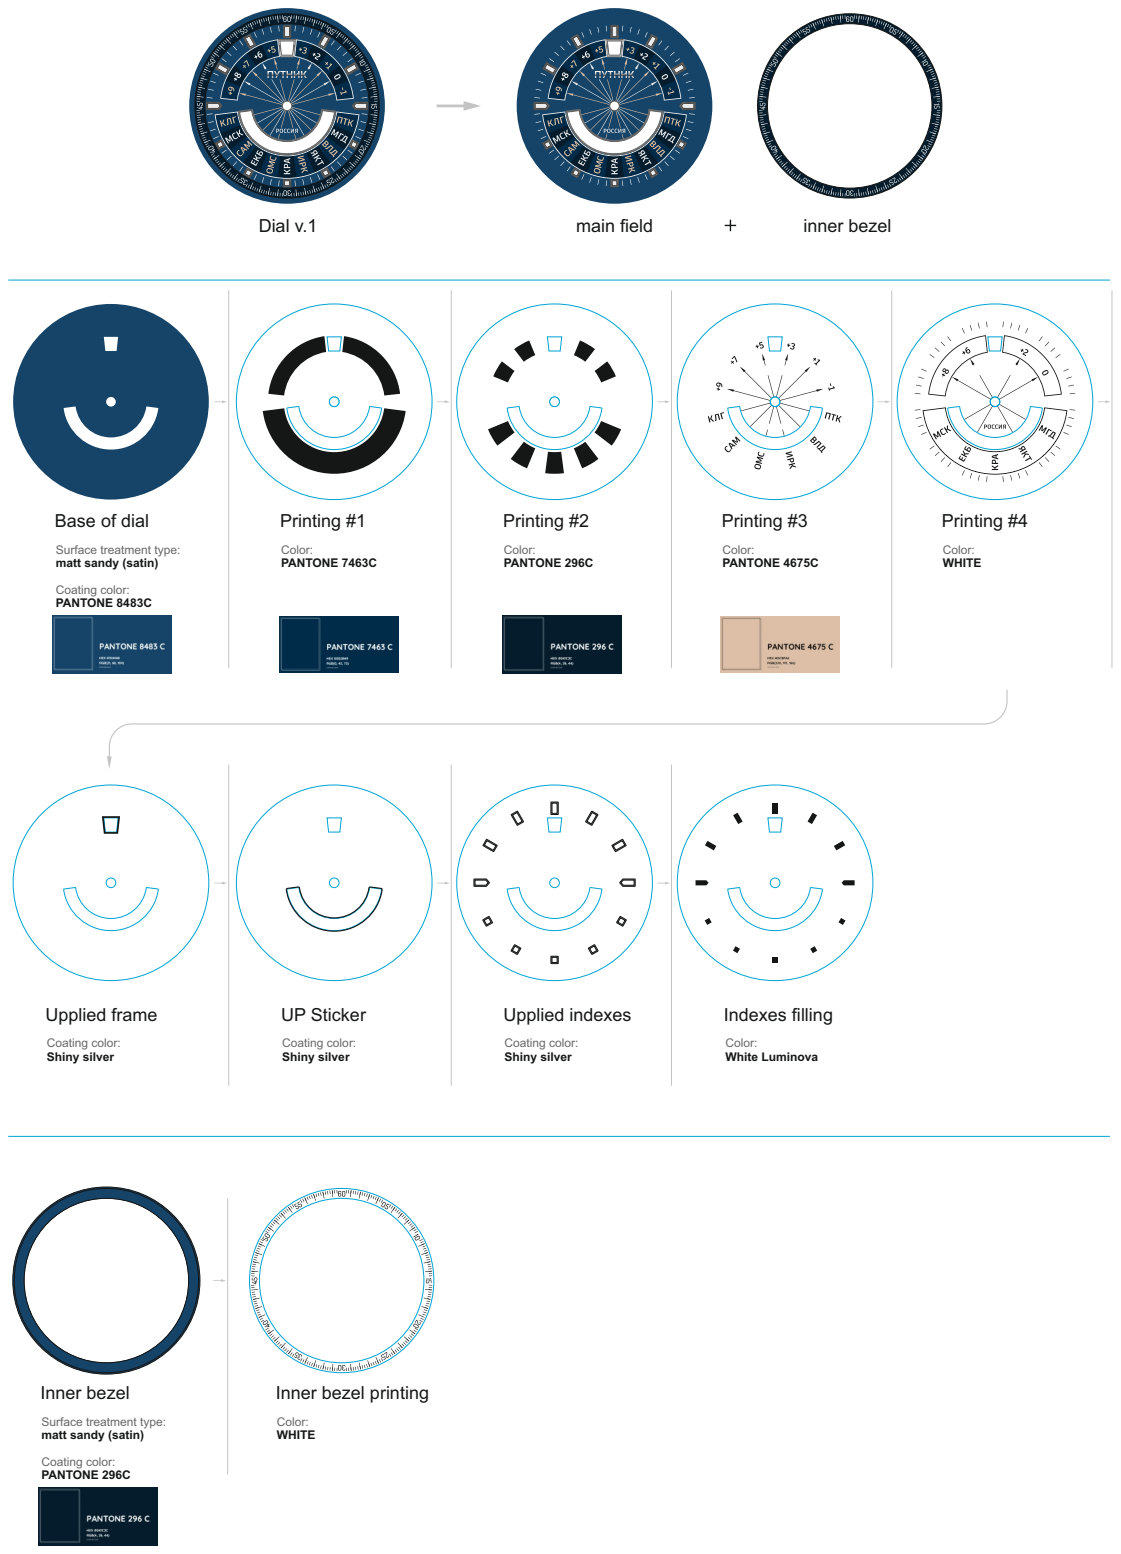
[picture p302: page 1]
Coating color: PANTONE 8483C; Printing #1; Color: PANTONE 7463C; Printing #2; Color: PANTONE 296C; Printing #3; Color: PANTONE 4675C; Printing #4; Color: WHITE; Inner bezel; Coating color: PANTONE 296C; UP Sticker; Coating color: Shiny silver; Upplied indexes; Indexes filling; Color: White Luminova; Upplied frame

Base of dial

Surface treatment type:
matt sandy (satin)

Inner bezel printing

Dial v.2 | main field | inner bezel

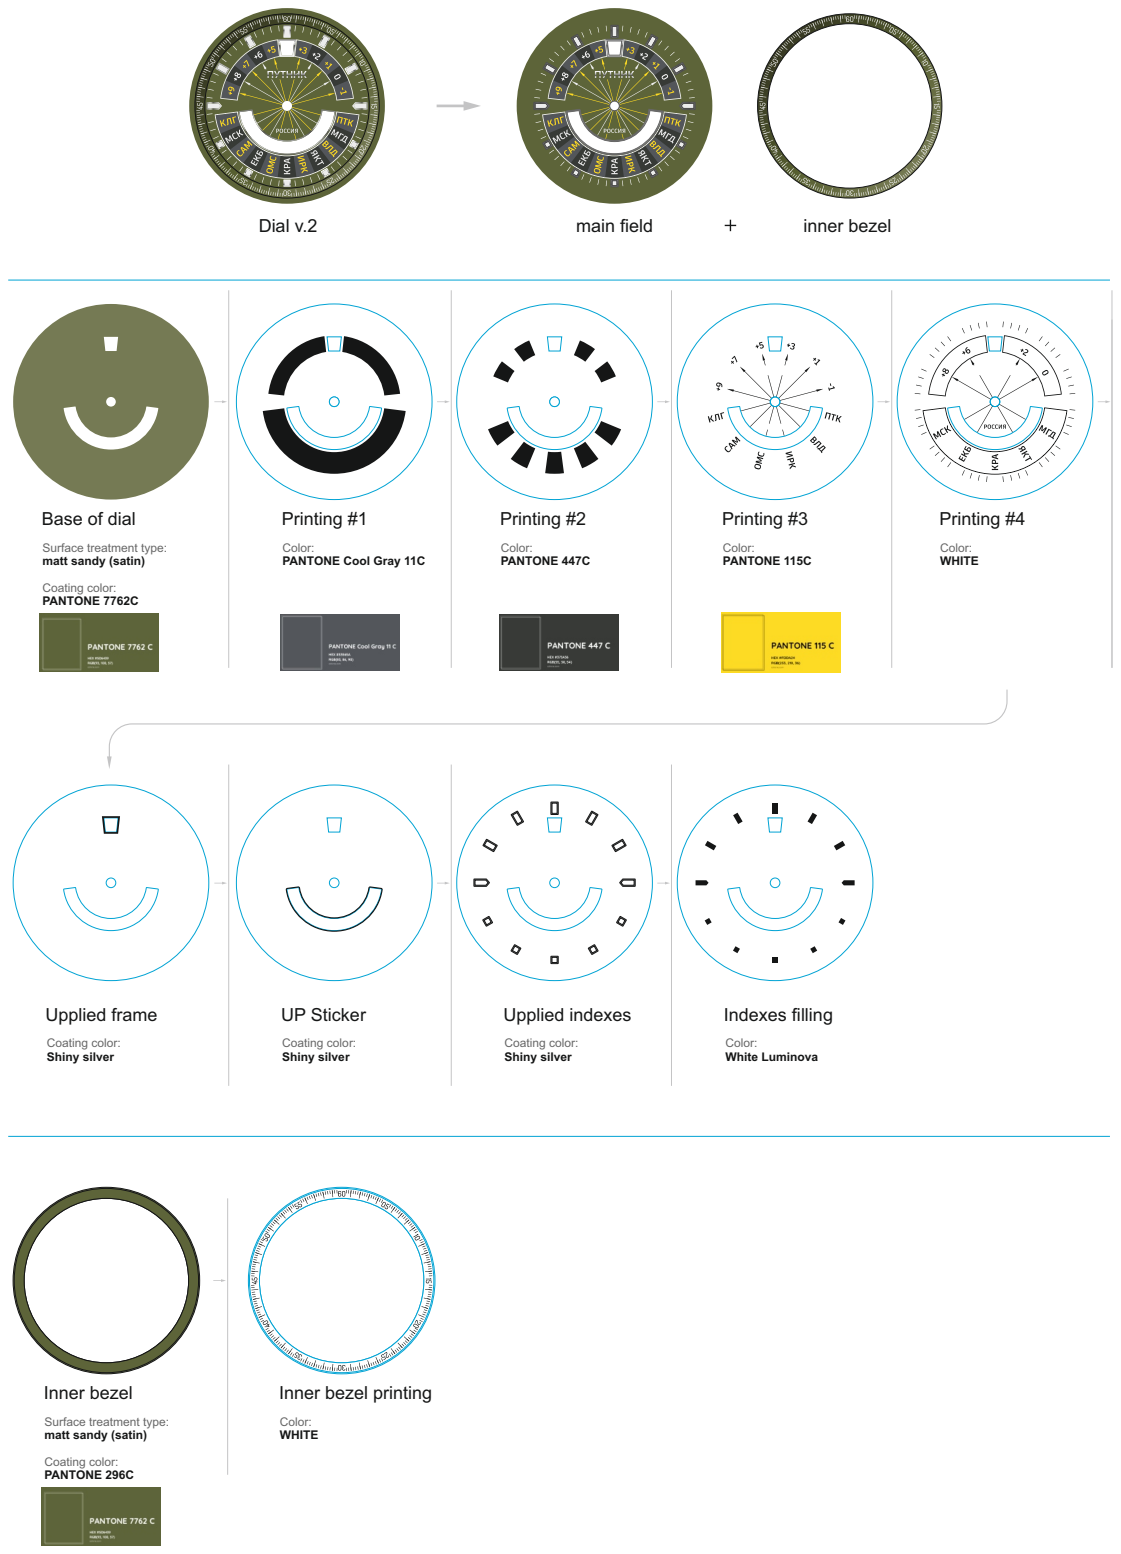
[picture p303: page 2]
Coating color: PANTONE 7762C; Printing #1; Printing #2; Color: PANTONE 447C; Printing #3; Color: PANTONE 115C; Printing #4; Color: WHITE; Inner bezel; Coating color:; UP Sticker; Coating color: Shiny silver; Upplied indexes; Indexes filling; Color: White Luminova; Upplied frame

Base of dial

Surface treatment type:
matt sandy (satin)

Color:
PANTONE Cool Gray 11C

Inner bezel printing

Dial v.3 | main field | inner bezel

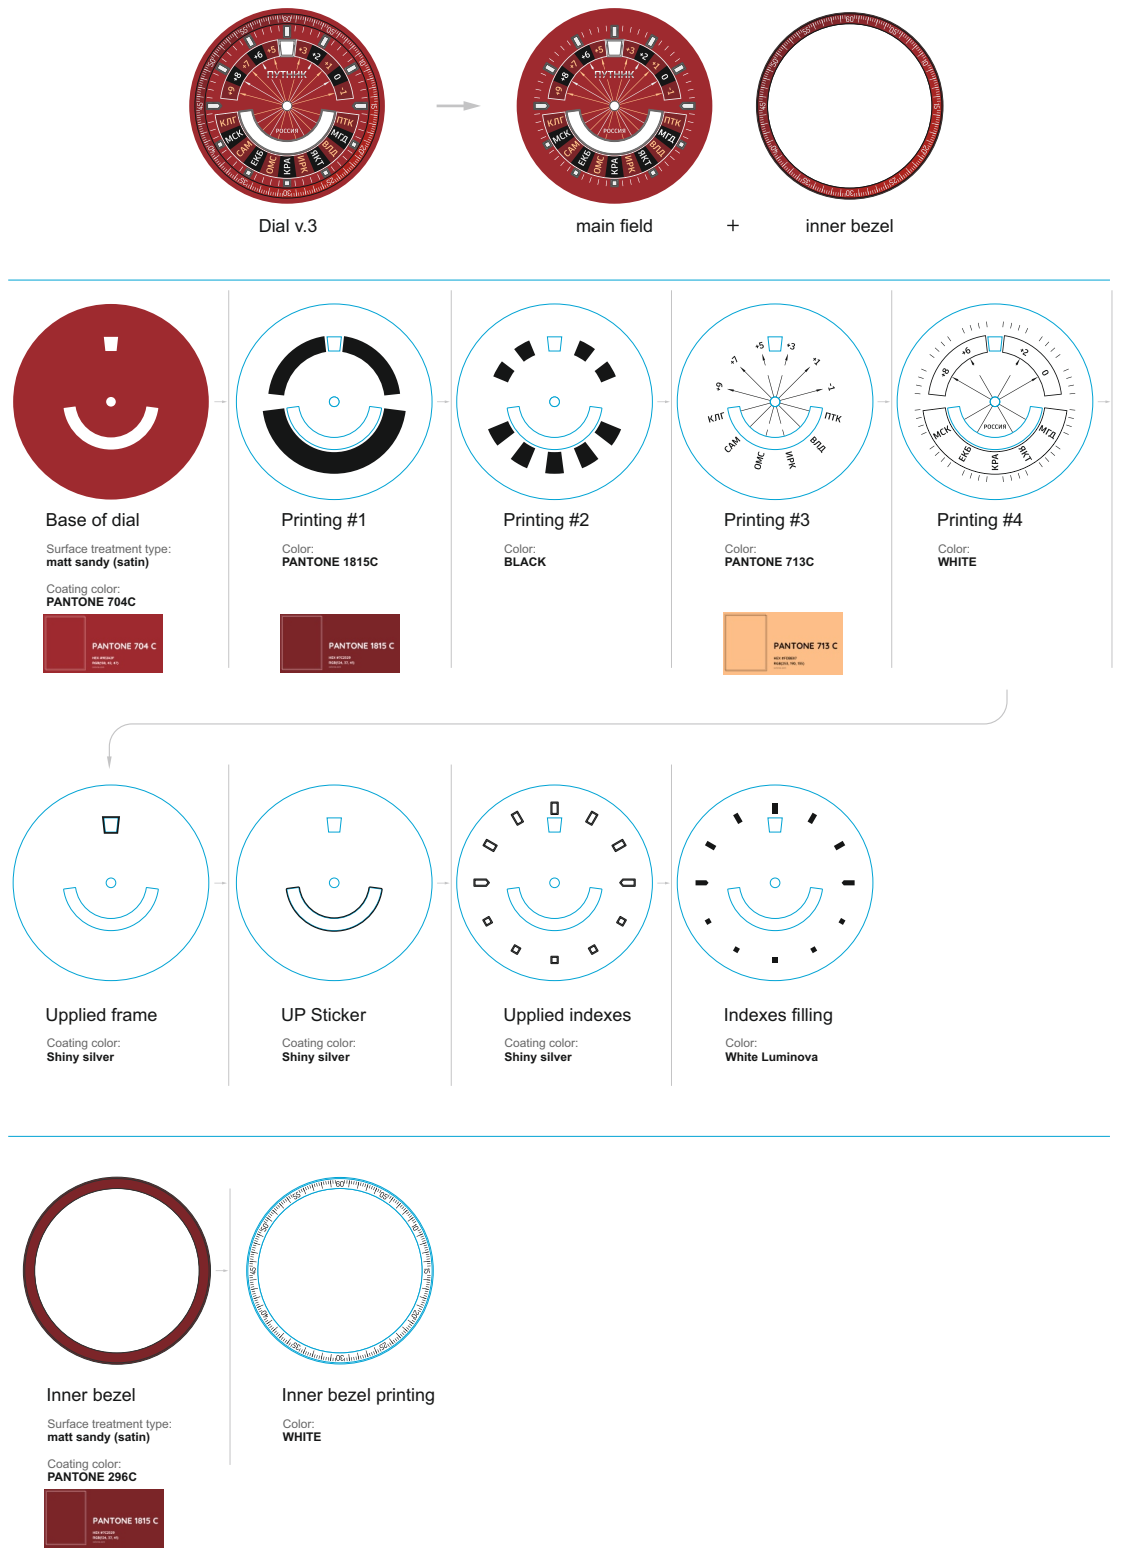
[picture p304: page 3]
Coating color: PANTONE 704C; Printing #1; Color: PANTONE 1815C; Printing #2; Color: BLACK; Printing #3; Color: PANTONE 713C; Printing #4; Color: WHITE; UP Sticker; Coating color: Shiny silver; Upplied indexes; Indexes filling; Color: White Luminova; Upplied frame; Inner bezel; Coating color:

Base of dial

Surface treatment type:
matt sandy (satin)

Inner bezel printing

Dial v.4 | main field | inner bezel

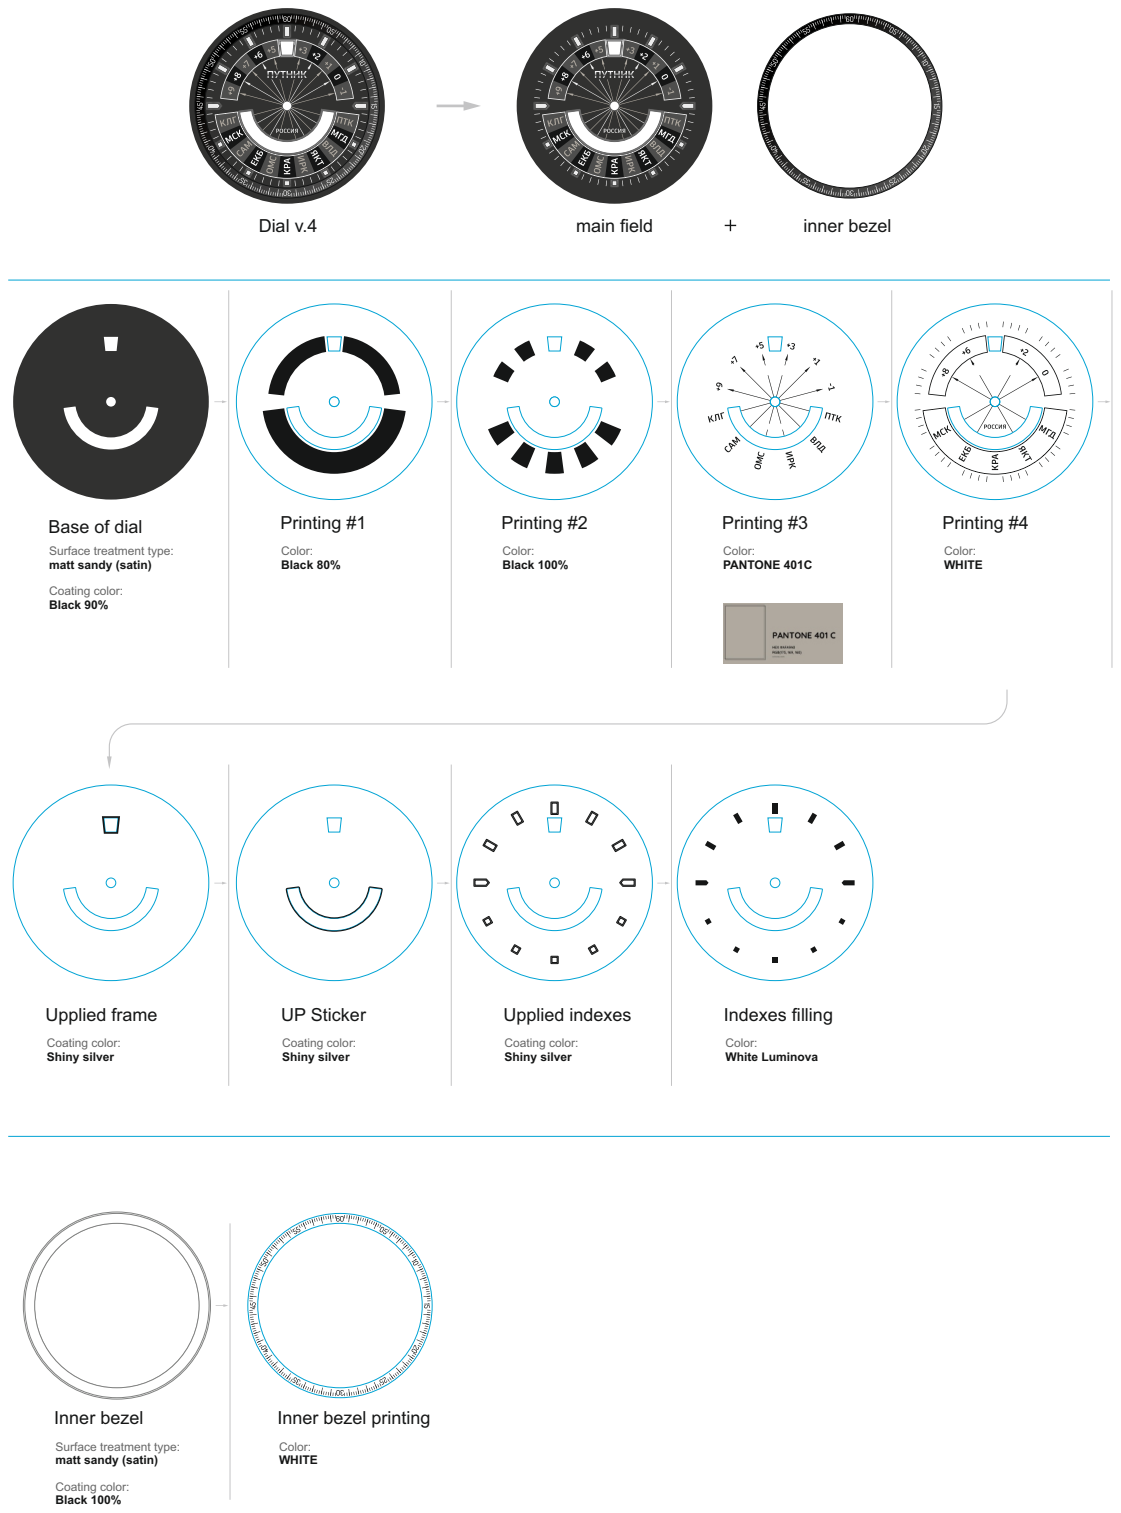
[picture p305: page 4]
Coating color: Black 90%; Printing #1; Color: Black 80%; Printing #2; Color: Black 100%; Color: WHITE; Coating color: Black 100%; Base of dial; Printing #3; Color: PANTONE 401C; Printing #4; Inner bezel; Inner bezel printing; UP Sticker; Coating color: Shiny silver; Upplied indexes; Indexes filling; Color: White Luminova; Upplied frame

Surface treatment type:
matt sandy (satin)

Dial v.5 | main field | inner bezel

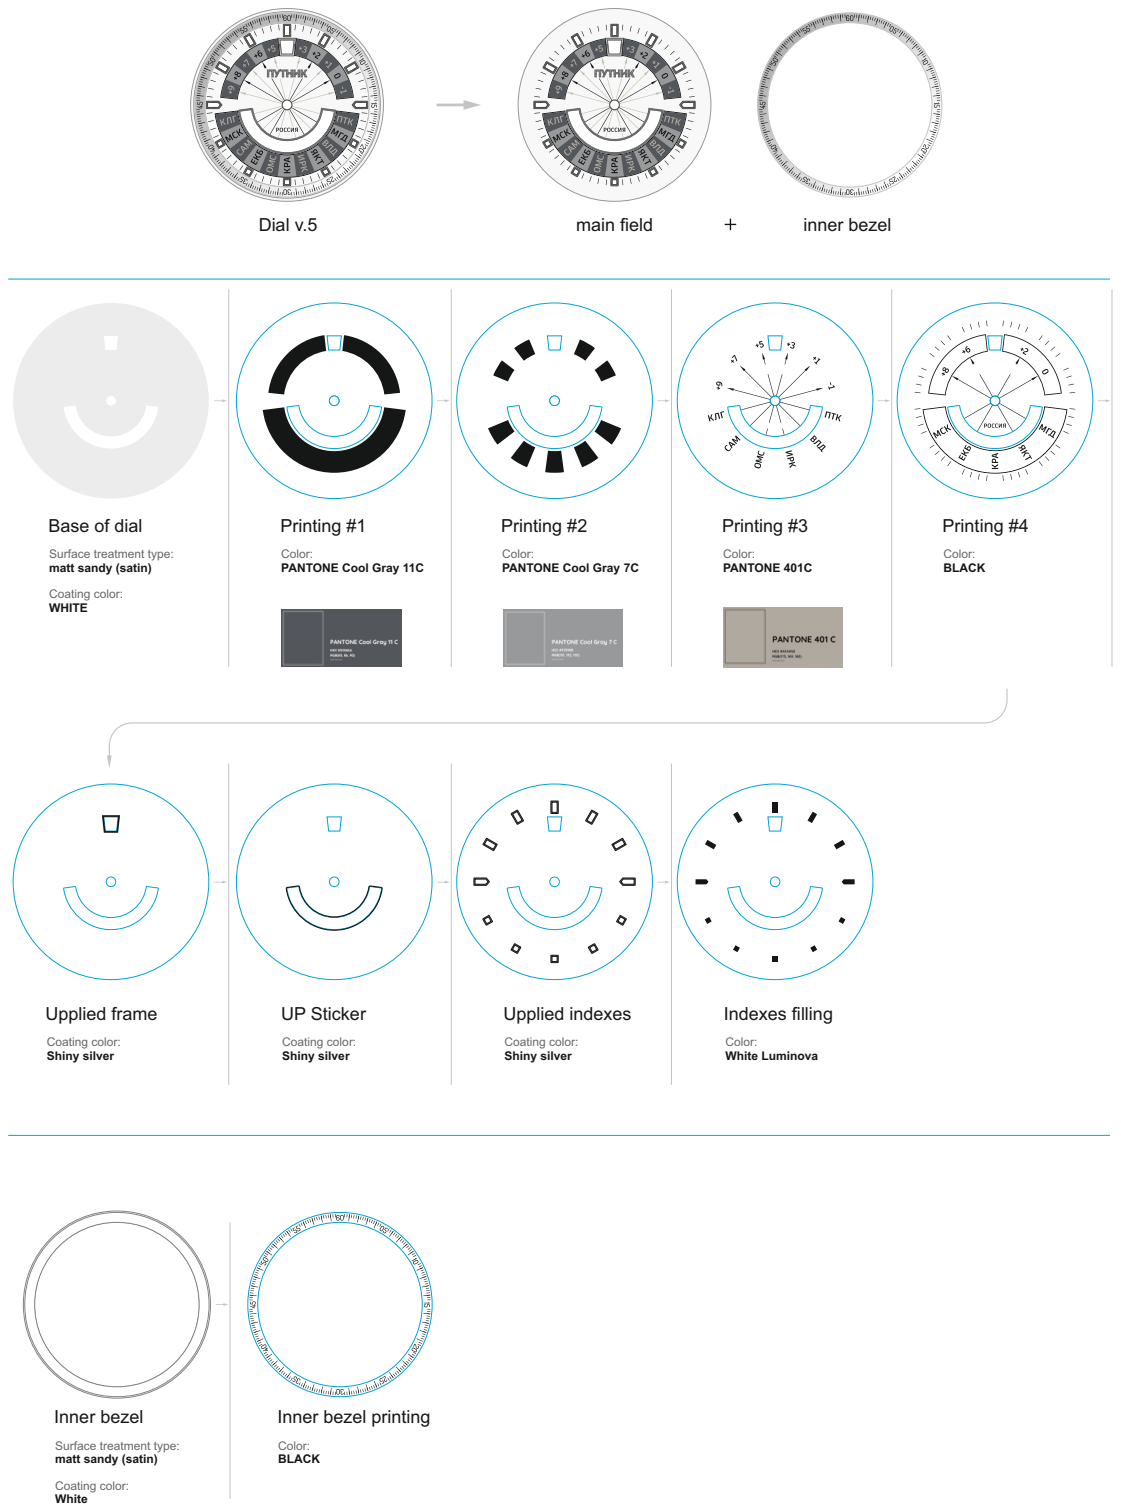
[picture p306: page 5]
Coating color: WHITE; Printing #1; Printing #3; Color: PANTONE 401C; Printing #4; Color: BLACK; Inner bezel; Coating color: White; Printing #2; UP Sticker; Coating color: Shiny silver; Upplied indexes; Indexes filling; Color: White Luminova; Upplied frame

Base of dial

Surface treatment type:
matt sandy (satin)

Color:
PANTONE Cool Gray 11C

PANTONE Cool Gray 7C

Inner bezel printing

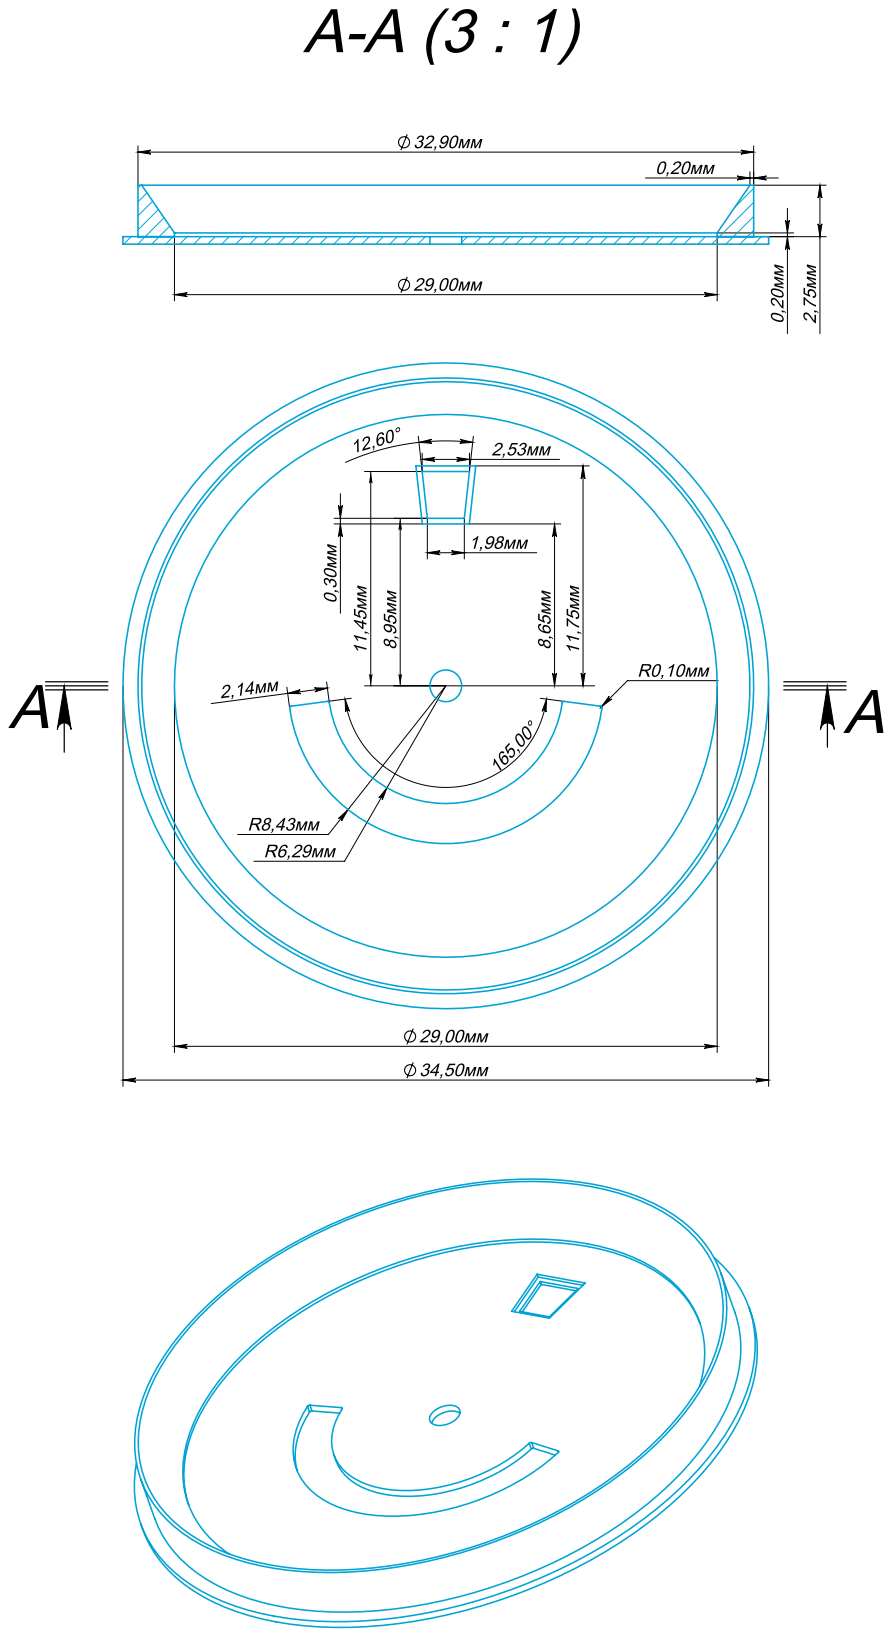
[picture p307: page 6]

# Applied indexes: 3 / 9 hours

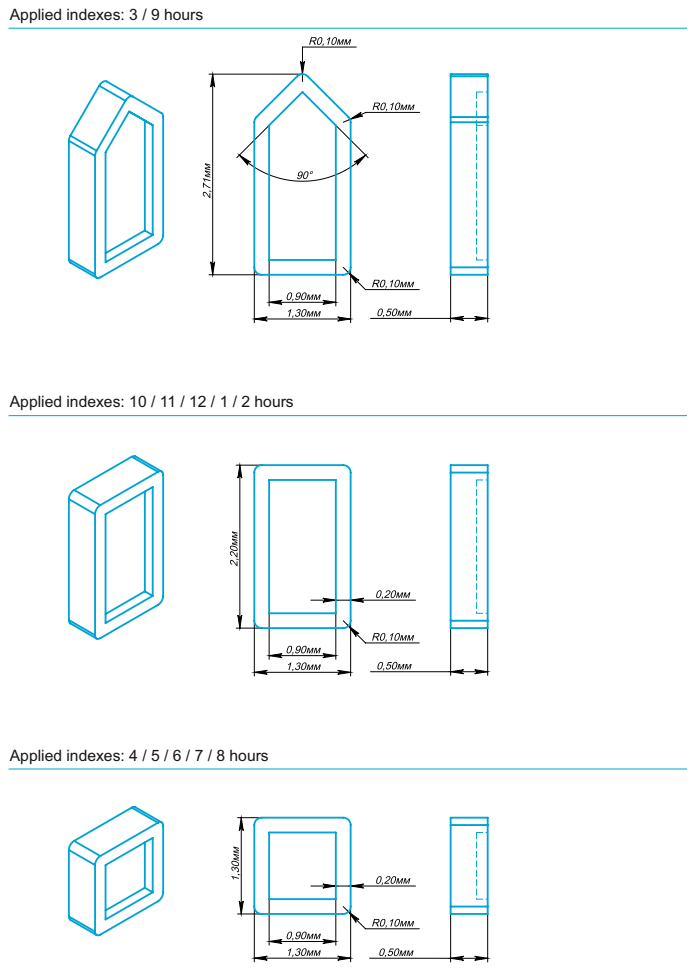
[picture p308: page 7]

Applied indexes: 10 / 11 / 12 / 1 / 2 hours

Applied indexes: 4 / 5 / 6 / 7 / 8 hours
