sergei-tiutriumov/Finishing/Суханов/Коробка Суханов/box closed.PDF

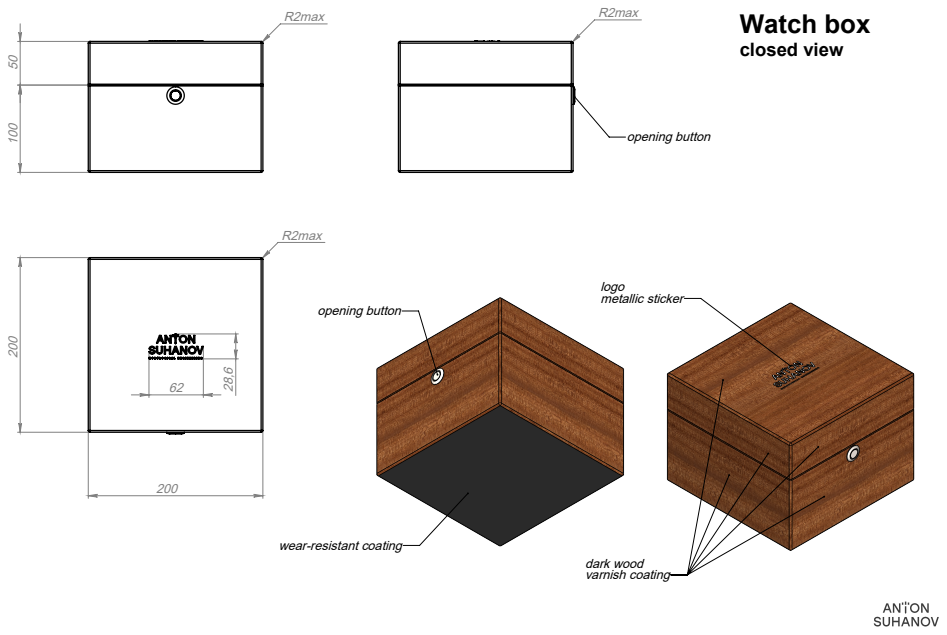
[picture p309: page 1]
opening button; metallic sticker; dark wood varnish coating; Watch box closed view

wear-resistant coating
