sergei-tiutriumov/Finishing/КЧ/Путник 2/сборка/S928G.pdf

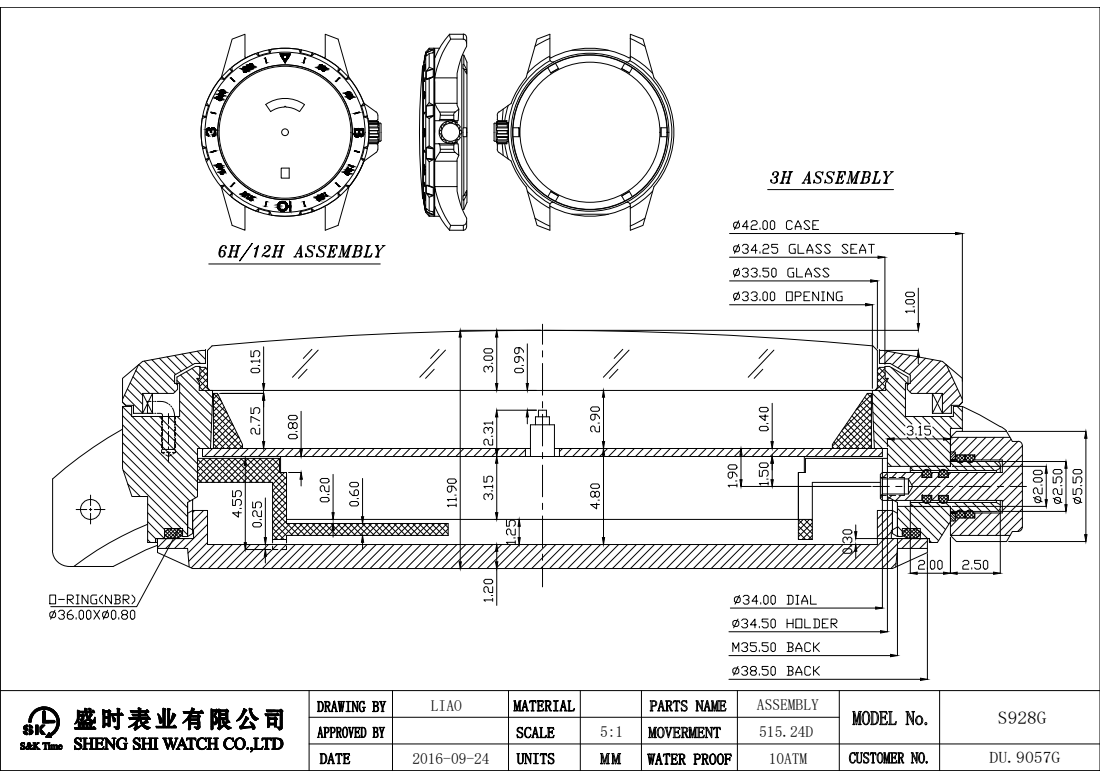
[picture p310: page 1]
10ATM 5:1 2016-09-24; ASSEMBLY; S928G LIAO

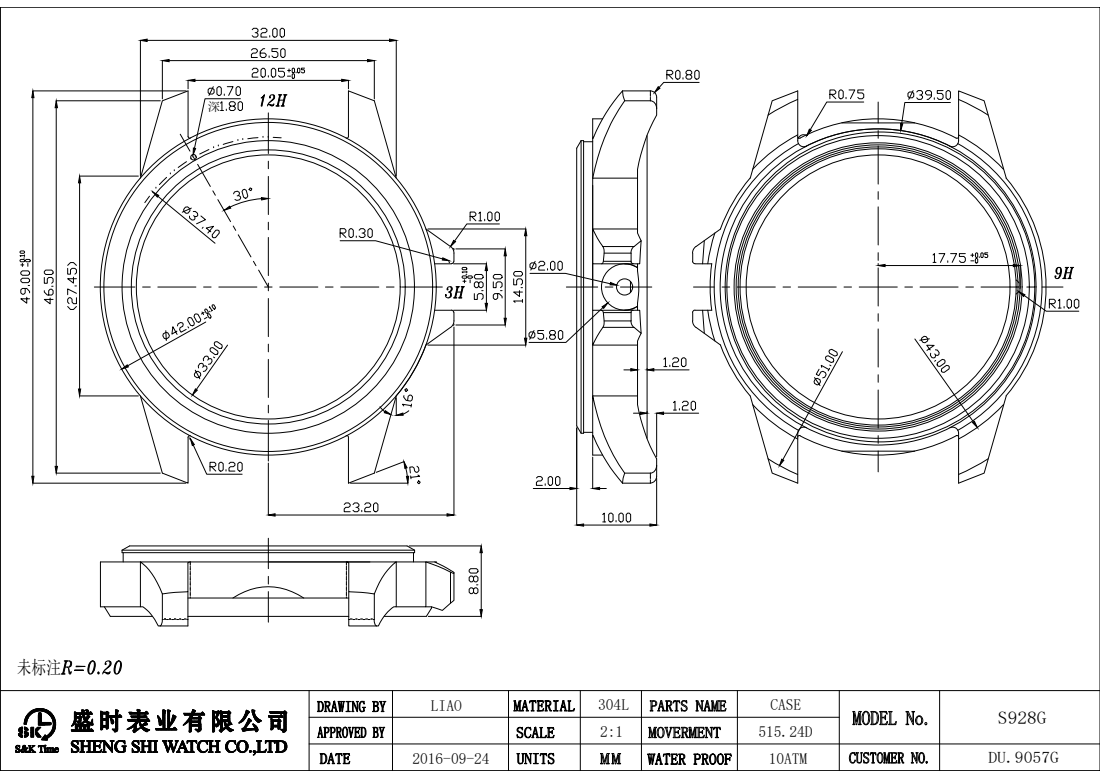
[picture p311: page 2]
未标注; 10ATM 2:1 2016-09-24; CASE; S928G LIAO

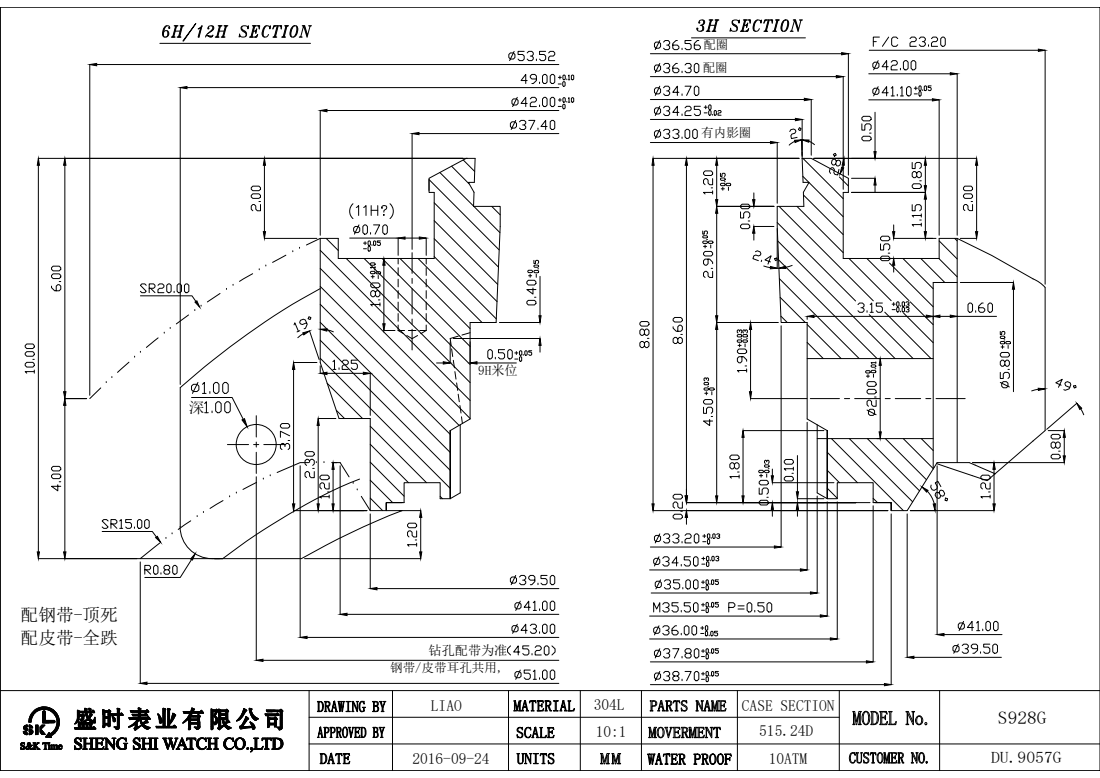
[picture p312: page 3]
10ATM 10:1 2016-09-24; CASE SECTION; S928G LIAO; DU.9057G 515.24D 304L 钢带/皮带耳孔共用,; 配钢带-顶死 配皮带-全跌; 钻孔配带为准; 9H米位; 有内影圈

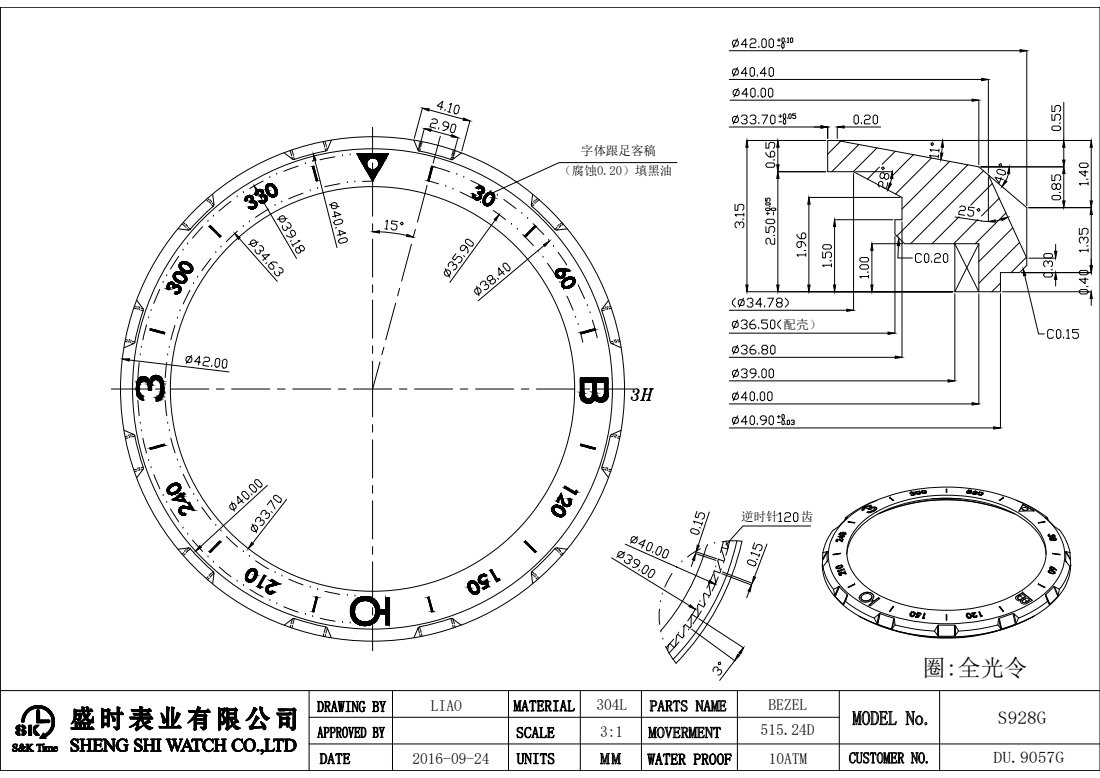
[picture p313: page 4]
10ATM 3:1 2016-09-24; BEZEL; S928G LIAO; 圈:全光令; 逆时针; 字体跟足客稿; （腐蚀0.20）填黑油

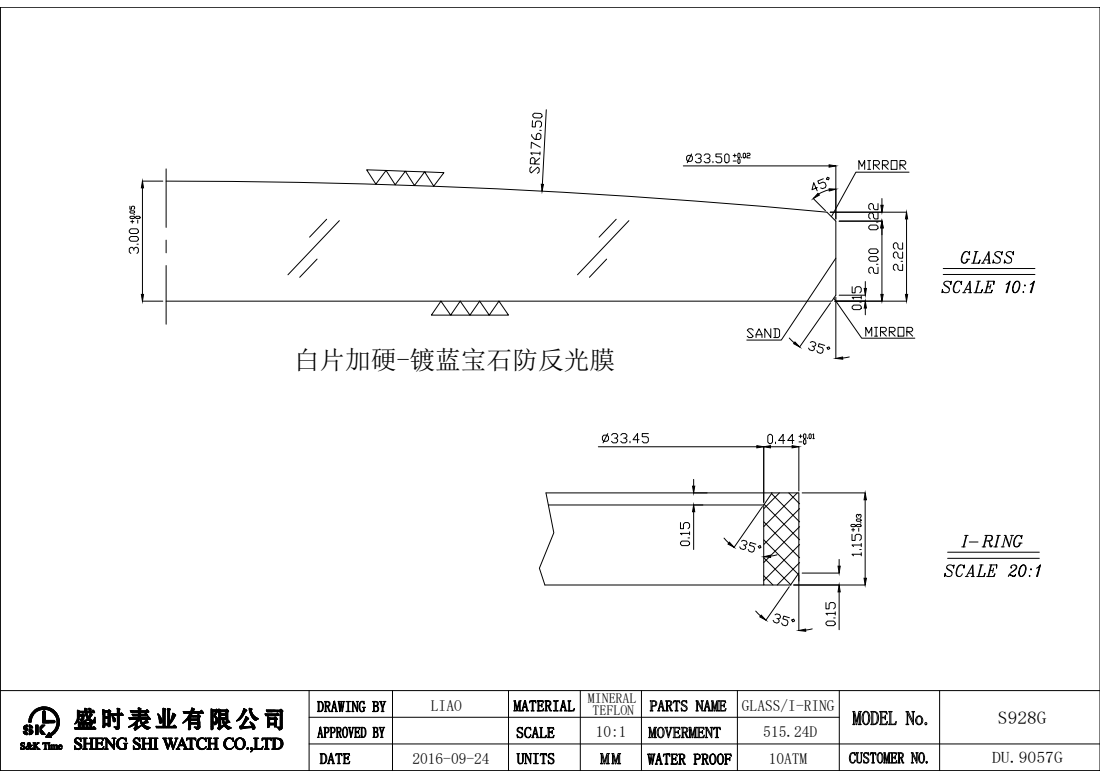
[picture p314: page 5]
10ATM 10:1 2016-09-24; GLASS/I-RING; S928G LIAO; DU.9057G 515.24D MINERAL TEFLON 白片加硬-镀蓝宝石防反光膜

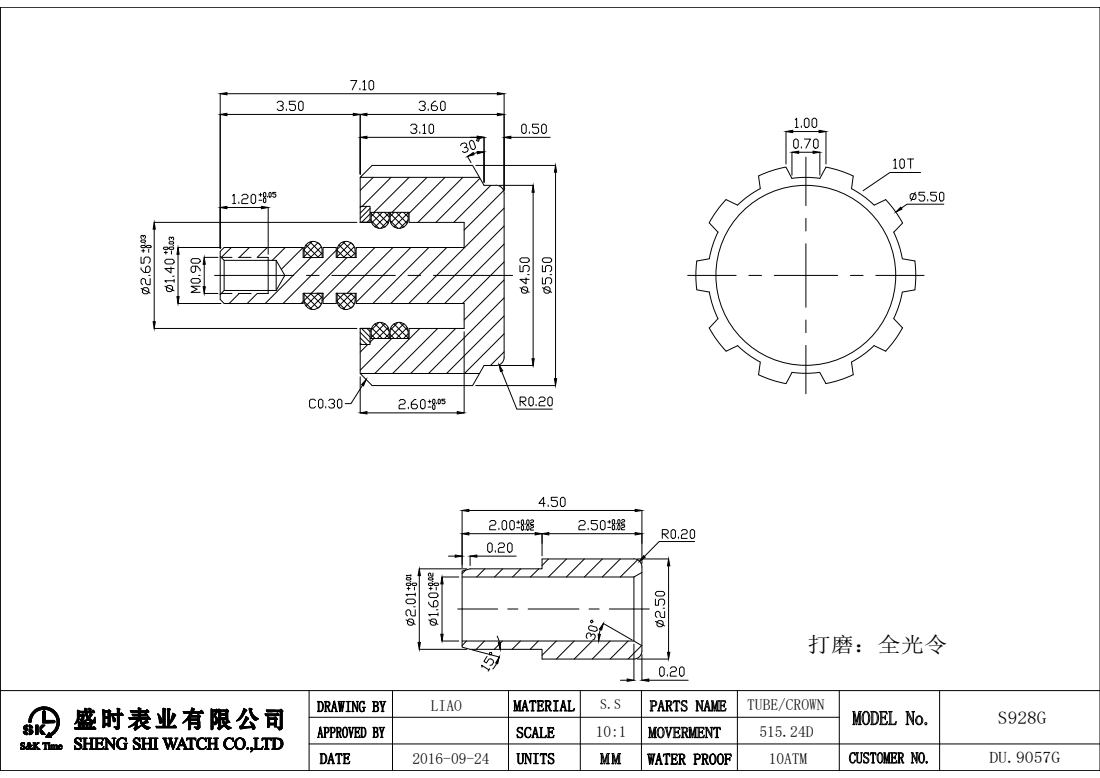
[picture p315: page 6]
10ATM 10:1 2016-09-24; TUBE/CROWN; S928G LIAO; 打磨：全光令

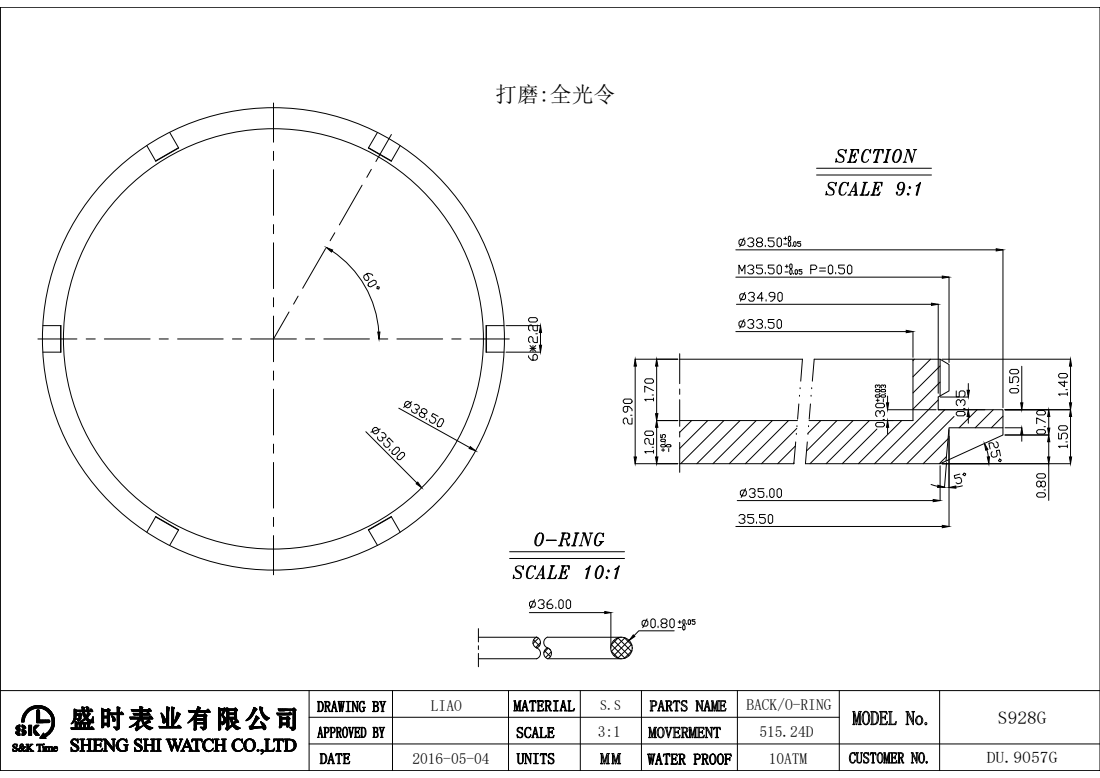
[picture p316: page 7]
10ATM 3:1 2016-05-04; BACK/O-RING; S928G LIAO; DU.9057G 515.24D S.S 打磨:全光令

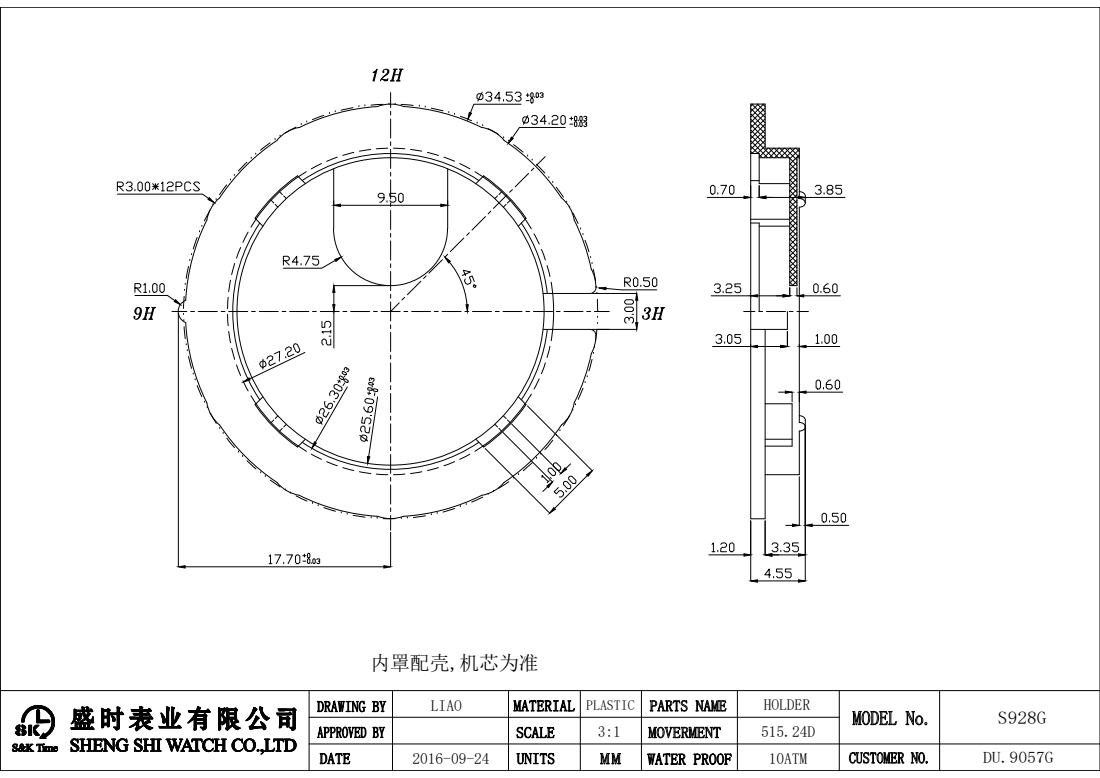
[picture p317: page 8]
10ATM; HOLDER; S928G LIAO; DU.9057G 515.24D PLASTIC 内罩配壳,机芯为准

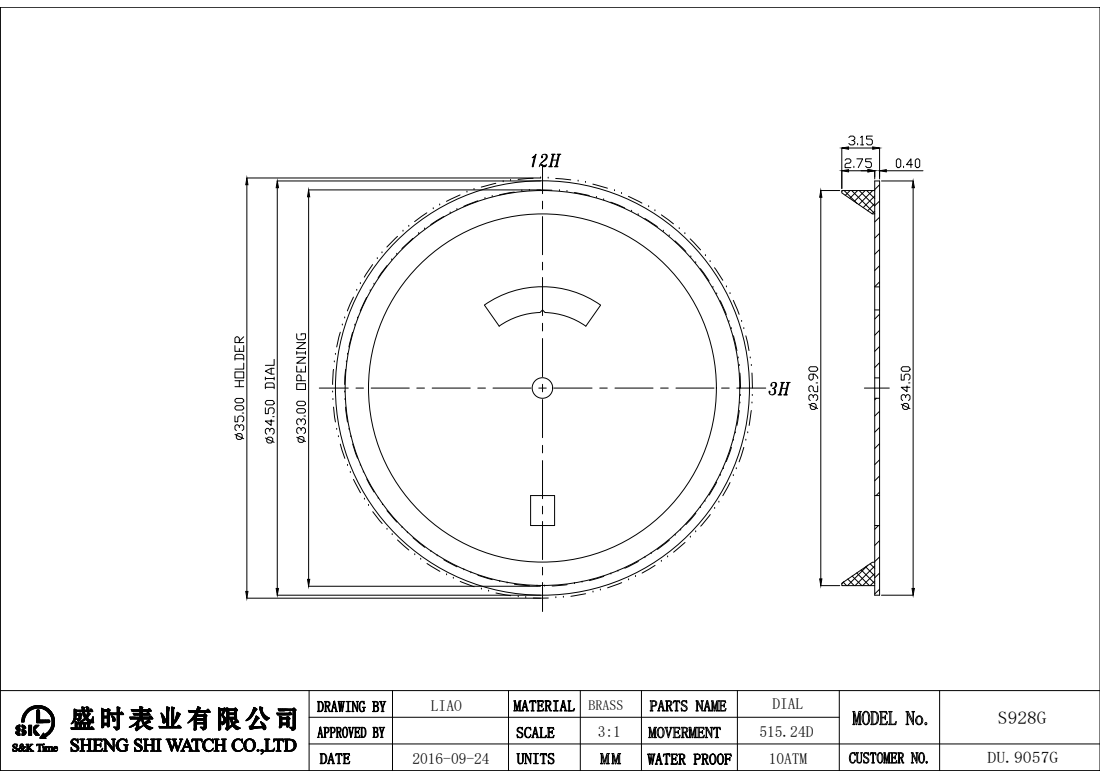
[picture p318: page 9]
10ATM 3:1 2016-09-24; DIAL; S928G LIAO; DU.9057G 515.24D BRASS

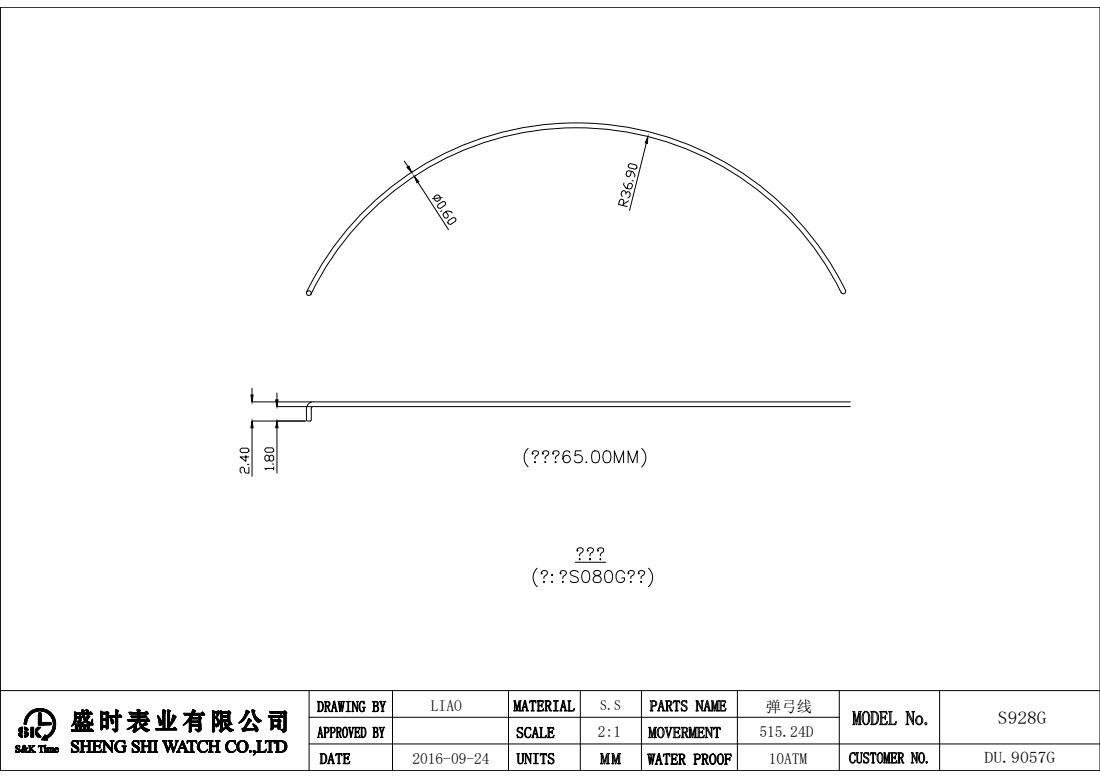
[picture p319: page 10]
10ATM 2:1 2016-09-24; 弹弓线; S928G LIAO
