sergei-tiutriumov/Finishing/КЧ/Case Joker 40mm/Заготовки/K.18-18.CASE.01.01 Корпус (токарная заготовка)..PDF

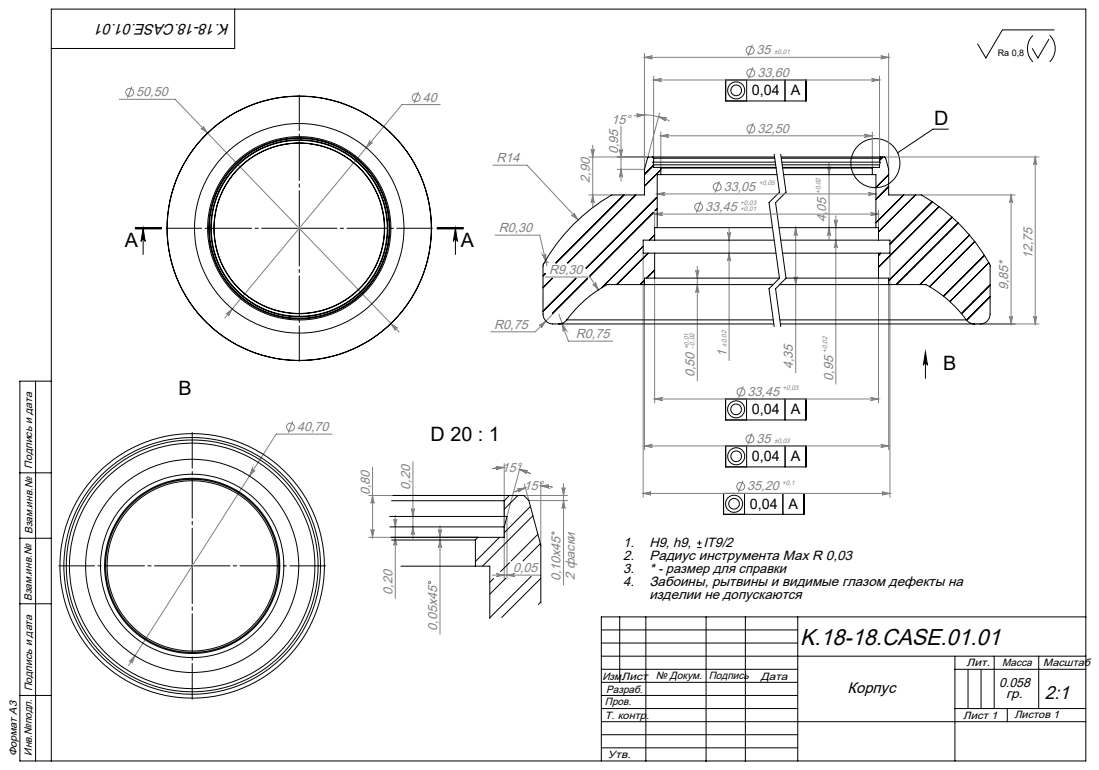
[picture p320: page 1]
2 фаски; Формат А3

Инв.№подл. Подпись и дата Взам.инв.№ Подпись и дата Взам.инв.№

2. Радиус инструмента Max R 0,03
3. * - размер для справки
4. Забоины, рытвины и видимые глазом дефекты на
изделии не допускаются

K.18-18.CASE.01.01

Изм.Лист № Докум. Подпись Дата | | | 0.058 гр. | 2:1
Разраб.
Пров.
Т. контр. | Лист 1 | Листов 1

Корпус
