sergei-tiutriumov/Finishing/КЧ/Case Joker 40mm/Заготовки/K.18-18.CASE.01.02 Крышка (токарная заготовка)..PDF

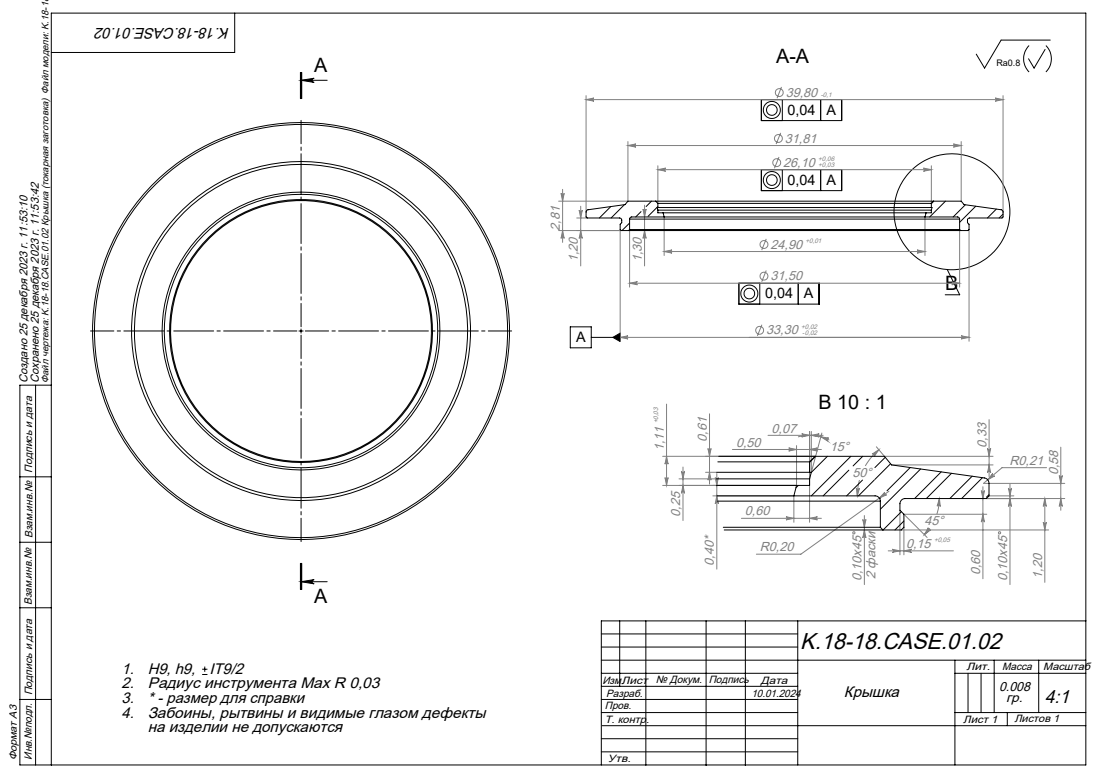
[picture p321: page 1]
2 фаски; Создано 25 декабря 2023 г. 11:53:10; Сохранено 25 декабря 2023 г. 11:53:42; Формат А3

Файл чертежа: K.18-18.CASE.01.02 Крышка (токарная заготовка) Файл модели: K.18-18.CASE.01.02 Крышка

Инв.№подл. Подпись и дата Взам.инв.№ Подпись и дата Взам.инв.№

K.18-18.CASE.01.02

2. Радиус инструмента Max R 0,03
3. * - размер для справки
4. Забоины, рытвины и видимые глазом дефекты
на изделии не допускаются

Изм.Лист № Докум. Подпись Дата | 10.01.2024 | | | 0.008 гр. | 4:1
Разраб.
Пров.
Т. контр. | | Лист 1 | Листов 1

Крышка
