sergei-tiutriumov/Finishing/КЧ/Case Joker 40mm/Заготовки/K.18-18.CASE.01.03 безель (токарная заготовка)..PDF

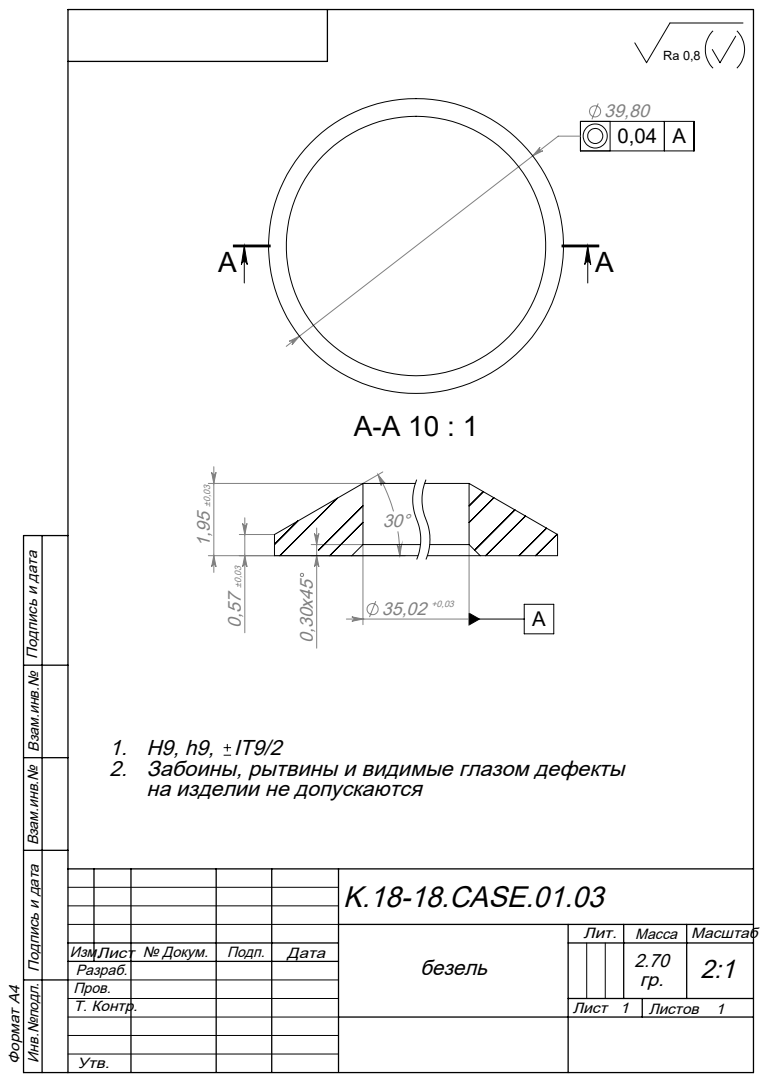
[picture p322: page 1]
Формат А4

Инв.№подл. Подпись и дата Взам.инв.№ Подпись и дата Взам.инв.№

2. Забоины, рытвины и видимые глазом дефекты
на изделии не допускаются

K.18-18.CASE.01.03

Изм.Лист № Докум. | | Подп. | Дата | | | 2.70 гр. | 2:1
Разраб.
Пров.
Т. Контр. | | | | Лист 1 | Листов 1

безель
