sergei-tiutriumov/Finishing/китаец/Высокий стол в тиски.pdf

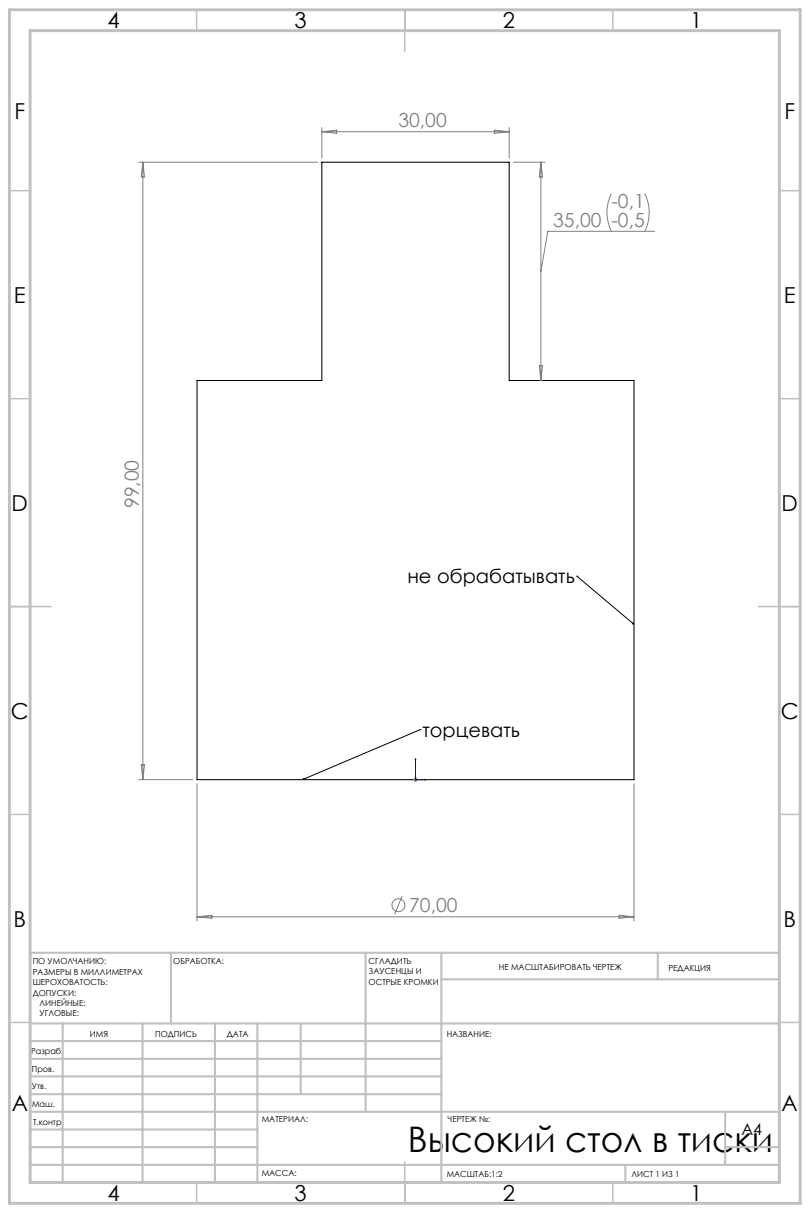
[picture p323: page 1]
не обрабатывать; МАСШТАБ:1:2; ЛИСТ 1 ИЗ 1; НЕ МАСШТАБИРОВАТЬ ЧЕРТЕЖ; РЕДАКЦИЯ; ЗАУСЕНЦЫ И ОСТРЫЕ КРОМКИ; ПО УМОЛЧАНИЮ:; ОБРАБОТКА:; РАЗМЕРЫ В МИЛЛИМЕТРАХ

ИМЯ | ПОДПИСЬ | ДАТА | | | | НАЗВАНИЕ:
Т.контр | | | | МАТЕРИАЛ: Высокий стол в тиски МАССА: | ЧЕРТЕЖ №: | A4

Разраб.
Пров.
Утв.
Маш.
