sergei-tiutriumov/Finishing/китаец/рабочий стол.pdf

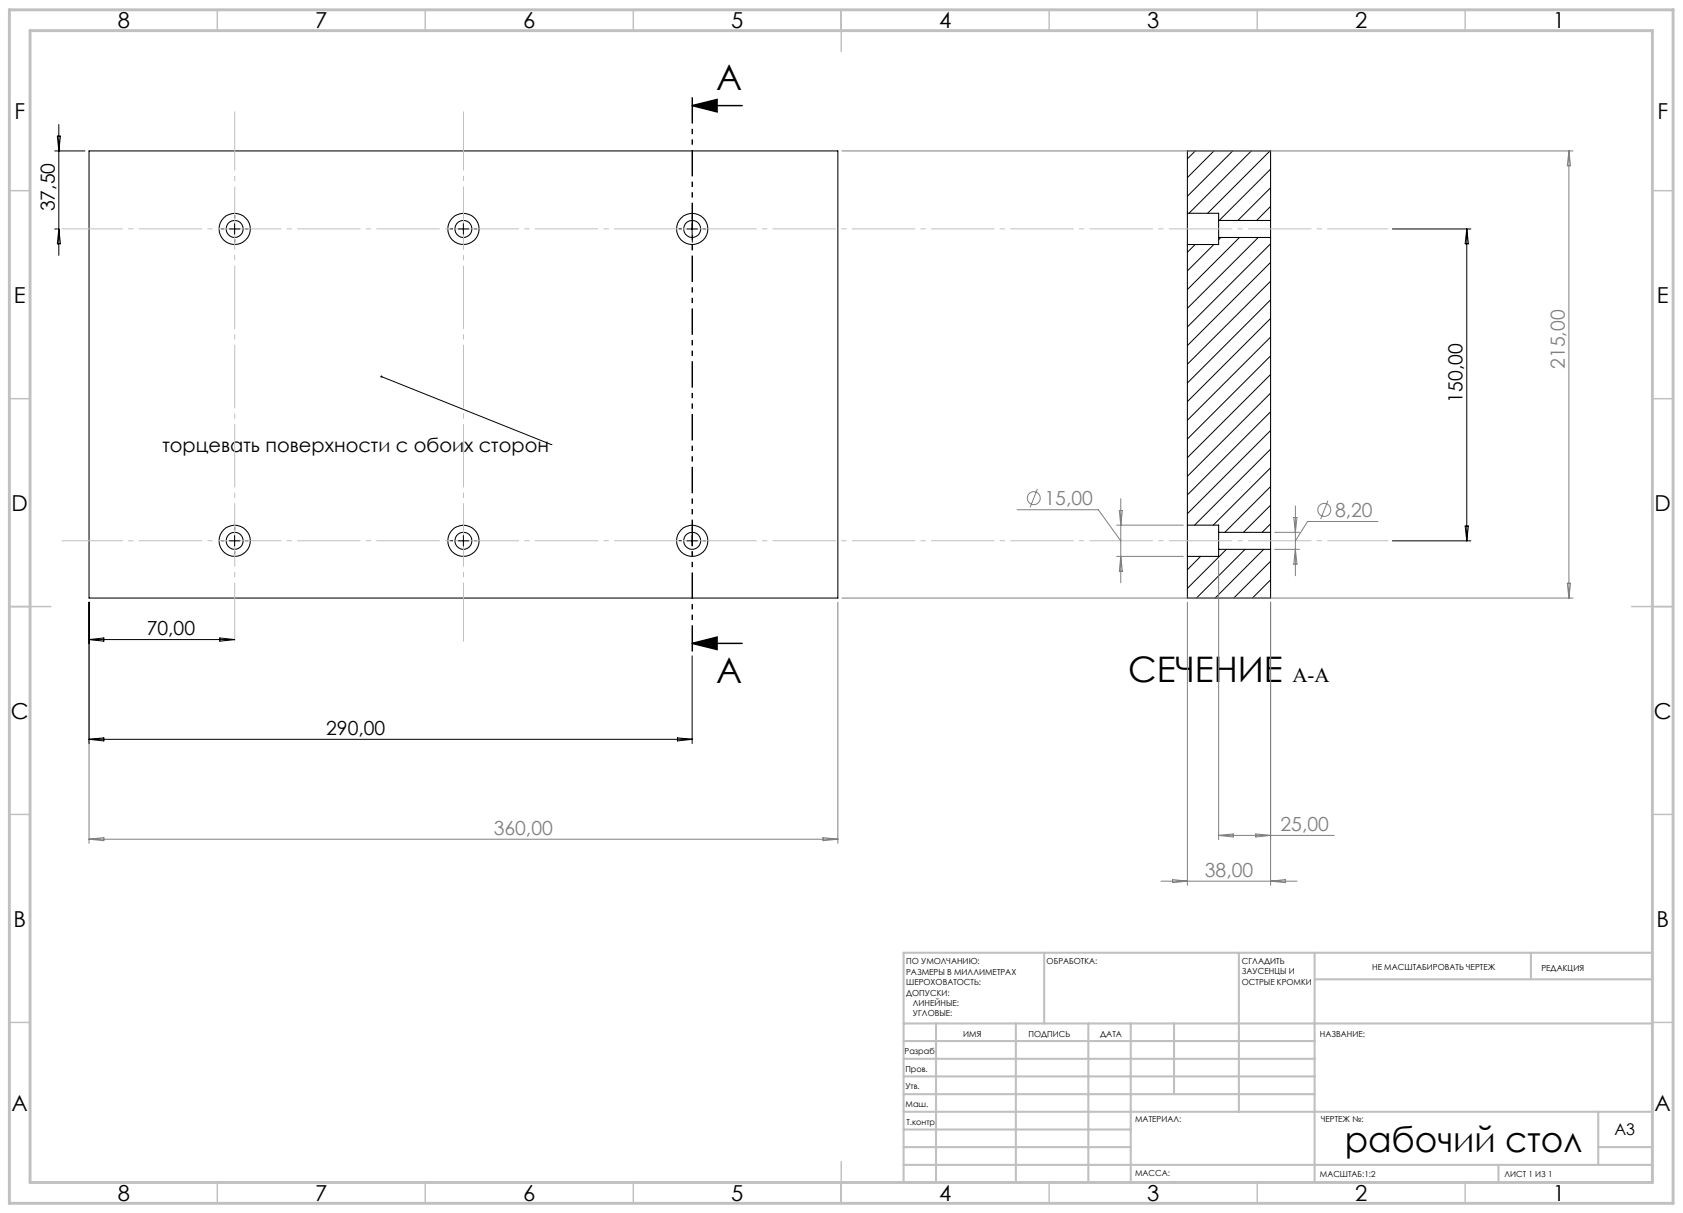
[picture p324: page 1]
СЕЧЕНИЕ A-A; МАСШТАБ:1:2; ЛИСТ 1 ИЗ 1; НЕ МАСШТАБИРОВАТЬ ЧЕРТЕЖ; РЕДАКЦИЯ; ЗАУСЕНЦЫ И ОСТРЫЕ КРОМКИ; ПО УМОЛЧАНИЮ:; ОБРАБОТКА:; РАЗМЕРЫ В МИЛЛИМЕТРАХ

торцевать поверхности с обоих сторон

ИМЯ | ПОДПИСЬ | ДАТА | | | | НАЗВАНИЕ:
Т.контр | | | | МАТЕРИАЛ: | ЧЕРТЕЖ №: рабочий стол МАССА: | A3

Разраб.
Пров.
Утв.
Маш.
