sergei-tiutriumov/Finishing/Ivan/калибр механизм.pdf

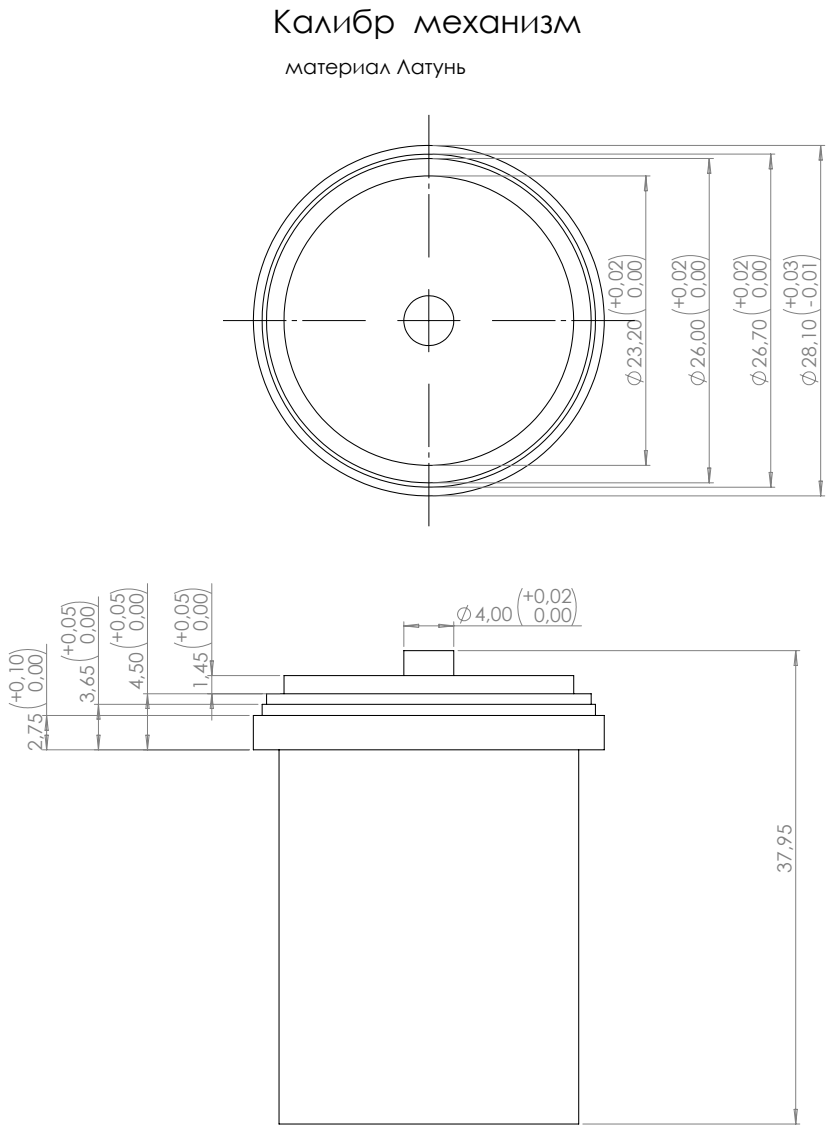
[picture p325: page 1]
Калибр механизм; материал Латунь
