sergei-tiutriumov/Finishing/Ivan/калибр стекло.pdf

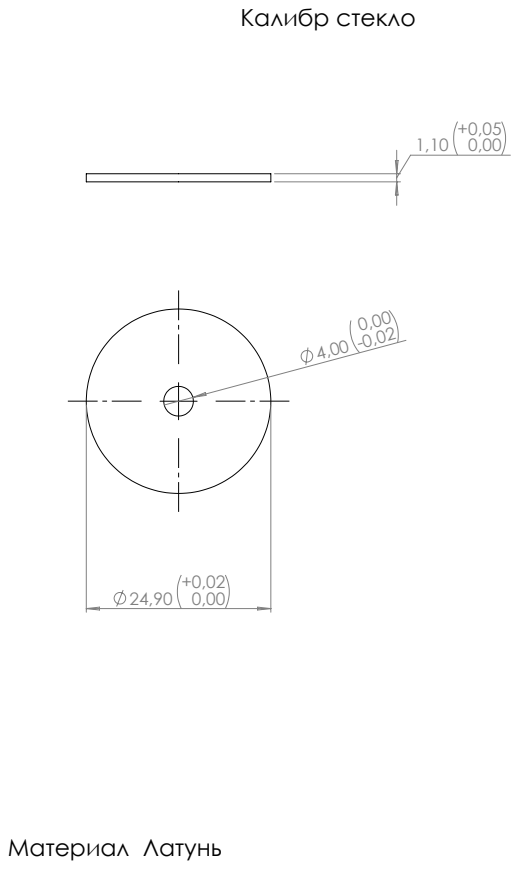
[picture p326: page 1]
Калибр стекло; Материал Латунь
