sergei-tiutriumov/Finishing/Ivan/Цанга под корпус.pdf

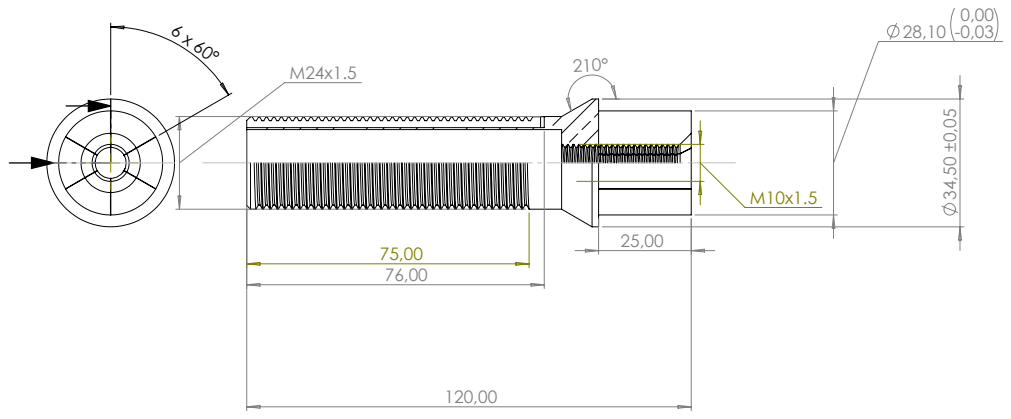
[picture p327: page 1]
