sergei-tiutriumov/Finishing/Ivan/2025-08-05 ИПФ Крышка Ж2 18мм клей.pdf

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

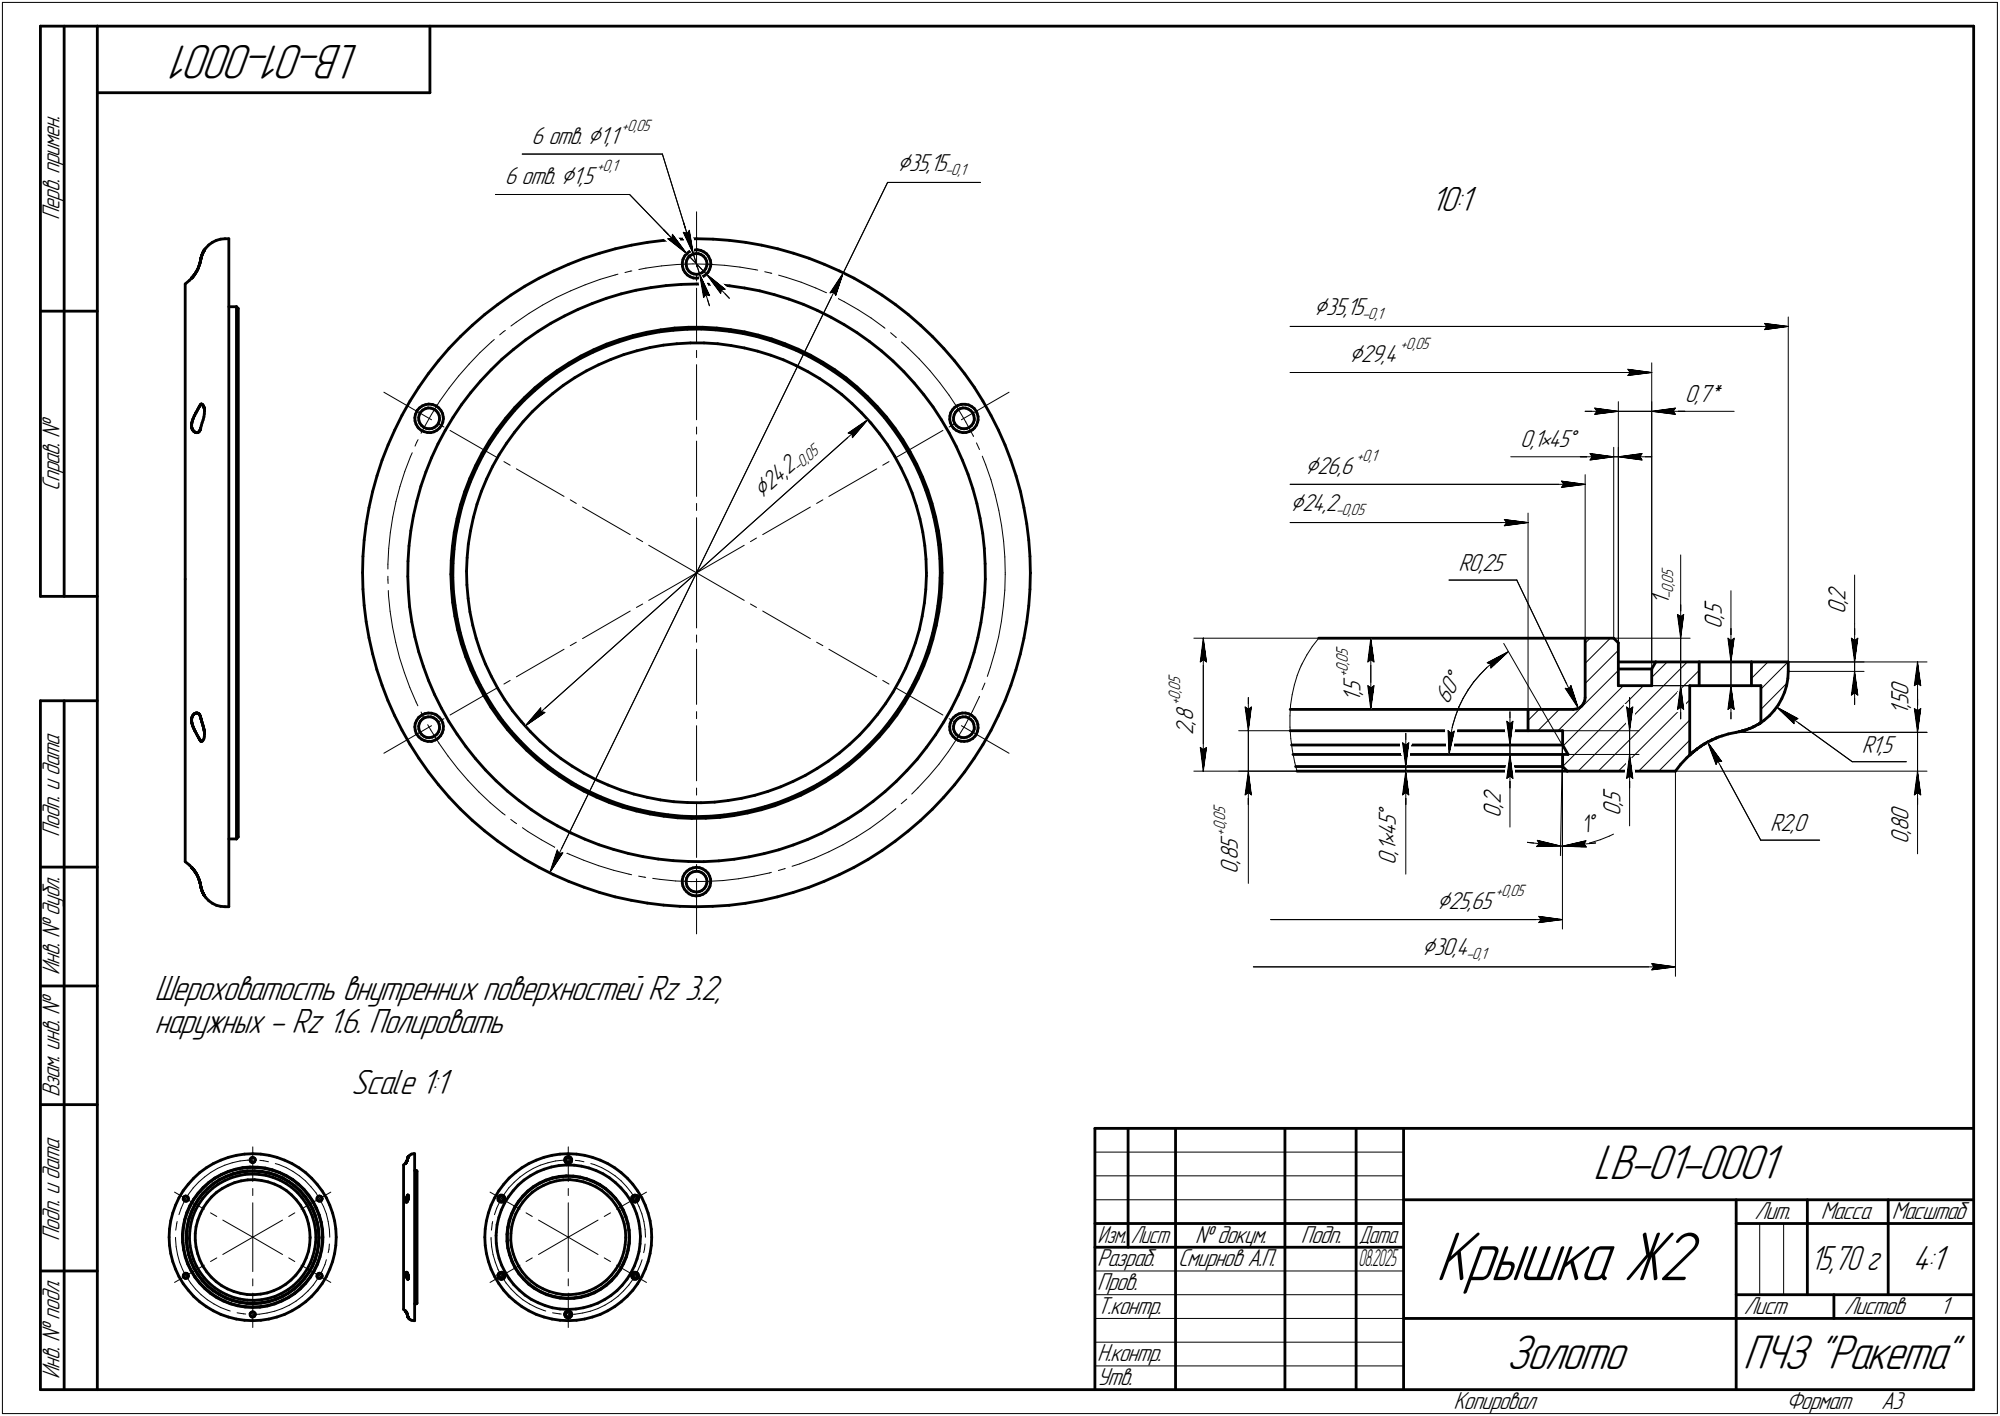
[picture p328: page 1]
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
