sergei-tiutriumov/Finishing/сфинкс/рабочий стол/цилиндр.pdf

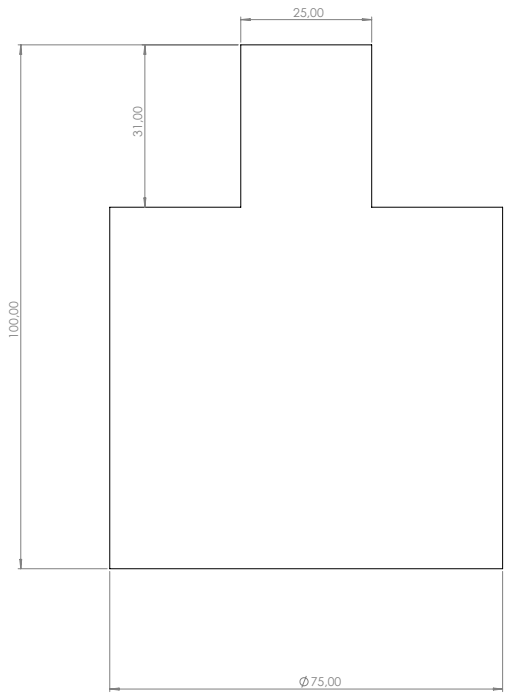
[picture p330: page 1]
