sergei-tiutriumov/Finishing/КЧ/Путник 2/inner_bezel_mapping.pdf

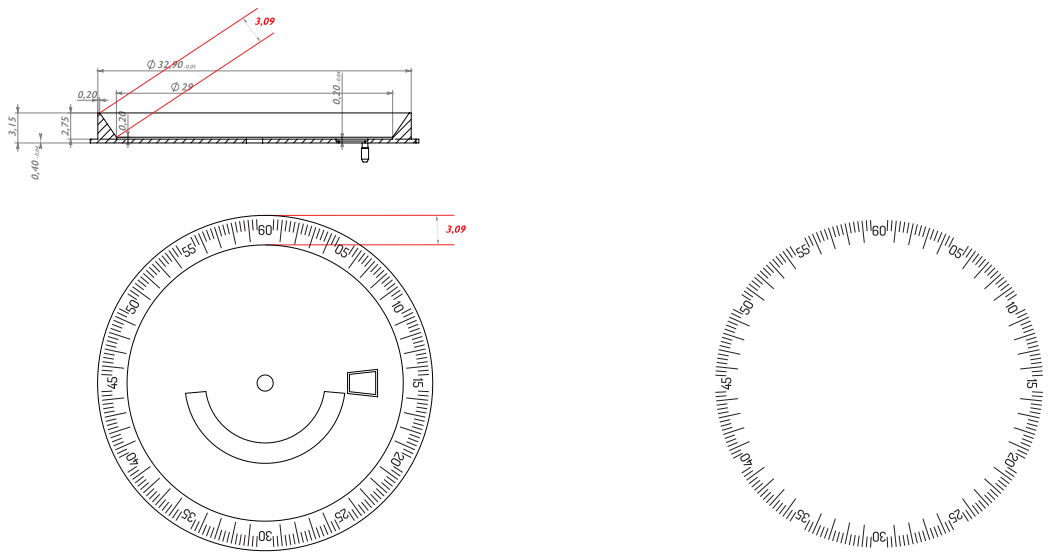
[picture p331: page 1]
