sergei-tiutriumov/Finishing/КЧ/Путник 2/strap.pdf

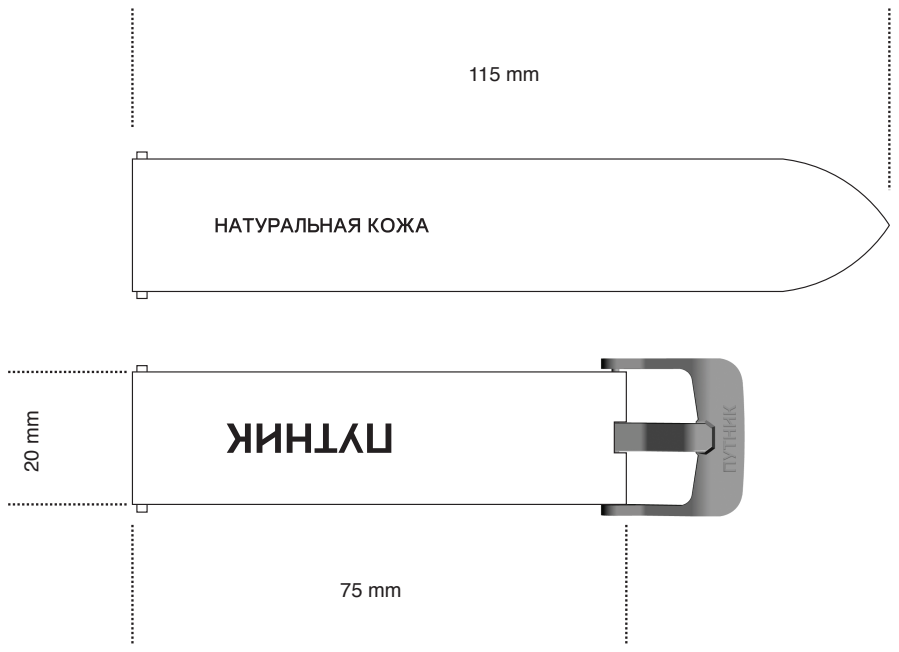
[picture p332: page 1]
Genuine leather
