sergei-tiutriumov/Finishing/КЧ/Путник 2/top_pack.pdf

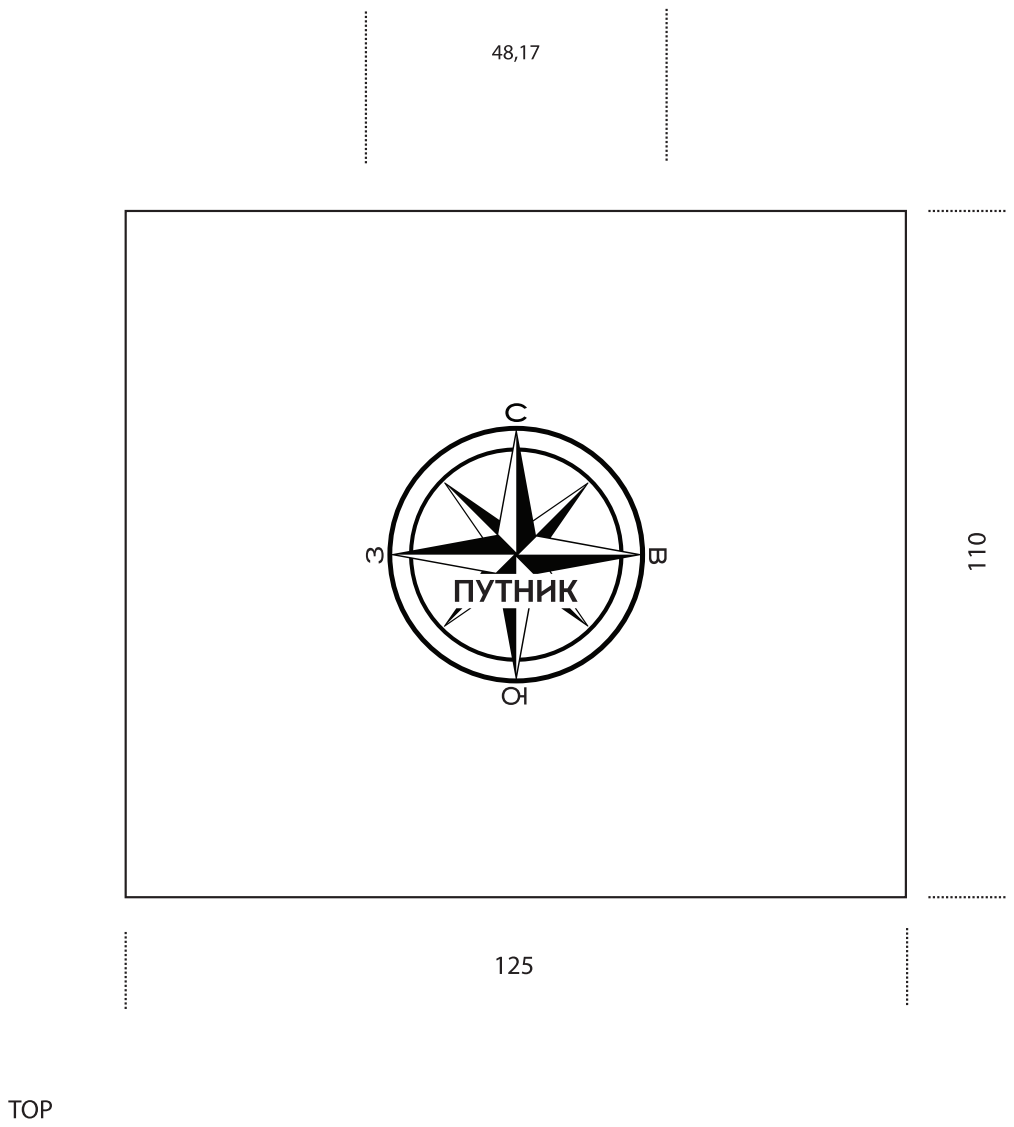
[picture p333: page 1]
