sergei-tiutriumov/Finishing/Суханов/Коробка Суханов/коробка бумажная сбор.pdf

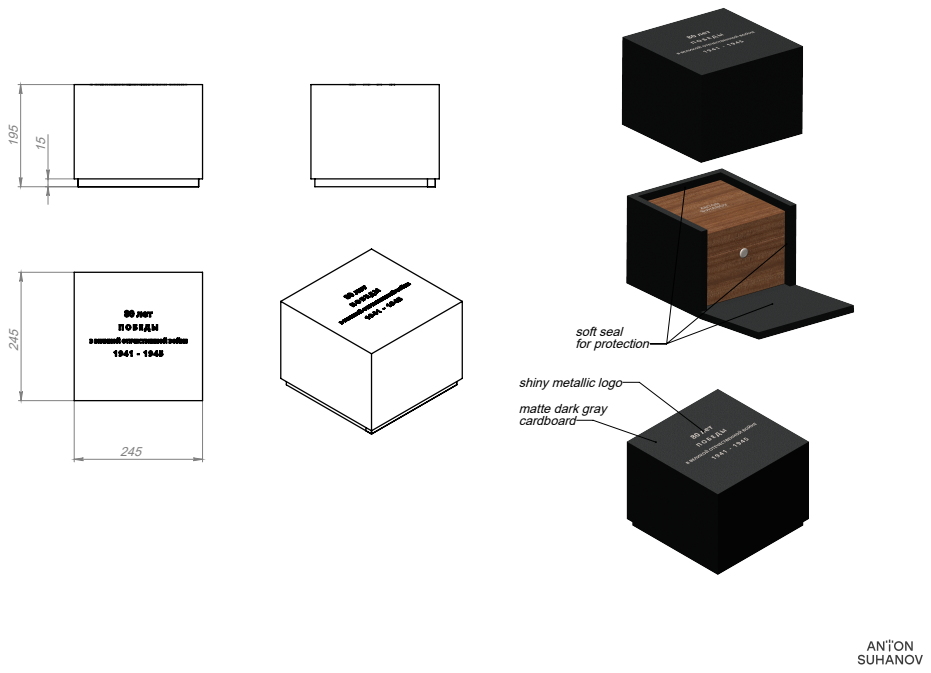
[picture p334: page 1]
soft seal for protection

shiny metallic logo
matte dark gray
cardboard
