sergei-tiutriumov/Finishing/Ivan/Шомпол на шаублин 102n/1.pdf

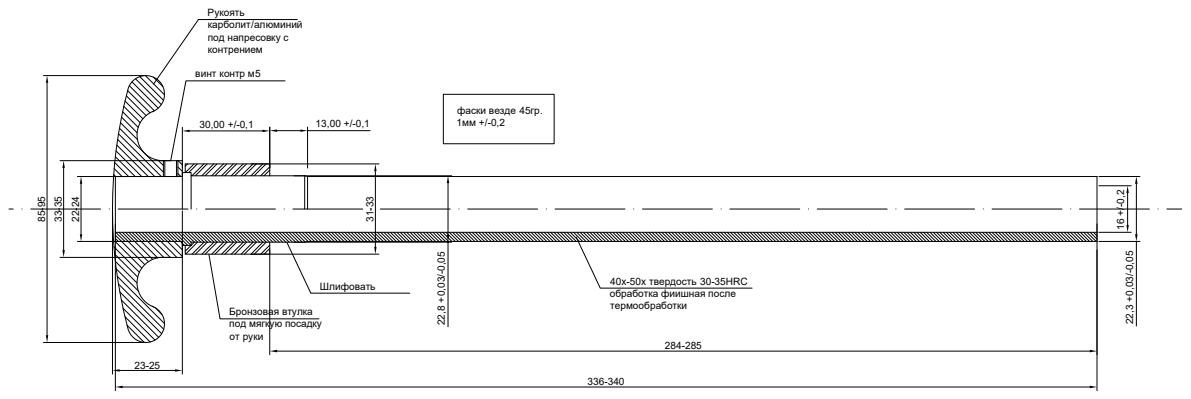
[picture p335: page 1]

31-33 336-340 284-285 Шлифовать 40х-50х твердость 30-35HRC обработка фиишная после термообработки Рукоять карболит/алюминий под напресовку с контрением винт контр м5 Бронзовая втулка под мягкую посадку от руки 23-25 фаски везде 45гр. 1мм +/-0,2
