sergei-tiutriumov/Finishing/Ivan/Шомпол на шаублин 102n/2.pdf

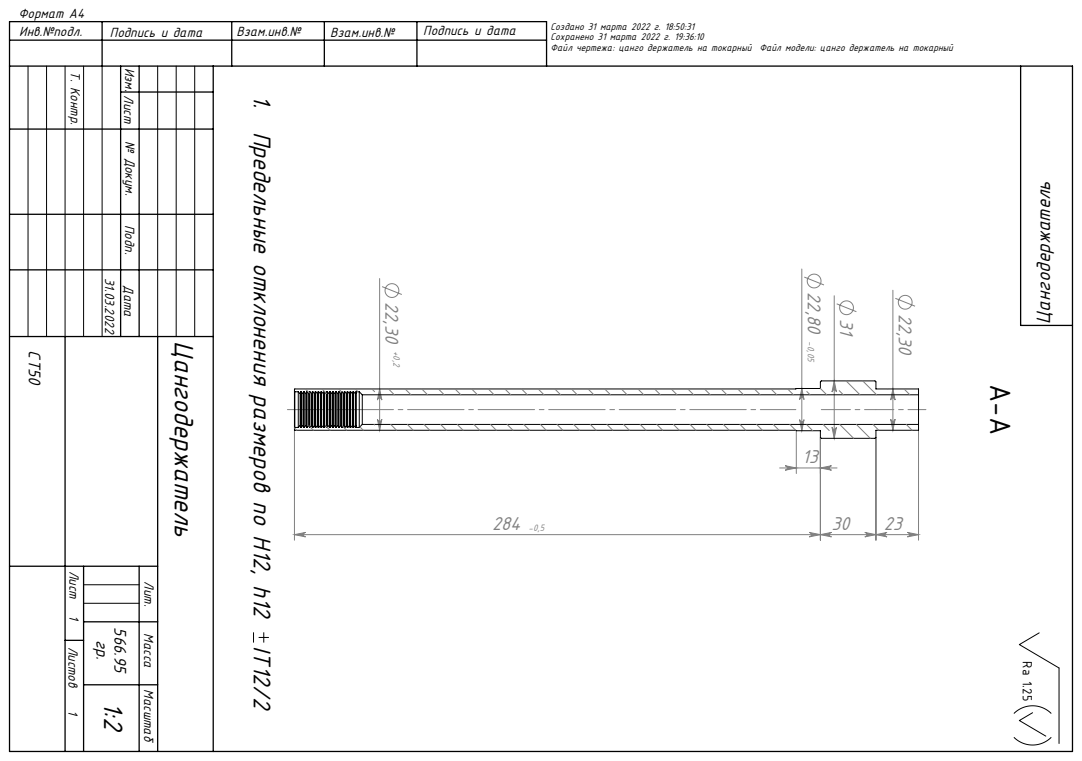
[picture p336: page 1]
Инв.№подл.; Подпись и дата; Взам.инв.№; Лист 1 Листов 1; Формат А4; Т. Контр.

Создано 31 марта 2022 г. 18:50:31
Сохранено 31 марта 2022 г. 19:36:10
Файл чертежа: цанго держатель на токарный Файл модели: цанго держатель на токарный

Изм. № Докум. Лист

Предельные отклонения размеров по H12, h12 IT12/2 1.

Лит. Масса Масштаб
