sergei-tiutriumov/Finishing/Ivan/Шомпол на шаублин 102n/3.pdf

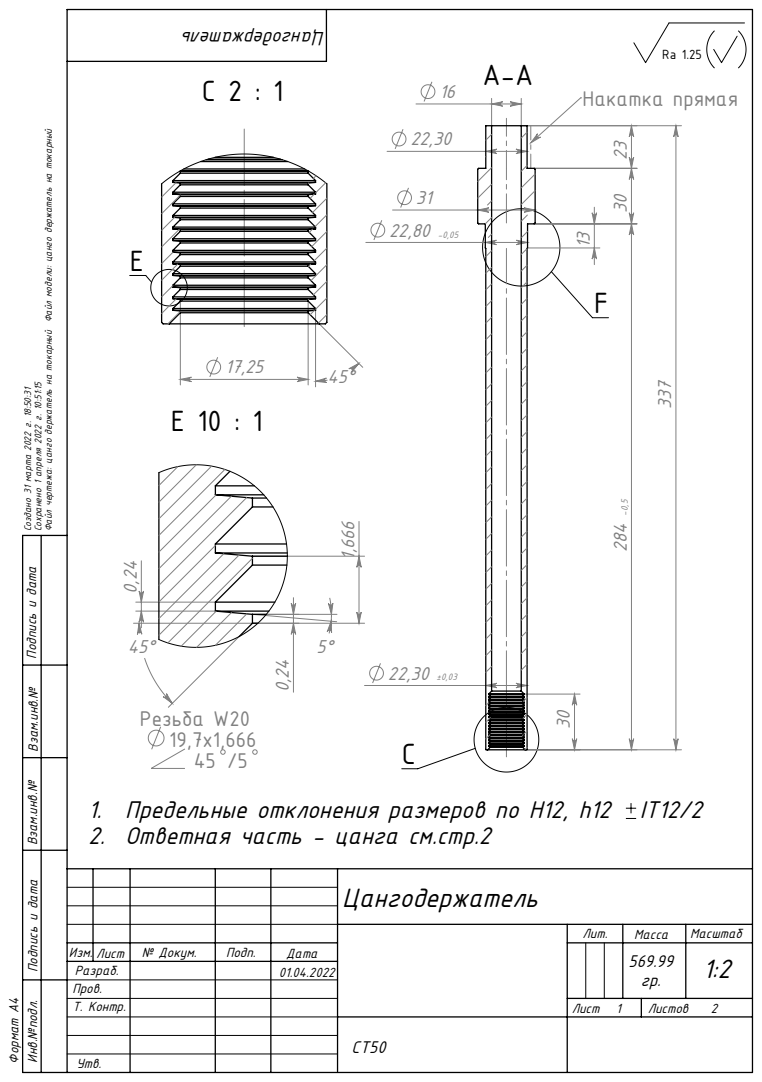
[picture p337: page 1]
Накатка прямая; 1. Предельные отклонения размеров по H12, h12; Резьба W20 45 /5; Формат А4; Создано 31 марта 2022 г. 18:50:31; Сохранено 1 апреля 2022 г. 10:51:15

Файл чертежа: цанго держатель на токарный Файл модели: цанго держатель на токарный

Инв.№подл. Подпись и дата Взам.инв.№ Подпись и дата Взам.инв.№

2. Ответная часть - цанга см.стр.2

Цангодержатель

Лит. | Масса | Масштаб

Изм. Лист | № Докум. | Подп. | Дата 01.04.2022 | | | | | 569.99 гр. | 1:2
Разраб.
Пров.
Т. Контр. | | | | Лист 1 | Листов 2

Утв.

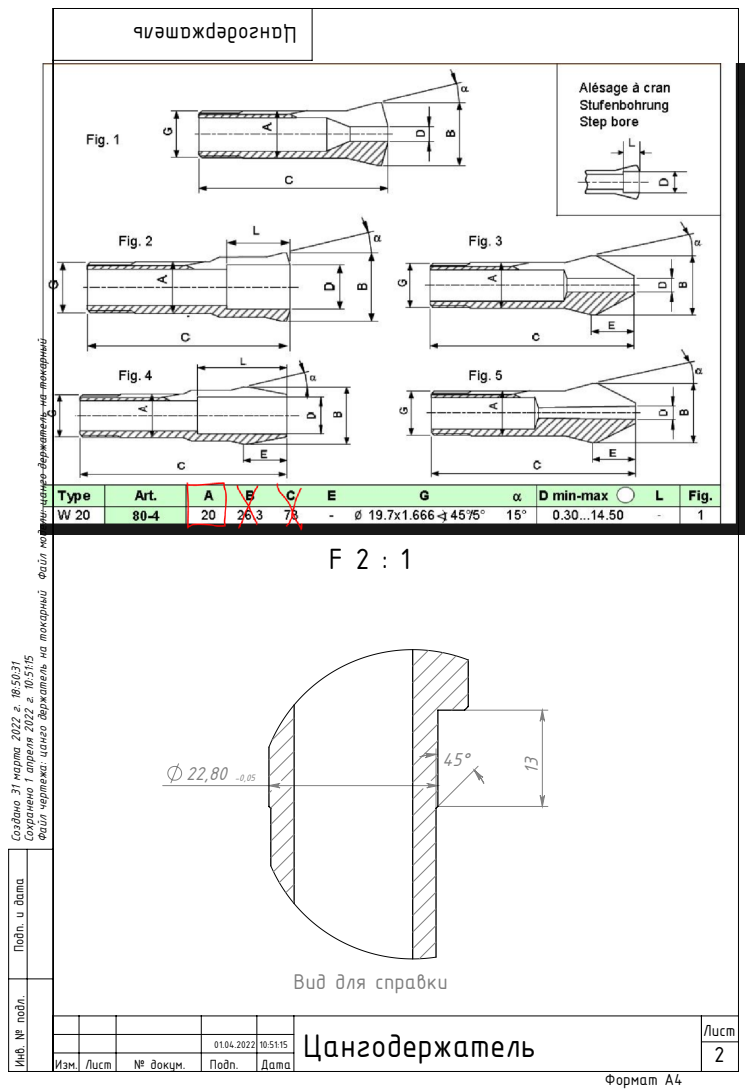
[picture p338: page 2]
№ докум.; Подп.; Дата; Цангодержатель; Формат А4; Создано 31 марта 2022 г. 18:50:31; Сохранено 1 апреля 2022 г. 10:51:15

Файл чертежа: цанго держатель на токарный Файл модели: цанго держатель на токарный

Инв. № подл. Подп. и дата

Вид для справки
