sergei-tiutriumov/Finishing/Ivan/Шомпол на шаублин 102n/4.pdf

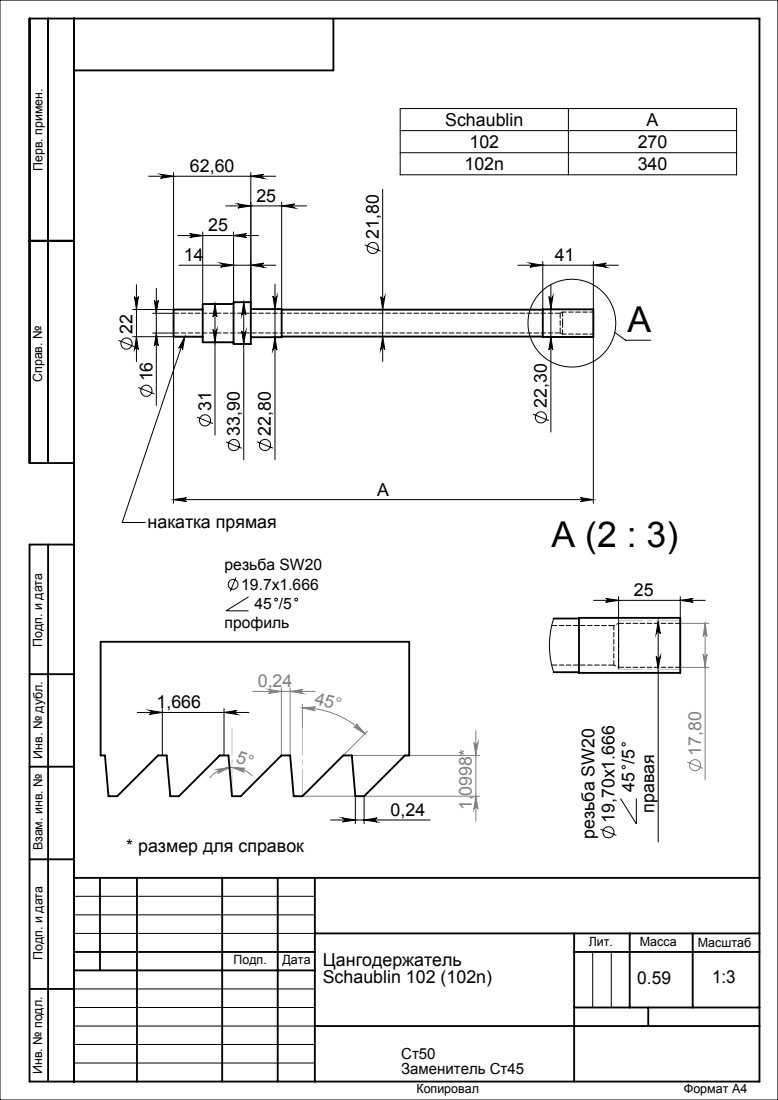
[picture p339: page 1]
накатка прямая; резьба SW20; Заменитель Ст45; Копировал; Формат А4

Справ. № Перв. примен. Подп. и дата Инв. № дубл. Взам. инв. № Подп. и дата Инв. № подл.

Schaublin | A
102 | 270
102n | 340

* размер для справок

Цангодержатель Schaublin 102 (102n) | Лит. | Масса | Масштаб

Подп. | Дата | | | | | 0.59 | 1:3
