sergei-tiutriumov/Finishing/Ivan/Шомпол на шаублин 102n/Цангодержатель W25 Иван.pdf

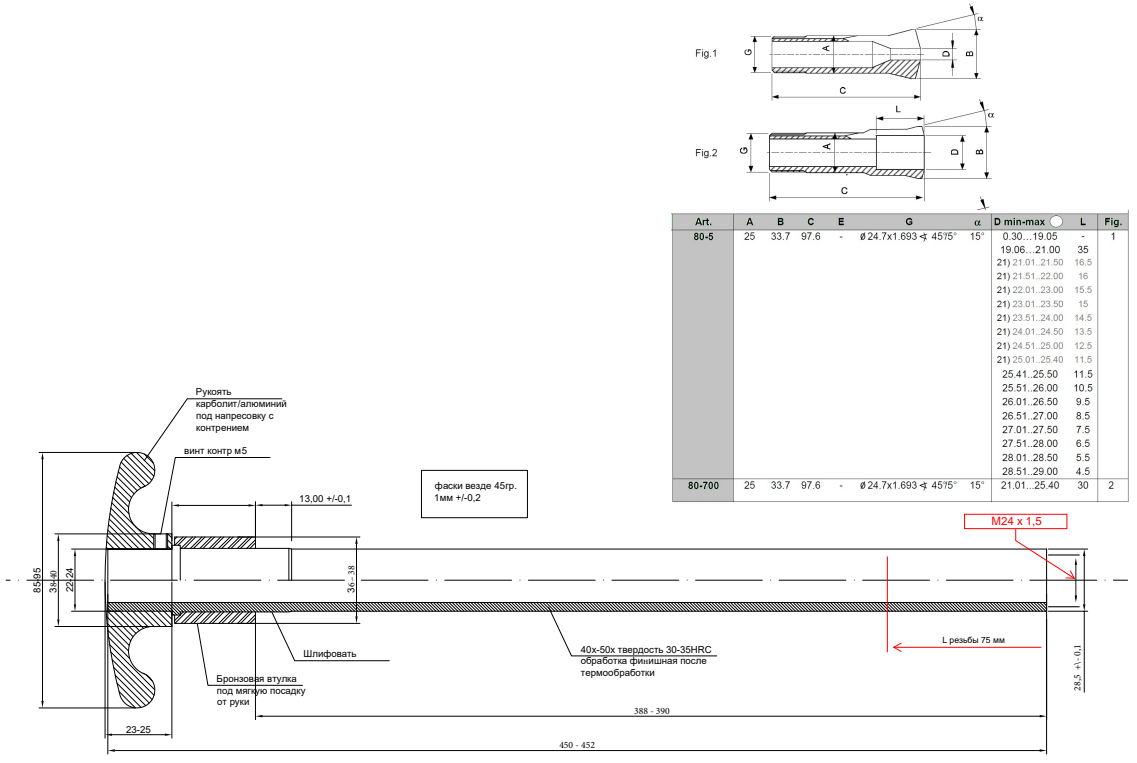
[picture p340: page 1]
388 - 390 Шлифовать; 40х-50х твердость 30-35HRC обработка фи; нишная после; термообработки Рукоять карболит/алюминий под напресовку с контрением винт контр м5 Бронзовая втулка под мягкую посадку от руки 23-25; фаски везде 45гр. 1мм +/-0,2
