sergei-tiutriumov/Finishing/Ракета/КД мосты 2615/Мост ангренажный АЖШ8.075.320/Заготовка Мост ангренажный АЖШ8.075.325.pdf

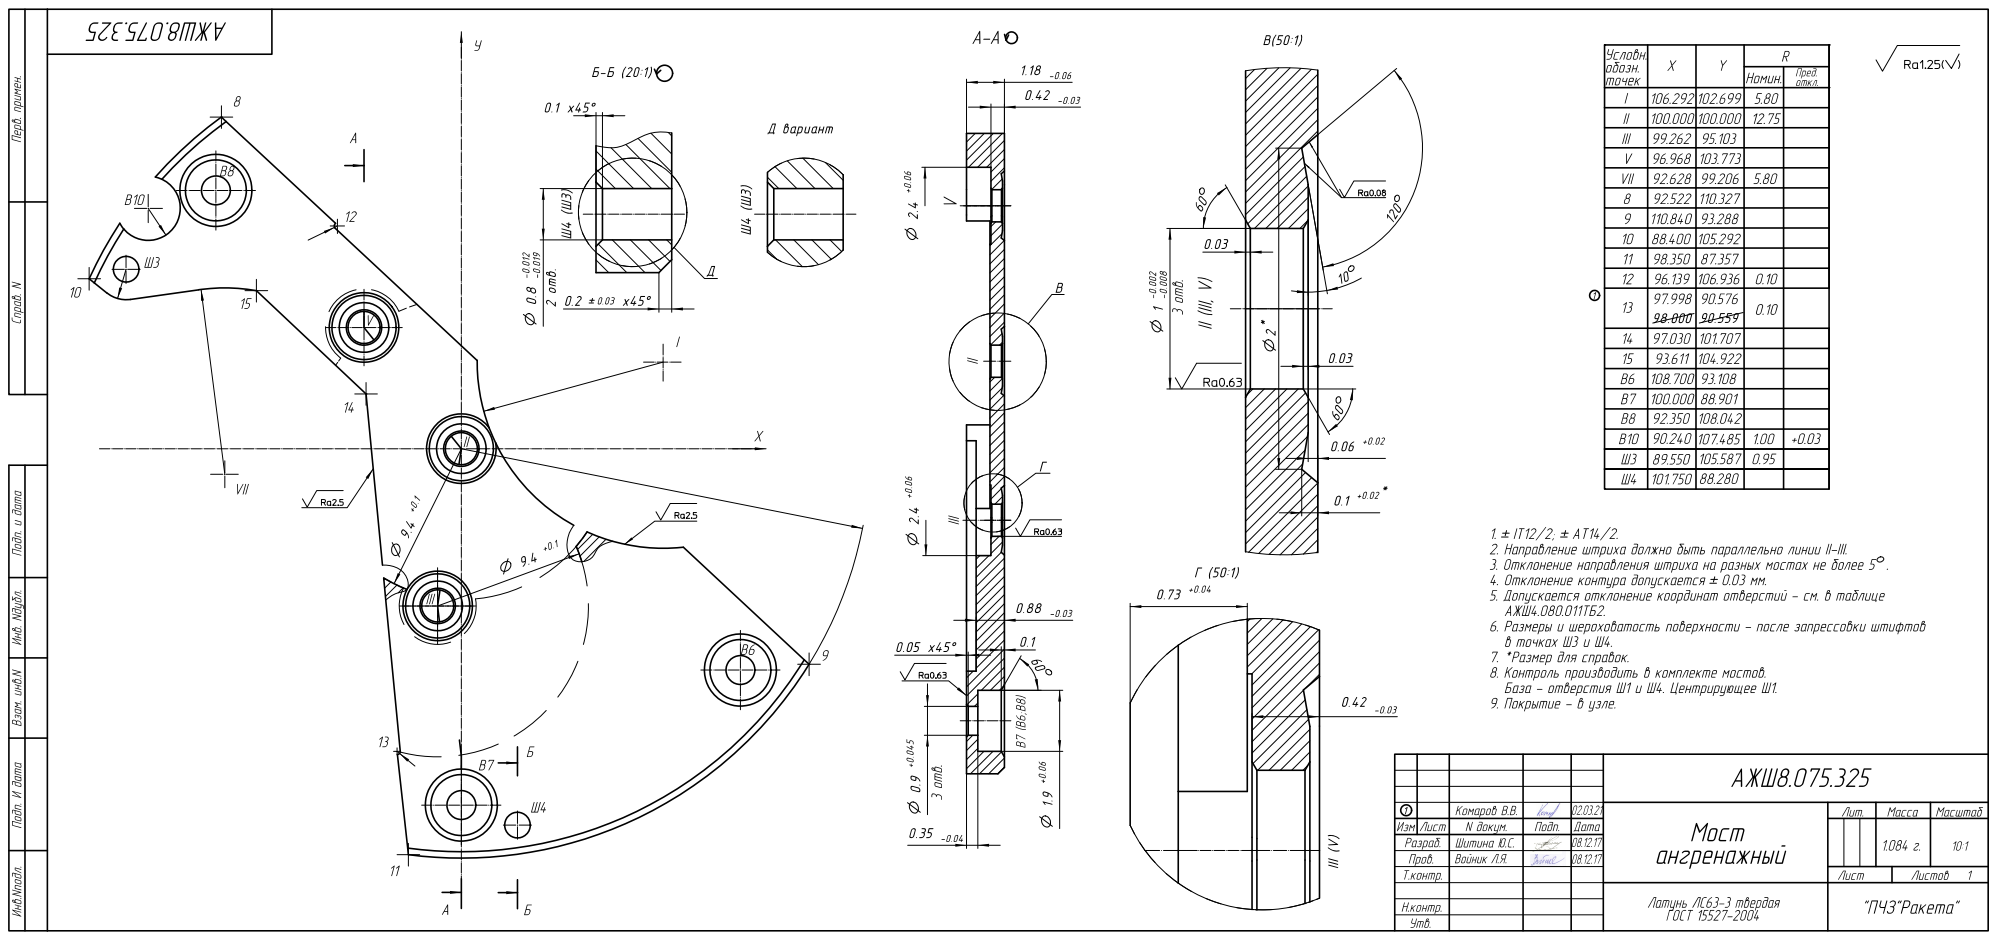
[picture p341: page 1]
