sergei-tiutriumov/Finishing/Ракета/КД мосты 2615/Мост ангренажный АЖШ8.075.320/Мост ангренажный АЖШ.8.075.320.pdf

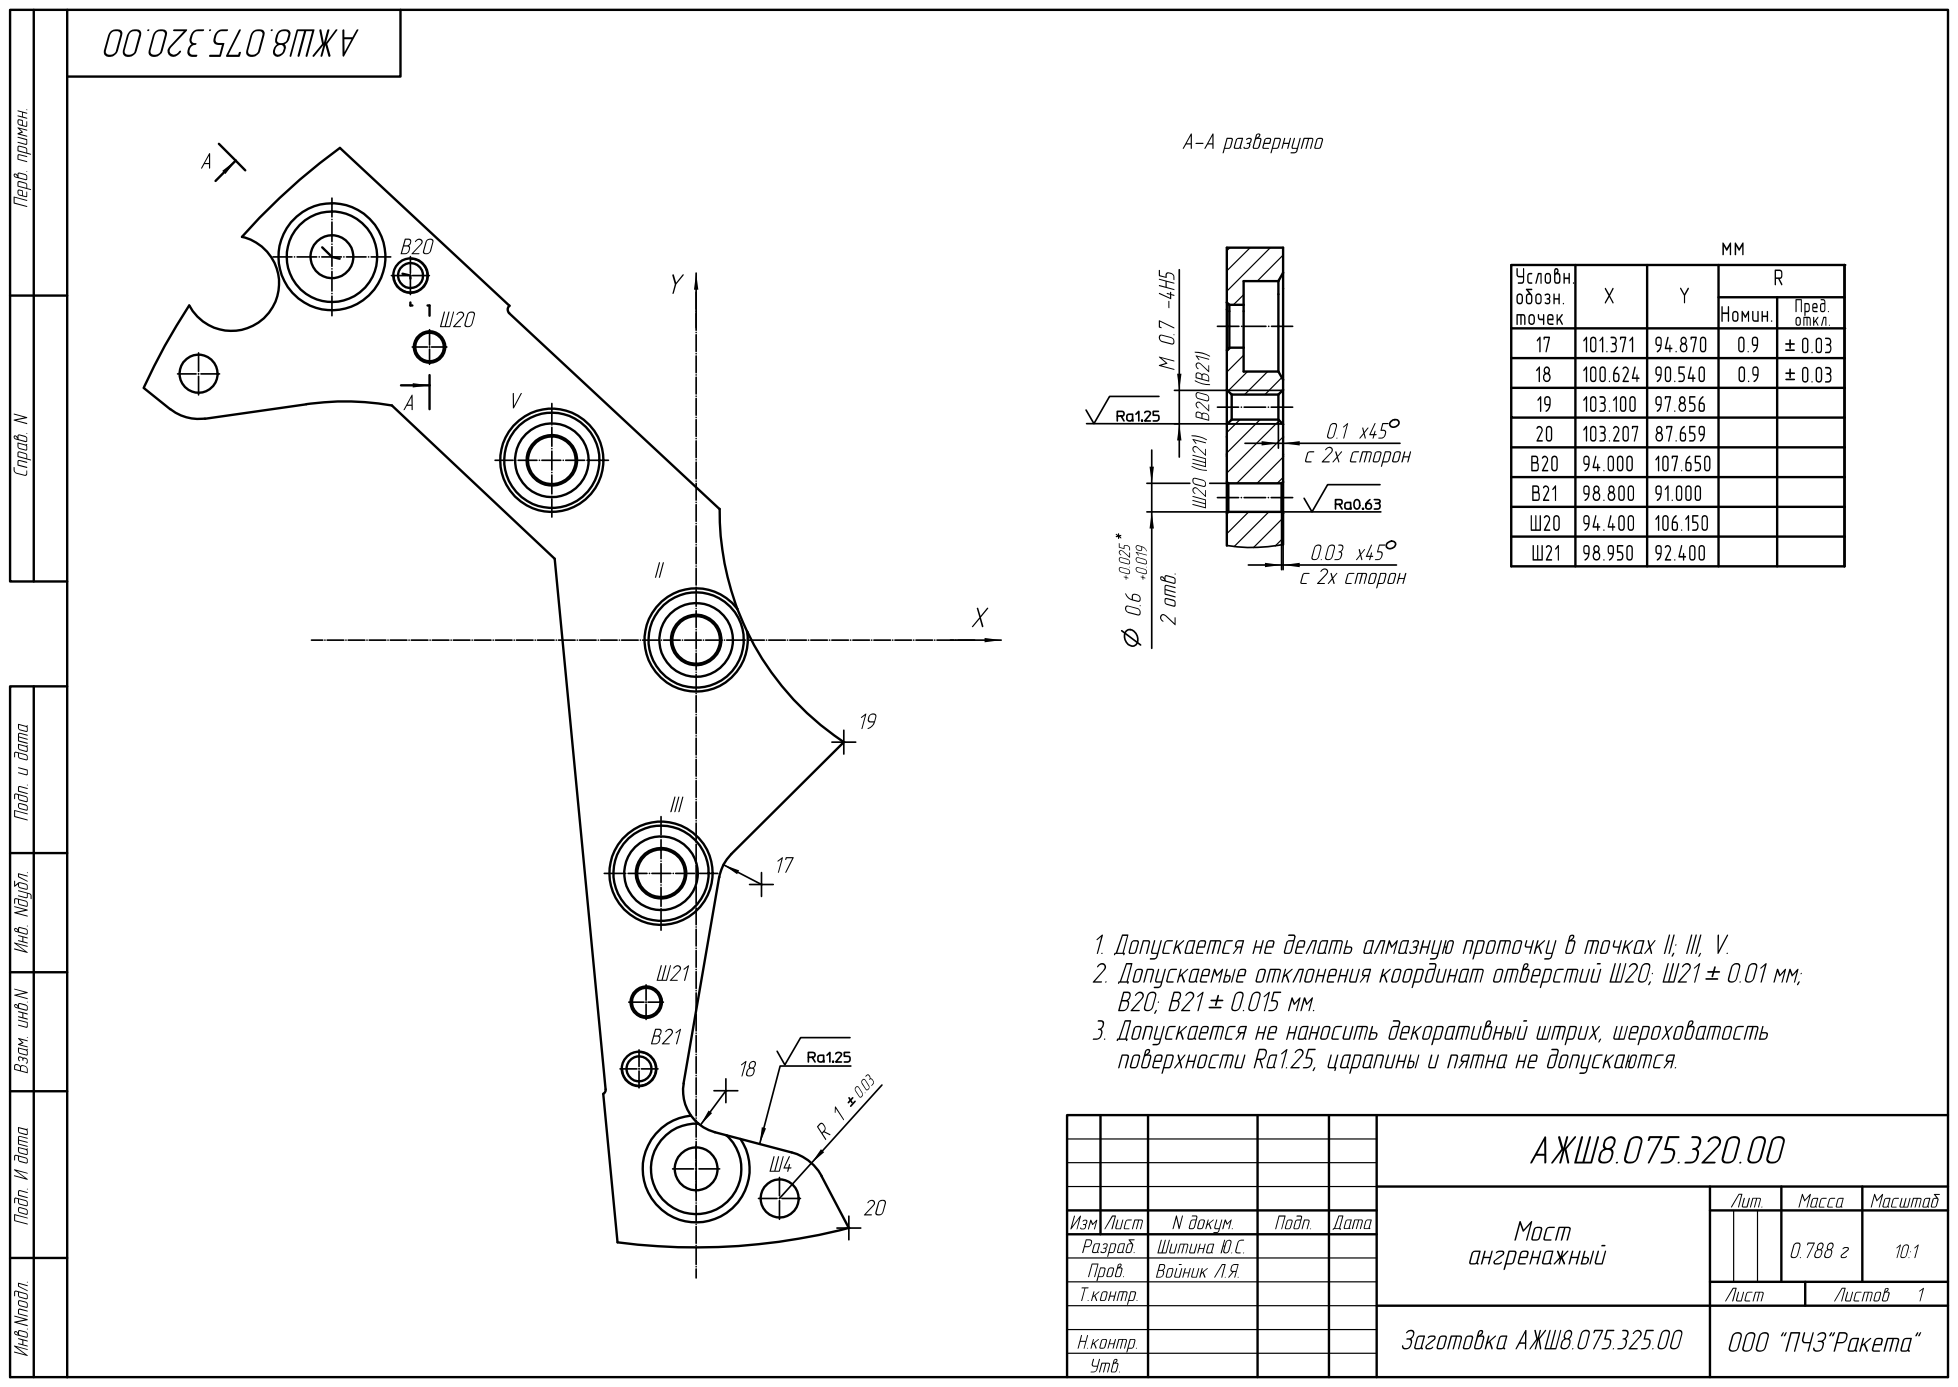
[picture p342: page 1]
