sergei-tiutriumov/Finishing/Ракета/КД мосты 2615/Мост анкерный АЖШ8.075.102-01/АЖШ.8.075.102-01.pdf

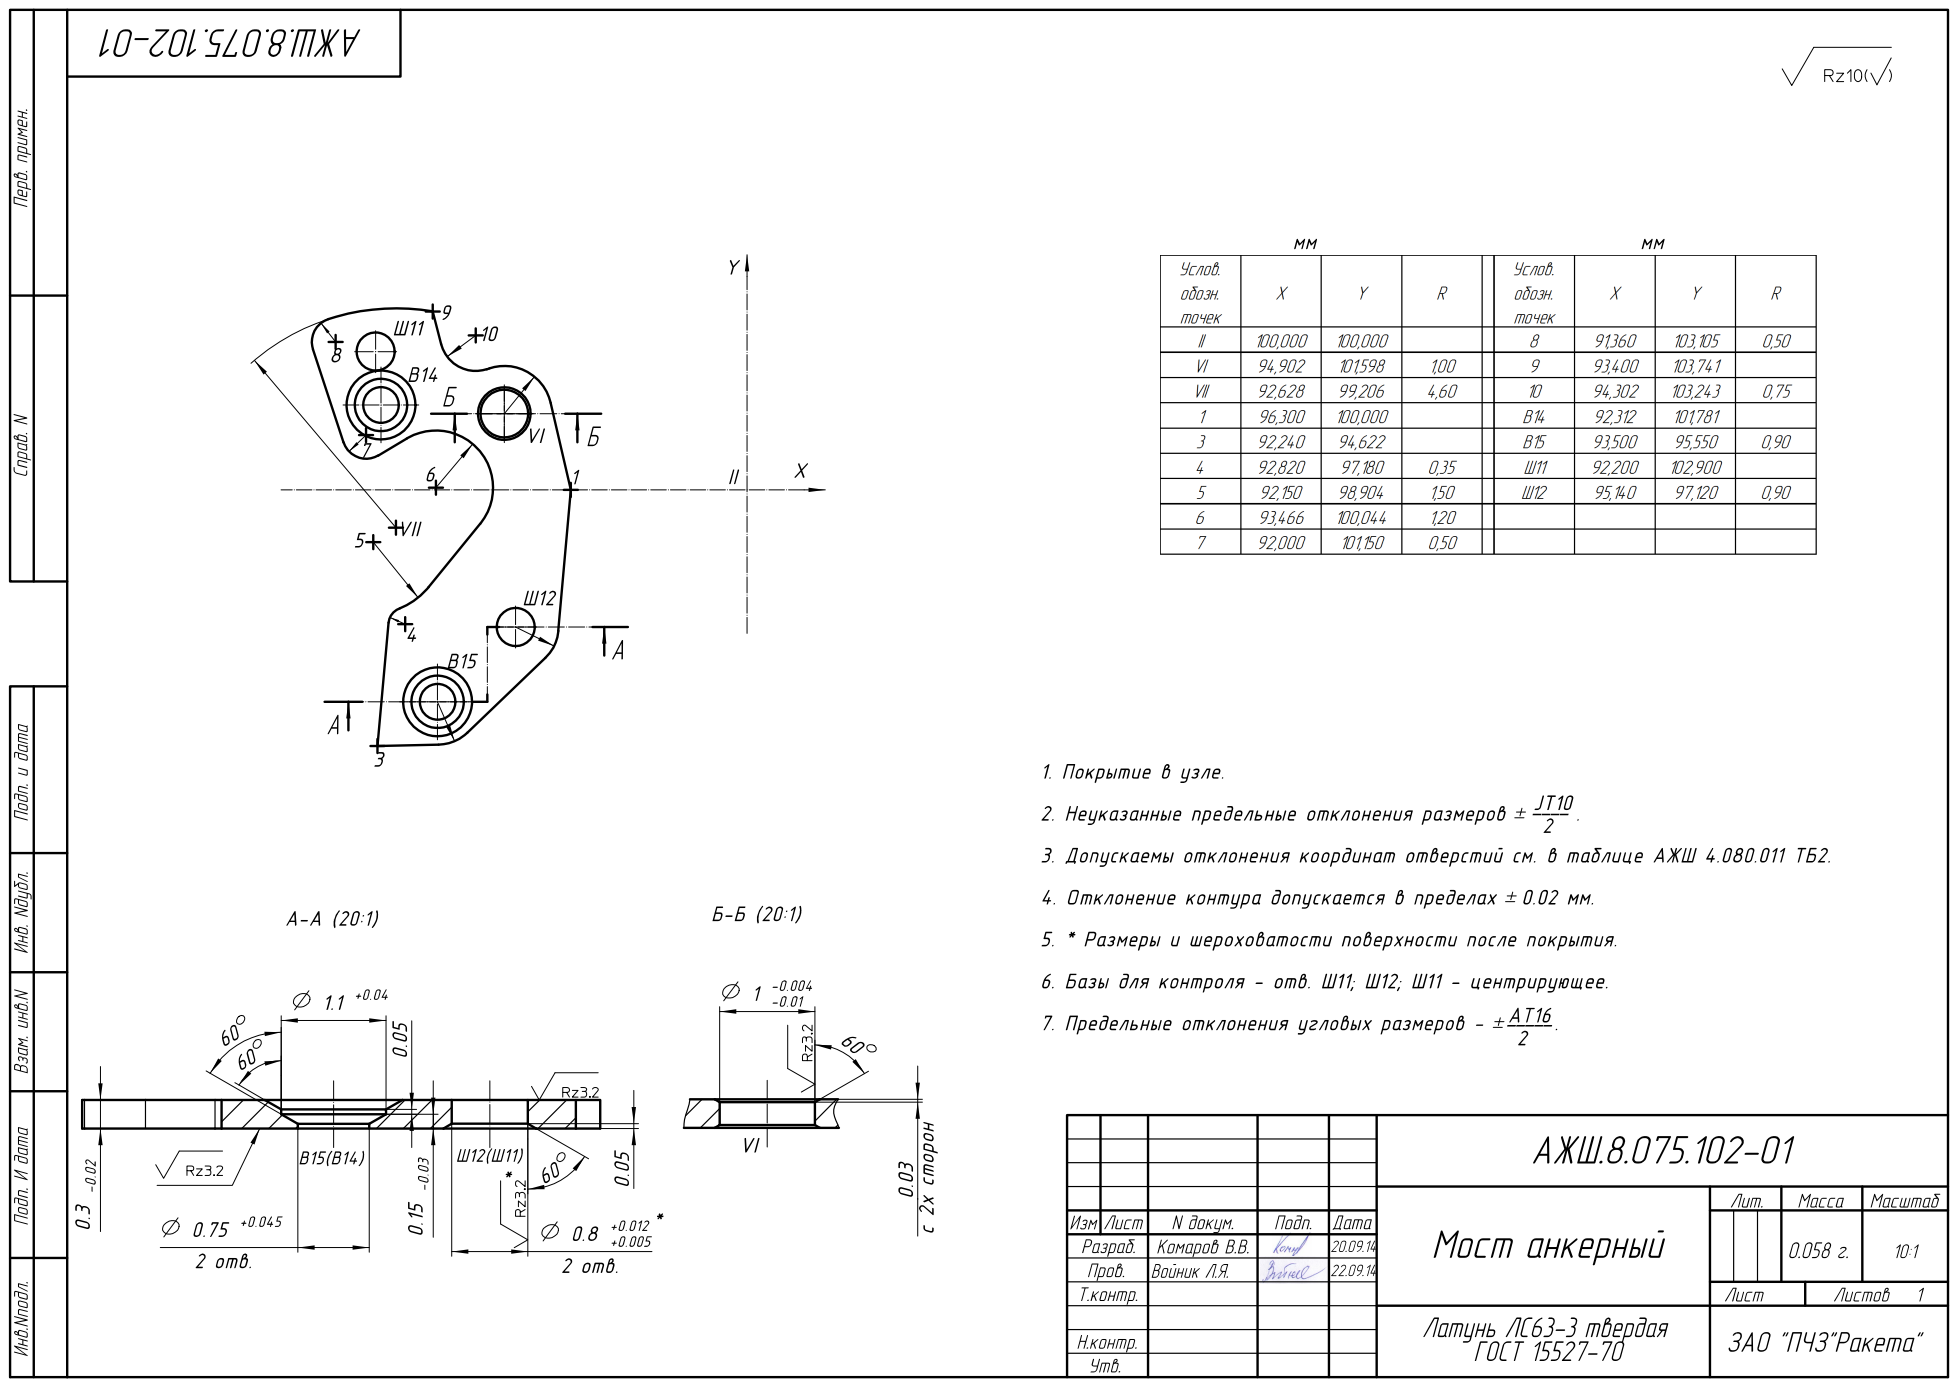
[picture p343: page 1]

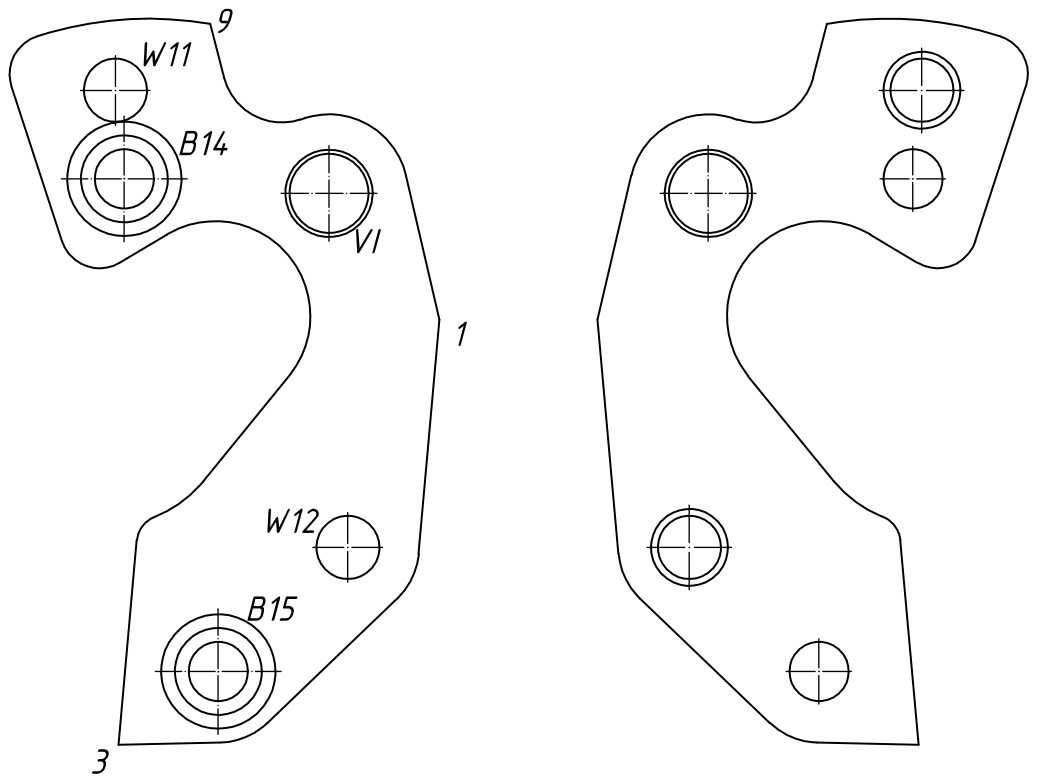
[picture p344: page 2]
