sergei-tiutriumov/Finishing/Ракета/КД мосты 2615/Мост барабанный АЖШ8.075.025/АЖШ.8.075.025_Мост барабанный.pdf

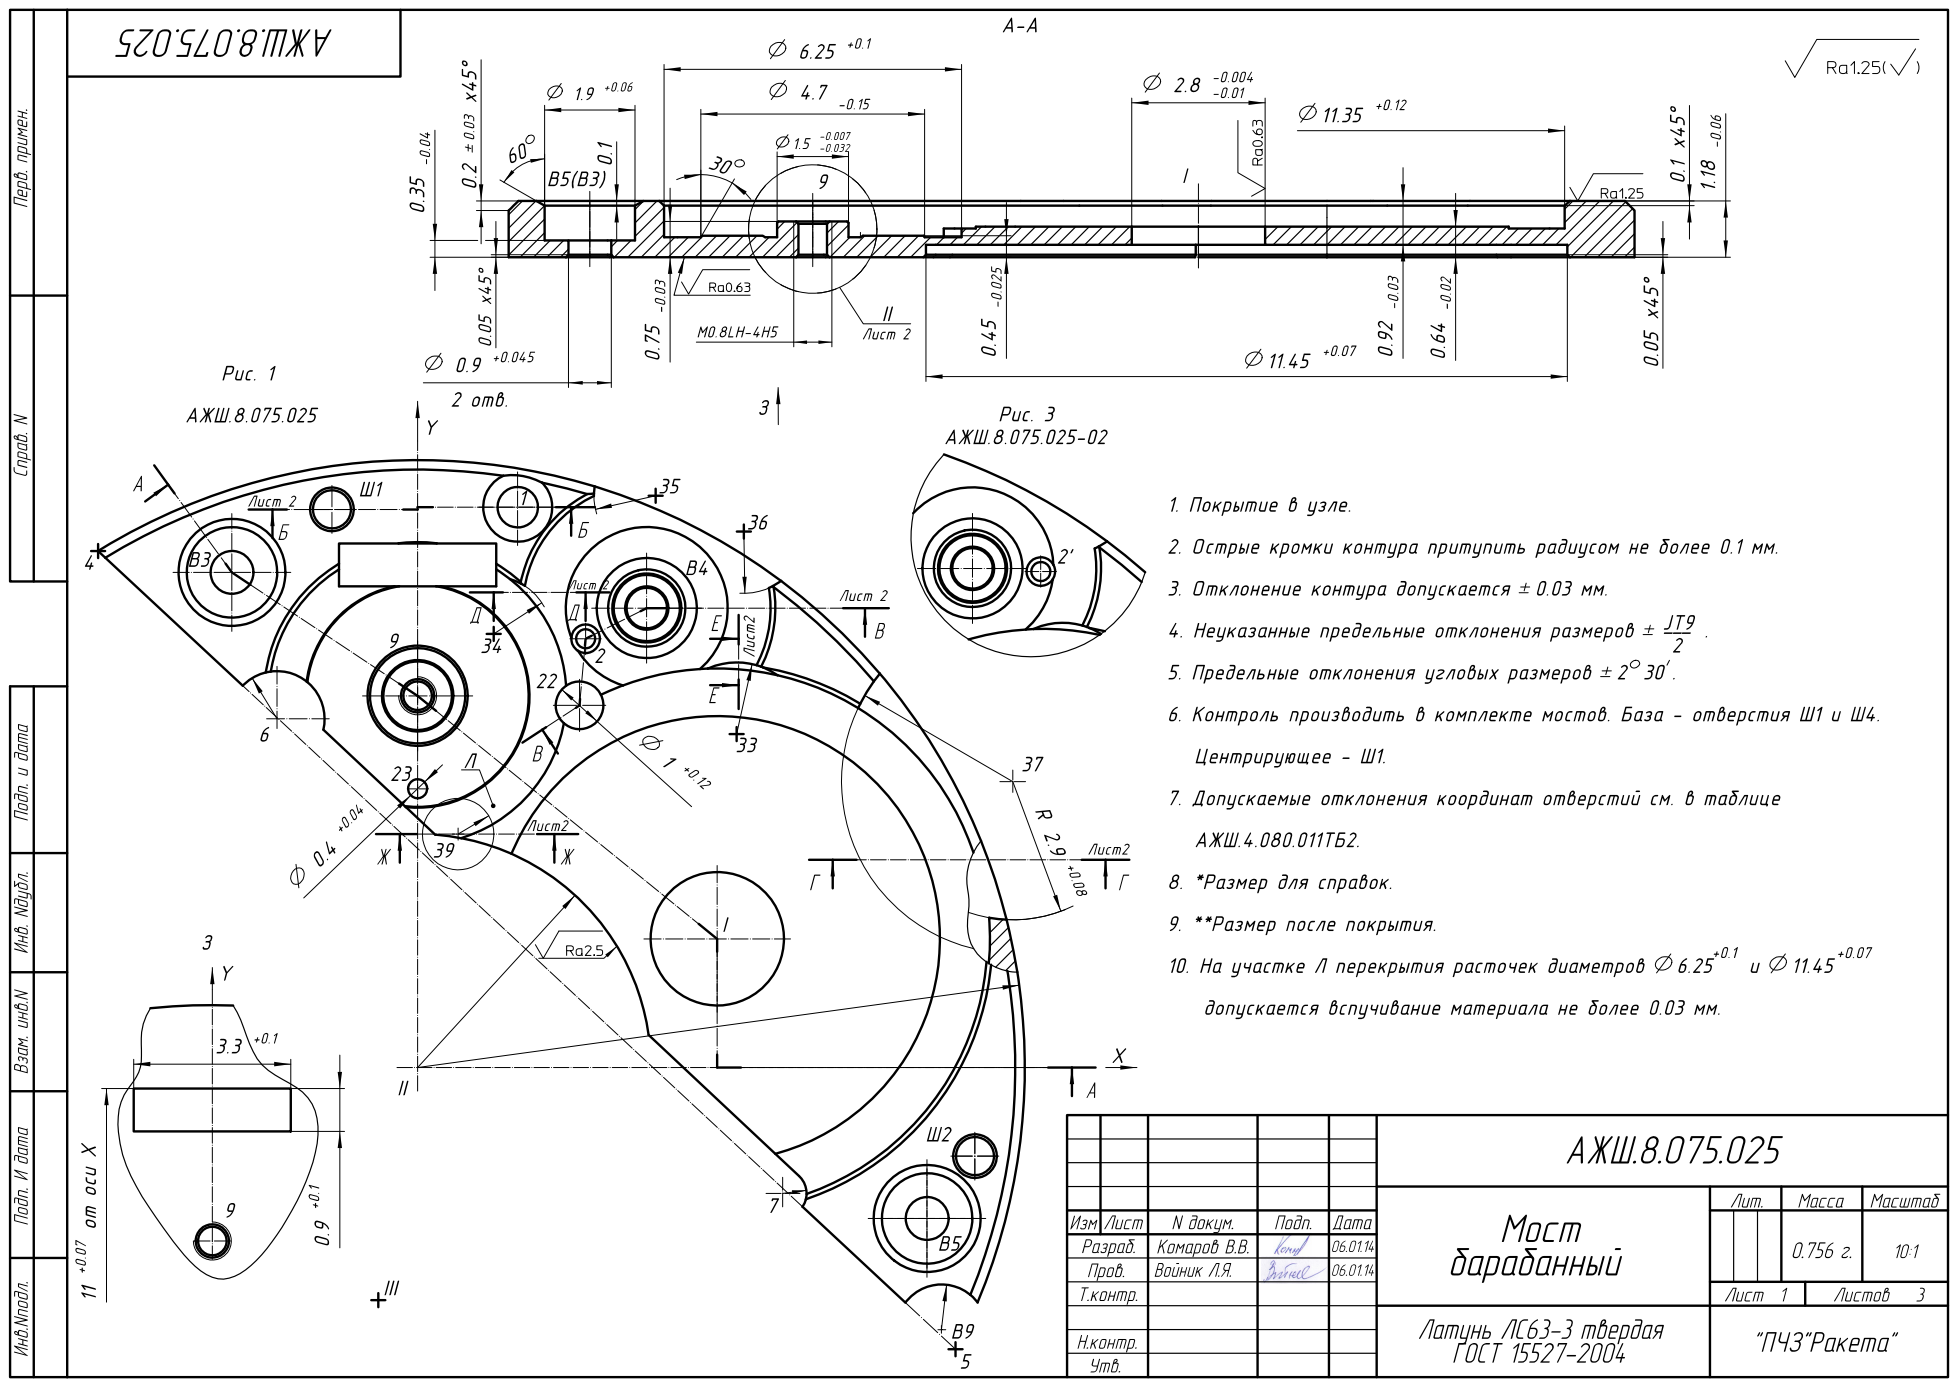
[picture p345: page 1]

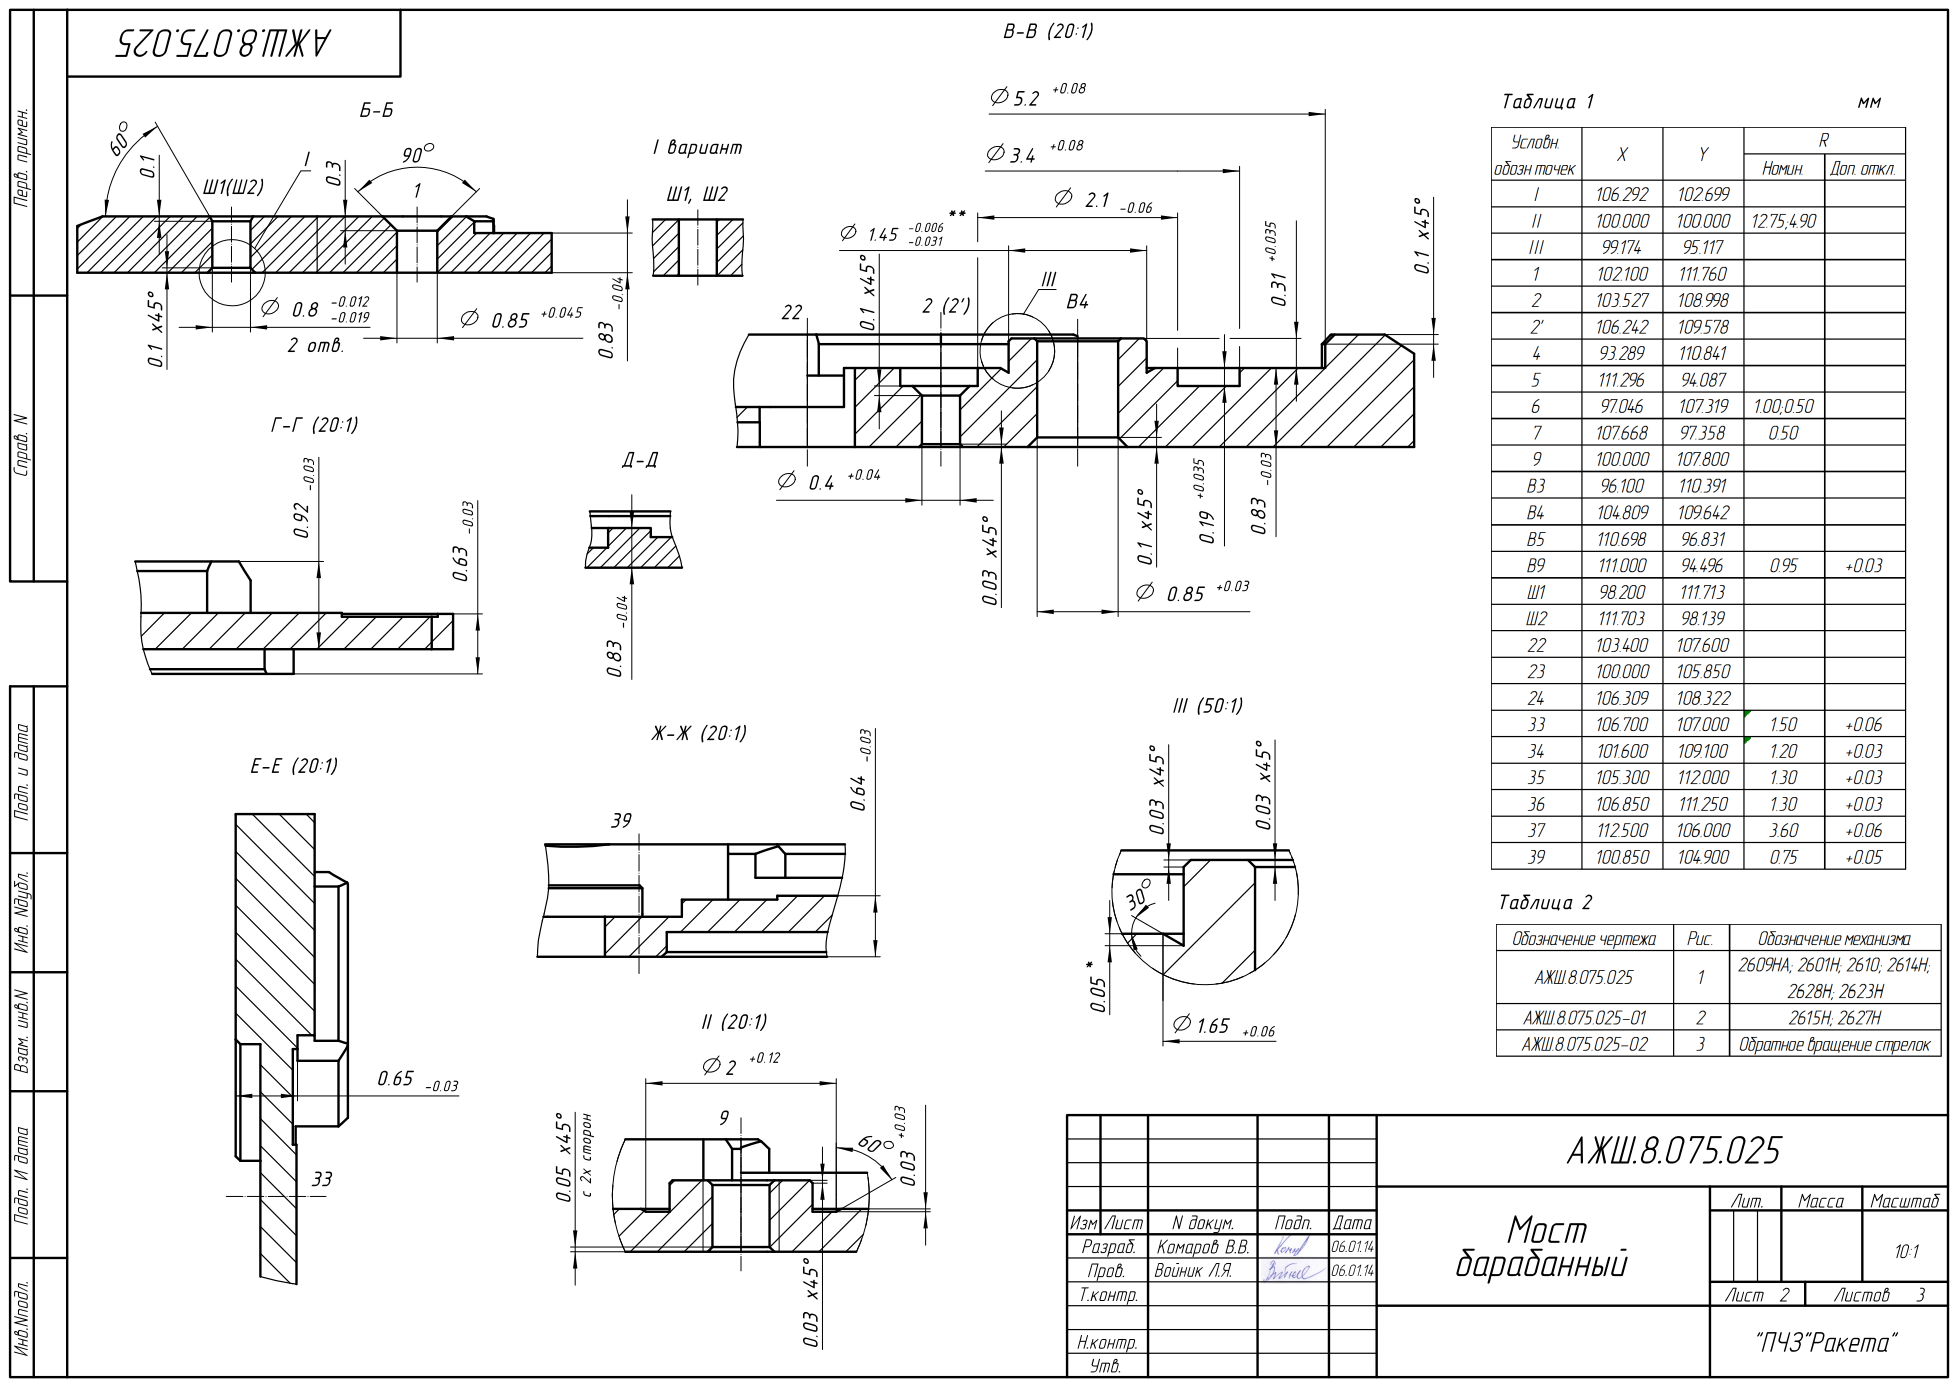
[picture p346: page 2]

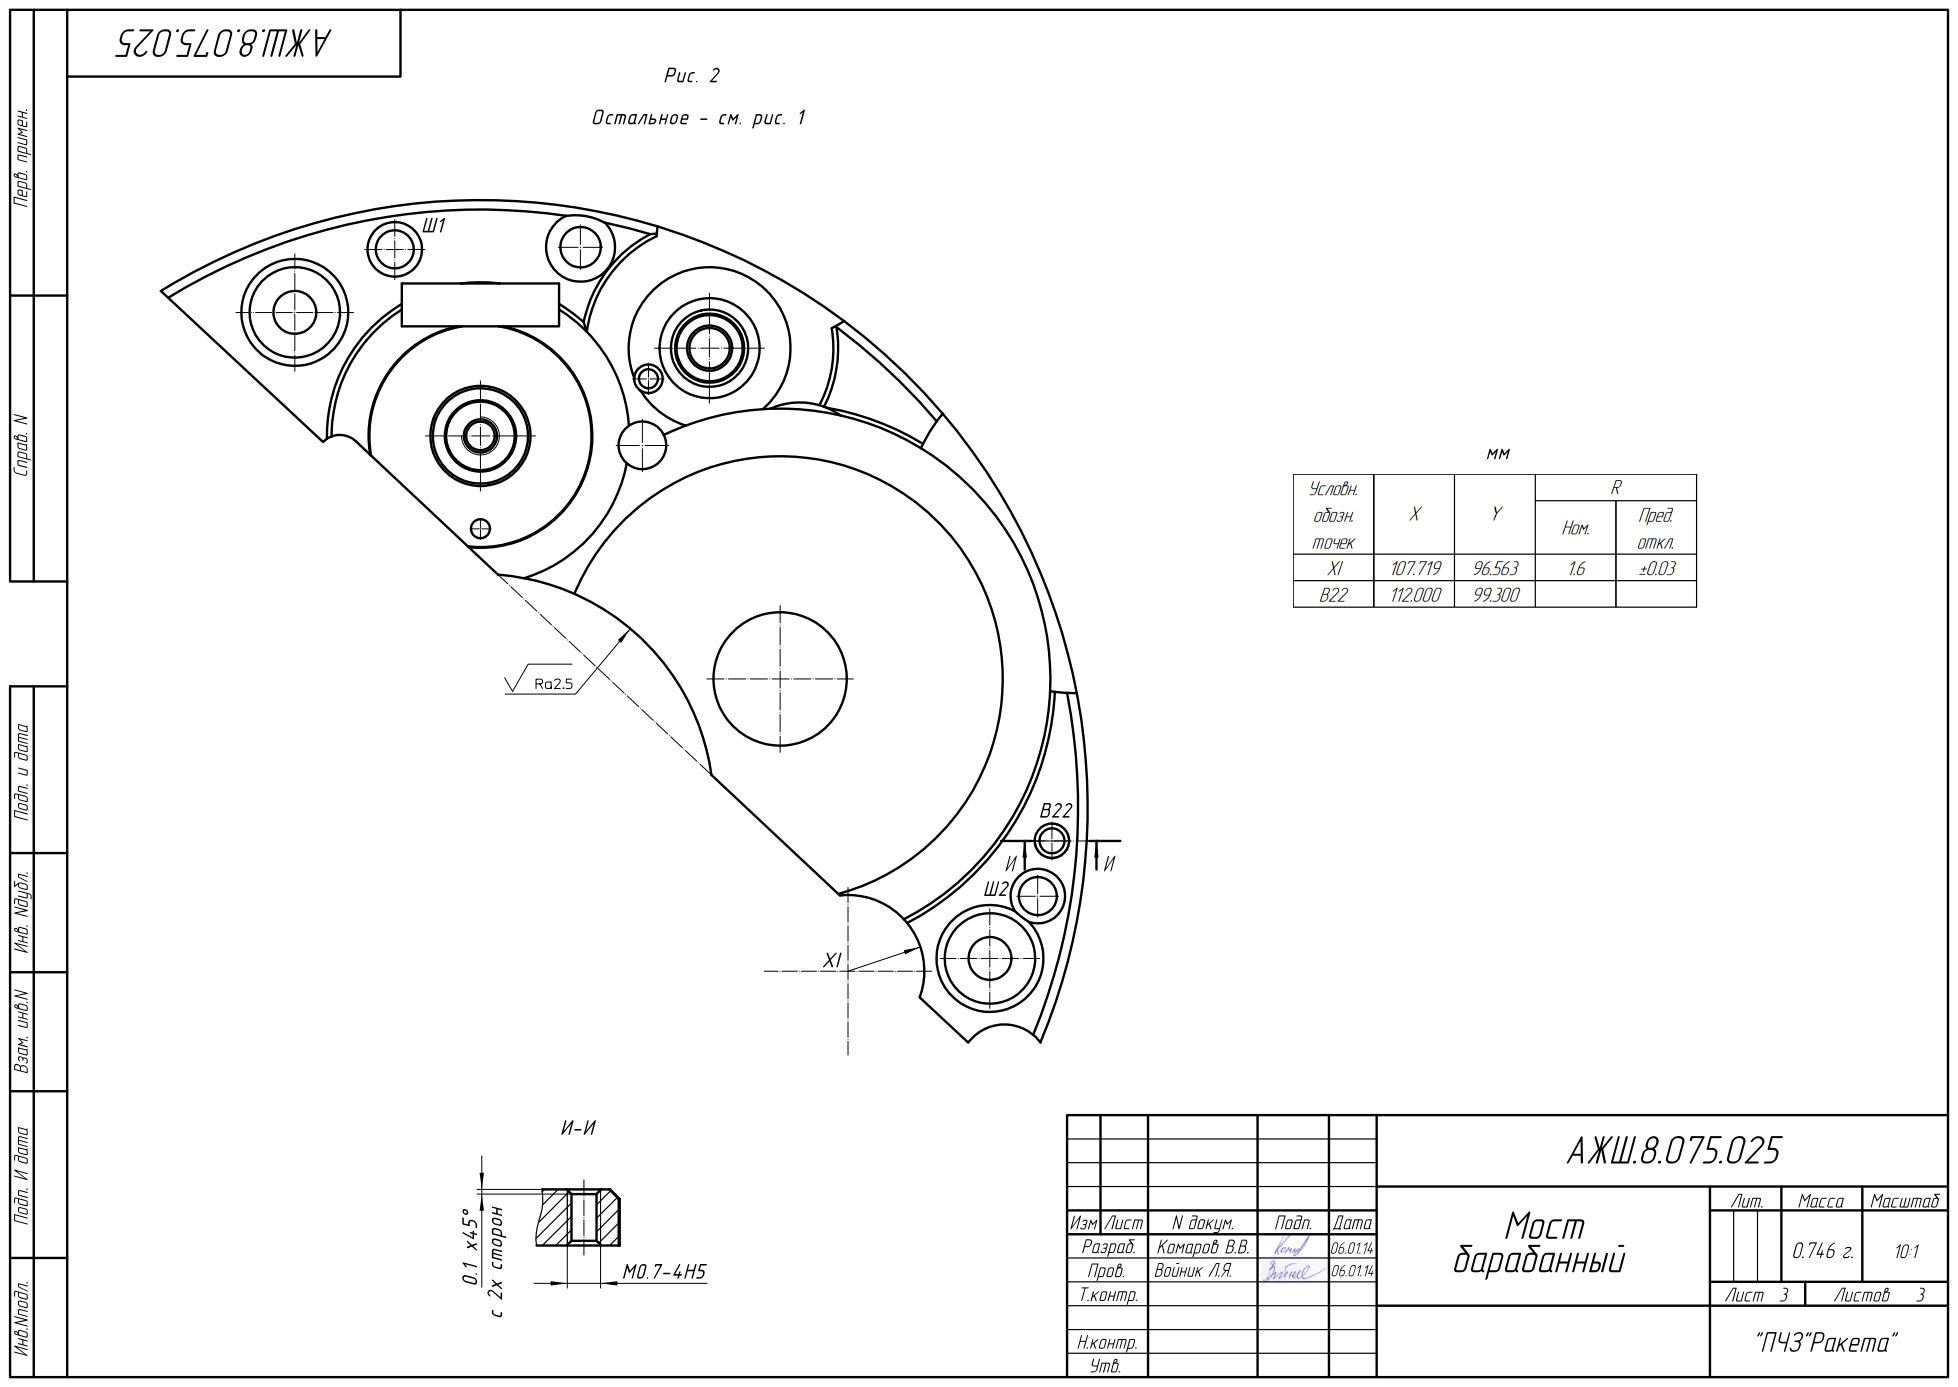
[picture p347: page 3]
