sergei-tiutriumov/Finishing/Ракета/КД мосты 2615/Мост подзавода нижний АЖШ8.075.703/АЖШ8.075.703.00.А.pdf

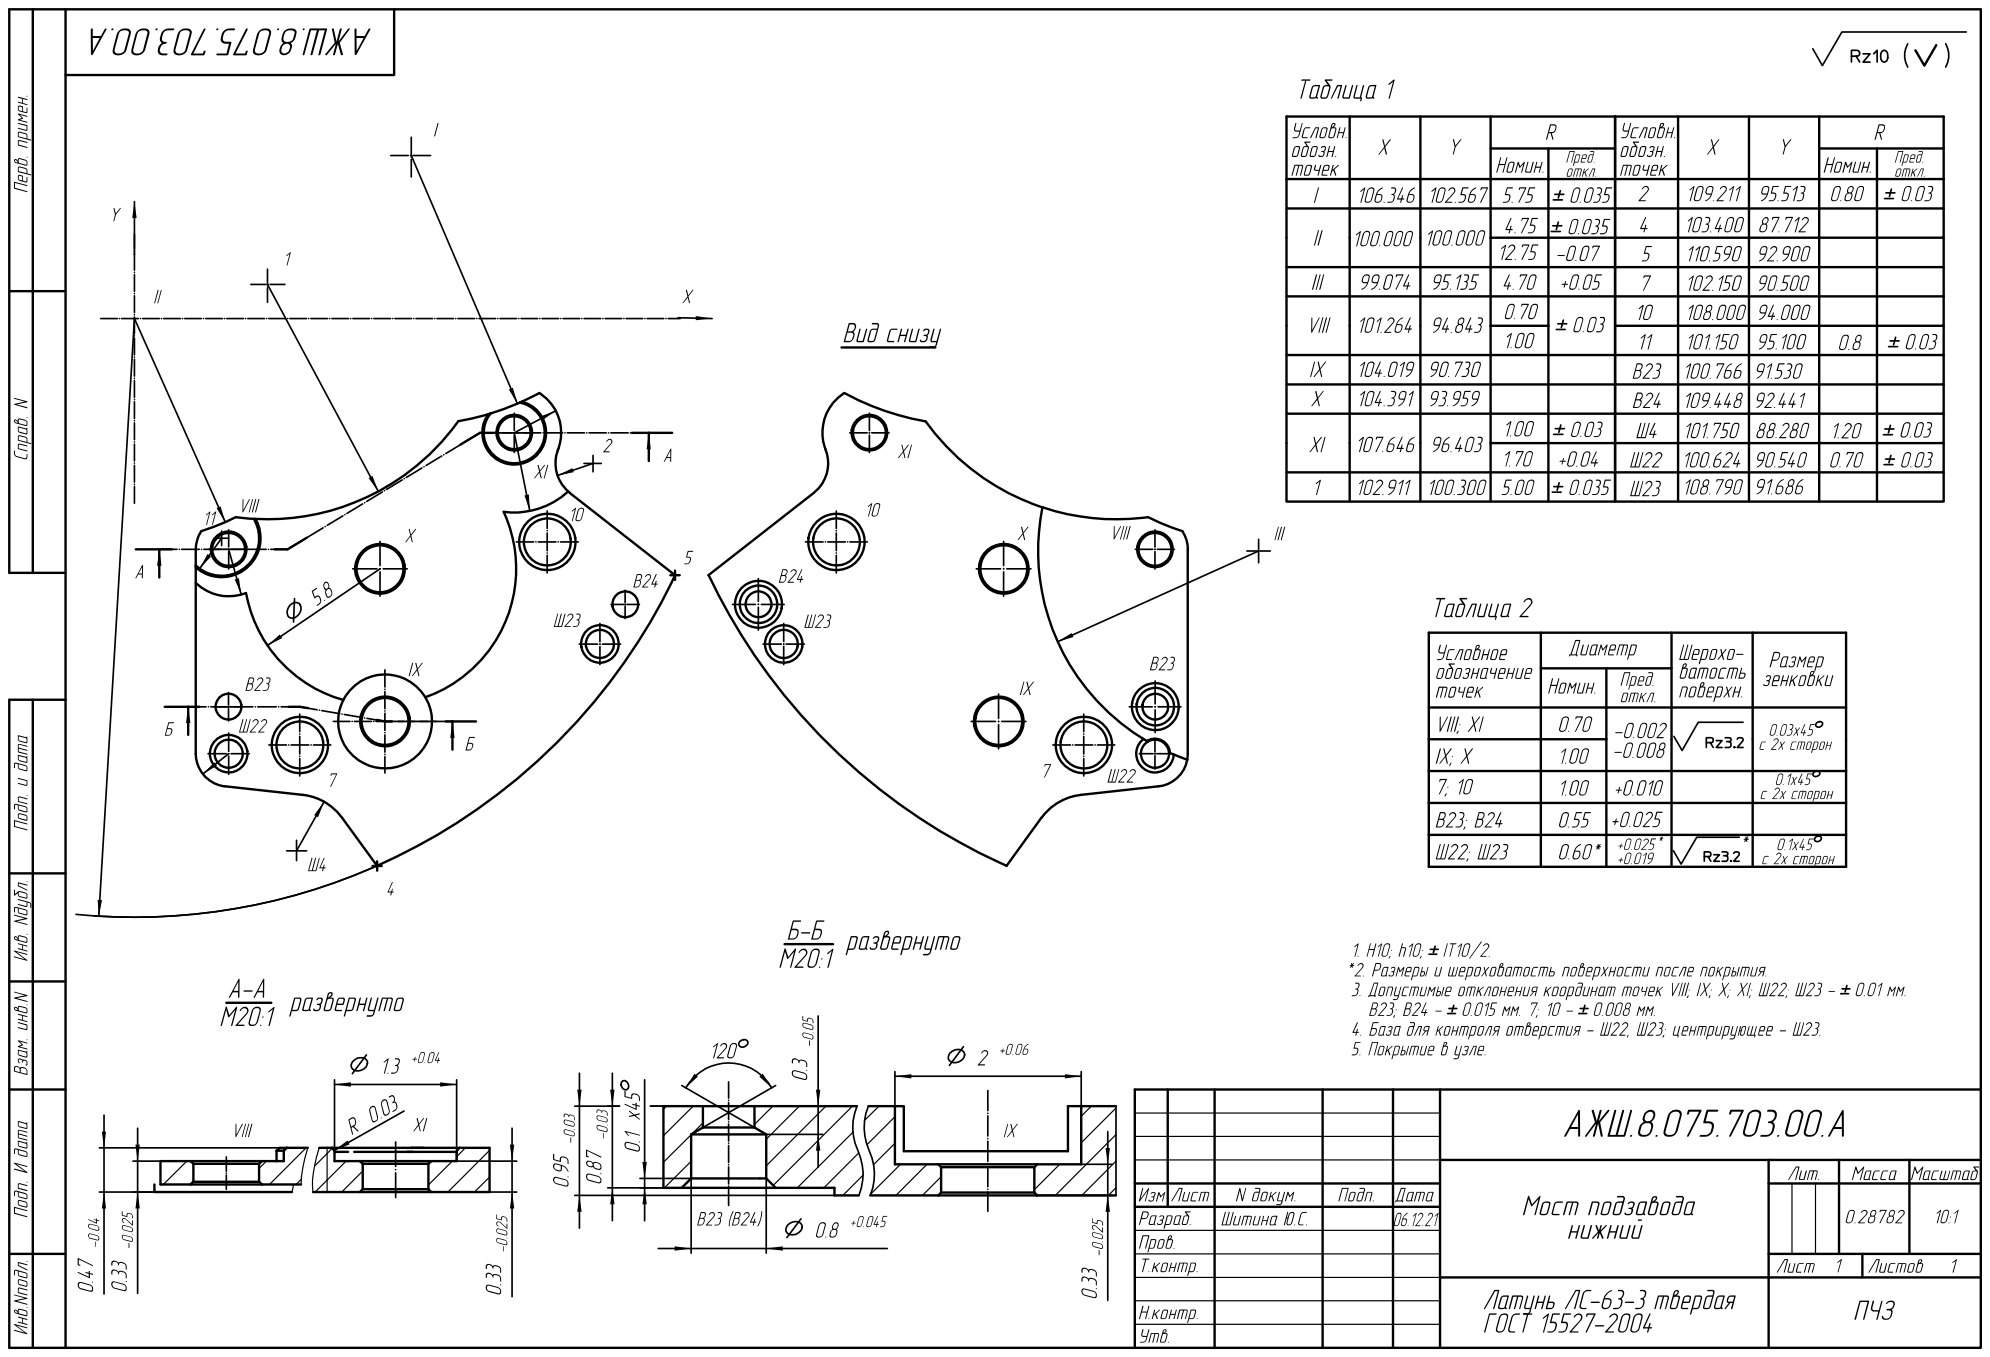
[picture p348: page 1]
