sergei-tiutriumov/Finishing/Ракета/КД мосты 2615/Мост центральный АЖШ8.075.202/АЖШ.8.075.202_Мост центральный.pdf

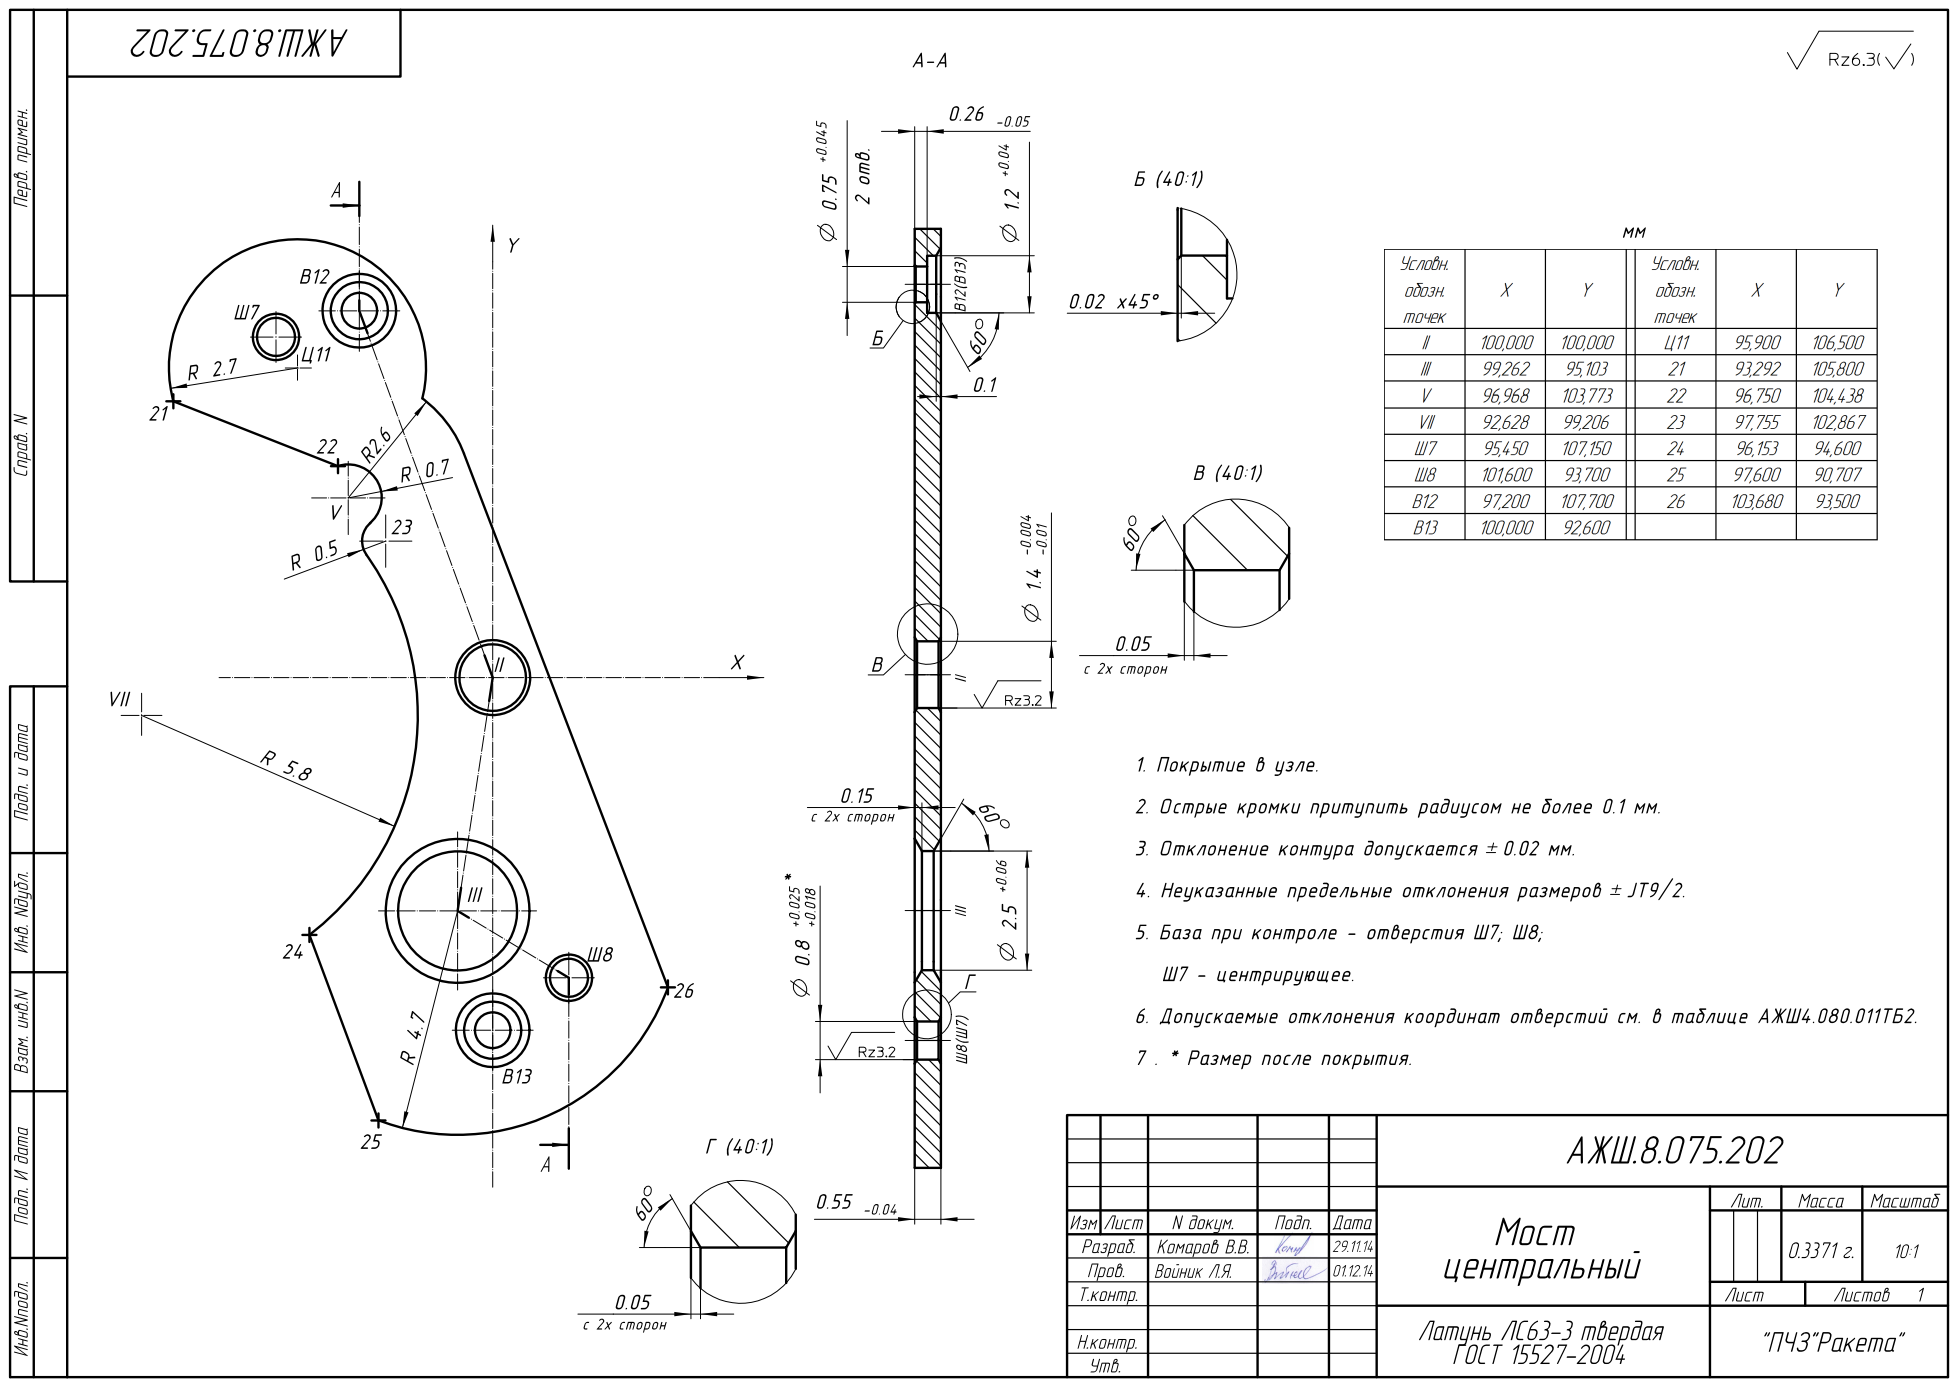
[picture p349: page 1]
