sergei-tiutriumov/Finishing/(commit log)

2025-09-20 табличка
    [табличка.SLDPRT]
2025-10-01 цанга под корпус
    [2025-08-26 J2-Case-Full-18mmLugsGlue.stp, Заготовка цанги.SLDPRT, Табличка.dxf, Цанга под корпус.SLDDRW, Цанга под корпус.SLDPRT, винт таблички.SLDPRT, корпус.SLDPRT, табличка всборе.SLDASM]
2025-12-05 stl models
    [AS 1110 - M12 x 35_1.SLDPRT, BridgeFinishing.SLDPRT, CSN 02 4730 - 511 01 - 12 x 26 x 9_1.SLDPRT, CSN 02 4740 - 81104_1.SLDPRT, Detal metall 2.stl, Detal metall 3.stl, Detal metall 4.stl, Detal metall 5.stl]
2025-12-09 эльбор
    [1,0х0,5 Кольцо уплотнительное.SLDDRW, 1,0х0,5 Кольцо уплотнительное.SLDPRT, 2,40,6 Кольцо уплотнительное.SLDDRW, 2,40,6 Кольцо уплотнительное.SLDPRT, Bezel Joker 40 mm.SLDDRW, Bezel Joker 40 mm.SLDPRT, Bezel screw М1,0х1,7 - 1,4х0,5.SLDDRW, Bezel screw М1,0х1,7 - 1,4х0,5.SLDPRT]
2025-12-12 почти готовая У
    [ПлитаY.SLDPRT, ПлитаХ.SLDPRT]
2025-12-12 плитаY
    [ПлитаY.SLDPRT, голая табличка.DXF, голая табличка.SLDPRT]
2025-12-16 выровняны отверстия
    [ПлитаY.SLDPRT, ПлитаХ.SLDPRT, станок.SLDASM]
2025-12-17 Табличка, сальник, крышка
    [BK-12.SLDPRT, Крышка подшипика.SLDPRT, ПлитаY.SLDPRT, ПлитаХ.SLDPRT, Табличка надпись.dxf, крышка подшипника.DXF, сальник крышки.SLDPRT, станок.SLDASM]
2025-12-18 табличка finishing tools
    [finishing tools.DXF, станок.SLDASM, табличка.SLDPRT]
2025-12-19 шаговики
    [LC40-03-100W.SLDPRT, LC40-03-100W.STEP, LC60-200W.stp, Разделить4[1].SLDPRT, Разделить4[2].SLDPRT, Тело11.SLDPRT, Тело12.SLDPRT, Тело13.SLDPRT]
2025-12-20 гайка
    [SFU1204.stp, X_держатель гайки.SLDPRT, Y_держатель гайки.SLDPRT, ПлитаY.SLDPRT, ПлитаХ.SLDPRT, Разделить4[1].SLDPRT, держатель гайки DSG1204.stp, станок.SLDASM]
2025-12-23 направляющие
    [CD 26-35-8-12.stp, Каретка Б.SLDPRT, Направляющая Y_220.SLDPRT, Направляющая Z_250SLDPRT.SLDPRT, Направляющая Х300.SLDPRT, каретка Y.SLDPRT, муфта.stp, портал Z.SLDPRT]
2026-01-09 столики
    [X_table.SLDPRT, Z_table.SLDPRT, Платина.SLDPRT, ПлитаХ.SLDPRT, ложемент под мост.SLDPRT, ложемент под мостЗАД.SLDPRT, ложемент под мостЛИЦО.SLDPRT, ложемент под мостЭКСПЕРИМЕНТ.SLDPRT]
2026-01-13 столы
    [X_table.SLDPRT, Z_table.SLDPRT, ПлитаY.SLDPRT, ПлитаХ.SLDPRT, станок.SLDASM, табличка.SLDPRT]
2026-01-14 крышки
    [X_table.SLDPRT, ПлитаY.SLDPRT, ПлитаХ.SLDPRT, ложемент под мостЗАД.SLDPRT, станок.SLDASM, уЛ.SLDPRT, уП.SLDPRT, х1.SLDPRT]
2026-01-20 крышки широкие
    [Опора с резиновой присоской М6.SLDASM, станок.SLDASM, уЛ.SLDPRT, уЛ.STEP, уП.SLDPRT, уП.STEP]
2026-01-21 скругления
    [z1.STEP, z2.SLDPRT, z2.STEP, ПлитаХ.SLDPRT, станок.SLDASM, уЛ.STEP, уП.STEP, х1.SLDPRT]
2026-02-04 перед установкой обновления винды
    [ТЕСТ_фаски.SLDPRT, ложемент под мостЗАД.SLDPRT, ложемент под мостЛИЦО.SLDPRT, под грани.SLDPRT, фаски_и_грани.SLDPRT]
2026-02-05 поправлены зазоры и отверстия под крепеж на ушах
    [Z_table.SLDPRT, z2.SLDPRT, станок.SLDASM, уЛ.SLDPRT, уП.SLDPRT, х3.SLDPRT, х4.SLDPRT]
2026-02-05 поправлены сопряжения
    [станок.SLDASM]
2026-02-07 bokovie otverstiya
    [Y_table.SLDPRT, Z_table.SLDPRT, Отверстия на торце столика Z.DXF, станок.SLDASM]
2026-02-10 изменена крышка Z
    [Z_table.SLDPRT, z1.SLDPRT, станок.SLDASM, табличка.SLDPRT]
2026-02-19 переделан ложемент
    [ложемент под мостЛИЦО.SLDPRT, фаски_и_грани.SLDPRT]
2026-02-22 корпус стойки
    [боковина.SLDPRT, верх.SLDPRT, корпус.SLDASM, лицевая панель.SLDPRT, низ.SLDPRT, основание.SLDPRT, станок.SLDASM, х2.SLDPRT]
2026-02-22 вент отверстия
    [боковина.SLDPRT, верх.SLDPRT, корпус.SLDASM, основание.SLDPRT]
2026-02-26 верхняя крышка
    [Z_table.SLDPRT, верхняя панель.SLDPRT, станок.SLDASM]
2026-03-03 верхняя крышка корректировка
    [X_tableNEW.SLDDRW, ШапкаZ.SLDPRT, верхняя панель.SLDPRT, корпус.SLDASM, лицевая панель.SLDPRT, рабочий стол.SLDDRW, рабочий стол.SLDPRT, станок.SLDASM]
2026-03-03 рабочий стол
    [Планирование стола.SLDPRT, низ.SLDPRT, оснастка Ракета мостSLDPRT.SLDPRT, рабочий стол.SLDDRW, рабочий стол.SLDPRT]
2026-03-03 рабочий стол .
    [оснастка Ракета мост.SLDPRT]
2026-03-09 верхняя крышка и шапка корректировка номер следующая
    [ШапкаZ.SLDPRT, верхняя панель.SLDPRT, станок.SLDASM]
2026-03-11 уменьшена ширина прорезей в корпусе
    [боковина.SLDPRT, верх.SLDPRT, корпус.SLDASM, основание.SLDPRT, станок.SLDASM]
2026-03-11 мануалы
2026-03-12 УП оснастка
    [ОбработкаРЕЖИМЫ.SLDPRT, верх.DXF, низ.DXF, оснастка Ракета мост.SLDPRT]
2026-03-12 оснастка контур
    [оснастка Ракета мост.SLDPRT]
2026-03-13 фрезерование контура по периметру
    [оснастка Ракета мост.SLDPRT]
2026-03-18 заготовка
    [ШапкаZ.SLDPRT, ШапкаZ.STL, заготовка.SLDPRT, оснастка Ракета мост.SLDPRT, станок.SLDASM]
2026-03-20 уп для граней 59х59
    [ШапкаZ.STL, заготовка.SLDPRT]
2026-03-21 planing 8mm mill 0.05 depth
    [заготовка.SLDPRT]
2026-03-30 frezerovka lozhementa
    [заготовка.SLDPRT, оснастка Ракета мост.SLDPRT, рабочий стол.SLDDRW, рабочий стол.SLDPRT]
2026-04-02 frezerovka lozhementa update
    [оснастка Ракета мост.SLDPRT]
2026-04-04 2 штуки
    [оснастка Ракета мост 2 шт.SLDPRT, оснастка Ракета мост.SLDPRT]
2026-04-08 pered sverleniem
    [оснастка Ракета мост 2 шт.SLDPRT]
2026-04-19 perlage succes
    [оснастка Ракета мост 2 шт.SLDPRT]
2026-04-20 волны
    [cote de geneve.SLDPRT, оснастка Ракета мост 2 шт.SLDPRT]
2026-04-27 geneve succes
    [cote de geneve.SLDPRT]
2026-05-02 заготовка2
    [АЖШ8.075.320_Мост_ангренажный_автоподзавода.SLDPRT, Планирование стола.SLDPRT, заготовка.SLDPRT, ложемент.SLDPRT, низ.SLDPRT, оснастка под ангренажный мост.SLDASM, оснастка Ракета мост 2 шт.SLDPRT, оснастка Ракета мост 2 шт_Version.SLDPRT]
2026-05-04 отработка2
    [оснастка Version_2-1.SLDPRT, оснастка Version_2.SLDPRT, оснастка Ракета мост 2 шт.SLDPRT]
2026-05-06 otrabotka succes
    [оснастка Version_2-1.SLDPRT, оснастка Version_2.SLDPRT, оснастка Ракета мост 2 шт.SLDPRT, оснастка Ракета мост 2 шт_Version.SLDPRT, оснастка_отработка.SLDPRT]
2026-05-21 оснастка моста заподлицо
    [ангренажный мост заподлицо.SLDPRT, оснастка Ракета мост 2 шт.SLDPRT, оснастка_отработка.SLDPRT]
2026-05-23 пилообразный паттерн
    [паттерн.SLDPRT]
2026-06-03 faska & shlofovka programmi
    [ложемент под мостЛИЦО.SLDPRT]
2026-07-01 pirozhok 150 gradusov
    [планирование восьмеркой.SLDPRT, рабочий стол Микони.SLDPRT, цилиндр.SLDDRW, цилиндр.SLDPRT]
2026-07-04 круглый пирог
    [Высокий стол в тиски.SLDDRW, Высокий стол в тиски.SLDPRT, ангренажный мост заподлицо.SLDPRT, паттерн.SLDPRT]
2026-08-30 faski na mostike KC
    [ложемент под мостЛИЦО.SLDPRT, рабочий стол Микони.SLDPRT]
2026-09-12 d=28mm w=2mm
